saunders-jared-final/Boost-Brigade/8_Results/analysis/REPORT.md

# Results synthesis — presentation test cases, hardware, Simulink, QSPICE and analytical model

Generated by `8_Results/analysis/report.py` on 2026-10-22 21:53 AEST from `out/tables/*.csv`; every number
below comes from those tables (`make all` rebuilds them). Figures are vector PDFs with a PNG twin under `out/figures/`.

## 0 · Scope, data rules and metric definitions

**Test cases.** The 21 windows of `config.TEST_CASES` are the raw-data slides of
`0_Documentation/n11034459_CapstoneDelivery_V2.pdf` (Grafana panel time ranges, local AEST) plus the one open-loop
duty-step run (B01s) and the kscale 0.6–0.8 solar slots that are not on a slide. Each was re-exported from the pod's
InfluxDB with every firmware state (`8_Results/TestCases/`).

**RUN rows only.** Only `RUN_OL` / `RUN_CL` frames are analysed. Outside closed-loop RUN the firmware repeats the
last values of `rv`, `beta`, `stress`, `IM1r`, `IM2r` and sends the pre-bias duty, and Grafana draws one series per
state across the other states; those are the "stale values" of the screenshots. Rules applied: frames whose ten control
fields repeat the previous frame are dropped (none found); the leading / trailing frames of a run in which VM2 or VM3
has left the run's median by more than 2 V (e-load or PSU being switched off before the FAULT, still tagged RUN) are
dropped (`collapse_dropped` in T1); the firmware's `IM1r` / `IM2r` are recomputed from `ILA`, `ILB`, the duties and the
e-load current by the same KCL the firmware uses (`6_RTOS/ctrl_core/shuffler_recon.c`), which also gives absolute
module currents: I1 = I_str + d_A1 I_LA1 − d_B1 I_LB1, I3 = I_str − (i_sh2 − d_A2 I_LA2 + d_B2 I_LB2), I2 = I3 + IM2r.

**VM1.** The firmware's VM1 is the e-load voltage pushed by the Pi at 2 Hz minus VM2 + VM3; where the telemetry VM1
disagrees with the 5 Hz e-load by more than 2 V (the 200 kHz open-loop runs) it is replaced by V_eload − VM2 − VM3.
v_d2 = VM2 − VM3 is therefore the primary hardware voltage signal; v_d1 carries the 2 Hz / 5 Hz caveat.

**Sampling.** Telemetry frames arrive at 44 Hz (median; 11–44 Hz over the cases,
the 200 kHz closed-loop bench runs at 11–14 Hz). Closed-loop time constants are 1–10 ms, so **hardware rise, peak and
settling times of the loop itself are upper bounds of one telemetry sample** and are printed as "≤ 23 ms". What the
hardware does resolve: steady-state error, sample-to-sample noise, the shape and size of disturbance responses that take
seconds (PSU / load steps, shade), the open-loop duty-step amplitudes, and energy. The simulations (100 µs grid, 50 µs
for the MIL model) carry the full metric set.

**Step metrics** (`stepmetrics.step_metrics`, one definition for every phase): initial / final level = medians of the
pre-event window and of the last 20 % of the post window; |Δ|; rise time 10–90 % (interpolated); peak value and peak time
(always reported, `has_overshoot` only when the peak stands above the final value by more than max(2 %, 3 × noise));
overshoot and initial undershoot in % of Δ; settling time = last excursion outside a 2 % / 5 % band (never narrower than
3 × the pre-event noise) and outside an absolute band (±0.1 V for v_d, ±0.2 A for i_c); steady-state error against the
reference; IAE = ∫|y − y_final| dt; first- or second-order fit (τ, ζ, ω_n with 1-σ CI). Noise = MAD of the pre-event
window. A step with fewer than two samples across its 10–90 % rise is "unresolved" and its times are bounds.

**Noise / ripple.** Per settled segment: mean, std, robust peak-to-peak (0.5–99.5 %), RMS of the detrended signal and the
dominant frequency of its Welch spectrum. On hardware these are sample-to-sample noise of sensing-filtered signals at
45 Hz, **not** the switching ripple; the switching ripple comes from the analytical law Δi_c = V̄ / (2 f_sw (L+M)) and the
QSPICE device model (T6).

**Energy** (1 s means of the cleaned RUN frame; e-load power at 5 Hz): E_load = Σ P_eload dt; E_modules = Σ Σ_k VM_k I_k dt;
E_shuffled = Σ Σ_j |i_sh,j| V̄_j/2 dt (power processed through the shufflers); **E_returned = Σ (I_str − max(min_k I_k, 0)) V_str dt**
= energy the load received above what a plain series string limited to its weakest module would deliver at the same string
voltage (the differential-power-processing benefit, never above E_load); efficiency = E_load / E_modules.

## 1 · Test-case inventory (T1)

| case | slide | setup | f_sw [kHz] | loop | kscale (telemetry) | window (local) | RUN segs | RUN [s] | frames | rate [Hz] | frozen dropped | VM1 source | events in window | note |
|---|---|---|---|---|---|---|---|---|---|---|---|---|---|---|
| B01 | 48 | BENCH | 200 | OL | - | 14:32:00-14:44:56 | 2 | 706.5 | 29592 | 39.8 | 0 | e-load V - VM2 - VM3 (telemetry VM1 invalid) | fault x1, load_step x9 | duties 0.5; e-load CV set-point steps 125 <-> 60 V; VM1 from the e-load |
| B01s |  | BENCH | 200 | OL | - | 15:09:00-15:16:00 | 1 | 412.1 | 17112 | 39.8 | 0 | e-load V - VM2 - VM3 (telemetry VM1 invalid) | duty_step x4, fault x1, load_step x4 | not on a slide: the only open-loop duty steps (15:11:42 S2 +0.02/leg, 15:13:00 S1 & S2 -0.01/leg, 15:15:15 S1 +0.02/leg); ends in FAULT |
| B02 | 42 | BENCH | 200 | CL | 0.1 | 15:31:34-15:34:25 | 2 | 160.6 | 1867 | 11.3 | 0 | telemetry (e-load V via Pi, 2 Hz) | close x2 | before the ADC fix; PSU unstable |
| B03 | 43 | BENCH | 200 | CL | 0.3 | 16:02:05-16:04:33 | 1 | 143.1 | 2107 | 14.1 | 0 | telemetry (e-load V via Pi, 2 Hz) | close x1, load_step x2 | slide says kscale 20 %, telemetry says 0.3 with pset 0 (boot default after the re-flash for the ADC phase-B fix; no SET/APPLY sent) |
| B04 | 44 | BENCH | 200 | CL | 0.3/0.4 | 16:07:00-16:07:49 | 2 | 47.1 | 701 | 14.1 | 0 | telemetry (e-load V via Pi, 2 Hz) | close x1, fault x1, kscale_apply x1 | kscale 0.4 applied at 16:07:50 -> OC fault within 1 s |
| B05 | 49 | BENCH | 300 | OL | - | 16:31:36-16:37:04 | 2 | 303.8 | 11633 | 36.4 | 0 | telemetry (e-load V via Pi, 2 Hz) |  |  |
| B06 | 45 | BENCH | 300 | CL | 0.3 | 17:17:00-17:25:49 | 2 | 511.5 | 23223 | 44.1 | 0 | telemetry (e-load V via Pi, 2 Hz) | close x2, fault x1, load_step x7 | PSU / e-load set-point steps 17:22:30-17:25:30 while closed |
| B07 | 46 | BENCH | 300 | CL | 0.3/0.4/0.5/0.6 | 17:34:08-17:41:47 | 7 | 294.6 | 13384 | 44.1 | 0 | telemetry (e-load V via Pi, 2 Hz) | close x4, fault x2, kscale_apply x15, load_step x2 |  |
| B08 | 50 | BENCH | 400 | OL | - | 18:02:03-18:04:38 | 2 | 151.7 | 6890 | 44.1 | 0 | telemetry (e-load V via Pi, 2 Hz) | fault x1, kscale_apply x1, load_step x1 | PSU change at 18:03:40 |
| B09 | 47 | BENCH | 400 | CL | 0.3 | 18:05:11-18:13:40 | 4 | 391.8 | 17769 | 43.9 | 0 | telemetry (e-load V via Pi, 2 Hz) | close x4, fault x1, kscale_apply x2, load_step x2 |  |
| S01 | 24 | PV80 | 200 | OL | - | 15:04:35-15:07:47 | 1 | 187.0 | 8489 | 44.4 | 0 | telemetry (e-load V via Pi, 2 Hz) | irradiance_down x1, mismatch_off x1 | peak sun |
| S02 | 25 | PV80 | 200 | CL | 0.1 | 15:08:40-15:12:44 | 1 | 236.8 | 10748 | 44.2 | 0 | telemetry (e-load V via Pi, 2 Hz) | close x1, irradiance_down x1, irradiance_up x1, mismatch_off x2, mismatch_on x2 | peak sun; shade event about 15:09:20-15:10:40 |
| S03 | 26 | PV80 | 200 | OL | - | 15:48:22-15:51:20 | 1 | 174.3 | 7906 | 44.4 | 0 | telemetry (e-load V via Pi, 2 Hz) | mismatch_off x2, mismatch_on x1 | minimal sun |
| S04 | 27 | PV80 | 200 | CL | 0.1 | 15:52:03-15:56:31 | 1 | 265.1 | 12028 | 44.2 | 0 | telemetry (e-load V via Pi, 2 Hz) | close x1 | minimal sun |
| S05 | 37 | PV80 | 200 | CL | 0.2 | 15:56:51-16:00:47 | 1 | 229.1 | 10402 | 44.2 | 0 | telemetry (e-load V via Pi, 2 Hz) | close x1, kscale_apply x1, mismatch_on x1 | minimal sun |
| S06 | 38 | PV80 | 200 | CL | 0.3 | 16:01:07-16:04:19 | 1 | 188.6 | 8559 | 44.2 | 0 | telemetry (e-load V via Pi, 2 Hz) | close x1 | minimal sun |
| S07 | 39 | PV80 | 200 | CL | 0.4 | 16:05:30-16:08:17 | 1 | 155.7 | 7071 | 44.2 | 0 | telemetry (e-load V via Pi, 2 Hz) | close x1 | minimal sun |
| S08 | 40 | PV80 | 200 | CL | 0.5 | 16:09:42-16:12:16 | 1 | 150.3 | 6829 | 44.2 | 0 | telemetry (e-load V via Pi, 2 Hz) | close x1, kscale_apply x1, mismatch_on x1 | minimal sun |
| S09 |  | PV80 | 200 | CL | 0.6 | 16:13:15-16:18:00 | 1 | 278.3 | 12633 | 44.2 | 0 | telemetry (e-load V via Pi, 2 Hz) | close x1, kscale_apply x2 | not on a slide (closed_loop_timeslots.pdf) |
| S10 |  | PV80 | 200 | CL | 0.7 | 16:19:05-16:22:12 | 1 | 178.4 | 8101 | 44.2 | 0 | telemetry (e-load V via Pi, 2 Hz) | close x1, kscale_apply x2 | not on a slide (closed_loop_timeslots.pdf) |
| S11 |  | PV80 | 200 | CL | 0.8 | 16:23:05-16:24:45 | 1 | 90.5 | 4111 | 44.2 | 0 | telemetry (e-load V via Pi, 2 Hz) | close x1 | not on a slide (closed_loop_timeslots.pdf) |

`out/tables/T1_inventory.csv`; one overview figure per case in `out/figures/hardware/` (section 8).

## 2 · Hardware steady state and noise (T2)

Settled statistics per RUN segment longer than 5 s (first 2 s and last 1 s skipped). Closed loop: the references are v_d = 0 V and i_c = 0 A.

### 2.1 Closed loop

| case | f_sw [kHz] | k | s | Hz | v_d1 mean [V] | std | v_d2 mean [V] | std | v_d2 pk-pk | f_dom [Hz] | i_c1 mean [A] | std | i_c2 mean [A] | std | i_sh1 [A] | i_sh2 [A] | P [W] |
|---|---|---|---|---|---|---|---|---|---|---|---|---|---|---|---|---|---|
| B02 | 200 | 0.1 | 153 | 11.3 | 0 | 0.0708 | 0.00464 | 0.04 | 0.21 | 2.68 | 0.0221 | 1.49 | -0.0231 | 1.36 | 0.347 | -0.101 | 44.5 |
| B03 | 200 | 0.3 | 140 | 14.1 | -0.000864 | 0.0824 | 0.00651 | 0.0736 | 0.36 | 1.43 | 0.00871 | 0.647 | 0.0502 | 0.4 | 0.0893 | -0.0502 | 40.6 |
| B04 | 200 | 0.3 | 44.1 | 14.1 | -0.00201 | 0.0775 | 0.0104 | 0.0784 | 0.388 | 2.45 | -0.0327 | 0.634 | 0.0659 | 0.408 | 0.186 | 0.0426 | 40.6 |
| B06 | 300 | 0.3 | 357 | 44.1 | 0 | 0.0156 | 0.000522 | 0.0158 | 0.08 | 4.61 | -0.00406 | 0.0576 | 0 | 0.0546 | 0.306 | -0.26 | 35.6 |
| B06 | 300 | 0.3 | 148 | 44.1 | 0 | 0.0159 | 0.00061 | 0.0158 | 0.08 | 4.61 | -0.00327 | 0.057 | 0 | 0.0536 | 0.703 | -0.486 | 61.7 |
| B07 | 300 | 0.3 | 90.8 | 44.1 | -0.000633 | 0.00949 | 0 | 0.0127 | 0.06 | 4.57 | -0.00259 | 0.0569 | -0.000853 | 0.0534 | 0.247 | -0.178 | 44.7 |
| B07 | 300 | 0.4 | 132 | 44.1 | 0.00136 | 0.0281 | -0.00207 | 0.0686 | 0.27 | 0.474 | -0.00362 | 0.0592 | -0.000568 | 0.054 | 0.413 | -0.478 | 61 |
| B07 | 300 | 0.4 | 18 | 44.1 | -0.00103 | 0.0231 | -0.00231 | 0.0437 | 0.189 | 6.56 | -0.00119 | 0.0626 | 0.0013 | 0.0548 | 0.272 | -0.124 | 45.8 |
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
| S01 | 200 | 184 | 44.4 | -0.251 | 0.1 | -0.319 | 0.108 | -0.749 | 0.964 | 0.221 | -2.2 | -0.884 | 67.7 |
| S03 | 200 | 171 | 44.4 | -0.0422 | 0.162 | -0.0738 | 0.112 | 0.0768 | 1 | 0.238 | -0.382 | -0.0751 | 9.45 |

Closed-loop steady state vs gain scale: v_d2 error and noise, i_c2 noise

*Closed-loop steady state vs gain scale: v_d2 error and noise, i_c2 noise* — [PDF](out/figures/compare/hw_steady_state_vs_kscale.pdf) ([png](out/figures/compare/hw_steady_state_vs_kscale.png))

## 3 · Hardware events (T3)

### 3.1 Loop closures (IDLE → SOFTSTART → RUN_CL)

The 150 ms soft-start ramp (not RUN) removes the idle mismatch; the loop starts from the residual in the first RUN_CL frame. `idle_level` = v_d2 in IDLE before the ramp, `y0` = first controlled sample, `settle abs` = time until |v_d2| stays inside ±0.1 V.

| cid | time | f_sw | k | idle level [V] | y0 [V] | final [V] | ss err [V] | noise [V] | settle ±0.1 V [s] | rise | settle 2 % | n |
|---|---|---|---|---|---|---|---|---|---|---|---|---|
| B02 | 15:31:37 | 200 | 0.1 | -4.97 | -0.01 | 0 | 0 | 0.0297 | 0 | - | 0 ms | 0 |
| B02 | 15:34:19 | 200 | 0.1 | -4.95 | 0.06 | 0 | 0 | 0.0148 | 0 | - | 0 ms | 0 |
| B03 | 16:02:08 | 200 | 0.3 | -4.95 | -0.09 | 0.015 | 0.015 | 0.0445 | 1.9 | <= 71 ms | <= 1897 ms | 27 |
| B04 | 16:07:03 | 200 | 0.3 | -4.95 | -0.07 | 0.03 | 0.03 | 0.0445 | 1.48 | - | 1.29e+03 ms | 19 |
| B06 | 17:17:01 | 300 | 0.3 | -4.98 | -0.21 | 0 | 0 | 0 | 0 | <= 23 ms | <= 2996 ms | 136 |
| B06 | 17:23:14 | 300 | 0.3 | -4.98 | -0.13 | 0 | 0 | 0.0148 | 0 | <= 23 ms | <= 88 ms | 3 |
| B07 | 17:40:07 | 300 | 0.3 | -4.95 | -0.2 | 0 | 0 | 0.0148 | 0 | <= 23 ms | <= 23 ms | 0 |
| B07 | 17:39:20 | 300 | 0.4 | -4.94 | -0.19 | -0.01 | -0.01 | 0.0593 | 0 | <= 23 ms | <= 23 ms | 0 |
| B07 | 17:37:20 | 300 | 0.5 | -4.96 | -0.19 | 0.01 | 0.01 | 0.0741 | 2.69 | <= 23 ms | <= 23 ms | 0 |
| B07 | 17:38:34 | 300 | 0.6 | -4.96 | -0.2 | 0.035 | 0.035 | 0.0371 | 2.51 | <= 23 ms | <= 2223 ms | 101 |
| B09 | 18:05:20 | 400 | 0.3 | -4.96 | -0.46 | 0 | 0 | 0.0148 | 0 | <= 23 ms | <= 23 ms | 0 |
| B09 | 18:07:37 | 400 | 0.3 | -4.97 | -0.8 | 0 | 0 | 0.0148 | 0 | <= 23 ms | <= 65 ms | 3 |
| B09 | 18:08:24 | 400 | 0.3 | -4.96 | -0.17 | 0.01 | 0.01 | 0.0148 | 0 | <= 23 ms | <= 43 ms | 2 |
| B09 | 18:12:32 | 400 | 0.3 | -4.96 | -0.8 | -0.01 | -0.01 | 0.0148 | 0.176 | <= 23 ms | <= 264 ms | 12 |
| S02 | 15:08:45 | 200 | 0.1 | 0 | -0.17 | 0 | 0 | 0.0148 | 0 | <= 43 ms | <= 43 ms | 2 |
| S04 | 15:52:05 | 200 | 0.1 | -0.03 | 0.13 | 0 | 0 | 0.119 | 3 | <= 23 ms | <= 23 ms | 0 |
| S05 | 15:56:54 | 200 | 0.2 | -0.01 | -0.26 | -0.03 | -0.03 | 0.119 | 2.99 | <= 37 ms | <= 23 ms | 0 |
| S06 | 16:01:08 | 200 | 0.3 | -0.02 | -0.17 | -0.015 | -0.015 | 0.0371 | 2.91 | <= 23 ms | <= 2906 ms | 132 |
| S07 | 16:05:37 | 200 | 0.4 | -0.03 | -0.03 | -0.03 | -0.03 | 0.0519 | 2.91 | - | 2e+03 ms | 92 |
| S08 | 16:09:44 | 200 | 0.5 | -0.03 | -0.13 | 0.01 | 0.01 | 0.0593 | 2.66 | <= 23 ms | <= 2665 ms | 121 |
| S09 | 16:13:19 | 200 | 0.6 | -0.03 | -0.15 | -0.01 | -0.01 | 0.089 | 2.86 | <= 23 ms | <= 23 ms | 0 |
| S10 | 16:19:11 | 200 | 0.7 | -0.03 | 0.07 | -0.015 | -0.015 | 0.104 | 2.77 | - | 0 ms | 0 |
| S11 | 16:23:11 | 200 | 0.8 | -0.06 | 0 | -0.01 | -0.01 | 0.0519 | 2.8 | - | 2.8e+03 ms | 128 |

- 23 closures: residual at RUN_CL entry 0.00–0.80 V (idle mismatch 4.9 V on the bench), final |error| ≤ 0.035 V; the residual is inside ±0.1 V after 1.5 s (median) — 10 of 23 within the first sample.

### 3.2 Open-loop duty steps (B01s, 16 Oct 15:09–15:16, 200 kHz)

Prediction of the averaged model at this operating point (23.3 V per channel): Δv_d,j = −V̄_j Δu_c,j = −46.6 V × Δu_c.

| time | command | signal | before | after | Δ measured | Δ predicted | rise | settle 2 % | noise |
|---|---|---|---|---|---|---|---|---|---|
| 15:11:42 | C,DUTYS,0.5,0.5,0.51,0.51 | id1 | 0.68 | 0.628 | -0.0525 | - | - | 0 ms | 1.55 |
| 15:11:42 | C,DUTYS,0.5,0.5,0.51,0.51 | id2 | -1.47 | -2.81 | -1.34 | - | <= 47 ms | <= 50 ms | 1.19 |
| 15:11:42 | C,DUTYS,0.5,0.5,0.51,0.51 | vd1 | 0.0335 | 0.00391 | -0.0296 | 0 | - | 0 ms | 0.0459 |
| 15:11:42 | C,DUTYS,0.5,0.5,0.51,0.51 | vd2 | 0.82 | -1.05 | -1.87 | -1.86 | <= 25 ms | <= 3155 ms | 0.0297 |
| 15:13:00 | C,DUTYS,0.49,0.49,0.50,0.50 | id1 | 0.814 | 0.585 | -0.229 | - | - | 0 ms | 1.16 |
| 15:13:00 | C,DUTYS,0.49,0.49,0.50,0.50 | id2 | -2.78 | -2.06 | 0.72 | - | <= 25 ms | <= 25 ms | 1.1 |
| 15:13:00 | C,DUTYS,0.49,0.49,0.50,0.50 | vd1 | 0.0337 | 0.944 | 0.91 | 0.932 | <= 38 ms | <= 67 ms | 0.044 |
| 15:13:00 | C,DUTYS,0.49,0.49,0.50,0.50 | vd2 | -1.06 | -0.12 | 0.94 | 0.932 | <= 37 ms | <= 5875 ms | 0.0148 |
| 15:13:54 | C,DUTYS,0.49,0.49,0.50,0.50 | id1 | 0.611 | 0.36 | -0.251 | - | - | 0 ms | 1.38 |
| 15:13:54 | C,DUTYS,0.49,0.49,0.50,0.50 | id2 | -1.76 | -2.55 | -0.79 | - | <= 25 ms | <= 25 ms | 0.959 |
| 15:13:54 | C,DUTYS,0.49,0.49,0.50,0.50 | vd1 | 0.973 | 0.954 | -0.0196 | 0.932 | - | 3.41e+03 ms | 0.0294 |
| 15:13:54 | C,DUTYS,0.49,0.49,0.50,0.50 | vd2 | -0.13 | -0.12 | 0.01 | 0.932 | - | 0 ms | 0.0148 |
| 15:15:15 | C,DUTYS,0.51,0.51,0.50,0.50 | id1 | 0.742 | 1.3 | 0.562 | - | <= 25 ms | <= 25 ms | 1.44 |
| 15:15:15 | C,DUTYS,0.51,0.51,0.50,0.50 | id2 | -2.07 | -1.91 | 0.161 | - | - | 0 ms | 1.19 |
| 15:15:15 | C,DUTYS,0.51,0.51,0.50,0.50 | vd1 | 0.973 | -0.887 | -1.86 | -1.86 | <= 25 ms | <= 1731 ms | 0.0434 |
| 15:15:15 | C,DUTYS,0.51,0.51,0.50,0.50 | vd2 | -0.13 | -0.13 | 0 | 0 | - | 0 ms | 0.0297 |

- The measured Δv_d of the 6 non-zero voltage steps agree with −V̄·Δu_c within 0.952 V (102.1 % worst case); the rise is inside one telemetry sample, the slow tail afterwards is the PSU channels re-settling.

### 3.3 Load / PSU steps while running (bench)

Detected level shifts of the string current / power (e-load) with the loop's response; v_d must stay at 0 V, i_sh takes the new share.

| cid | time | state | k | ΔI_str [A] | ΔP [W] | Δi_sh1 [A] | Δi_sh2 [A] | v_d1 peak dev [V] | v_d2 peak dev [V] | v_d2 recovery [s] |
|---|---|---|---|---|---|---|---|---|---|---|
| B01 | 14:33:15 | RUN_OL | 0.3 | -0.000704 | -0.0503 | -0.426 | 0.103 | -0.139 | 0.07 | 0 |
| B01 | 14:36:18 | RUN_OL | 0.3 | 0 | 0.006 | 0.134 | -0.115 | -0.111 | 0.06 | 0 |
| B01 | 14:40:14 | RUN_OL | 0.3 | 0 | -0.00116 | -0.208 | -0.248 | -0.13 | 0.08 | 0 |
| B01 | 14:42:28 | RUN_OL | 0.3 | 0 | 0.0136 | 0.171 | -0.048 | -0.24 | -0.33 | 3.35 |
| B01 | 14:44:16 | RUN_OL | 0.3 | 0.000684 | 0.0478 | 0.428 | -0.296 | -0.121 | 0.065 | 0 |
| B01 | 14:44:25 | RUN_OL | 0.3 | 0 | 0.00129 | -0.18 | 0.0775 | -0.121 | 0.07 | 0 |
| B01 | 14:44:36 | RUN_OL | 0.3 | -0.97 | -67.9 | -1.43 | 1.23 | -5.97 | 0.15 | 5.02 |
| B01s | 15:14:45 | RUN_OL | 0.3 | -0.00107 | -0.0755 | -0.223 | 0.062 | -0.129 | 0.07 | 0 |
| B03 | 16:02:50 | RUN_CL | 0.3 | -0.00141 | -0.0989 | 0.248 | -0.065 | 0.15 | -0.23 | 9.7 |
| B03 | 16:03:18 | RUN_CL | 0.3 | -0.005 | -0.349 | 0.112 | 0.162 | -0.15 | -0.16 | 0 |
| B06 | 17:22:52 | RUN_CL | 0.3 | 0.2 | 14 | -0.372 | -0.767 | -0.03 | -0.04 | 0 |
| B06 | 17:23:24 | RUN_CL | 0.3 | 0.199 | 14 | 0.797 | 0.391 | -0.05 | 0.04 | 0 |
| B06 | 17:23:35 | RUN_CL | 0.3 | 0.0672 | 4.7 | -0.139 | 0.131 | -0.03 | -0.03 | 0 |
| B06 | 17:23:58 | RUN_CL | 0.3 | -0.268 | -18.7 | 0.529 | 1.06 | 0.04 | 0.03 | 0 |
| B06 | 17:24:16 | RUN_CL | 0.3 | 0.267 | 18.7 | -0.525 | -1.01 | 0.03 | -0.03 | 0 |
| B06 | 17:25:09 | RUN_CL | 0.3 | -0.167 | -11.7 | 0.309 | -0.313 | -0.04 | 0.03 | 0 |
| B06 | 17:25:32 | RUN_CL | 0.3 | 0.0195 | 1.36 | 0.016 | 0.01 | -0.04 | -0.03 | 0 |
| B07 | 17:34:13 | RUN_CL | 0.4 | 0.171 | 12 | 0.48 | 0.182 | 0.06 | -0.1 | 0 |
| B07 | 17:35:25 | RUN_CL | 0.4 | -0.158 | -11 | -0.514 | -0.251 | 0.06 | 0.14 | 4.83 |
| B08 | 18:03:42 | RUN_OL | 0.3 | -0.0931 | -6.52 | 0.176 | 0.322 | 0.14 | 1.35 | 9.97 |
| B09 | 18:08:42 | RUN_CL | 0.3 | 0.272 | 19.1 | 0.598 | 0.297 | 0.04 | 0.04 | 0 |

### 3.4 Shade / irradiance events (carpark PV, closed loop)

In closed loop the module voltages stay equal, so a shade shows in the module currents: detector on |i_sh1| + |i_sh2| (6 s change) and on the string power (4 s change).

| cid | time | event | k | ΔP [W] | ΔI_str [A] | Δi_sh1 [A] | Δi_sh2 [A] | ΔI_M1 [A] | ΔI_M3 [A] | v_d2 peak dev [V] | i_sh1 rise |
|---|---|---|---|---|---|---|---|---|---|---|---|
| S01 | 15:07:31 | mismatch_off | 0.2 | -35 | -0.573 | 1.02 | 0.422 | -0.526 | -0.772 | 0.145 | <= 149 ms |
| S01 | 15:07:32 | irradiance_down | 0.2 | -32.8 | -0.538 | 0.933 | 0.391 | - | - | 0.13 | <= 84 ms |
| S02 | 15:09:24 | irradiance_up | 0.1 | 56 | 0.919 | -1.49 | -0.87 | - | - | 0.06 | 2.25e+03 ms |
| S02 | 15:09:24 | mismatch_on | 0.1 | 56 | 0.919 | -1.49 | -0.87 | -0.626 | 1.35 | 0.06 | 2.25e+03 ms |
| S02 | 15:10:29 | irradiance_down | 0.1 | -32.9 | -0.54 | 0.881 | 0.497 | - | - | -0.05 | <= 190 ms |
| S02 | 15:10:31 | mismatch_off | 0.1 | -28.5 | -0.468 | 0.823 | 0.438 | 0.585 | -0.727 | 0.05 | <= 23 ms |
| S02 | 15:10:40 | mismatch_on | 0.1 | -12.1 | -0.199 | 0.555 | -1.02 | 0.594 | -0.315 | 0.05 | <= 23 ms |
| S02 | 15:10:48 | mismatch_off | 0.1 | -24.2 | -0.397 | 0.723 | 0.419 | 0.622 | -0.592 | 0.05 | <= 23 ms |
| S03 | 15:48:53 | mismatch_on | 0.2 | 0.621 | 0.0102 | -1.11 | -0.607 | -0.553 | 0.302 | -0.26 | - |
| S03 | 15:48:59 | mismatch_off | 0.2 | 0.547 | 0.00897 | -1.18 | 0.631 | -0.588 | -0.316 | -0.26 | - |
| S03 | 15:49:18 | mismatch_off | 0.2 | 0.361 | 0.00593 | -1.27 | 0.619 | -0.633 | -0.307 | 0.24 | - |
| S05 | 15:58:21 | mismatch_on | 0.2 | -0.718 | -0.0118 | -1.29 | 0.707 | -0.651 | -0.355 | -0.245 | - |
| S08 | 16:10:42 | mismatch_on | 0.5 | 0.575 | 0.00944 | -1.26 | -0.637 | -0.622 | 0.319 | 0.22 | - |

Zoom figures of every event: `out/figures/events/<case>_e<n>_<kind>.pdf` (listed in section 8).

## 4 · Energy (T7)

### 4.1 Solar test cases (20 Oct 2026), whole window

| cid | loop | k | s | P_load [W] | P_modules [W] | eff | P_shuffled [W] | P_returned [W] | max [W] | E_load [Wh] | E_shuffled [Wh] | E_returned [Wh] | I_M1 [A] | I_M2 [A] | I_M3 [A] | I_str [A] |
|---|---|---|---|---|---|---|---|---|---|---|---|---|---|---|---|---|
| S01 | OL | - | 188 | 67.3 | 67.7 | 0.993 | 62.3 | 65.9 | 96.1 | 3.51 | 3.26 | 3.44 | 0.005 | 1.76 | 1.54 | 1.1 |
| S02 | CL | 0.1 | 238 | 45.1 | 45.5 | 0.992 | 42.3 | 43.9 | 98.9 | 2.98 | 2.79 | 2.9 | -0.00401 | 1.21 | 1.03 | 0.74 |
| S03 | OL | - | 175 | 9.43 | 9.44 | 0.999 | 9.33 | 9.29 | 11.1 | 0.459 | 0.453 | 0.451 | -0.0371 | 0.309 | 0.192 | 0.155 |
| S04 | CL | 0.1 | 266 | 8.16 | 8.17 | 0.999 | 8.19 | 7.95 | 9 | 0.603 | 0.605 | 0.588 | -0.0384 | 0.278 | 0.162 | 0.134 |
| S05 | CL | 0.2 | 230 | 10.9 | 10.9 | 0.999 | 10.6 | 10.7 | 12.4 | 0.694 | 0.675 | 0.685 | -0.0394 | 0.354 | 0.22 | 0.178 |
| S06 | CL | 0.3 | 189 | 13.4 | 13.4 | 0.999 | 12.5 | 13.1 | 14.2 | 0.701 | 0.656 | 0.688 | -0.0337 | 0.418 | 0.273 | 0.219 |
| S07 | CL | 0.4 | 156 | 13.5 | 13.5 | 0.999 | 13 | 13.3 | 14.2 | 0.586 | 0.565 | 0.577 | -0.0359 | 0.417 | 0.285 | 0.222 |
| S08 | CL | 0.5 | 151 | 10.6 | 10.6 | 0.999 | 10.6 | 10.4 | 11.8 | 0.445 | 0.445 | 0.436 | -0.0385 | 0.338 | 0.222 | 0.174 |
| S09 | CL | 0.6 | 279 | 7.33 | 7.33 | 1 | 7.29 | 7.16 | 8.52 | 0.568 | 0.565 | 0.555 | -0.0404 | 0.269 | 0.131 | 0.12 |
| S10 | CL | 0.7 | 179 | 5.14 | 5.13 | 1 | 5.8 | 4.95 | 6.09 | 0.255 | 0.288 | 0.246 | -0.0439 | 0.21 | 0.0865 | 0.0842 |
| S11 | CL | 0.8 | 91 | 2.32 | 2.31 | 1 | 4.44 | 2.29 | 3.18 | 0.0586 | 0.112 | 0.0579 | -0.0555 | 0.139 | 0.0298 | 0.038 |

- In every 20 Oct window the KCL reconstruction (and the firmware's own IM1r) puts module 1 at -0.06…+0.00 A while modules 2 and 3 carry 1.76 / 1.54 A at most: the top module produced nothing that afternoon (slightly negative = the dark module forward-biased by the others). With a weakest-module-limited series string the load would therefore have received ≈ 0, so E_returned ≈ E_load: 10.62 Wh returned over 36 min of RUN time, 99 W at the peak of S02.
- Shuffler throughput: 4.4–62.3 W mean (≈ the whole load power, because one module is dead); string efficiency P_load / Σ V_k I_k = 0.992–1.003 (the reconstruction shares the e-load's current, so this is the winding-path loss only).

### 4.2 Bench (16 Oct), for reference

| cid | loop | k | s | P_load [W] | P_shuffled [W] | P_returned [W] | I_M1 [A] | I_M2 [A] | I_M3 [A] | I_str [A] |
|---|---|---|---|---|---|---|---|---|---|---|
| B01 | OL | - | 707 | 67.2 | 79 | 67.2 | 1.18 | -0.718 | 2.42 | 0.96 |
| B01s | OL | - | 413 | 65.5 | 65.4 | 65.5 | 1.32 | -0.467 | 1.95 | 0.936 |
| B02 | CL | 0.1 | 162 | 44.5 | 16.5 | 19.4 | 0.807 | 0.408 | 0.69 | 0.635 |
| B03 | CL | 0.3 | 144 | 40.6 | 4.95 | 6.29 | 0.626 | 0.51 | 0.604 | 0.58 |
| B04 | CL | 0.3 | 48 | 40.6 | 6.63 | 7.25 | 0.673 | 0.508 | 0.557 | 0.579 |
| B05 | OL | - | 306 | 68.9 | 26.1 | 39.2 | 1.26 | 0.425 | 1.27 | 0.985 |
| B06 | CL | 0.3 | 513 | 43.3 | 18.5 | 26 | 0.829 | 0.245 | 0.786 | 0.618 |
| B07 | CL | 0.5 | 298 | 52 | 15.4 | 22.1 | 0.913 | 0.429 | 0.892 | 0.743 |
| B08 | OL | - | 153 | 62.7 | 11.9 | 17.8 | 1.05 | 0.641 | 0.99 | 0.895 |
| B09 | CL | 0.3 | 397 | 59.6 | 12.7 | 18.7 | 1.01 | 0.583 | 0.969 | 0.851 |

The 16 Oct NGE103 current limits were not logged; the reconstructed channel currents (e.g. B01, 200 kHz before the ADC fix) are not consistent with current-limited channels, so the bench module currents are indicative only.

Solar: delivered, shuffled and returned power / energy per case

*Solar: delivered, shuffled and returned power / energy per case* — [PDF](out/figures/energy/solar_energy.pdf) ([png](out/figures/energy/solar_energy.png))
S02 (peak sun, kscale 0.1): module currents by KCL and the powers through the shade event

*S02 (peak sun, kscale 0.1): module currents by KCL and the powers through the shade event* — [PDF](out/figures/energy/S02_shade_power.pdf) ([png](out/figures/energy/S02_shade_power.png))

## 5 · Simulations and analytical model

### 5.1 Analytical N = 3 model (nstring) with the deployed gain sets

Plant resistance R = 0.29 / 0.80 / 1.70 Ω and the gain set the firmware ran at 200 / 300 / 400 kHz. S1 = loop close on a 0.5 V residual, S3 = module 3 loses 1/3 of its current, S4 = +1 V reference step, S5 = open-loop duty steps as sent on the bench.

**S1 loop_close**

| setup | f_sw | k | signal | Δ | ss err | rise 10-90 | t peak | overshoot % | settle 2 % | settle abs [s] | τ [s] | ζ | r² |
|---|---|---|---|---|---|---|---|---|---|---|---|---|---|
| BENCH | 200 | 0.1 | vd2 | -0.5 | 0 | 23.2 ms | none (monotonic) | 0.00161 | 41.4 ms | 0.0171 | 0.0106 | - | 1 |
| BENCH | 200 | 0.3 | vd2 | -0.5 | 0 | 7.59 ms | none (monotonic) | 0 | 13.6 ms | 0.0057 | 0.00345 | - | 1 |
| BENCH | 200 | 1 | vd2 | -0.5 | 0 | 2.08 ms | none (monotonic) | 0 | 3.9 ms | 0.0016 | 0.000929 | - | 1 |
| BENCH | 300 | 0.1 | vd2 | -0.5 | 0 | 22.3 ms | none (monotonic) | 0.00108 | 39.9 ms | 0.0166 | 0.0102 | - | 1 |
| BENCH | 300 | 0.3 | vd2 | -0.5 | 0 | 7.11 ms | none (monotonic) | 0 | 12.9 ms | 0.0054 | 0.00324 | - | 1 |
| BENCH | 300 | 1 | vd2 | -0.5 | 0 | 1.77 ms | none (monotonic) | 0 | 3.3 ms | 0.0015 | 0.00082 | - | 1 |
| BENCH | 400 | 0.1 | vd2 | -0.5 | 0 | 20.2 ms | none (monotonic) | 0 | 36.4 ms | 0.0152 | 0.00926 | - | 1 |
| BENCH | 400 | 0.3 | vd2 | -0.5 | 0 | 6.12 ms | none (monotonic) | 0 | 11.2 ms | 0.0049 | 0.00288 | - | 1 |
| BENCH | 400 | 1 | vd2 | -0.5 | 0 | 1.39 ms | 3 ms | 2.32 | 3.4 ms | 0.0015 | - | 0.779 | 1 |
| PV80 | 200 | 0.1 | vd2 | -0.5 | 0 | 28.9 ms | none (monotonic) | 0.0119 | 51.5 ms | 0.0213 | 0.0132 | - | 1 |
| PV80 | 200 | 0.3 | vd2 | -0.5 | 0 | 9.51 ms | none (monotonic) | 0 | 17 ms | 0.0071 | 0.00432 | - | 1 |
| PV80 | 200 | 1 | vd2 | -0.5 | 0 | 2.67 ms | none (monotonic) | 0 | 4.9 ms | 0.0021 | 0.0012 | - | 1 |
| PV80 | 300 | 0.1 | vd2 | -0.5 | 0 | 32.1 ms | none (monotonic) | 0.0284 | 57.3 ms | 0.0236 | 0.0146 | - | 1 |
| PV80 | 300 | 0.3 | vd2 | -0.5 | 0 | 10.5 ms | none (monotonic) | 0.00151 | 18.9 ms | 0.0078 | 0.00475 | - | 1 |
| PV80 | 300 | 1 | vd2 | -0.5 | 0 | 2.84 ms | none (monotonic) | 0 | 5.3 ms | 0.0023 | 0.00129 | - | 1 |
| PV80 | 400 | 0.1 | vd2 | -0.499 | 0.000691 | 36.1 ms | none (monotonic) | 0.07 | 64.7 ms | 0.0265 | 0.0164 | - | 1 |
| PV80 | 400 | 0.3 | vd2 | -0.5 | 0 | 11.7 ms | none (monotonic) | 0.00564 | 21.4 ms | 0.0088 | 0.0053 | - | 1 |
| PV80 | 400 | 1 | vd2 | -0.5 | 0 | 3.08 ms | none (monotonic) | 0 | 5.8 ms | 0.0025 | 0.00141 | - | 1 |

**S3 shade_m3**

_no rows_

**S4 vref2_step**

| setup | f_sw | k | signal | Δ | ss err | rise 10-90 | t peak | overshoot % | settle 2 % | settle abs [s] | τ [s] | ζ | r² |
|---|---|---|---|---|---|---|---|---|---|---|---|---|---|
| BENCH | 200 | 0.1 | vd2 | 1 | 0 | 23.2 ms | none (monotonic) | 0.00161 | 41.3 ms | 0.0244 | 0.0105 | - | 1 |
| BENCH | 200 | 0.3 | vd2 | 1 | 0 | 7.61 ms | none (monotonic) | 0 | 13.6 ms | 0.008 | 0.00342 | - | 1 |
| BENCH | 200 | 1 | vd2 | 1 | 0 | 2.04 ms | none (monotonic) | 0 | 3.8 ms | 0.0022 | 0.000909 | - | 0.997 |
| BENCH | 300 | 0.1 | vd2 | 1 | 0 | 22.4 ms | none (monotonic) | 0.0011 | 39.9 ms | 0.0235 | 0.0102 | - | 1 |
| BENCH | 300 | 0.3 | vd2 | 1 | 0 | 7.16 ms | none (monotonic) | 0 | 12.9 ms | 0.0076 | 0.00325 | - | 1 |
| BENCH | 300 | 1 | vd2 | 1 | 0 | 1.79 ms | none (monotonic) | 0 | 3.3 ms | 0.002 | 0.000809 | - | 1 |
| BENCH | 400 | 0.1 | vd2 | 1 | 0 | 20.5 ms | none (monotonic) | 0 | 36.8 ms | 0.0218 | 0.00935 | - | 1 |
| BENCH | 400 | 0.3 | vd2 | 1 | 0 | 6.29 ms | none (monotonic) | 0 | 11.4 ms | 0.0069 | 0.00288 | - | 1 |
| BENCH | 400 | 1 | vd2 | 1 | 0 | 1.41 ms | none (monotonic) | 1.15 | 2.2 ms | 0.0017 | - | 0.898 | 0.999 |
| PV80 | 200 | 0.1 | vd2 | 1 | 0 | 28.4 ms | none (monotonic) | 0.0105 | 50.6 ms | 0.0298 | 0.0129 | - | 1 |
| PV80 | 200 | 0.3 | vd2 | 1 | 0 | 9.35 ms | none (monotonic) | 0 | 16.7 ms | 0.0098 | 0.00421 | - | 1 |
| PV80 | 200 | 1 | vd2 | 1 | 0 | 2.59 ms | none (monotonic) | 0 | 4.8 ms | 0.0028 | 0.00116 | - | 0.998 |
| PV80 | 300 | 0.1 | vd2 | 1 | 0 | 30.9 ms | none (monotonic) | 0.0227 | 55.3 ms | 0.0325 | 0.014 | - | 1 |
| PV80 | 300 | 0.3 | vd2 | 1 | 0 | 10.1 ms | none (monotonic) | 0.00114 | 18.1 ms | 0.0106 | 0.00457 | - | 1 |
| PV80 | 300 | 1 | vd2 | 1 | 0 | 2.73 ms | none (monotonic) | 0 | 5 ms | 0.003 | 0.00122 | - | 1 |
| PV80 | 400 | 0.1 | vd2 | 0.999 | -0.00109 | 34.3 ms | none (monotonic) | 0.0555 | 61.9 ms | 0.0361 | 0.0155 | - | 1 |
| PV80 | 400 | 0.3 | vd2 | 1 | 0 | 11.1 ms | none (monotonic) | 0.00431 | 20.3 ms | 0.0118 | 0.00501 | - | 1 |
| PV80 | 400 | 1 | vd2 | 1 | 0 | 2.9 ms | none (monotonic) | 0 | 5.4 ms | 0.0032 | 0.00132 | - | 1 |

**S5 open-loop duty steps**

| setup | f_sw | k | signal | Δ | ss err | rise 10-90 | t peak | overshoot % | settle 2 % | settle abs [s] | τ [s] | ζ | r² |
|---|---|---|---|---|---|---|---|---|---|---|---|---|---|
| BENCH | 200 | 0 | vd1 | 0.935 | - | <= 0.17 ms | none (monotonic) | 0 | <= 0.3 ms | 0 | 0 | - | 1 |
| BENCH | 200 | 0 | vd1 | -1.87 | - | <= 0.14 ms | none (monotonic) | 0 | <= 0.3 ms | 0 | 0 | - | 1 |
| BENCH | 200 | 0 | vd2 | -1.87 | - | <= 0.14 ms | none (monotonic) | 0 | <= 0.3 ms | 0 | 0 | - | 1 |
| BENCH | 200 | 0 | vd2 | 0.935 | - | <= 0.17 ms | none (monotonic) | 0 | <= 0.3 ms | 0 | 0 | - | 1 |

Per-run figures: `out/figures/analytical/`.

### 5.2 QSPICE switching plant with the firmware control DLL (200 kHz)

Runs of `2_Qspice/Claude's outputs/run_scenarios.py` (100 µs tick means): loop close at 3 ms, +1 V reference step, module-3 shade (PV80).

**S1 loop_close**

| setup | f_sw | k | signal | Δ | ss err | rise 10-90 | t peak | overshoot % | settle 2 % | settle abs [s] | τ [s] | ζ | r² |
|---|---|---|---|---|---|---|---|---|---|---|---|---|---|
| BENCH | 200 | 0.1 | id2 | 0.305 | - | <= 0.1 ms | none (monotonic) | 10.5 | <= 0.1 ms | - | 0 | - | 0.00142 |
| BENCH | 200 | 0.1 | vd1 | 0.208 | -0.0019 | <= 8.3 ms | none (monotonic) | 3.4 | <= 0.1 ms | 0 | 0.000612 | - | 0.465 |
| BENCH | 200 | 0.1 | vd2 | 0.235 | -0.00264 | <= 10 ms | none (monotonic) | 4.02 | <= 0.1 ms | 0 | 0.000941 | - | 0.445 |
| BENCH | 200 | 0.2 | vd1 | 0.133 | 0 | 9.28 ms | 34.9 ms | 5.42 | 39.3 ms | 0.00145 | 0.00449 | - | 0.993 |
| BENCH | 200 | 0.2 | vd2 | 0.156 | 0 | 9.44 ms | 25.2 ms | 5.21 | 39 ms | 0.00245 | 0.00459 | - | 0.992 |
| BENCH | 200 | 0.3 | id2 | 0.307 | - | <= 0.1 ms | none (monotonic) | 11.2 | <= 0.1 ms | - | 0 | - | 0.103 |
| BENCH | 200 | 0.3 | vd1 | 0.209 | 0 | <= 0.24 ms | none (monotonic) | 60.3 | <= 0.1 ms | 0.00155 | 0 | - | 0.139 |
| BENCH | 200 | 0.3 | vd2 | 0.237 | -0.000592 | <= 0.27 ms | none (monotonic) | 44.8 | <= 0.1 ms | 0.00075 | 0 | - | 0.223 |
| BENCH | 200 | 0.5 | vd1 | 0.133 | 0 | 3.71 ms | 9.15 ms | 4.68 | 16.4 ms | 0.00065 | 0.00147 | - | 0.99 |
| BENCH | 200 | 0.5 | vd2 | 0.158 | 0.00189 | 3.48 ms | 8.45 ms | 3.16 | 16.9 ms | 0.00085 | 0.00152 | - | 0.99 |
| BENCH | 200 | 1 | vd1 | 0.131 | -0.00174 | 0.782 ms | 4.05 ms | 9.84 | 8.45 ms | 0 | - | 0.805 | 0.979 |
| BENCH | 200 | 1 | vd2 | 0.158 | 0.00223 | 0.758 ms | 1.15 ms | 7.79 | 8.45 ms | 0 | - | 0.737 | 0.947 |
| PV80 | 200 | 0.1 | ic2 | 0.0436 | 0.0492 | - | - | - | 0 ms | 0 | - | - | - |
| PV80 | 200 | 0.2 | ic2 | 0.0518 | 0.0516 | - | - | - | 0 ms | 0 | - | - | - |
| PV80 | 200 | 0.3 | ic2 | 0.0468 | 0.0524 | - | - | - | 0 ms | 0 | - | - | - |
| PV80 | 200 | 0.5 | ic2 | 0.0445 | 0.0444 | - | - | - | 0 ms | 0 | - | - | - |
| PV80 | 200 | 1 | ic2 | 0.05 | 0.0498 | - | - | - | 0 ms | 0 | - | - | - |

**S3 shade_m3**

| setup | f_sw | k | signal | Δ | ss err | rise 10-90 | t peak | overshoot % | settle 2 % | settle abs [s] | τ [s] | ζ | r² |
|---|---|---|---|---|---|---|---|---|---|---|---|---|---|
| PV80 | 200 | 0.1 | Pstr | -27.1 | - | <= 0.1 ms | <= 0.1 ms | 6.24 | <= 6.3 ms | - | 0 | - | 0 |
| PV80 | 200 | 0.1 | id2 | 1.77 | - | 0.137 ms | none (monotonic) | 0.541 | 15.6 ms | - | 0 | - | 0.648 |
| PV80 | 200 | 0.1 | vd2 | 0.0766 | - | <= 0.1 ms | <= 0.55 ms | 420 | <= 40 ms | 0.016 | 0 | - | 0 |
| PV80 | 200 | 0.2 | Pstr | -27.7 | - | <= 0.1 ms | <= 0.1 ms | 3.87 | <= 0.15 ms | - | 0 | - | 0 |
| PV80 | 200 | 0.2 | id2 | 1.7 | - | <= 0.1 ms | none (monotonic) | 0.0821 | <= 0.35 ms | - | 0 | - | 0.996 |
| PV80 | 200 | 0.2 | vd2 | 0.315 | - | <= 0.1 ms | <= 0.35 ms | 20.5 | <= 2 ms | 0 | 0 | - | 0.5 |
| PV80 | 200 | 0.3 | Pstr | -27 | - | <= 0.1 ms | <= 0.1 ms | 7.43 | <= 3.3 ms | - | 0 | - | 0 |
| PV80 | 200 | 0.3 | id2 | 1.8 | - | 0.14 ms | none (monotonic) | 0.474 | 7.46 ms | - | 0 | - | 0.626 |
| PV80 | 200 | 0.5 | Pstr | -27 | - | <= 0.1 ms | <= 0.1 ms | 4.13 | <= 1.6 ms | - | 0 | - | 0 |
| PV80 | 200 | 0.5 | id2 | 1.8 | - | <= 0.1 ms | none (monotonic) | 0.513 | <= 3 ms | - | 0 | - | 0.614 |
| PV80 | 200 | 1 | Pstr | -26.9 | - | <= 0.1 ms | <= 0.1 ms | 6.09 | <= 0.67 ms | - | 0 | - | 0 |
| PV80 | 200 | 1 | id2 | 1.8 | - | <= 0.1 ms | none (monotonic) | 1.18 | <= 0.87 ms | - | 0 | - | 0.935 |

**S4 vref2_step**

| setup | f_sw | k | signal | Δ | ss err | rise 10-90 | t peak | overshoot % | settle 2 % | settle abs [s] | τ [s] | ζ | r² |
|---|---|---|---|---|---|---|---|---|---|---|---|---|---|
| BENCH | 200 | 0.1 | vd2 | 0.975 | -0.0274 | 19.8 ms | none (monotonic) | 1.22 | 30.7 ms | 0.0205 | 0.00972 | - | 1 |
| BENCH | 200 | 0.2 | vd2 | 1 | 0 | 10.4 ms | none (monotonic) | 0.316 | 18.3 ms | 0.0109 | 0.00462 | - | 1 |
| BENCH | 200 | 0.3 | vd2 | 1 | 0 | 6.55 ms | none (monotonic) | 0.282 | 11.9 ms | 0.00676 | 0.00284 | - | 0.999 |
| BENCH | 200 | 0.5 | ic2 | 0.0134 | 0.00682 | - | - | - | 0 ms | 0 | - | - | - |
| BENCH | 200 | 0.5 | vd2 | 0.999 | 0.000676 | 3.46 ms | none (monotonic) | 0.261 | 6.17 ms | 0.00367 | 0.00147 | - | 0.999 |
| BENCH | 200 | 1 | vd2 | 0.996 | -0.00274 | 1.27 ms | none (monotonic) | 0.677 | 2.16 ms | 0.00136 | 0.000549 | - | 0.995 |
| PV80 | 200 | 0.1 | ic2 | 0.0255 | 0.064 | - | - | - | 0 ms | 0 | - | - | - |
| PV80 | 200 | 0.1 | id2 | -0.305 | - | 21.9 ms | 39.5 ms | 2.46 | 39.6 ms | - | 0.0108 | - | 0.993 |
| PV80 | 200 | 0.1 | vd2 | 0.95 | -0.0514 | 22.5 ms | none (monotonic) | 1.2 | 32.1 ms | 0.0234 | 0.0124 | - | 1 |
| PV80 | 200 | 0.2 | id2 | -0.322 | - | 11.8 ms | none (monotonic) | 3 | 17.4 ms | - | 0.00496 | - | 0.981 |
| PV80 | 200 | 0.2 | vd2 | 0.991 | -0.00758 | 12.6 ms | none (monotonic) | 0.982 | 21.8 ms | 0.0131 | 0.00587 | - | 1 |
| PV80 | 200 | 0.3 | id2 | -0.322 | - | 7.67 ms | none (monotonic) | 2.91 | 21.3 ms | - | 0.00283 | - | 0.947 |
| PV80 | 200 | 0.3 | vd2 | 0.998 | -0.00197 | 8.7 ms | none (monotonic) | 1.71 | 15.2 ms | 0.00906 | 0.00371 | - | 0.999 |
| PV80 | 200 | 0.5 | ic2 | 0.0436 | 0.0752 | - | - | - | 6.97 ms | 0 | - | - | - |
| PV80 | 200 | 0.5 | id2 | -0.322 | - | 2.99 ms | none (monotonic) | 4.43 | 17 ms | - | 0.00113 | - | 0.647 |
| PV80 | 200 | 0.5 | vd2 | 1.01 | -0.000824 | 4.61 ms | 17 ms | 7.49 | 17 ms | 0.00477 | 0.00194 | - | 0.997 |
| PV80 | 200 | 1 | ic2 | -0.0217 | 0.0268 | - | - | - | 0.862 ms | 0 | - | - | - |
| PV80 | 200 | 1 | id2 | -0.324 | - | <= 0.1 ms | <= 0.1 ms | 16.9 | <= 8.5 ms | - | 0 | - | 0 |
| PV80 | 200 | 1 | vd2 | 0.995 | 0.000899 | 1.91 ms | 8.46 ms | 4.18 | 8.46 ms | 0.00196 | 0.00077 | - | 0.99 |

Per-run figures: `out/figures/qspice/`.

### 5.3 Simulink carpark twin (3 modules, averaged switches, 61 mΩ)

`4_Simulink/3_Carpark_3mod/run_scenarios.m` scenario runs (S1, S3, S4) and the validate suite's cold-start tests (V2 decoupling, V4 shade-refs).

**S1 loop_close**

_no rows_

**S3 shade_m3**

| setup | f_sw | k | signal | Δ | ss err | rise 10-90 | t peak | overshoot % | settle 2 % | settle abs [s] | τ [s] | ζ | r² |
|---|---|---|---|---|---|---|---|---|---|---|---|---|---|
| PV80 | 200 | 0.1 | Pstr | -29.8 | - | <= 0.1 ms | none (monotonic) | 1.66 | <= 0.1 ms | - | 0 | - | -154 |
| PV80 | 200 | 0.1 | id2 | 1.92 | - | <= 0.1 ms | <= 0.1 ms | 11.3 | <= 0.2 ms | - | 0 | - | 0.985 |
| PV80 | 200 | 0.2 | Pstr | -29.8 | - | <= 0.1 ms | none (monotonic) | 1.66 | <= 0.1 ms | - | 0 | - | -166 |
| PV80 | 200 | 0.2 | id2 | 1.92 | - | <= 0.1 ms | <= 0.1 ms | 11.3 | <= 0.2 ms | - | 0 | - | 0.986 |
| PV80 | 200 | 0.3 | Pstr | -29.8 | - | <= 0.1 ms | none (monotonic) | 1.66 | <= 0.1 ms | - | 0 | - | -169 |
| PV80 | 200 | 0.3 | id2 | 1.92 | - | <= 0.1 ms | <= 0.1 ms | 11.3 | <= 0.2 ms | - | 0 | - | 0.986 |
| PV80 | 200 | 0.5 | Pstr | -29.8 | - | <= 0.1 ms | none (monotonic) | 1.66 | <= 0.1 ms | - | 0 | - | -172 |
| PV80 | 200 | 0.5 | id2 | 1.92 | - | <= 0.1 ms | <= 0.1 ms | 11.3 | <= 0.2 ms | - | 0 | - | 0.986 |
| PV80 | 200 | 1 | Pstr | -29.8 | - | <= 0.1 ms | none (monotonic) | 1.66 | <= 0.1 ms | - | 0 | - | -174 |
| PV80 | 200 | 1 | id2 | 1.92 | - | <= 0.1 ms | <= 0.1 ms | 11.2 | <= 0.2 ms | - | 0 | - | 0.986 |

**S4 vref2_step**

| setup | f_sw | k | signal | Δ | ss err | rise 10-90 | t peak | overshoot % | settle 2 % | settle abs [s] | τ [s] | ζ | r² |
|---|---|---|---|---|---|---|---|---|---|---|---|---|---|
| BENCH | 200 | 0.1 | vd2 | 1 | 0.00137 | 22.9 ms | none (monotonic) | 0.0172 | 41.4 ms | 0.0239 | 0.0101 | - | 1 |
| BENCH | 200 | 0.2 | vd2 | 1 | 0.00138 | 11 ms | none (monotonic) | 0.0357 | 19.8 ms | 0.0114 | 0.00477 | - | 0.999 |
| BENCH | 200 | 0.3 | vd2 | 1 | 0.00102 | 6.89 ms | none (monotonic) | 0.0558 | 12.4 ms | 0.0071 | 0.00297 | - | 0.998 |
| BENCH | 200 | 0.5 | vd2 | 1 | 0.00121 | 3.7 ms | none (monotonic) | 0.0822 | 6.8 ms | 0.0038 | 0.00151 | - | 0.996 |
| BENCH | 200 | 1 | ic2 | 0.0125 | 0.0156 | - | - | - | 0 ms | 0 | - | - | - |
| BENCH | 200 | 1 | vd2 | 0.998 | 0 | 0.759 ms | 1 ms | 8.79 | 2.7 ms | 0.0008 | 0 | - | 0.961 |
| PV80 | 200 | 0.1 | ic2 | -0.0117 | -0.00976 | - | - | - | 0 ms | 0 | - | - | - |
| PV80 | 200 | 0.1 | vd2 | 0.999 | -0.00109 | 26 ms | none (monotonic) | 0.00309 | 45.5 ms | 0.0271 | 0.0116 | - | 1 |
| PV80 | 200 | 0.2 | ic2 | -0.0135 | -0.0097 | - | - | - | 0 ms | 0 | - | - | - |
| PV80 | 200 | 0.2 | vd2 | 0.999 | 0 | 12.5 ms | none (monotonic) | 0.00437 | 22.4 ms | 0.013 | 0.00551 | - | 0.999 |
| PV80 | 200 | 0.3 | ic2 | -0.0154 | -0.00967 | - | - | - | 0 ms | 0 | - | - | - |
| PV80 | 200 | 0.3 | vd2 | 1 | 0 | 8.06 ms | none (monotonic) | 0.00481 | 14.2 ms | 0.0084 | 0.00347 | - | 0.999 |
| PV80 | 200 | 0.5 | ic2 | -0.0116 | -0.00685 | - | - | - | 0 ms | 0 | - | - | - |
| PV80 | 200 | 0.5 | vd2 | 1 | 0 | 4.47 ms | none (monotonic) | 0.0109 | 8 ms | 0.0046 | 0.00183 | - | 0.996 |
| PV80 | 200 | 1 | vd2 | 1 | 0.000508 | 0.894 ms | none (monotonic) | 0.156 | 3 ms | 0.001 | 0.000562 | - | 0.984 |

**V2 validate: decoupling (cold start)**

| setup | f_sw | k | signal | Δ | ss err | rise 10-90 | t peak | overshoot % | settle 2 % | settle abs [s] | τ [s] | ζ | r² |
|---|---|---|---|---|---|---|---|---|---|---|---|---|---|
| BENCH | 200 | 1 | vd2 | 2 | -0.00241 | 0.765 ms | 1 ms | 6.42 | 2.7 ms | 0.0023 | 0 | - | 0.97 |

**V4 validate: shade-refs (cold start)**

| setup | f_sw | k | signal | Δ | ss err | rise 10-90 | t peak | overshoot % | settle 2 % | settle abs [s] | τ [s] | ζ | r² |
|---|---|---|---|---|---|---|---|---|---|---|---|---|---|
| BENCH | 200 | 1 | vd1 | 2 | 0 | 0.735 ms | 1 ms | 9.18 | 2.7 ms | 0.0023 | 0 | - | 0.966 |
| BENCH | 200 | 1 | vd2 | -2 | -0.000578 | 0.787 ms | 1 ms | 6.4 | 2.7 ms | 0.0022 | 0 | - | 0.964 |

Per-run figures: `out/figures/carpark (scenarios), carpark_validate/`.

### 5.4 Simulink MIL (4 modules, 3 shufflers, 50 µs tick, kscale 1)

Validate suite cold-start tests (`4_Simulink/1_MIL_Model_In_The_Loop/shuffler_string_validate.m`): references and irradiance constant from t = 0, capacitors at 0 V.

**V2 validate: decoupling (cold start)**

| setup | f_sw | k | signal | Δ | ss err | rise 10-90 | t peak | overshoot % | settle 2 % | settle abs [s] | τ [s] | ζ | r² |
|---|---|---|---|---|---|---|---|---|---|---|---|---|---|
| MIL4 | 200 | 1 | vd2 | 2 | 0 | <= 0.05 ms | none (monotonic) | 0.384 | <= 4.2 ms | 0.0032 | 0.000965 | - | 0.833 |

**V4 validate: shade-refs (cold start)**

| setup | f_sw | k | signal | Δ | ss err | rise 10-90 | t peak | overshoot % | settle 2 % | settle abs [s] | τ [s] | ζ | r² |
|---|---|---|---|---|---|---|---|---|---|---|---|---|---|
| MIL4 | 200 | 1 | vd2 | 2 | 0 | <= 0.05 ms | <= 0.05 ms | 39.9 | <= 3.9 ms | 0.0029 | 0.000726 | - | 0.568 |
| MIL4 | 200 | 1 | vd3 | -2 | 0 | 2.13 ms | none (monotonic) | 0.575 | 4.05 ms | 0.00305 | 0.000847 | - | 0.924 |

Per-run figures: `out/figures/mil_validate/`.

### 5.5 Switching ripple (T6)

| f_sw [kHz] | source | i_c pk-pk [A] | per-leg pk-pk [A] | i_sh pk-pk [A] | Vbar [V] |
|---|---|---|---|---|---|
| 200 | QSPICE S10i (ud sweep, du = 0) | 8.39 | 4.25 | 0.19 | 46.5 |
| 200 | analytical Vbar/(2 f (L+M)), Vbar 46.6 V | 8.47 | 4.24 | 0 | 46.6 |
| 200 | hardware telemetry noise (44 Hz samples, 17 segments) | 1.43 | - | 1.12 | 40.7 |
| 300 | QSPICE S10i3.qraw raw, run 1 (du = 0), 2.5 ms | 5.58 | 2.85 | 0.201 | 46.4 |
| 300 | analytical Vbar/(2 f (L+M)), Vbar 46.6 V | 5.65 | 2.82 | 0 | 46.6 |
| 300 | hardware telemetry noise (44 Hz samples, 6 segments) | 0.275 | - | 0.878 | 46.7 |
| 400 | QSPICE S10i (ud sweep, du = 0) | 4.09 | 2.18 | 0.389 | 46 |
| 400 | QSPICE S10i4.qraw raw, run 1 (du = 0), 2.5 ms | 4.13 | 2.19 | 0.406 | 46 |
| 400 | analytical Vbar/(2 f (L+M)), Vbar 46.6 V | 4.24 | 2.12 | 0 | 46.6 |
| 400 | hardware telemetry noise (44 Hz samples, 5 segments) | 0.445 | - | 0.455 | 46.7 |

Winding-current ripple vs switching frequency: analytical law, QSPICE, and the telemetry noise for contrast

*Winding-current ripple vs switching frequency: analytical law, QSPICE, and the telemetry noise for contrast* — [PDF](out/figures/compare/ripple_vs_fsw.pdf) ([png](out/figures/compare/ripple_vs_fsw.png))

## 6 · Cross-phase comparison (T5)

Matched (scenario, setup, kscale, signal) keys, 200 kHz gain set. Each simulation cell = fitted τ / rise 10–90 % / 2 % settling in ms, overshoot %. The hardware cell = measured Δ, steady-state error, noise, rise bound, time into the ±abs band, over the n matching events.

| scenario | setup | kscale | signal | Analytical N=3 tau / rise / settle2 [ms], os % | Simulink carpark twin tau / rise / settle2 [ms], os % | Simulink MIL tau / rise / settle2 [ms], os % | QSPICE switching + firmware DLL tau / rise / settle2 [ms], os % | hardware: delta, ss err, noise, rise, settle abs [s] (n cases) |
|---|---|---|---|---|---|---|---|---|
| S1 | BENCH | 0.1 | vd2 | 10.6 / 23.2 / 41.4, 0 | - | - | 0.941 / 10.2 / -, 0 | -0.025, 0, 0.022, -, 0 (2: B02 B02) |
| S1 | BENCH | 0.2 | vd2 | 5.23 / 11.5 / 20.6, 0 | - | - | 4.59 / 9.44 / 39, 5.2 | - |
| S1 | BENCH | 0.3 | vd2 | 3.45 / 7.59 / 13.6, 0 | - | - | 0.137 / 0.272 / -, 0 | 0.331, 0.005, 0.02, <= 23 ms, 0.4 (9: B03 B04 B06 B06 B07 B09 B09 B09 B09) |
| S1 | BENCH | 0.4 | vd2 | 2.55 / 5.63 / 10.1, 0 | - | - | - | 0.18, -0.01, 0.059, <= 23 ms, 0 (1: B07) |
| S1 | BENCH | 0.5 | vd2 | 2.02 / 4.45 / 8.1, 0 | - | - | 1.52 / 3.48 / 16.9, 3.2 | 0.2, 0.01, 0.074, <= 23 ms, 2.7 (1: B07) |
| S1 | BENCH | 0.6 | vd2 | - | - | - | - | 0.235, 0.035, 0.037, <= 23 ms, 2.5 (1: B07) |
| S1 | BENCH | 1.0 | vd2 | 0.929 / 2.08 / 3.9, 0 | - | - | - / 0.758 / 8.45, 7.8 | - |
| S1 | PV80 | 0.1 | vd2 | 13.2 / 28.9 / 51.5, 0 | - | - | - | 0.02, 0, 0.067, <= 23 ms, 1.5 (2: S02 S04) |
| S1 | PV80 | 0.2 | vd2 | 6.53 / 14.4 / 25.6, 0 | - | - | - | 0.23, -0.03, 0.12, <= 37 ms, 3 (1: S05) |
| S1 | PV80 | 0.3 | vd2 | 4.32 / 9.51 / 17, 0 | - | - | - | 0.155, -0.015, 0.037, <= 23 ms, 2.9 (1: S06) |
| S1 | PV80 | 0.4 | vd2 | 3.21 / 7.07 / 12.7, 0 | - | - | - | 0, -0.03, 0.052, -, 2.9 (1: S07) |
| S1 | PV80 | 0.5 | vd2 | 2.54 / 5.61 / 10.1, 0 | - | - | - | 0.14, 0.01, 0.059, <= 23 ms, 2.7 (1: S08) |
| S1 | PV80 | 0.6 | vd2 | - | - | - | - | 0.14, -0.01, 0.089, <= 23 ms, 2.9 (1: S09) |
| S1 | PV80 | 0.7 | vd2 | - | - | - | - | -0.085, -0.015, 0.1, -, 2.8 (1: S10) |
| S1 | PV80 | 0.8 | vd2 | - | - | - | - | -0.01, -0.01, 0.052, -, 2.8 (1: S11) |
| S1 | PV80 | 1.0 | vd2 | 1.2 / 2.67 / 4.9, 0 | - | - | - | - |
| S3 | PV80 | 0.1 | id2 | 0.0781 / 0.235 / 18.9, 0 | 0.00111 / 0.0719 / 0.2, 11 | - | 0.0659 / 0.137 / 15.6, 0 | -0.326, -, 0.25, -, - (2: S02 S02) |
| S3 | PV80 | 0.2 | id2 | 0.0779 / 0.231 / 9.3, 0 | 0.00111 / 0.0719 / 0.2, 11 | - | 0.0525 / 0.0917 / 0.35, 0 | 0.0195, -, 0.24, -, - (2: S03 S05) |
| S3 | PV80 | 0.3 | id2 | 0.0786 / 0.228 / 6.1, 0 | 0.00111 / 0.0719 / 0.2, 11 | - | 0.0663 / 0.14 / 7.46, 0 | - |
| S3 | PV80 | 0.4 | id2 | 0.0789 / 0.225 / 4.5, 0 | - | - | - | - |
| S3 | PV80 | 0.5 | id2 | 0.079 / 0.222 / 3.6, 0 | 0.00111 / 0.0719 / 0.2, 11 | - | 0.064 / 0.085 / 3, 0 | 0.009, -, 0.26, -, - (1: S08) |
| S3 | PV80 | 1.0 | id2 | 0.0786 / 0.213 / 1.6, 0 | 0.00112 / 0.0719 / 0.2, 11 | - | 0.0639 / 0.0896 / 0.873, 0 | - |
| S3 | PV80 | 0.1 | vd2 | - | - | - | - | 0, 0, 0.019, -, 0 (2: S02 S02) |
| S3 | PV80 | 0.2 | vd2 | - | - | - | 0.00579 / 0.0332 / 2.05, 20 | -0.0025, -0.005, 0.059, -, 19 (2: S03 S05) |
| S3 | PV80 | 0.5 | vd2 | - | - | - | - | -0.02, -0.01, 0.059, -, 19 (1: S08) |
| S4 | BENCH | 0.1 | vd2 | 10.5 / 23.2 / 41.3, 0 | 10.1 / 22.9 / 41.4, 0 | - | 9.72 / 19.8 / 30.7, 0 | - |
| S4 | BENCH | 0.2 | vd2 | 5.2 / 11.5 / 20.5, 0 | 4.77 / 11 / 19.8, 0 | - | 4.62 / 10.4 / 18.4, 0 | - |
| S4 | BENCH | 0.3 | vd2 | 3.42 / 7.61 / 13.6, 0 | 2.97 / 6.89 / 12.4, 0 | - | 2.84 / 6.55 / 11.9, 0 | - |
| S4 | BENCH | 0.4 | vd2 | 2.53 / 5.64 / 10.1, 0 | - | - | - | - |
| S4 | BENCH | 0.5 | vd2 | 1.99 / 4.46 / 8, 0 | 1.51 / 3.7 / 6.8, 0 | - | 1.47 / 3.46 / 6.17, 0 | - |
| S4 | BENCH | 1.0 | vd2 | 0.909 / 2.04 / 3.8, 0 | 0.404 / 0.759 / 2.7, 8.8 | - | 0.549 / 1.27 / 2.16, 0 | - |
| S4 | PV80 | 0.1 | vd2 | 12.9 / 28.4 / 50.6, 0 | 11.6 / 26 / 45.5, 0 | - | 12.4 / 22.5 / 32.1, 0 | - |
| S4 | PV80 | 0.2 | vd2 | 6.38 / 14.1 / 25.1, 0 | 5.51 / 12.5 / 22.4, 0 | - | 5.87 / 12.6 / 21.8, 0 | - |
| S4 | PV80 | 0.3 | vd2 | 4.21 / 9.35 / 16.7, 0 | 3.47 / 8.06 / 14.2, 0 | - | 3.71 / 8.7 / 15.2, 0 | - |
| S4 | PV80 | 0.4 | vd2 | 3.12 / 6.96 / 12.4, 0 | - | - | - | - |
| S4 | PV80 | 0.5 | vd2 | 2.47 / 5.52 / 9.9, 0 | 1.83 / 4.47 / 8, 0 | - | 1.94 / 4.61 / 17, 7.5 | - |
| S4 | PV80 | 1.0 | vd2 | 1.16 / 2.59 / 4.8, 0 | 0.562 / 0.894 / 3, 0 | - | 0.77 / 1.91 / 8.46, 4.2 | - |
| S5 | BENCH | 0.0 | vd1 | 0.0553 / 0.136 / 0.3, 0 | - | - | - | - |
| S5 | BENCH | 0.0 | vd2 | 0.0675 / 0.166 / 0.3, 0 | - | - | - | - |
| V2 | BENCH | 1.0 | vd2 | - | 0.412 / 0.765 / 2.7, 6.4 | - | - | - |
| V2 | MIL4 | 1.0 | vd2 | - | - | 0.965 / 0.0398 / 4.2, 0 | - | - |
| V4 | BENCH | 1.0 | vd1 | - | 0.373 / 0.735 / 2.7, 9.2 | - | - | - |
| V4 | BENCH | 1.0 | vd2 | - | 0.432 / 0.787 / 2.7, 6.4 | - | - | - |
| V4 | MIL4 | 1.0 | vd2 | - | - | 0.726 / 0.0286 / 3.9, 40 | - | - |
| V4 | MIL4 | 1.0 | vd3 | - | - | 0.847 / 2.13 / 4.05, 0 | - | - |

Rows with no step in any phase (i_c references at 0) are left out; the full table is `out/tables/T5_cross_phase.csv`.

**τ of the +1 V reference step relative to the first-order design 1/(k·2π·150):**

- kscale 0.1 (design τ = 10.61 ms): τ / design = analytical PV80 1.22×, analytical BENCH 0.99×, simulink PV80 1.10×, simulink BENCH 0.96×, qspice PV80 1.17×, qspice BENCH 0.92×.
- kscale 0.2 (design τ = 5.31 ms): τ / design = analytical PV80 1.20×, analytical BENCH 0.98×, simulink PV80 1.04×, simulink BENCH 0.90×, qspice PV80 1.11×, qspice BENCH 0.87×.
- kscale 0.3 (design τ = 3.54 ms): τ / design = analytical PV80 1.19×, analytical BENCH 0.97×, simulink PV80 0.98×, simulink BENCH 0.84×, qspice PV80 1.05×, qspice BENCH 0.80×.
- kscale 0.4 (design τ = 2.65 ms): τ / design = analytical PV80 1.18×, analytical BENCH 0.95×.
- kscale 0.5 (design τ = 2.12 ms): τ / design = analytical PV80 1.16×, analytical BENCH 0.94×, simulink PV80 0.86×, simulink BENCH 0.71×, qspice PV80 0.92×, qspice BENCH 0.69×.
- kscale 1 (design τ = 1.06 ms): τ / design = analytical PV80 1.09×, analytical BENCH 0.86×, simulink PV80 0.53×, simulink BENCH 0.38×, qspice PV80 0.73×, qspice BENCH 0.52×.

Closed-loop step metrics of v_d2 vs gain scale, all phases, with the hardware sampling bound

*Closed-loop step metrics of v_d2 vs gain scale, all phases, with the hardware sampling bound* — [PDF](out/figures/compare/metrics_vs_kscale.pdf) ([png](out/figures/compare/metrics_vs_kscale.png))
Open-loop duty steps: analytical prediction against the 16 Oct bench

*Open-loop duty steps: analytical prediction against the 16 Oct bench* — [PDF](out/figures/compare/S5_duty_steps_hw_vs_analytical.pdf) ([png](out/figures/compare/S5_duty_steps_hw_vs_analytical.png))

Step overlays per (scenario, setup, kscale, signal), simulations on a ms axis with the matching hardware events underneath:

- [step_S1_BENCH_k0.1_ic2](out/figures/compare/step_S1_BENCH_k0.1_ic2.pdf)
- [step_S1_BENCH_k0.1_id2](out/figures/compare/step_S1_BENCH_k0.1_id2.pdf)
- [step_S1_BENCH_k0.1_vd2](out/figures/compare/step_S1_BENCH_k0.1_vd2.pdf)
- [step_S1_BENCH_k0.2_ic2](out/figures/compare/step_S1_BENCH_k0.2_ic2.pdf)
- [step_S1_BENCH_k0.2_id2](out/figures/compare/step_S1_BENCH_k0.2_id2.pdf)
- [step_S1_BENCH_k0.2_vd2](out/figures/compare/step_S1_BENCH_k0.2_vd2.pdf)
- [step_S1_BENCH_k0.3_ic2](out/figures/compare/step_S1_BENCH_k0.3_ic2.pdf)
- [step_S1_BENCH_k0.3_id2](out/figures/compare/step_S1_BENCH_k0.3_id2.pdf)
- [step_S1_BENCH_k0.3_vd2](out/figures/compare/step_S1_BENCH_k0.3_vd2.pdf)
- [step_S1_BENCH_k0.4_ic2](out/figures/compare/step_S1_BENCH_k0.4_ic2.pdf)
- [step_S1_BENCH_k0.4_id2](out/figures/compare/step_S1_BENCH_k0.4_id2.pdf)
- [step_S1_BENCH_k0.4_vd2](out/figures/compare/step_S1_BENCH_k0.4_vd2.pdf)
- [step_S1_BENCH_k0.5_ic2](out/figures/compare/step_S1_BENCH_k0.5_ic2.pdf)
- [step_S1_BENCH_k0.5_id2](out/figures/compare/step_S1_BENCH_k0.5_id2.pdf)
- [step_S1_BENCH_k0.5_vd2](out/figures/compare/step_S1_BENCH_k0.5_vd2.pdf)
- [step_S1_BENCH_k1_ic2](out/figures/compare/step_S1_BENCH_k1_ic2.pdf)
- [step_S1_BENCH_k1_id2](out/figures/compare/step_S1_BENCH_k1_id2.pdf)
- [step_S1_BENCH_k1_vd2](out/figures/compare/step_S1_BENCH_k1_vd2.pdf)
- [step_S1_PV80_k0.1_ic2](out/figures/compare/step_S1_PV80_k0.1_ic2.pdf)
- [step_S1_PV80_k0.1_id2](out/figures/compare/step_S1_PV80_k0.1_id2.pdf)
- [step_S1_PV80_k0.1_vd2](out/figures/compare/step_S1_PV80_k0.1_vd2.pdf)
- [step_S1_PV80_k0.2_ic2](out/figures/compare/step_S1_PV80_k0.2_ic2.pdf)
- [step_S1_PV80_k0.2_id2](out/figures/compare/step_S1_PV80_k0.2_id2.pdf)
- [step_S1_PV80_k0.2_vd2](out/figures/compare/step_S1_PV80_k0.2_vd2.pdf)
- [step_S1_PV80_k0.3_ic2](out/figures/compare/step_S1_PV80_k0.3_ic2.pdf)
- [step_S1_PV80_k0.3_id2](out/figures/compare/step_S1_PV80_k0.3_id2.pdf)
- [step_S1_PV80_k0.3_vd2](out/figures/compare/step_S1_PV80_k0.3_vd2.pdf)
- [step_S1_PV80_k0.4_ic2](out/figures/compare/step_S1_PV80_k0.4_ic2.pdf)
- [step_S1_PV80_k0.4_id2](out/figures/compare/step_S1_PV80_k0.4_id2.pdf)
- [step_S1_PV80_k0.4_vd2](out/figures/compare/step_S1_PV80_k0.4_vd2.pdf)
- [step_S1_PV80_k0.5_ic2](out/figures/compare/step_S1_PV80_k0.5_ic2.pdf)
- [step_S1_PV80_k0.5_id2](out/figures/compare/step_S1_PV80_k0.5_id2.pdf)
- [step_S1_PV80_k0.5_vd2](out/figures/compare/step_S1_PV80_k0.5_vd2.pdf)
- [step_S1_PV80_k1_ic2](out/figures/compare/step_S1_PV80_k1_ic2.pdf)
- [step_S1_PV80_k1_id2](out/figures/compare/step_S1_PV80_k1_id2.pdf)
- [step_S1_PV80_k1_vd2](out/figures/compare/step_S1_PV80_k1_vd2.pdf)
- [step_S3_PV80_k0.1_Pstr](out/figures/compare/step_S3_PV80_k0.1_Pstr.pdf)
- [step_S3_PV80_k0.1_id2](out/figures/compare/step_S3_PV80_k0.1_id2.pdf)
- [step_S3_PV80_k0.1_vd2](out/figures/compare/step_S3_PV80_k0.1_vd2.pdf)
- [step_S3_PV80_k0.2_Pstr](out/figures/compare/step_S3_PV80_k0.2_Pstr.pdf)
- [step_S3_PV80_k0.2_id2](out/figures/compare/step_S3_PV80_k0.2_id2.pdf)
- [step_S3_PV80_k0.2_vd2](out/figures/compare/step_S3_PV80_k0.2_vd2.pdf)
- [step_S3_PV80_k0.3_Pstr](out/figures/compare/step_S3_PV80_k0.3_Pstr.pdf)
- [step_S3_PV80_k0.3_id2](out/figures/compare/step_S3_PV80_k0.3_id2.pdf)
- [step_S3_PV80_k0.3_vd2](out/figures/compare/step_S3_PV80_k0.3_vd2.pdf)
- [step_S3_PV80_k0.4_id2](out/figures/compare/step_S3_PV80_k0.4_id2.pdf)
- [step_S3_PV80_k0.4_vd2](out/figures/compare/step_S3_PV80_k0.4_vd2.pdf)
- [step_S3_PV80_k0.5_Pstr](out/figures/compare/step_S3_PV80_k0.5_Pstr.pdf)
- [step_S3_PV80_k0.5_id2](out/figures/compare/step_S3_PV80_k0.5_id2.pdf)
- [step_S3_PV80_k0.5_vd2](out/figures/compare/step_S3_PV80_k0.5_vd2.pdf)
- [step_S3_PV80_k1_Pstr](out/figures/compare/step_S3_PV80_k1_Pstr.pdf)
- [step_S3_PV80_k1_id2](out/figures/compare/step_S3_PV80_k1_id2.pdf)
- [step_S3_PV80_k1_vd2](out/figures/compare/step_S3_PV80_k1_vd2.pdf)
- [step_S4_BENCH_k0.1_ic2](out/figures/compare/step_S4_BENCH_k0.1_ic2.pdf)
- [step_S4_BENCH_k0.1_vd2](out/figures/compare/step_S4_BENCH_k0.1_vd2.pdf)
- [step_S4_BENCH_k0.2_ic2](out/figures/compare/step_S4_BENCH_k0.2_ic2.pdf)
- [step_S4_BENCH_k0.2_vd2](out/figures/compare/step_S4_BENCH_k0.2_vd2.pdf)
- [step_S4_BENCH_k0.3_ic2](out/figures/compare/step_S4_BENCH_k0.3_ic2.pdf)
- [step_S4_BENCH_k0.3_vd2](out/figures/compare/step_S4_BENCH_k0.3_vd2.pdf)
- [step_S4_BENCH_k0.4_ic2](out/figures/compare/step_S4_BENCH_k0.4_ic2.pdf)
- [step_S4_BENCH_k0.4_vd2](out/figures/compare/step_S4_BENCH_k0.4_vd2.pdf)
- [step_S4_BENCH_k0.5_ic2](out/figures/compare/step_S4_BENCH_k0.5_ic2.pdf)
- [step_S4_BENCH_k0.5_vd2](out/figures/compare/step_S4_BENCH_k0.5_vd2.pdf)
- [step_S4_BENCH_k1_ic2](out/figures/compare/step_S4_BENCH_k1_ic2.pdf)
- [step_S4_BENCH_k1_vd2](out/figures/compare/step_S4_BENCH_k1_vd2.pdf)
- [step_S4_PV80_k0.1_ic2](out/figures/compare/step_S4_PV80_k0.1_ic2.pdf)
- [step_S4_PV80_k0.1_vd2](out/figures/compare/step_S4_PV80_k0.1_vd2.pdf)
- [step_S4_PV80_k0.2_ic2](out/figures/compare/step_S4_PV80_k0.2_ic2.pdf)
- [step_S4_PV80_k0.2_vd2](out/figures/compare/step_S4_PV80_k0.2_vd2.pdf)
- [step_S4_PV80_k0.3_ic2](out/figures/compare/step_S4_PV80_k0.3_ic2.pdf)
- [step_S4_PV80_k0.3_vd2](out/figures/compare/step_S4_PV80_k0.3_vd2.pdf)
- [step_S4_PV80_k0.4_ic2](out/figures/compare/step_S4_PV80_k0.4_ic2.pdf)
- [step_S4_PV80_k0.4_vd2](out/figures/compare/step_S4_PV80_k0.4_vd2.pdf)
- [step_S4_PV80_k0.5_ic2](out/figures/compare/step_S4_PV80_k0.5_ic2.pdf)
- [step_S4_PV80_k0.5_vd2](out/figures/compare/step_S4_PV80_k0.5_vd2.pdf)
- [step_S4_PV80_k1_ic2](out/figures/compare/step_S4_PV80_k1_ic2.pdf)
- [step_S4_PV80_k1_vd2](out/figures/compare/step_S4_PV80_k1_vd2.pdf)

## 6b · DC gain matrices (analytical vs identified gain sets)

| source | vd1/uc1 | vd2/uc2 | ic1/ud1 | ic2/ud2 | vd1/ud1 (cross) | cond(G) | note |
|---|---|---|---|---|---|---|---|
| analytical PV80, averaged R 61 mOhm (Simulink) | -40.4 | -40.4 | 672.1 | 672.1 | 0.0 | 16.8 | modes [('6973 Hz', 'z 0.36'), ('9296 Hz', 'z 0.27')] |
| analytical PV80, switching R 0.29 ohm (200 kHz) | -38.2 | -38.2 | 141.4 | 141.4 | 0.0 | 3.8 | modes [] |
| analytical PV80, switching R 1.72 ohm (400 kHz) | -29.2 | -29.2 | 23.8 | 23.8 | 0.0 | 1.4 | modes [] |
| analytical BENCH QSPICE point (all CC), R 0.29 ohm | -46.6 | -46.7 | 160.7 | 160.7 | 0.0 | 3.5 | modes [] |
| analytical BENCH ch1 CC / ch2,3 CV, R 0.29 ohm | -15.2 | -7.2 | 155.2 | 172.4 | 0.0 | 26.3 | modes [('20889 Hz', 'z 0.93')] |
| identified sps-params-2.20261015-1950-3mod-qspice200-bench | -46.3 | -46.9 | 142.5 | 139.0 | -24.7 | 3.2 | diag(kI) M^-1 of the gain set |
| identified sps-params-2.20261011-1634-3mod-qspice | -37.4 | -37.7 | 256.0 | 215.8 | 7.3 | 7.4 | diag(kI) M^-1 of the gain set |
| identified sps-params-2.20261015-1754-3mod-simulink-bench | -46.0 | -47.4 | 741.5 | 742.5 | -0.6 | 16.1 | diag(kI) M^-1 of the gain set |
| identified sps-params-2.20261016-1628-3mod-qspice300-bench | -45.3 | -45.7 | 58.8 | 56.8 | -17.0 | 1.6 | diag(kI) M^-1 of the gain set |
| identified sps-params-2.20261016-1751-3mod-qspice400-bench | -41.6 | -42.9 | 23.5 | 23.0 | -14.4 | 2.3 | diag(kI) M^-1 of the gain set |
| identified sps-params-2.20261016-1804-3mod-qspice400d1-bench | -42.7 | -43.8 | 26.2 | 26.0 | -10.3 | 1.9 | diag(kI) M^-1 of the gain set |

Rows [vd1 vd2 ic1 ic2], columns [uc1 uc2 ud1 ud2]; V per unit modal duty, A per unit modal duty.

## 7 · Findings (computed)

1. Open-loop duty steps on the bench: Δv_d = -1.87, +0.91, +0.94, -1.86 V measured for Δu_c = ±0.04 / −0.02 against −V̄·Δu_c = ∓1.86 / +0.93 V predicted by the averaged model with V̄ = 46.6 V — the DC gain −V̄ of the voltage block of G(N) is confirmed on hardware to 1.2 %.
2. Closed-loop steady state on hardware: |v_d2 error| ≤ 0.010 V and |i_c2| ≤ 0.066 A over 22 settled segments (kscale 0.1–0.8, 200–400 kHz, bench and PV): the integral decoupling controller holds its references with no measurable offset; the residual is sensing noise (v_d2 std 0.013–0.172 V).
3. Instability: B07 at 300 kHz with kscale 0.6 (17:38:34, 6 s) oscillated — v_d2 std 1.41 V, pk-pk 11.8 V, dominant 3.2 Hz in the 44 Hz telemetry (aliased) — before it was stopped; the 300 kHz gain set was identified at 200 kHz-plant resistance 0.8 Ω and loses margin at higher gain (DESIGN_LOG 6.8).
4. Gain changes applied while the loop was running tripped the firmware within 2 s in 3 cases: B04 16:07:50 (kscale 0.4 → fault 16 (module UV)); B07 17:37:56 (kscale 0.6 → fault 8192 (main loop stall)); B07 17:39:41 (kscale 0.3 → fault 8192 (main loop stall)) — `C,APPLY` during RUN_CL stalls the control loop (fault 0x2000) or over-currents it; gains should be set before the loop is closed.
5. Loop closures: the soft-start ramp leaves a residual of 0.00–0.80 V on v_d2 which the loop removes within one telemetry sample in 10 of 23 cases (the rest within 3 s, noise-limited); rise, peak and settling times of the loop itself are below the 23 ms sample and are reported as bounds.
6. Simulated +1 V reference step, τ relative to the first-order design 1/(k·2π·150): analytical 0.86–1.22×; QSPICE 0.52–1.17×; Simulink twin 0.38–1.10×; overshoot appears only at kscale ≥ 0.5 (8.8 % max, qspice, simulink).
7. Solar energy: module 1 carried -0.03 A on average in all 11 windows (dead or shaded all afternoon, by the firmware's own reconstruction and by KCL), so the shufflers delivered the other two modules' power to a 61 V CV load that a plain series string could not have supplied at all: E_returned = 10.62 Wh ≈ E_load over 36 min of RUN time; at the S02 irradiance peak the returned power reached 99 W.
8. Switching ripple: the QSPICE device model reproduces Δi_c = V̄/(2 f_sw (L+M)) at 200 / 300 / 400 kHz to 3.0 % (8.39 A at 200 kHz, 5.58 A at 300 kHz, 4.11 A at 400 kHz); the telemetry's current noise (sensing-filtered, 45 Hz) is 1.4 A pk-pk at most and is not the ripple.
9. Telemetry rate: B02, B03, B04 ran at 11–14 Hz instead of ~44 Hz (16 Oct 200 kHz closed-loop runs); every hardware time metric there is a ≥ 70 ms bound.

## 8 · Figure index

### 8.1 Presentation slides → regenerated figures

| slide | case | overview (RUN rows only) | event zooms |
|---|---|---|---|
| p48 | B01 bench_200k_OL | [B01_bench_200k_OL_overview](out/figures/hardware/B01_bench_200k_OL_overview.pdf) ([png](out/figures/hardware/B01_bench_200k_OL_overview.png)) | [e10_load_step](out/figures/events/B01_e10_load_step.pdf), [e11_load_step](out/figures/events/B01_e11_load_step.pdf), [e1_load_step](out/figures/events/B01_e1_load_step.pdf), [e2_load_step](out/figures/events/B01_e2_load_step.pdf), [e5_load_step](out/figures/events/B01_e5_load_step.pdf), [e6_load_step](out/figures/events/B01_e6_load_step.pdf), [e7_load_step](out/figures/events/B01_e7_load_step.pdf), [e8_load_step](out/figures/events/B01_e8_load_step.pdf), [e9_load_step](out/figures/events/B01_e9_load_step.pdf) |
| - | B01s bench_200k_OL_dutysteps | [B01s_bench_200k_OL_dutysteps_overview](out/figures/hardware/B01s_bench_200k_OL_dutysteps_overview.pdf) ([png](out/figures/hardware/B01s_bench_200k_OL_dutysteps_overview.png)) | [e3_duty_step](out/figures/events/B01s_e3_duty_step.pdf), [e5_duty_step](out/figures/events/B01s_e5_duty_step.pdf), [e6_duty_step](out/figures/events/B01s_e6_duty_step.pdf), [e7_load_step](out/figures/events/B01s_e7_load_step.pdf), [e9_duty_step](out/figures/events/B01s_e9_duty_step.pdf) |
| p42 | B02 bench_200k_CL_k0.1 | [B02_bench_200k_CL_k0.1_overview](out/figures/hardware/B02_bench_200k_CL_k0.1_overview.pdf) ([png](out/figures/hardware/B02_bench_200k_CL_k0.1_overview.png)) | [e1_close](out/figures/events/B02_e1_close.pdf), [e2_close](out/figures/events/B02_e2_close.pdf) |
| p43 | B03 bench_200k_CL_k0.3b | [B03_bench_200k_CL_k0.3b_overview](out/figures/hardware/B03_bench_200k_CL_k0.3b_overview.pdf) ([png](out/figures/hardware/B03_bench_200k_CL_k0.3b_overview.png)) | [e1_close](out/figures/events/B03_e1_close.pdf), [e2_load_step](out/figures/events/B03_e2_load_step.pdf), [e3_load_step](out/figures/events/B03_e3_load_step.pdf) |
| p44 | B04 bench_200k_CL_k0.3 | [B04_bench_200k_CL_k0.3_overview](out/figures/hardware/B04_bench_200k_CL_k0.3_overview.pdf) ([png](out/figures/hardware/B04_bench_200k_CL_k0.3_overview.png)) | [e1_close](out/figures/events/B04_e1_close.pdf), [e2_kscale_apply](out/figures/events/B04_e2_kscale_apply.pdf) |
| p49 | B05 bench_300k_OL | [B05_bench_300k_OL_overview](out/figures/hardware/B05_bench_300k_OL_overview.pdf) ([png](out/figures/hardware/B05_bench_300k_OL_overview.png)) | - |
| p45 | B06 bench_300k_CL_k0.3 | [B06_bench_300k_CL_k0.3_overview](out/figures/hardware/B06_bench_300k_CL_k0.3_overview.pdf) ([png](out/figures/hardware/B06_bench_300k_CL_k0.3_overview.png)) | [e1_close](out/figures/events/B06_e1_close.pdf), [e2_load_step](out/figures/events/B06_e2_load_step.pdf), [e3_close](out/figures/events/B06_e3_close.pdf), [e4_load_step](out/figures/events/B06_e4_load_step.pdf), [e5_load_step](out/figures/events/B06_e5_load_step.pdf), [e6_load_step](out/figures/events/B06_e6_load_step.pdf), [e7_load_step](out/figures/events/B06_e7_load_step.pdf), [e8_load_step](out/figures/events/B06_e8_load_step.pdf), [e9_load_step](out/figures/events/B06_e9_load_step.pdf) |
| p46 | B07 bench_300k_CL_k0.5 | [B07_bench_300k_CL_k0.5_overview](out/figures/hardware/B07_bench_300k_CL_k0.5_overview.pdf) ([png](out/figures/hardware/B07_bench_300k_CL_k0.5_overview.png)) | [e15_close](out/figures/events/B07_e15_close.pdf), [e1_load_step](out/figures/events/B07_e1_load_step.pdf), [e20_close](out/figures/events/B07_e20_close.pdf), [e21_kscale_apply](out/figures/events/B07_e21_kscale_apply.pdf), [e23_close](out/figures/events/B07_e23_close.pdf), [e2_load_step](out/figures/events/B07_e2_load_step.pdf), [e8_close](out/figures/events/B07_e8_close.pdf), [e9_kscale_apply](out/figures/events/B07_e9_kscale_apply.pdf) |
| p50 | B08 bench_400k_OL | [B08_bench_400k_OL_overview](out/figures/hardware/B08_bench_400k_OL_overview.pdf) ([png](out/figures/hardware/B08_bench_400k_OL_overview.png)) | [e2_load_step](out/figures/events/B08_e2_load_step.pdf), [e3_kscale_apply](out/figures/events/B08_e3_kscale_apply.pdf) |
| p47 | B09 bench_400k_CL_k0.3 | [B09_bench_400k_CL_k0.3_overview](out/figures/hardware/B09_bench_400k_CL_k0.3_overview.pdf) ([png](out/figures/hardware/B09_bench_400k_CL_k0.3_overview.png)) | [e1_close](out/figures/events/B09_e1_close.pdf), [e2_close](out/figures/events/B09_e2_close.pdf), [e3_close](out/figures/events/B09_e3_close.pdf), [e4_load_step](out/figures/events/B09_e4_load_step.pdf), [e7_close](out/figures/events/B09_e7_close.pdf) |
| p24 | S01 solar_200k_OL_peak | [S01_solar_200k_OL_peak_overview](out/figures/hardware/S01_solar_200k_OL_peak_overview.pdf) ([png](out/figures/hardware/S01_solar_200k_OL_peak_overview.png)) | [e2_mismatch_off](out/figures/events/S01_e2_mismatch_off.pdf), [e3_irradiance_down](out/figures/events/S01_e3_irradiance_down.pdf) |
| p25 | S02 solar_200k_CL_k0.1_peak | [S02_solar_200k_CL_k0.1_peak_overview](out/figures/hardware/S02_solar_200k_CL_k0.1_peak_overview.pdf) ([png](out/figures/hardware/S02_solar_200k_CL_k0.1_peak_overview.png)) | [e1_close](out/figures/events/S02_e1_close.pdf), [e2_mismatch_on](out/figures/events/S02_e2_mismatch_on.pdf), [e3_irradiance_up](out/figures/events/S02_e3_irradiance_up.pdf), [e4_irradiance_down](out/figures/events/S02_e4_irradiance_down.pdf), [e5_mismatch_off](out/figures/events/S02_e5_mismatch_off.pdf), [e6_mismatch_on](out/figures/events/S02_e6_mismatch_on.pdf), [e7_mismatch_off](out/figures/events/S02_e7_mismatch_off.pdf) |
| p26 | S03 solar_200k_OL_min | [S03_solar_200k_OL_min_overview](out/figures/hardware/S03_solar_200k_OL_min_overview.pdf) ([png](out/figures/hardware/S03_solar_200k_OL_min_overview.png)) | [e2_mismatch_on](out/figures/events/S03_e2_mismatch_on.pdf), [e3_mismatch_off](out/figures/events/S03_e3_mismatch_off.pdf), [e4_mismatch_off](out/figures/events/S03_e4_mismatch_off.pdf) |
| p27 | S04 solar_200k_CL_k0.1_min | [S04_solar_200k_CL_k0.1_min_overview](out/figures/hardware/S04_solar_200k_CL_k0.1_min_overview.pdf) ([png](out/figures/hardware/S04_solar_200k_CL_k0.1_min_overview.png)) | [e1_close](out/figures/events/S04_e1_close.pdf) |
| p37 | S05 solar_200k_CL_k0.2_min | [S05_solar_200k_CL_k0.2_min_overview](out/figures/hardware/S05_solar_200k_CL_k0.2_min_overview.pdf) ([png](out/figures/hardware/S05_solar_200k_CL_k0.2_min_overview.png)) | [e1_close](out/figures/events/S05_e1_close.pdf), [e2_mismatch_on](out/figures/events/S05_e2_mismatch_on.pdf) |
| p38 | S06 solar_200k_CL_k0.3_min | [S06_solar_200k_CL_k0.3_min_overview](out/figures/hardware/S06_solar_200k_CL_k0.3_min_overview.pdf) ([png](out/figures/hardware/S06_solar_200k_CL_k0.3_min_overview.png)) | [e1_close](out/figures/events/S06_e1_close.pdf) |
| p39 | S07 solar_200k_CL_k0.4_min | [S07_solar_200k_CL_k0.4_min_overview](out/figures/hardware/S07_solar_200k_CL_k0.4_min_overview.pdf) ([png](out/figures/hardware/S07_solar_200k_CL_k0.4_min_overview.png)) | [e1_close](out/figures/events/S07_e1_close.pdf) |
| p40 | S08 solar_200k_CL_k0.5_min | [S08_solar_200k_CL_k0.5_min_overview](out/figures/hardware/S08_solar_200k_CL_k0.5_min_overview.pdf) ([png](out/figures/hardware/S08_solar_200k_CL_k0.5_min_overview.png)) | [e1_close](out/figures/events/S08_e1_close.pdf), [e2_mismatch_on](out/figures/events/S08_e2_mismatch_on.pdf) |
| - | S09 solar_200k_CL_k0.6_min | [S09_solar_200k_CL_k0.6_min_overview](out/figures/hardware/S09_solar_200k_CL_k0.6_min_overview.pdf) ([png](out/figures/hardware/S09_solar_200k_CL_k0.6_min_overview.png)) | [e1_close](out/figures/events/S09_e1_close.pdf) |
| - | S10 solar_200k_CL_k0.7_min | [S10_solar_200k_CL_k0.7_min_overview](out/figures/hardware/S10_solar_200k_CL_k0.7_min_overview.pdf) ([png](out/figures/hardware/S10_solar_200k_CL_k0.7_min_overview.png)) | [e1_close](out/figures/events/S10_e1_close.pdf) |
| - | S11 solar_200k_CL_k0.8_min | [S11_solar_200k_CL_k0.8_min_overview](out/figures/hardware/S11_solar_200k_CL_k0.8_min_overview.pdf) ([png](out/figures/hardware/S11_solar_200k_CL_k0.8_min_overview.png)) | [e1_close](out/figures/events/S11_e1_close.pdf) |

### 8.2 Simulation figures

- **Analytical model** (28): [S1_BENCH_f200k_k0.1](out/figures/analytical/S1_BENCH_f200k_k0.1.pdf), [S1_BENCH_f200k_k0.3](out/figures/analytical/S1_BENCH_f200k_k0.3.pdf), [S1_BENCH_f200k_k1](out/figures/analytical/S1_BENCH_f200k_k1.pdf), [S1_BENCH_f300k_k0.3](out/figures/analytical/S1_BENCH_f300k_k0.3.pdf), [S1_BENCH_f400k_k0.3](out/figures/analytical/S1_BENCH_f400k_k0.3.pdf), [S1_PV80_f200k_k0.1](out/figures/analytical/S1_PV80_f200k_k0.1.pdf), [S1_PV80_f200k_k0.3](out/figures/analytical/S1_PV80_f200k_k0.3.pdf), [S1_PV80_f200k_k1](out/figures/analytical/S1_PV80_f200k_k1.pdf), [S1_PV80_f300k_k0.3](out/figures/analytical/S1_PV80_f300k_k0.3.pdf), [S1_PV80_f400k_k0.3](out/figures/analytical/S1_PV80_f400k_k0.3.pdf), [S3_PV80_f200k_k0.1](out/figures/analytical/S3_PV80_f200k_k0.1.pdf), [S3_PV80_f200k_k0.3](out/figures/analytical/S3_PV80_f200k_k0.3.pdf), [S3_PV80_f200k_k1](out/figures/analytical/S3_PV80_f200k_k1.pdf), [S3_PV80_f300k_k0.3](out/figures/analytical/S3_PV80_f300k_k0.3.pdf), [S3_PV80_f400k_k0.3](out/figures/analytical/S3_PV80_f400k_k0.3.pdf), [S4_BENCH_f200k_k0.1](out/figures/analytical/S4_BENCH_f200k_k0.1.pdf), [S4_BENCH_f200k_k0.3](out/figures/analytical/S4_BENCH_f200k_k0.3.pdf), [S4_BENCH_f200k_k1](out/figures/analytical/S4_BENCH_f200k_k1.pdf), [S4_BENCH_f300k_k0.3](out/figures/analytical/S4_BENCH_f300k_k0.3.pdf), [S4_BENCH_f400k_k0.3](out/figures/analytical/S4_BENCH_f400k_k0.3.pdf), [S4_PV80_f200k_k0.1](out/figures/analytical/S4_PV80_f200k_k0.1.pdf), [S4_PV80_f200k_k0.3](out/figures/analytical/S4_PV80_f200k_k0.3.pdf), [S4_PV80_f200k_k1](out/figures/analytical/S4_PV80_f200k_k1.pdf), [S4_PV80_f300k_k0.3](out/figures/analytical/S4_PV80_f300k_k0.3.pdf), [S4_PV80_f400k_k0.3](out/figures/analytical/S4_PV80_f400k_k0.3.pdf), [S5_BENCH_f200k_k0_uc1+0.04](out/figures/analytical/S5_BENCH_f200k_k0_uc1+0.04.pdf), [S5_BENCH_f200k_k0_uc1uc2-0.02](out/figures/analytical/S5_BENCH_f200k_k0_uc1uc2-0.02.pdf), [S5_BENCH_f200k_k0_uc2+0.04](out/figures/analytical/S5_BENCH_f200k_k0_uc2+0.04.pdf)
- **QSPICE** (25): [S1_BENCH_k0.1](out/figures/qspice/S1_BENCH_k0.1.pdf), [S1_BENCH_k0.2](out/figures/qspice/S1_BENCH_k0.2.pdf), [S1_BENCH_k0.3](out/figures/qspice/S1_BENCH_k0.3.pdf), [S1_BENCH_k0.5](out/figures/qspice/S1_BENCH_k0.5.pdf), [S1_BENCH_k1](out/figures/qspice/S1_BENCH_k1.pdf), [S1_PV80_k0.1](out/figures/qspice/S1_PV80_k0.1.pdf), [S1_PV80_k0.2](out/figures/qspice/S1_PV80_k0.2.pdf), [S1_PV80_k0.3](out/figures/qspice/S1_PV80_k0.3.pdf), [S1_PV80_k0.5](out/figures/qspice/S1_PV80_k0.5.pdf), [S1_PV80_k1](out/figures/qspice/S1_PV80_k1.pdf), [S3_PV80_k0.1](out/figures/qspice/S3_PV80_k0.1.pdf), [S3_PV80_k0.2](out/figures/qspice/S3_PV80_k0.2.pdf), [S3_PV80_k0.3](out/figures/qspice/S3_PV80_k0.3.pdf), [S3_PV80_k0.5](out/figures/qspice/S3_PV80_k0.5.pdf), [S3_PV80_k1](out/figures/qspice/S3_PV80_k1.pdf), [S4_BENCH_k0.1](out/figures/qspice/S4_BENCH_k0.1.pdf), [S4_BENCH_k0.2](out/figures/qspice/S4_BENCH_k0.2.pdf), [S4_BENCH_k0.3](out/figures/qspice/S4_BENCH_k0.3.pdf), [S4_BENCH_k0.5](out/figures/qspice/S4_BENCH_k0.5.pdf), [S4_BENCH_k1](out/figures/qspice/S4_BENCH_k1.pdf), [S4_PV80_k0.1](out/figures/qspice/S4_PV80_k0.1.pdf), [S4_PV80_k0.2](out/figures/qspice/S4_PV80_k0.2.pdf), [S4_PV80_k0.3](out/figures/qspice/S4_PV80_k0.3.pdf), [S4_PV80_k0.5](out/figures/qspice/S4_PV80_k0.5.pdf), [S4_PV80_k1](out/figures/qspice/S4_PV80_k1.pdf)
- **Simulink carpark twin, scenarios** (25): [S1_BENCH_k0.1](out/figures/carpark/S1_BENCH_k0.1.pdf), [S1_BENCH_k0.2](out/figures/carpark/S1_BENCH_k0.2.pdf), [S1_BENCH_k0.3](out/figures/carpark/S1_BENCH_k0.3.pdf), [S1_BENCH_k0.5](out/figures/carpark/S1_BENCH_k0.5.pdf), [S1_BENCH_k1](out/figures/carpark/S1_BENCH_k1.pdf), [S1_PV80_k0.1](out/figures/carpark/S1_PV80_k0.1.pdf), [S1_PV80_k0.2](out/figures/carpark/S1_PV80_k0.2.pdf), [S1_PV80_k0.3](out/figures/carpark/S1_PV80_k0.3.pdf), [S1_PV80_k0.5](out/figures/carpark/S1_PV80_k0.5.pdf), [S1_PV80_k1](out/figures/carpark/S1_PV80_k1.pdf), [S3_PV80_k0.1](out/figures/carpark/S3_PV80_k0.1.pdf), [S3_PV80_k0.2](out/figures/carpark/S3_PV80_k0.2.pdf), [S3_PV80_k0.3](out/figures/carpark/S3_PV80_k0.3.pdf), [S3_PV80_k0.5](out/figures/carpark/S3_PV80_k0.5.pdf), [S3_PV80_k1](out/figures/carpark/S3_PV80_k1.pdf), [S4_BENCH_k0.1](out/figures/carpark/S4_BENCH_k0.1.pdf), [S4_BENCH_k0.2](out/figures/carpark/S4_BENCH_k0.2.pdf), [S4_BENCH_k0.3](out/figures/carpark/S4_BENCH_k0.3.pdf), [S4_BENCH_k0.5](out/figures/carpark/S4_BENCH_k0.5.pdf), [S4_BENCH_k1](out/figures/carpark/S4_BENCH_k1.pdf), [S4_PV80_k0.1](out/figures/carpark/S4_PV80_k0.1.pdf), [S4_PV80_k0.2](out/figures/carpark/S4_PV80_k0.2.pdf), [S4_PV80_k0.3](out/figures/carpark/S4_PV80_k0.3.pdf), [S4_PV80_k0.5](out/figures/carpark/S4_PV80_k0.5.pdf), [S4_PV80_k1](out/figures/carpark/S4_PV80_k1.pdf)
- **Simulink carpark validate suite** (5): [01_uniform-zero](out/figures/carpark_validate/01_uniform-zero.pdf), [02_decoupling](out/figures/carpark_validate/02_decoupling.pdf), [03_shade-balanced](out/figures/carpark_validate/03_shade-balanced.pdf), [04_shade-refs](out/figures/carpark_validate/04_shade-refs.pdf), [05_shade-deep](out/figures/carpark_validate/05_shade-deep.pdf)
- **Simulink MIL validate suite** (7): [01_uniform-zero](out/figures/mil_validate/01_uniform-zero.pdf), [02_decoupling](out/figures/mil_validate/02_decoupling.pdf), [03_shade-balanced](out/figures/mil_validate/03_shade-balanced.pdf), [04_shade-refs](out/figures/mil_validate/04_shade-refs.pdf), [05_shade-deep](out/figures/mil_validate/05_shade-deep.pdf), [06_mppt-uniform](out/figures/mil_validate/06_mppt-uniform.pdf), [07_mppt-shade](out/figures/mil_validate/07_mppt-shade.pdf)

The MATLAB validate suites also write their own PDF figures (10 pt, light theme, zoom tiles) next to the old SVGs: `4_Simulink/3_Carpark_3mod/figs/*.pdf`, `4_Simulink/1_MIL_Model_In_The_Loop/figs/*.pdf`.

### 8.3 Comparison and energy

- [S5_duty_steps_hw_vs_analytical](out/figures/compare/S5_duty_steps_hw_vs_analytical.pdf)
- [hw_steady_state_vs_kscale](out/figures/compare/hw_steady_state_vs_kscale.pdf)
- [metrics_vs_kscale](out/figures/compare/metrics_vs_kscale.pdf)
- [ripple_vs_fsw](out/figures/compare/ripple_vs_fsw.pdf)
- [S02_shade_power](out/figures/energy/S02_shade_power.pdf)
- [solar_energy](out/figures/energy/solar_energy.pdf)

## 9 · Caveats

- Hardware times shorter than one telemetry frame (23 ms at 44 Hz, 70–90 ms on the 11–14 Hz runs) are bounds, not measurements; the Pi stamps frames on receipt (jitter up to ~60 ms) and the firmware's millisecond counter is not stored.
- The 45 Hz current samples are point samples of a sensing-filtered signal; the "ripple" they show is noise and is labelled so. True switching ripple is only available from QSPICE and the analytical law.
- VM1 (and so v_d1, V_string) on hardware comes from the e-load through the Pi at 2–5 Hz; v_d2 is the trustworthy controlled voltage.
- Module currents on hardware are reconstructed by KCL from the winding currents, duties and the e-load current (identical to the firmware's IM1r / IM2r); on the 16 Oct 200 kHz runs before the ADC fix the winding-current telemetry gives channel currents inconsistent with current-limited PSUs, so bench module currents are indicative. The 16 Oct NGE103 limits per channel were not logged.
- Slide 43 ("kscale 20 %") ran at kscale 0.3 (telemetry kscale 0.3, pset 0 = boot default after the re-flash); it is reported as 0.3.
- The 20 Oct shade candidates are detector output (current-mismatch and string-power level shifts); irradiance was not logged, so open-loop and closed-loop windows are compared only as adjacent windows.
- The analytical bench plant is the operating point seen in the telemetry (three channels at 23.3 V, all in current limit); in IDLE the channels sit at 25 / 20 / 25 V, which is the −5 V idle mismatch of the closures.
- MIL (4 modules) exists only at kscale 1 with its own 540 W modules; its cold-start validate tests are not the same experiment as the settled reference steps of the other phases.
- QSPICE and Simulink scenario runs exist at kscale 0.1 / 0.3 / 1 (plus 0.2 / 0.5 where `make qspice-extra` / `make simulink-extra` have run); the hardware ran 0.1–0.8.
