saunders-jared-final/Boost-Brigade/0_Documentation/jared-assessment/CapstoneDelivery_latex/appendices/J_solar_raw.tex

\section{Solar Test Records (20 Oct 2026)}
\label{app:solar}
Carpark string of three KAUSSP80 modules into the DL3021 at 61\,V CV, 200\,kHz. Peak sun 15:04--15:13 (S01 open loop, S02 closed loop $k=0.1$), minimal sun from 15:48 (S03 open loop, S04--S11 closed loop, $k = 0.1$ to 0.8). Module currents are reconstructed by KCL from the winding currents, duties and the e-load current.

\input{tables/T7_energy_solar}
\input{tables/T3_shade}
