saunders-jared-final/Boost-Brigade/0_Documentation/jared-assessment/CapstoneDelivery_latex/tables/G_compare.tex

% generated by tools/make_tables.py -- do not edit by hand
\begin{table}[htbp]\centering
\footnotesize
\caption[{DC gain matrix $G(N)$ read as ``what 1\,\% of duty does''}]{DC gain matrix $G(N)$ read as ``what 1\,\% of duty does'': the voltage block (common-mode duty $u_c$ to the voltage difference $v_d$) and the current block (differential-mode duty $u_d$ to the circulating current $i_c$), shuffler 1 / shuffler 2 where they differ. The last column is the dead-time cross-coupling that only the switching model shows. The gain sets store $M = G^{-1}\mathrm{diag}(k_I)$, so $G = \mathrm{diag}(k_I)\,M^{-1}$.}\label{tab:G}
\begin{tabular}{l l r r r}
\toprule
Obtained from & Plant & \makecell[r]{$\Delta v_d$ [V] per\\1\,\% of $u_c$} & \makecell[r]{$\Delta i_c$ [A] per\\1\,\% of $u_d$} & \makecell[r]{cross: $\Delta v_{d1}$ [V]\\per 1\,\% of $u_{d1}$} \\
\midrule
Analytical & Solar string, averaged switches ($R = 61$\,m$\Omega$) & -0.40 & 6.72 & 0.00 \\
Analytical & Solar string, 200\,kHz ($R_{sw} = 0.29\,\Omega$) & -0.38 & 1.41 & 0.00 \\
Analytical & Solar string, 400\,kHz ($R_{sw} = 1.72\,\Omega$) & -0.29 & 0.24 & 0.00 \\
Analytical & Bench supplies in current limit, 200\,kHz & -0.47 & 1.61 & 0.00 \\
Simulink step tests & Bench, averaged switches (rejected) & -0.46 / -0.47 & 7.42 / 7.42 & -0.01 \\
QSPICE step tests & Bench, 200\,kHz (deployed) & -0.46 / -0.47 & 1.43 / 1.39 & -0.25 \\
QSPICE step tests & Bench, 300\,kHz (deployed) & -0.45 & 0.59 / 0.57 & -0.17 \\
QSPICE step tests & Bench, 400\,kHz (deployed) & -0.42 / -0.43 & 0.23 & -0.14 \\
\bottomrule
\end{tabular}
\end{table}
