saunders-jared-final/Boost-Brigade/0_Documentation/jared-assessment/CapstoneDelivery_latex/tables/T3_kscale.tex

% generated by tools/make_tables.py -- do not edit by hand
\begin{table}[htbp]\centering
\scriptsize
\caption{Gain changes applied while the loop was running (\texttt{C,APPLY} during RUN\_CL) and the 300 kHz stability limit (from T1/T3 and the pod command log).}\label{tab:T3kscale}
\begin{tabular}{l l p{5.5cm} p{6cm}}
\toprule
Case & Time & Action & Outcome \\
\midrule
B04 & 16:07:50 & kscale 0.3 $\rightarrow$ 0.4 applied in RUN\_CL & fault 0x10 (module UV) within 1 s \\
B07 & 17:37:56 & kscale 0.5 $\rightarrow$ 0.6 applied in RUN\_CL & fault 0x2000 (main-loop stall) within 2 s \\
B07 & 17:38:34 & kscale 0.6 run (6 s) & oscillation: $\sigma(v_{d2})$ 1.41 V, pk-pk 11.8 V, 3.2 Hz aliased \\
B07 & 17:39:41 & kscale 0.6 $\rightarrow$ 0.3 applied in RUN\_CL & fault 0x2000 (main-loop stall) within 2 s \\
B08 & 18:03:40 & PSU change + gain set 400 kHz & OC fault 0x01, restarted \\
\bottomrule
\end{tabular}
\end{table}
