saunders-jared-final/Boost-Brigade/0_Documentation/jared-assessment/CapstoneDelivery_latex/tables/T6_ripple.tex

% generated by tools/make_tables.py -- do not edit by hand
\begin{table}[htbp]\centering
\small
\caption[{Peak-to-peak switching ripple: analytical against QSPICE}]{Peak-to-peak switching ripple in A. The circulating mode sees $L+M$, so the analytical law is $\Delta i_c = \bar V/(2 f_{sw}(L+M))$ with $L+M = 13.75\,\mu$H and $\bar V = 46.6$\,V. Each winding carries half of it ($\Delta i_A$); in the shuffled current the two interleaved windings cancel ($\Delta i_m$). The 44\,Hz telemetry cannot see the ripple: its $\sigma(i_c)$ is sensing noise.}\label{tab:T6}
\begin{tabular}{r r r r r r r}
\toprule
$f_{sw}$ [kHz] & \makecell[r]{$\Delta i_c$\\analytical} & \makecell[r]{$\Delta i_c$\\QSPICE} & \makecell[r]{$\Delta i_A$ per\\winding} & \makecell[r]{$\Delta i_m$\\QSPICE} & \makecell[r]{QSPICE vs\\analytical} & \makecell[r]{telemetry\\$\sigma(i_c)$} \\
\midrule
200 & 8.47 & 8.39 & 4.25 & 0.19 & -1\,\% & 0.30 \\
300 & 5.65 & 5.58 & 2.85 & 0.20 & -1\,\% & 0.05 \\
400 & 4.24 & 4.09 & 2.18 & 0.39 & -3\,\% & 0.08 \\
\bottomrule
\end{tabular}
\end{table}
