saunders-jared-final/Boost-Brigade/0_Documentation/jared-assessment/CapstoneDelivery_latex/tables/T7_energy_bench.tex

% generated by tools/make_tables.py -- do not edit by hand
\begin{table}[htbp]\centering
\scriptsize
\caption[{Power and energy in the bench test windows (16 Oct 2026)}]{Bench (16 Oct 2026, NGE103 three-channel PSU into a 70\,V CV load): power processed through the shufflers and reconstructed channel currents (indicative before the ADC fix).}\label{tab:T7bench}
\begin{tabular}{l l r r r r r r r r r r}
\toprule
Case & Loop & $f_{sw}$ & $T$ [s] & $\bar P_{load}$ [W] & $\bar P_{shuf}$ [W] & $I_{M1}$ & $I_{M2}$ & $I_{M3}$ & $E_{load}$ [Wh] & $E_{shuf}$ [Wh] & $\eta$ [\%] \\
\midrule
B01 & OL & 200 & 707 & 67.2 & 79.0 & 1.18 & -0.72 & 2.42 & 13.20 & 15.52 & 99.6 \\
B01s & OL & 200 & 413 & 65.5 & 65.4 & 1.32 & -0.47 & 1.95 & 7.52 & 7.50 & 99.8 \\
B02 & CL & 200 & 162 & 44.5 & 16.5 & 0.81 & 0.41 & 0.69 & 2.00 & 0.74 & 100.0 \\
B03 & CL & 200 & 144 & 40.6 & 5.0 & 0.63 & 0.51 & 0.60 & 1.62 & 0.20 & 100.0 \\
B04 & CL & 200 & 48 & 40.6 & 6.6 & 0.67 & 0.51 & 0.56 & 0.54 & 0.09 & 100.0 \\
B05 & OL & 300 & 306 & 68.9 & 26.1 & 1.26 & 0.42 & 1.27 & 5.86 & 2.22 & 99.7 \\
B06 & CL & 300 & 513 & 43.3 & 18.5 & 0.83 & 0.24 & 0.79 & 6.17 & 2.64 & 99.7 \\
B07 & CL & 300 & 298 & 52.0 & 15.4 & 0.91 & 0.43 & 0.89 & 4.31 & 1.27 & 99.8 \\
B08 & OL & 400 & 153 & 62.7 & 11.9 & 1.05 & 0.64 & 0.99 & 2.66 & 0.50 & 99.8 \\
B09 & CL & 400 & 397 & 59.6 & 12.7 & 1.01 & 0.58 & 0.97 & 6.57 & 1.40 & 99.7 \\
\bottomrule
\end{tabular}
\end{table}
