saunders-jared-final/Boost-Brigade/Documentation/annotated-n11034459_Progress_Report_EGH490_1_V2.pdf

Adaptive Control of Solar Power Shufflers Progress Report | Jared Saunders · n11034459

QUEENSLAND UNIVERSITY OF TECHNOLOGY EGH490-2 · Research Project 2 Progress Report

PROGRESS REPORT

# Adaptive Control of Solar Power Shufflers for

## Maximum Power Point Tracking Under Partial Shading

APPLICATION OF MODERN STATE-SPACE METHODS TO SERIAL PARTIAL POWER CONVERTERS

STUDENT ENGINEER | SUPERVISOR
Jared Saunders | Assoc Prof Geoff Walker
n11034459 | School of Electrical Engineering & Robotics
Version | Date | Author | Changes / Comments
1.0 | 17/04/26 | Jared Saunders | Initial Proposal
2.0 | 29/05/26 | Jared Saunders | Semester 1 Progress Report

## 1. Executive Summary

This report documents the progress achieved during the first semester of the EGH490 capstone project Adaptive Control of Solar Power Shufflers for Maximum Power Point Tracking Under Partial Shading. The project investigates the application of modern state-space control methods to the serial partial power converter (S-PPC) topology, a class of differential power processing converter that mitigates the energy losses associated with partial shading of photovoltaic (PV) strings.

The project objective is to design a universal control system for an S-PPC string operating under partial shading. The intended end-application is a residential-scale PV-battery system; the controller must track the true global maximum power point of a shaded array while delivering stable power to a battery load. Expected outcomes by project completion are a validated mathematical model, a discretised cascaded controller implemented in firmware, a hardware prototype, and an experimental evaluation under representative partial shading scenarios.

Semester 1 has established the analytical foundation and an initial Simulink implementation. The averaged state-space model of the interleaved half-bridge shuffler has been derived from first principles, linearised about the equilibrium operating point, and analysed for stability, controllability and observability. The plant has been discretised at the target switching frequency and an analytical cascaded PI controller has been designed using classical frequency-domain methods. The PV string and shuffler topology have been implemented in MATLAB / Simulink and validated against analytical maximumpower-point predictions across three partial shading scenarios. Closure of the inner phase current loop has been attempted with a fixed current reference; this work has surfaced an instability under mismatched irradiance that is presently the dominant technical blocker (2.10.5).

Significant implementation work remains. The two outer loops (PV-voltage regulation and phase-current balance) are not yet closed in simulation, the QSPICE behavioural-source implementation of the PI controller is not yet operational, and the model does not yet include the MPPT outer loop or the battery load that defines the target end-use. The most significant project change is the deferral of the first PCB iteration from Semester 1 into early Semester 2, captured in Appendix A. The Semester 2 priority is to maintain momentum on these items so the buffer absorbed by the deferral is not extended further.

## 2. Interim Deliverables and Technical Progress

### 2.1 Checklist of Work Completed

The control systems work followed the modern state-space design process. Table 1 summarises the activities executed this semester and their current status. The presentation in 2.2 onwards walks through each item, beginning with the converter topology and ending with the inner-loop closure in Simulink and the present technical blocker.

Activity | Status
State-space modelling derivation, equilibrium, linearisation | Complete
Stability, controllability, observability analysis | Complete
Discretisation (ZOH) and analytical cascaded PI design | Complete
PV module characterisation (suitable representation) | Complete

Activity | Status
Simulink PV string model and partial-shading validation | Complete
Inner phase current loop (Loop 1) | In progress
Voltage loop (Loop 2) and phase-balance loop (Loop 3) | Not started
QSPICE PI controller implementation | Not yet working
MPPT integration and battery load model | Deferred to Sem 2
Compare Avg SS Model to Simulink Switching Model to QSPICE Model | Deferred to Sem 2

Table 1. Status of Semester 1 technical activities.

### 2.2 Power Shuffler Topology

The selected S-PPC topology is the interleaved half-bridge buck-boost converter with coupled inductors, shown in Figure 1. The converter sits between two PV substrings within a series-stacked string, sharing a common midpoint node V_mid. Each half-bridge leg comprises a high-side switch and a low-side switch in series, with each switch-node driving one winding of the coupled inductor. The two inductor windings share the common midpoint, providing the differential power path between the two PV substrings.

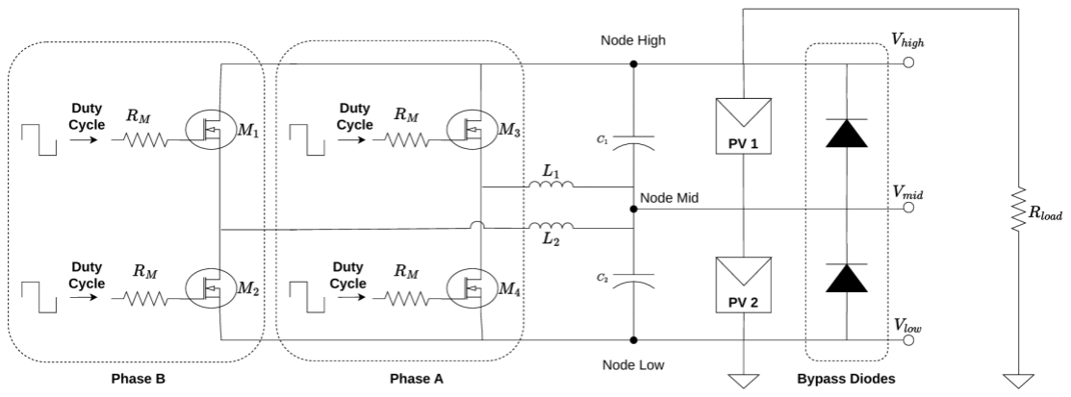
[picture p107: figure]

Figure 1. Interleaved half-bridge shuffler topology. Two PV substrings PV1 and PV2 stacked in series across the string output (V_high to V_low). Phase A (M3, M4) and Phase B (M1, M2) each drive one winding of the coupled inductor through their respective switch nodes; C1 and C2 are the substring decoupling capacitors. Bypass diodes are shown for completeness.

Figure 1 fixes the sign and node conventions used throughout the report and in Appendix B: V_C1 is the voltage across the top substring (V_high − V_mid), V_C2 is the voltage across the bottom substring (V_mid − V_low), and the phase currents I_L1 and I_L2 are positive in the direction V_mid → switch node. The load is taken across the full string (V_high to V_low) and represents the downstream battery / MPPTfront-end in the target application.

### 2.3 Switching State Identification

The interleaved half-bridge has four independently controlled switches, giving 2⁴ = 16 raw switch combinations. Seven of these are forbidden (any combination that simultaneously closes both switches in a single leg shorts that leg through the capacitor). The remaining nine valid states fall into three groups, summarised in Table 2. Only the four dual-switch states are control-relevant the four single-switch states and the all-off state are transient dead-time configurations dynamically equivalent to one of the dual-switch states depending on inductor-current polarity.

Group | Count | Role
Dual-switch (one switch closed per leg) | 4 | Control-relevant basis of the averaged model
Single-switch (only one switch closed) | 4 | Dead-time transient, body-diode dependent
All-off | 1 | Dead-time transient at PWM boundaries

Table 2. Grouping of the 9 valid topological states. The 4 dual-switch states form the averaged model basis (see Appendix B B.3 for the per-state derivations).

### 2.4 Averaged State-Space Model

The state vector adopted for the analysis is x = [I_L1, I_L2, V_C1, V_C2]ᵀ, with the duty cycles of the two phases d_A and d_B as control inputs and the PV substring currents I_pv1, I_pv2 together with the load current I_load as exogenous inputs. An individual state-space representation was derived for each of the four dual-switch states by direct application of Kirchhoff's current and voltage laws. Time-averaging weighted by the dwell fraction of each state d_A·d_B, d_A(1−d_B), (1−d_A)d_B, and (1−d_A)(1−d_B) respectively and assuming continuous conduction mode yields the averaged nonlinear model:

L₁ dI_L1/dt = −d_A V_C1 + (1 − d_A) V_C2

L₂ dI_L2/dt = −d_B V_C1 + (1 − d_B) V_C2

C₁ dV_C1/dt = d_A I_L1 + d_B I_L2 + Iₚᵥ₁ − I_load

C₂ dV_C2/dt = −(1 − d_A) I_L1 − (1 − d_B) I_L2 + Iₚᵥ₂

The structural pattern across the four states reduces to a simple rule: capacitor C1 receives current from each phase whose high-side switch is conducting, and C2 supplies current to each phase whose low-side switch is conducting. The input matrix is identical across all four states because the exogenous PV and load currents enter the capacitor nodes independently of switching state. The full per-state derivation, including the assembled bilinear A and B matrices, is in Appendix B B.3–B.4.

### 2.5 Equilibrium Operating Point

Setting all time derivatives to zero, the volt-second balance on the two inductors yields a structural constraint that the two duty cycles must be equal at steady state:

D_A = D_B ≡ D and V̄_C2/V̄_C1 = D/1 − D

This is a significant structural result, derived in Appendix B (B.6)–(B.7): the duty cycle sets the voltage ratio between the two PV substrings, which is the degree of freedom that the shuffler exploits to rebalance mismatched modules. The differential duty (d_A − d_B) is a transient control input only and cannot persist at steady state. Solving the capacitor charge-balance equations with the load current included gives the steady-state duty and average inductor current:

D = I_load − Iₚᵥ₁/I_load − Iₚᵥ₁ + Iₚᵥ₂, Ī = Iₚᵥ₂/2(1 − D)

The no-load case exposes a degenerate equilibrium in which all PV currents fall to zero, confirming that a finite load is required for a non-trivial steady state. This is the analytical justification for the load model carried through Appendix B B.5.

### 2.6 Linearisation About the Operating Point

Small-signal perturbation analysis was performed by substituting x = X̄+ x̃, d = D + d̃, u_pv = Ū_pv + ũ_pv into the averaged equations and retaining first-order terms. The resulting continuous-time linearised model takes the form ẋ̃= Ã·x̃+ B̃_d·d̃+ B̃_e·ũ_pv. The three matrices are shown in Figure 2.

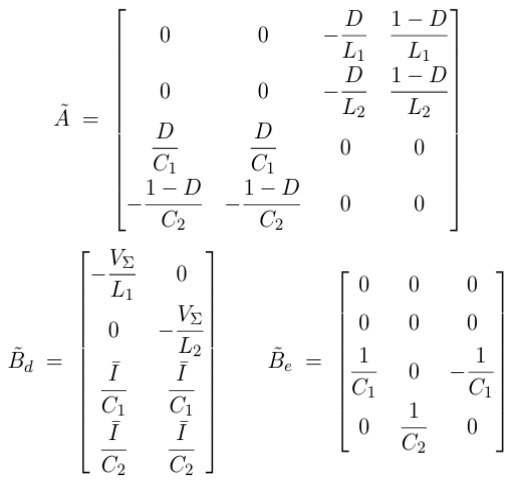
[picture p108: figure]

Figure 2. Linearised state-space matrices. Ã (top) carries operating-point dependence on D, L₁,₂ and C₁,₂. B̃_d (bottom-left) carries the duty-perturbation gains and depends on V_Σ = V̄_C1 + V̄_C2 and the steady-state per-phase current Ī. B̃_e (bottom-right) is duty-independent.

Figure 2 reveals that the duty perturbations decompose naturally into common-mode and differential-mode components. The common-mode duty ũ_c = (d̃_A + d̃_B)/2 drives the three-dimensional common-mode subsystem comprising I_Σ = I_L1 + I_L2, V_C1, and V_C2 this is where bus voltage regulation and ultimately MPPT live. The differential-mode duty ũ_δ = d̃_A − d̃_B drives the one-dimensional differential current I_Δ = I_L1 − I_L2 through a pure integrator, decoupled from the common-mode dynamics. This decomposition is the analytical basis for the cascaded control architecture in 2.9.

### 2.7 Stability, Controllability and Observability

### 2.7.1 Stability

The eigenvalues of Ã were derived analytically by exploiting its rank-deficient structure (rows 1 and 2 are identical when L₁ = L₂, as are columns 1 and 2). After modal reduction:

σ(Ã) ∈ { 0, 0, +jω₀, −jω₀ }, ω₀ = √(2D²/LC₁ + 2(1 − D)²/LC₂)

Substituting the design values L = 8.2 µH, C₁ = C₂ = 100 µF, D = 0.5 gives ω₀ ≈ 35 krad/s, corresponding to a natural resonance of approximately 5.5 kHz. The two zero eigenvalues correspond to integrator-like behaviour in the differential current mode and a conserved combination of the common-mode states; the imaginary pair represents an undamped LC oscillation. The open-loop system is therefore marginally stable. This is the expected result for a lossless converter model the controller must provide all damping.

### 2.7.2 Controllability

The modal decomposition makes the controllability conclusion straightforward: the one-dimensional differential mode is trivially controllable by the differential duty so long as V_Σ ≠ 0, and the three-dimensional common-mode subsystem is generically controllable by the common-mode duty so long as Ī ≠ 0. The plant is therefore fully controllable at any meaningful operating point. Loss of controllability occurs only at three boundary conditions: average inductor current Ī → 0 (the converter enters discontinuous conduction mode); duty cycle saturated to D = 0 or D = 1 (linearisation breaks down handled in implementation by anti-windup); and bus voltage V_Σ → 0 (physically unreachable).

### 2.7.3 Observability

Observability depends entirely on the chosen sensor set. The observability matrix was constructed for three candidate configurations (Table 3). The critical finding is that capacitor voltage measurements alone yield rank-3 observability the differential current mode is hidden, because the two capacitor voltages depend only on the sum I_L1 + I_L2 through the linearised dynamics. Per-phase current sensing is therefore a non-negotiable requirement for any interleaved implementation. Both phase currents will be measured directly in the hardware design, which removes the need for a state observer in the present project.

Sensor set | Rank of O | Observable?
V_C1, V_C2 only | 3 of 4 | No differential current is hidden
V_C1, V_C2, I_L1 | 4 of 4 | Yes (minimum viable set)
V_C1, V_C2, I_L1, I_L2 | 4 of 4 | Yes (full state directly measured)

Table 3. Observability of candidate sensor sets. The voltage-only case is rank-deficient (see Appendix B B.9).

### 2.8 Discretisation

The plant is intended to operate at a switching frequency of 200 kHz, giving T_sw = 5 µs. The control loop is sampled synchronously with the switching frequency to avoid beat artefacts. Discretisation of the plant uses the zero-order hold (ZOH) transformation, which is exact for piecewise-constant duty:

A_d = exp(Ã · Tₛ), B_d = [object Object]^Tₛ exp(Ã · τ) dτ · B̃

Because Ã is singular (two zero eigenvalues), the integral form is required and was evaluated via the augmented-matrix exponential. The discrete eigenvalues map to the unit circle: the two zero continuous eigenvalues become unity in discrete time, and the imaginary pair maps to cos(ω₀ T_s) ± j sin(ω₀ T_s) ≈ 0.985 ± j 0.174. The discrete plant inherits the continuous plant's marginal stability, as expected. Controller discretisation will use the Tustin (bilinear) transform when the analogue PI prototypes are converted to digital form.

### 2.9 Cascaded PI Controller Design

The modal decomposition in 2.6 motivates the three-loop cascaded architecture in Figure 3. The bandwidth allocation follows the standard cascaded-design rule of approximately 10× separation between adjacent loops so each outer loop sees its inner loop as a near-instantaneous tracker.

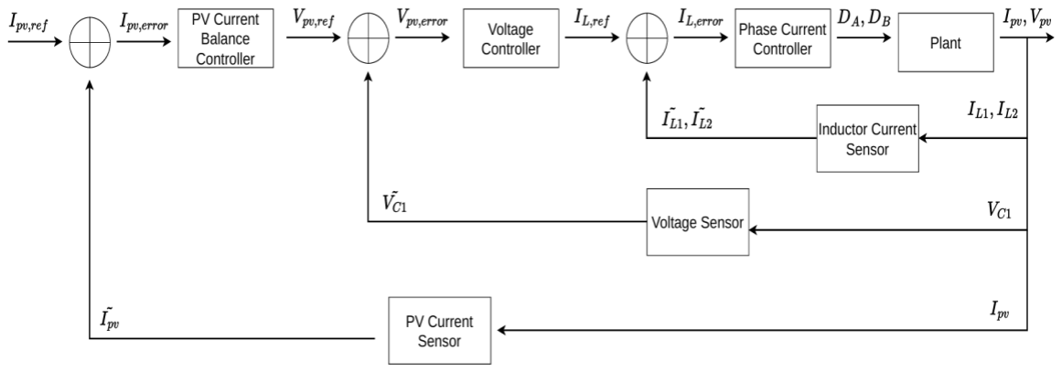
[picture p109: figure]

Figure 3. Cascaded three-loop PI architecture. Inner loop (phase current): tracks I_L1 and I_L2 to their references. Middle loop (PV voltage): regulates V_C1 by commanding the inner current reference. Outer loop (PV-current balance): aligns the phase currents on the PV side. An MPPT outer-outer loop will set the V_C1 reference in Semester 2.

Loop | Quantity controlled | Target bandwidth
Inner (per phase) | I_L1, I_L2 (phase currents) | 10 kHz
Middle | V_C1 (PV substring voltage) | 1 kHz
Outer (balance) | I_pv1 − I_pv2 (PV current differential) | ≈ 5 kHz
MPPT (Sem 2) | V_C1 reference setpoint | ≈ 10 Hz

Table 4. Cascaded control loop hierarchy with target crossover frequencies.

PI gains for each loop were derived analytically (Appendix B B.11). For the inner current loop the plant is a pure integrator with gain V_Σ / L, giving:

K_p,i = ω_ci · L/V_Σ, τᵢ = 10/ω_ci

The same procedure applied to the voltage loop, treating the closed inner loop as ideal, gives K_p,v = ω_cv · C₁ / (2D). All three loops achieve a designed phase margin of approximately 84° from the placement of the PI zero one decade below crossover.

### 2.10 Simulink Implementation and Validation

### 2.10.1 PV module representation

Before any string-level work could begin, a suitable representation of an individual PV module was required. The single-diode equivalent model was implemented in Simulink with parameters drawn from the AIKO Neostar 3P60 (P/N: AIKO-A555-MCE60Mw) datasheet, providing a representative module without committing the analytical work to a specific manufacturer. The model was sanity-checked against the MATLAB Solar Cell Power Curve reference example. Figure 4 shows the irradiance-dependent I-V and P-V curves at 25 °C; the open-circuit voltage, short-circuit current, and maximum power point reproduce the datasheet values to within the precision needed for control-design purposes.

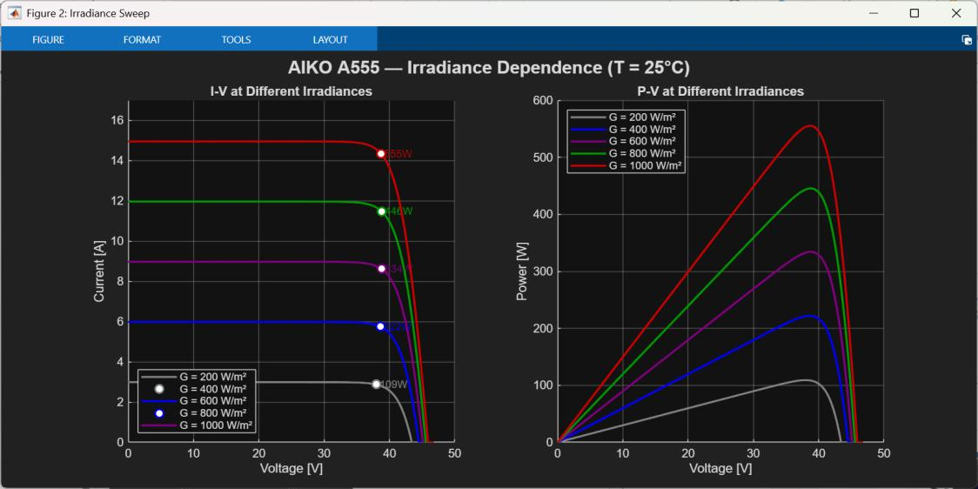
[picture p110: figure]

Figure 4. AIKO Neostar 3P60 PV module I-V and P-V curves at five irradiance levels (T = 25 °C). The marker on each I-V curve denotes the maximum power point at that irradiance. This is the per-module representation used for all subsequent string-level work.

The module representation is sufficient for the control-design objective of this semester. The representation does not capture every second-order effect of a real module (notably the temperature dependence of the diode saturation current and the series-resistance variation with irradiance), but the deviations are small relative to the modelling abstractions already accepted in the averaged shuffler model. A more rigorous characterisation against measured cells would be appropriate before the hardware prototype campaign in Semester 2.

### 2.10.2 PV string model

The PV string was built up incrementally, beginning with a two-module string driven by a ramped controlled-voltage source for I-V curve sweeping. The model was then extended to the full four-module string used for partial shading validation. Figure 5 shows the assembled Simulink model: the four-module string (left), the per-module solar-cell subsystem (centre), and the I-V sweep load used to trace the steady-state P-V curve (right).

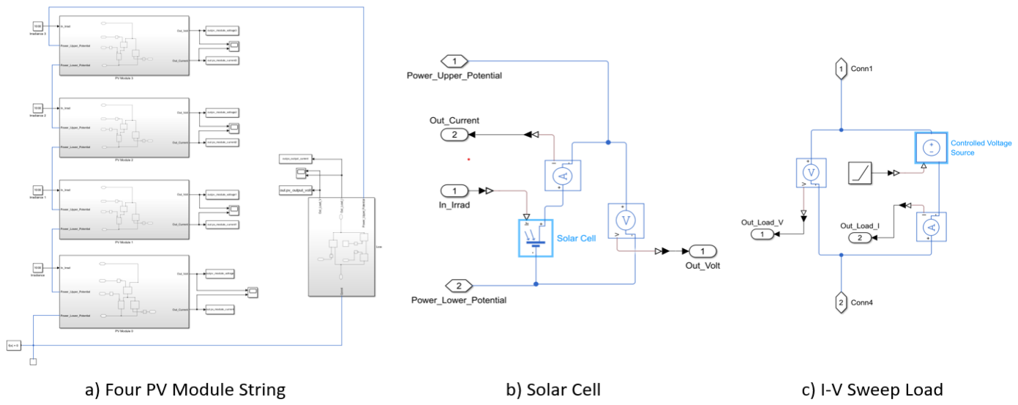
[picture p111: figure]

Figure 5. Simulink PV string model. (a) Four-module series-stacked PV string with per-module irradiance and temperature inputs. (b) Internal structure of the per-module solar-cell subsystem (single-diode equivalent). (c) Controlled-voltage-source load used to perform the I-V sweeps that produce the P-V curves in Figure 6.

### 2.10.3 Partial shading validation

Three partial shading scenarios were used to validate the assembled string model against analytical predictions of the global maximum power point. The irradiance distributions cover the canonical test cases of uniform mismatch, graduated shading, and asymmetric single-module shading. Figure 6 shows the resulting P-V curves; the maximum power point identified by the Simulink sweep agrees with the analytical P_MPP value in all three scenarios (Table 5). Multiple local maxima are visible in the graduated and single-shaded cases this is the local-maximum trapping problem that will motivate the global MPPT design in Semester 2.

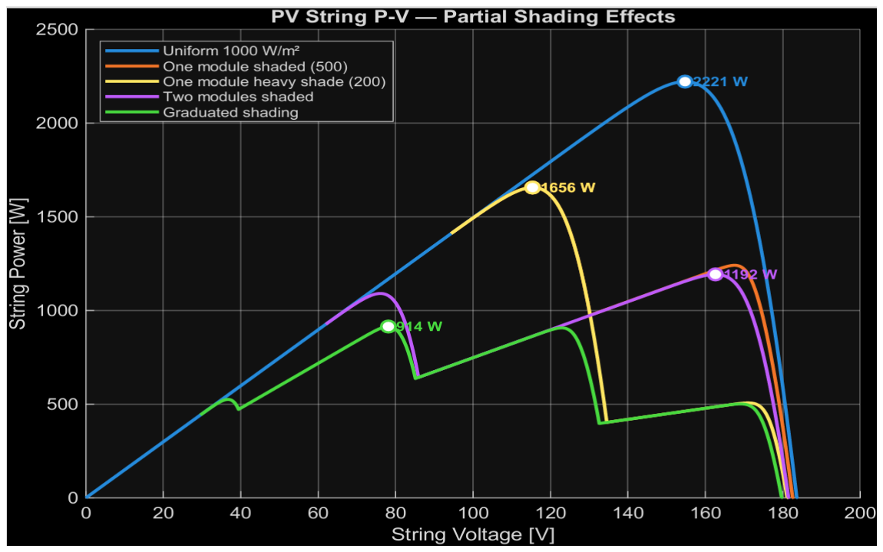
[picture p112: figure]

Figure 6. Simulink-swept P-V curves for the partial-shading validation scenarios. Markers indicate the global maximum power point identified for each scenario; for the graduated and single-shaded cases (yellow and green) local maxima are clearly visible at lower string voltages.

Scenario | Irradiance distribution (W/m²) | Analytical P_MPP
Two modules shaded | 1000, 1000, 500, 500 | 1192.5 W
Graduated shading | 1000, 800, 500, 200 | 914.3 W
Single module shaded | 1000, 1000, 1000, 500 | 1655.9 W

Table 5. Partial shading validation scenarios and analytical P_MPP predictions.

### 2.10.4 Shuffler integration and inner-loop attempt

The interleaved half-bridge shuffler was integrated into the four-module PV string and operated at a fixed 50% duty to verify switching behaviour and the topological assumptions underpinning the averaged model. Three implementation issues required attention: the gating logic for complementary high-side / low-side operation with dead time, the PV module bypass diodes (which interact with the shuffler current path during heavy shading), and the coupled-inductor model (initially approximated by two independent inductors). Figure 7 shows the resulting Simulink shuffler model with the inner phase-current PI loops in place; each phase has its own current sensor, a fixed 3 A reference (the static test value), a PI controller (PID block), and a gate-driver subsystem.

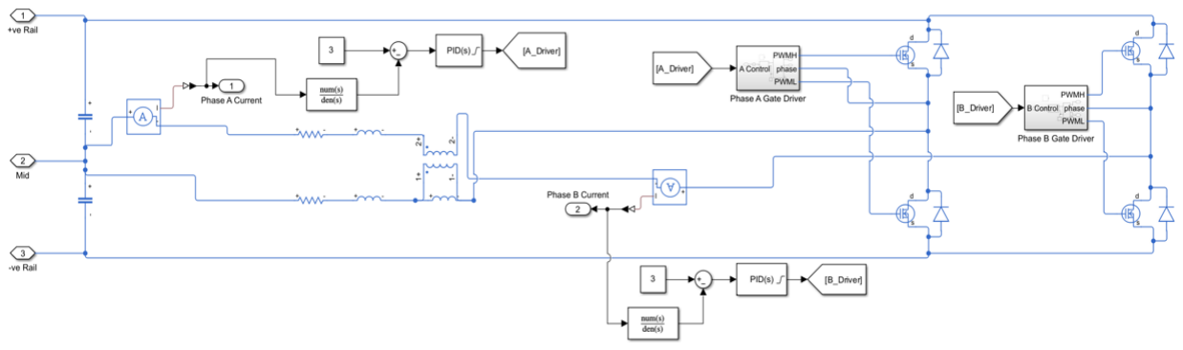
[picture p113: figure]

Figure 7. Simulink shuffler model with the inner phase-current PI loops in place. Each phase A and B has an independent PI controller driven by a fixed 3 A reference. The PWM signals are produced by per-phase gate-driver subsystems ("Phase A Gate Driver", "Phase B Gate Driver"). The coupled inductor is shown in the centre with the two phase-current sensors on its winding terminals.

### 2.10.5 Present Challenges and Future Work

The semester closes with one major technical blocker and two related items of unfinished design work. All three are concentrated in the three-loop cascaded architecture of 2.9: the inner loop is the active blocker, and the middle and outer loops have not yet been attempted in simulation.

Present challenge inner phase current loop. Closure of the inner phase current loop with a fixed reference, although qualitatively functional under uniform irradiance, becomes unstable under realistic partial shading. Figure 8 shows the symptom: a two-module test (500 W/m² on the top PV, 1000 W/m² on the bottom) with a fixed 3 A current reference. The bottom (illuminated) module settles cleanly to a steady V_pv ≈ 12 V and I_pv ≈ 2 A. The top (shaded) module, however, is driven by the controller to the open-circuit region its voltage saturates at approximately V_oc ≈ 42 V while its current collapses. Once the top module reaches open circuit it can no longer supply the 3 A demanded by the inner loop, and the controller cannot recover without an outer loop providing an operating-point-aware reference. The root cause is structural rather than tuning: a static current reference is not a meaningful target under mismatched irradiance because the controllable operating range of one module is a strong function of the other module's irradiance. The fix is the outer voltage loop, but the failure mode itself needs to be characterised and bounded before that work proceeds.

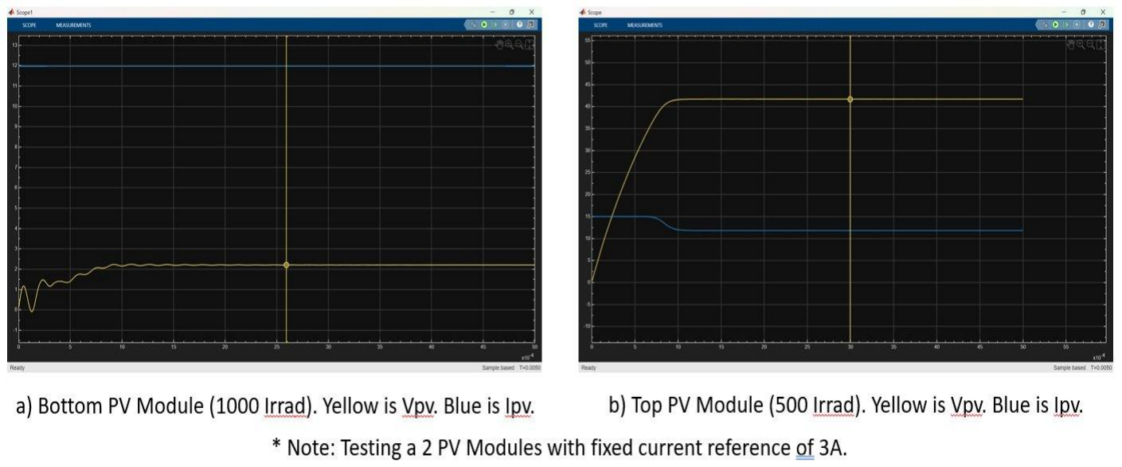
[picture p114: figure]

Figure 8. Inner phase current loop with fixed 3 A reference, two-module test, irradiances 1000 W/m² (bottom) and 500 W/m² (top). (a) Bottom module: V_pv (yellow) settles to ≈ 12 V, I_pv (blue) to ≈ 2 A stable. (b) Top module: V_pv (yellow) climbs into open-circuit saturation at ≈ 42 V while I_pv (blue) drops, demonstrating that a fixed current reference is not a valid operating target under partial shading.

Future work Loop 2 (voltage). The voltage loop has not yet been implemented. Its role is to command the inner-loop current reference dynamically so the per-module operating point tracks a desired V_C1 setpoint regardless of irradiance. With the voltage loop closed, the static-reference failure mode of Figure 8 should disappear by construction. The analytical gain prescription K_p,v = ω_cv · C₁ / (2D) from 2.9 provides the seed values; tuning against the Simulink switching model is expected to refine them by typically 30–50%.

Future work Loop 3 (balance) and the missing application context. The balance loop has likewise not been implemented; it operates on the differential phase current and is structurally the simplest of the three. More important than either loop in isolation, the present model does not yet include the two elements that define the target use case: the MPPT outer loop (which sets V_C1 dynamically based on the partial-shading P-V landscape) and the battery load (which gives the string a well-defined I-V relationship rather than a stiff voltage-source approximation). Until these are added, the closed-loop behaviour observed in simulation is informative about the converter dynamics but is not yet reflective of the intended application. Both items are scheduled in the revised Semester 2 plan (Appendix A).

## 3. Risk Management

Risks have been actively monitored throughout the semester. The risk register is now dominated by a single high-impact item the project timeline with two related technical risks (electrical hazard, control– hardware integration) at lower current exposure. The proposal-era risk register remains the baseline; the discussion below identifies what has materialised, what has been mitigated, and what is now most likely to bite.

### 3.1 Critical Risk Project Timeline and PCB Order Delays

The most significant project change this semester is the postponement of the first PCB iteration (Shuffler V1 hardware) from Semester 1 into early Semester 2. The deferral consumed approximately three weeks of the one-month contingency buffer built into the original Gantt schedule. The remaining buffer is approximately one week small. Any further delay to the PCB order, component lead time, or first-fit on the hardware would exhaust the buffer and start displacing the late-semester milestones (M7 onwards), which were originally protected by the buffer. This is now the critical project risk and is being managed by tight weekly milestone review with the supervisor.

The decision to defer was made transparently and was the right call against the alternative committing to a hardware iteration with an incomplete control model would either have produced a non-functional first prototype or required a full redesign once the control work converged. But the cost of being right is that the schedule is no longer protected by buffer in the way it was at the start of the semester, and there is no second deferral available. Maintaining momentum on the Semester 2 deliverables (loops 2 and 3, QSPICE PI, MPPT integration, battery-load model) is now the dominant scheduling pressure.

### 3.2 Application-Realism Risk Model does not yet match target use case

The present Simulink model represents the shuffler operating into a controlled voltage / current-sweep load. The target end-use is a residential PV-battery system, in which the load is the battery's I-V characteristic (or, more precisely, the input of a battery-side DC-DC converter) and the operating point is set by an MPPT outer loop. Neither the battery load nor the MPPT loop is yet in the model. The closed-loop behaviour observed in 2.10 is therefore informative about the converter dynamics but is not yet reflective of the intended application. This is a meaningful risk to flag now: control design choices that look correct against a stiff-source load may behave differently against a battery, and an MPPT outer loop introduces its own slow dynamics that can interact with the voltage loop. Adding both is on the Semester 2 critical path.

### 3.3 Other Risks

Electrical hazard (Risk #8, Critical)
All Semester 1 work has been performed in simulation. The QUT HSE workspace induction will be completed and PPE confirmed before the first hardware bench test. The PCB deferral has the side effect of giving additional time to prepare a formal hardware risk assessment before any live test.

Firmware failure (Risk #4, High)
Implementing the controller first in Simulink (where the plant model is fully observable and tunable) has surfaced several issues that would have been far harder to diagnose on hardware: dead-time interaction with body diodes, coupled-inductor model fidelity, and the inner-loop instability identified in 2.10.5. The simulation-first approach is working as designed and has been retained for Semester 2.

Control–hardware integration (Risk #13, High)
The QSPICE implementation of the PI controller has been started but is not yet operational. The current failure mode is a singular-matrix error during DC operating-point convergence. Resolving this before hardware deployment is the correct order of operations and is on the revised Semester 2 schedule.

Coupled inductor modelling fidelity
The current analysis treats the two inductors as independent (L₁ and L₂ separate). This is a defensible simplification for steady-state and average-current behaviour but understates the leakage-versusmagnetising-inductance dynamics of the real coupled inductor. The mitigation is to revisit the coupled-inductor model in MATLAB before the controller is transferred to QSPICE.

MPPT global tracking (Risk #14)
The partial-shading validation has confirmed the multiple-local-maxima problem visible in Figure 6: a naïve perturb-and-observe MPPT will trap at a local maximum under graduated shading. The MPPT design will need either a global search component or a topological argument that exploits the shuffler-equalised state. Carried forward into Semester 2.

## 4. Ethics

The project has been conducted in accordance with the Engineers Australia Code of Ethics and Guidelines on Professional Conduct. Four sections of the Code have been directly relevant to decision-making this semester. A fifth consideration the use of AI assistance in the analytical work is addressed in 4.5.

### 4.1 Demonstrate integrity Act on the basis of a well-informed conscience

The decision to postpone the PCB V1 order was taken under this principle. Producing hardware on the originally scheduled date with an incomplete control model would have created a high probability of producing a non-functional or unsafe prototype. The decision to defer was made transparently with the supervisor and the hardware teammate and prioritises engineering integrity over schedule adherence.
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
