saunders-jared-final/Boost-Brigade/Documentation/CapstoneProjectProposal.pdf

### QUEENSLAND UNIVERSITY OF TECHNOLOGY

EGH490‐1 ∙ Research Project 1

### PROJECT PROPOSAL

# Adaptive Control of Solar Power Shufflers for Maximum Power Point Tracking Under Partial Shading

## APPLICATION OF MODERN STATE‐SPACE METHODS TO SERIAL PARTIAL POWER CONVERTERS

STUDENT ENGINEER

### Jared Saunders

n11034459

SUPERVISOR

### Assoc Prof Geoff Walker

School of Electrical Engineering & Robotics

Version | Date | Author | Changes / Comments
1.0 | 17/04/26 | Jared Saunders | Initial Proposal

April 17, 2026

Adaptive Control of Solar Power Shufflers for Maximum Power Point Tracking
Under Partial Shading | Project Proposal
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
