saunders-jared-final/Boost-Brigade/0_Documentation/jared-assessment/CapstoneDelivery_latex/figures/slides/img-005-008.png

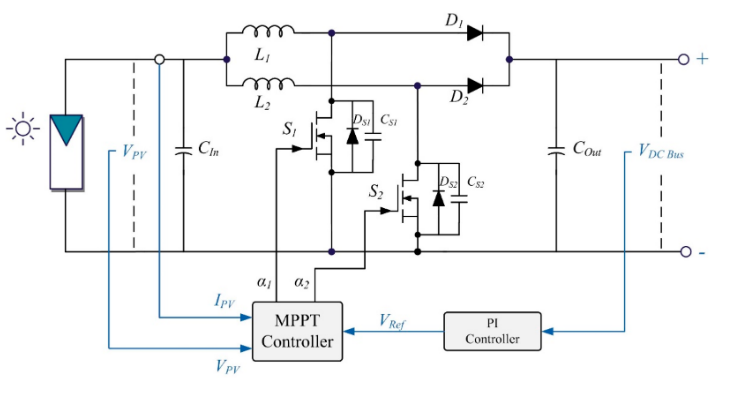
0_Documentation/jared-assessment/CapstoneDelivery_latex/figures/slides/img-005-008.png
