saunders-jared-final/Boost-Brigade/0_Documentation/jared-assessment/CapstoneDelivery_latex/figures/slides/img-016-023.png

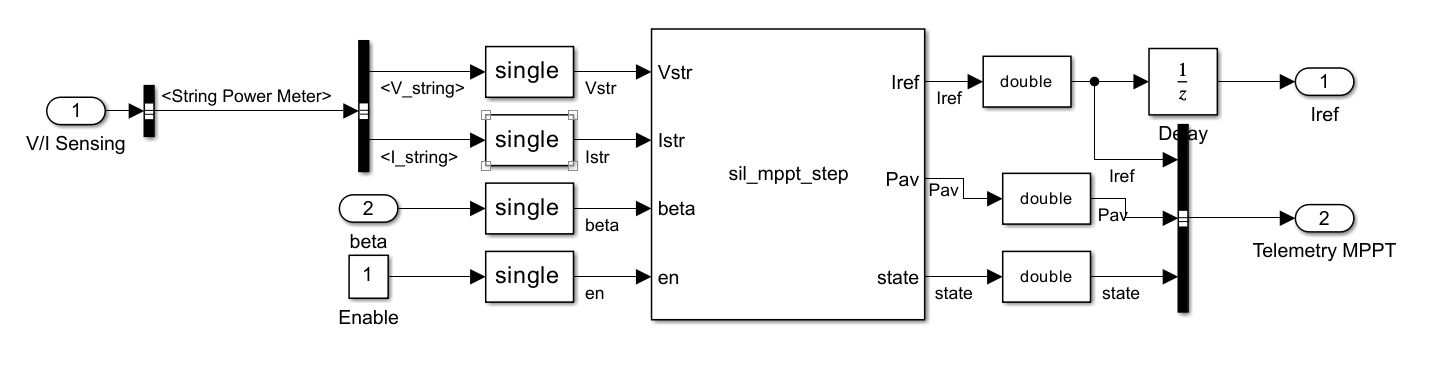
0_Documentation/jared-assessment/CapstoneDelivery_latex/figures/slides/img-016-023.png
