saunders-jared-final/Boost-Brigade/0_Documentation/jared-assessment/CapstoneDelivery_latex/figures/slides/img-020-037.png

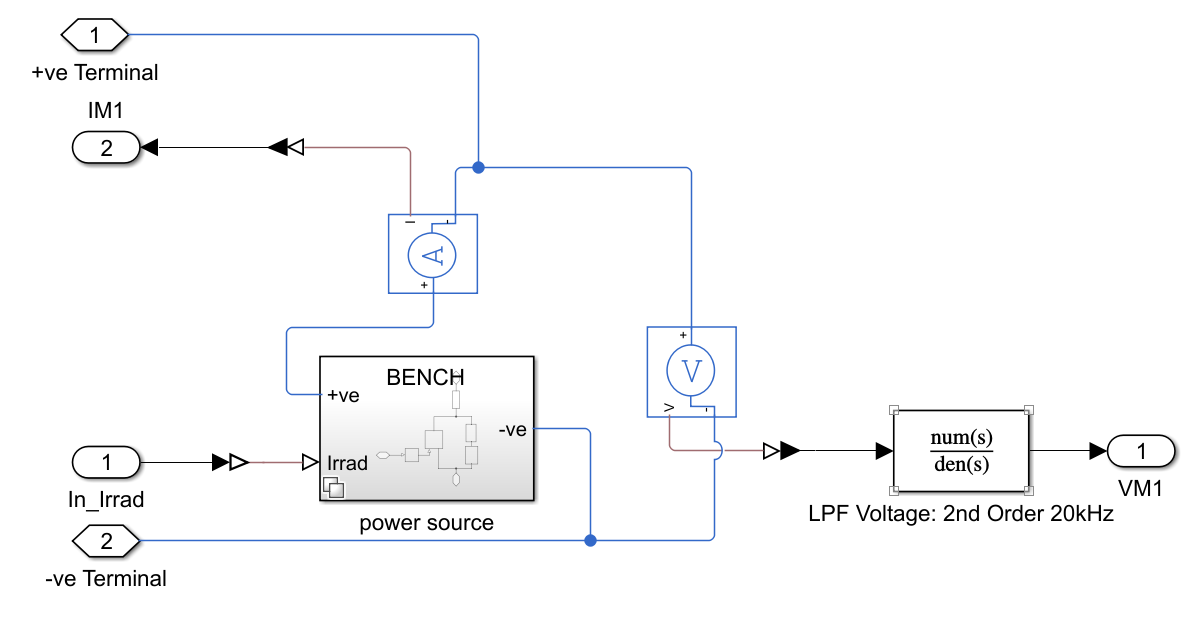
0_Documentation/jared-assessment/CapstoneDelivery_latex/figures/slides/img-020-037.png
