saunders-jared-final/Boost-Brigade/0_Documentation/Photos/20261014_103908.jpg

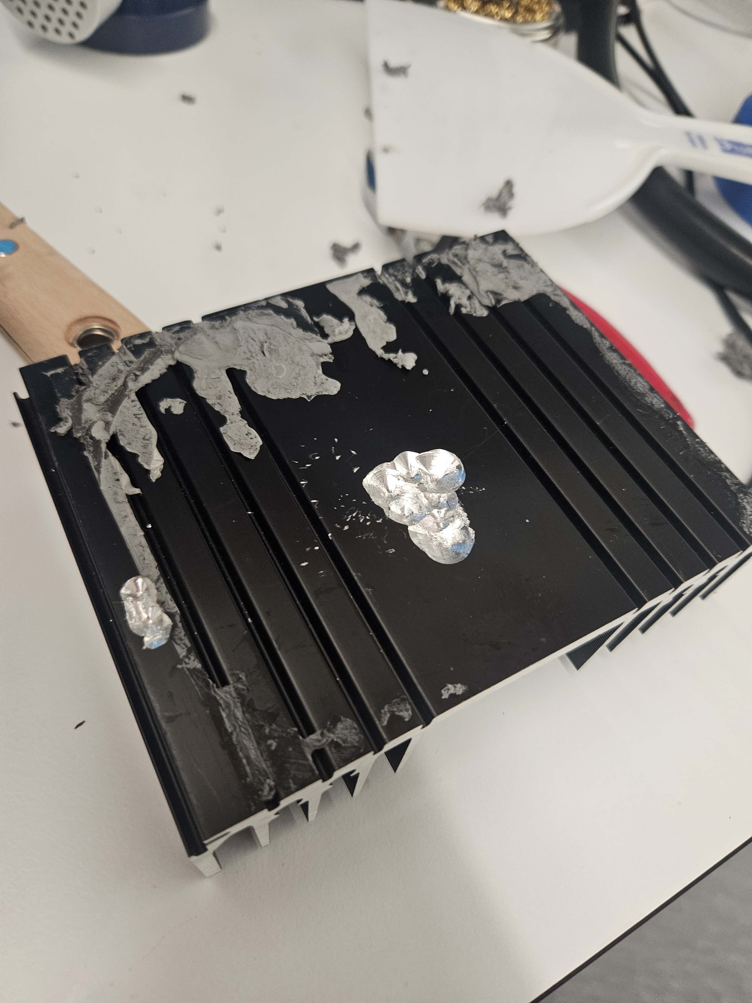
0_Documentation/Photos/20261014_103908.jpg
