saunders-jared-final/Boost-Brigade/0_Documentation/Photos/Messenger_creation_43CAB76C-569E-4C1A-B37C-5A0AD2B8B5C9.jpeg

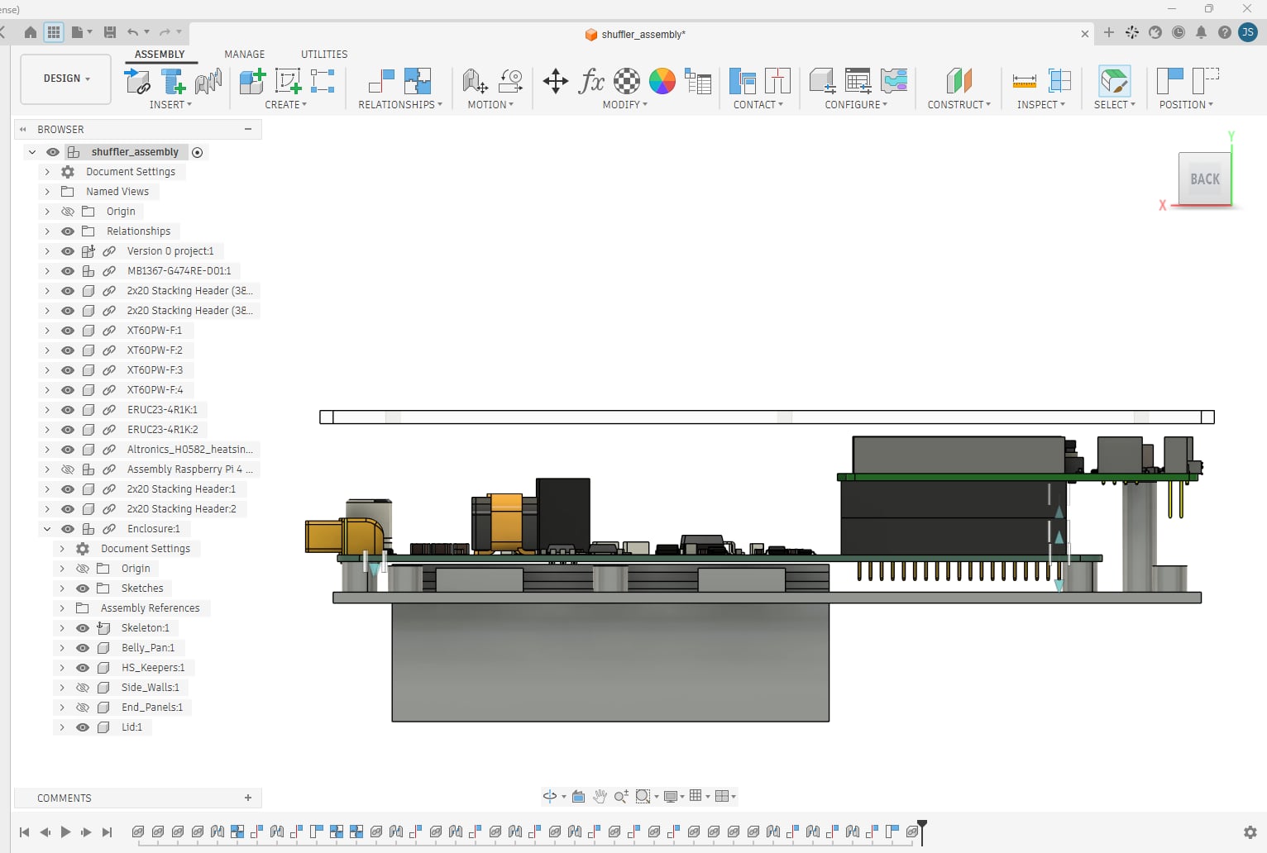
0_Documentation/Photos/Messenger_creation_43CAB76C-569E-4C1A-B37C-5A0AD2B8B5C9.jpeg
