saunders-jared-final/Boost-Brigade/0_Documentation/Photos/Messenger_creation_C4BE689F-46EE-448E-8FE8-E073A25E4E76.jpeg

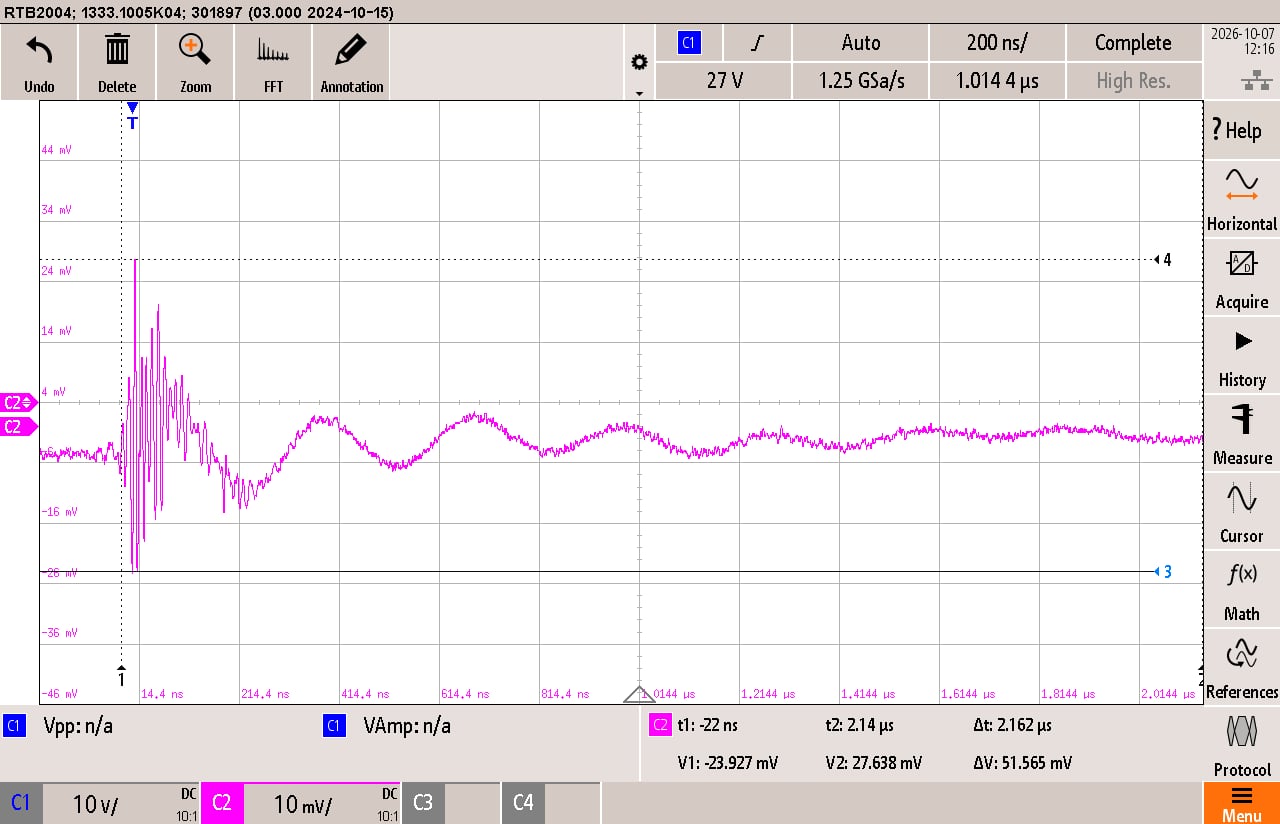
0_Documentation/Photos/Messenger_creation_C4BE689F-46EE-448E-8FE8-E073A25E4E76.jpeg
