saunders-jared-final/Boost-Brigade/0_Documentation/Photos/Screenshot_20261019_002247_Instagram.jpg

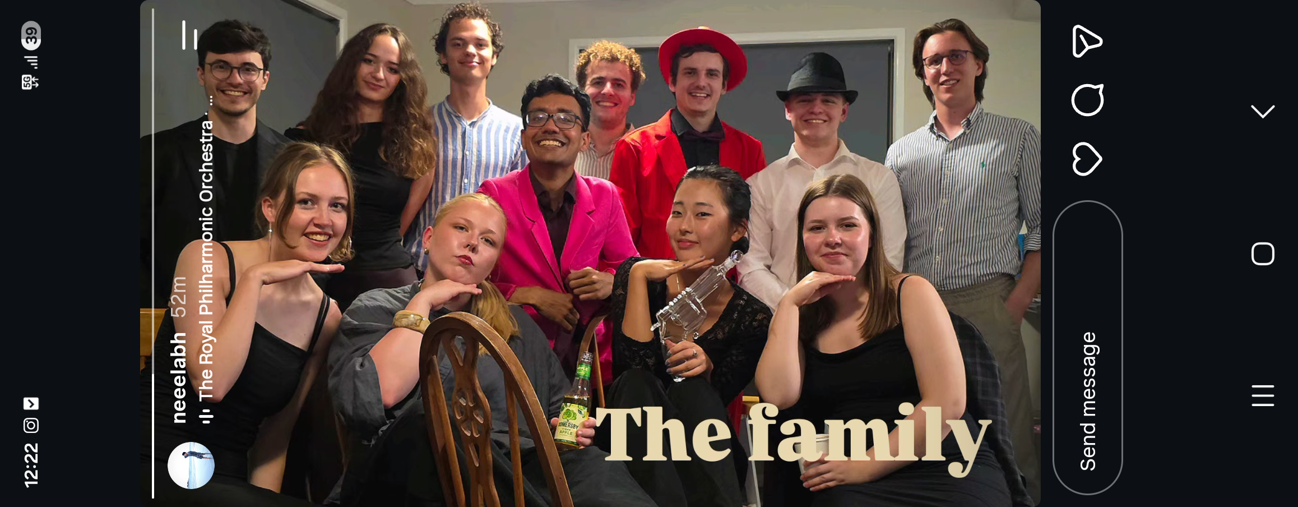
0_Documentation/Photos/Screenshot_20261019_002247_Instagram.jpg
