saunders-jared-final/Boost-Brigade/2_Qspice/Claude's outputs/figures/Shuffler_1.png

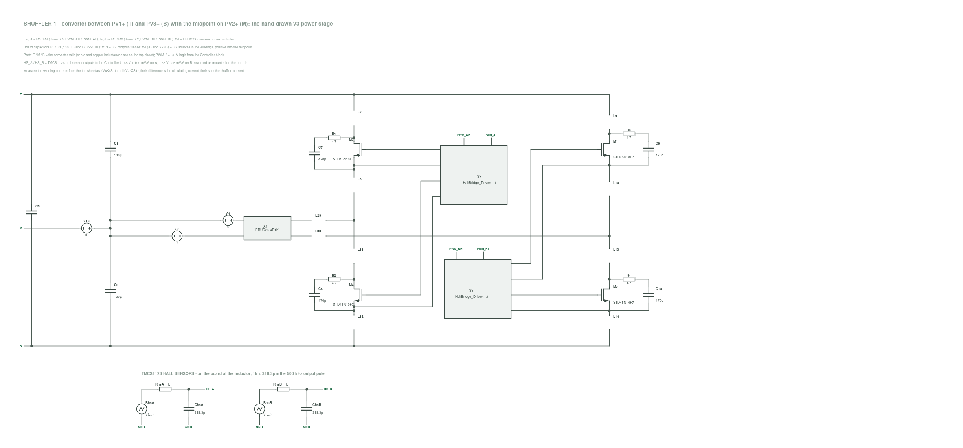
2_Qspice/Claude's outputs/figures/Shuffler_1.png
