saunders-jared-final/Boost-Brigade/site/src/assets/datasheets/ina239-q1.webp

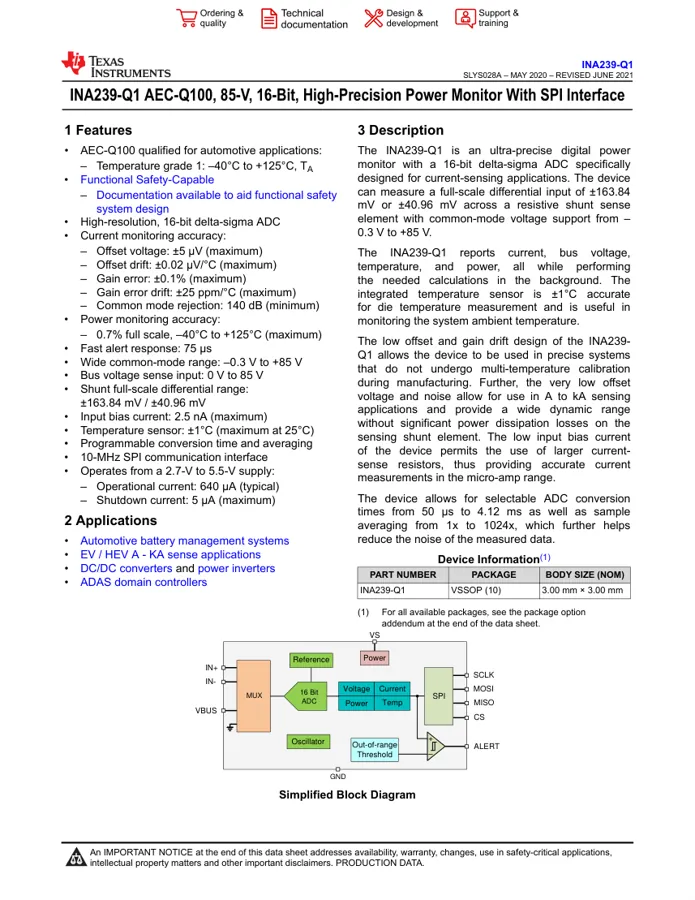
site/src/assets/datasheets/ina239-q1.webp
