saunders-jared-final/Boost-Brigade/site/src/assets/datasheets/mb1367-g474re-d01-schematic.webp

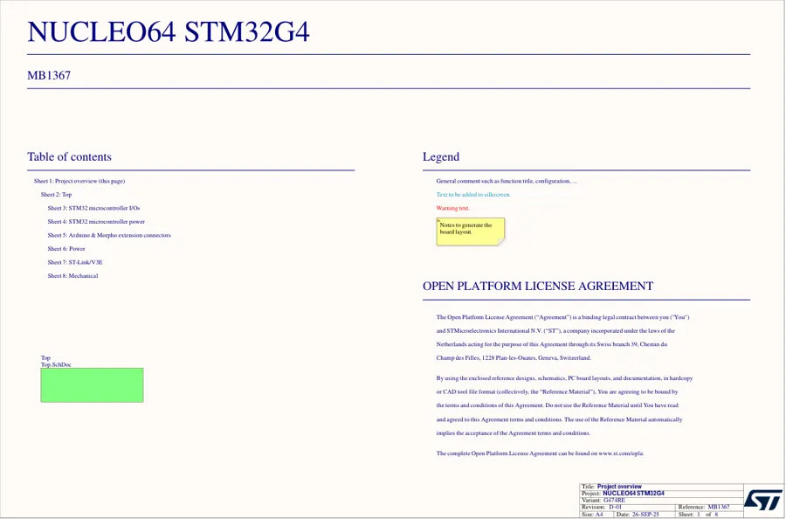
site/src/assets/datasheets/mb1367-g474re-d01-schematic.webp
