saunders-jared-final/Boost-Brigade/site/src/assets/datasheets/solar_panel_80.webp

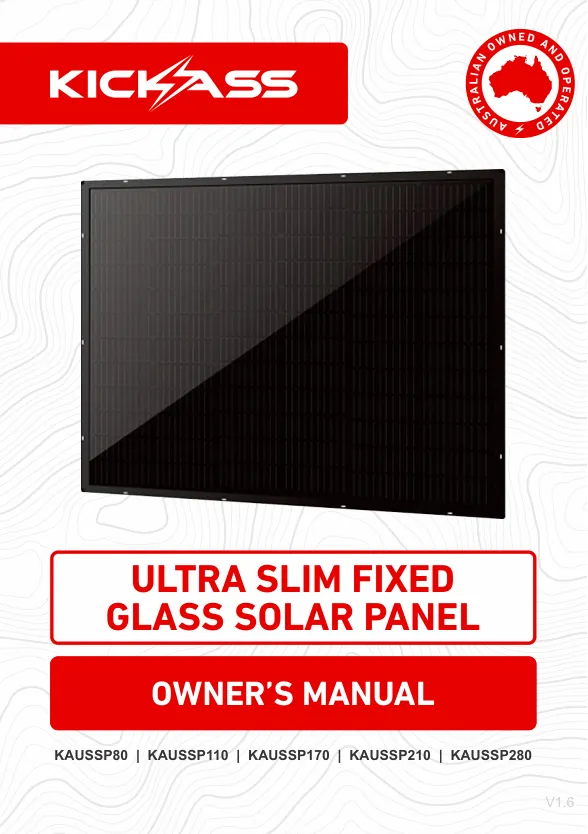
site/src/assets/datasheets/solar_panel_80.webp
