saunders-jared-final/Boost-Brigade/site/src/assets/figures/analysis/B01_bench_200k_OL_overview.webp

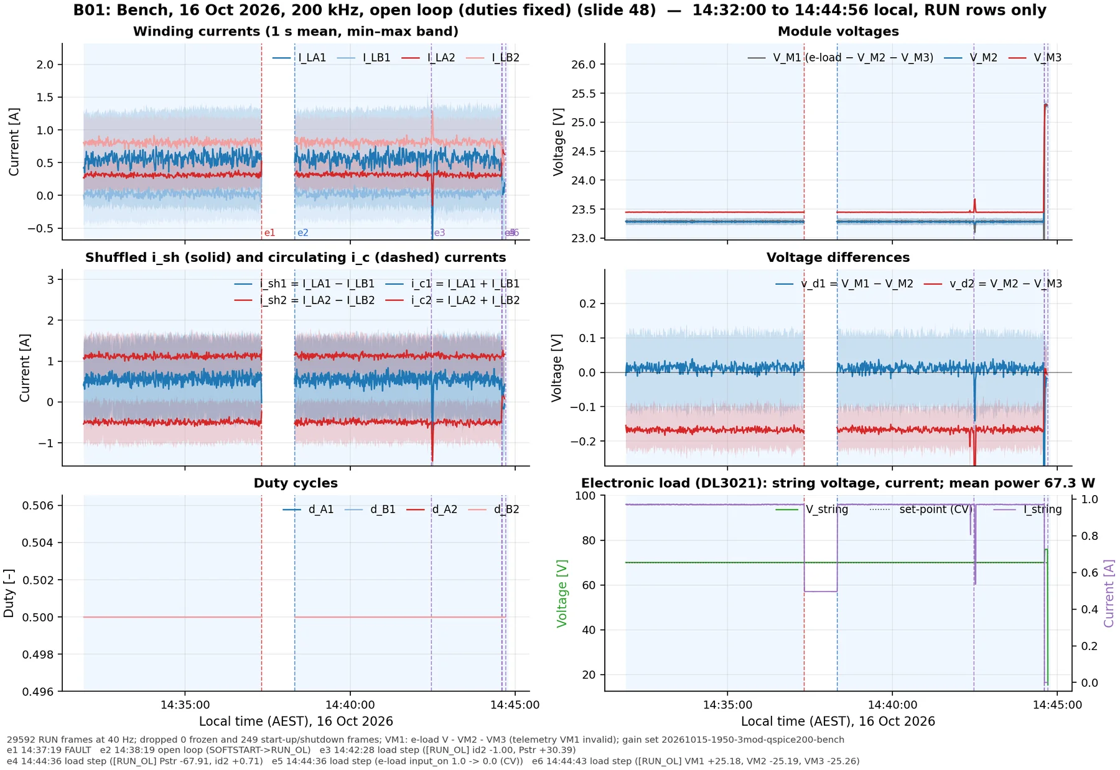
site/src/assets/figures/analysis/B01_bench_200k_OL_overview.webp
