saunders-jared-final/Boost-Brigade/site/src/assets/figures/analysis/B01s_bench_200k_OL_dutysteps_overview.webp

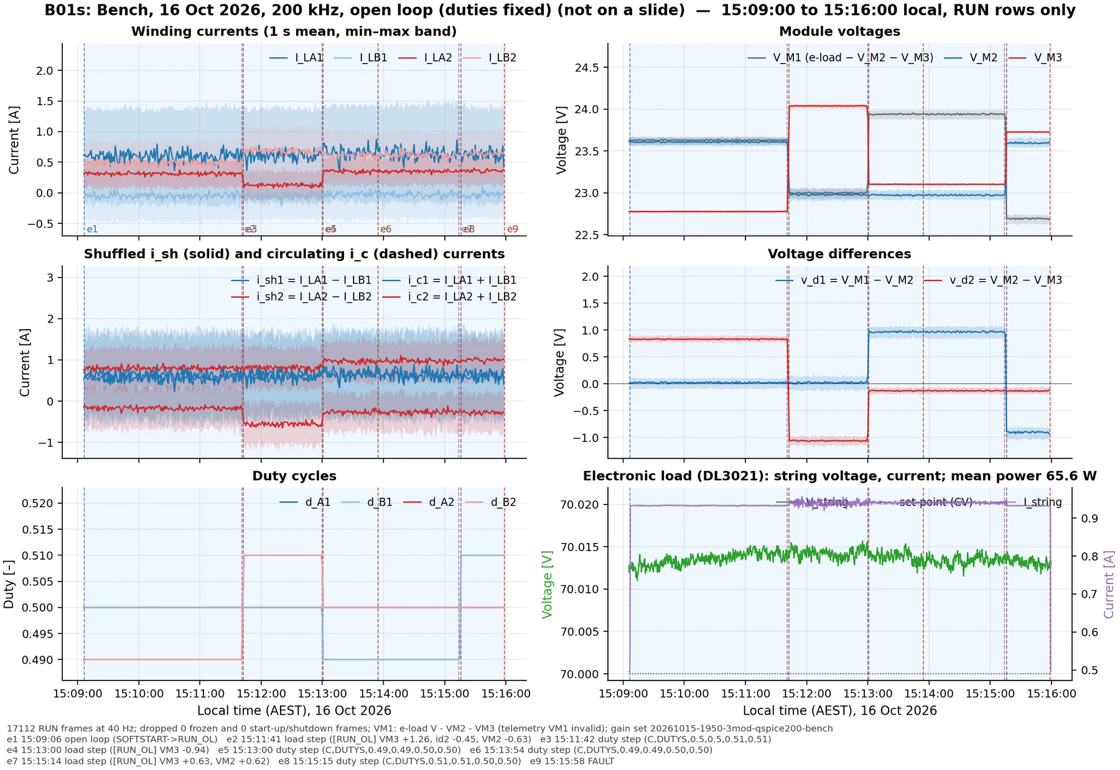
site/src/assets/figures/analysis/B01s_bench_200k_OL_dutysteps_overview.webp
