saunders-jared-final/Boost-Brigade/site/src/assets/figures/analysis/B02_bench_200k_CL_k0.1_overview.webp

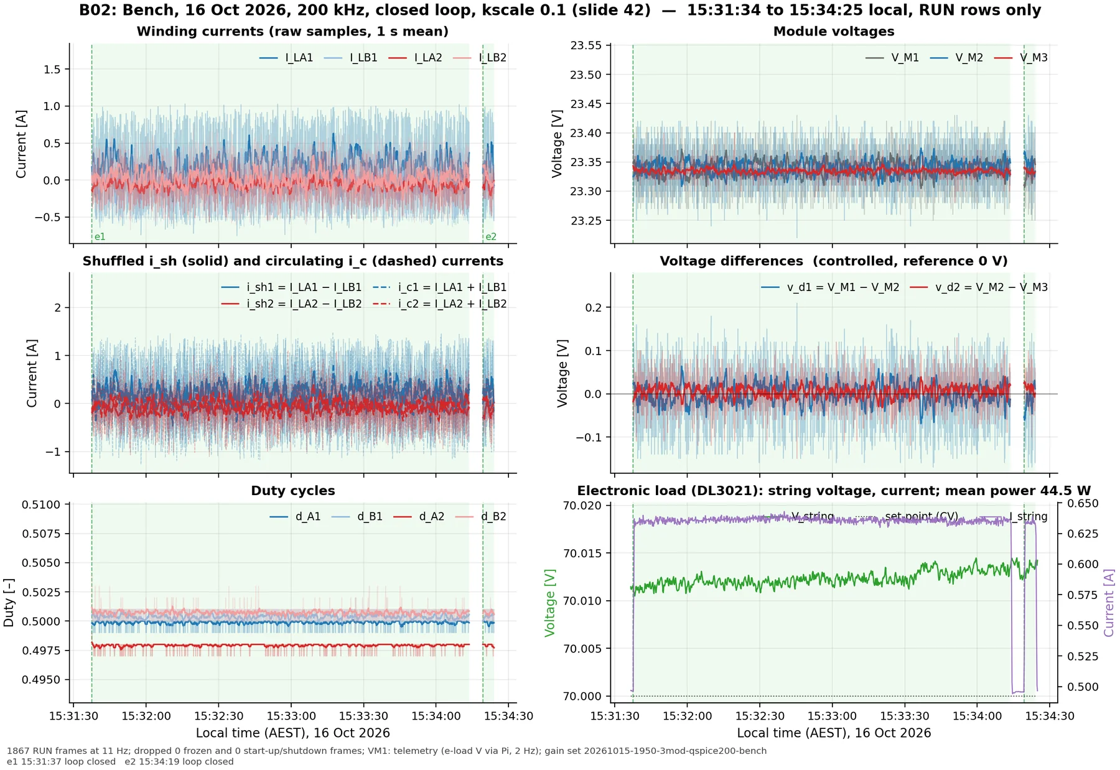
site/src/assets/figures/analysis/B02_bench_200k_CL_k0.1_overview.webp
