saunders-jared-final/Boost-Brigade/site/src/assets/figures/analysis/B03_bench_200k_CL_k0.3b_overview.webp

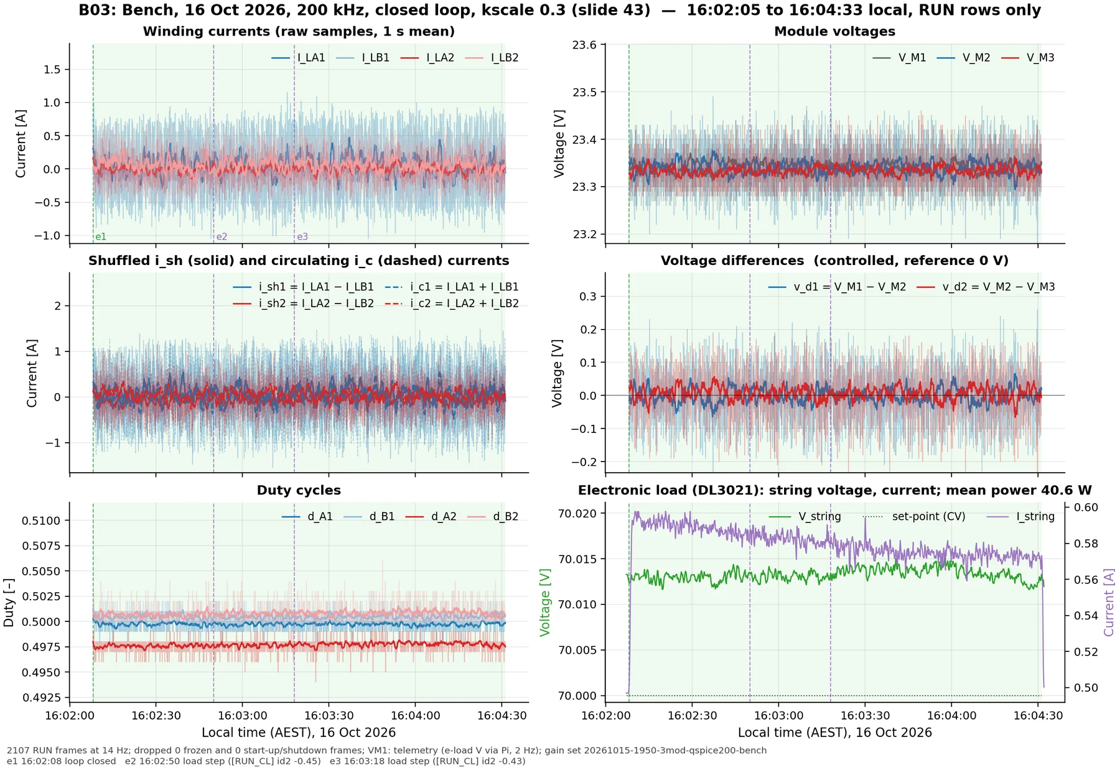
site/src/assets/figures/analysis/B03_bench_200k_CL_k0.3b_overview.webp
