saunders-jared-final/Boost-Brigade/site/src/assets/figures/analysis/B04_bench_200k_CL_k0.3_overview.webp

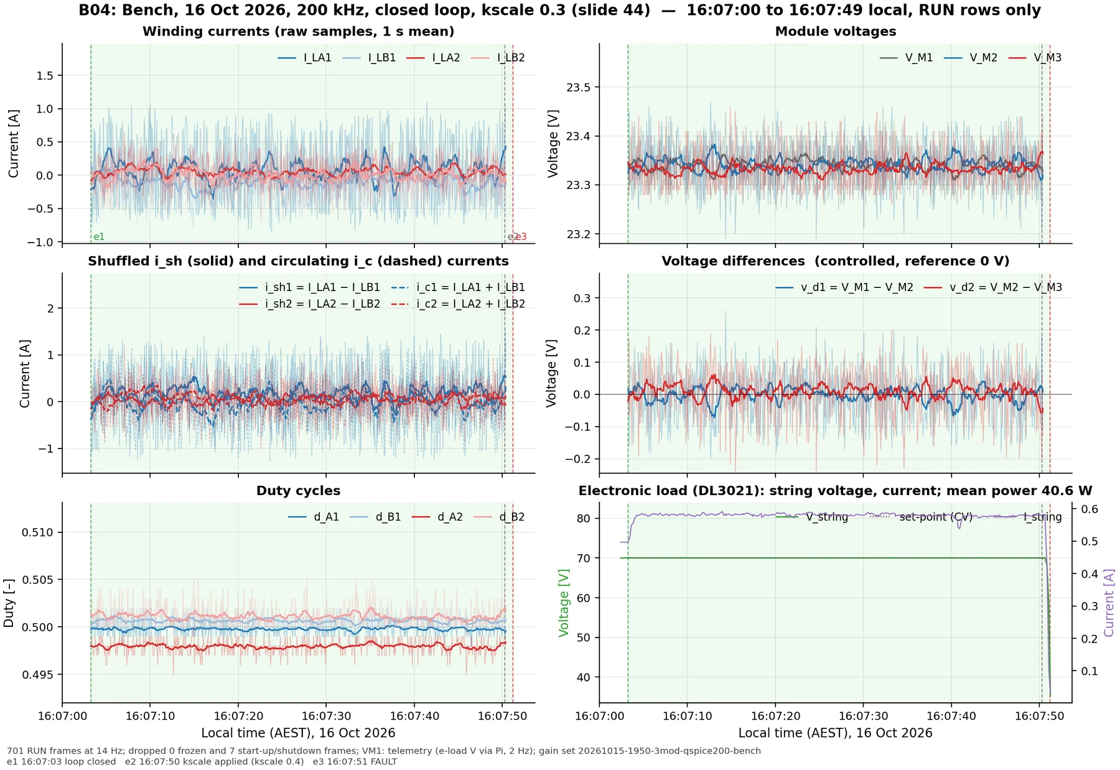
site/src/assets/figures/analysis/B04_bench_200k_CL_k0.3_overview.webp
