saunders-jared-final/Boost-Brigade/site/src/assets/figures/analysis/B05_bench_300k_OL_overview.webp

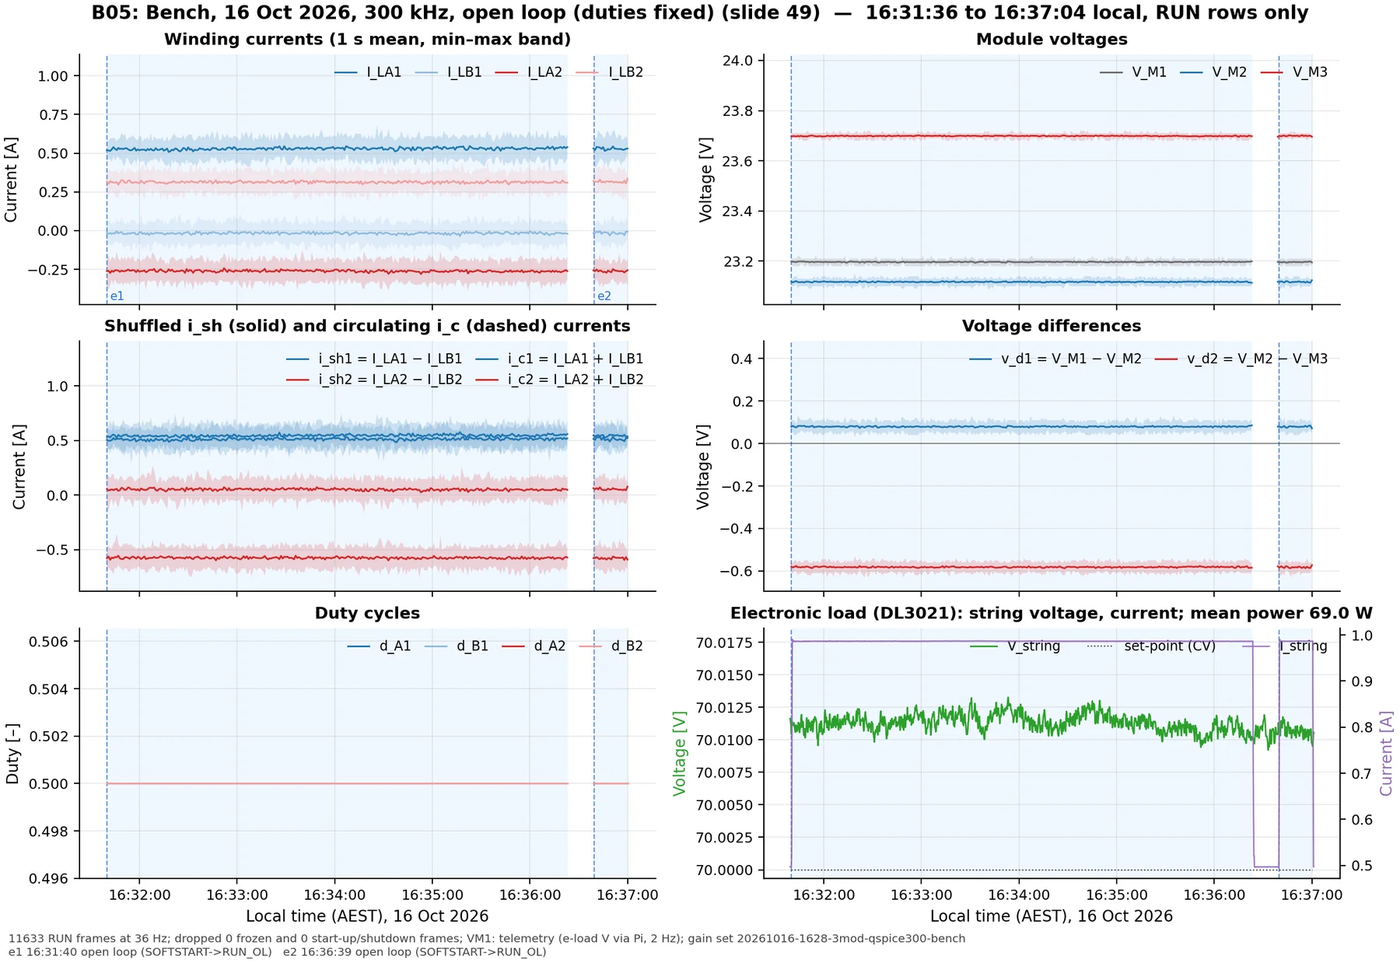
site/src/assets/figures/analysis/B05_bench_300k_OL_overview.webp
