saunders-jared-final/Boost-Brigade/site/src/assets/figures/analysis/B06_bench_300k_CL_k0.3_overview.webp

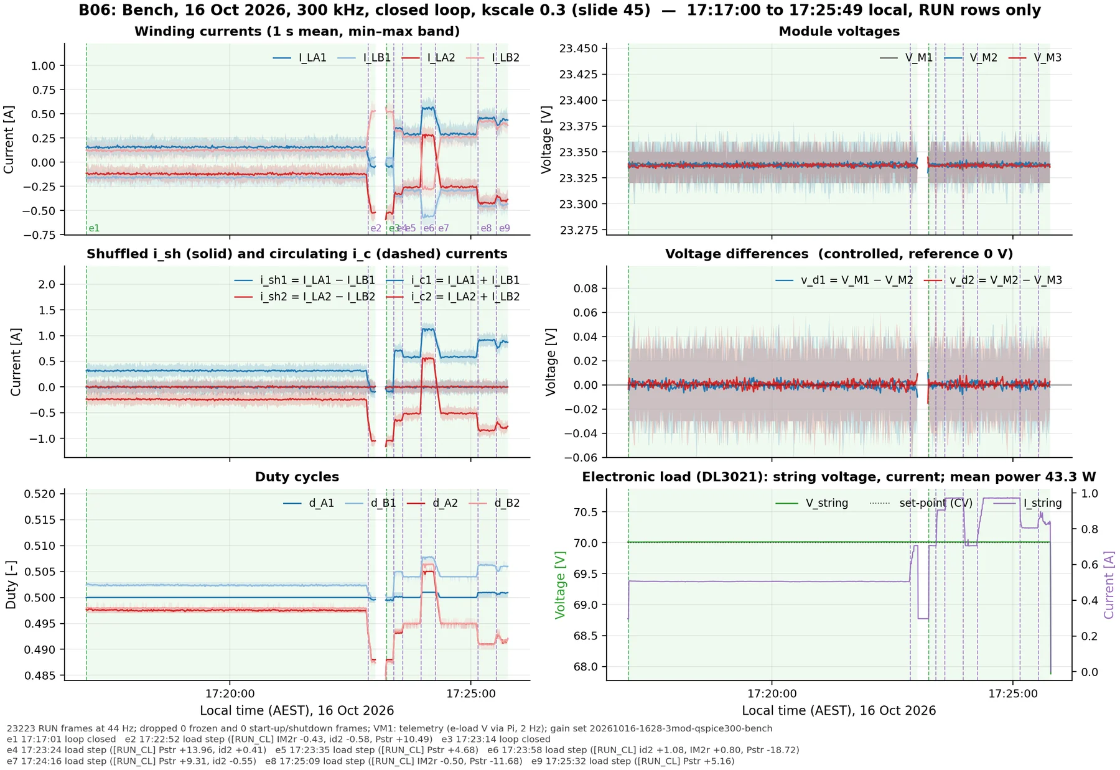
site/src/assets/figures/analysis/B06_bench_300k_CL_k0.3_overview.webp
