saunders-jared-final/Boost-Brigade/site/src/assets/figures/analysis/B06_e1_close.webp

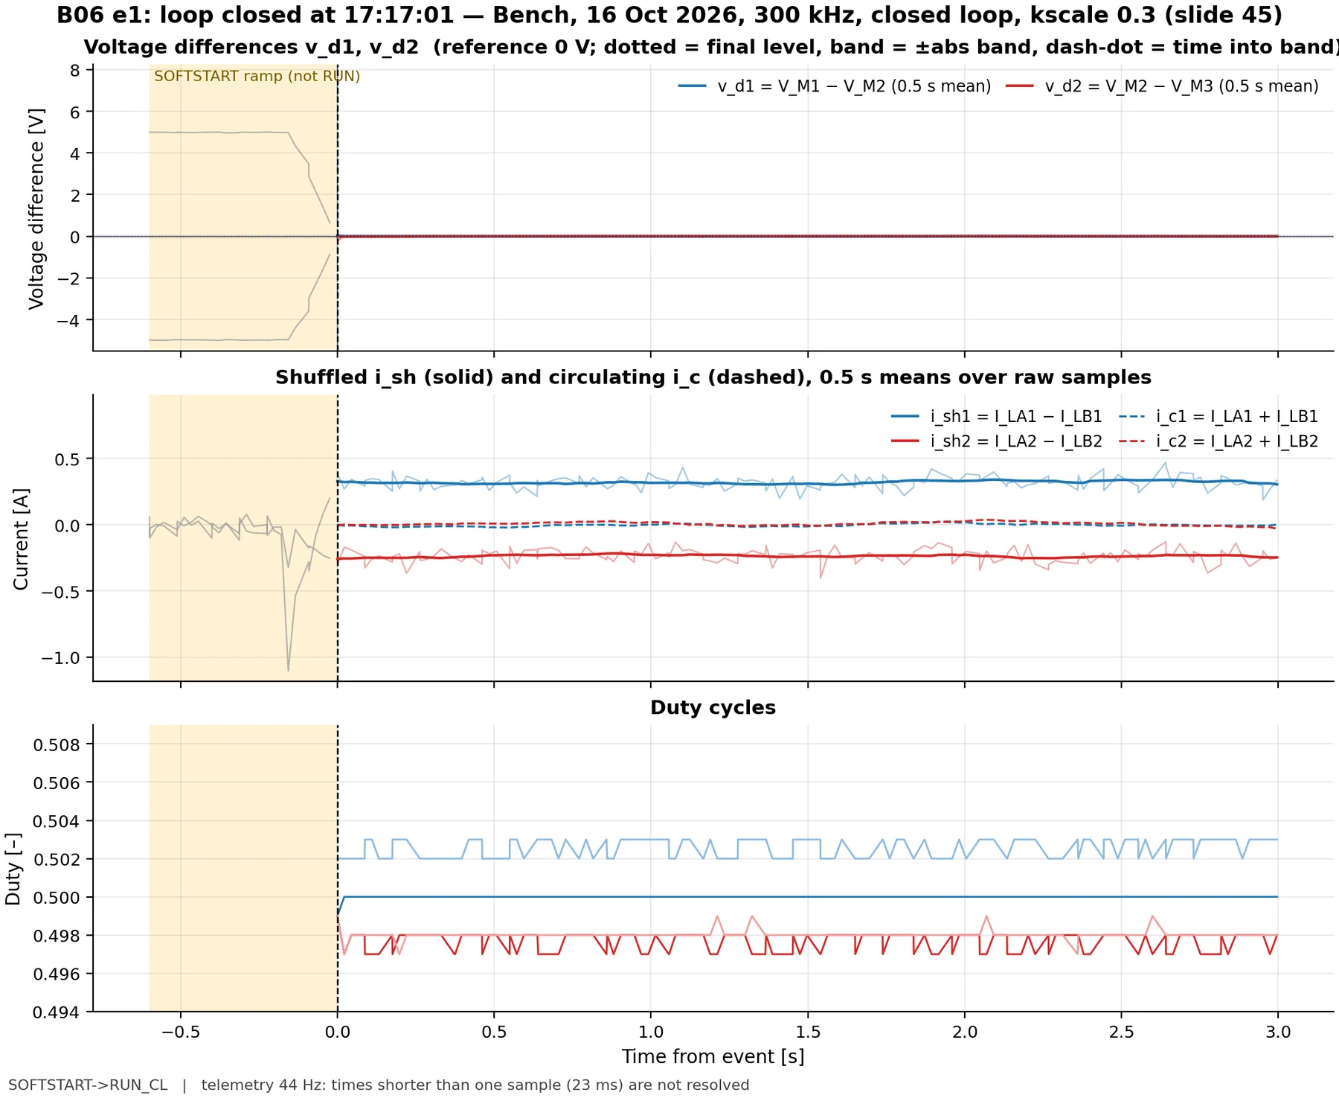
site/src/assets/figures/analysis/B06_e1_close.webp
