saunders-jared-final/Boost-Brigade/site/src/assets/figures/analysis/B06_e3_close.webp

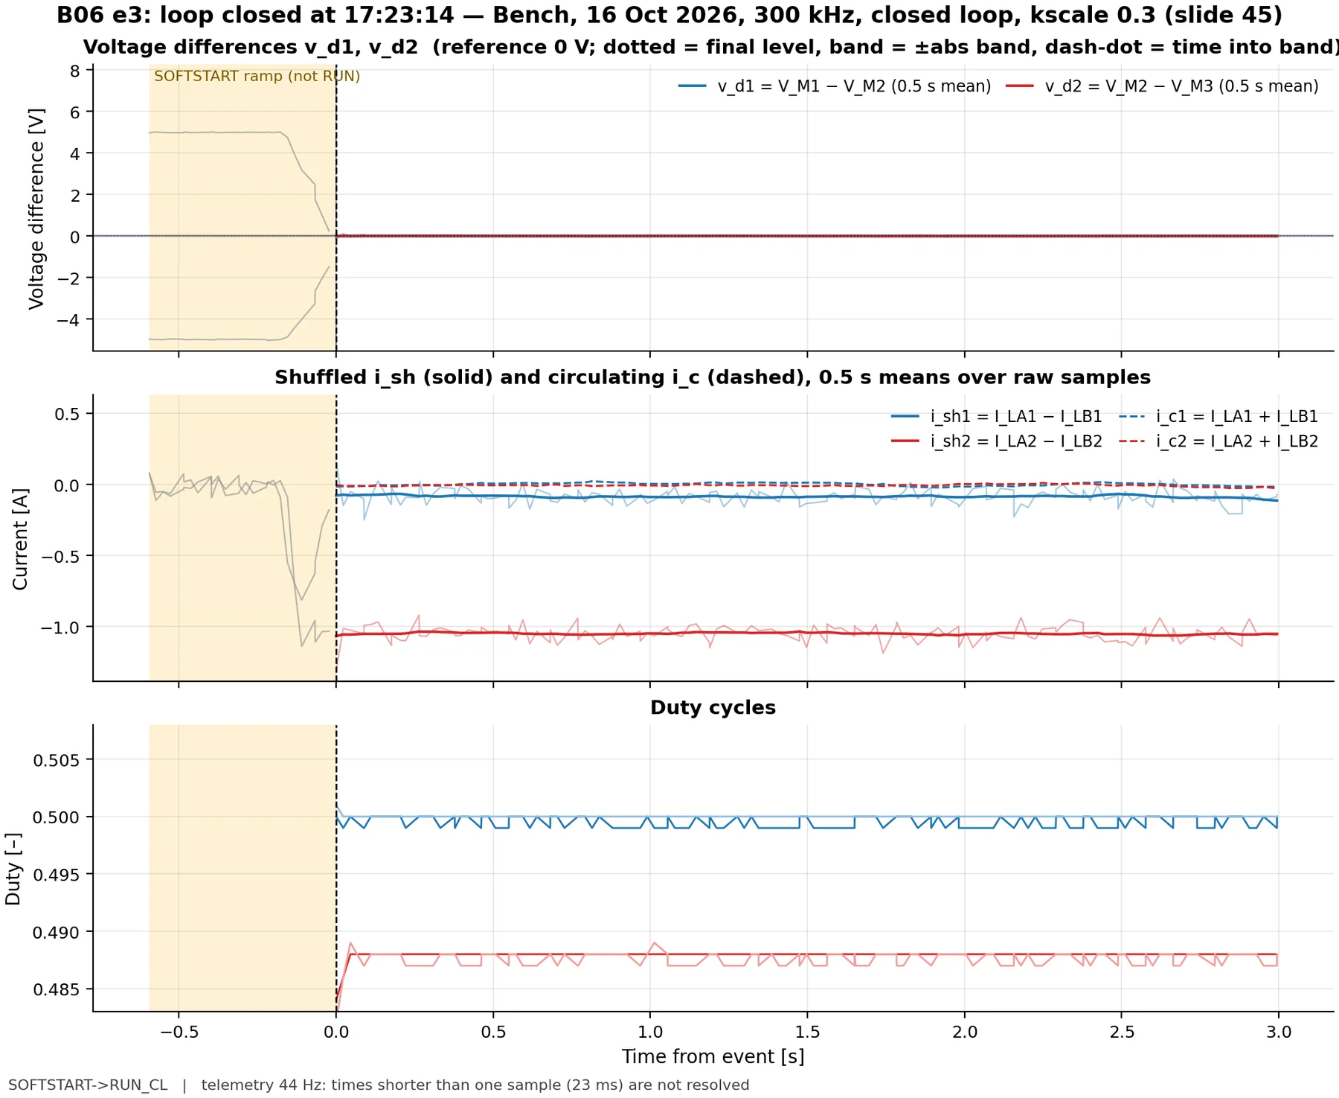
site/src/assets/figures/analysis/B06_e3_close.webp
