saunders-jared-final/Boost-Brigade/site/src/assets/figures/analysis/B07_bench_300k_CL_k0.5_overview.webp

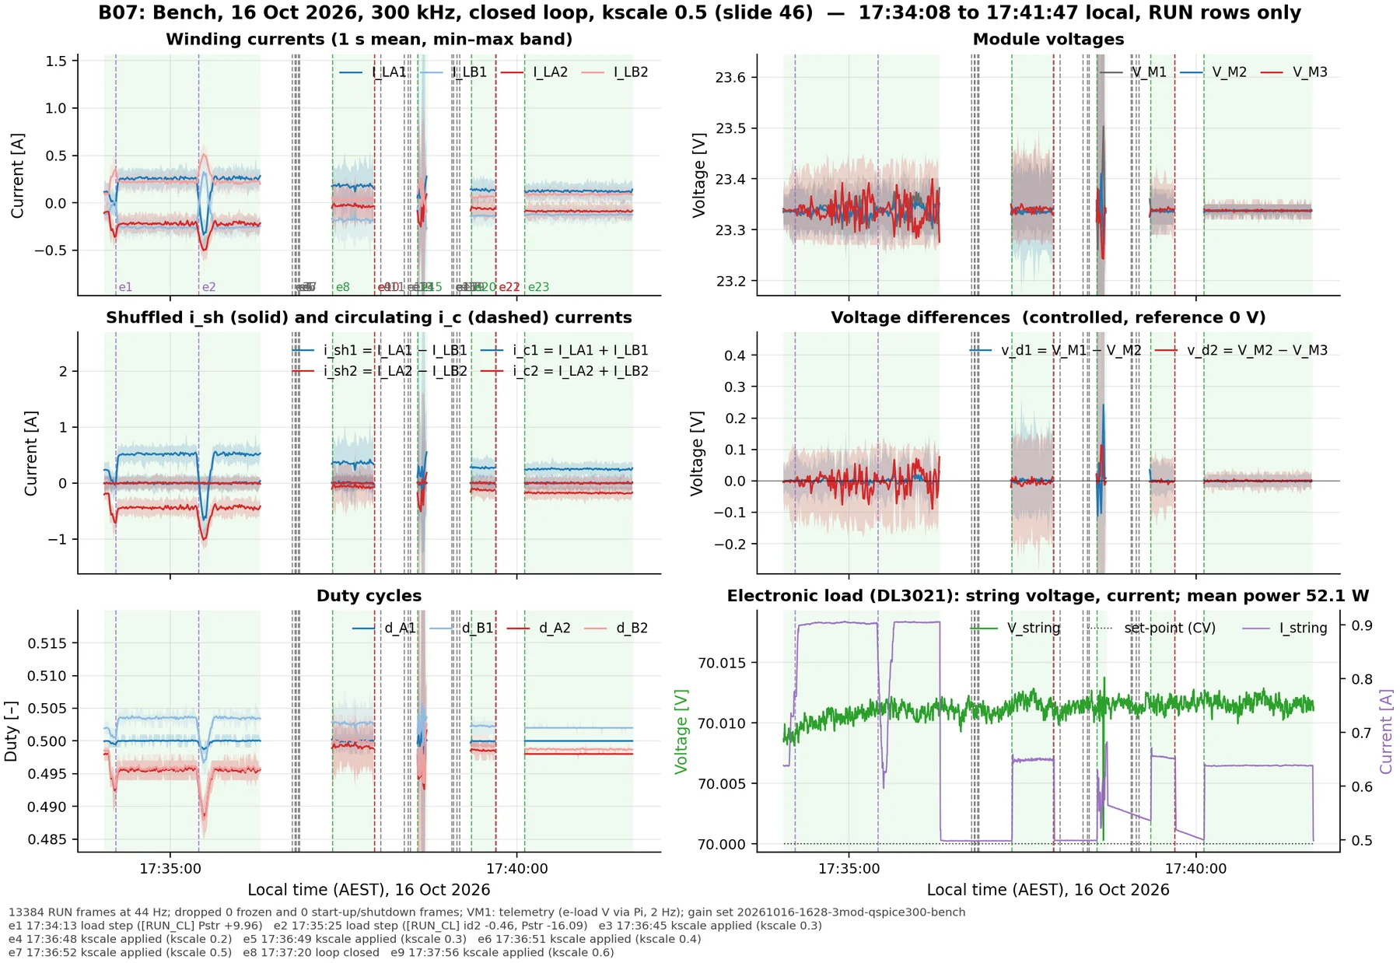
site/src/assets/figures/analysis/B07_bench_300k_CL_k0.5_overview.webp
