saunders-jared-final/Boost-Brigade/site/src/assets/figures/analysis/B08_bench_400k_OL_overview.webp

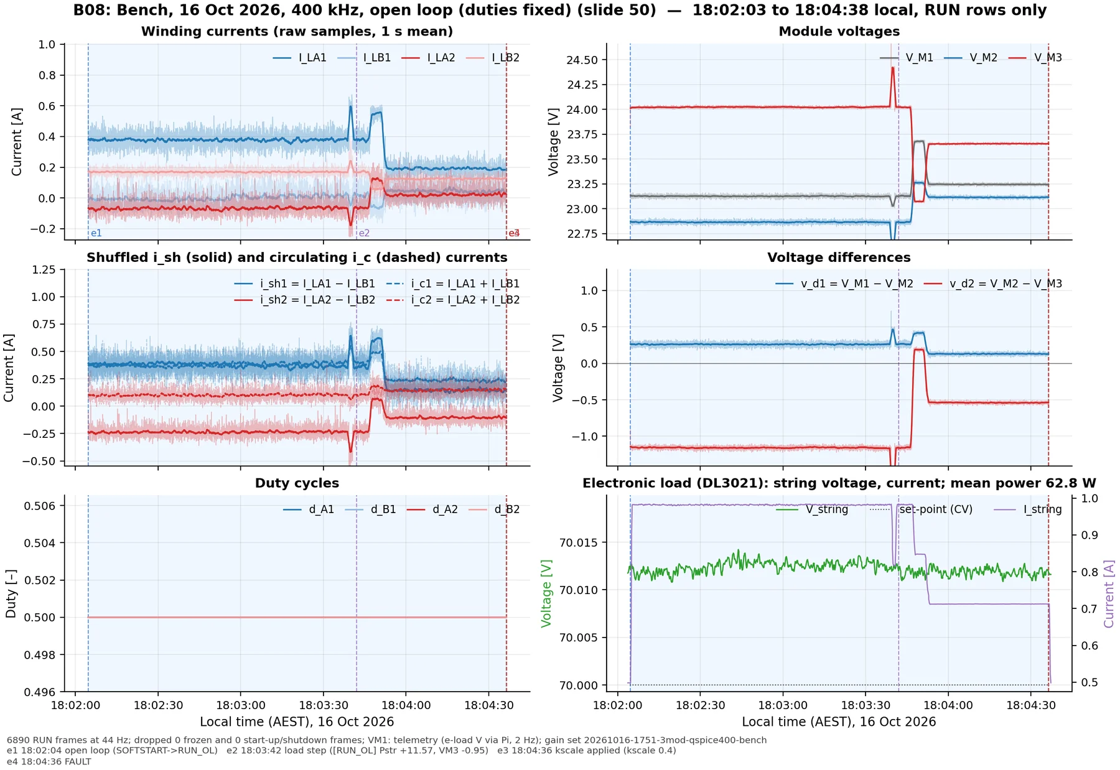
site/src/assets/figures/analysis/B08_bench_400k_OL_overview.webp
