saunders-jared-final/Boost-Brigade/site/src/assets/figures/analysis/B09_bench_400k_CL_k0.3_overview.webp

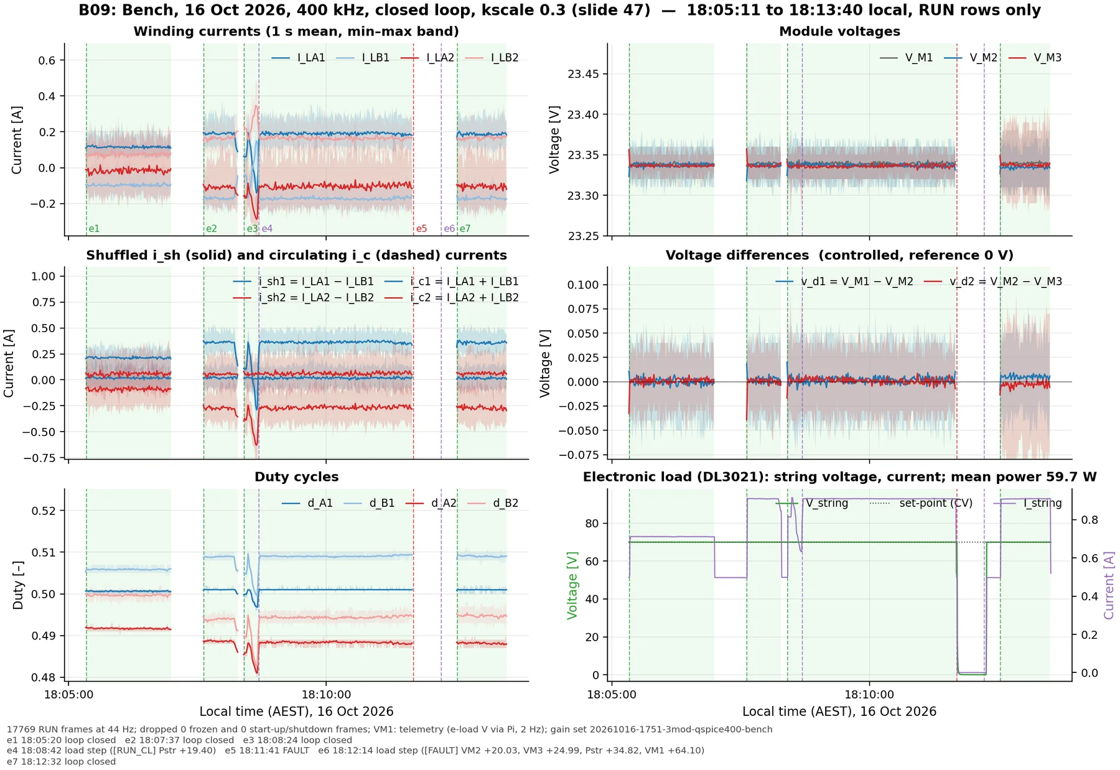
site/src/assets/figures/analysis/B09_bench_400k_CL_k0.3_overview.webp
