saunders-jared-final/Boost-Brigade/site/src/assets/figures/analysis/mil_01_uniform-zero.webp

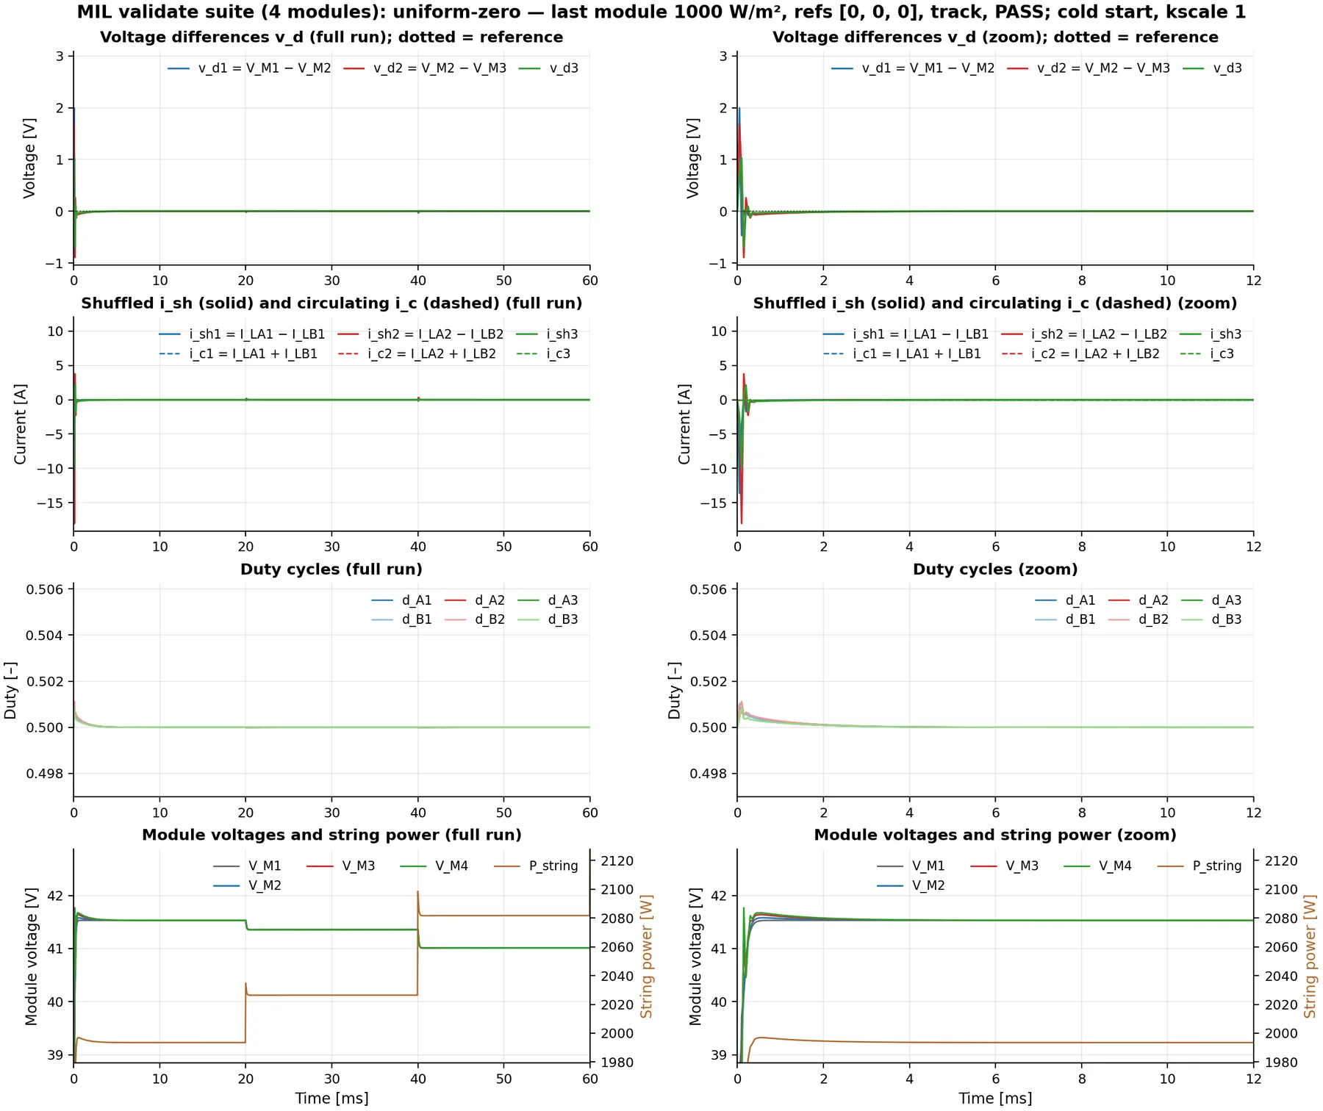
site/src/assets/figures/analysis/mil_01_uniform-zero.webp
