saunders-jared-final/Boost-Brigade/site/src/assets/figures/analysis/S01_solar_200k_OL_peak_overview.webp

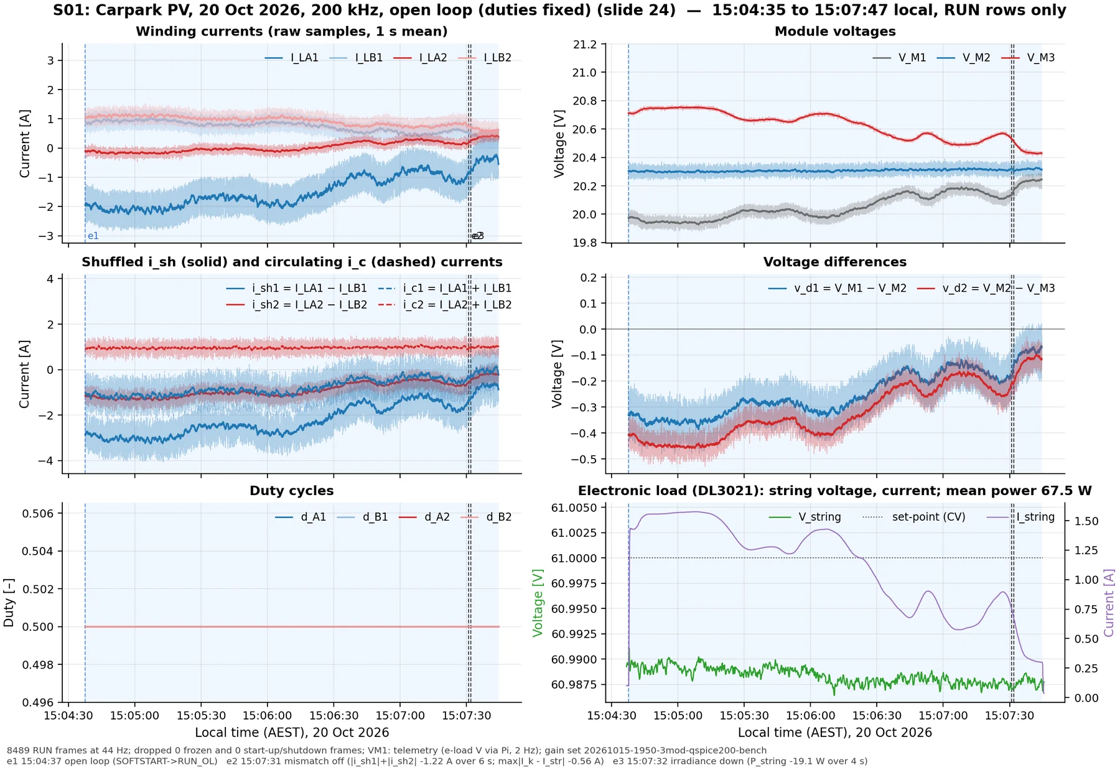
site/src/assets/figures/analysis/S01_solar_200k_OL_peak_overview.webp
