saunders-jared-final/Boost-Brigade/site/src/assets/figures/analysis/S02_e1_close.webp

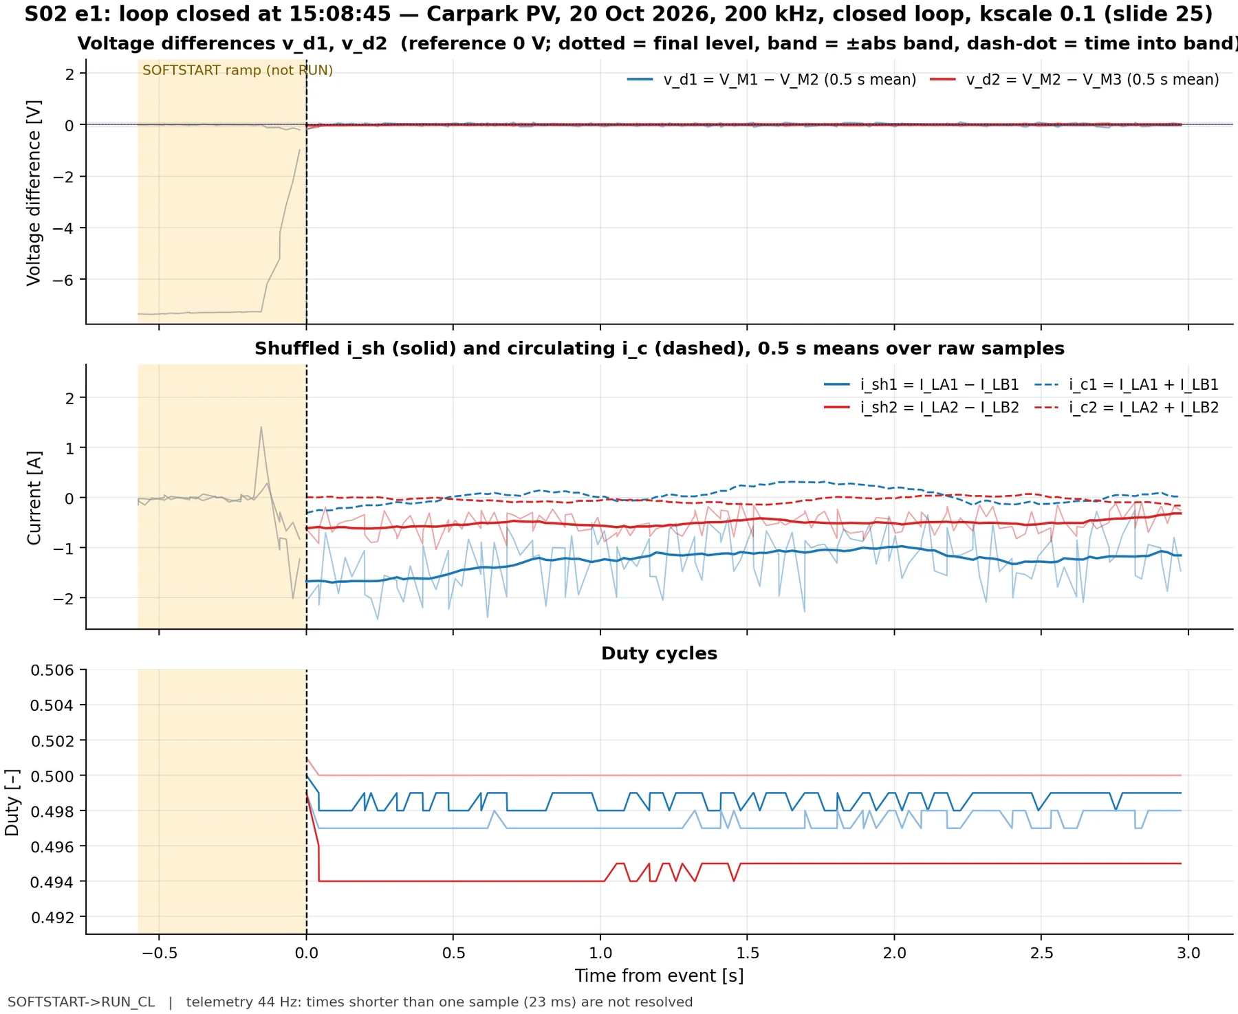
site/src/assets/figures/analysis/S02_e1_close.webp
