saunders-jared-final/Boost-Brigade/site/src/assets/figures/analysis/S02_solar_200k_CL_k0.1_peak_overview.webp

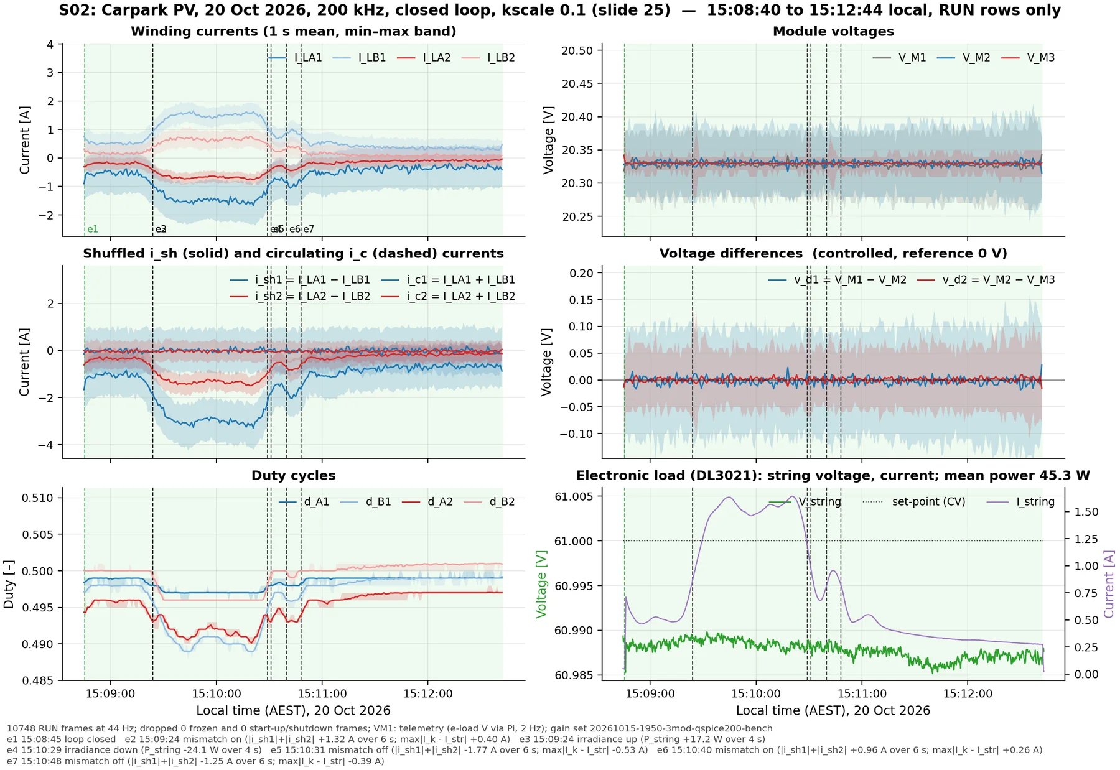
site/src/assets/figures/analysis/S02_solar_200k_CL_k0.1_peak_overview.webp
