saunders-jared-final/Boost-Brigade/site/src/assets/figures/analysis/S03_solar_200k_OL_min_overview.webp

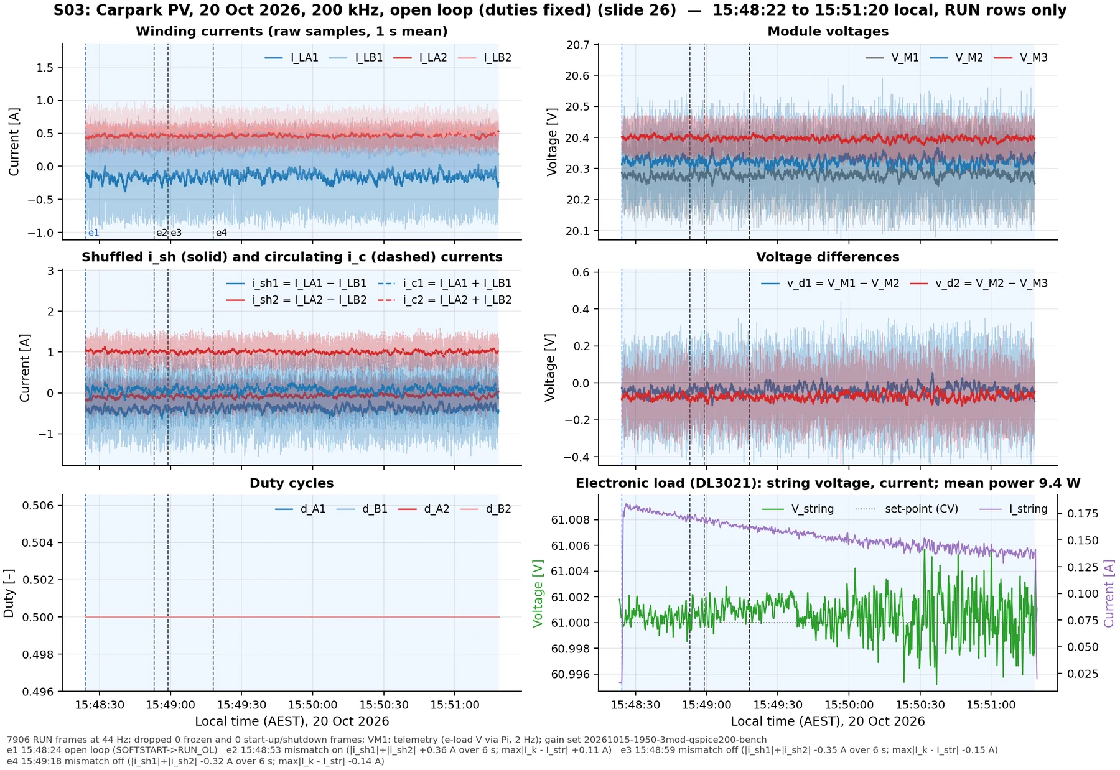
site/src/assets/figures/analysis/S03_solar_200k_OL_min_overview.webp
