saunders-jared-final/Boost-Brigade/site/src/assets/figures/analysis/S04_solar_200k_CL_k0.1_min_overview.webp

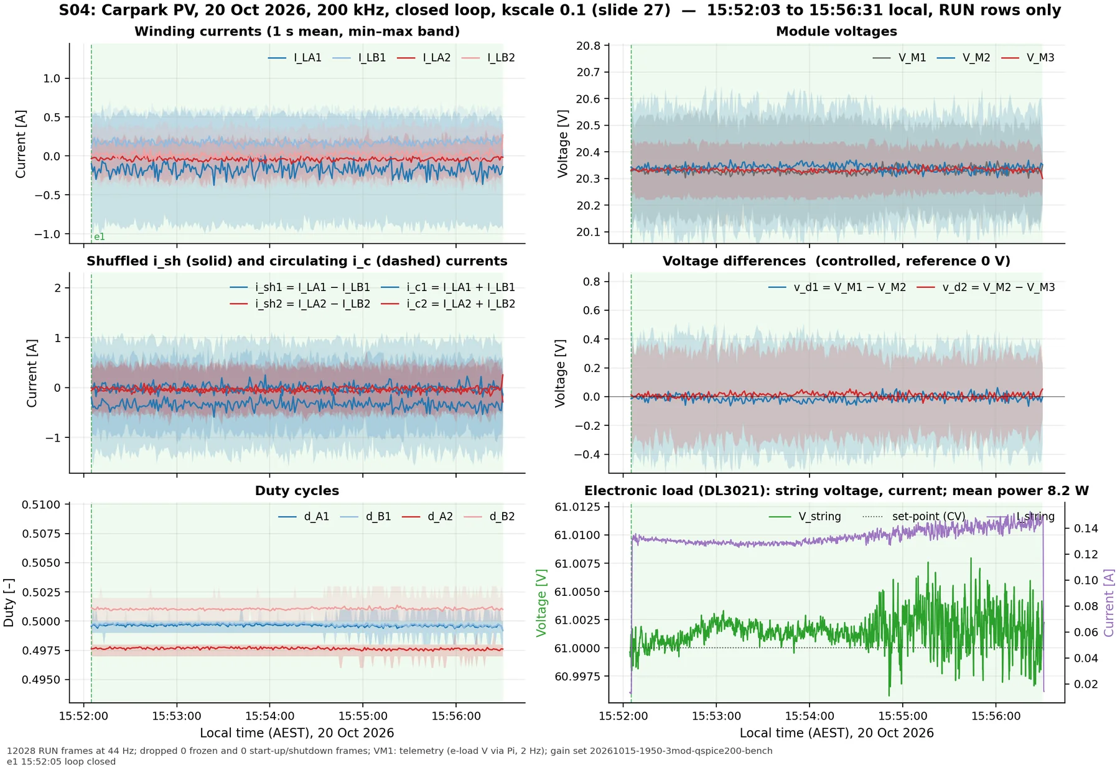
site/src/assets/figures/analysis/S04_solar_200k_CL_k0.1_min_overview.webp
