saunders-jared-final/Boost-Brigade/site/src/assets/figures/analysis/S05_solar_200k_CL_k0.2_min_overview.webp

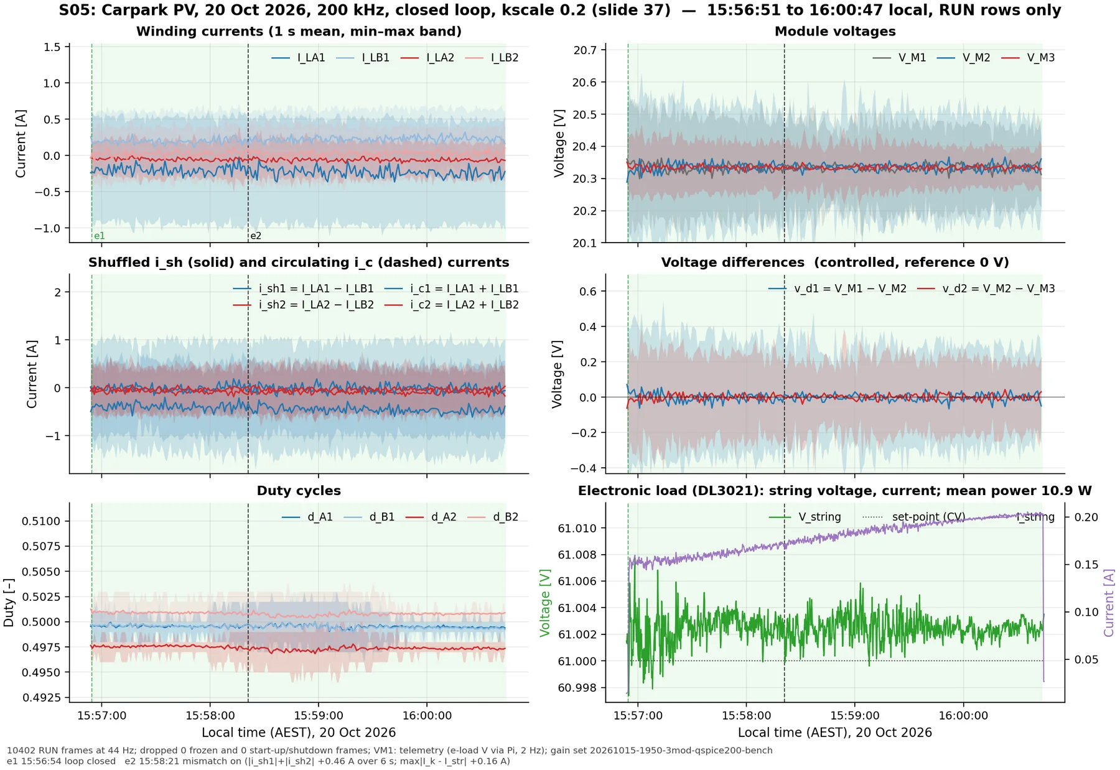
site/src/assets/figures/analysis/S05_solar_200k_CL_k0.2_min_overview.webp
