saunders-jared-final/Boost-Brigade/site/src/assets/figures/analysis/S06_solar_200k_CL_k0.3_min_overview.webp

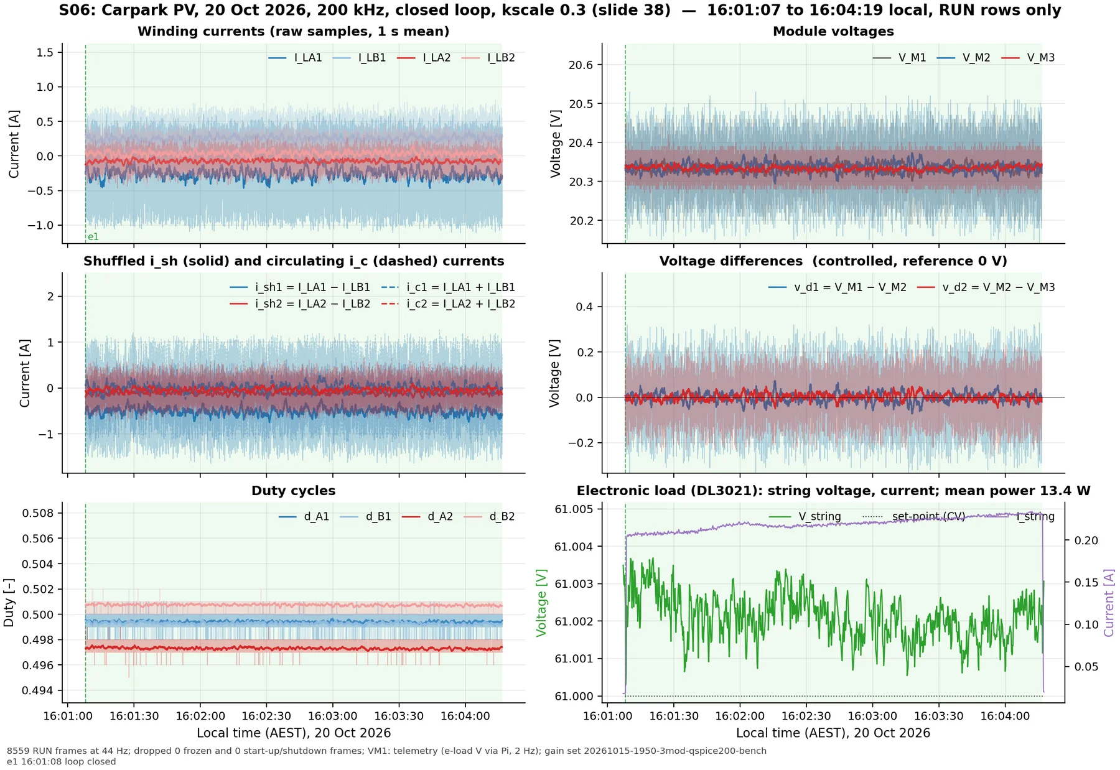
site/src/assets/figures/analysis/S06_solar_200k_CL_k0.3_min_overview.webp
