saunders-jared-final/Boost-Brigade/site/src/assets/figures/analysis/S07_solar_200k_CL_k0.4_min_overview.webp

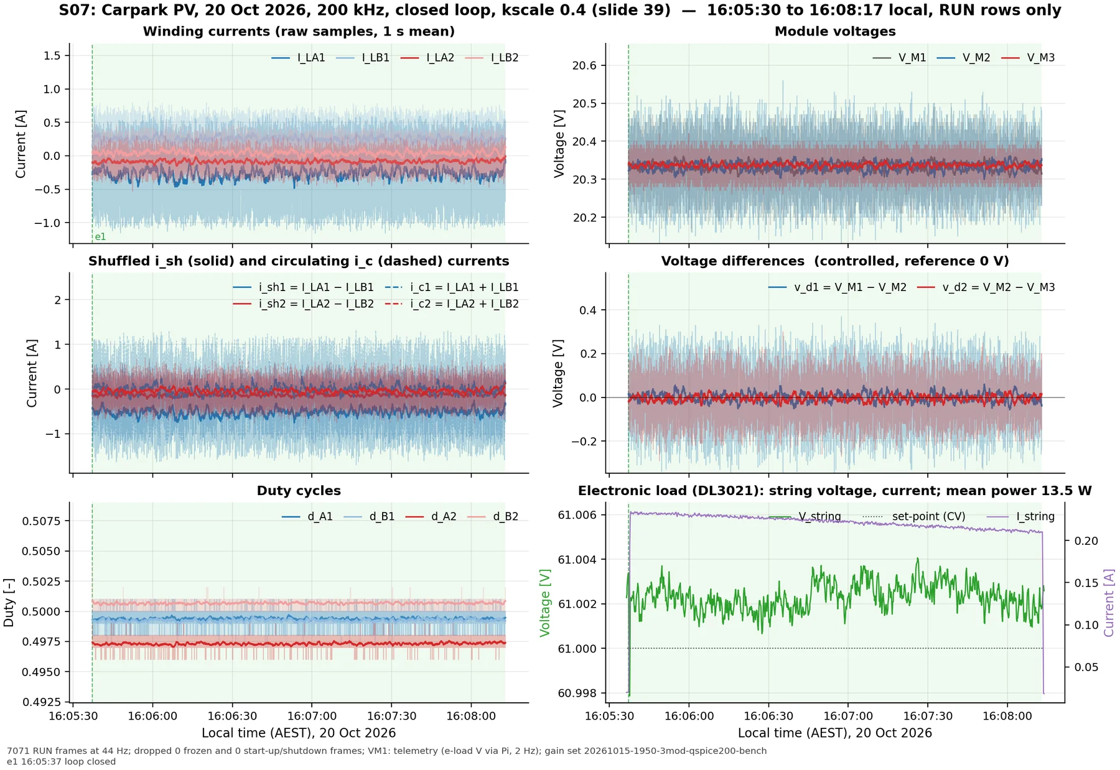
site/src/assets/figures/analysis/S07_solar_200k_CL_k0.4_min_overview.webp
