saunders-jared-final/Boost-Brigade/site/src/assets/figures/analysis/S08_solar_200k_CL_k0.5_min_overview.webp

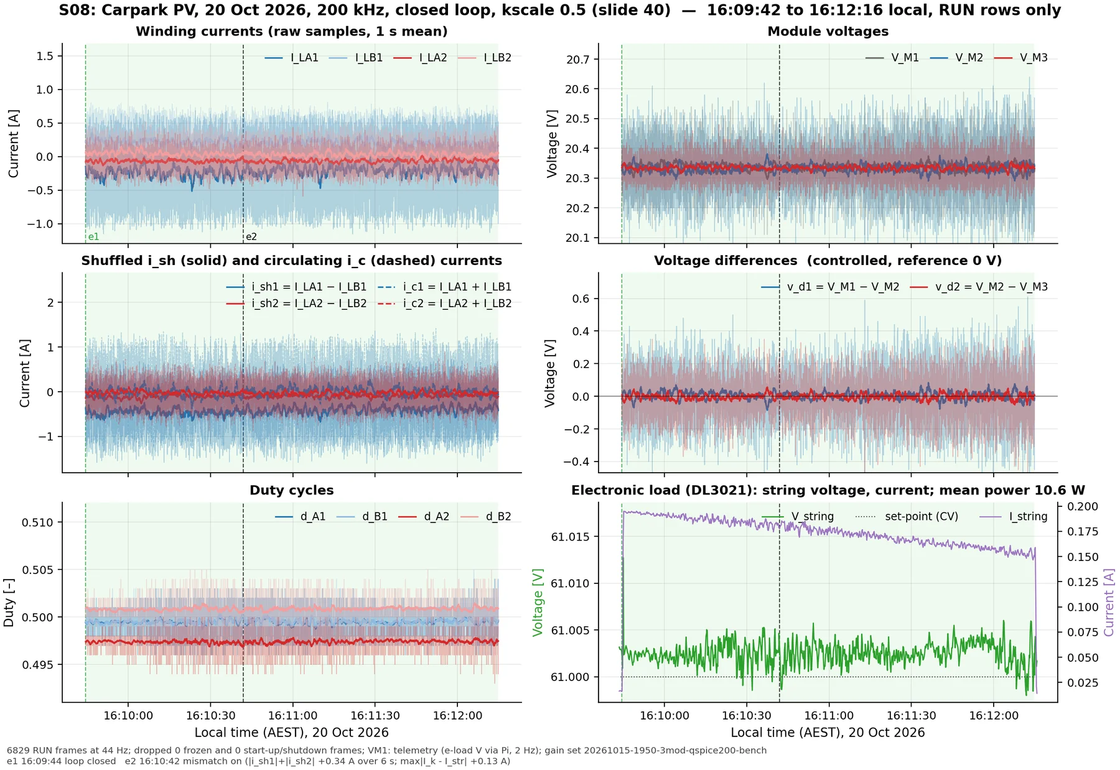
site/src/assets/figures/analysis/S08_solar_200k_CL_k0.5_min_overview.webp
