saunders-jared-final/Boost-Brigade/site/src/assets/figures/analysis/S09_solar_200k_CL_k0.6_min_overview.webp

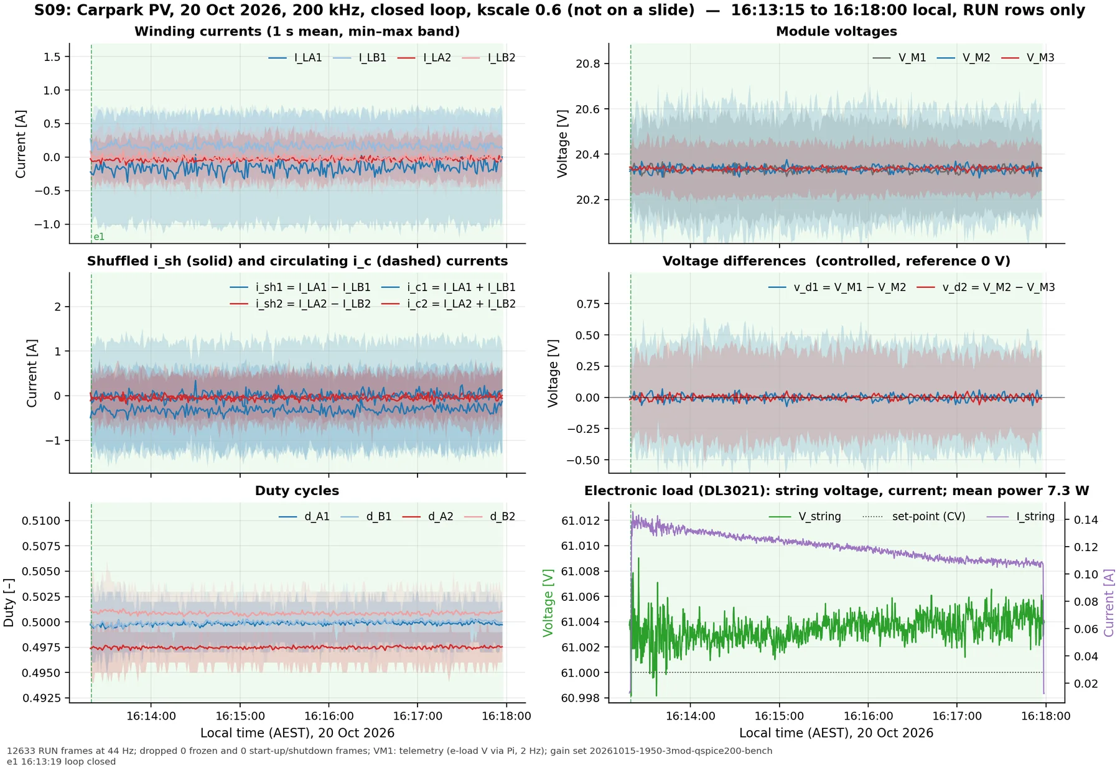
site/src/assets/figures/analysis/S09_solar_200k_CL_k0.6_min_overview.webp
