saunders-jared-final/Boost-Brigade/site/src/assets/figures/analysis/S10_solar_200k_CL_k0.7_min_overview.webp

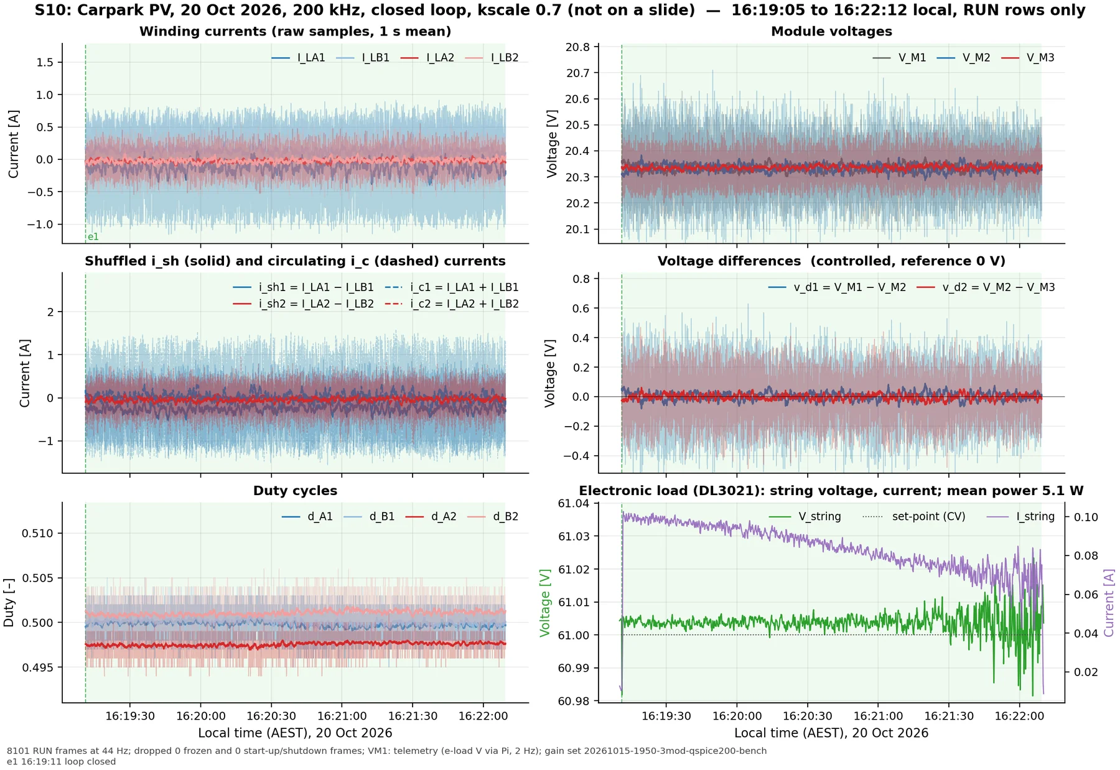
site/src/assets/figures/analysis/S10_solar_200k_CL_k0.7_min_overview.webp
