saunders-jared-final/Boost-Brigade/site/src/assets/figures/analysis/S11_solar_200k_CL_k0.8_min_overview.webp

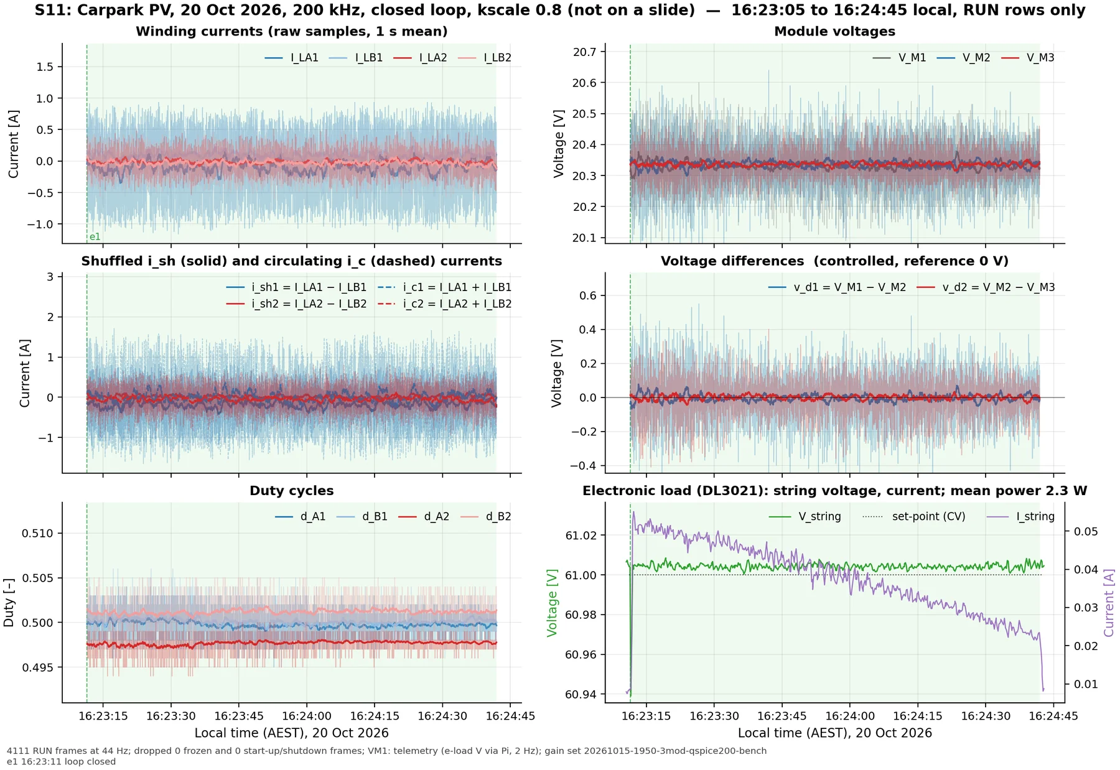
site/src/assets/figures/analysis/S11_solar_200k_CL_k0.8_min_overview.webp
