saunders-jared-final/Boost-Brigade/site/src/assets/figures/ctrl/derivation_n3.webp

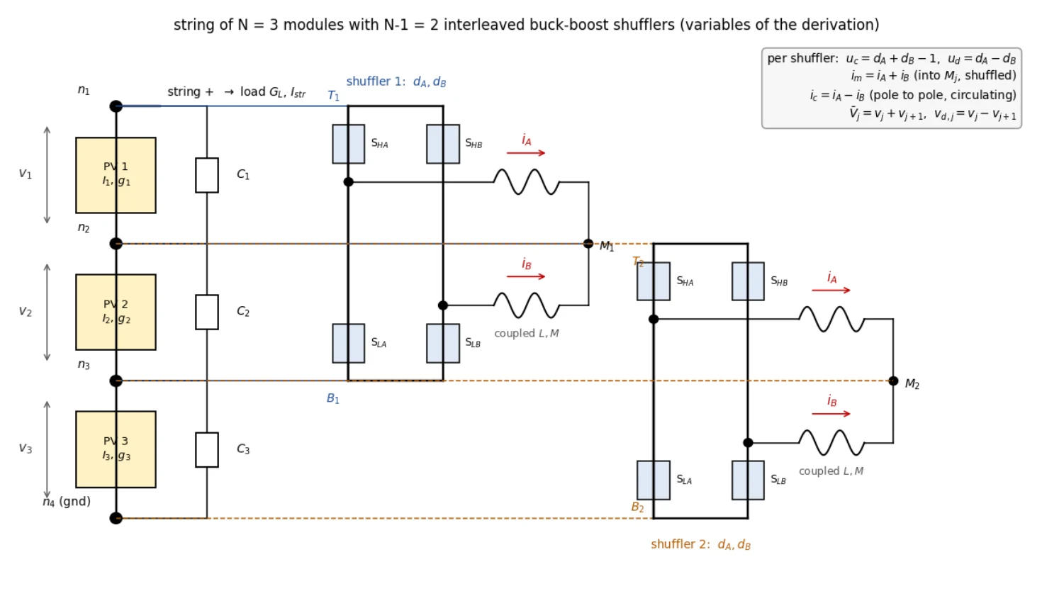
site/src/assets/figures/ctrl/derivation_n3.webp
