saunders-jared-final/Boost-Brigade/site/src/assets/figures/ctrl/gain_pipeline.webp

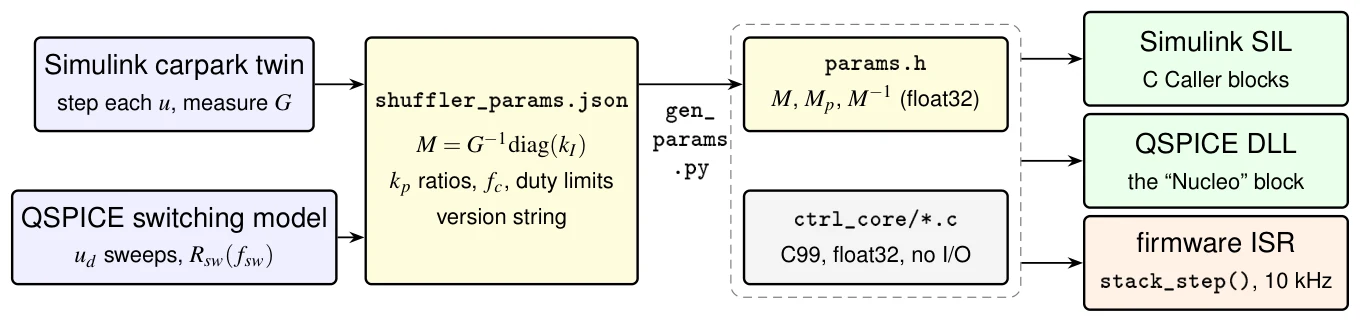
site/src/assets/figures/ctrl/gain_pipeline.webp
