saunders-jared-final/Boost-Brigade/site/src/assets/figures/ctrl/mil_blocks.webp

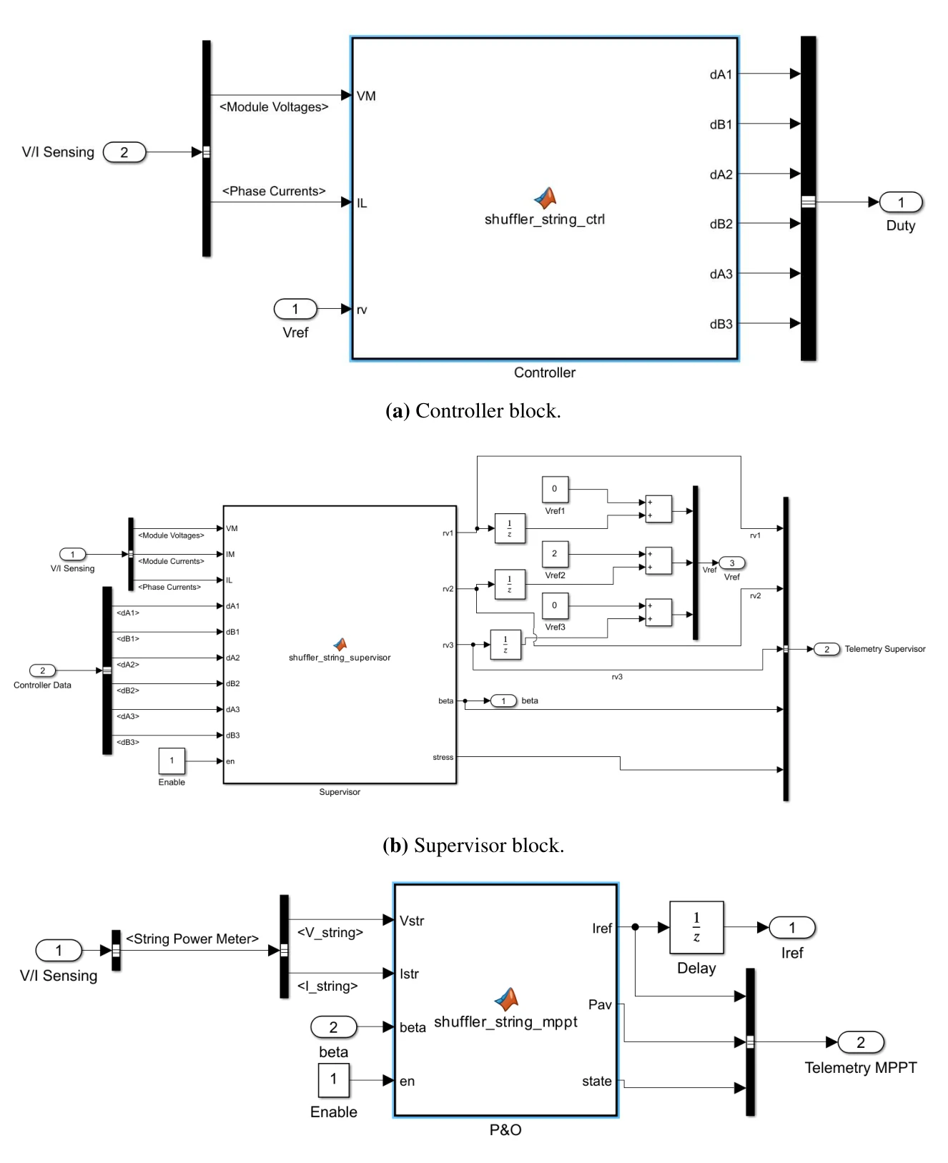
site/src/assets/figures/ctrl/mil_blocks.webp
