saunders-jared-final/Boost-Brigade/site/src/assets/figures/ctrl/pv_curves.webp

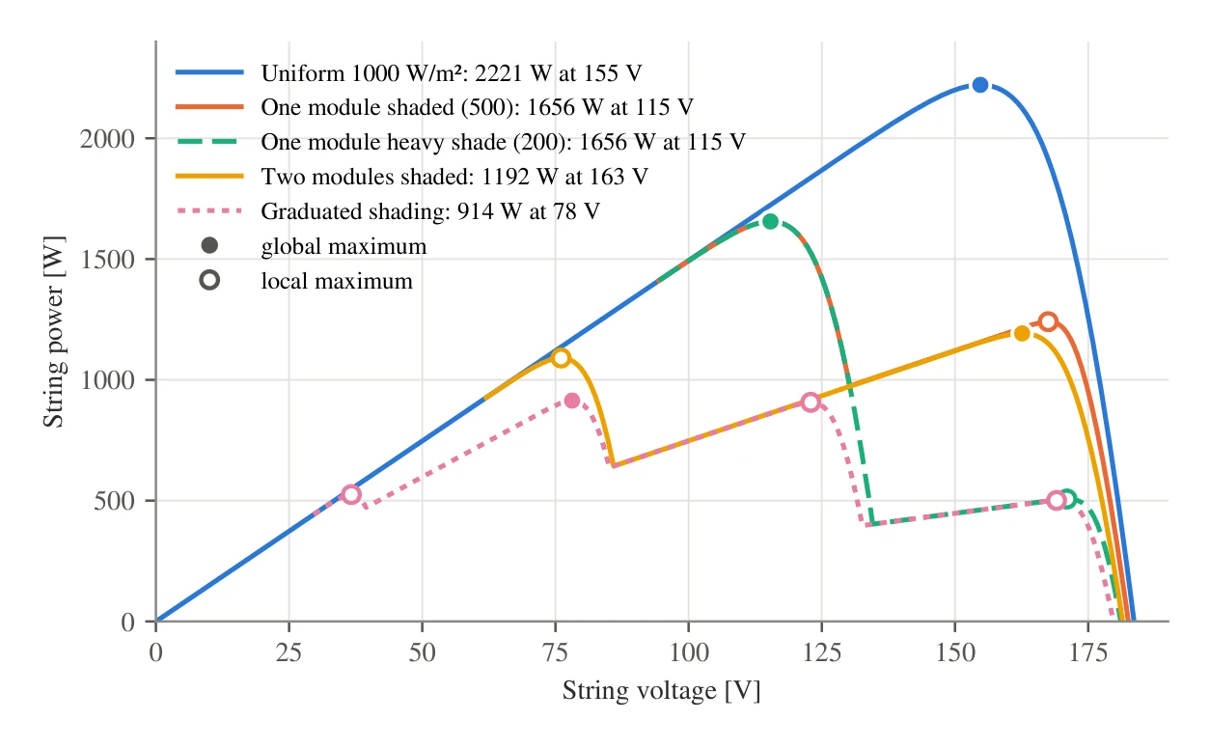
site/src/assets/figures/ctrl/pv_curves.webp
