saunders-jared-final/Boost-Brigade/site/src/assets/figures/ctrl/scope_captures.webp

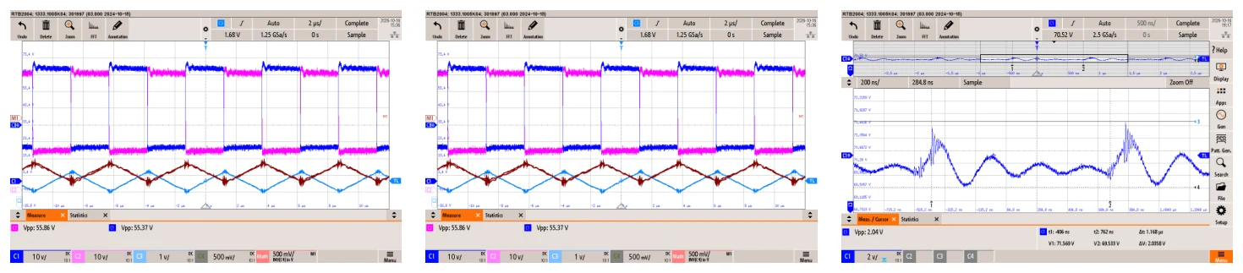
site/src/assets/figures/ctrl/scope_captures.webp
