saunders-jared-final/Boost-Brigade/site/src/assets/figures/ctrl/solar_S02.webp

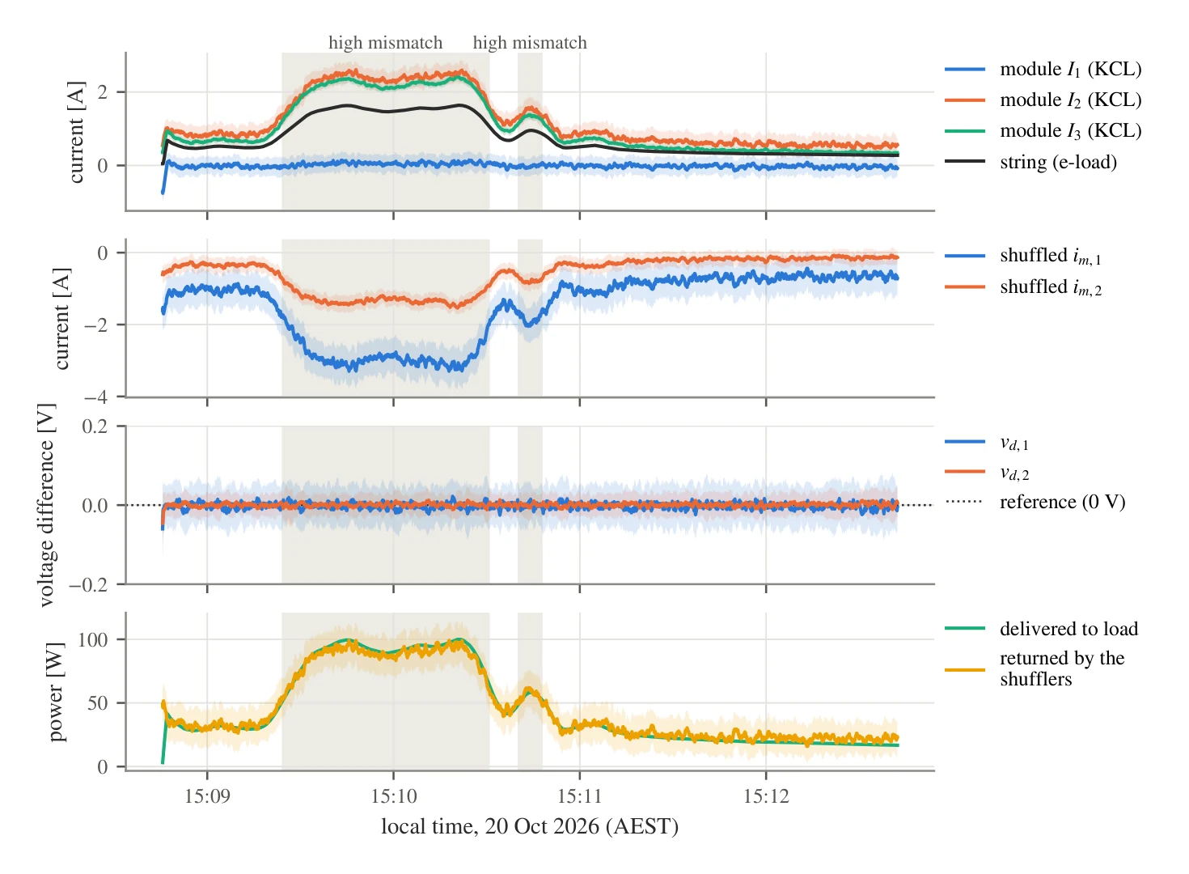
site/src/assets/figures/ctrl/solar_S02.webp
