saunders-jared-final/Boost-Brigade/site/src/assets/figures/hw/arch_initial.webp

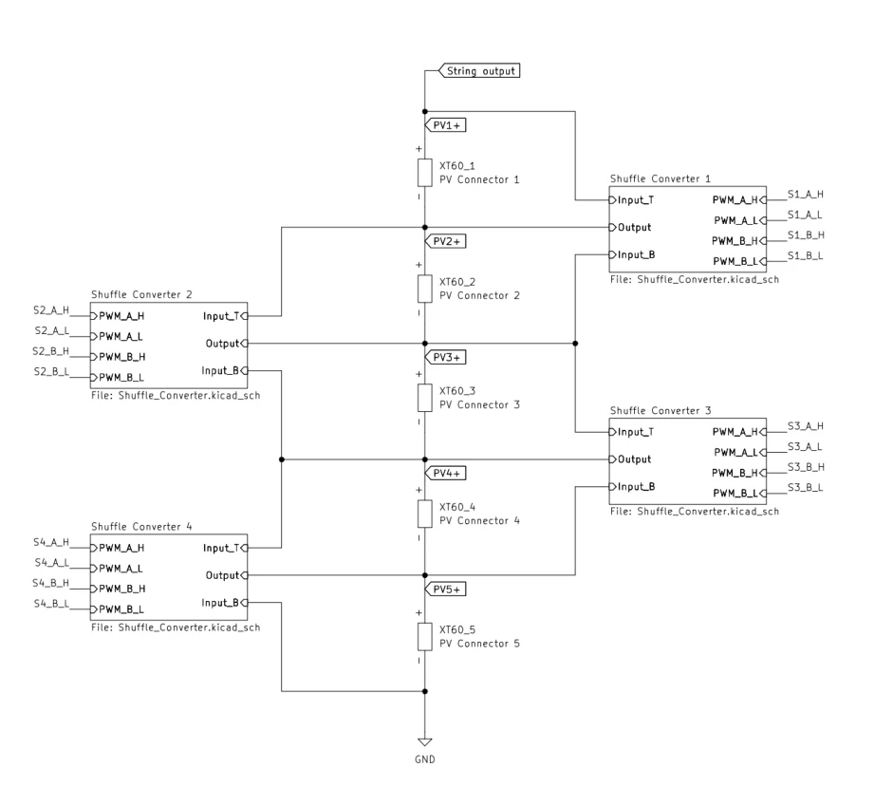
site/src/assets/figures/hw/arch_initial.webp
