saunders-jared-final/Boost-Brigade/site/src/assets/figures/hw/bench_leg_currents.webp

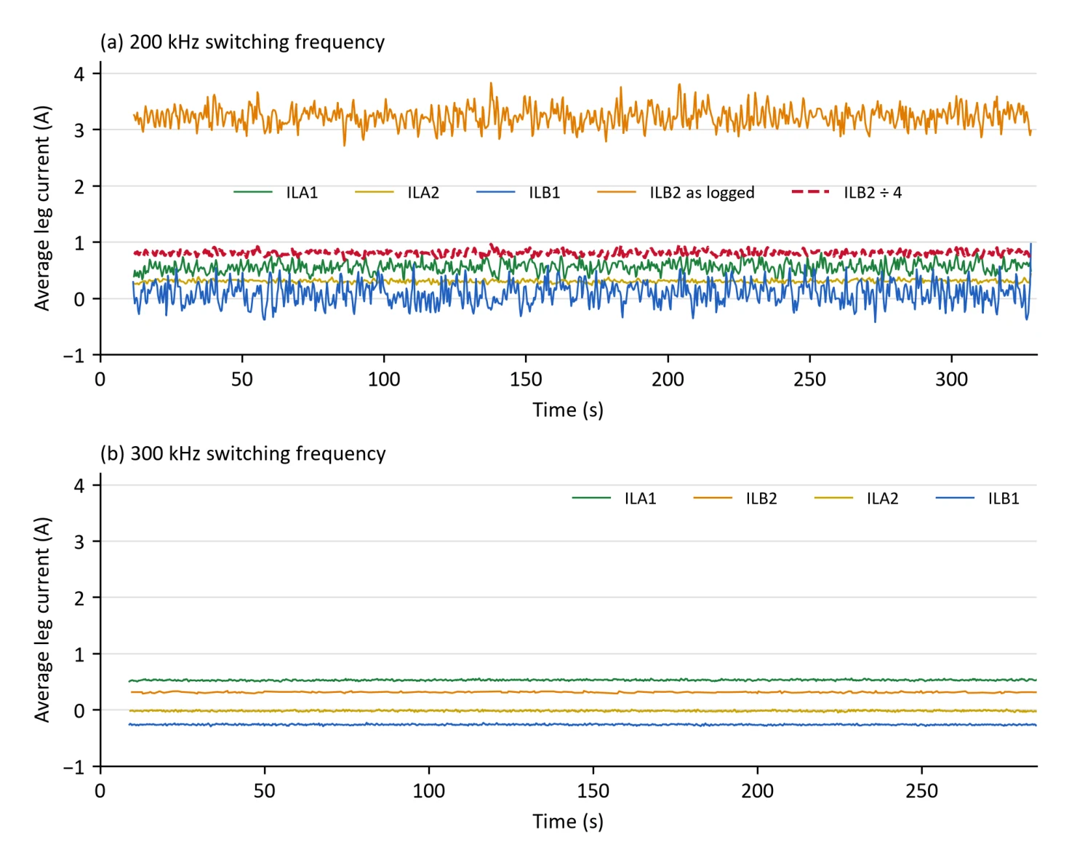
site/src/assets/figures/hw/bench_leg_currents.webp
