saunders-jared-final/Boost-Brigade/site/src/assets/figures/hw/bench_power.webp

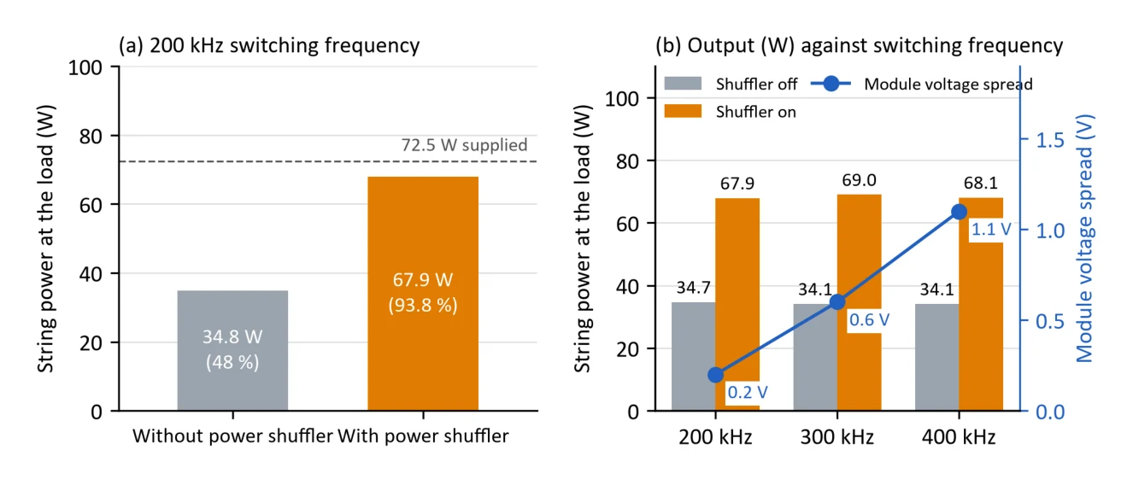
site/src/assets/figures/hw/bench_power.webp
