saunders-jared-final/Boost-Brigade/site/src/assets/figures/hw/pv_run3.webp

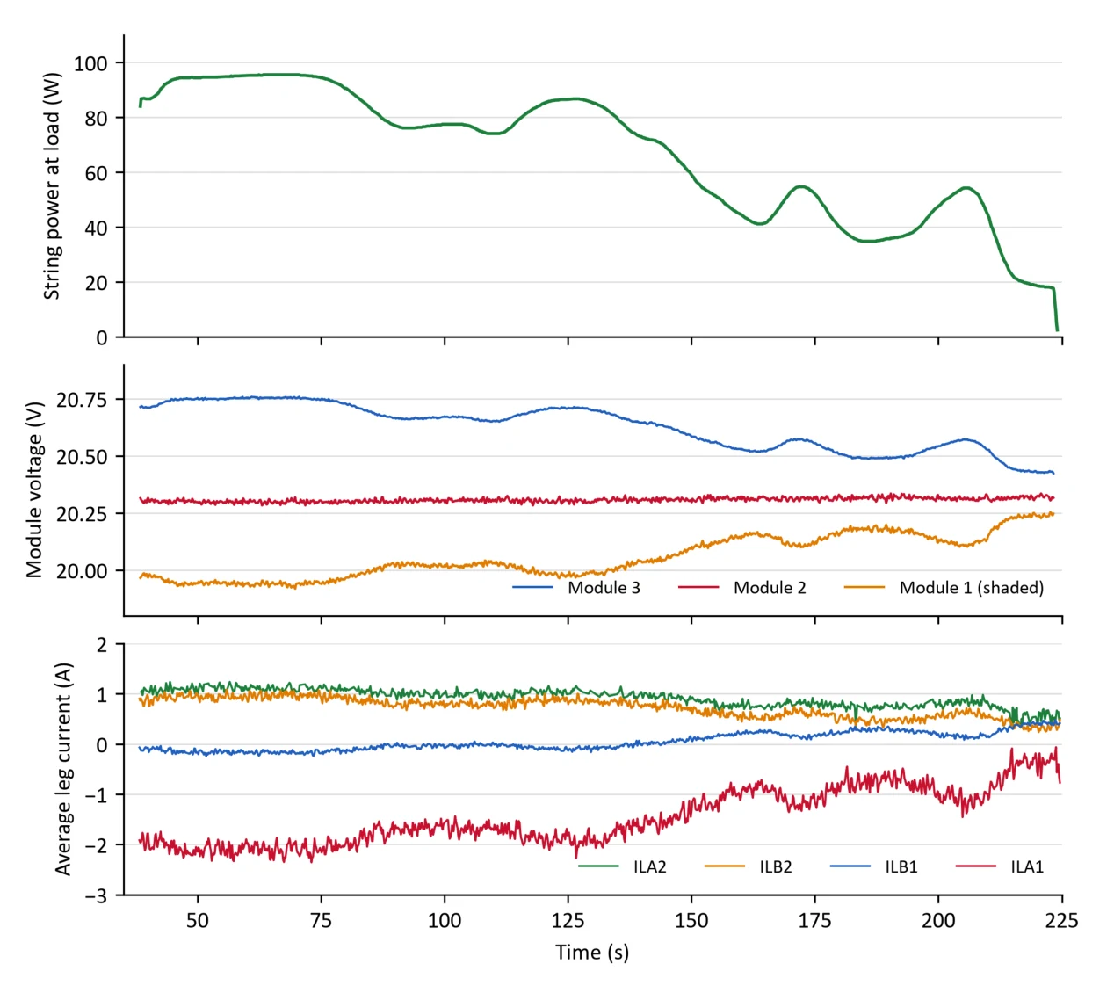
site/src/assets/figures/hw/pv_run3.webp
