saunders-jared-final/Boost-Brigade/site/src/assets/figures/hw/qspice_parasitic.webp

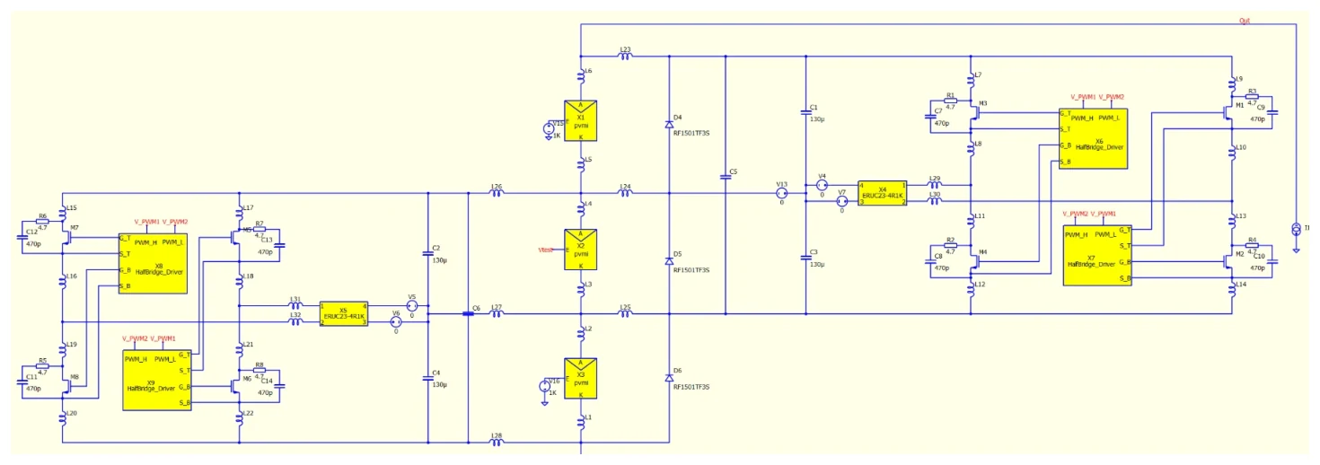
site/src/assets/figures/hw/qspice_parasitic.webp
