saunders-jared-final/Boost-Brigade/site/src/assets/figures/misc/fusion_side2.webp

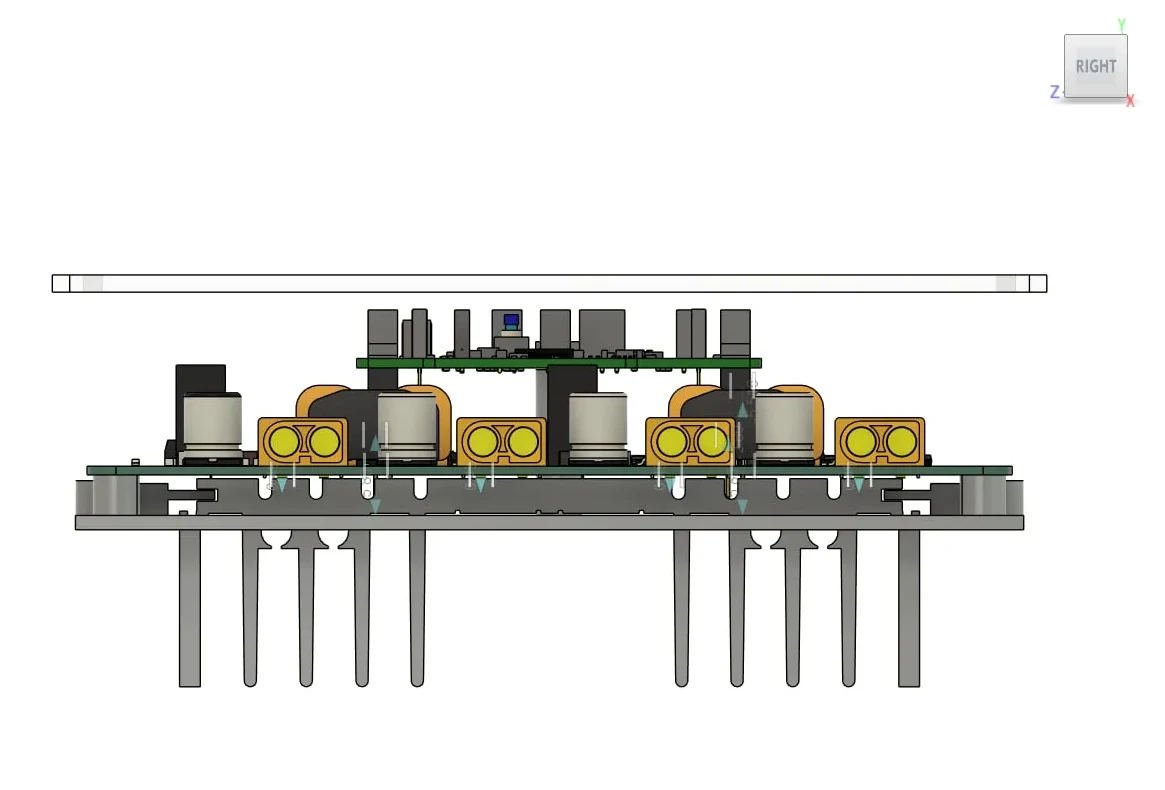
site/src/assets/figures/misc/fusion_side2.webp
