saunders-jared-final/Boost-Brigade/site/src/assets/figures/misc/scr02.webp

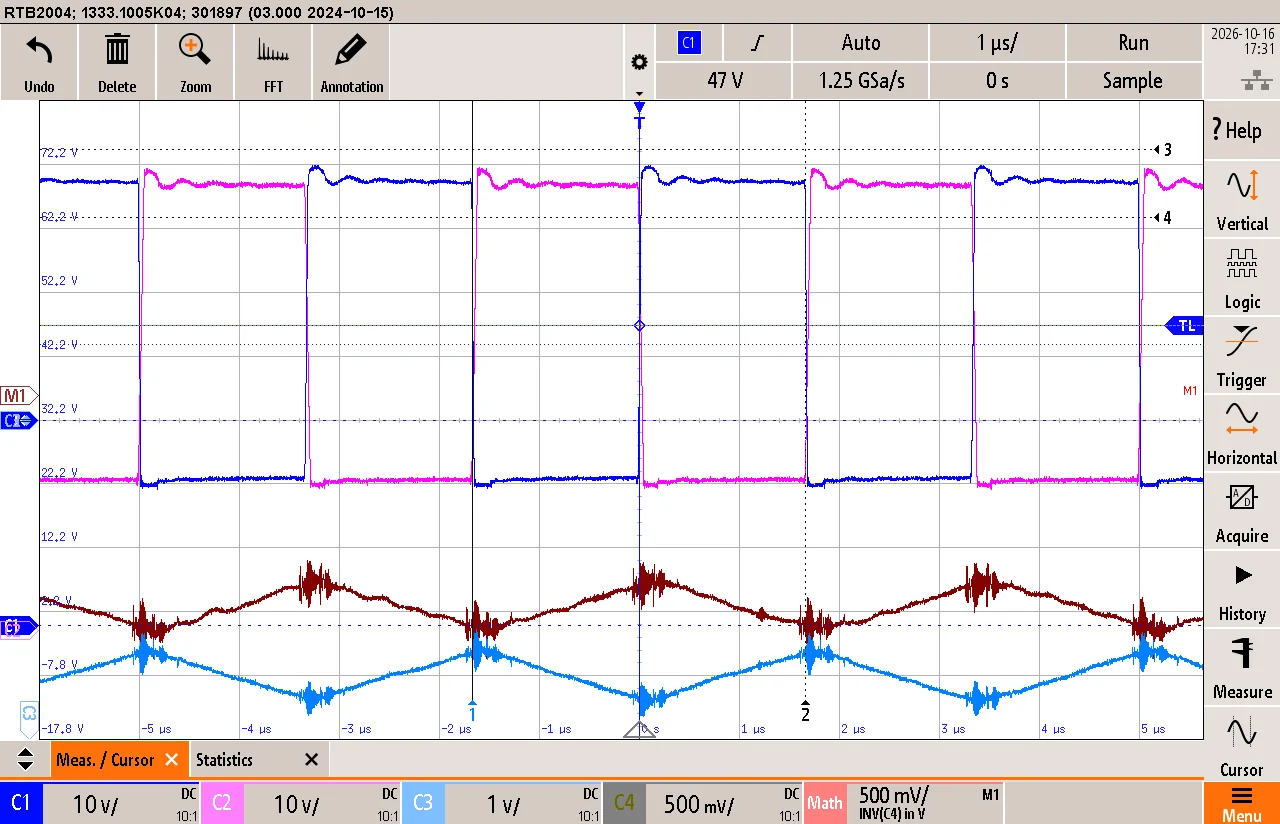
site/src/assets/figures/misc/scr02.webp
