saunders-jared-final/Boost-Brigade/site/src/assets/figures/misc/thermal_solar_20oct.webp

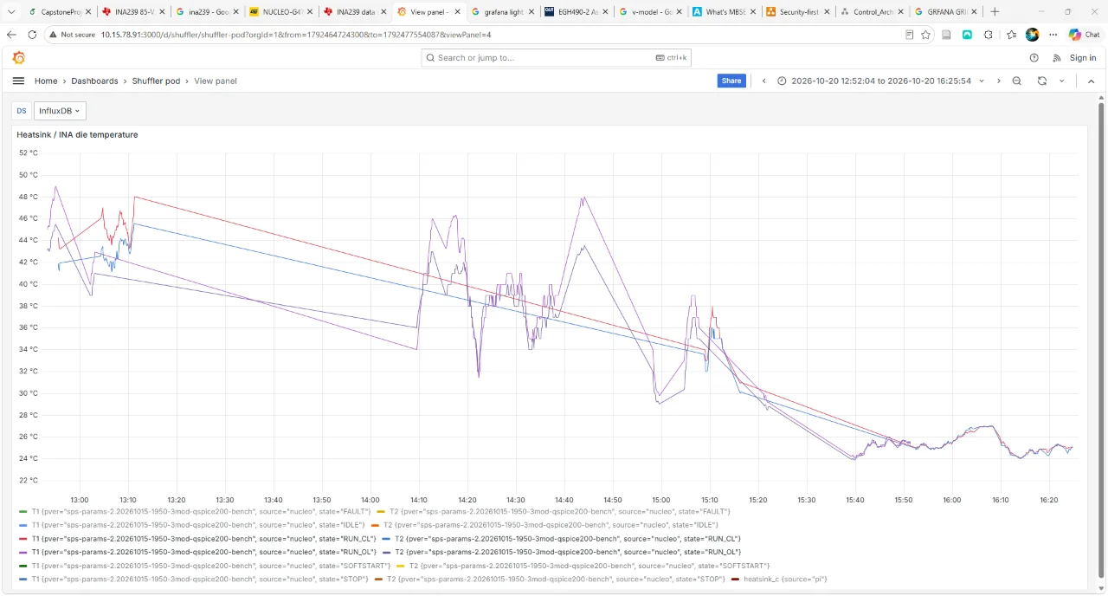
site/src/assets/figures/misc/thermal_solar_20oct.webp
