saunders-jared-final/Boost-Brigade/site/src/assets/figures/simulink/04_shade-refs_string.webp

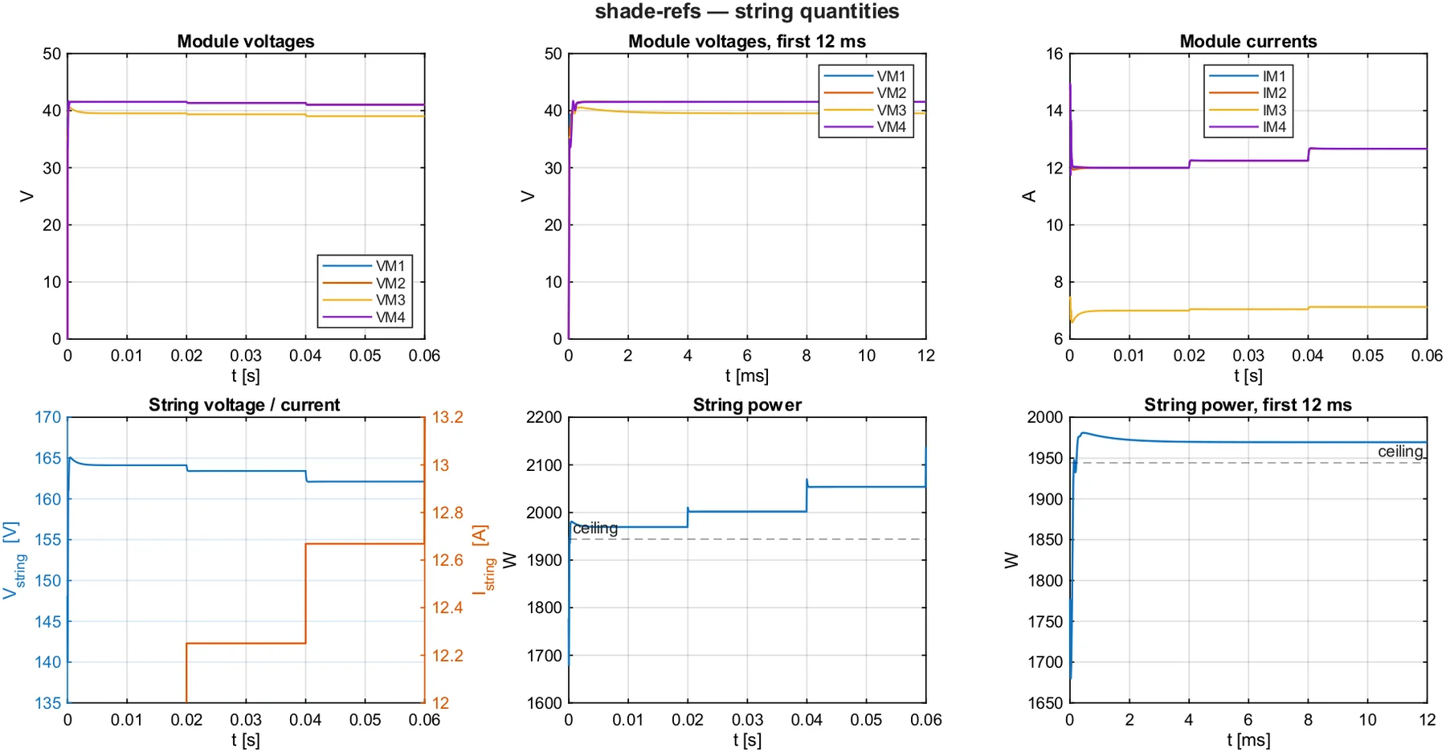
site/src/assets/figures/simulink/04_shade-refs_string.webp
