saunders-jared-final/Boost-Brigade/site/src/assets/figures/slides/img-005-004.webp

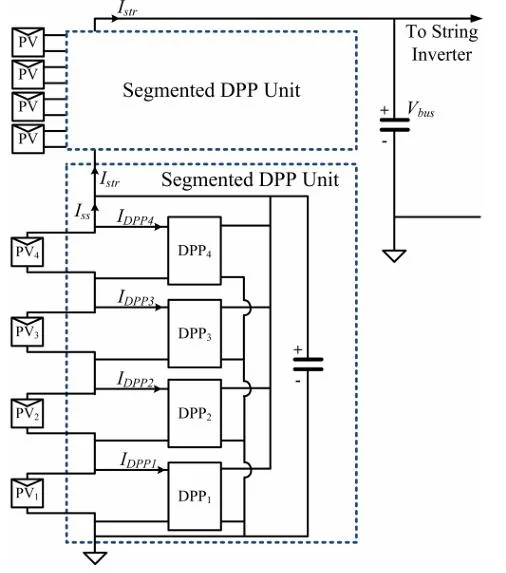
site/src/assets/figures/slides/img-005-004.webp
