saunders-jared-final/Boost-Brigade/site/src/assets/figures/slides/img-005-005.webp

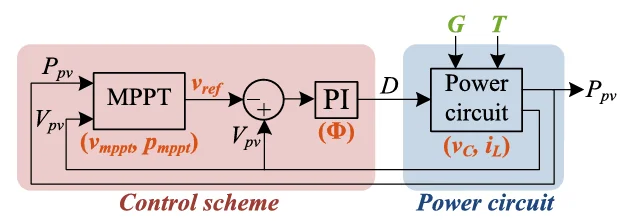
site/src/assets/figures/slides/img-005-005.webp
