saunders-jared-final/Boost-Brigade/site/src/assets/figures/slides/img-006-010.webp

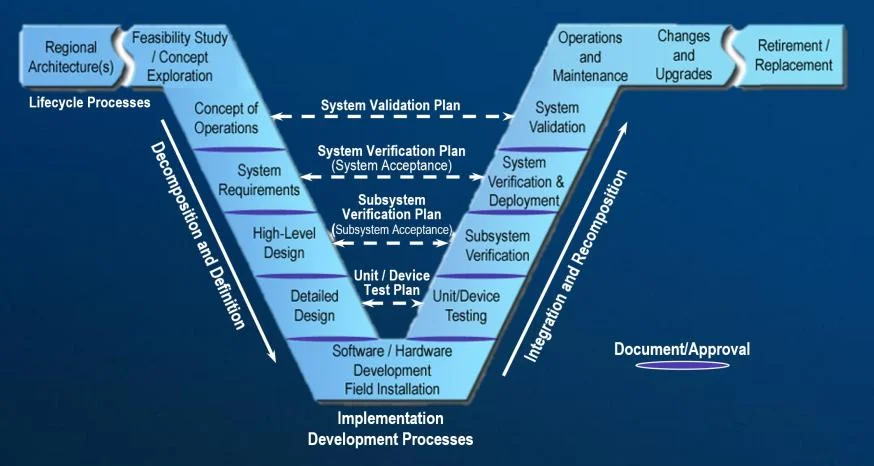
site/src/assets/figures/slides/img-006-010.webp
