saunders-jared-final/Boost-Brigade/site/src/assets/figures/slides/img-012-013.webp

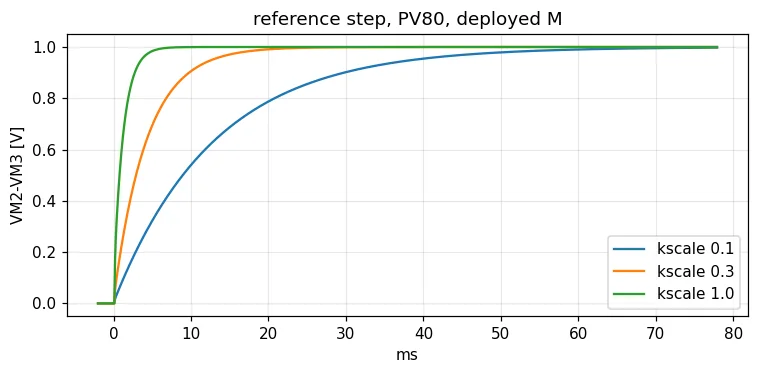
site/src/assets/figures/slides/img-012-013.webp
