saunders-jared-final/Boost-Brigade/site/src/assets/figures/slides/img-016-021.webp

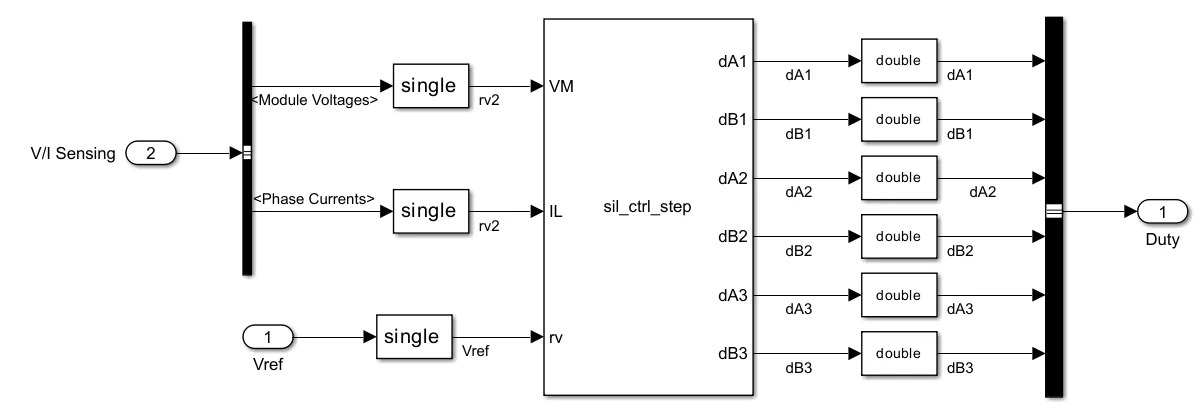
site/src/assets/figures/slides/img-016-021.webp
