saunders-jared-final/Boost-Brigade/site/src/assets/figures/slides/img-018-034.webp

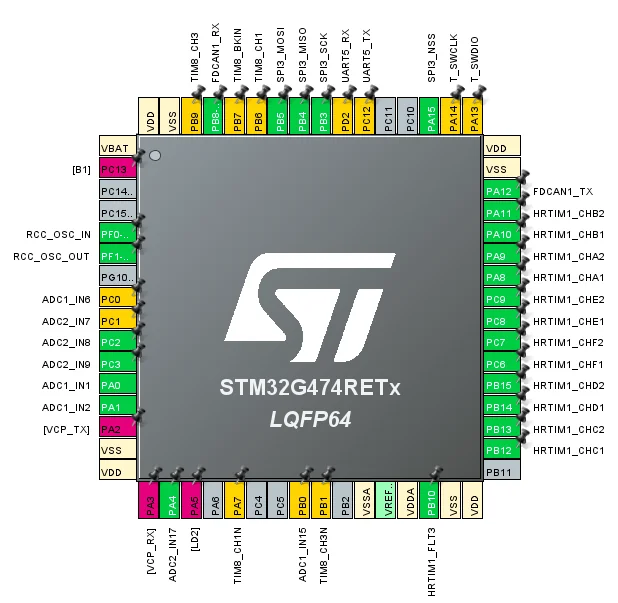
site/src/assets/figures/slides/img-018-034.webp
