saunders-jared-final/Boost-Brigade/site/src/assets/figures/slides/page-01.webp

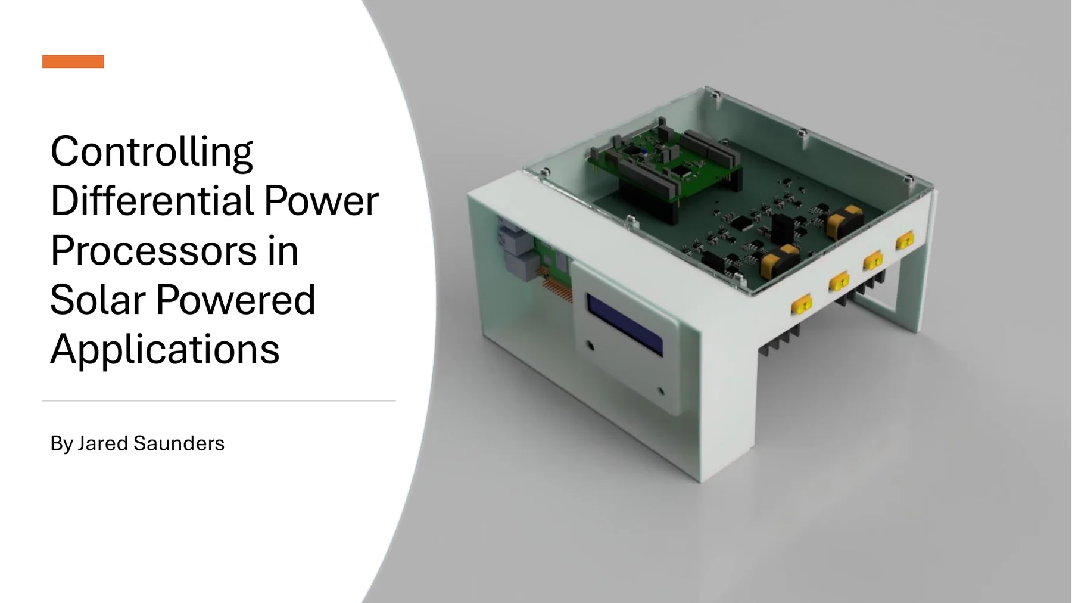
site/src/assets/figures/slides/page-01.webp
