saunders-jared-final/Boost-Brigade/site/src/assets/notebooks/shuffler_integrated/02.webp

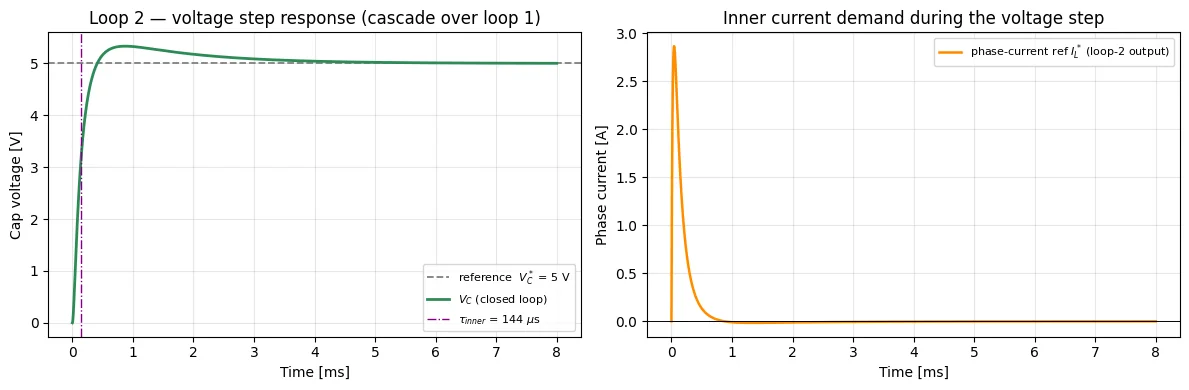
site/src/assets/notebooks/shuffler_integrated/02.webp
