saunders-jared-final/Boost-Brigade/site/src/assets/notebooks/shuffler_sim/01.webp

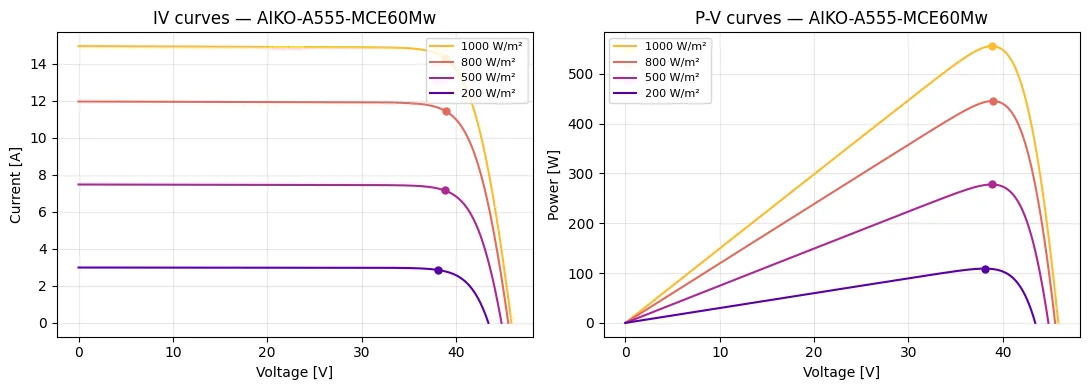
site/src/assets/notebooks/shuffler_sim/01.webp
