saunders-jared-final/Boost-Brigade/site/src/assets/notebooks/shuffler_statespace/03.webp

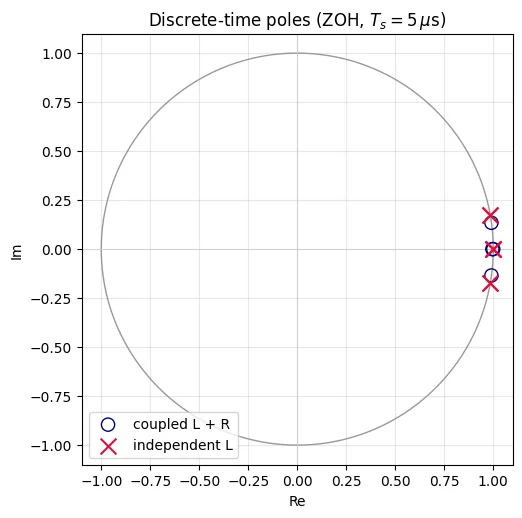
site/src/assets/notebooks/shuffler_statespace/03.webp
