saunders-jared-final/Boost-Brigade/site/src/assets/photos/20261011_101101.webp

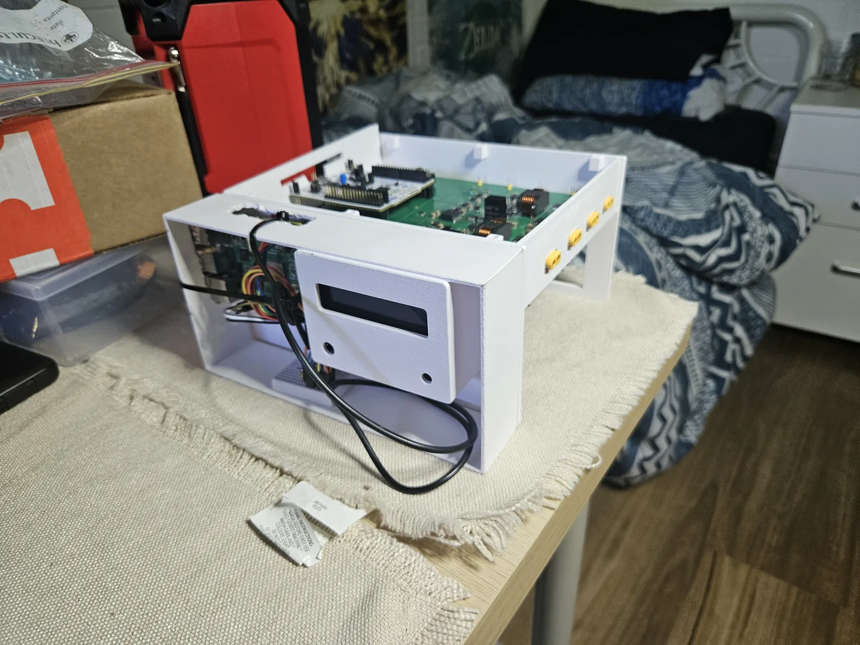
site/src/assets/photos/20261011_101101.webp
