saunders-jared-final/Boost-Brigade/site/src/assets/photos/20261014_103904.webp

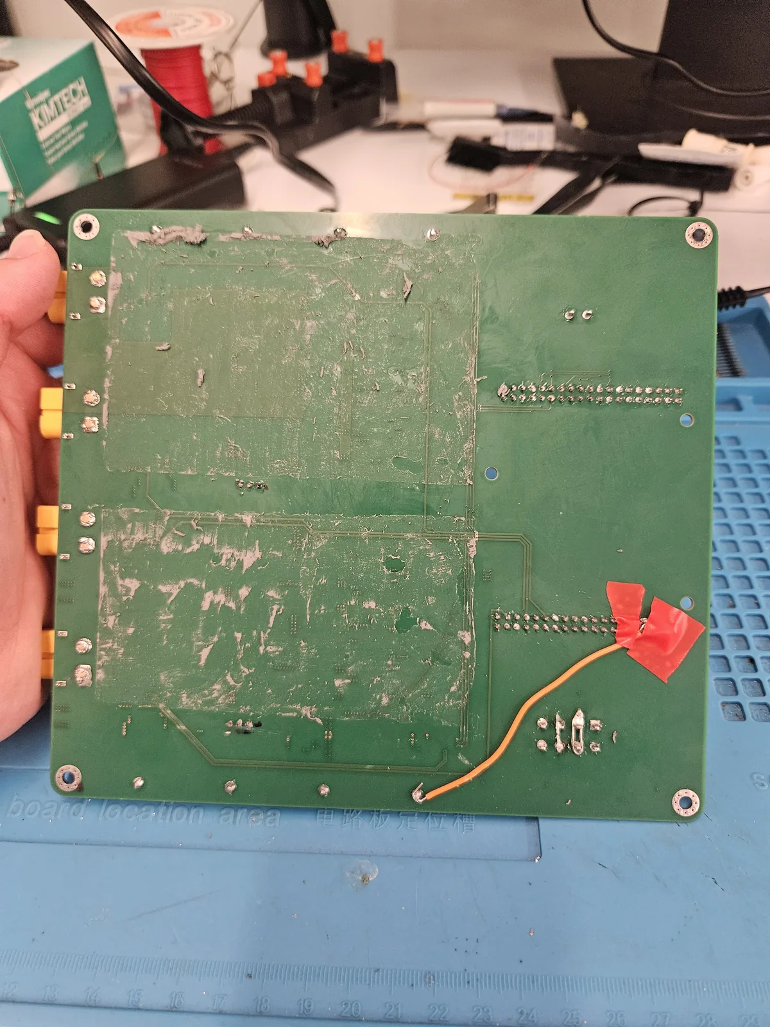
site/src/assets/photos/20261014_103904.webp
