saunders-jared-final/Boost-Brigade/site/src/assets/photos/20261016_125222.webp

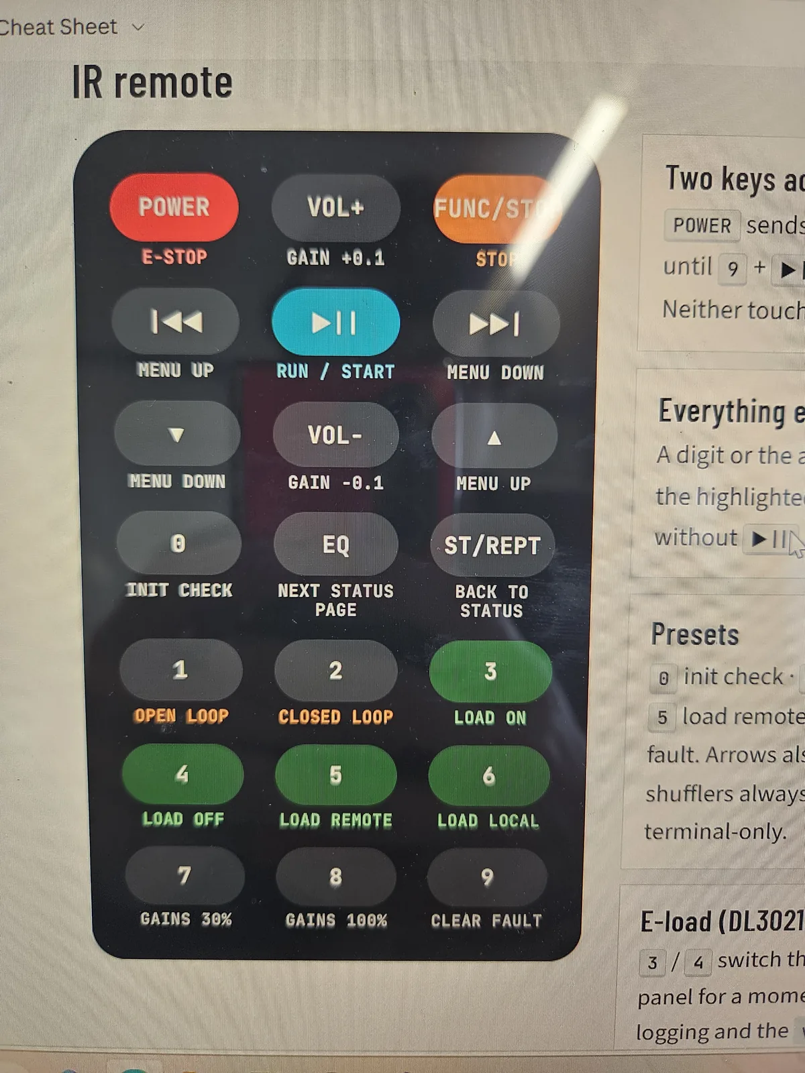
site/src/assets/photos/20261016_125222.webp
