saunders-jared-final/Boost-Brigade/site/src/assets/photos/20261020_112310.thumb.webp

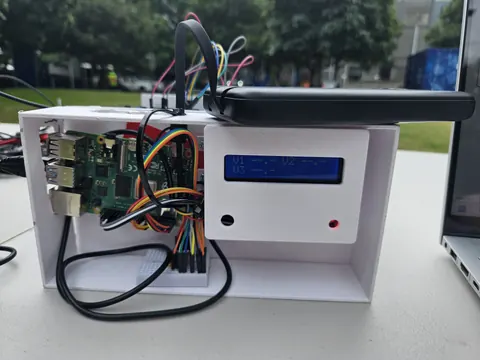
site/src/assets/photos/20261020_112310.thumb.webp
