saunders-jared-final/Boost-Brigade/site/src/assets/photos/20261020_112740.thumb.webp

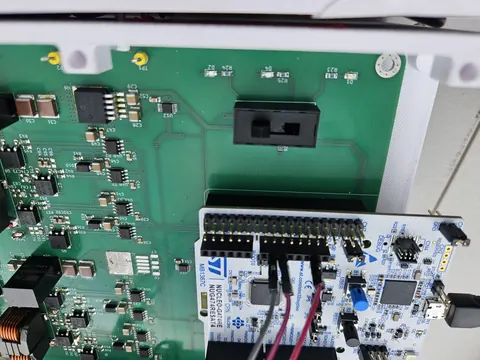
site/src/assets/photos/20261020_112740.thumb.webp
