saunders-jared-final/Boost-Brigade/site/src/assets/photos/Messenger_creation_4AD0D691-2915-4927-BB30-509DAD62F0C9.webp

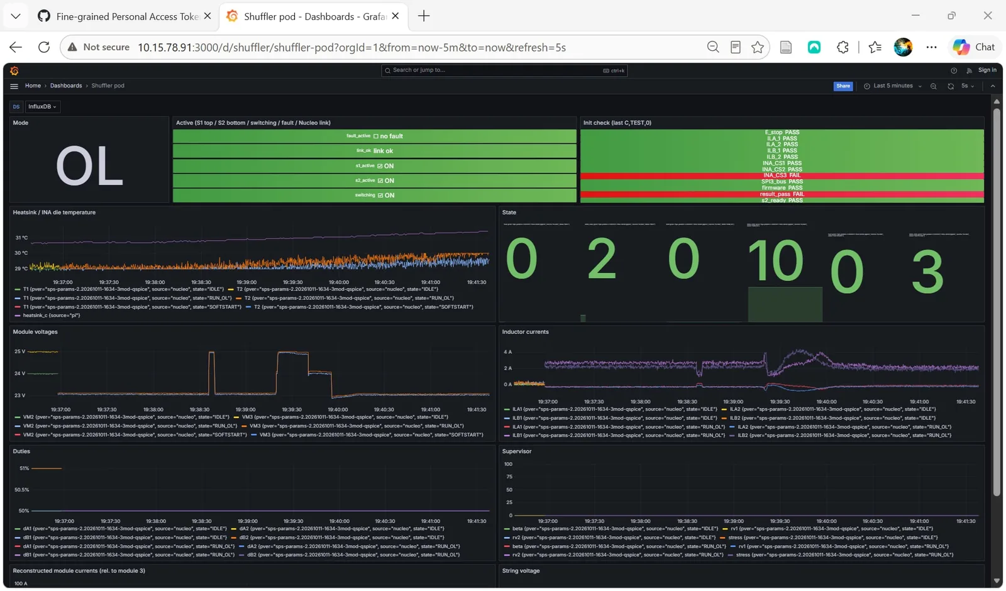
site/src/assets/photos/Messenger_creation_4AD0D691-2915-4927-BB30-509DAD62F0C9.webp
