saunders-jared-final/Boost-Brigade/site/src/assets/photos/Messenger_creation_AABF73CC-091C-4A54-AA4E-0A7EC8B049C2.thumb.webp

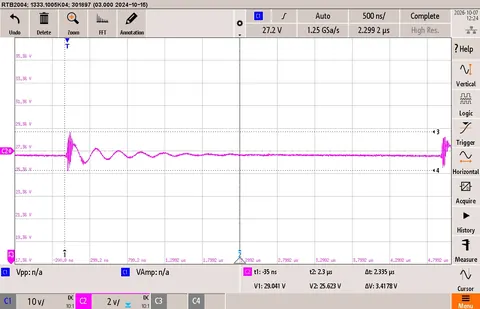
site/src/assets/photos/Messenger_creation_AABF73CC-091C-4A54-AA4E-0A7EC8B049C2.thumb.webp
