saunders-jared-final/Boost-Brigade/site/src/assets/photos/Messenger_creation_D0BE7909-4AAF-4066-ABF2-7FD998D3F3A4.webp

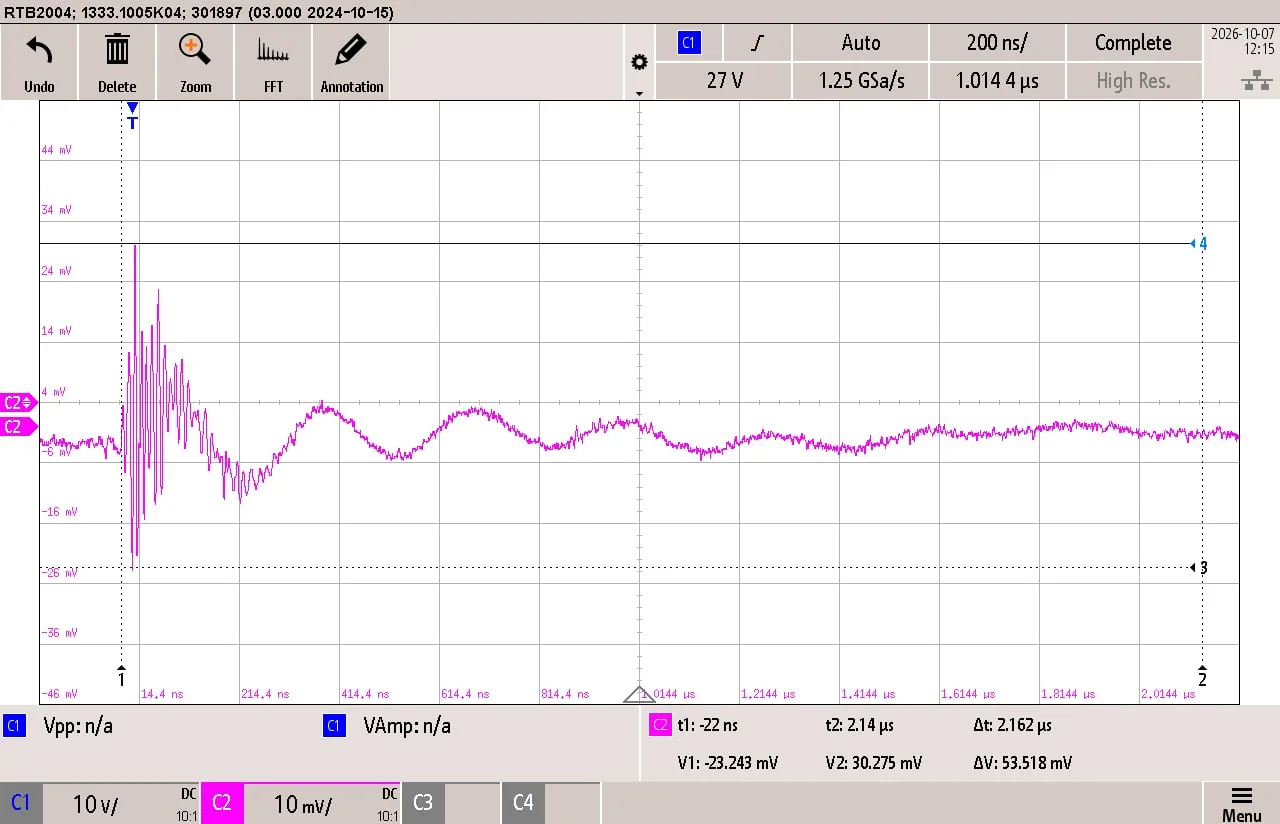
site/src/assets/photos/Messenger_creation_D0BE7909-4AAF-4066-ABF2-7FD998D3F3A4.webp
