saunders-jared-final/Boost-Brigade/site/src/assets/photos/Messenger_creation_D0470A96-9EC2-40B9-8C70-AC41F32E46B5.thumb.webp

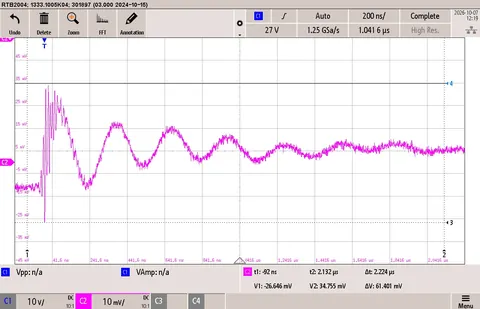
site/src/assets/photos/Messenger_creation_D0470A96-9EC2-40B9-8C70-AC41F32E46B5.thumb.webp
