saunders-jared-final/Boost-Brigade/site/src/assets/photos/Messenger_creation_E57D8A44-8ED7-41D2-9FEA-5F6A45D5EF64.webp

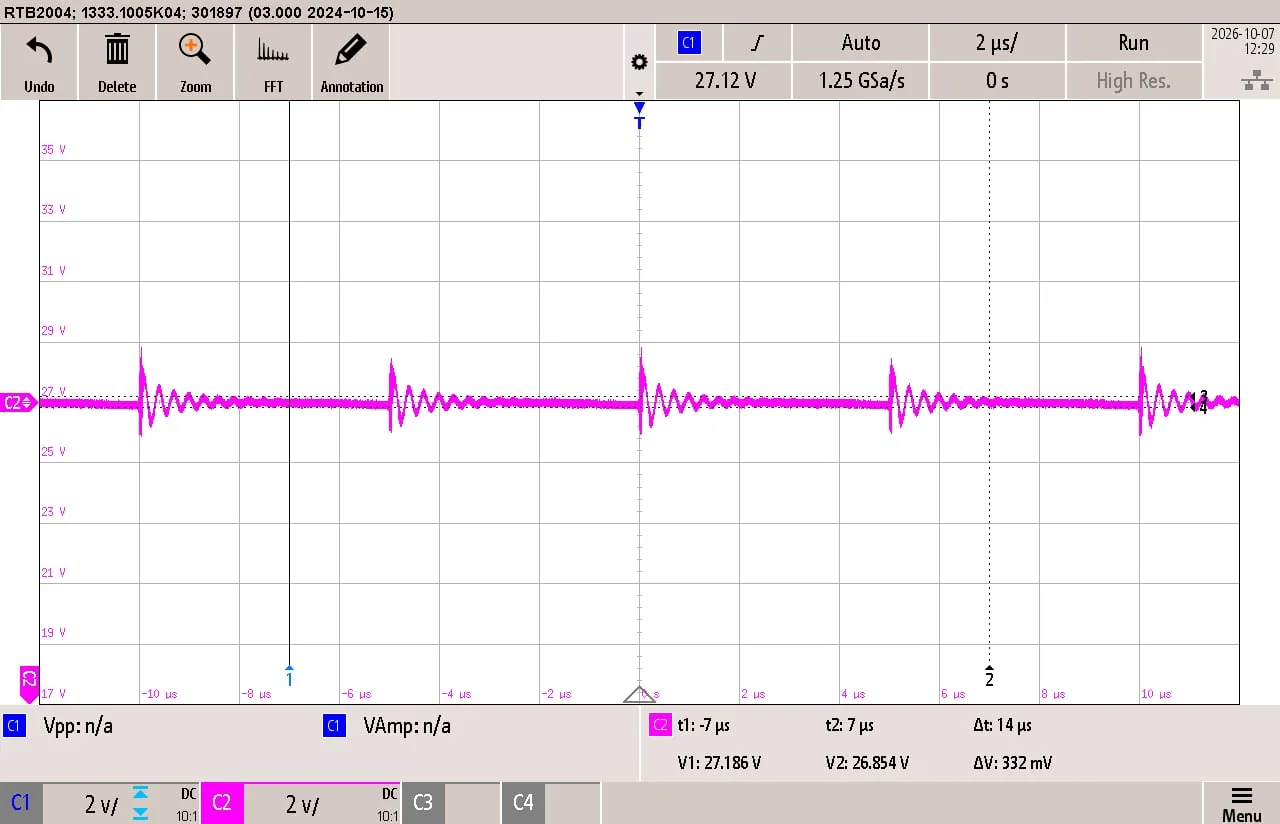
site/src/assets/photos/Messenger_creation_E57D8A44-8ED7-41D2-9FEA-5F6A45D5EF64.webp
