saunders-jared-final/Boost-Brigade/site/src/assets/photos/Messenger_creation_F1DB8183-4B71-4DFC-B329-E3414997BF35.thumb.webp

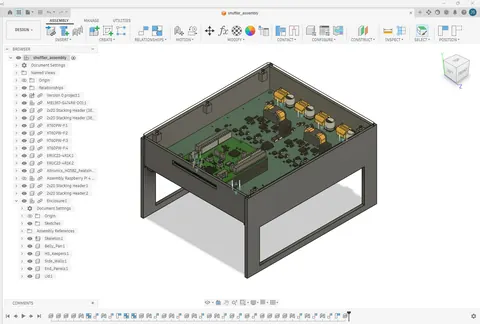
site/src/assets/photos/Messenger_creation_F1DB8183-4B71-4DFC-B329-E3414997BF35.thumb.webp
