saunders-jared-final/Boost-Brigade/5_Kicad/BOM.xlsx

PCB Component Reference Labels | Part Number | Description | Quantity | Unit Cost (AUD) | Gross Cost (AUD) | Shopping Cart | URLs
U14,U15 | 173951275 | For optimal performance the module is recommended for use with an external input capacitor and output capacitor, reducing design effort and complexity to a minimum. | 3 | 7.5 | 22.5 | 1 | 173951275 Würth Elektronik | DC DC Converters | DigiKey (https://www.digikey.com.au/en/products/detail/w%C3%BCrth-elektronik/173951275/21719396)
R24 | 100R | 100R Resistor | 1 | 0.15 | 0.15 | 1 | RK73H2ATTD1000F KOA Speer Electronics, Inc. | Chip Resistor - Surface Mount | DigiKey (https://www.digikey.com.au/en/products/detail/koa-speer-electronics-inc/RK73H2ATTD1000F/10234036)
C6,C7,C9,C10,C12,C13,C27,C28,C29,C32,C33,C35,C36,C57,C58,C59, C19,C20,C25,C26,C42,C43,C48,C49 | 12105C106KAT2A | 10uF Unpolarized capacitor, small symbol | 25 | 1.042 | 26.05 | 1 | 12105C106KAT2A KYOCERA AVX | Ceramic Capacitors | DigiKey (https://www.digikey.com.au/en/products/detail/kyocera-avx/12105C106KAT2A/6006191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)
U4A_B1,U4A_B2,U4A_T1,U4A_T2,U4B_B1,U4B_B2,U4B_T1,U4B_T2 | 1ED3140MU12F | Single Channel Isolated Gate Driver IC with Separate Output | 8 | 2.43 | 19.44 | 1 | 1ED3140MU12FXUMA1 Infineon Technologies | Isolators - Gate Drivers | DigiKey (https://www.digikey.com.au/en/products/detail/infineon-technologies/1ED3140MU12FXUMA1/17399462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)
R23,R25 | 680R | 680R Resistor | 4 |  | 0 | 1 | RK73H2ATTD6800F KOA Speer Electronics, Inc. | Chip Resistor - Surface Mount | DigiKey (https://www.digikey.com.au/en/products/detail/koa-speer-electronics-inc/RK73H2ATTD6800F/10234059)
C1,C2,C3, C4 | B40910A0137M000 | 130u Unpolarized capacitor | 4 | 5.07 | 20.28 | 0 | B40910A0137M000 TDK | Aluminum - Polymer Capacitors | DigiKey (https://www.digikey.com.au/en/products/detail/tdk/B40910A0137M000/26860650)
C30,C31,C55,C56 | C5750X7S2A106K230KB | Larger 10uF cap for Isolated Supply IC | 6 | 3.47 | 20.82 | 1 | C5750X7S2A106K230KB TDK | Ceramic Capacitors | DigiKey (https://www.digikey.com.au/en/products/detail/tdk/C5750X7S2A106K230KB/3950644)
R8,R10,R26,R31,R33 | ERA-6AEB102V | 1k Resistor | 8 | 0.15 | 1.2 | 1 | ERA-6AEB102V Panasonic Industry | Chip Resistor - Surface Mount | DigiKey (https://www.digikey.com.au/en/products/detail/panasonic-industry/ERA-6AEB102V/1465748)
R9,R11,R32,R34 | ERA-6AEB152V | 1.5k Resistor | 6 | 0.15 | 0.9 | 1 | ERA-6AEB152V Panasonic Industry | Chip Resistor - Surface Mount | DigiKey (https://www.digikey.com.au/en/products/detail/panasonic-industry/ERA-6AEB152V/1465753)
L1,L2 | ERUC23-4R1K | Coupled inductor | 2 | 14.73 | 29.46 | 0 | ERUC23-4R1K TDK | Arrays, Signal Transformers | DigiKey (https://www.digikey.com.au/en/products/detail/tdk/ERUC23-4R1K/21183308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)
U10,U11,U12 | INA239 | IC PWR MONITOR 10VSSOP | 5 | 7.32 | 36.6 | 1 | INA239AQDGSRQ1 Texas Instruments | Power Supply Controllers, Monitors | DigiKey (https://www.digikey.com.au/en/products/detail/texas-instruments/INA239AQDGSRQ1/14641456)
U13 | ISO7762QDBQRQ1 | Default high, High-speed, robust EMC, reinforced, six-channel, digital, isolator, SSOP-16 | 2 | 5.81 | 11.62 | 1 | ISO7762QDBQRQ1 Texas Instruments | Digital Isolators | DigiKey (https://www.digikey.com.au/en/products/detail/texas-instruments/ISO7762QDBQRQ1/10434813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)
C11,C14,C34,C37,C61,C62,C63,C64,C65,C66,C67,C68,C69,C70,C71,C72,C73,C74,C75,C76,C77,C78,C79,C80,C81,C82,C83,C84, C15,C16,C17,C18,C21,C22,C38,C39,C40,C41,C44,C45,C50,C51,C52,C53,C54, C23,C24,C46,C47 | KGM21NR71H104KM | 100nF capacitor | 50 | 0.387 | 19.35 | 1 | https://www.digikey.com.au/en/products/detail/kyocera-avx/kgm21nr71h104km/6816312
SW1 | L101011MS02Q |  | 2 | 6.13 | 12.26 | 0 | L101011MS02Q C&K | Slide Switches | DigiKey (https://www.digikey.com.au/en/products/detail/c-k/L101011MS02Q/484142?s=N4IgTCBcDaIDIEYAMyEILIGUlgIogF0BfIA)
S2 | L203011MS02Q | Slide Switch DP3T Through Hole, Voltage Rating - DC 28 V, 4A, -30C ~ 65C | 2 | 11.07 | 22.14 | 1 | L203011MS02Q C&K | Slide Switches | DigiKey Marketplace (https://www.digikey.com.au/en/products/detail/c-k/L203011MS02Q/308392)
D1 | LSM0805412V | Red Light emitting diode | 2 | 0.54 | 1.08 | 1 | LSM0805412V Visual Communications Company - VCC | LED Indication - Discrete | DigiKey (https://www.digikey.com.au/en/products/detail/visual-communications-company-vcc/LSM0805412V/10229616)
D4 | LSM0805452V | Green Light emitting diode | 2 | 0.41 | 0.82 | 1 | LSM0805452V Visual Communications Company - VCC | LED Indication - Discrete | DigiKey (https://www.digikey.com.au/en/products/detail/visual-communications-company-vcc/LSM0805452V/10229612)
D2 | LSM0805463V | Blue Light emitting diode | 2 | 0.66 | 1.32 | 1 | LSM0805463V Visual Communications Company - VCC | LED Indication - Discrete | DigiKey (https://www.digikey.com.au/en/products/detail/visual-communications-company-vcc/LSM0805463V/10229614)
U1 | NUCLEO-G474RE | STM32G474 Nucleo-64 STM32G4 ARMÂ® CortexÂ®-M4 MCU 32-Bit Embedded Evaluation Board | 1 | 29.31 | 29.31 | 0 | NUCLEO-G474RE STMicroelectronics | Embedded MCU, DSP Evaluation Boards | DigiKey (https://www.digikey.com.au/en/products/detail/stmicroelectronics/NUCLEO-G474RE/10231585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)
XT60_1, XT60_2, XT60_3, XT60_4 | PV Connector 1 - 4 | Generic connector, single row, 01x02, script generated (kicad-library-utils/schlib/autogen/connector/) | 4 |  | 27.65 | 1 | 5 Pairs Amass XT60 XT60PW Male Female Plug Connector Adapter for RC Battery : Amazon.com.au: Toys & Games (https://www.amazon.com.au/XT60PW-Female-Connector-Adapter-Battery/dp/B07VRLQ2C5)
R15,R16,R21,R22,R38,R39,R40,R44,R45,R46,R47,R48,R49,R50,R51,R52 | SG73P2ATTD4R70F | 4R7 Resistor | 18 | 0.25 | 4.5 | 1 | SG73P2ATTD4R70F KOA Speer Electronics, Inc. | Chip Resistor - Surface Mount | DigiKey (https://www.digikey.com.au/en/products/detail/koa-speer-electronics-inc/SG73P2ATTD4R70F/10188402)
R12,R13,R14,R18,R19,R20,R35,R36,R37,R41,R42,R43 | SG73S2ATTD10R0F | 10R Resistor | 14 | 0.25 | 3.5 | 1 | SG73S2ATTD10R0F KOA Speer Electronics, Inc. | Chip Resistor - Surface Mount | DigiKey (https://www.digikey.com.au/en/products/detail/koa-speer-electronics-inc/SG73S2ATTD10R0F/10279880)
Q1,Q2,Q3,Q4,Q5,Q6,Q7,Q8 | STD45N10F7 | N-MOSFET transistor, gate/drain/source | 12 | 3.12 | 37.44 | 1 | STD45N10F7 STMicroelectronics | Single FETs, MOSFETs | DigiKey (https://www.digikey.com.au/en/products/detail/stmicroelectronics/STD45N10F7/4756121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)
TP1,TP2,TP3,TP4,TP11,TP12,TP13,TP14 | TestPoint | test point tht | 16 |  | 0 | 1 | 5014 Keystone Electronics | Test Points | DigiKey (https://www.digikey.com/en/products/detail/keystone-electronics/5014/255336)
TP5,TP6,TP7,TP8,TP9,TP10 | TestPoint | test point smd | 10 |  | 0 | 1 | 5019 Keystone Electronics | Test Points | DigiKey (https://www.digikey.com.au/en/products/detail/keystone-electronics/5019/3907343)
U4, U5, U8, U9 | TMCS1126B4AQDVGRQ1 | CURRENT SEN HALL EFFECT 10-SOIC | 6 | 7.35 | 44.1 | 1 | TMCS1126B4AQDVGRQ1 Texas Instruments | Current Sensors | DigiKey (https://www.digikey.com.au/en/products/detail/texas-instruments/TMCS1126B4AQDVGRQ1/23331407)
U2,U6, U5,U9 | TPS7A4533KTTR | Low-Noise Fast-Transient-Response 1.5A LDO Regulator, Fixed Output, Vin = 20V max, eN = 35 Î¼Vrms, TO-263-5 (D2PAK) | 4 | 3.76 | 15.04 | 1 | TPS7A4533KTTR Texas Instruments | Voltage Regulators - Linear, Low Drop Out (LDO) Regulators | DigiKey (https://www.digikey.com.au/en/products/detail/texas-instruments/TPS7A4533KTTR/1951115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)
D3,D5,D8,D10 | VSSA210-E3/61T | 100V, Schottky Bootstrapping diode (SMA) | 6 | 0.95 | 5.7 | 1 | VSSA210-E3/61T Vishay General Semiconductor - Diodes Division | Single Diodes | DigiKey (https://www.digikey.com.au/en/products/detail/vishay-general-semiconductor-diodes-division/VSSA210-E3-61T/4806674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)
 | 28 |  |  |  |  | 1
 |  | Total | 225 |  | 413.23 | 321.92
 |  |  |  |  |  | 91.31
