saunders-jared-final/Boost-Brigade/1_Datasheets/LM5180 TI Calculator.xlsx

Sheet: LM(2)518x PSR flyback converter
LM5180/1 and LM25180/3/4 PSR Flyback Design Tool
About | xx (http://www.ti.com/widevin) |  |  | = Input Box |  |  |  |  |  | Terms Of Use
Step 1: Operating Specifications |  |  |  |  |  | Step 2: Flyback Transformer
 |  | Input Voltage – Min, VIN(min) | 4.5 | V |  |  | Minimum Magnetizing Inductance | 15.5 | µH
 |  | Input Voltage – Nom, VIN(nom) | 30 | V |  |  | Magnetizing Inductance, LMAG | 30 | µH
 |  | Input Voltage – Max, VIN(max) | 45 | V |  |  | Primary Winding DCR | 168 | mΩ
 |  | Single Output or Dual Outputs |  |  |  |  | Secondary Winding DCR | 168 | mΩ
 |  | Output Voltage, VOUT | 10 | V |  |  |  | 50
 |  | Rated Output Current, IOUT | 0.5 | A |  |  | Pri-Sec Leakage Inductance | 290 | nH
 |  |  | 3 |  |  |  | Transformer Turns Ratio, Pri : Sec
 |  |  | 1 |  |  |  | SW Voltage at VIN(max) - Spike Not Included | 55 | V
 |  |  |  |  |  |  | Max Output Current at VIN(min) | 0.21 | A
Step 3: Input & Output Capacitors |  |  |  |  |  |  | Duty Cycle at VIN(min) | 69.8 | %
 |  | Minimum Input Capacitance | 2.2 | µF |  |  | Primary Winding DCR Loss at Vin(nom) | 36.481901 | mW
 |  | Input Capacitance, CIN | 10 | µF |  |  |  | 22.37904887 | mW
 |  | Input Capacitor ESR | 2 | mΩ |  |  | Peak Primary Current at Vin(nom) | 1.45 | A
 |  | Resulting Input Voltage Ripple | 78.26811067 | mVpk-pk |  |  | Peak Secondary Current at Vin(nom) | 1.45 | A
 |  | Minimum Output Capacitance | 24.27995767 | µF |  |  |  | 49.1 | µF
 |  | Output Capacitance, COUT | 100 | µF |  |  | Output Capacitance, COUT2 | 22 | µF
 |  | Output Capacitor ESR | 3 | mΩ |  |  | Output Capacitor ESR | 2 | mΩ
 |  | Resulting Output Voltage Ripple | 12.18504 | mVpk-pk |  |  |  | 69.0207033 | mVpk-pk
Step 4: Feedback, Soft-start, TC, UVLO
 |  | Recommended Feedback Resistor | 103.2 | kΩ
 |  | Selected Feedback Resistor, RFB | 196 | kΩ
 |  | Soft-Start Configuration
 |  | *Leave SS Pin Open or Supply by Ext. Bias | 9 | ms
 |  | Soft-Start Capacitance, CSS | 47 | nF
 |  | VOUT Thermal Compensation
 |  | Diode Voltage Drop Thermal Coefficient | -1.5 | mV/°C
 |  | Thermal Compensation Resistor, RTC | 392 | kΩ
 |  | Input UVLO Configuration
 |  | *Connect EN pin to VIN or Logic HIGH | 4.5 | V
 |  |  | 3.5 | V
 |  | Upper UVLO Resistor, RUV1 | 169 | kΩ
 |  | Lower UVLO Resistor, RUV2 | 84.5 | kΩ
Step 5: Power Losses & Thermals
 |  | Flyback Diode Voltage Drop, VD(no-load) | 0.32 | V
 |  | Flyback Diode Voltage Drop, VD(full-load) | 0.4 | V
 |  | Estimated IC Thermal Impedance, JJA | 41 | °C/W
 |  | Ambient Temperature, TA | 55 | °C
 |  | Power Dissipation at Full Load, PD | 149.5925191 | mW
 |  | Junction Temperature at Full Load, TJ | 61.13329328 | °C
Step 6: Optional RC Snubber across Rectifier Diode |  |  |  |  | (Always reserve the snubber positions on PCB, and validate by experiments.)
 |  | Recommended Csnb | 22 | pF
 |  | Snubber Capacitor Voltage Rating > | 82.5 | V
 |  | Recommended Rsnb | 100 | Ω
 |  | Snubber Resistor Power Dissipation Rating > | 0.210 | W
Step 7: Optional Output Zener Clamp or Dummy Load |  |  |  |  | (Always reserve the Zener clamp and dummy load position on PCB)
 |  | Min Load Current, IOUTmin | 0.005 | A |  |  |  | -0.005
 |  | Max Output Voltage Limit, VOUTmax | 12.00 | V |  |  |  | -17
 |  | Zener Clamp Dz or Dymmy Load Rdmy | None
 |  | Selection | None
 |  | Selected Device Min Power Rating> | N/A | W

Sheet: BOM & Schematic
SINGLE Output PSR Flyback Converter, VIN = 30 V, VOUT = 10 V, IOUT = 0.5 A
LM5180 High Efficiency PSR Flyback Converter BOM
Count | Ref Des | Value | Description | Size | Part Number | MFR | Footprint (mm) | Area (mm2)
1 | CIN | 10µF | Capacitor, Ceramic, 10µF, 100V, X7R, 10% |  | Std | Std | 3.2 x 2.5 | 8.0 |  |  |  | 5
1 | COUT | 100µF | Capacitor, Ceramic, 100µF, 16V, X7R, 10% |  | Std | Std | 3.2 x 2.5 | 8.0 |  |  |  | 5
- | COUT2 | - | - |  | - | - | - | - |  |  |  | 5
- | - | - | - | 0603 | - | - | - | - |  |  |  | 1
1 | DFLY | Diode | Rectifying Diode, Schottky | #NAME? | Std | Std | 5.0 x 3.3 | 16.5 |  |  |  | 5
- | DFLY2 | - | - | 0603 | - | - | - | - |  |  |  | 3
1 | DF | Diode | Clamp Circuit Diode, Fast Recovery |  | Std | Std | 5.0 x 2.5 | 12.5 |  |  |  | 4
1 | DCLAMP | 13V | Clamp Circuit Diode, Zener, 13V | 0603 | Std | Std | 5.0 x 2.5 | 12.5 |  |  |  | 4
1 | DOUT | 11V | Output Clamp Diode, Zener, 11.3V |  | Std | Std | 1.6 x 0.8 | 1.3 |  |  |  | 1
1 | RSET | 12.1k | Resistor, Chip,12.1kΩ, 1/16W, 1% | 0603 | Std | Std | 2.0 x 1.25 | 2.5 |  |  |  | 3
1 | RFB | 196k | Resistor, Chip,196kΩ, 1/16W, 1% | 0603 | Std | Std | 2.0 x 1.25 | 2.5 |  |  |  | 3
- | RUV1 | - | - | 0603 | - | - | - | - |  |  |  | 1
- | RUV2 | - | - | 0603 | - | - | - | - |  |  |  | 1
1 | RTC | 392k | Resistor, Chip, 392kΩ, 1/16W, 1% | 0603 | Std | Std | 2.0 x 1.25 | 2.5 |  |  |  | 3
1 | T1 | 30µH | Transformer, 30µH, 1 : 1, 168mΩ Pri DCR, 2A Isat | - | Various | Various | 10 x 10 | 100 |  |  |  | 5
1 | U1 | LM5180 | IC, LM5180, PSR Flyback Converter, 4.5V–65V Input | WSON-8 | LM5180NGUR | TI | 4.0 x 4.0 | 16.0
 |  |  |  |  | Total Solution Size (buffered by 25%) |  |  | 227.9 | mm2 = | 0.3532 | in2
NOTES:
1. Choose a transformer with saturation current rating higher than the max peak current limit setting (1.73A) for all operating temperatures
2. Appropriately derate the effective input and output capacitances for applied voltage and temperature, particularly with ceramics
3. Use a primary-side RC snubber from SW to VIN to dampen leakage inductance spike
4. Use a flyback diode RC snubber to dampen ringing if needed
5. Use an output zener to clamp the output at no load

Sheet: EVM Examples Layouts
LM5180/1 and LM25180/3/4 PSR Flyback Converter Design Tool
 | LM5180EVM-S05 PCB Design, 2" x 1.4" (50mm x 35mm) | LM5180EVM-DUAL PCB design, 2.1" x 1.5" (55mm x 38mm) | LM25184EVM-S12 PCB design, 2.2" x 1.4" (56mm x 36mm)
