saunders-jared-final/Boost-Brigade/0_Documentation/jared-assessment/CapstoneDelivery_latex/tables/T1_inventory.tex

% generated by tools/make_tables.py -- do not edit by hand
{\scriptsize
\begin{longtable}{l l l r l l l r r p{3.4cm}}
\caption[{Test-case inventory}]{Test-case inventory: the raw-data slide windows re-exported from the pod's InfluxDB (RUN\_OL / RUN\_CL rows only).}\label{tab:T1}\\
\toprule
Case & Slide & Setup & $f_{sw}$ [kHz] & Loop & $k$ & Window (AEST) & RUN [s] & Rate [Hz] & Note \\
\midrule\endfirsthead
\toprule
Case & Slide & Setup & $f_{sw}$ [kHz] & Loop & $k$ & Window (AEST) & RUN [s] & Rate [Hz] & Note \\
\midrule\endhead
\bottomrule\endfoot
B01 & p48 & BENCH & 200 & OL & -- & 14:32:00-14:44:56 & 706 & 40 & duties 0.5; e-load CV set-point steps 125 <$\rightarrow$ 60 V; VM1 from \\
B01s &  & BENCH & 200 & OL & -- & 15:09:00-15:16:00 & 412 & 40 & not on a slide: the only open-loop duty steps (15:11:42 S2 + \\
B02 & p42 & BENCH & 200 & CL & 0.1 & 15:31:34-15:34:25 & 161 & 11 & before the ADC fix; PSU unstable \\
B03 & p43 & BENCH & 200 & CL & 0.3 & 16:02:05-16:04:33 & 143 & 14 & slide says kscale 20 \%, telemetry says 0.3 with pset 0 (boot \\
B04 & p44 & BENCH & 200 & CL & 0.3/0.4 & 16:07:00-16:07:49 & 47 & 14 & kscale 0.4 applied at 16:07:50 $\rightarrow$ OC fault within 1 s \\
B05 & p49 & BENCH & 300 & OL & -- & 16:31:36-16:37:04 & 304 & 36 & nan \\
B06 & p45 & BENCH & 300 & CL & 0.3 & 17:17:00-17:25:49 & 512 & 44 & PSU / e-load set-point steps 17:22:30-17:25:30 while closed \\
B07 & p46 & BENCH & 300 & CL & 0.3/0.4/0.5/0.6 & 17:34:08-17:41:47 & 295 & 44 & nan \\
B08 & p50 & BENCH & 400 & OL & -- & 18:02:03-18:04:38 & 152 & 44 & PSU change at 18:03:40 \\
B09 & p47 & BENCH & 400 & CL & 0.3 & 18:05:11-18:13:40 & 392 & 44 & nan \\
S01 & p24 & PV80 & 200 & OL & -- & 15:04:35-15:07:47 & 187 & 44 & peak sun \\
S02 & p25 & PV80 & 200 & CL & 0.1 & 15:08:40-15:12:44 & 237 & 44 & peak sun; shade event about 15:09:20-15:10:40 \\
S03 & p26 & PV80 & 200 & OL & -- & 15:48:22-15:51:20 & 174 & 44 & minimal sun \\
S04 & p27 & PV80 & 200 & CL & 0.1 & 15:52:03-15:56:31 & 265 & 44 & minimal sun \\
S05 & p37 & PV80 & 200 & CL & 0.2 & 15:56:51-16:00:47 & 229 & 44 & minimal sun \\
S06 & p38 & PV80 & 200 & CL & 0.3 & 16:01:07-16:04:19 & 189 & 44 & minimal sun \\
S07 & p39 & PV80 & 200 & CL & 0.4 & 16:05:30-16:08:17 & 156 & 44 & minimal sun \\
S08 & p40 & PV80 & 200 & CL & 0.5 & 16:09:42-16:12:16 & 150 & 44 & minimal sun \\
S09 &  & PV80 & 200 & CL & 0.6 & 16:13:15-16:18:00 & 278 & 44 & not on a slide (closed\_loop\_timeslots.pdf) \\
S10 &  & PV80 & 200 & CL & 0.7 & 16:19:05-16:22:12 & 178 & 44 & not on a slide (closed\_loop\_timeslots.pdf) \\
S11 &  & PV80 & 200 & CL & 0.8 & 16:23:05-16:24:45 & 90 & 44 & not on a slide (closed\_loop\_timeslots.pdf) \\
\end{longtable}}
\noindent{\footnotesize B01s and S09--S11 are not on a slide. B03 ran at $k=0.3$ (telemetry), not the 20\,\% written on the slide.}
