saunders-jared-final/Boost-Brigade/Coupled Inductor/b82559sxm023_eruc23_14.0mm_max_public_tkd-pc.step

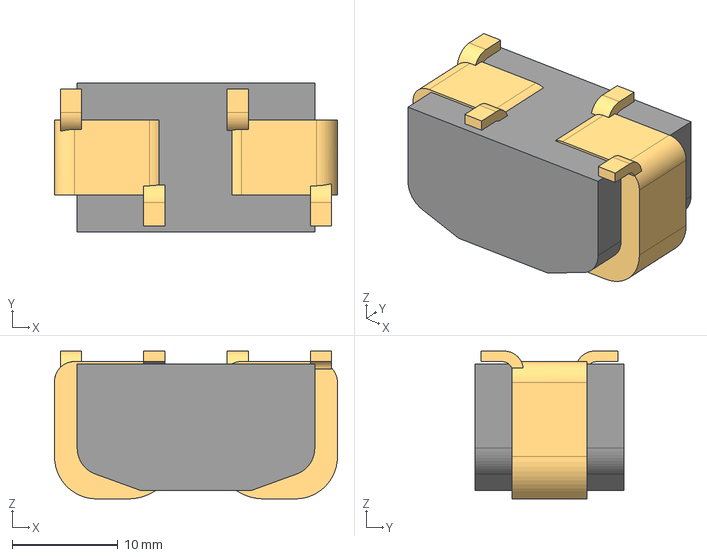
[picture p200: CAD file, 2026-10-11]
Coupled Inductor/b82559sxm023_eruc23_14.0mm_max_public_tkd-pc.step
26.8 x 14.1 x 14.0 mm
