saunders-jared-final/Boost-Brigade/(list of files, cad)

Other CAD files:
9_Mechanical_Enclosure_CAD/shuffler_assembly.step
9_Mechanical_Enclosure_CAD/shuffler_assembly.f3z
