saunders-jared-final/Boost-Brigade/0_Documentation/jared-assessment/CapstoneDelivery_latex/tables/T3_duty_steps.tex

% generated by tools/make_tables.py -- do not edit by hand
\begin{table}[htbp]\centering
\small
\caption[{Open-loop duty steps on the bench (B01s, 16 Oct, 200\,kHz)}]{Open-loop duty steps on the bench (B01s, 16 Oct, 200\,kHz): both legs of a shuffler were moved together, so $\Delta u_c = 2\Delta d$, and the averaged model predicts $\Delta v_d = -\bar V\Delta u_c$ with $\bar V = 46.6$\,V. Voltages in V.}\label{tab:T3duty}
\begin{tabular}{l l r r r r r r}
\toprule
Time & Leg duties changed & $\Delta u_{c1}$ & $\Delta u_{c2}$ & \makecell[r]{$\Delta v_{d1}$\\pred.} & \makecell[r]{$\Delta v_{d1}$\\meas.} & \makecell[r]{$\Delta v_{d2}$\\pred.} & \makecell[r]{$\Delta v_{d2}$\\meas.} \\
\midrule
15:11:42 & S2 0.49$\rightarrow$0.51 & 0.00 & +0.04 & 0.00 & -0.03 & -1.86 & -1.87 \\
15:13:00 & S1 0.50$\rightarrow$0.49, S2 0.51$\rightarrow$0.50 & -0.02 & -0.02 & +0.93 & +0.91 & +0.93 & +0.94 \\
15:15:15 & S1 0.49$\rightarrow$0.51 & +0.04 & 0.00 & -1.86 & -1.86 & 0.00 & 0.00 \\
\bottomrule
\end{tabular}
\end{table}
