saunders-jared-final/Boost-Brigade/8_Results/analysis/out/figures/compare/step_S1_BENCH_k0.4_id2.pdf

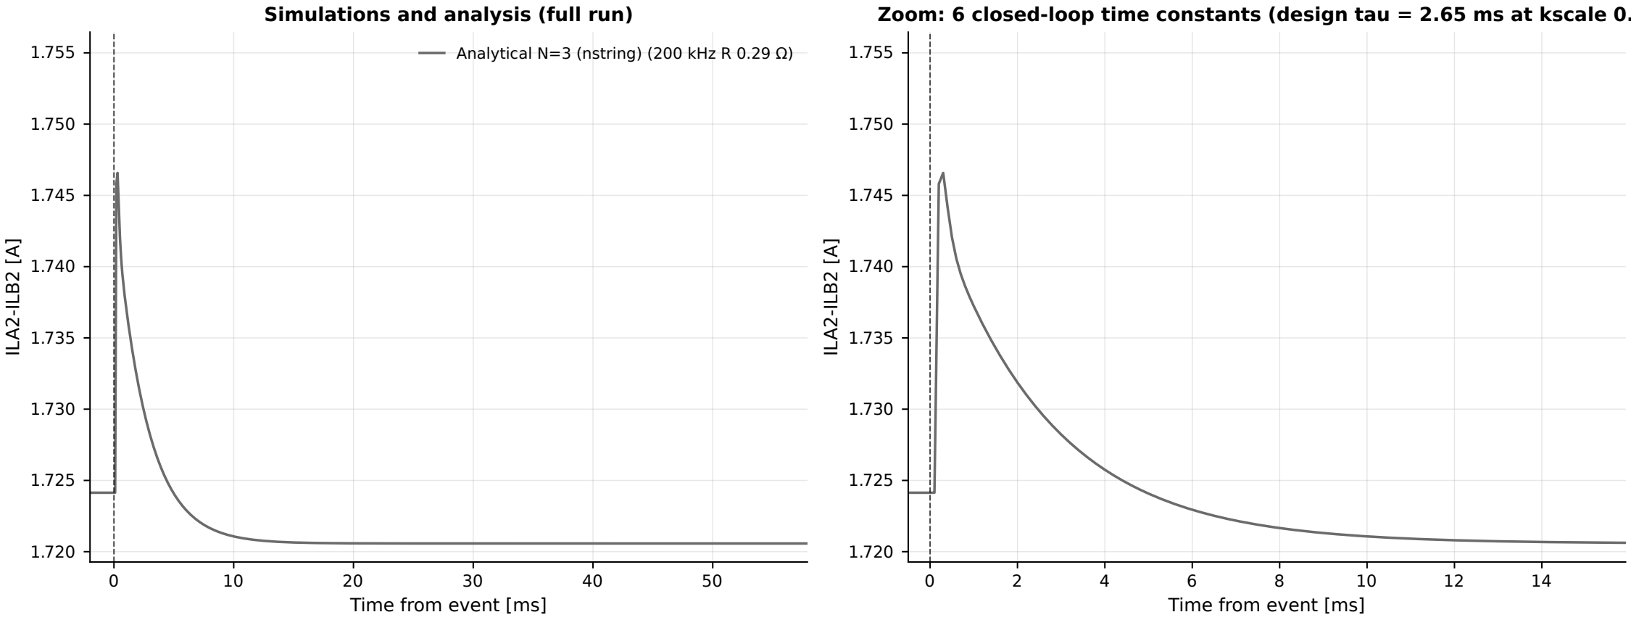
[picture p201: figure]
Time from event [ms]; ILA2-ILB2 [A]; Simulations and analysis (full run)

Analytical N=3 (nstring) (200 kHz R 0.29 Ω)

Zoom: 6 closed-loop time constants (design tau = 2.65 ms at kscale 0.4)

## S1 loop_close: ILA2-ILB2 [A] — BENCH, kscale 0.4
