saunders-jared-final/Boost-Brigade/site/src/assets/figures/analysis/B01s_e3_duty_step.webp

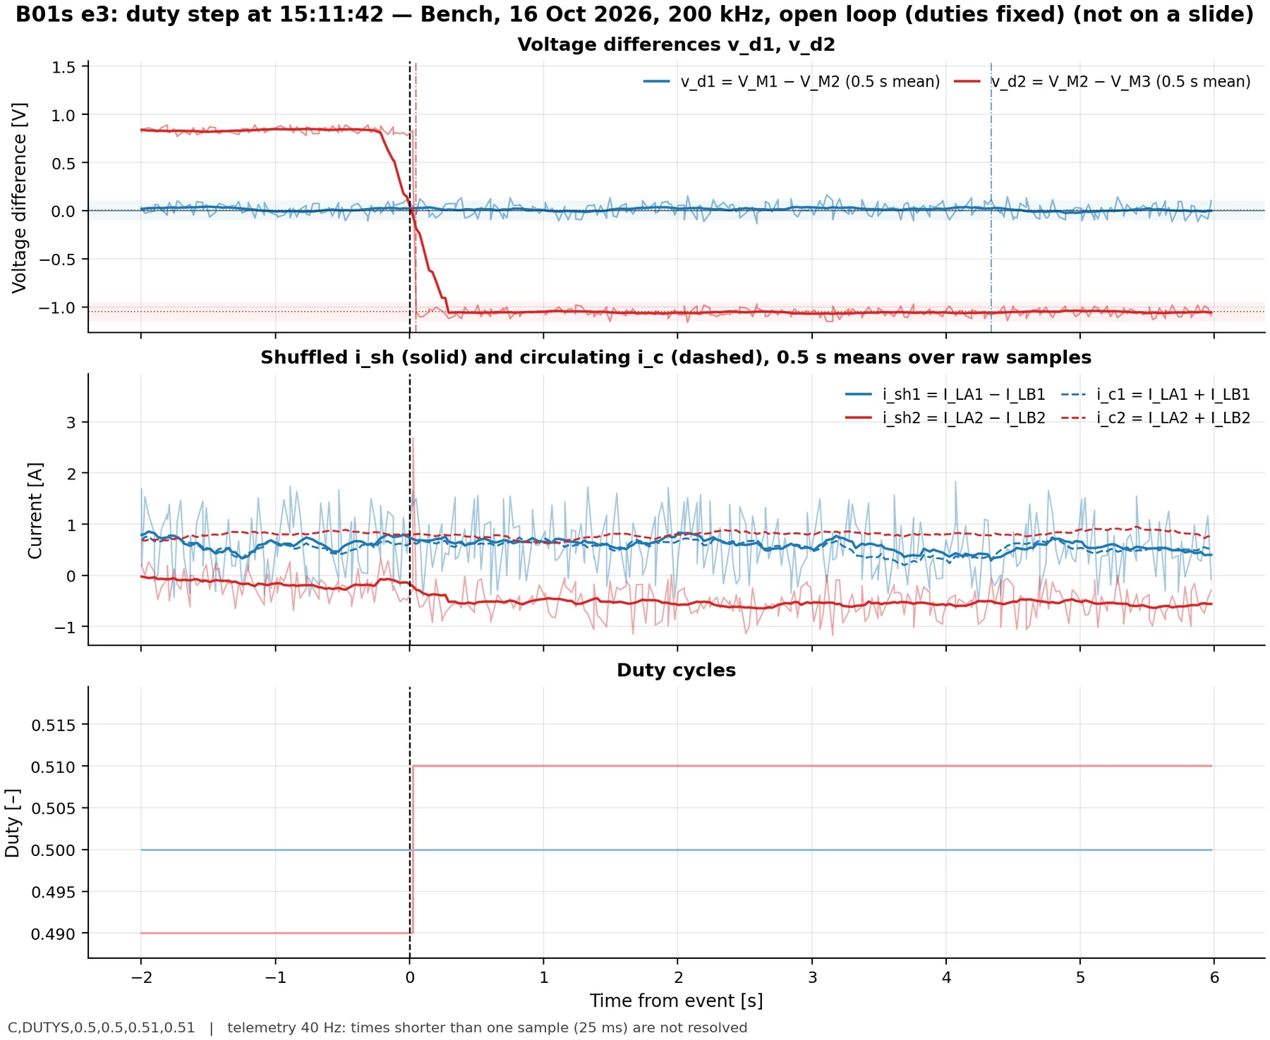
site/src/assets/figures/analysis/B01s_e3_duty_step.webp
