saunders-jared-final/Boost-Brigade/site/src/assets/figures/analysis/B01s_e5_duty_step.webp

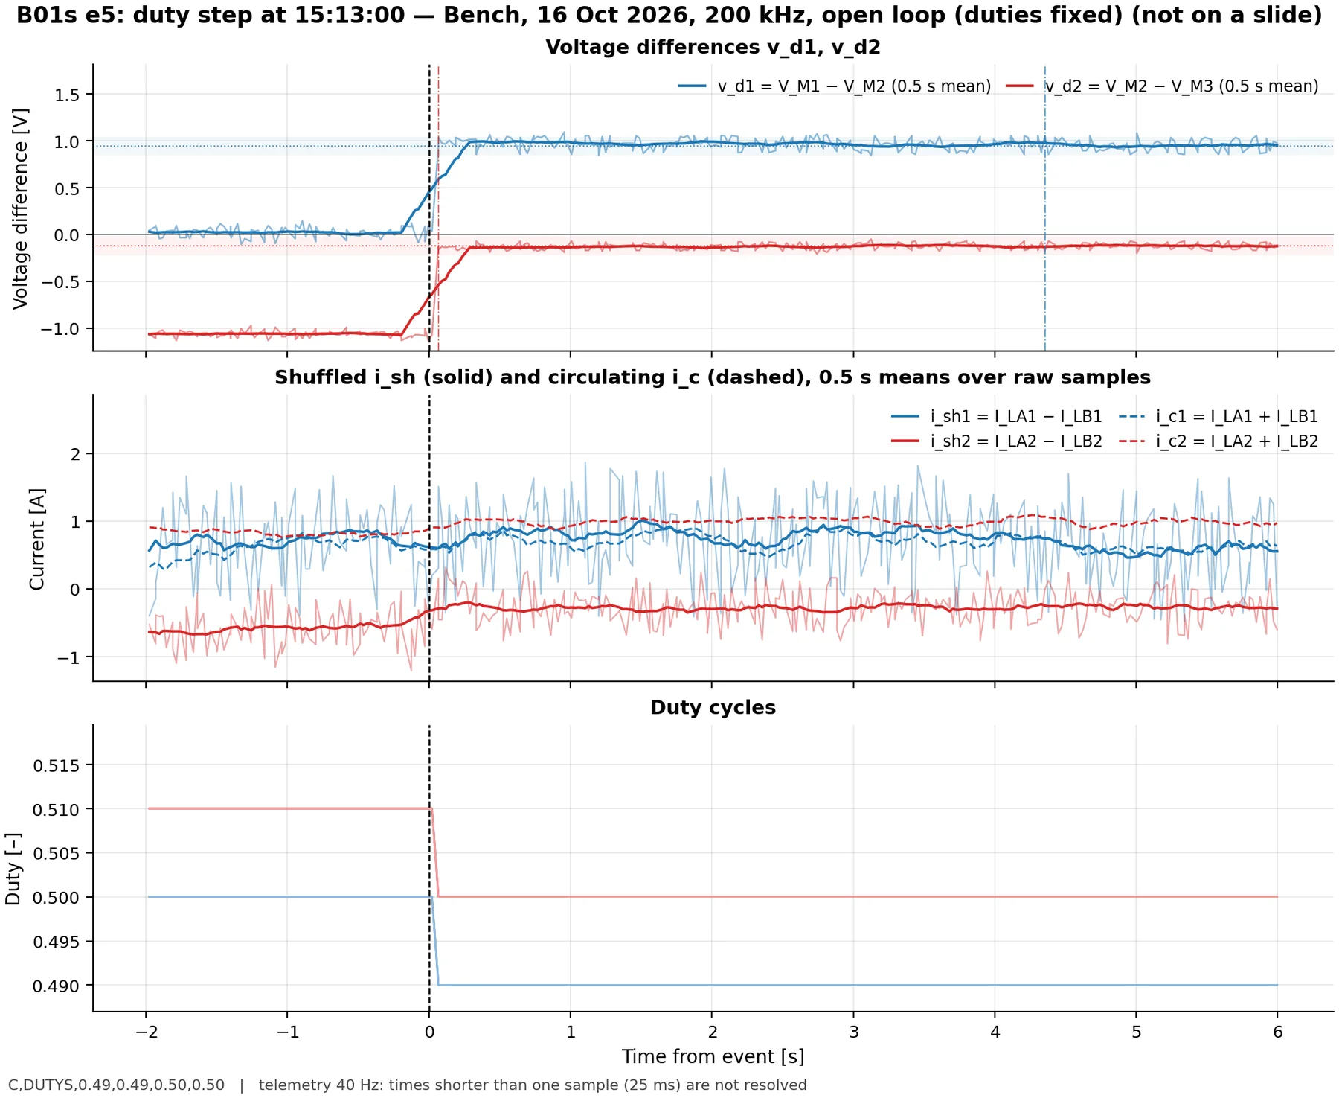
site/src/assets/figures/analysis/B01s_e5_duty_step.webp
