saunders-jared-final/Boost-Brigade/site/src/assets/figures/analysis/B01s_e7_load_step.webp

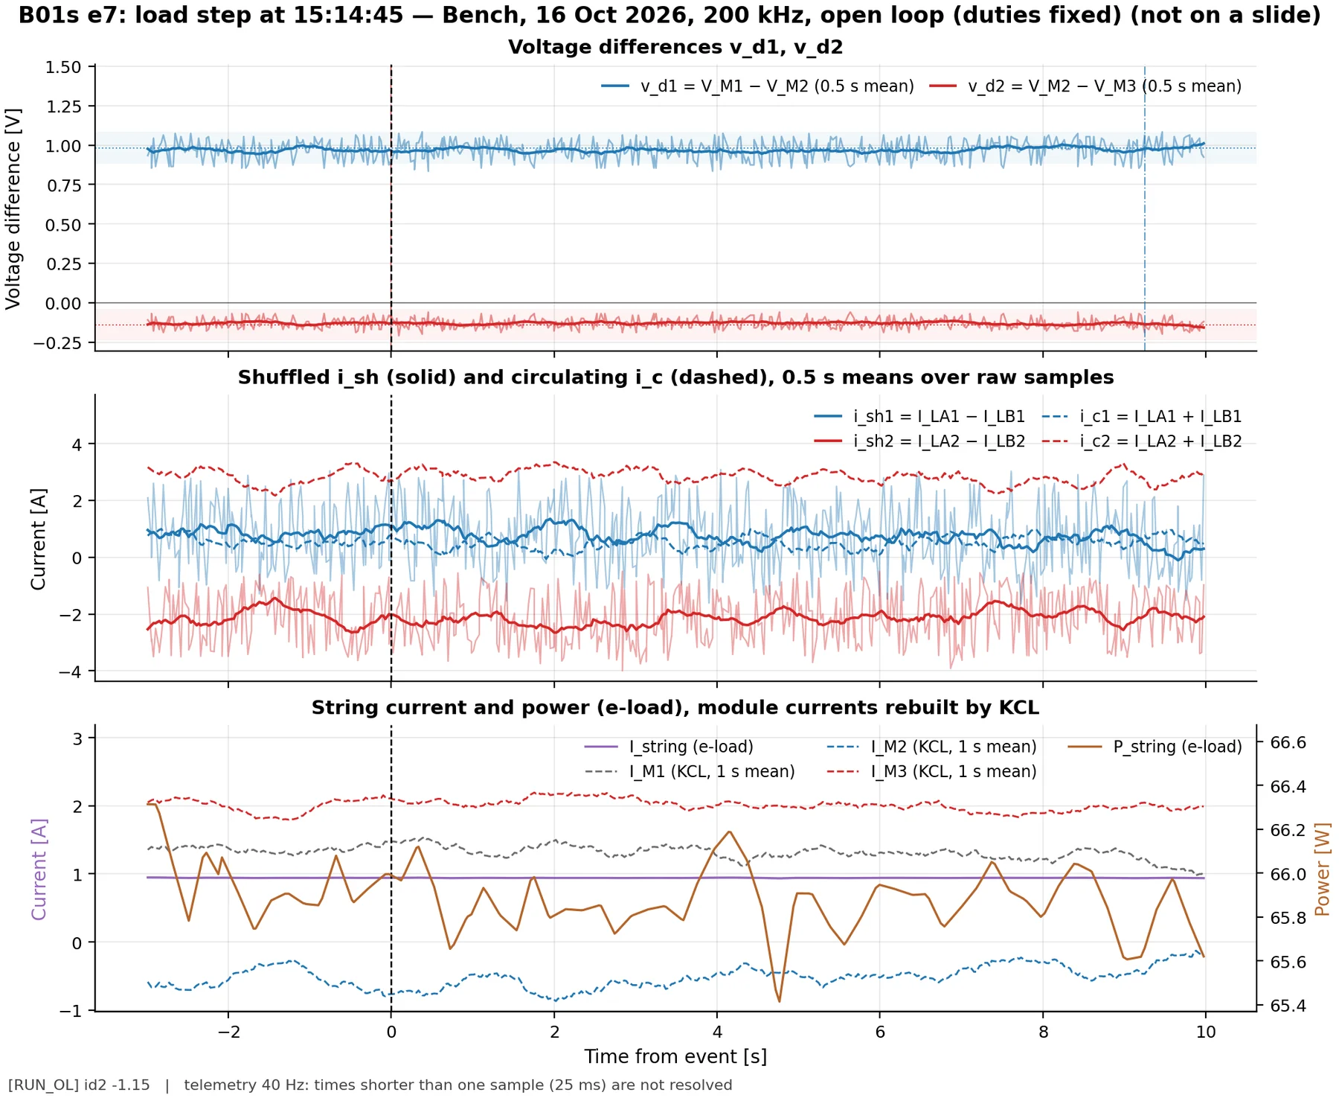
site/src/assets/figures/analysis/B01s_e7_load_step.webp
