saunders-jared-final/Boost-Brigade/site/src/assets/figures/analysis/B06_e2_load_step.webp

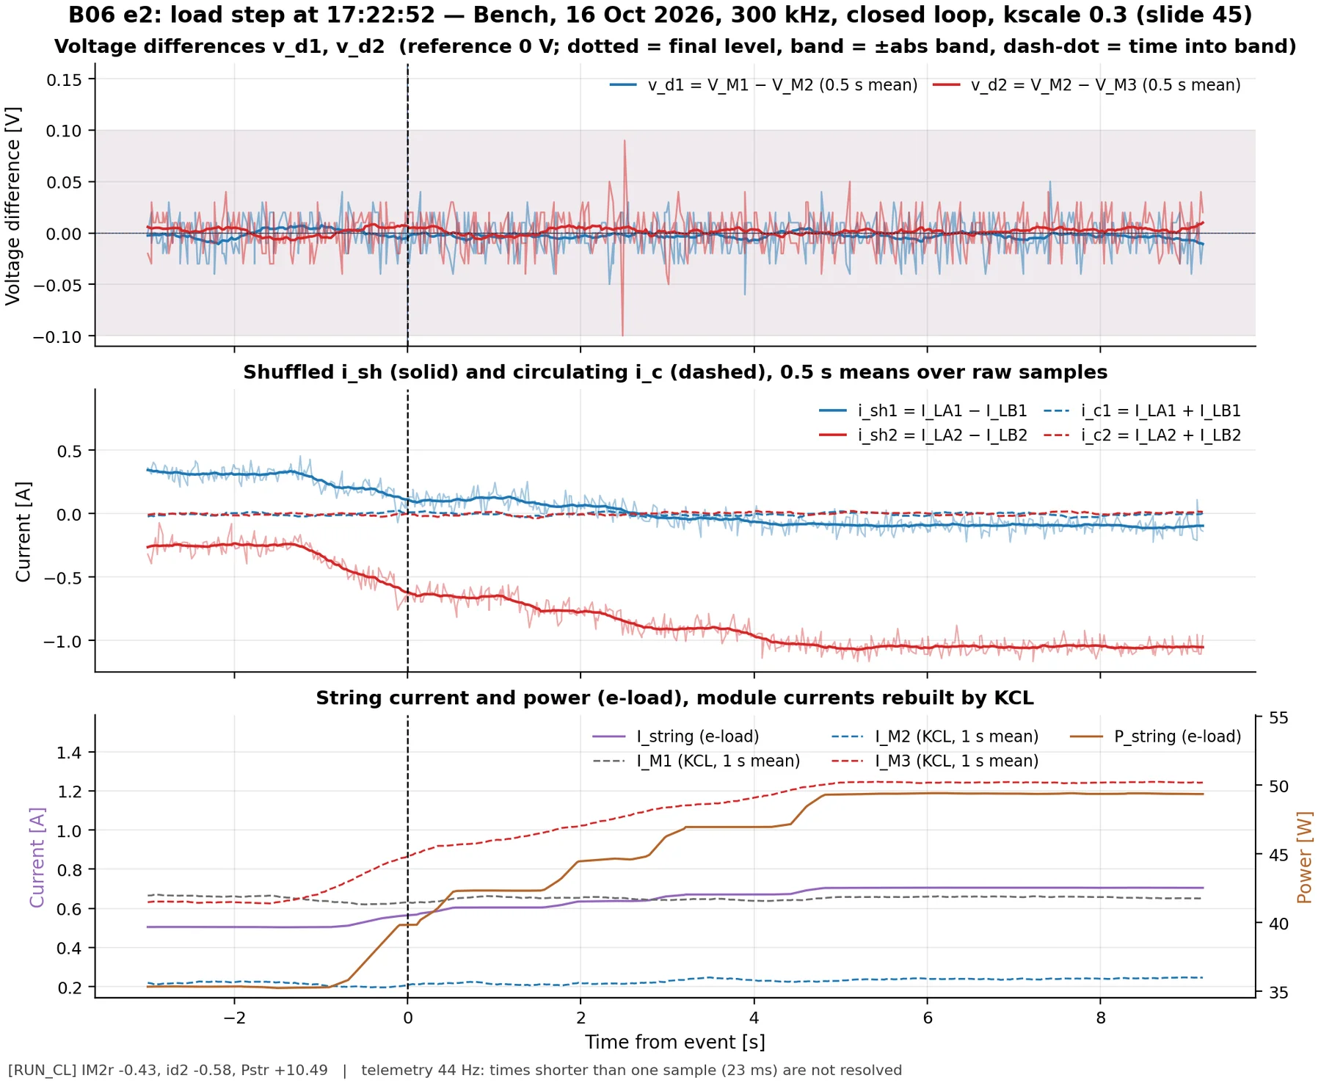
site/src/assets/figures/analysis/B06_e2_load_step.webp
