saunders-jared-final/Boost-Brigade/site/src/assets/figures/analysis/B06_e4_load_step.webp

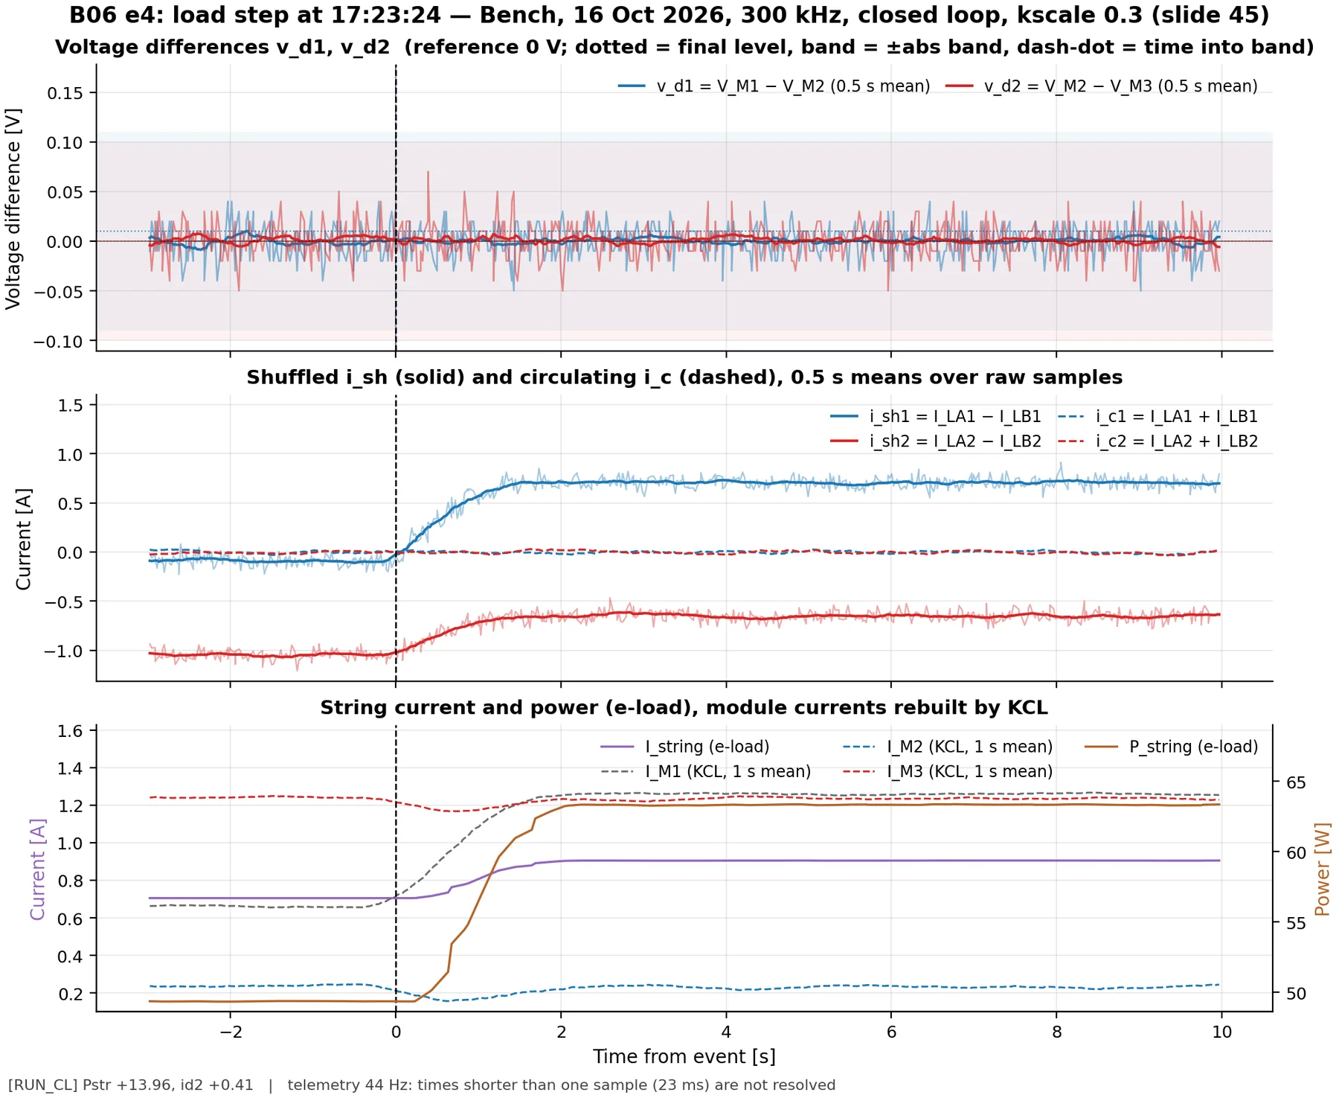
site/src/assets/figures/analysis/B06_e4_load_step.webp
