saunders-jared-final/Boost-Brigade/site/src/assets/figures/analysis/step_S1_BENCH_k0.1_id2.webp

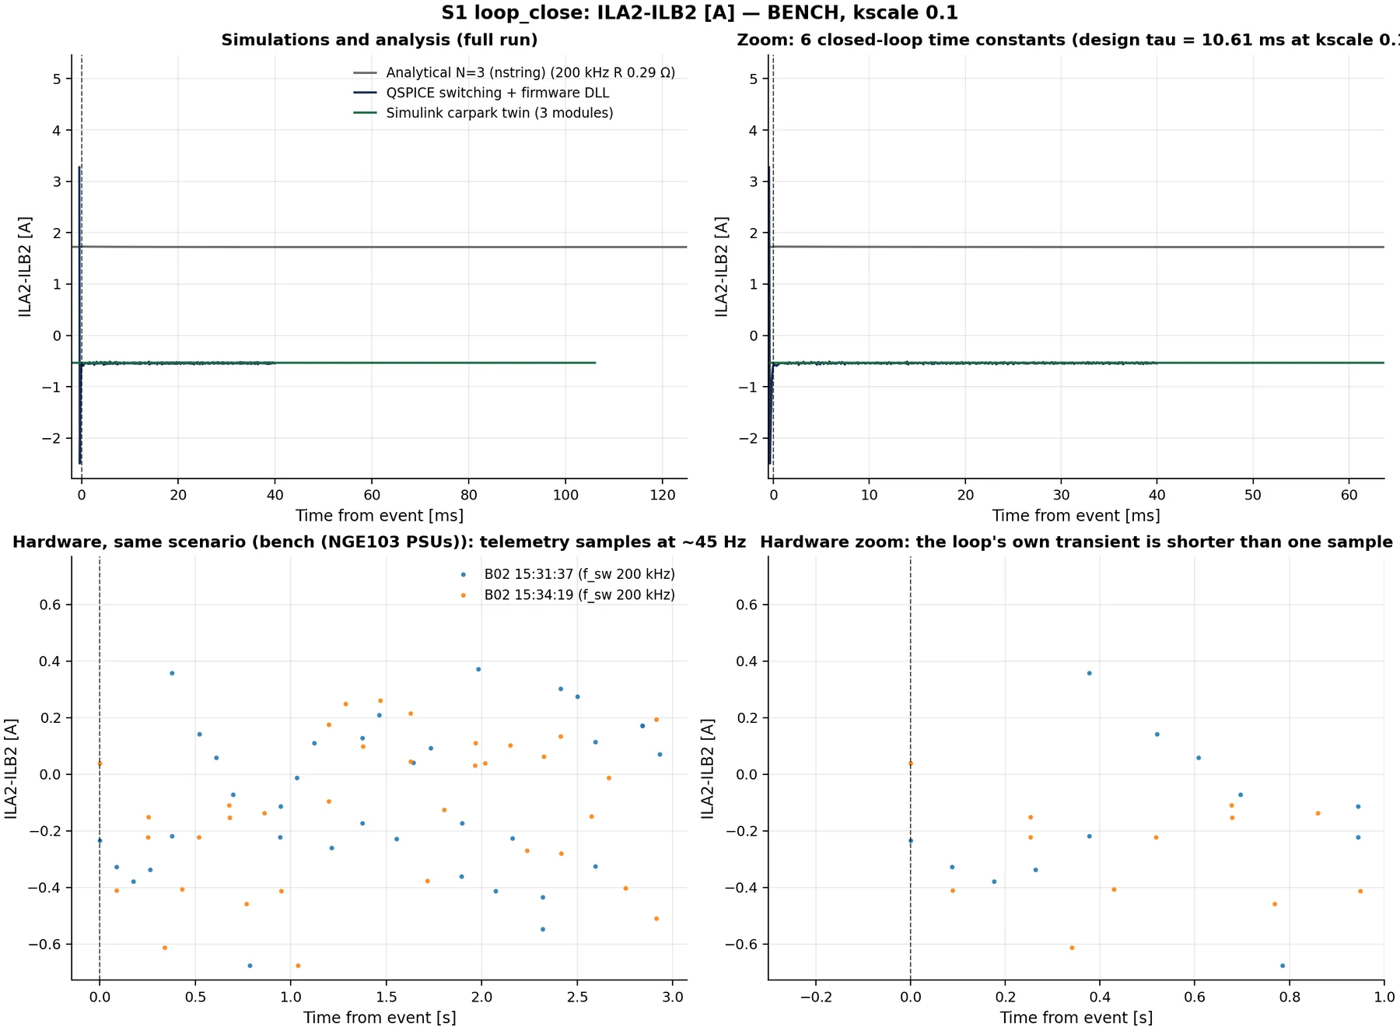
site/src/assets/figures/analysis/step_S1_BENCH_k0.1_id2.webp
