saunders-jared-final/Boost-Brigade/site/src/assets/figures/analysis/step_S1_BENCH_k0.2_vd2.webp

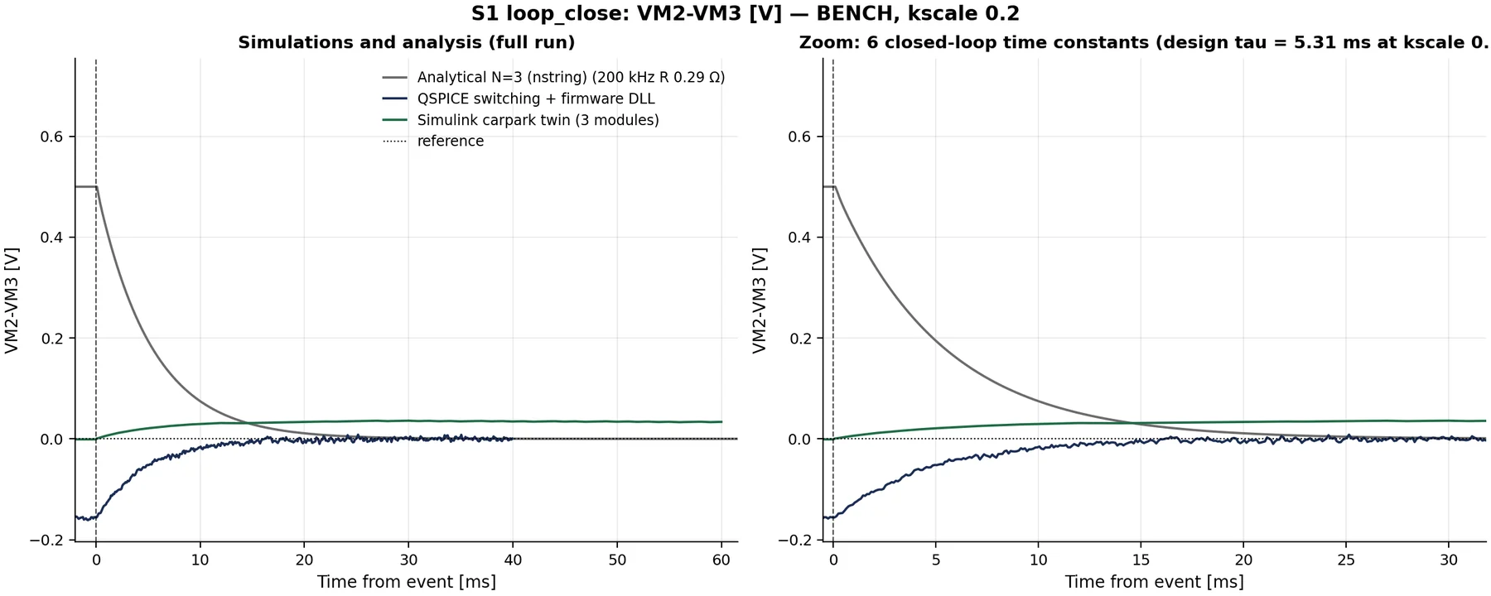
site/src/assets/figures/analysis/step_S1_BENCH_k0.2_vd2.webp
