saunders-jared-final/Boost-Brigade/site/src/assets/figures/analysis/step_S4_BENCH_k0.1_vd2.webp

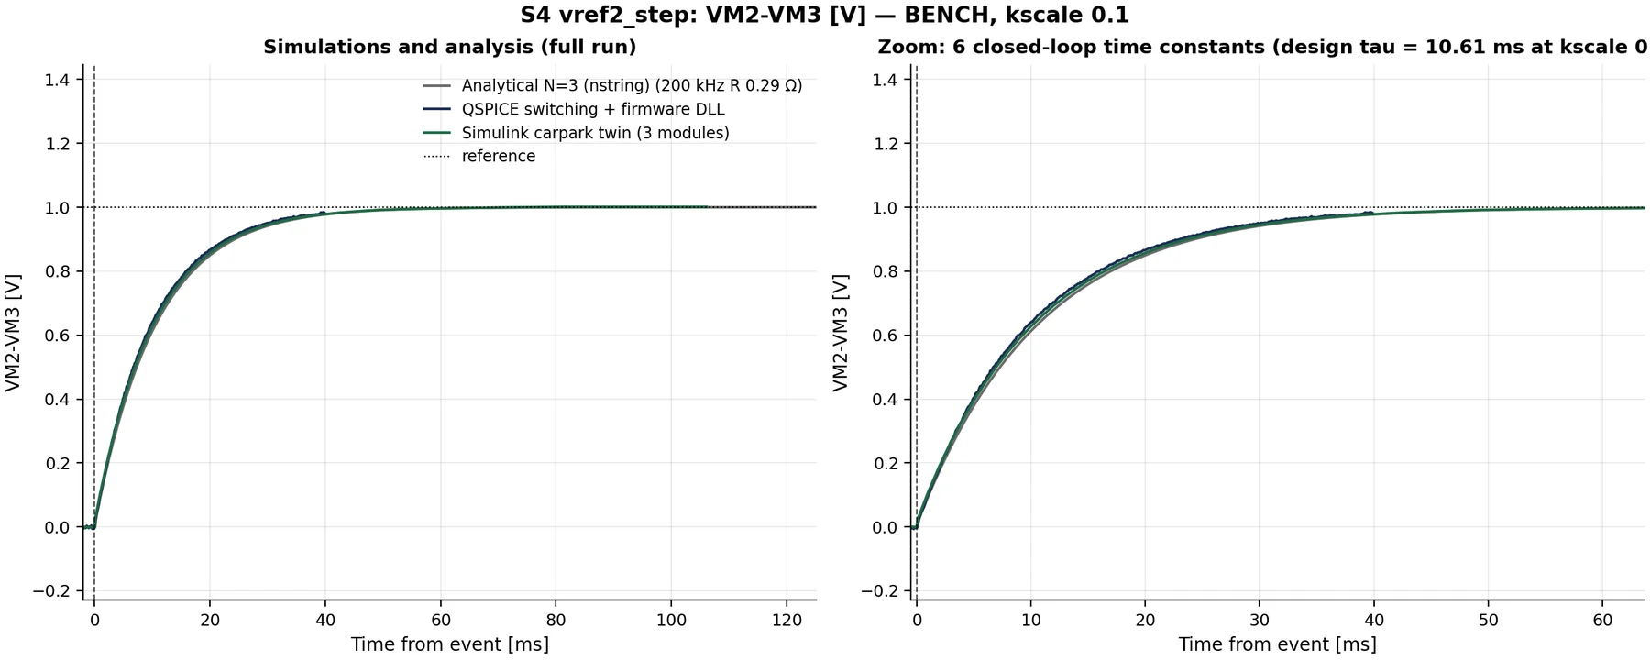
site/src/assets/figures/analysis/step_S4_BENCH_k0.1_vd2.webp
