saunders-jared-final/Boost-Brigade/site/src/assets/figures/ctrl/duty_steps.webp

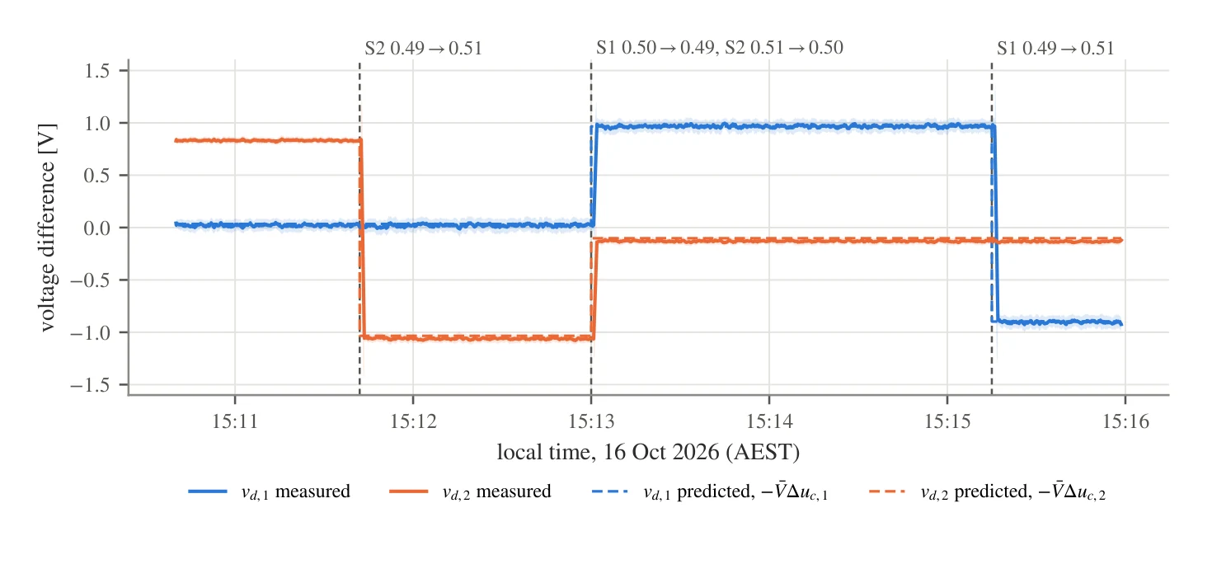
site/src/assets/figures/ctrl/duty_steps.webp
