saunders-jared-final/Boost-Brigade/site/src/assets/figures/ctrl/ref_step.webp

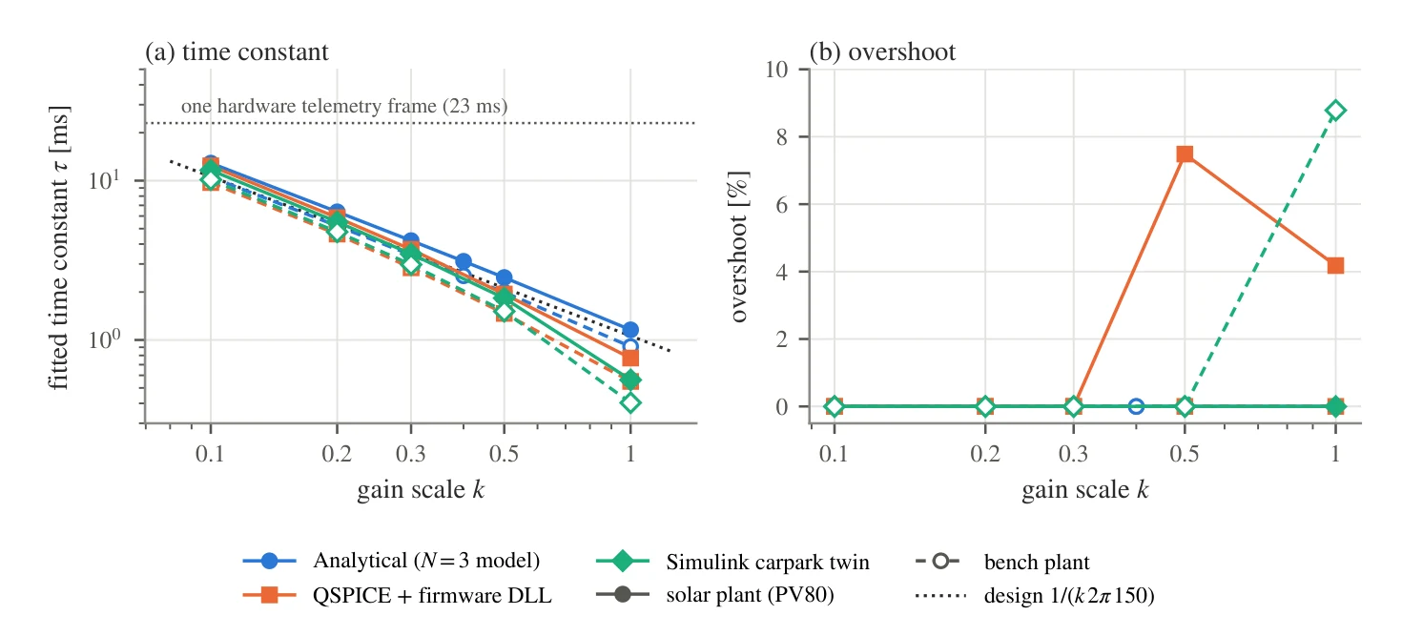
site/src/assets/figures/ctrl/ref_step.webp
