saunders-jared-final/Boost-Brigade/site/src/assets/figures/hw/outdoor_setup.webp

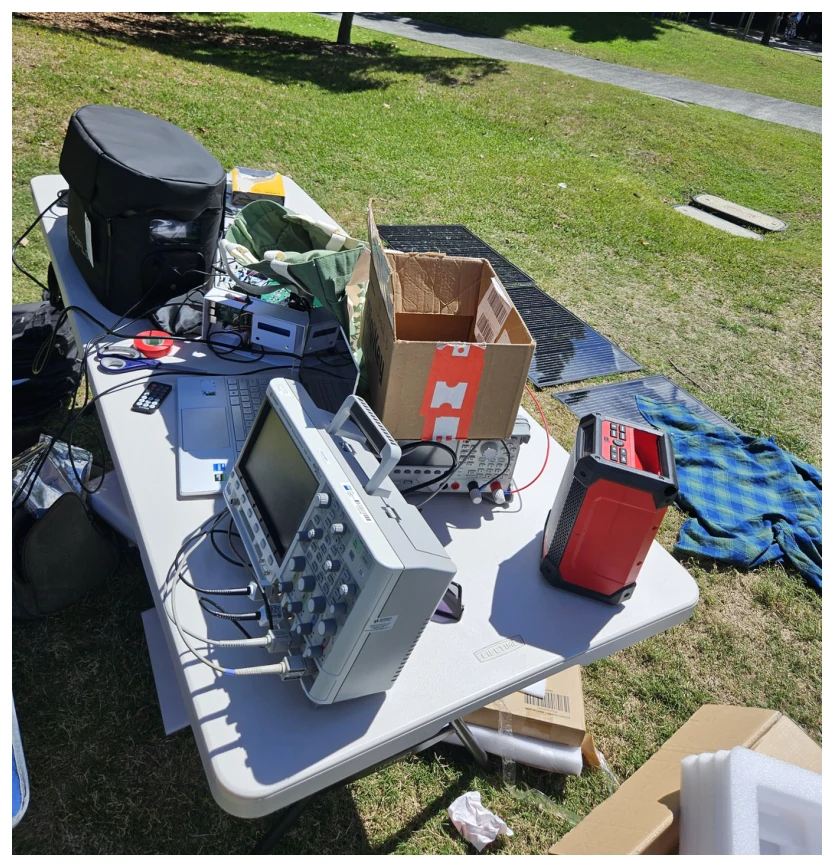
site/src/assets/figures/hw/outdoor_setup.webp
