saunders-jared-final/Boost-Brigade/site/src/assets/figures/results/duty_steps.webp

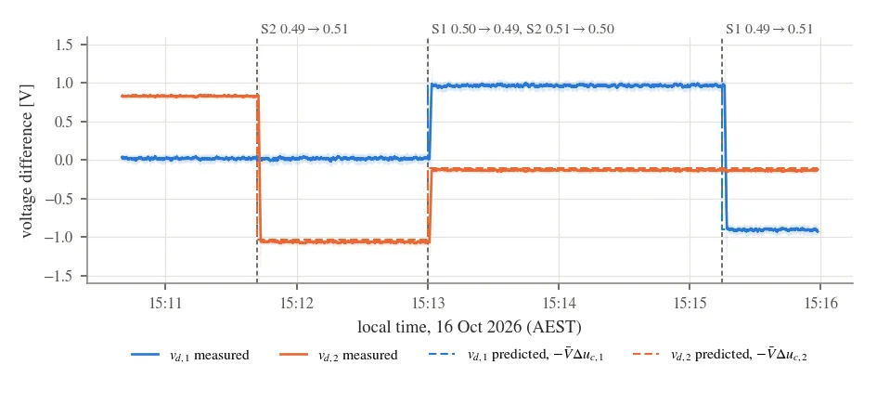
site/src/assets/figures/results/duty_steps.webp
