saunders-jared-final/Boost-Brigade/8_Results/analysis/out/tables/T7_energy.md

| case | loop | state | k | scope | start | s | P_load [W] | P_modules [W] | eff | P_shuffled [W] | P_returned [W] | P_returned max [W] | E_load [Wh] | E_shuffled [Wh] | E_returned [Wh] | returned / load | I_M1 [A] | I_M2 [A] | I_M3 [A] | I_str [A] |
|---|---|---|---|---|---|---|---|---|---|---|---|---|---|---|---|---|---|---|---|---|
| B01 | OL | RUN_OL | 0.3 | segment | 14:31:55 | 324 | 67.9 | 68.1 | 0.996 | 79 | 67.9 | 68 | 6.11 | 7.11 | 6.11 | 1 | 1.2 | -0.722 | 2.43 | 0.97 |
| B01 | OL | RUN_OL | 0.3 | segment | 14:38:19 | 383 | 66.7 | 66.9 | 0.996 | 79 | 66.7 | 68 | 7.1 | 8.41 | 7.1 | 1 | 1.16 | -0.714 | 2.41 | 0.953 |
| B01 | OL | RUN_OL | - | case | 14:32:00 | 707 | 67.2 | 67.5 | 0.996 | 79 | 67.2 | 68 | 13.2 | 15.5 | 13.2 | 1 | 1.18 | -0.718 | 2.42 | 0.96 |
| B01s | OL | RUN_OL | 0.3 | segment | 15:09:06 | 413 | 65.5 | 65.7 | 0.998 | 65.4 | 65.5 | 66.4 | 7.52 | 7.5 | 7.52 | 1 | 1.32 | -0.467 | 1.95 | 0.936 |
| B01s | OL | RUN_OL | - | case | 15:09:00 | 413 | 65.5 | 65.7 | 0.998 | 65.4 | 65.5 | 66.4 | 7.52 | 7.5 | 7.52 | 1 | 1.32 | -0.467 | 1.95 | 0.936 |
| B02 | CL | RUN_CL | 0.1 | segment | 15:31:37 | 157 | 44.5 | 44.5 | 1 | 16.4 | 19.3 | 44.6 | 1.94 | 0.716 | 0.84 | 0.433 | 0.805 | 0.412 | 0.688 | 0.635 |
| B02 | CL | RUN_CL | 0.1 | case | 15:31:34 | 162 | 44.5 | 44.4 | 1 | 16.5 | 19.4 | 44.6 | 2 | 0.741 | 0.872 | 0.436 | 0.807 | 0.408 | 0.69 | 0.635 |
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
| S11 | CL | RUN_CL | 0.8 | case | 16:23:05 | 91 | 2.32 | 2.31 | 1 | 4.44 | 2.29 | 3.18 | 0.0586 | 0.112 | 0.0579 | 0.988 | -0.0555 | 0.139 | 0.0298 | 0.038 |
