saunders-jared-final/Boost-Brigade/8_Results/Bench_Open_Loop_100kHz/ol100k_b_oppoints.pdf

### Steady operating points (2 segments ≥ 5 s, error bar = 1σ)

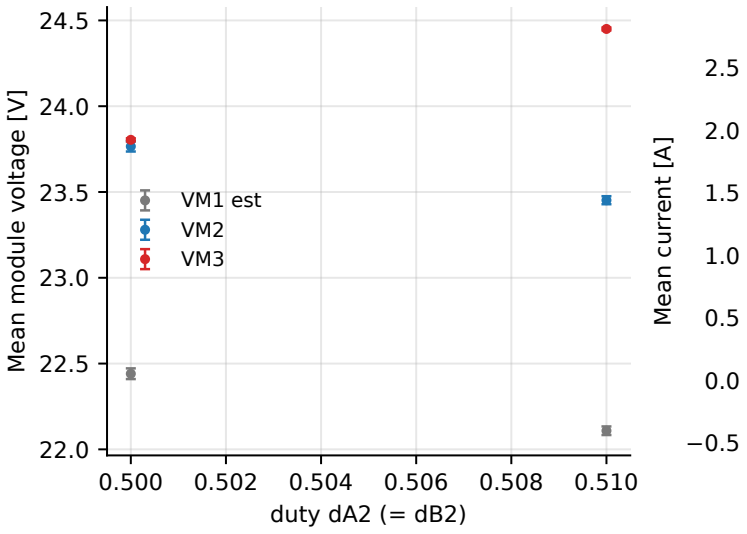
[picture p233: figure]
0.500 0.502 0.504 0.506 0.508 0.510 duty dA2 (= dB2); Mean module voltage [V]; VM1 est VM2 VM3; Mean current [A]
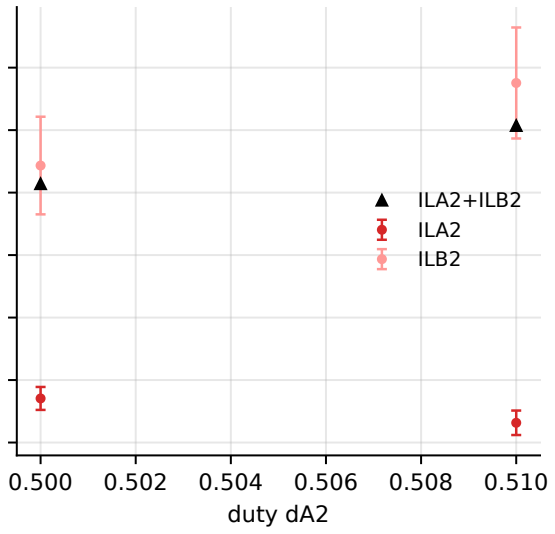
[picture p234: figure]
0.500 0.502 0.504 0.506 0.508 0.510 duty dA2; ILA2+ILB2 ILA2 ILB2
