saunders-jared-final/Boost-Brigade/8_Results/analysis/out/figures/analytical/S1_BENCH_f200k_k1.pdf

Voltage differences v_d (full run); dotted = reference

Voltage differences v_d (zoom); dotted = reference

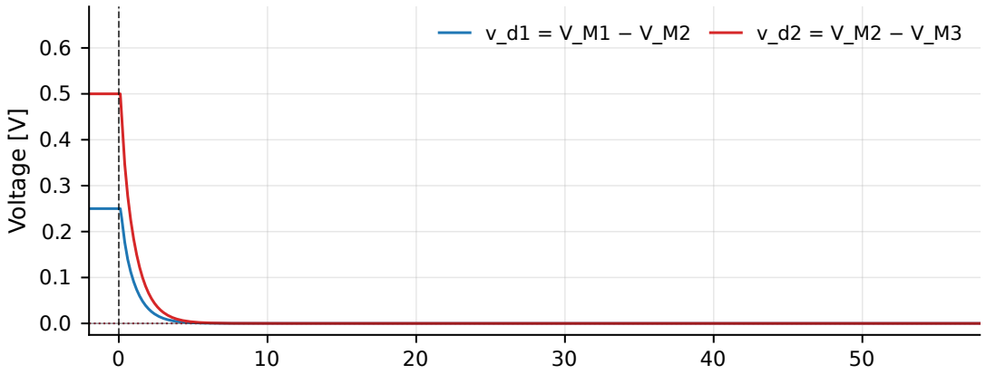
[picture p247: figure]
Voltage [V]

Shuffled i_sh (solid) and circulating i_c (dashed) (full run)

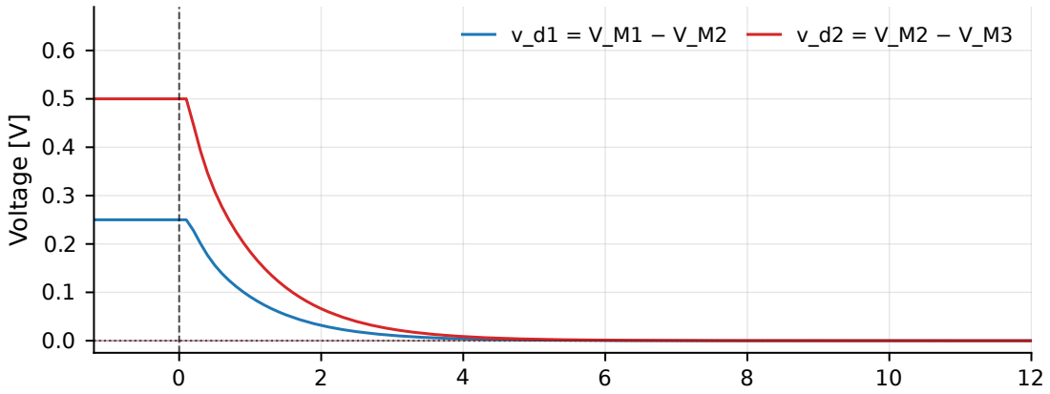
[picture p248: figure]
Voltage [V]
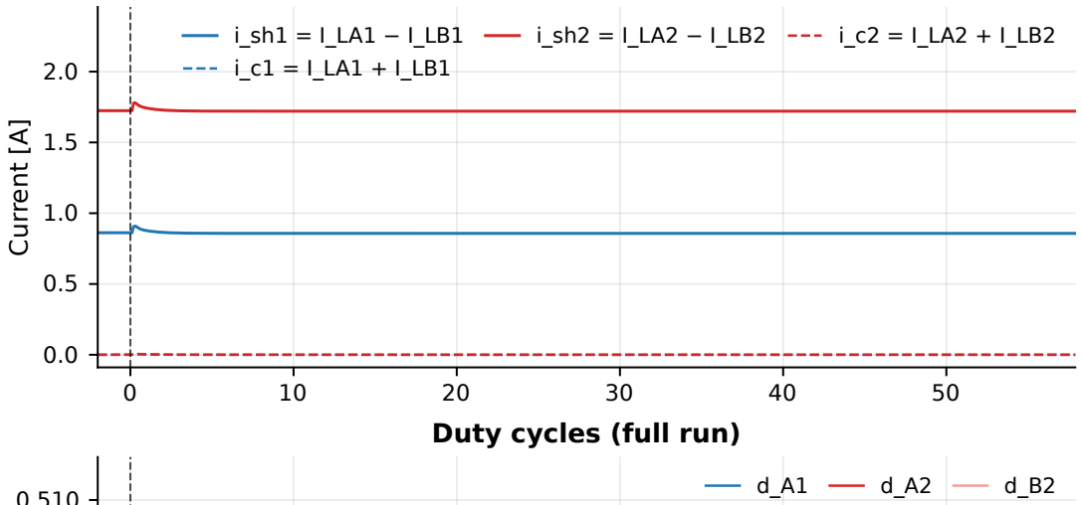
[picture p249: figure]
Current [A]; Duty cycles (full run)

0.5

1.0

1.5

2.0

Current [A]

Shuffled i_sh (solid) and circulating i_c (dashed) (zoom)

i_sh1 = I_LA1 − I_LB1
i_c1 = I_LA1 + I_LB1

i_sh2 = I_LA2 − I_LB2 i_c2 = I_LA2 + I_LB2

Analytical N=3 (200 kHz gain set, R = 0.29 Ω): loop_close — BENCH, kscale 1: OL -> CL on vd_OL = [0.25, 0.50] V (1.29 A deficit on module 3)

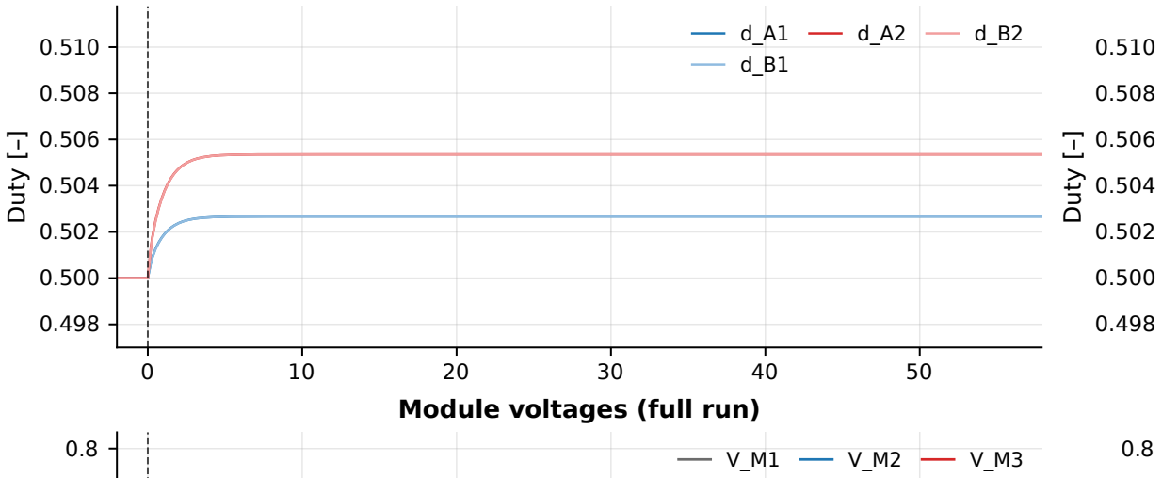
[picture p250: figure]
Duty [–]; Module voltages (full run)
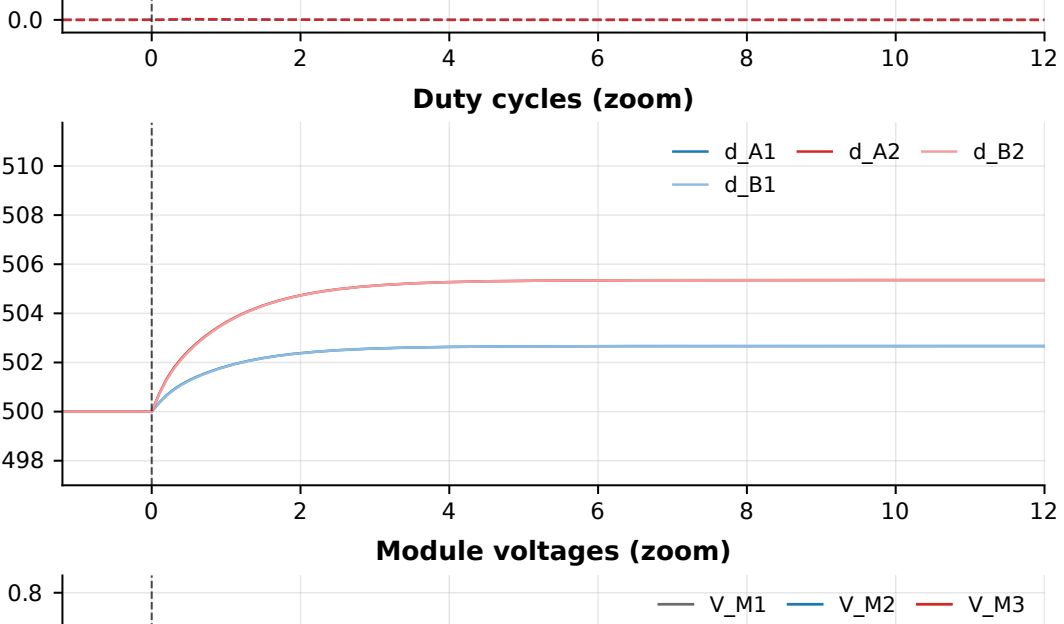
[picture p251: figure]
Duty cycles (zoom); Module voltages (zoom)
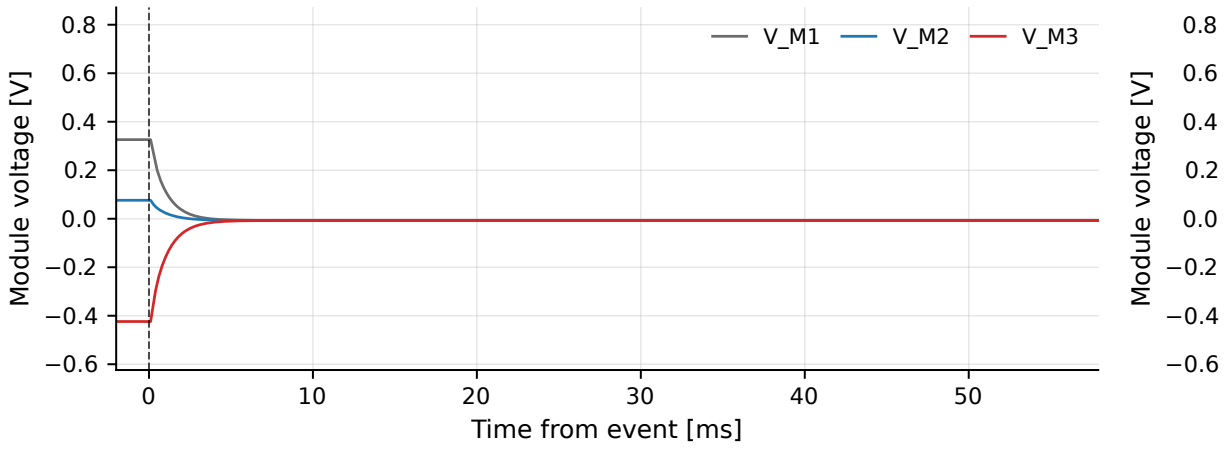
[picture p252: figure]
Time from event [ms]; Module voltage [V]
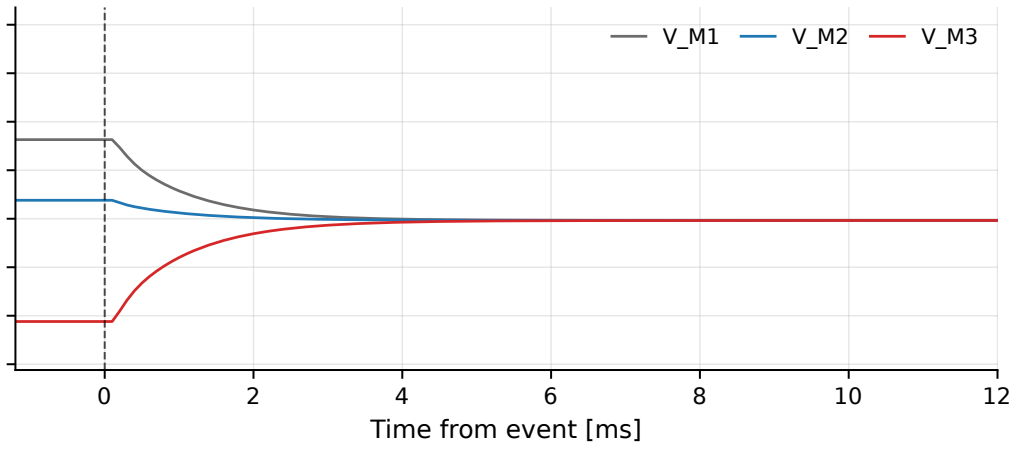
[picture p253: figure]
Time from event [ms]
