saunders-jared-final/Boost-Brigade/8_Results/analysis/out/figures/analytical/S1_BENCH_f300k_k0.3.pdf

Voltage differences v_d (full run); dotted = reference

Voltage differences v_d (zoom); dotted = reference

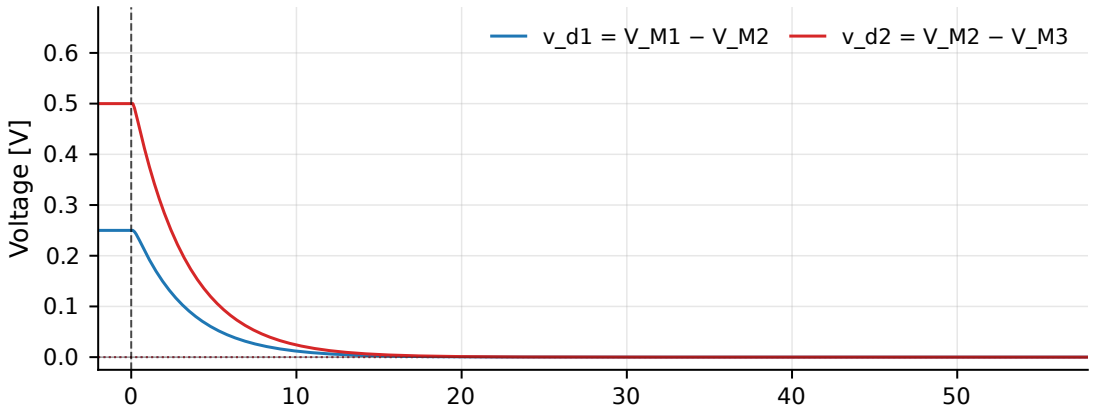
[picture p254: figure]
Voltage [V]

Shuffled i_sh (solid) and circulating i_c (dashed) (full run)

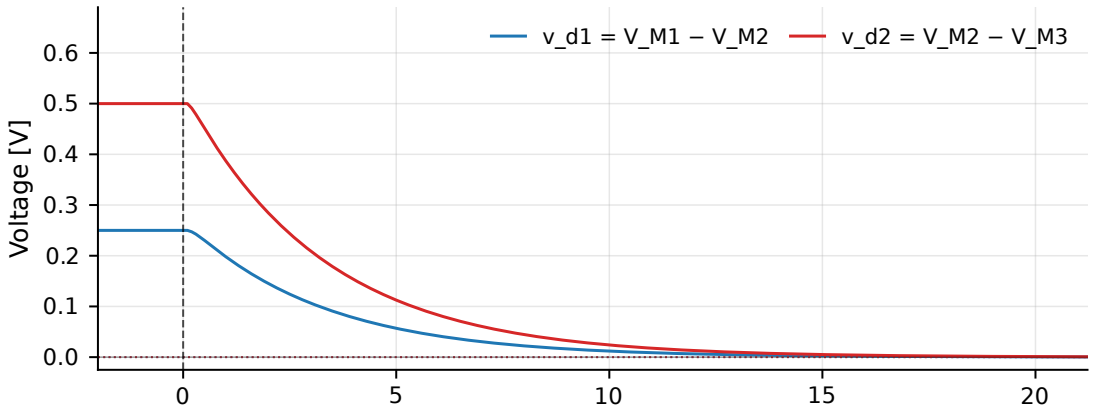
[picture p255: figure]
Voltage [V]
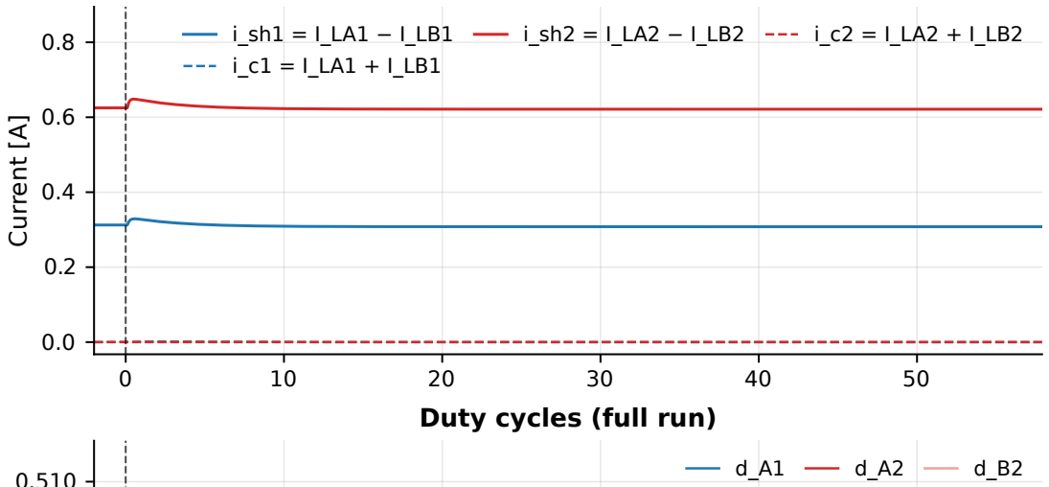
[picture p256: figure]
Current [A]; Duty cycles (full run)
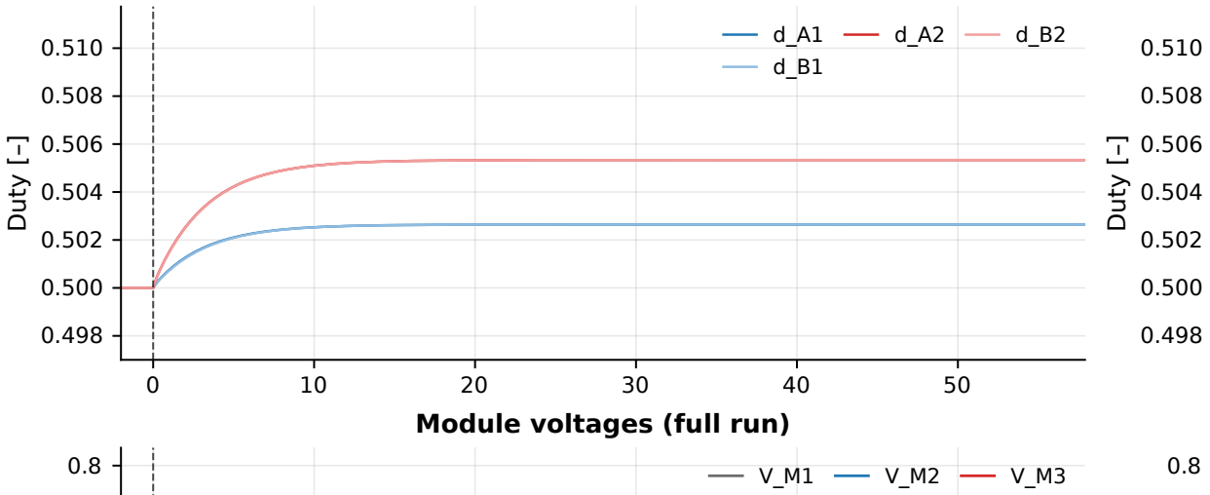
[picture p257: figure]
Duty [–]; Module voltages (full run)
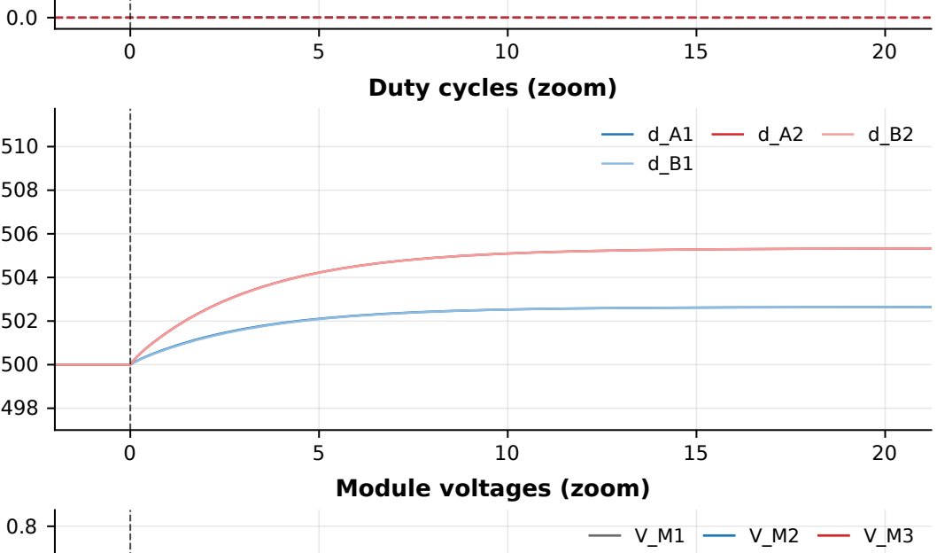
[picture p258: figure]
Duty cycles (zoom); Module voltages (zoom)

0.2

0.4

0.6

0.8

Current [A]

Shuffled i_sh (solid) and circulating i_c (dashed) (zoom)

i_sh1 = I_LA1 − I_LB1
i_c1 = I_LA1 + I_LB1

i_sh2 = I_LA2 − I_LB2 i_c2 = I_LA2 + I_LB2

Analytical N=3 (300 kHz gain set, R = 0.8 Ω): loop_close — BENCH, kscale 0.3: OL -> CL on vd_OL = [0.25, 0.50] V (0.47 A deficit on module 3)

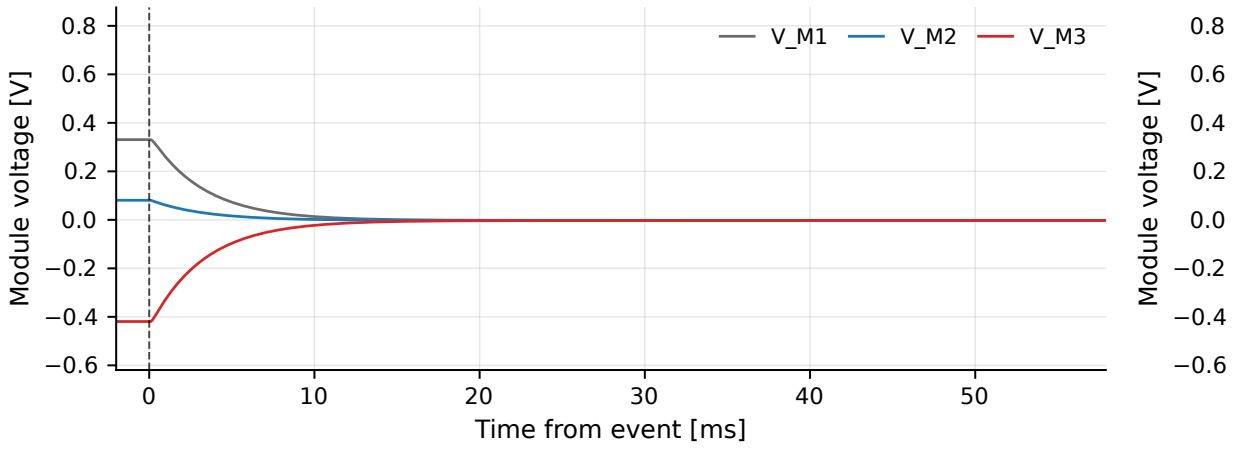
[picture p259: figure]
Time from event [ms]; Module voltage [V]
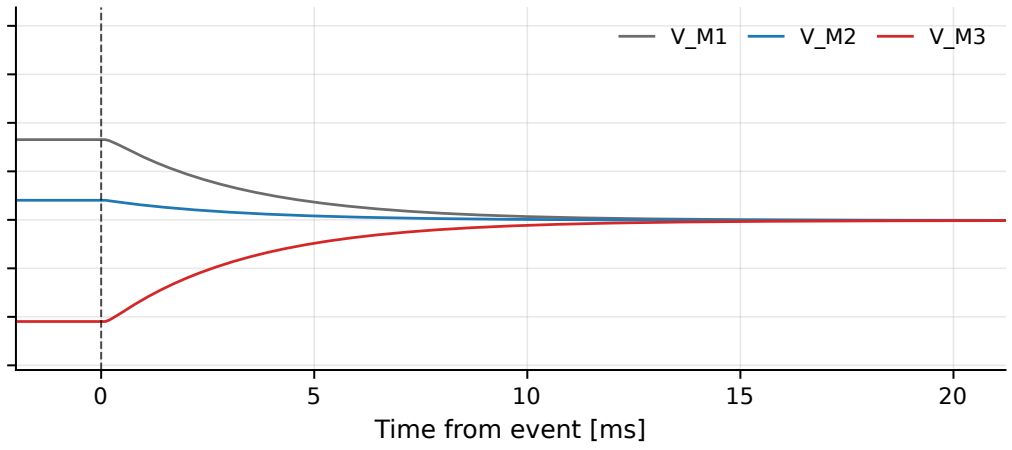
[picture p260: figure]
Time from event [ms]
