saunders-jared-final/Boost-Brigade/8_Results/analysis/out/figures/analytical/S1_PV80_f200k_k0.1.pdf

Voltage differences v_d (full run); dotted = reference

Voltage differences v_d (zoom); dotted = reference

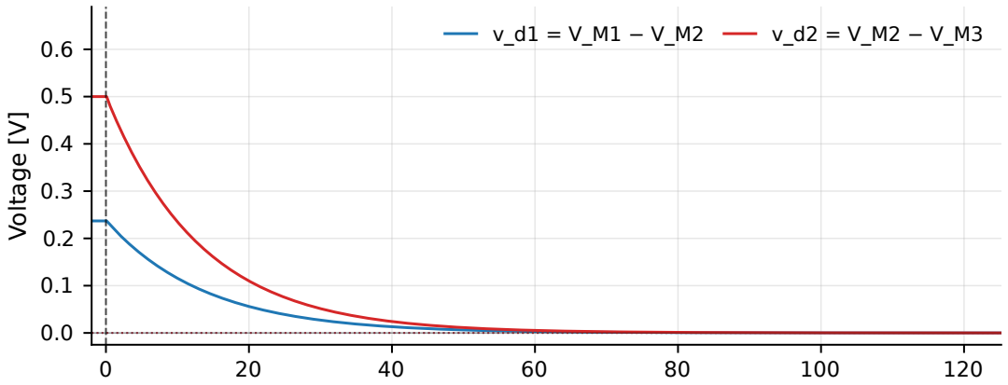
[picture p261: figure]
Voltage [V]
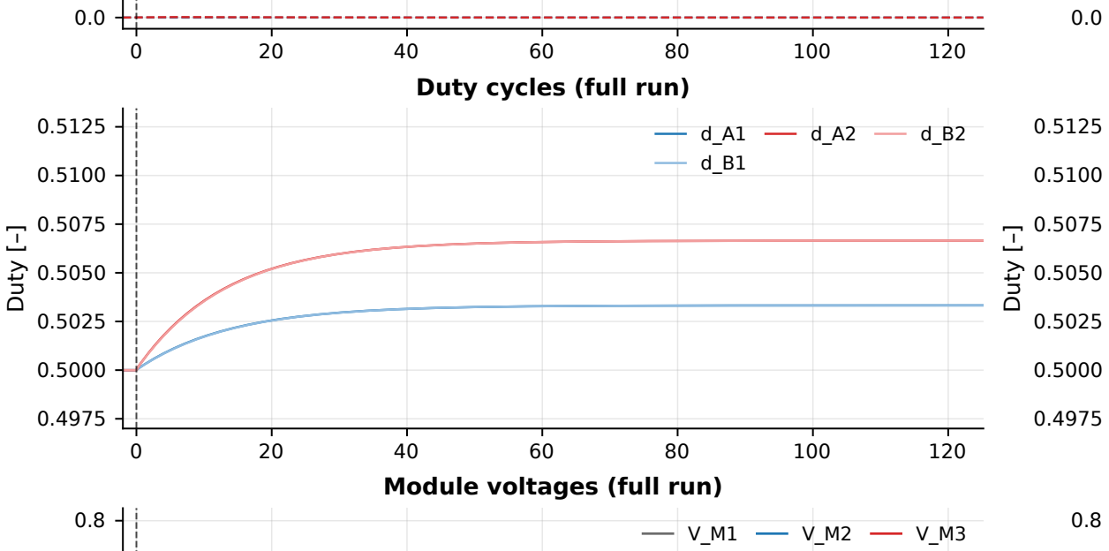
[picture p262: figure]
Duty [–]; Duty cycles (full run); Module voltages (full run)

0.5

1.0

1.5

2.0

2.5

Current [A]

Shuffled i_sh (solid) and circulating i_c (dashed) (full run)

i_sh1 = I_LA1 − I_LB1
i_c1 = I_LA1 + I_LB1

i_sh2 = I_LA2 − I_LB2 i_c2 = I_LA2 + I_LB2

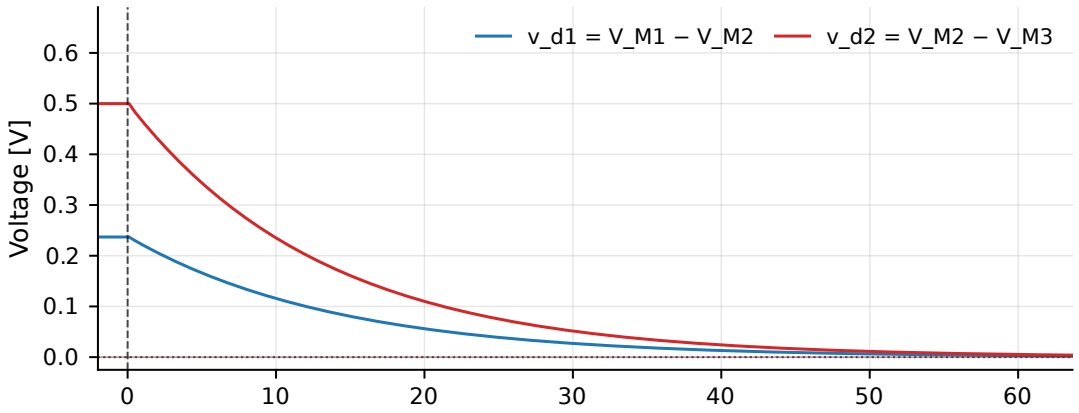
[picture p263: figure]
Voltage [V]
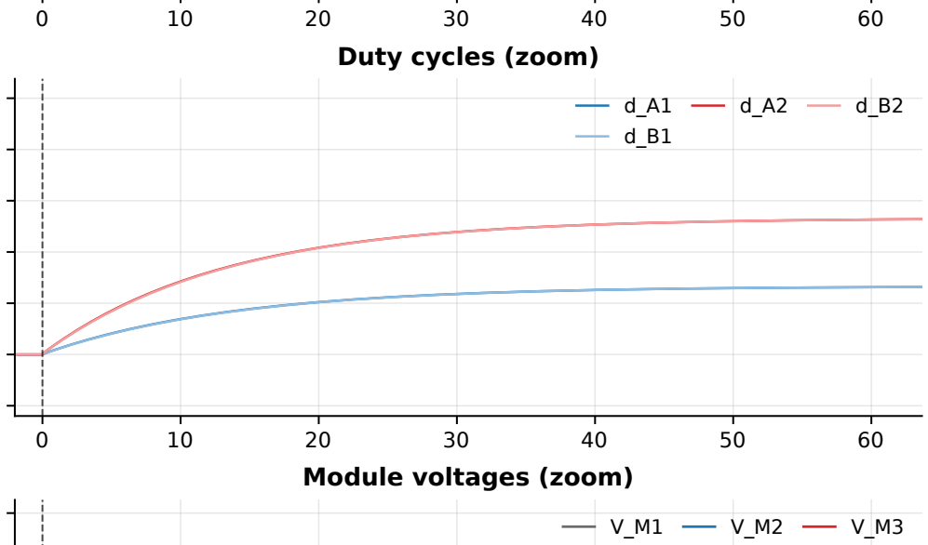
[picture p264: figure]
Duty cycles (zoom); Module voltages (zoom)

0.5

1.0

1.5

2.0

2.5

Current [A]

Shuffled i_sh (solid) and circulating i_c (dashed) (zoom)

i_sh1 = I_LA1 − I_LB1
i_c1 = I_LA1 + I_LB1

i_sh2 = I_LA2 − I_LB2 i_c2 = I_LA2 + I_LB2

Analytical N=3 (200 kHz gain set, R = 0.29 Ω): loop_close — PV80, kscale 0.1: OL -> CL on vd_OL = [0.24, 0.50] V (1.41 A deficit on module 3)

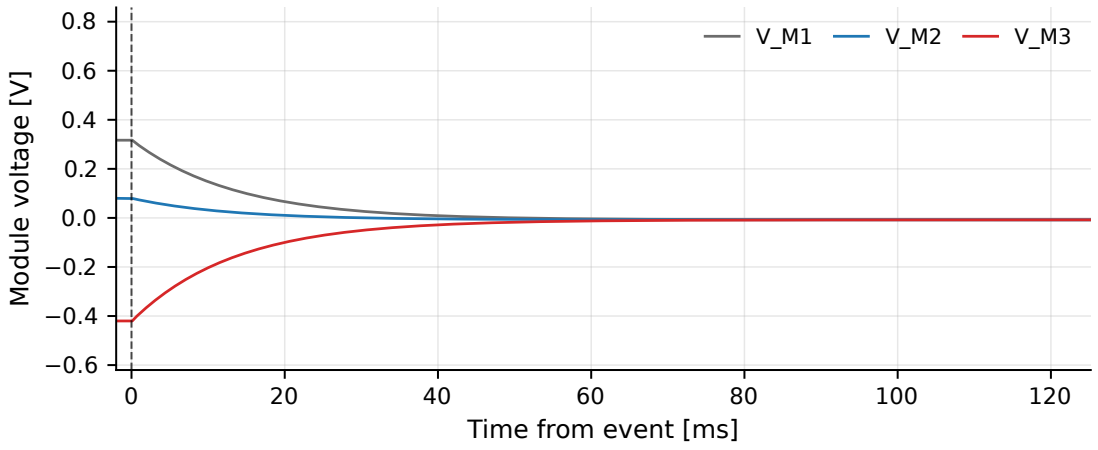
[picture p265: figure]
Time from event [ms]; Module voltage [V]
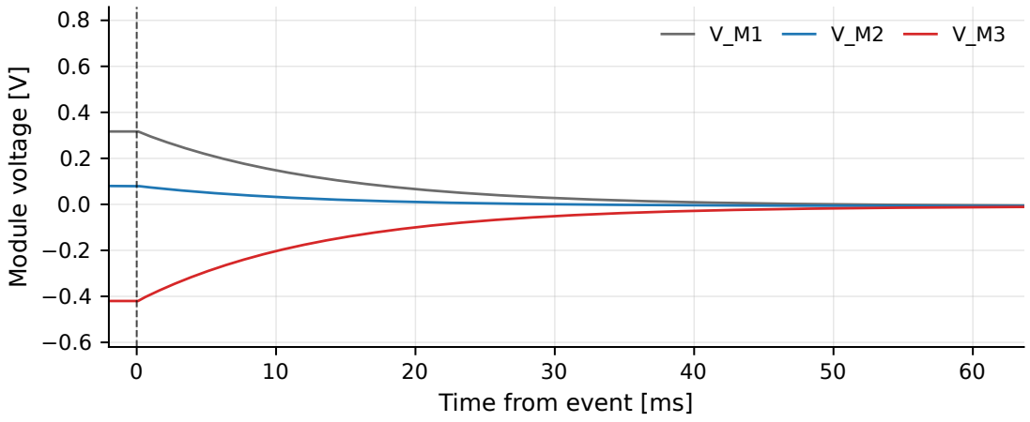
[picture p266: figure]
Time from event [ms]; Module voltage [V]
