saunders-jared-final/Boost-Brigade/8_Results/analysis/out/figures/analytical/S1_PV80_f300k_k0.3.pdf

Voltage differences v_d (full run); dotted = reference

Voltage differences v_d (zoom); dotted = reference

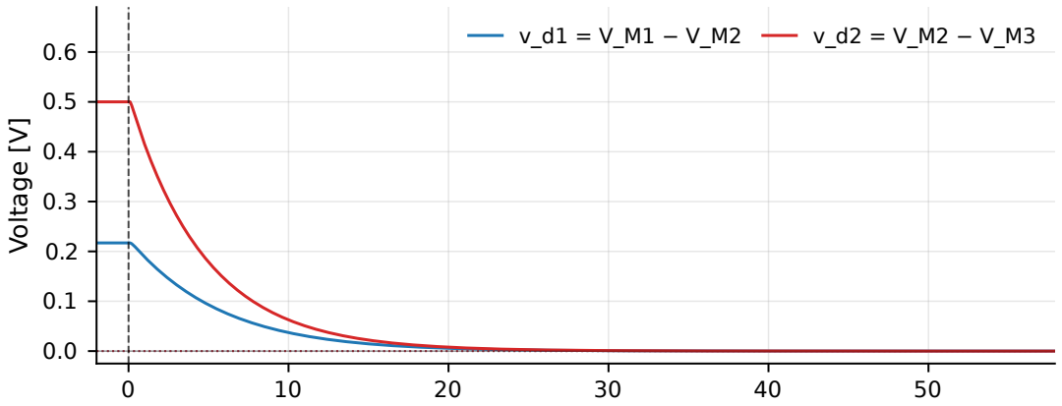
[picture p279: figure]
Voltage [V]

Shuffled i_sh (solid) and circulating i_c (dashed) (full run)

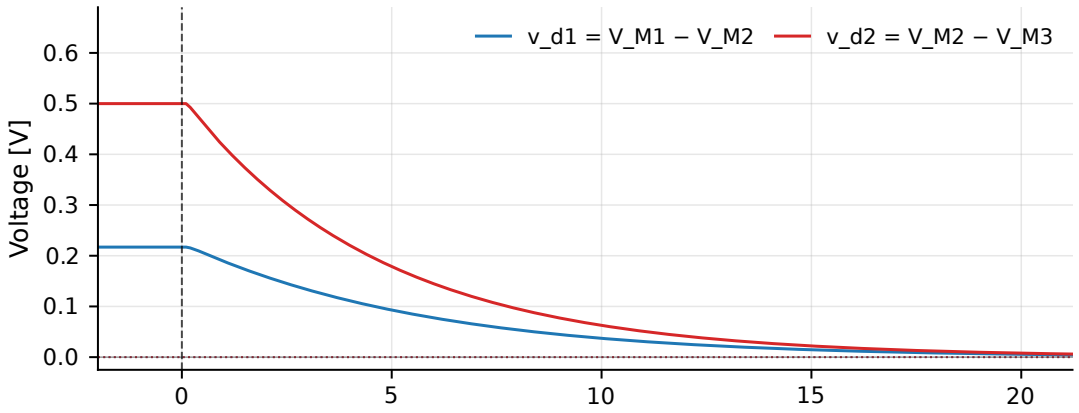
[picture p280: figure]
Voltage [V]

Shuffled i_sh (solid) and circulating i_c (dashed) (zoom)

Analytical N=3 (300 kHz gain set, R = 0.8 Ω): loop_close — PV80, kscale 0.3: OL -> CL on vd_OL = [0.22, 0.50] V (0.58 A deficit on module 3)

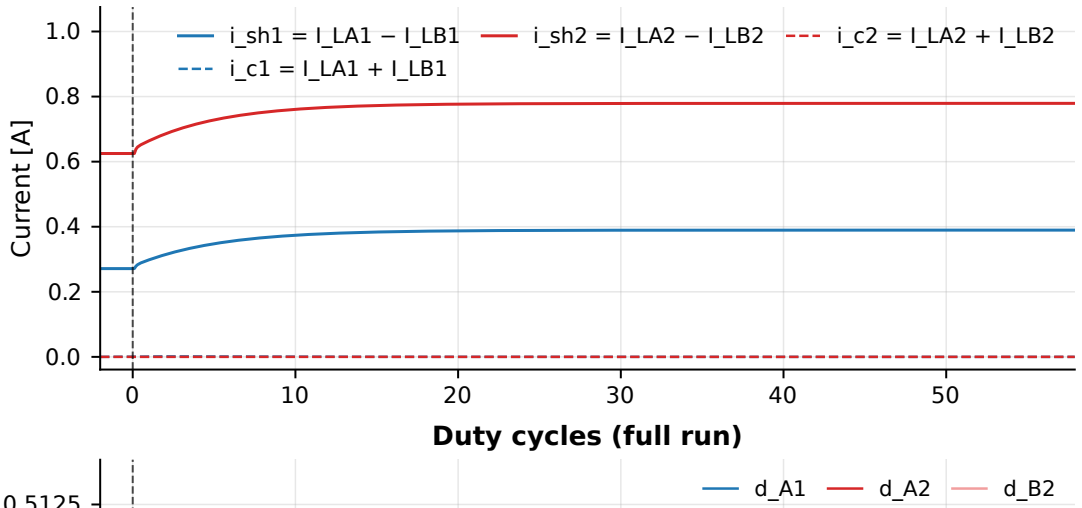
[picture p281: figure]
Current [A]; Duty cycles (full run)
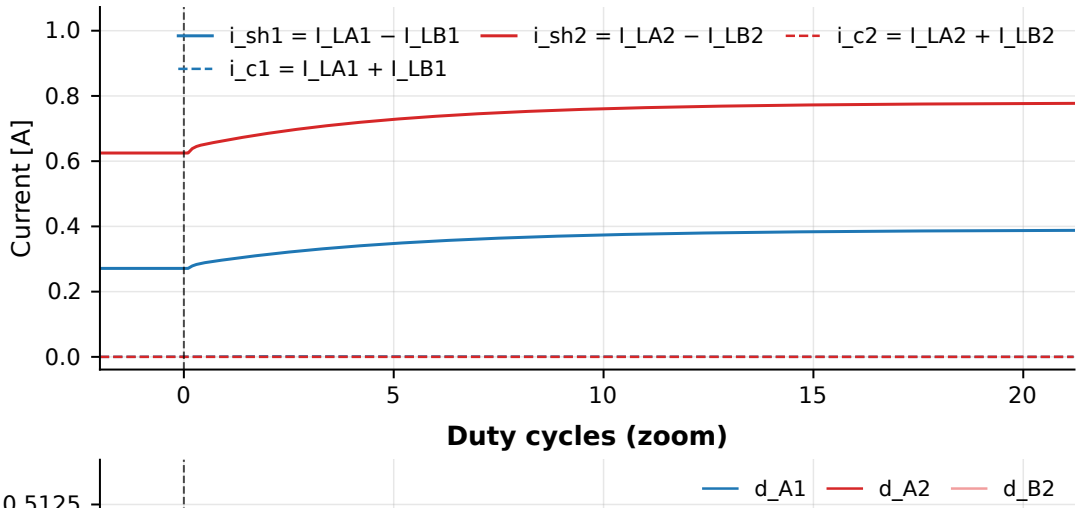
[picture p282: figure]
Current [A]; Duty cycles (zoom)
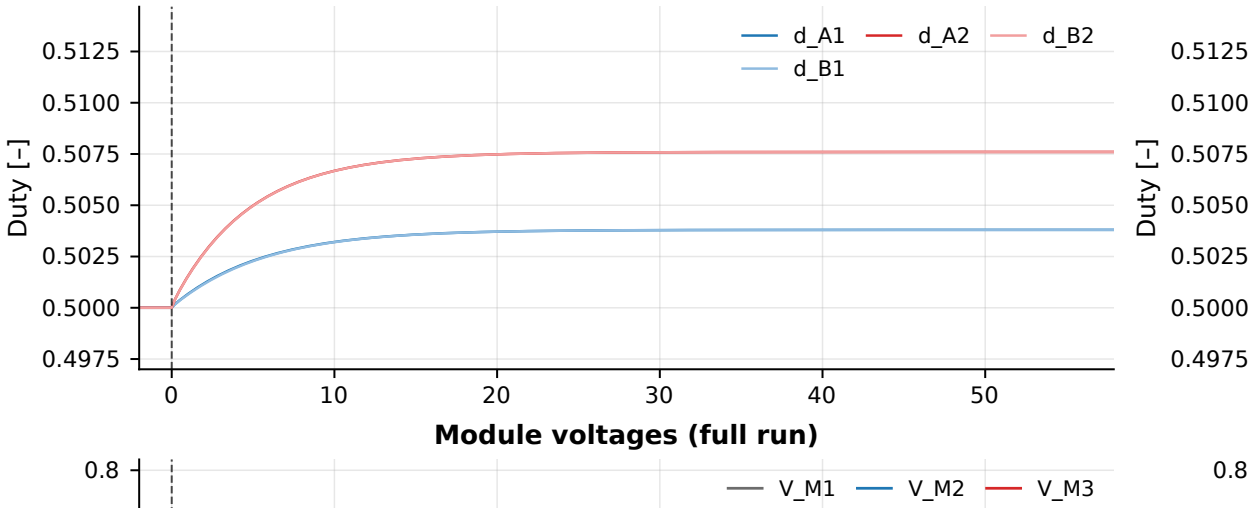
[picture p283: figure]
Duty [–]; Module voltages (full run)
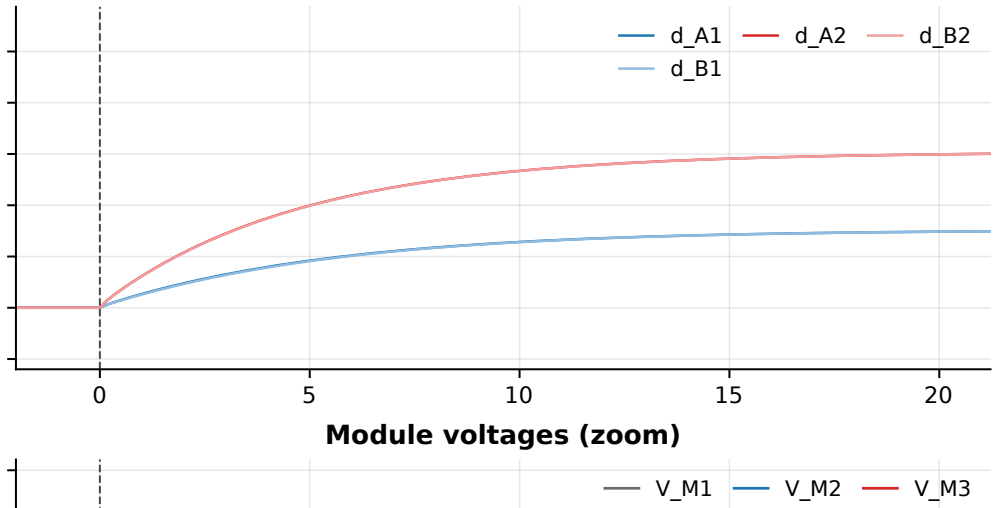
[picture p284: figure]
Module voltages (zoom)
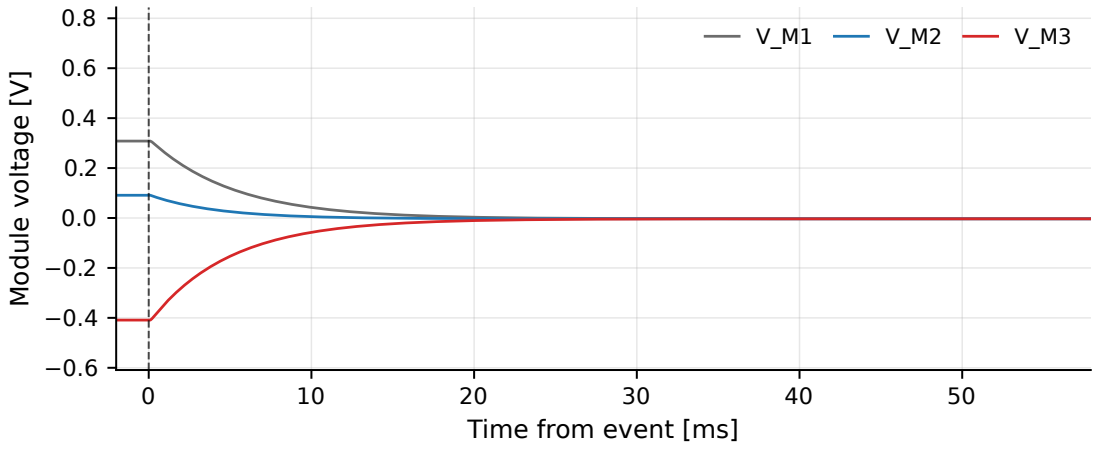
[picture p285: figure]
Time from event [ms]; Module voltage [V]
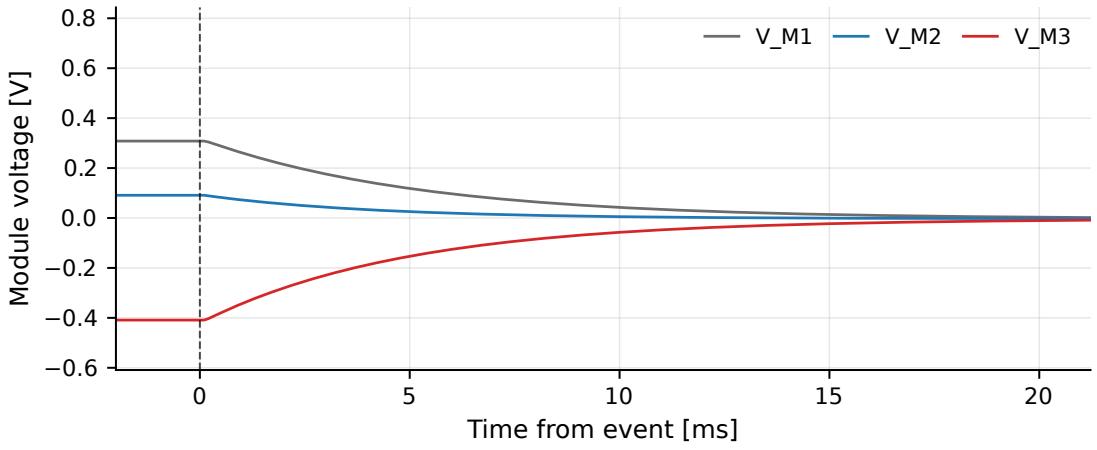
[picture p286: figure]
Time from event [ms]; Module voltage [V]
