saunders-jared-final/Boost-Brigade/8_Results/analysis/out/figures/analytical/S1_PV80_f400k_k0.3.pdf

Voltage differences v_d (full run); dotted = reference

Voltage differences v_d (zoom); dotted = reference

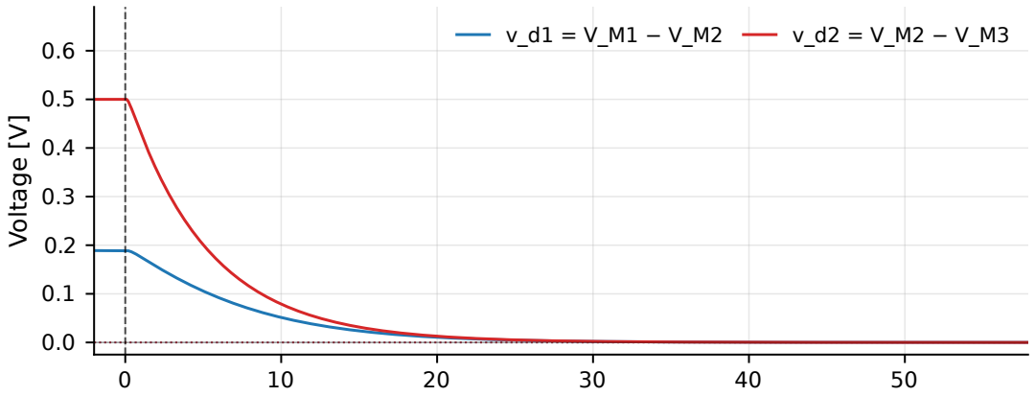
[picture p287: figure]
Voltage [V]
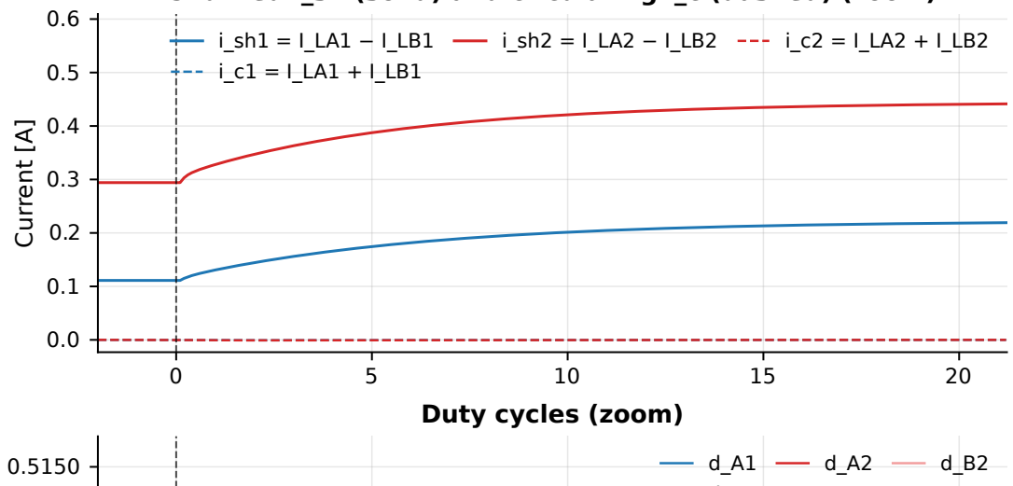
[picture p288: figure]
Current [A]; Duty cycles (zoom)

Shuffled i_sh (solid) and circulating i_c (dashed) (full run)

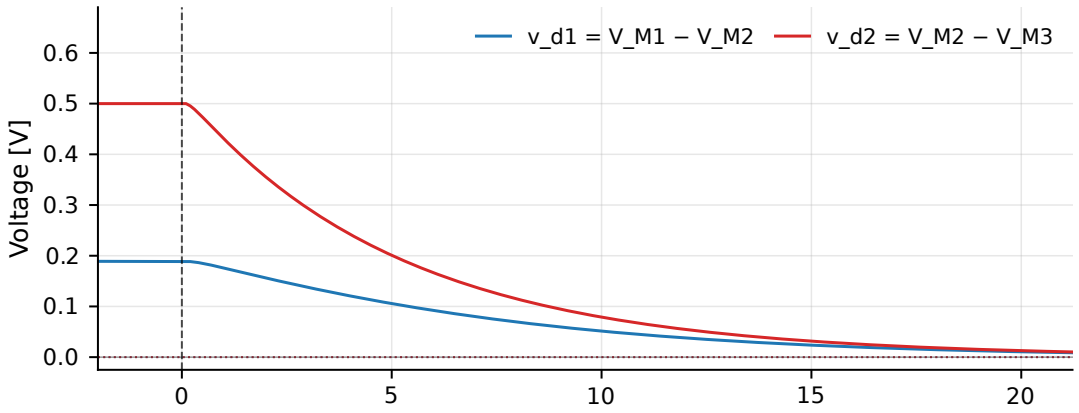
[picture p289: figure]
Voltage [V]

Shuffled i_sh (solid) and circulating i_c (dashed) (zoom)

Analytical N=3 (400 kHz gain set, R = 1.7 Ω): loop_close — PV80, kscale 0.3: OL -> CL on vd_OL = [0.19, 0.50] V (0.33 A deficit on module 3)

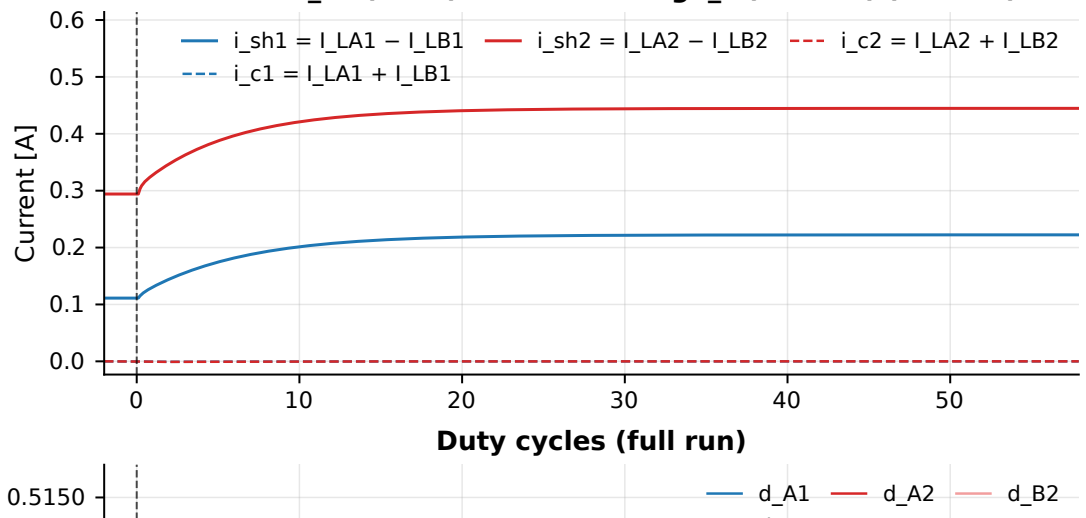
[picture p290: figure]
Current [A]; Duty cycles (full run)
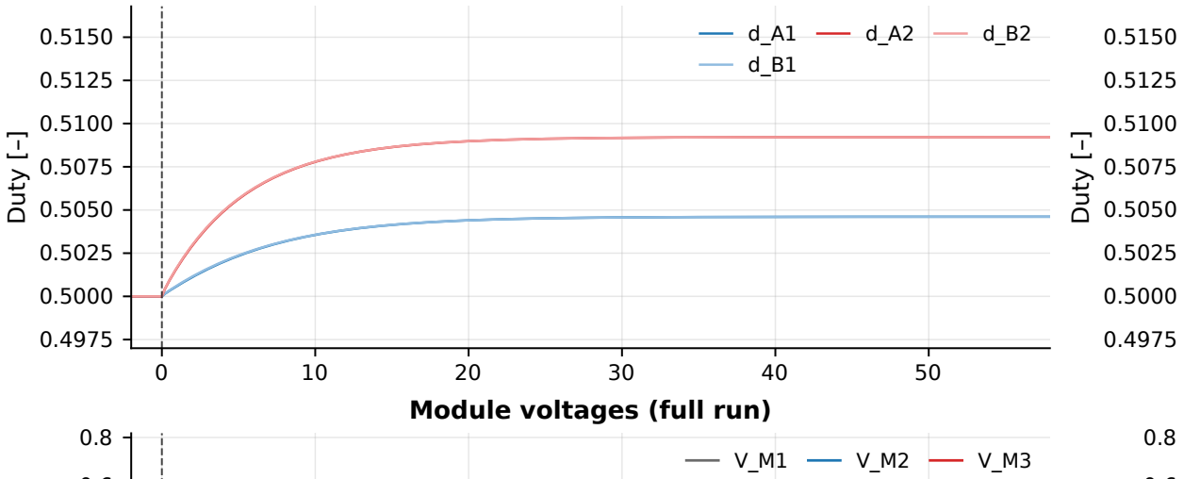
[picture p291: figure]
Duty [–]; Module voltages (full run)
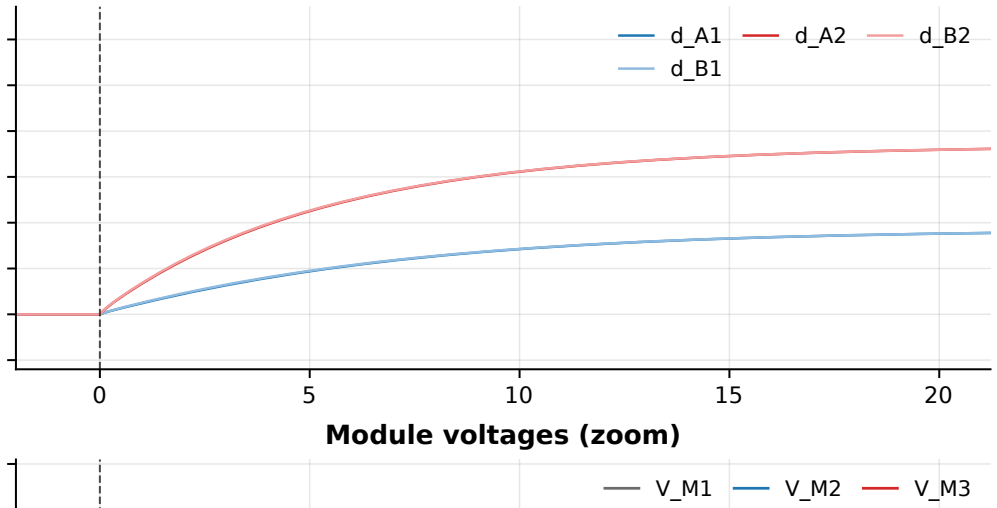
[picture p292: figure]
Module voltages (zoom)
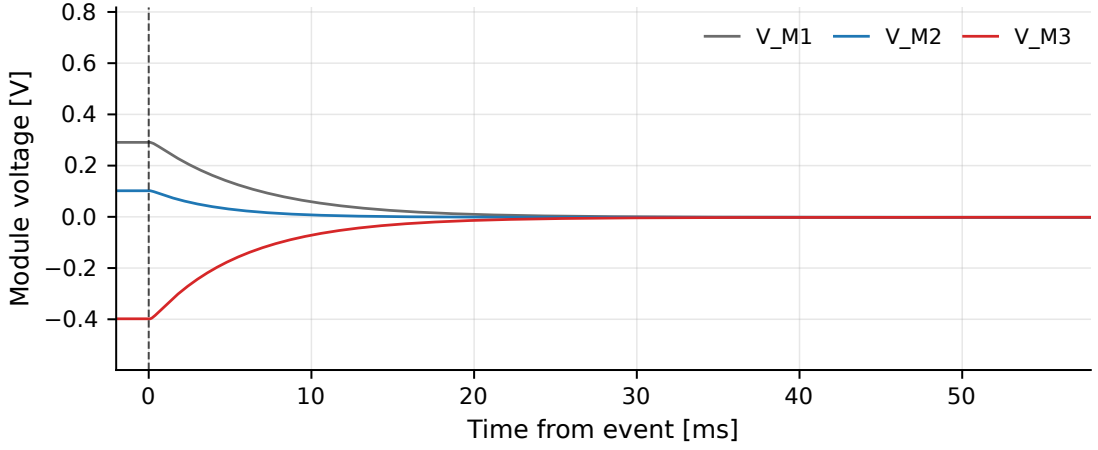
[picture p293: figure]
Time from event [ms]; Module voltage [V]
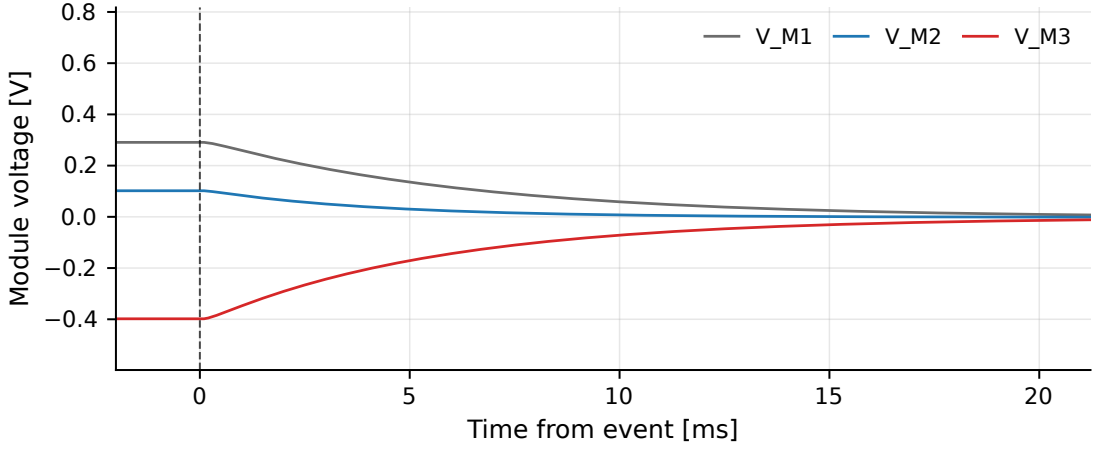
[picture p294: figure]
Time from event [ms]; Module voltage [V]
