saunders-jared-final/Boost-Brigade/8_Results/analysis/out/figures/analytical/S5_BENCH_f200k_k0_uc1+0.04.pdf

0 | 10 | 20 | 30 | 40 | 50

−1.5

−1.0

−0.5

0.0

0.5

Voltage [V]

Voltage differences v_d (full run)

v_d1 = V_M1 − V_M2 | v_d2 = V_M2 − V_M3
0 | 2 | 4 | 6 | 8 | 10 | 12

−1.5

−1.0

−0.5

0.0

0.5

Voltage [V]

Voltage differences v_d (zoom)

v_d1 = V_M1 − V_M2 | v_d2 = V_M2 − V_M3
0 | 10 | 20 | 30 | 40 | 50

0.00

0.25

0.50

0.75

1.00

1.25

1.50

Current [A]

Shuffled i_sh (solid) and circulating i_c (dashed) (full run)

i_sh1 = I_LA1 − I_LB1
i_c1 = I_LA1 + I_LB1
i_sh2 = I_LA2 − I_LB2 | i_c2 = I_LA2 + I_LB2
0 | 2 | 4 | 6 | 8 | 10 | 12

0.00

0.25

0.50

0.75

1.00

1.25

1.50

Current [A]

Shuffled i_sh (solid) and circulating i_c (dashed) (zoom)

i_sh1 = I_LA1 − I_LB1
i_c1 = I_LA1 + I_LB1
i_sh2 = I_LA2 − I_LB2 | i_c2 = I_LA2 + I_LB2
0 | 10 | 20 | 30 | 40 | 50

0.500

0.505

0.510

0.515

0.520

0.525

0.530

Duty [–]

Duty cycles (full run)

d_A1
d_B1
d_A2 | d_B2
0 | 2 | 4 | 6 | 8 | 10 | 12

0.500

0.505

0.510

0.515

0.520

0.525

0.530

Duty [–]

Duty cycles (zoom)

d_A1
d_B1
d_A2 | d_B2
0 | 10 | 20 | 30 | 40 | 50
Time from event [ms]

−1.0

−0.5

0.0

0.5

1.0

1.5

Module voltage [V]

Module voltages (full run)

V_M1 | V_M2 | V_M3
0 | 2 | 4 | 6 | 8 | 10 | 12
Time from event [ms]

−1.0

−0.5

0.0

0.5

1.0

1.5

Module voltage [V]

Module voltages (zoom)

V_M1 | V_M2 | V_M3

## Analytical N=3 (200 kHz gain set, R = 0.29 Ω): S5 — BENCH, kscale 0: open loop: uc1 +0.04
