saunders-jared-final/Boost-Brigade/8_Results/analysis/out/figures/carpark/S1_BENCH_k0.2.pdf

Voltage differences v_d (full run); dotted = reference

Voltage differences v_d (zoom); dotted = reference

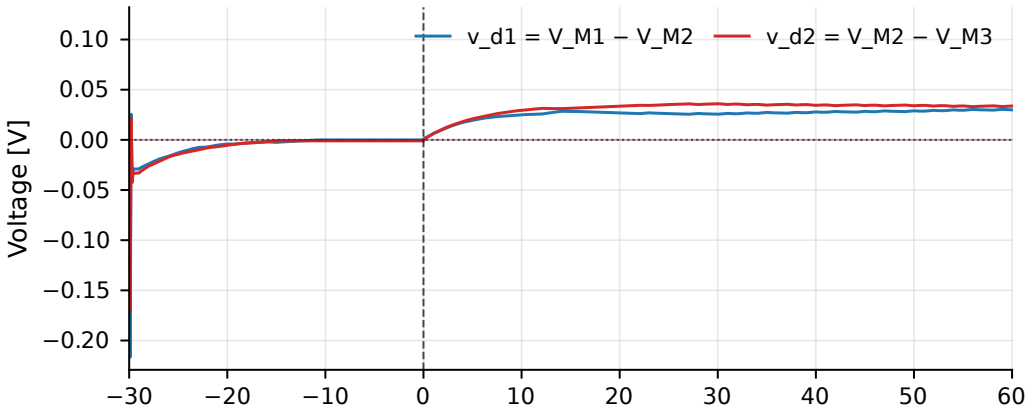
[picture p295: figure]
Voltage [V]

Shuffled i_sh (solid) and circulating i_c (dashed) (full run)

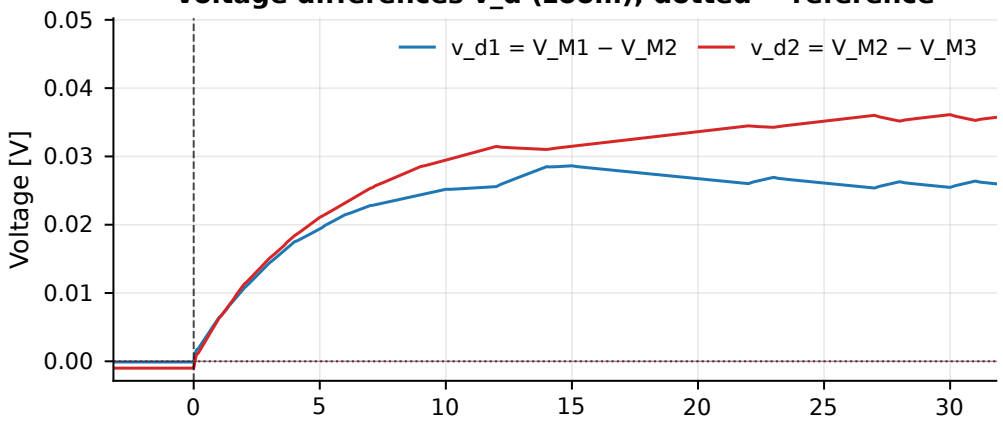
[picture p296: figure]
Voltage [V]

Shuffled i_sh (solid) and circulating i_c (dashed) (zoom)

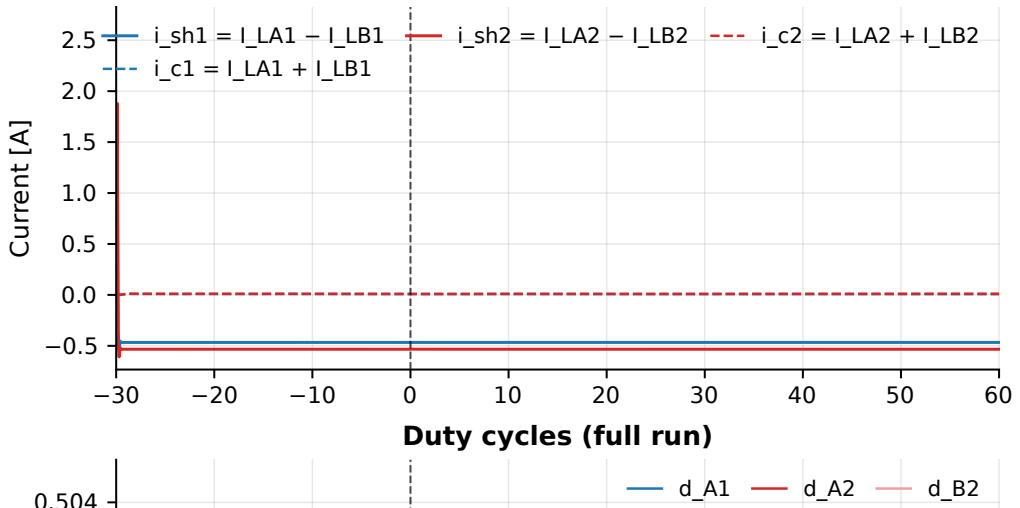
[picture p297: figure]
Current [A]; Duty cycles (full run)
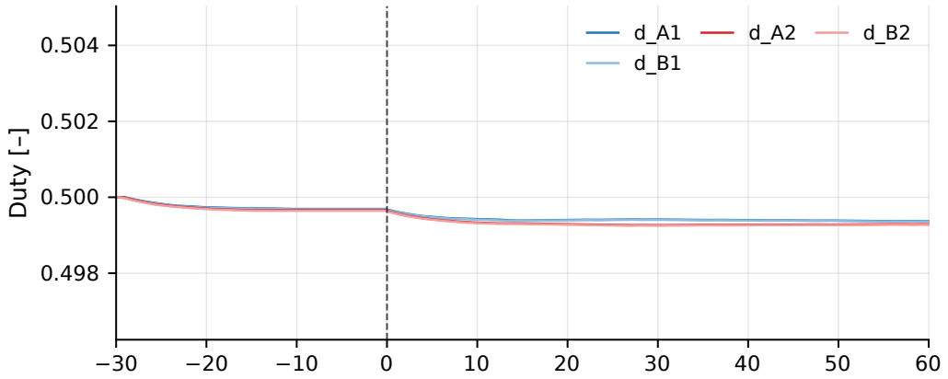
[picture p298: figure]
Duty [–]
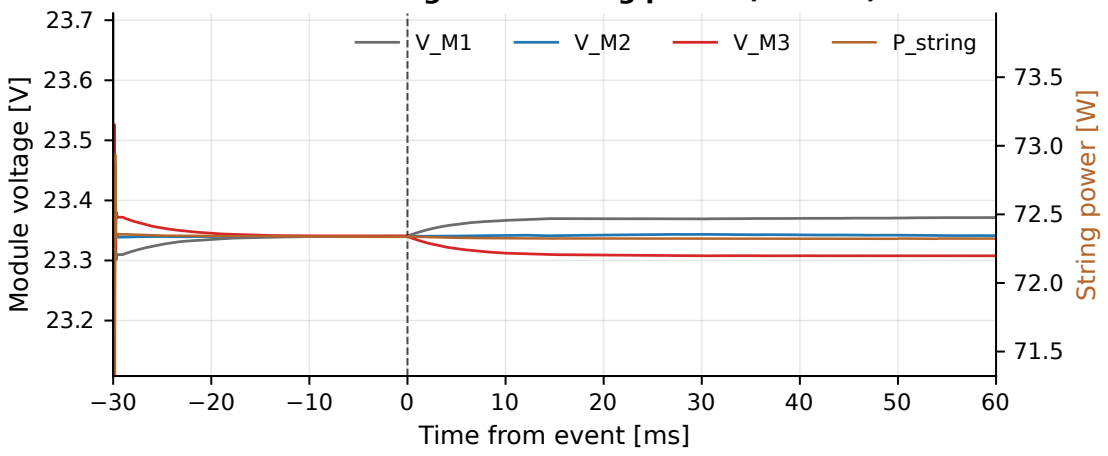
[picture p299: figure]
Time from event [ms]; Module voltage [V]; P_string; String power [W]

Module voltages and string power (full run)

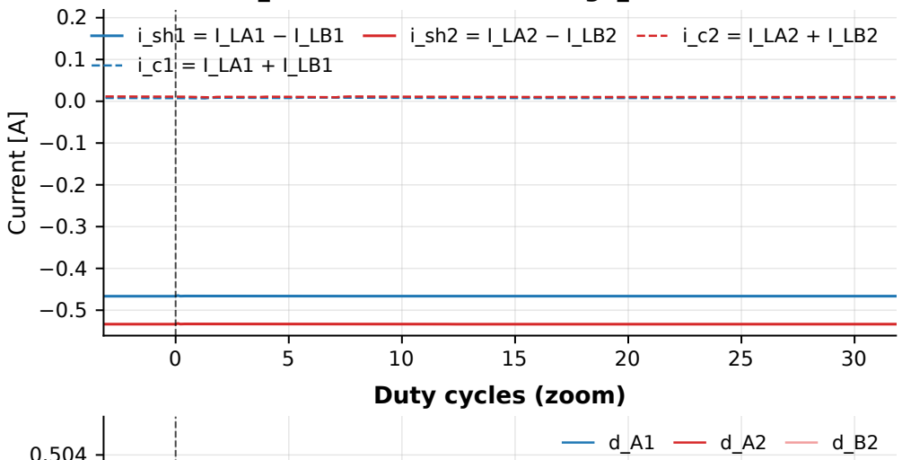
[picture p300: figure]
Current [A]; Duty cycles (zoom)
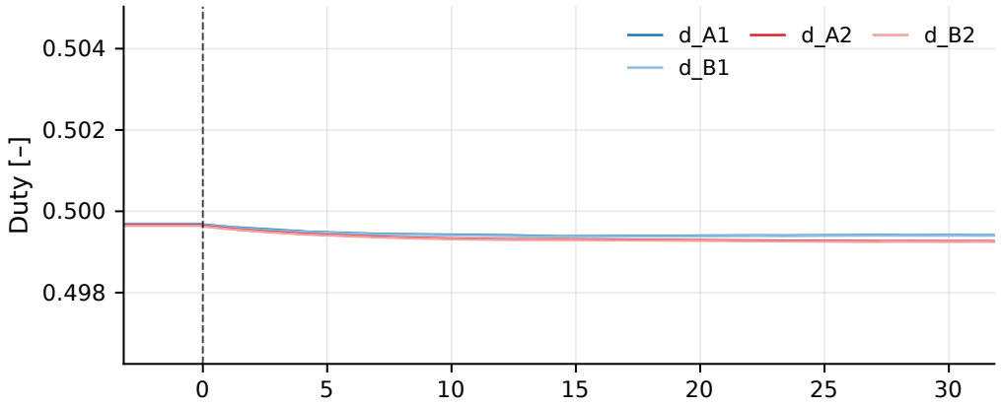
[picture p301: figure]
Duty [–]
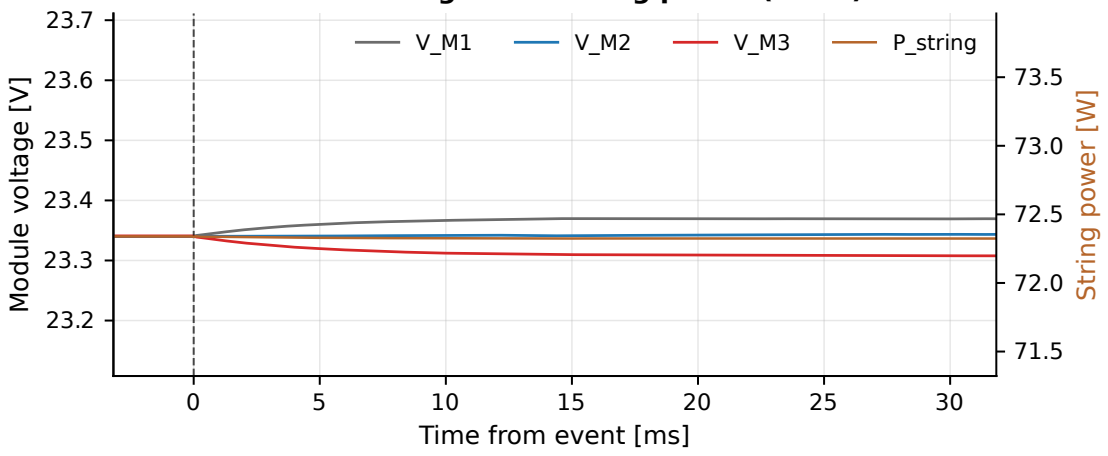
[picture p302: figure]
Time from event [ms]; Module voltage [V]; P_string; String power [W]

Module voltages and string power (zoom)

Simulink carpark twin (3 modules, averaged, 61 mΩ): loop_close — BENCH, kscale 0.2 (S1_close_BENCH_k0.2)
