saunders-jared-final/Boost-Brigade/8_Results/analysis/out/figures/carpark/S1_BENCH_k1.pdf

Voltage differences v_d (full run); dotted = reference

Voltage differences v_d (zoom); dotted = reference

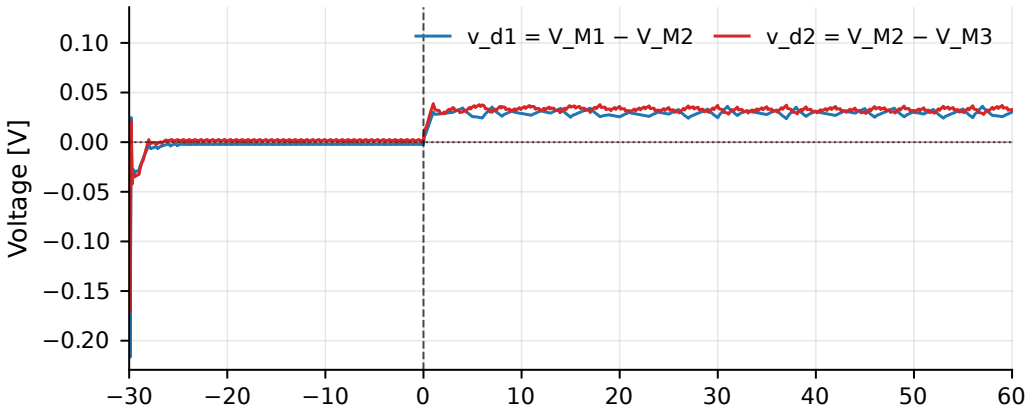
[picture p303: figure]
Voltage [V]

Shuffled i_sh (solid) and circulating i_c (dashed) (full run)

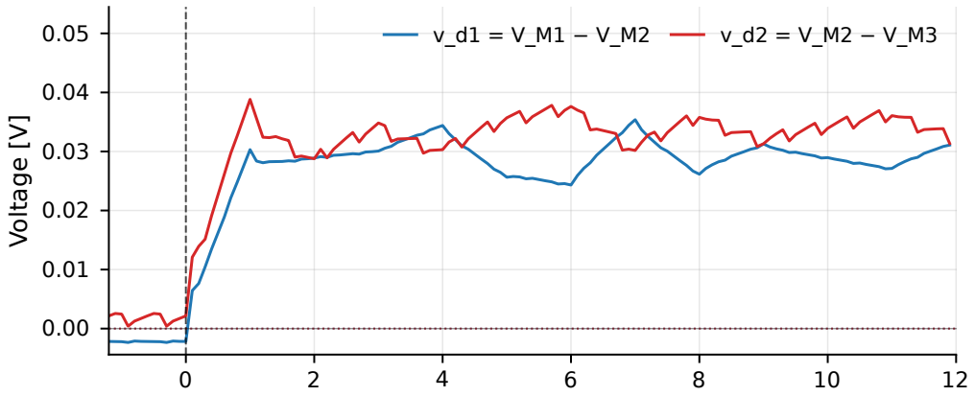
[picture p304: figure]
Voltage [V]

Shuffled i_sh (solid) and circulating i_c (dashed) (zoom)

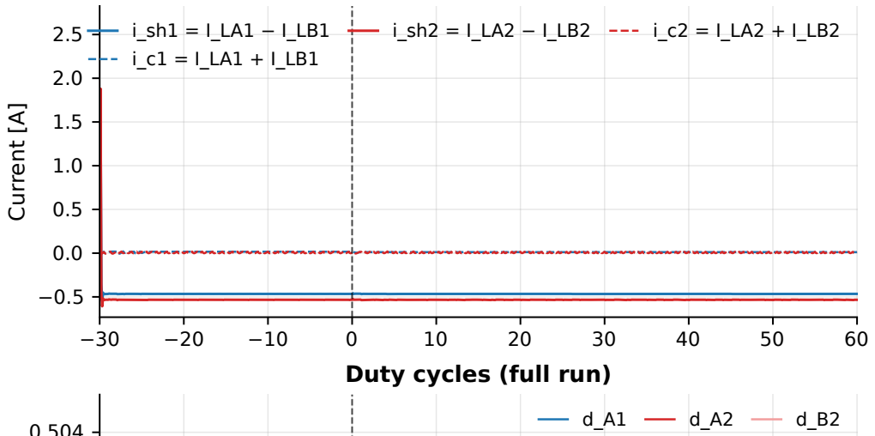
[picture p305: figure]
Current [A]; Duty cycles (full run)
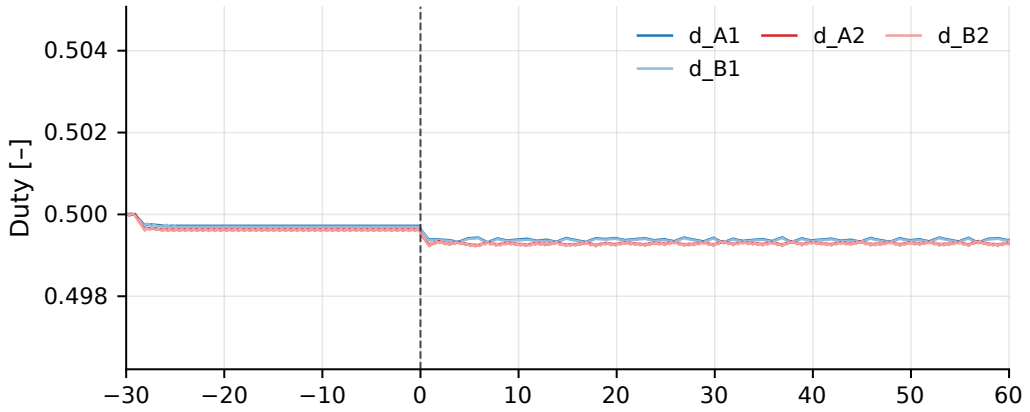
[picture p306: figure]
Duty [–]
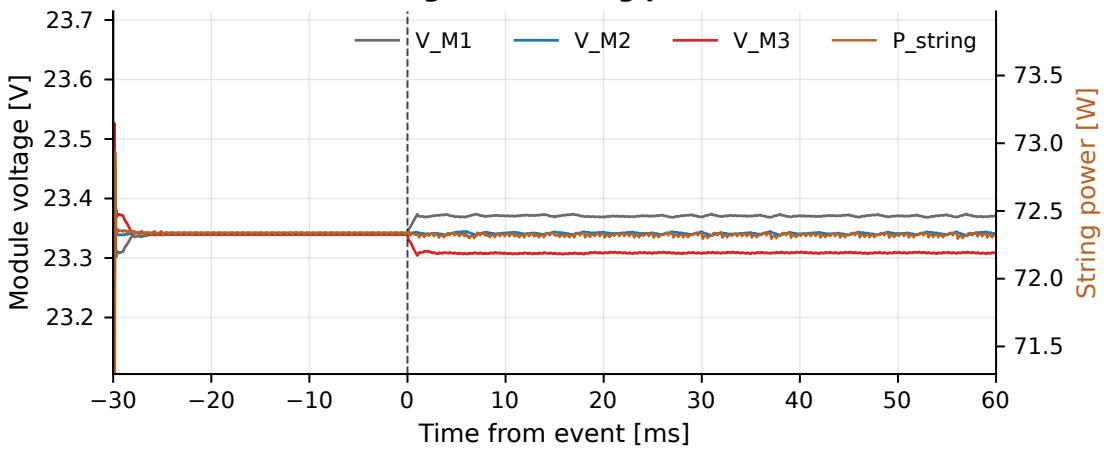
[picture p307: figure]
Time from event [ms]; Module voltage [V]; P_string; String power [W]

Module voltages and string power (full run)

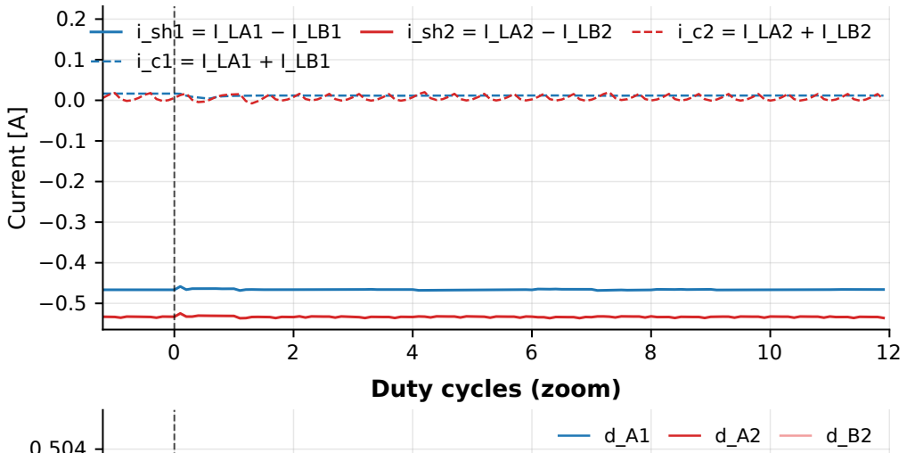
[picture p308: figure]
Current [A]; Duty cycles (zoom)
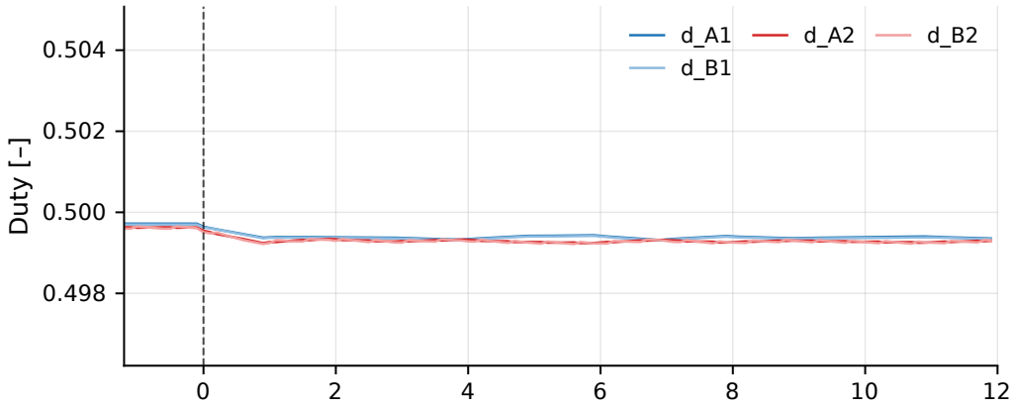
[picture p309: figure]
Duty [–]
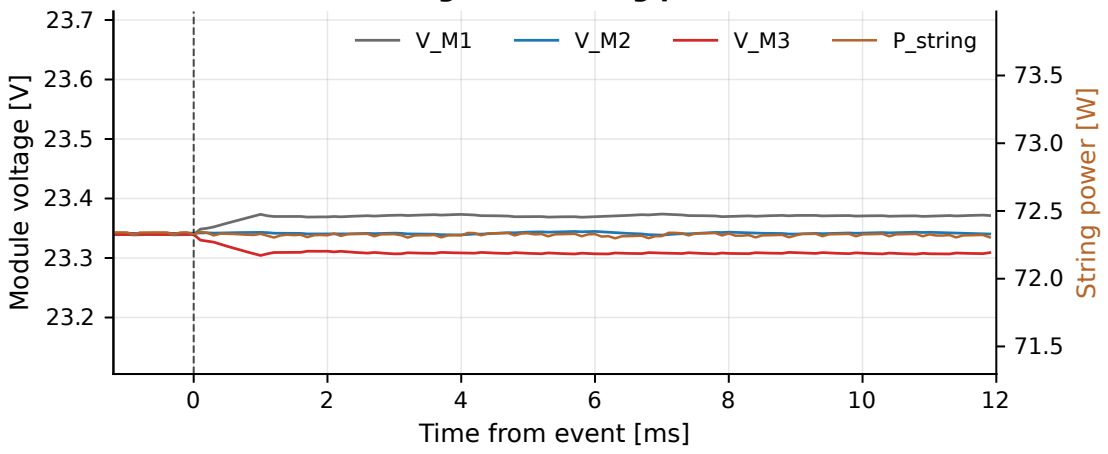
[picture p310: figure]
Time from event [ms]; Module voltage [V]; P_string; String power [W]

Module voltages and string power (zoom)

Simulink carpark twin (3 modules, averaged, 61 mΩ): loop_close — BENCH, kscale 1 (S1_close_BENCH_k1)
