saunders-jared-final/Boost-Brigade/8_Results/analysis/out/figures/carpark/S1_PV80_k0.2.pdf

−0.10

−0.05

0.00

0.05

0.10

Voltage [V]

Voltage differences v_d (full run); dotted = reference

v_d1 = V_M1 − V_M2 | v_d2 = V_M2 − V_M3
0 | 5 | 10 | 15 | 20 | 25 | 30

−0.00005

0.00000

0.00005

0.00010

0.00015

0.00020

Voltage [V]

Voltage differences v_d (zoom); dotted = reference

v_d1 = V_M1 − V_M2 v_d2 = V_M2 − V_M3

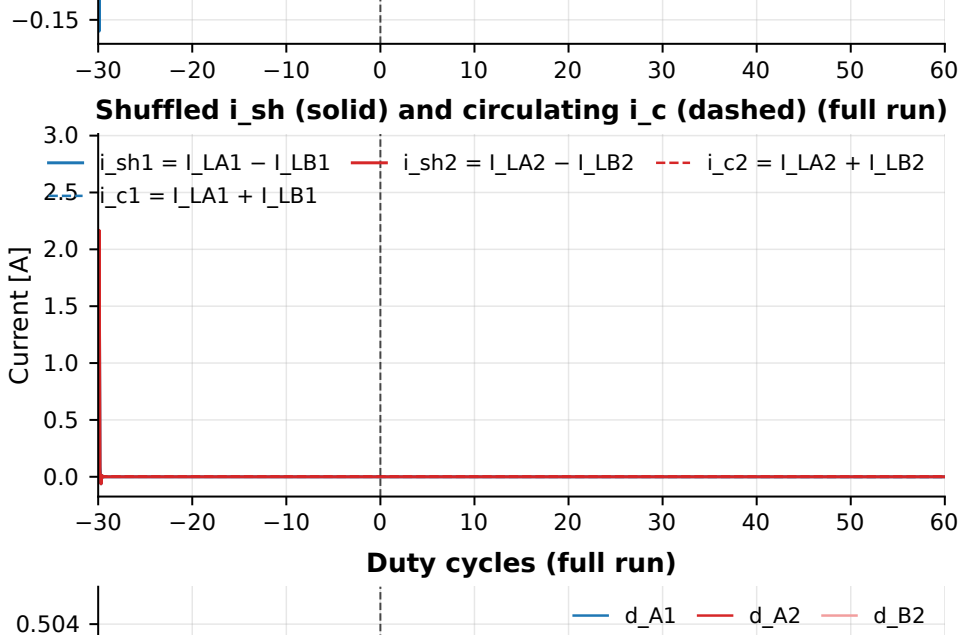
[picture p311: figure]
Current [A]; Duty cycles (full run)

Shuffled i_sh (solid) and circulating i_c (dashed) (full run)

0 | 5 | 10 | 15 | 20 | 25 | 30

−0.002

0.000

0.002

0.004
Current [A]

Shuffled i_sh (solid) and circulating i_c (dashed) (zoom)

i_sh1 = I_LA1 − I_LB1
i_c1 = I_LA1 + I_LB1
i_sh2 = I_LA2 − I_LB2 | i_c2 = I_LA2 + I_LB2
−30 | −20 | −10 | 0 | 10 | 20 | 30 | 40 | 50 | 60

0.497

0.498

0.499

0.500

0.501

0.502

0.503

0.504

Duty [–]

d_B1

0 | 5 | 10 | 15 | 20 | 25 | 30

0.497

0.498

0.499

0.500

0.501

0.502

0.503

0.504

Duty [–]

Duty cycles (zoom)

d_A1
d_B1
d_A2 | d_B2
−30 | −20 | −10 | 0 | 10 | 20 | 30 | 40 | 50 | 60
Time from event [ms]

20.4

20.5

20.6

20.7

20.8
Module voltage [V]

Module voltages and string power (full run)

V_M1 | V_M2 | V_M3 | P_string
0 | 5 | 10 | 15 | 20 | 25 | 30
Time from event [ms]

20.4

20.5

20.6

20.7

20.8
Module voltage [V]

Module voltages and string power (zoom)

V_M1 | V_M2 | V_M3 | P_string

264.0

264.5

265.0

265.5

266.0
String power [W]

264.0

264.5

265.0

265.5

266.0
String power [W]

Simulink carpark twin (3 modules, averaged, 61 mΩ): loop_close — PV80, kscale 0.2 (S1_close_PV80_k0.2)
