saunders-jared-final/Boost-Brigade/8_Results/analysis/out/figures/carpark/S3_PV80_k0.2.pdf

Voltage differences v_d (full run); dotted = reference

Voltage differences v_d (zoom); dotted = reference

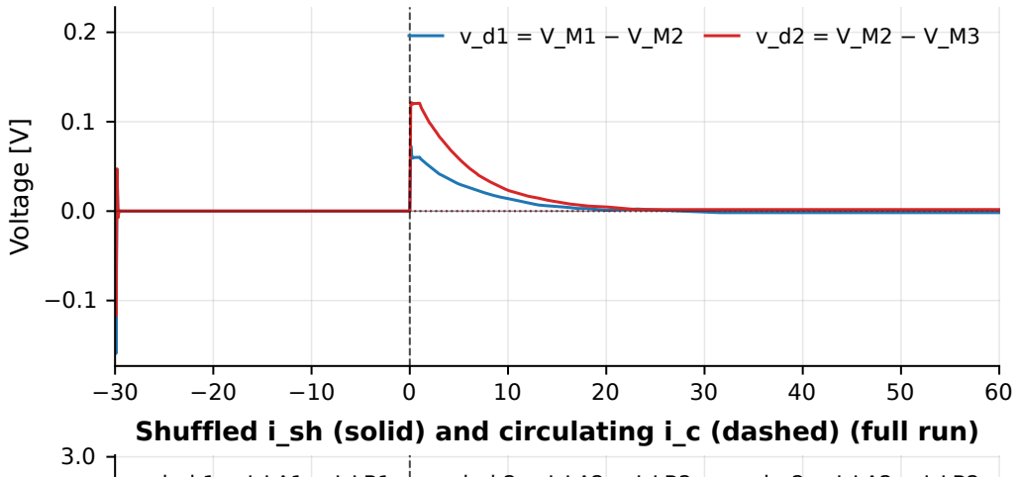
[picture p320: figure]
Voltage [V]

Shuffled i_sh (solid) and circulating i_c (dashed) (full run)

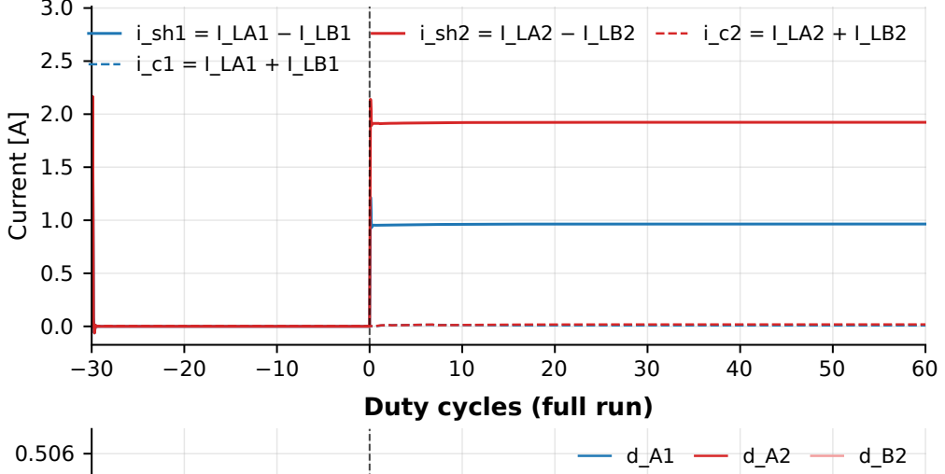
[picture p321: figure]
Current [A]; Duty cycles (full run)
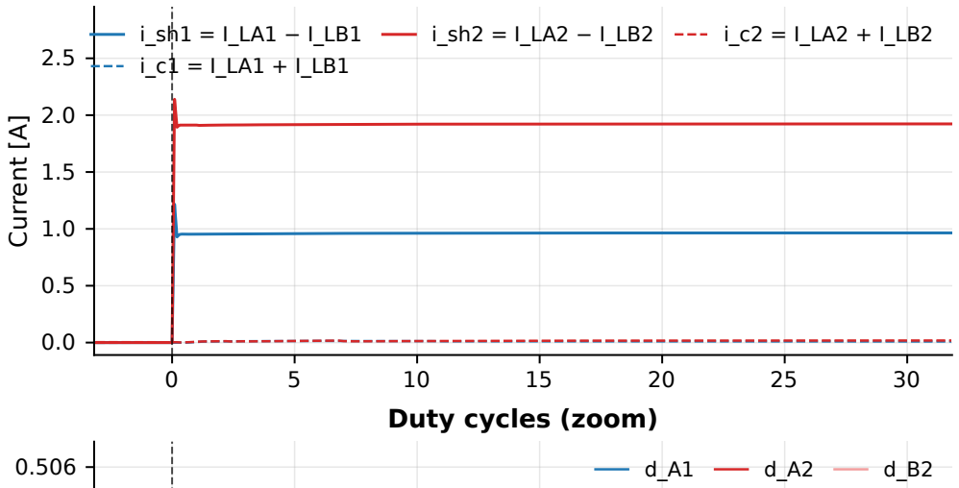
[picture p322: figure]
Current [A]; Duty cycles (zoom)

i_sh1 = I_LA1 − I_LB1 i_c1 = I_LA1 + I_LB1 | i_sh2 = I_LA2 − I_LB2 | i_c2 = I_LA2 + I_LB2

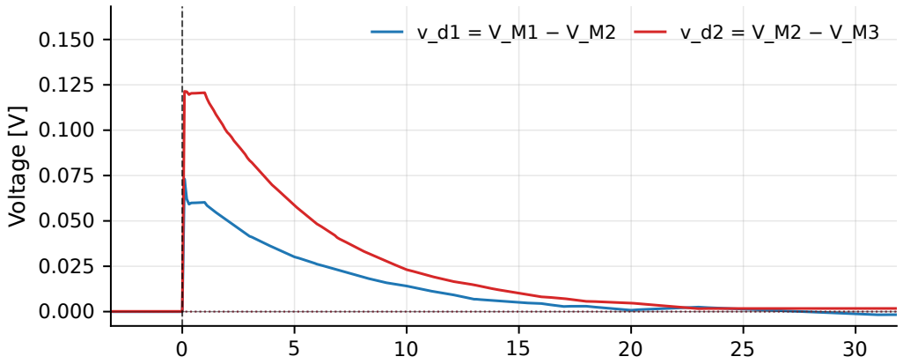
[picture p323: figure]
Voltage [V]

Shuffled i_sh (solid) and circulating i_c (dashed) (zoom)

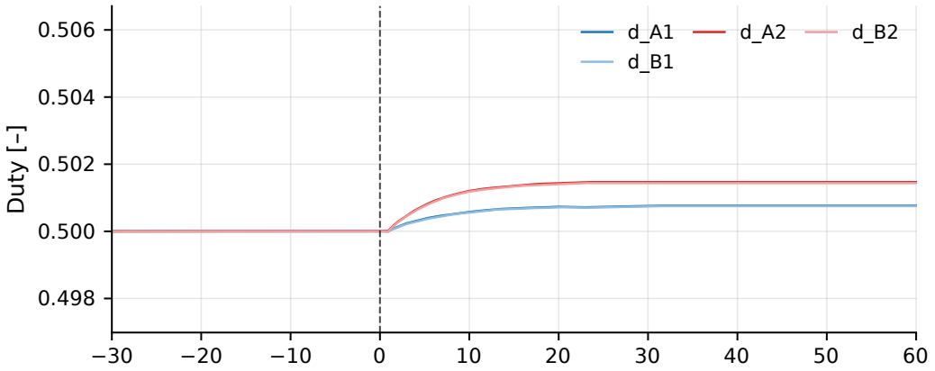
[picture p324: figure]
Duty [–]
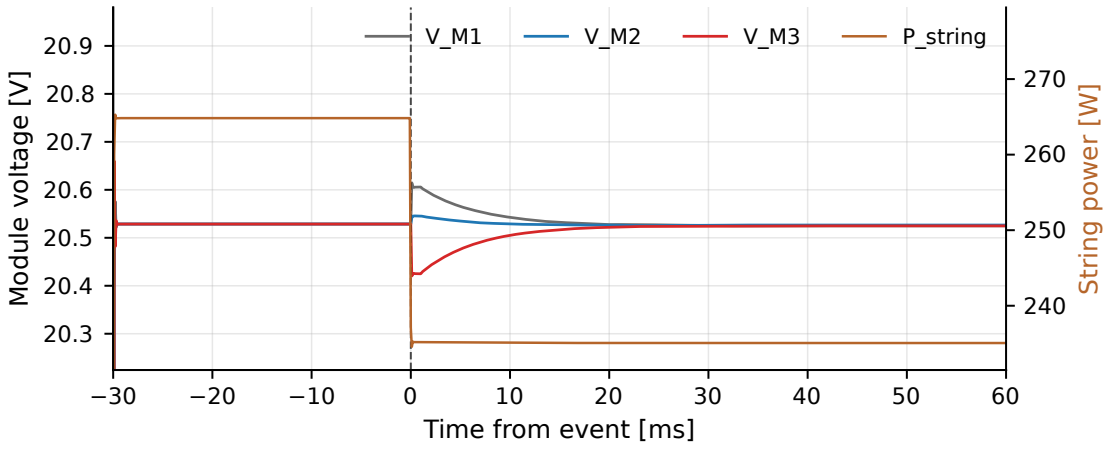
[picture p325: figure]
Time from event [ms]; Module voltage [V]; P_string; String power [W]

Module voltages and string power (full run)

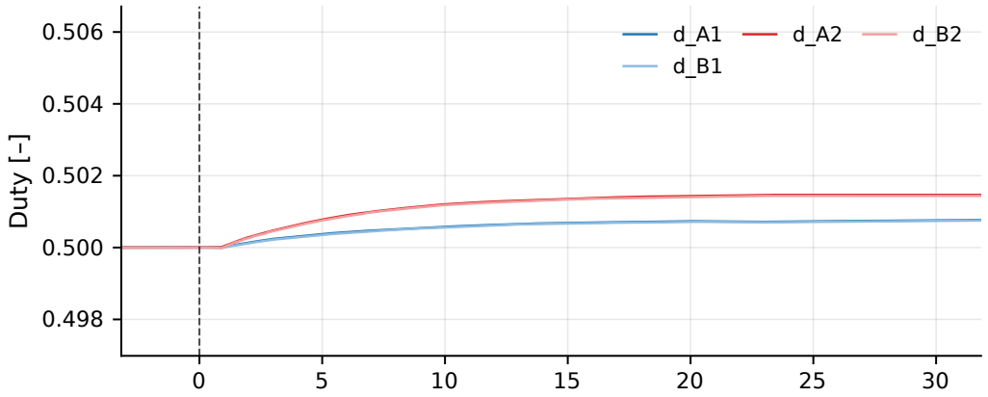
[picture p326: figure]
Duty [–]
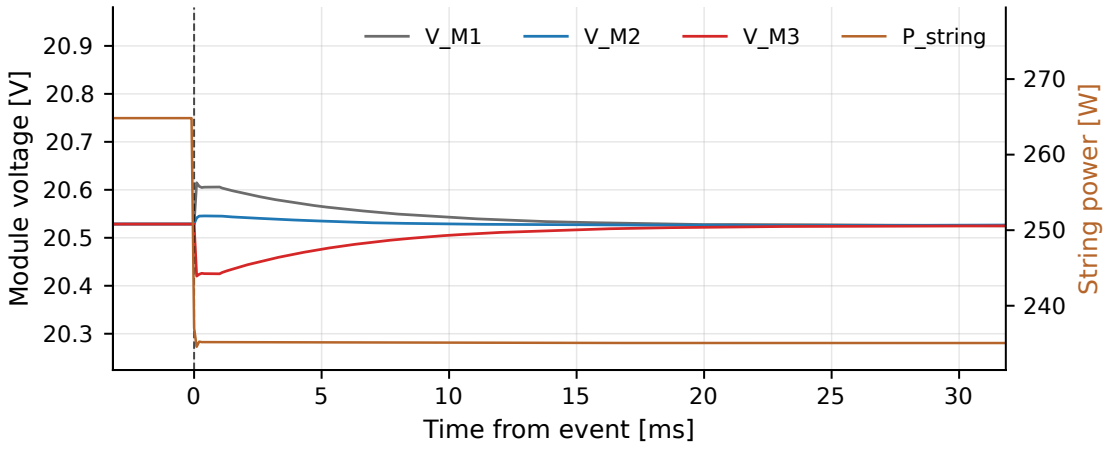
[picture p327: figure]
Time from event [ms]; Module voltage [V]; P_string; String power [W]

Module voltages and string power (zoom)

Simulink carpark twin (3 modules, averaged, 61 mΩ): shade_m3 — PV80, kscale 0.2 (S3_shade_PV80_k0.2)
