saunders-jared-final/Boost-Brigade/8_Results/analysis/out/figures/carpark/S4_BENCH_k0.2.pdf

Voltage differences v_d (full run); dotted = reference

Voltage differences v_d (zoom); dotted = reference

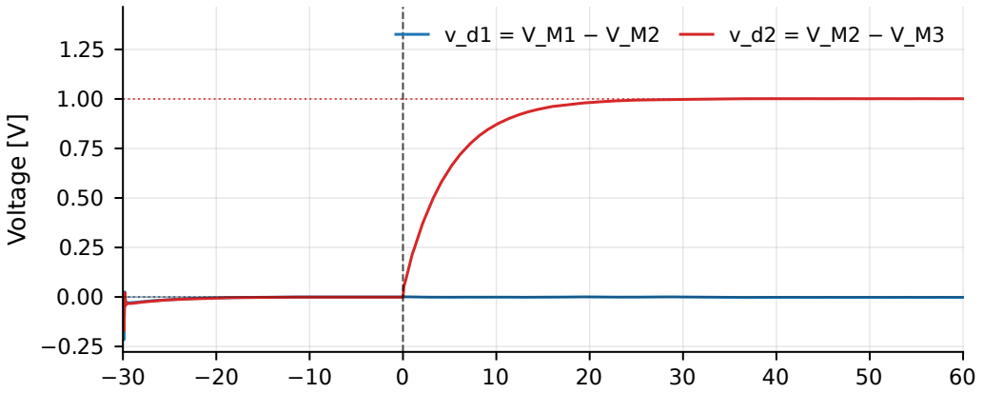
[picture p336: figure]
Voltage [V]

Shuffled i_sh (solid) and circulating i_c (dashed) (full run)

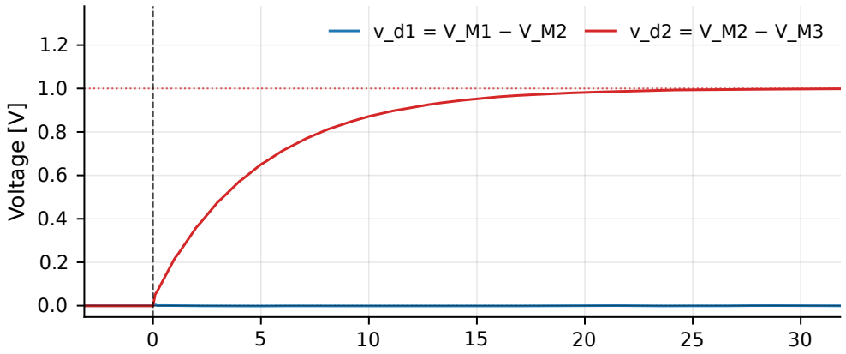
[picture p337: figure]
Voltage [V]

Shuffled i_sh (solid) and circulating i_c (dashed) (zoom)

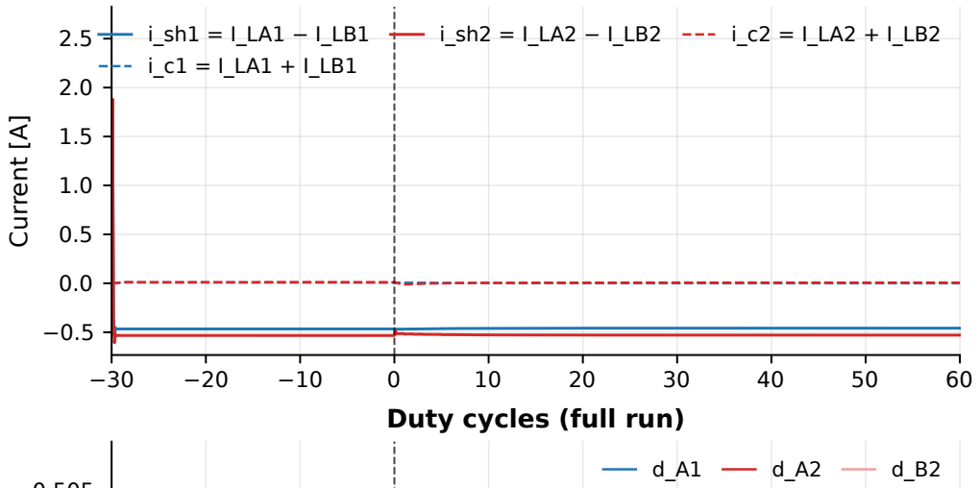
[picture p338: figure]
Current [A]; Duty cycles (full run)
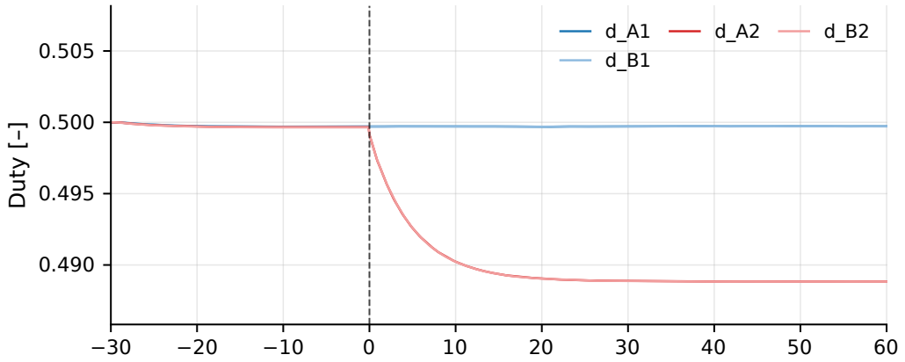
[picture p339: figure]
Duty [–]
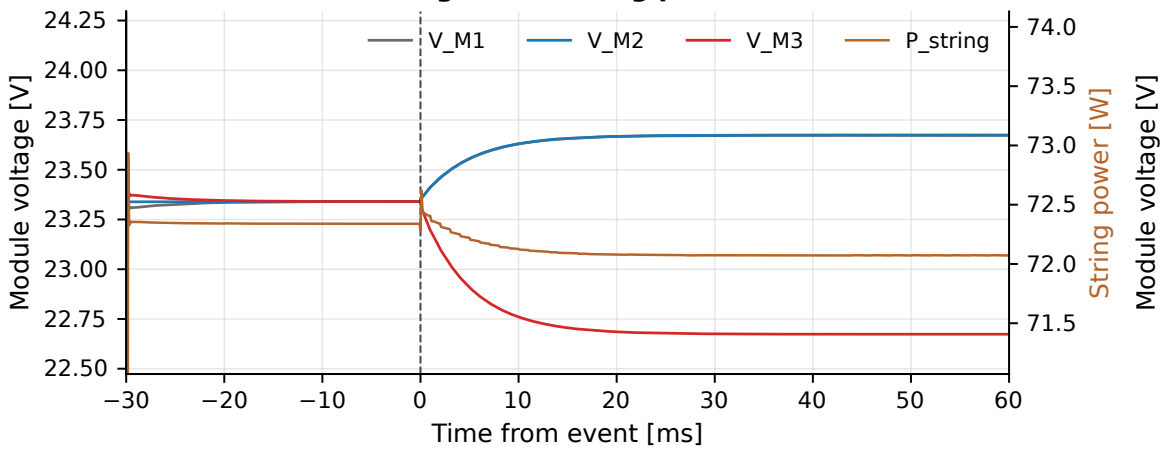
[picture p340: figure]
Time from event [ms]; Module voltage [V]; P_string; String power [W]

Module voltages and string power (full run)

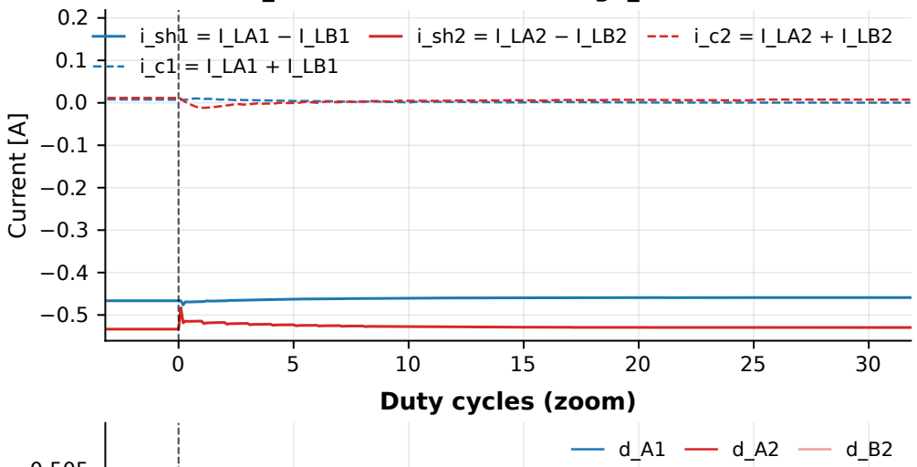
[picture p341: figure]
Current [A]; Duty cycles (zoom)
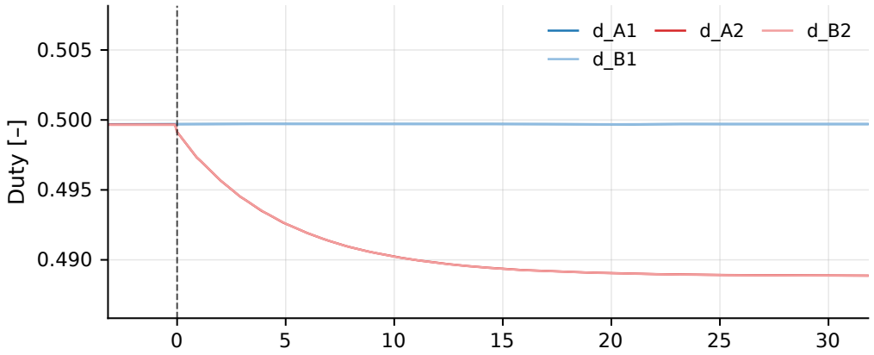
[picture p342: figure]
Duty [–]
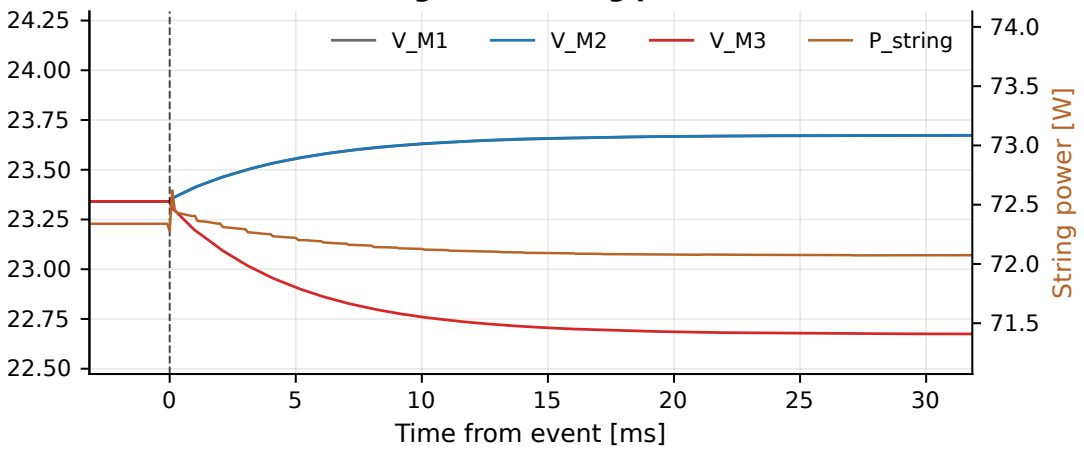
[picture p343: figure]
Time from event [ms]; P_string; String power [W]

Module voltages and string power (zoom)

Simulink carpark twin (3 modules, averaged, 61 mΩ): vref2_step — BENCH, kscale 0.2 (S4_vref_BENCH_k0.2)
