saunders-jared-final/Boost-Brigade/8_Results/analysis/out/figures/carpark/S4_PV80_k0.2.pdf

Voltage differences v_d (full run); dotted = reference

Voltage differences v_d (zoom); dotted = reference

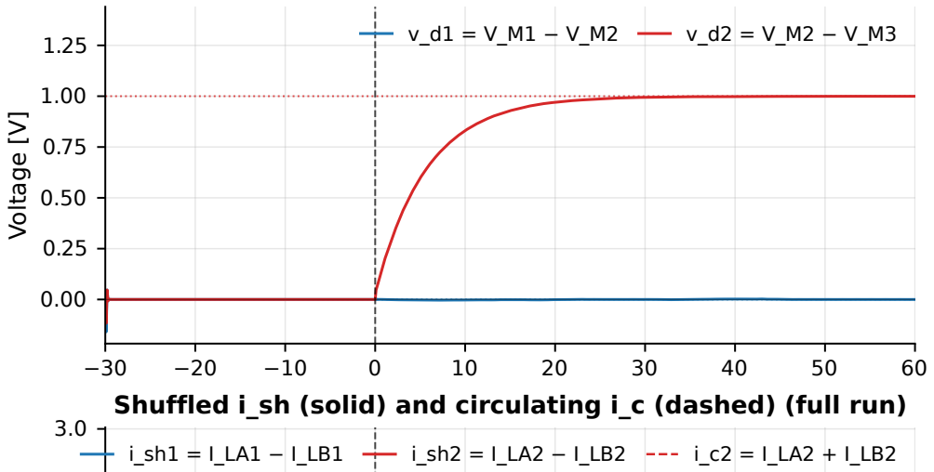
[picture p352: figure]
Voltage [V]

Shuffled i_sh (solid) and circulating i_c (dashed) (full run)

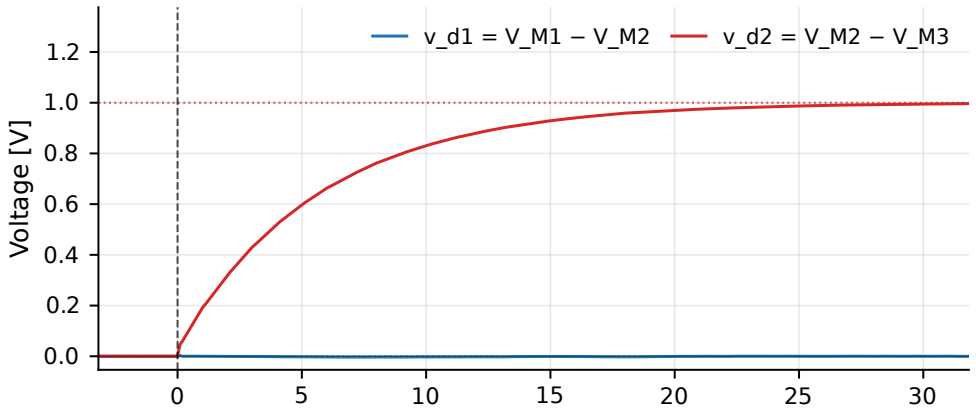
[picture p353: figure]
Voltage [V]

Shuffled i_sh (solid) and circulating i_c (dashed) (zoom)

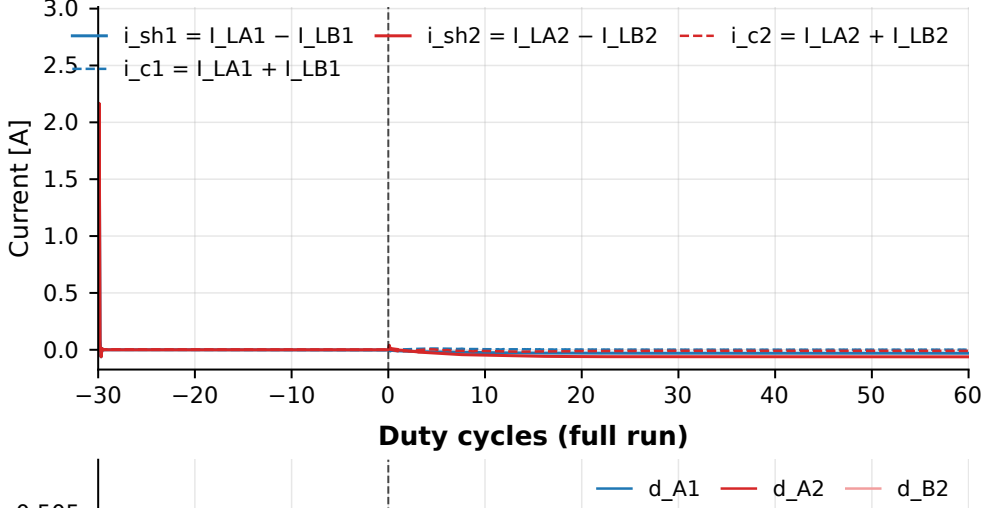
[picture p354: figure]
Current [A]; Duty cycles (full run)
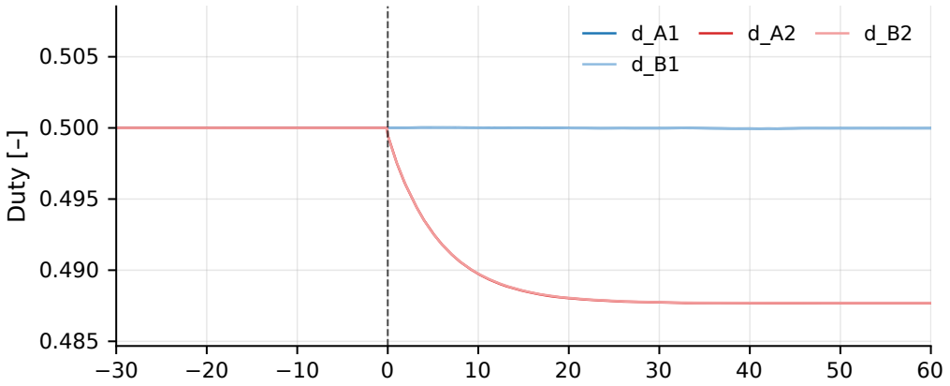
[picture p355: figure]
Duty [–]
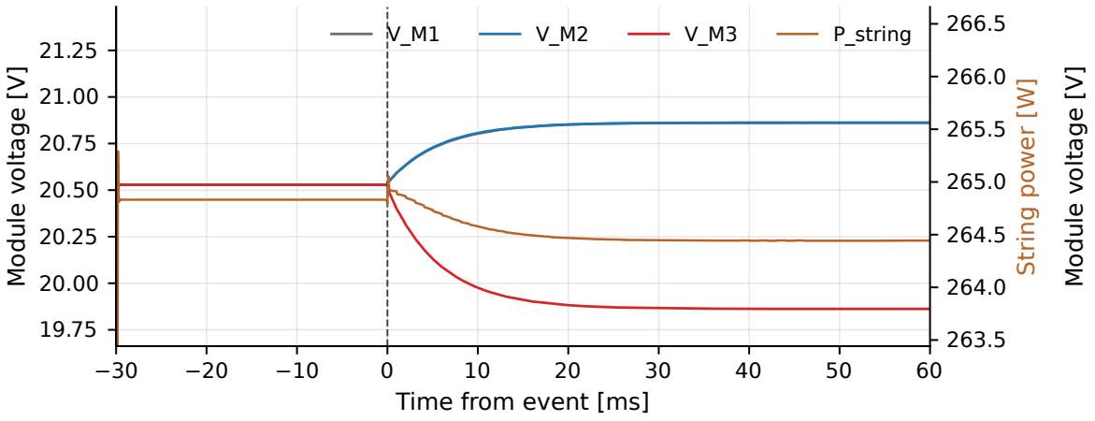
[picture p356: figure]
Time from event [ms]; Module voltage [V]; P_string; String power [W]

Module voltages and string power (full run)

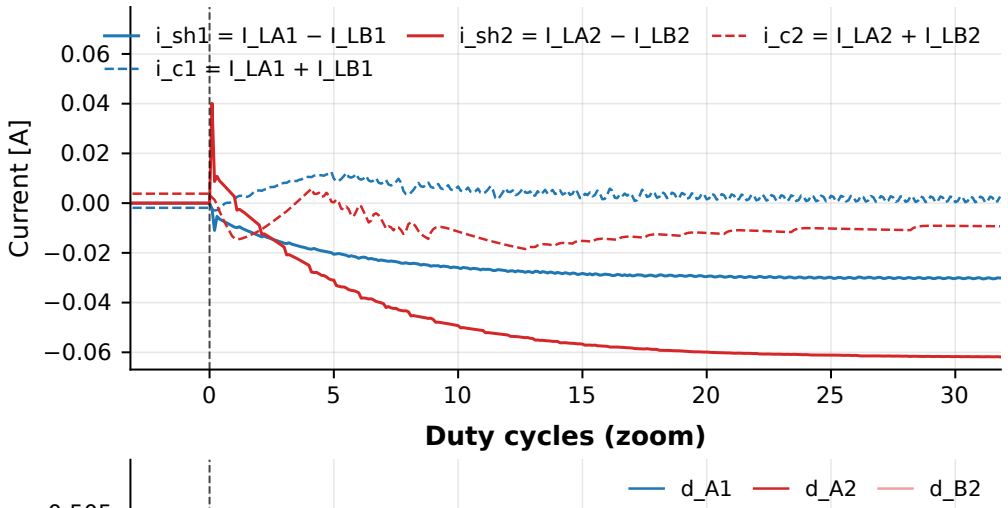
[picture p357: figure]
Current [A]; Duty cycles (zoom)
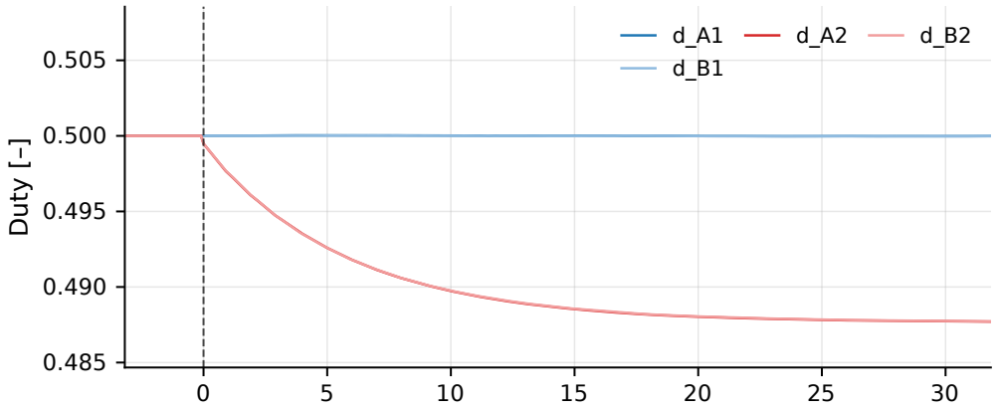
[picture p358: figure]
Duty [–]
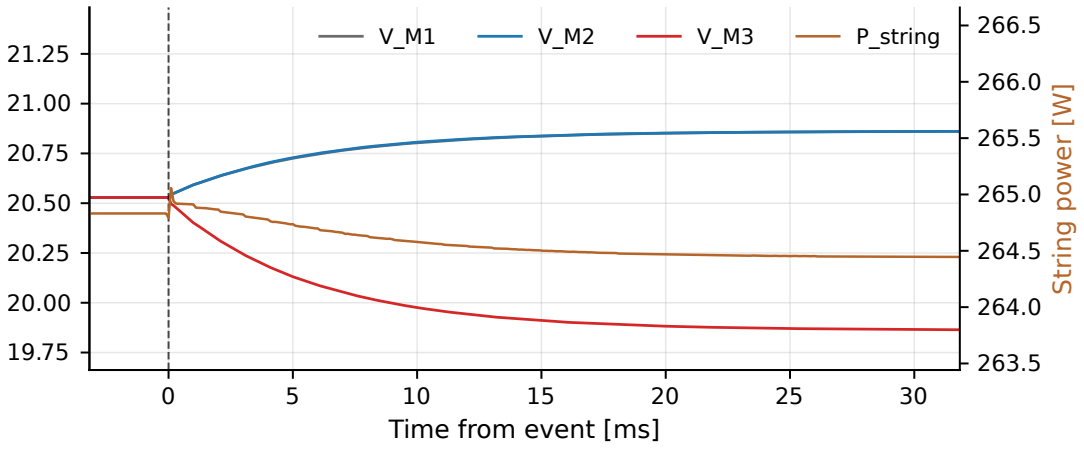
[picture p359: figure]
Time from event [ms]; P_string; String power [W]

Module voltages and string power (zoom)

Simulink carpark twin (3 modules, averaged, 61 mΩ): vref2_step — PV80, kscale 0.2 (S4_vref_PV80_k0.2)
