saunders-jared-final/Boost-Brigade/8_Results/analysis/out/figures/carpark_validate/02_decoupling.pdf

Voltage differences v_d (full run); dotted = reference

Voltage differences v_d (zoom); dotted = reference

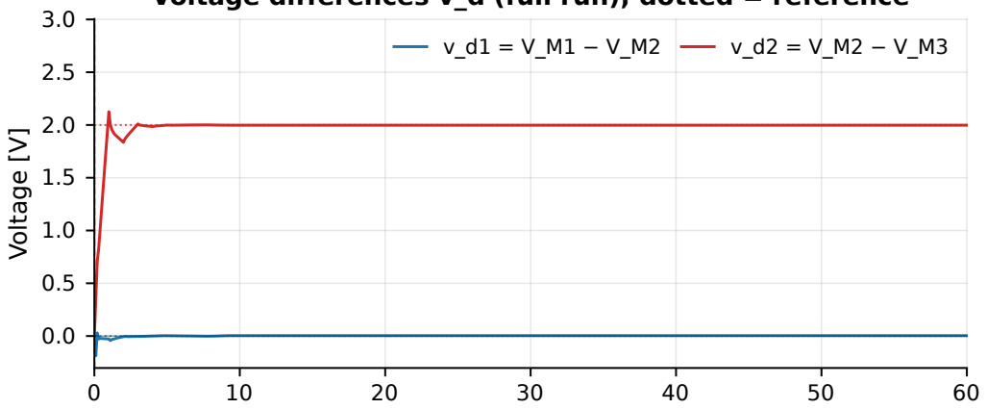
[picture p360: figure]
Voltage [V]

Shuffled i_sh (solid) and circulating i_c (dashed) (full run)

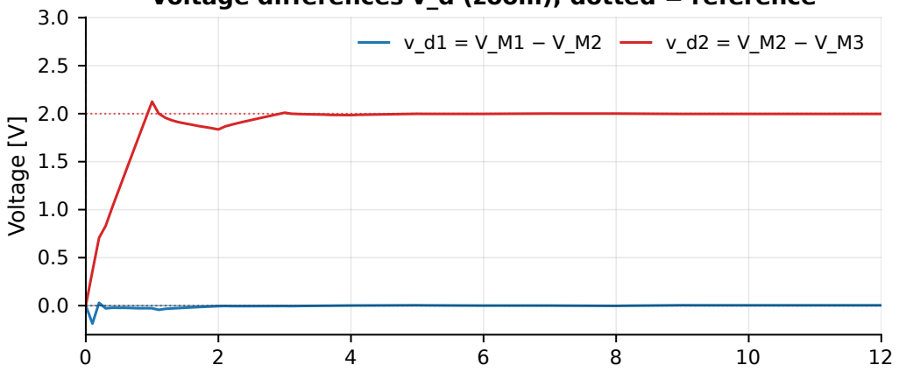
[picture p361: figure]
Voltage [V]

Shuffled i_sh (solid) and circulating i_c (dashed) (zoom)

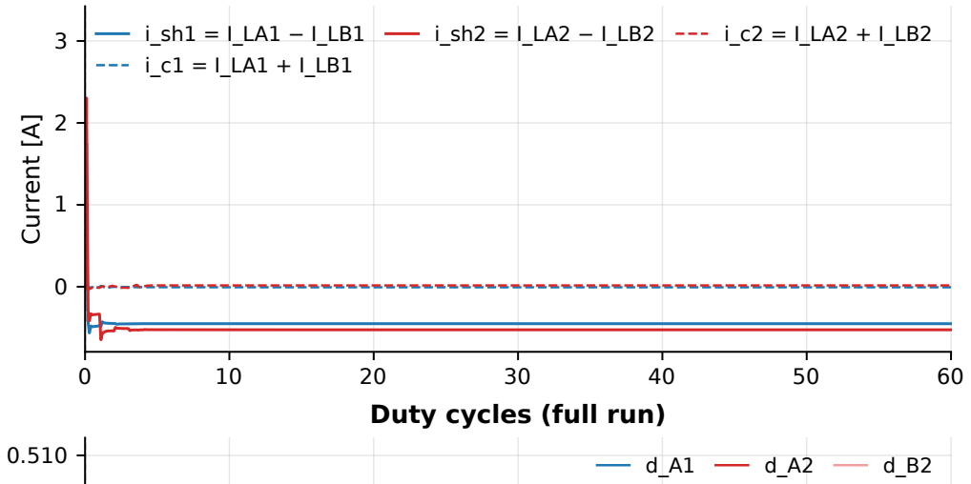
[picture p362: figure]
Current [A]; Duty cycles (full run)
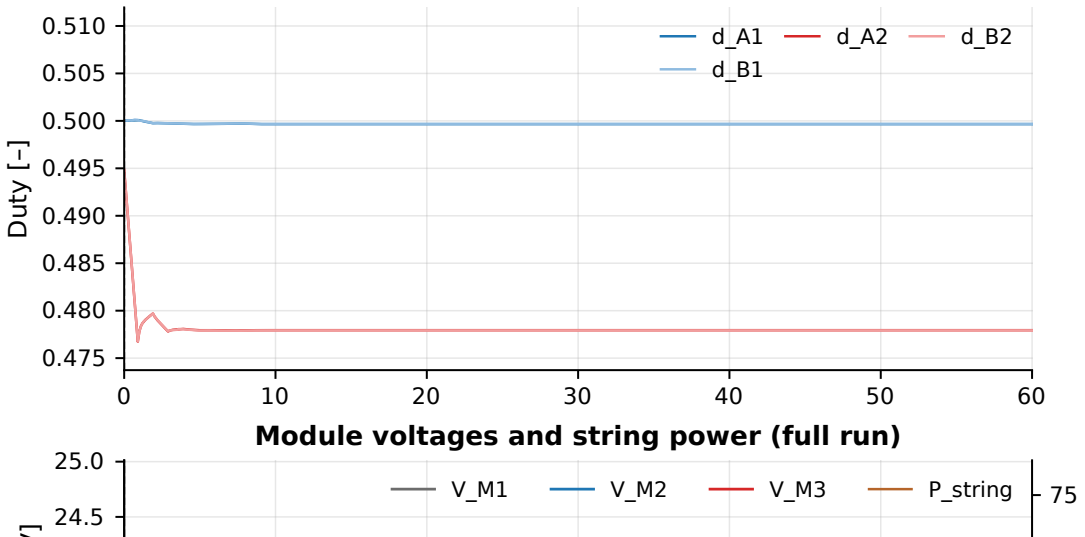
[picture p363: figure]
Duty [–]; P_string
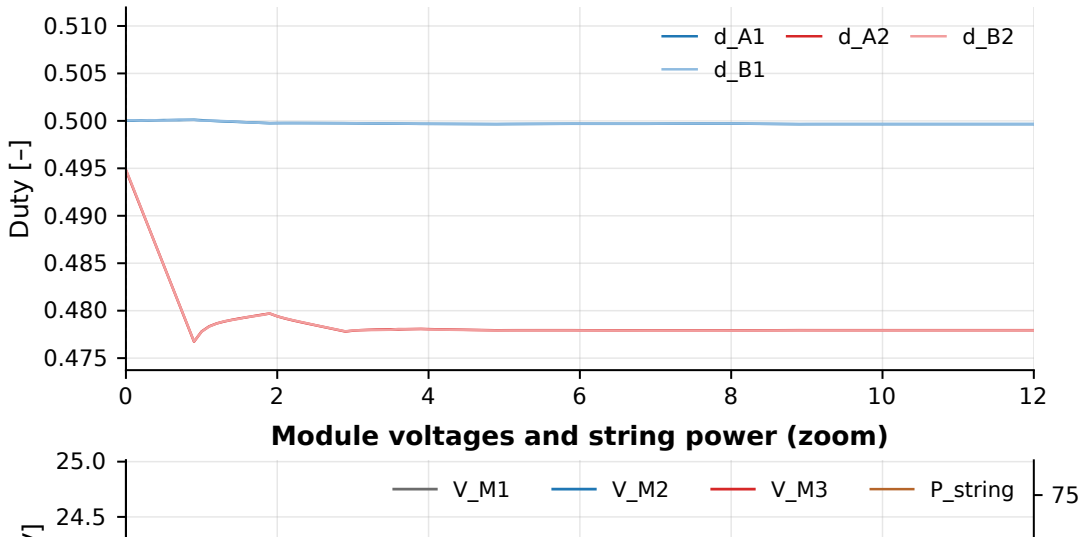
[picture p364: figure]
Duty [–]; Module voltages and string power (zoom); P_string

Module voltages and string power (full run)

Carpark validate suite (3 modules): decoupling — last module 1000 W/m², refs [0, 2], track, PASS; cold start, kscale 1

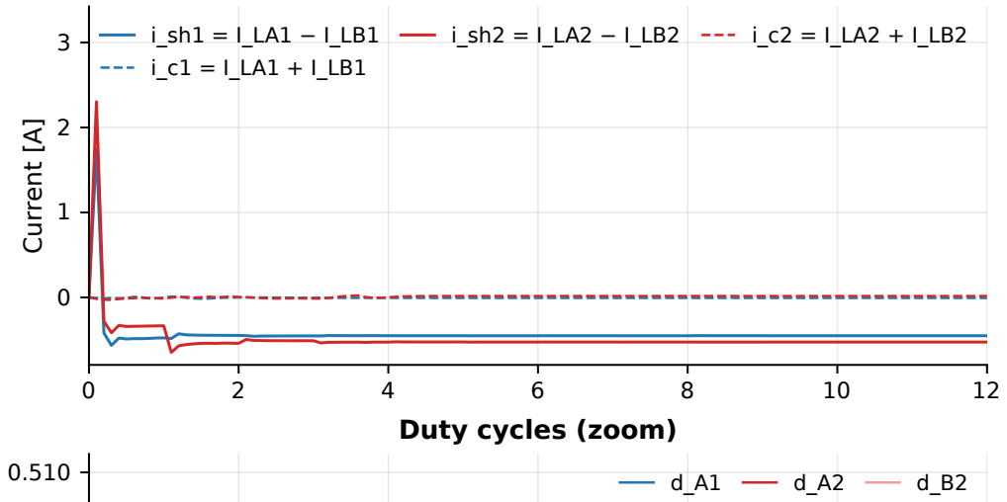
[picture p365: figure]
Current [A]; Duty cycles (zoom)
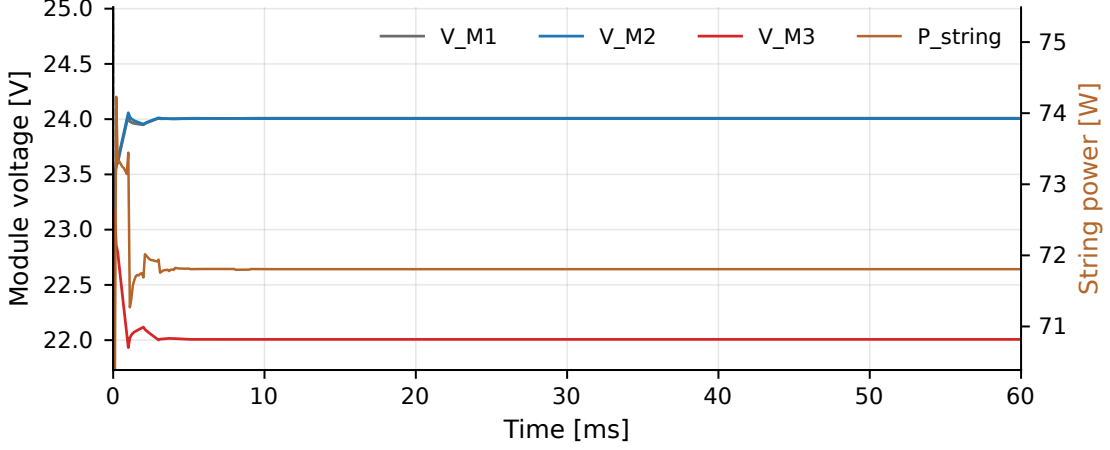
[picture p366: figure]
Time [ms]; Module voltage [V]; String power [W]
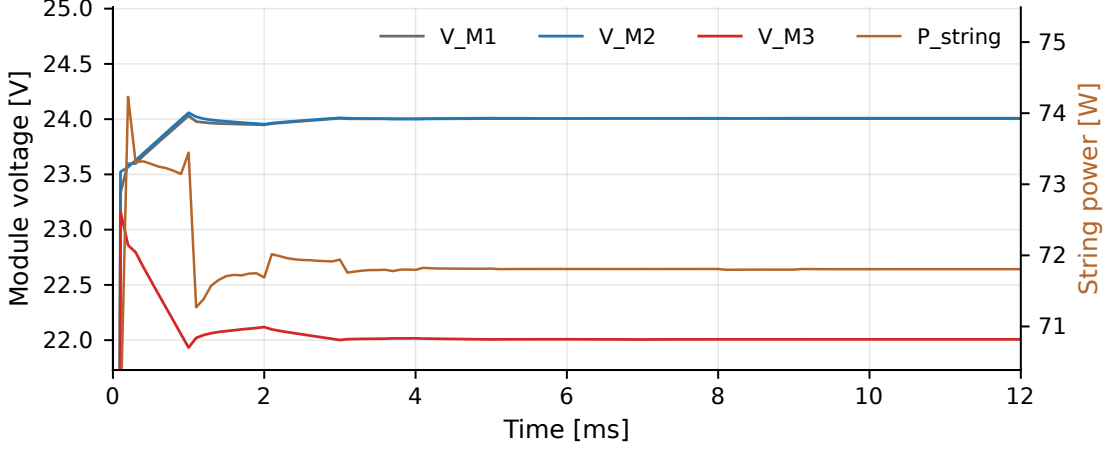
[picture p367: figure]
Time [ms]; Module voltage [V]; String power [W]
