saunders-jared-final/Boost-Brigade/8_Results/analysis/out/figures/compare/metrics_vs_kscale.pdf

### Fitted time constant τ of v_d2, +1 V reference step

### Rise time 10–90 % of v_d2, +1 V reference step

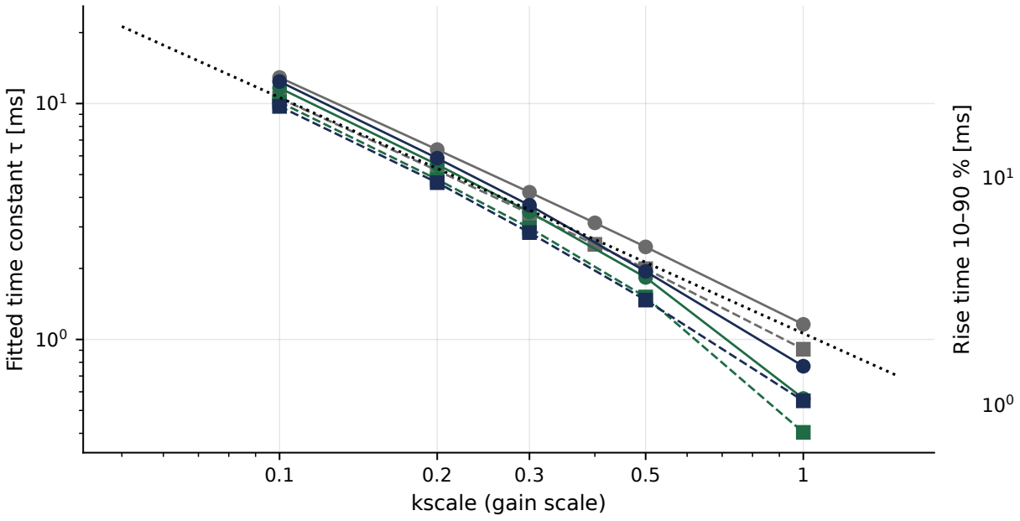
[picture p368: figure]
kscale (gain scale); Fitted time constant τ [ms]; Rise time 10–90 % [ms]

Settling time, 2 % band [ms]

### Settling time, 2 % band of v_d2, +1 V reference step

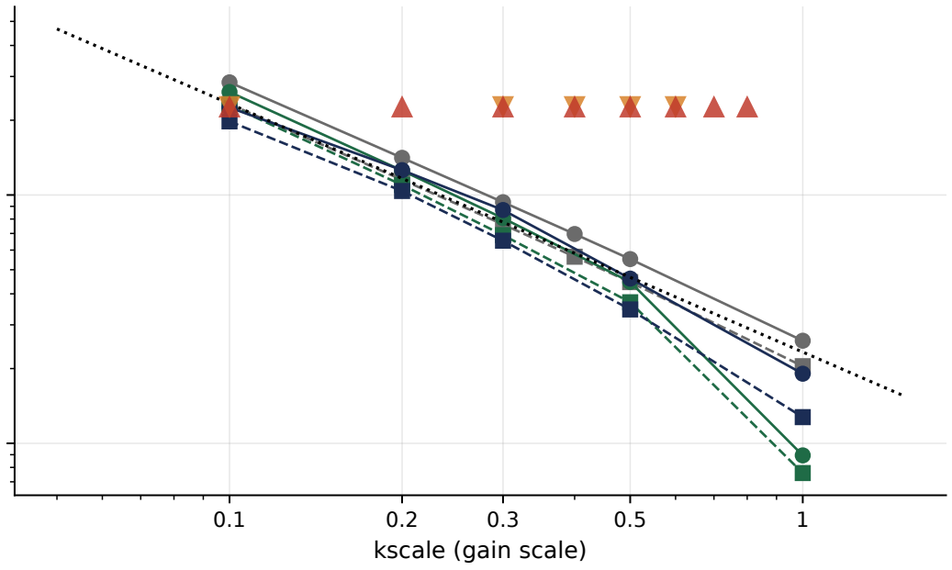
[picture p369: figure]
kscale (gain scale)

### Overshoot of v_d2, +1 V reference step

Closed-loop step metrics of v_d2 vs gain scale (200 kHz gain set); hardware cannot resolve the loop's own transient

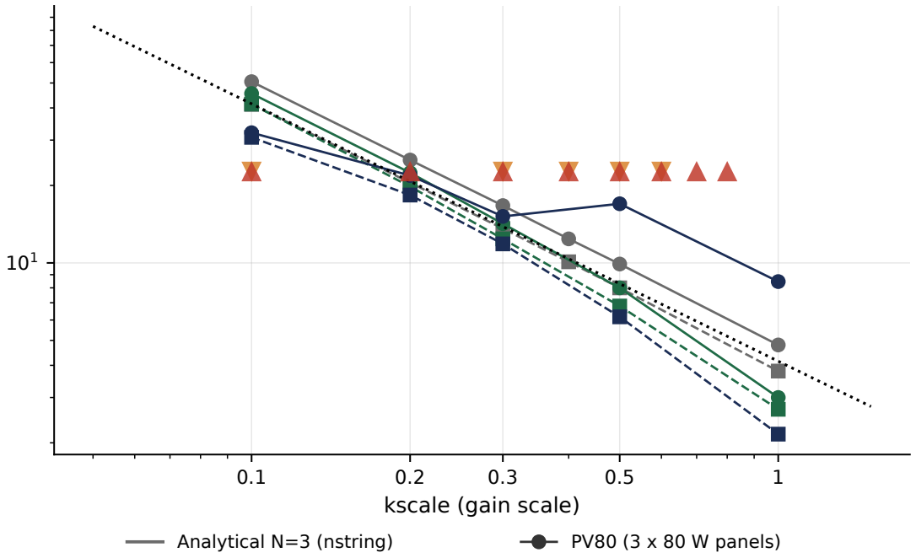
[picture p370: figure]
kscale (gain scale); Analytical N=3 (nstring); PV80 (3 x 80 W panels)

Simulink carpark twin (3 modules) QSPICE switching + firmware DLL

BENCH (3 PSU channels in current limit) design: first order, kI = 2π·150 rad/s

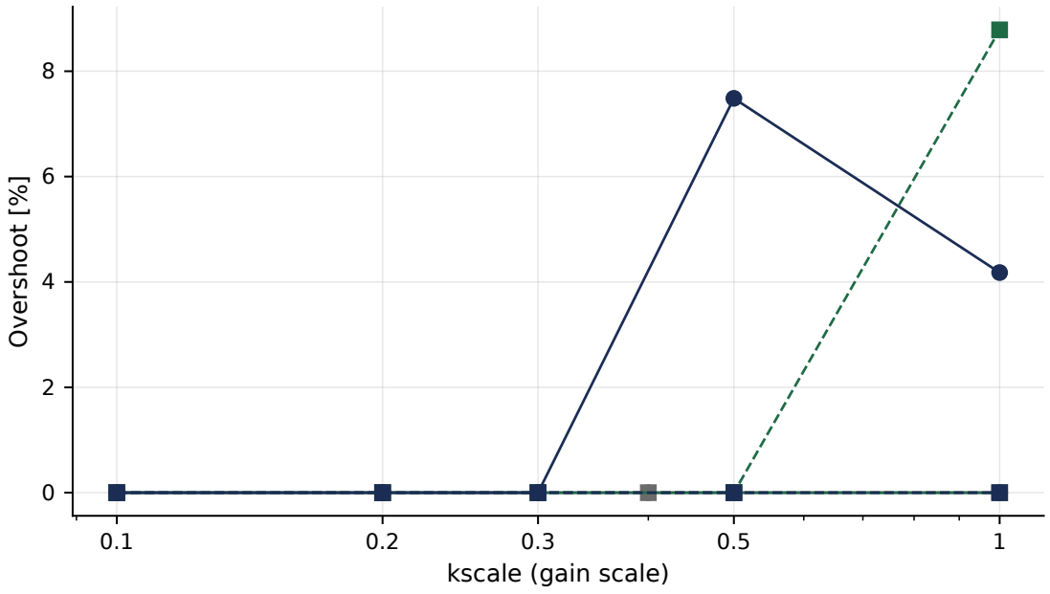
[picture p371: figure]
kscale (gain scale); Overshoot [%]

hardware bench, loop close: ≤ one telemetry sample (23 ms) — upper bound hardware carpark PV, loop close: ≤ one telemetry sample — upper bound
