saunders-jared-final/Boost-Brigade/0_Documentation/Bench Test Day.txt

Bench Test Day

VM1 / CS3 can not be used in the control system but can be used to observe. Noisy from no decoupling and is negative.

14:32:00 - Open Loop Test (50%)
15:08:00 - Open Loop - (S1, 0.5), (S2, 0.49)
15:11:00 - Open Loop - (S1, 0.5), (S2, 0.49)
15:13:00 - Open Loop - (S1, 0.49), (S2, 0.5)
15:14:00 - Open Loop - (S1, 0.51), (S2, 0.5)

15:28:00 - Closed Bench - Gain 10%
15:35:00 - Closed Bench - Gain 30%
15:44:00 - Closed Bench - Gain 20%

Gain 10% lasted the longest. Eventually psu freaks out.

15:50:00 - Closed Bench Gain 20% worked

16:02:00 - Closed Bench Gain 20% with ADC phase b reduction

16:07:00 - Closed Bench 30%

16:30:00 - Open Loop 300 kHz

17:17:00 - Closed Gain 30% 300 kHz

17:34:00 - Closed Gain 50% 300 kHz

18:00:00 - Closed Gain 30% 400 kHz
