saunders-jared-final/Boost-Brigade/2_Qspice/Claude's outputs/PCB_Baseline/results/baseline_table.md

# Baseline results (generated by run_baseline.py)

## S10i4d1

| measurement | step 1 | step 2 | step 3 | step 4 | step 5 |
|---|---|---|---|---|---|
| y1 | -0.694 | -1.548 | -0.7268 | -0.9001 | -0.711 |
| y2 | -0.7855 | -0.7844 | -1.662 | -0.7999 | -1.013 |
| y3 | 0.001493 | -0.0004217 | -0.0006179 | 0.5253 | 0.002015 |
| y4 | 0.00157 | -0.0012 | -0.0003019 | 0.005714 | 0.5213 |
| ish1 | -0.4688 | -0.4666 | -0.4737 | -0.4685 | -0.4691 |
| ish2 | -0.5326 | -0.5273 | -0.5343 | -0.5323 | -0.5324 |
| vm1 | 22.63 | 22.06 | 22.31 | 22.48 | 22.54 |
| i1 | 0.8 | 0.8 | 0.8 | 0.8 | 0.8 |
| vm2 | 23.32 | 23.61 | 23.04 | 23.38 | 23.25 |
| i2 | 1 | 1 | 1 | 1 | 1 |
| vm3 | 24.11 | 24.39 | 24.7 | 24.18 | 24.26 |
| i3 | 1.3 | 1.3 | 1.3 | 1.3 | 1.3 |
| vstr | 70.05 | 70.05 | 70.05 | 70.05 | 70.05 |
| istr | 1.036 | 1.039 | 1.04 | 1.036 | 1.036 |
| vsa2avg | -0.2655 | -0.2643 | -0.2673 | -0.2633 | -0.005561 |
| vsa2max | 0.8546 | 0.8828 | 0.9773 | 0.869 | 1.232 |
| vsa2min | -1.421 | -1.425 | -1.557 | -1.427 | -1.193 |
| vsa2rms | 0.68 | 0.6864 | 0.6947 | 0.6804 | 0.6343 |
| vsb2avg | -0.2671 | -0.2631 | -0.267 | -0.269 | -0.5268 |
| vsb2max | 0.8525 | 0.8715 | 0.9854 | 0.8661 | 0.5822 |
| vsb2min | -1.43 | -1.436 | -1.538 | -1.426 | -1.774 |
| vsb2rms | 0.6806 | 0.6859 | 0.6945 | 0.6837 | 0.8205 |
