saunders-jared-final/Boost-Brigade/MATLAB/1_Simulink_Experiment/figures/PV_Module_Summary.pdf

Model vs Datasheet — Percentage Error

-0.04%

0.03%

-0.30%

-0.03%

| 0.06%

-0.00%

| 0.58%

0.32%

Error [%]

-2 | -1.5 | -1 | -0.5 | 0 | 0.5 | 1 | 1.5 | 2

IscSTC

VocSTC

Pmpp
STC

Vmpp
STC

Impp
STC

PmppNOCT

VmppNOCT

ImppNOCT
