saunders-jared-final/Boost-Brigade/MATLAB/1_Simulink_Experiment/StringGains.xlsx

Run | Mode | dA | dB | Vdiff1 | Vdiff2 | Vdiff3 | Icomm1 | Icomm2 | Icomm3
0 | Baseline | 0.5 | 0.5 | 3.34 | 0 | 0 | 0 | 0 | 0
1 | Common | 0.52 | 0.52 | 0.59 | 1.59 | 0 | 0 | 0 | 0
2 | Common | 0.52 | 0.52 | 2.07 | -1.48 | 1.48 | 0 | 0 | 0
3 | Common | 0.52 | 0.52 | 2.07 | 0 | -1.48 | 0 | 0 | 0
4 | Differential | 0.52 | 0.48 | 84.38 | 0.7275 | 0 | -1600 | 0 | 0
5 | Differential | 0.52 | 0.48 | 1.4 | 0 | 0.7145 | 0 | -1600 | 0
6 | Differential | 0.52 | 0.48 | 2.1 | -0.72 | 0 | 0 | 0 | -1600
Run | Mode | dA | dB | Vdiff1 | Vdiff2 | Vdiff3 | Icomm1 | Icomm2 | Icomm3
0 | Baseline | 0.5 | 0.5 | 0 | 0 | 0 | 0 | 0 | 0
1 | Common | 0.52 | 0.52 | -2.83 | 0.06 | 0.2 | 0 | 0 | 0
2 | Common | 0.52 | 0.52 | 0.005 | -2.93 | 0.19 | 0 | 0 | 0
3 | Common | 0.52 | 0.01 | 0.005 | -2.85 | -1.48 | 0 | 0 | 0
4 | Differential | 0.52 | 0.48 | 1.55 | 0 | 1.46 | -51.67 | 0 | 0
5 | Differential | 0.52 | 0.48 | -1.4 | -1.37 | 0.16 | 0 | -48.65 | 0
6 | Differential | 0.52 | 0.48 | 0.01 | -1.46 | -1.3 | 0 | 0 | -49.46
Run | Mode | dA | dB | Vdiff1 | Vdiff2 | Vdiff3 | Idiff1 | Idiff2 | Idiff3
0 | Baseline | 0.5 | 0.5 | 0 | 0 | 0 | 0 | 0 | 0
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
