saunders-jared-final/Boost-Brigade/2_Qspice/Gate Driver/Claude output/check/view_testbench_whole.png

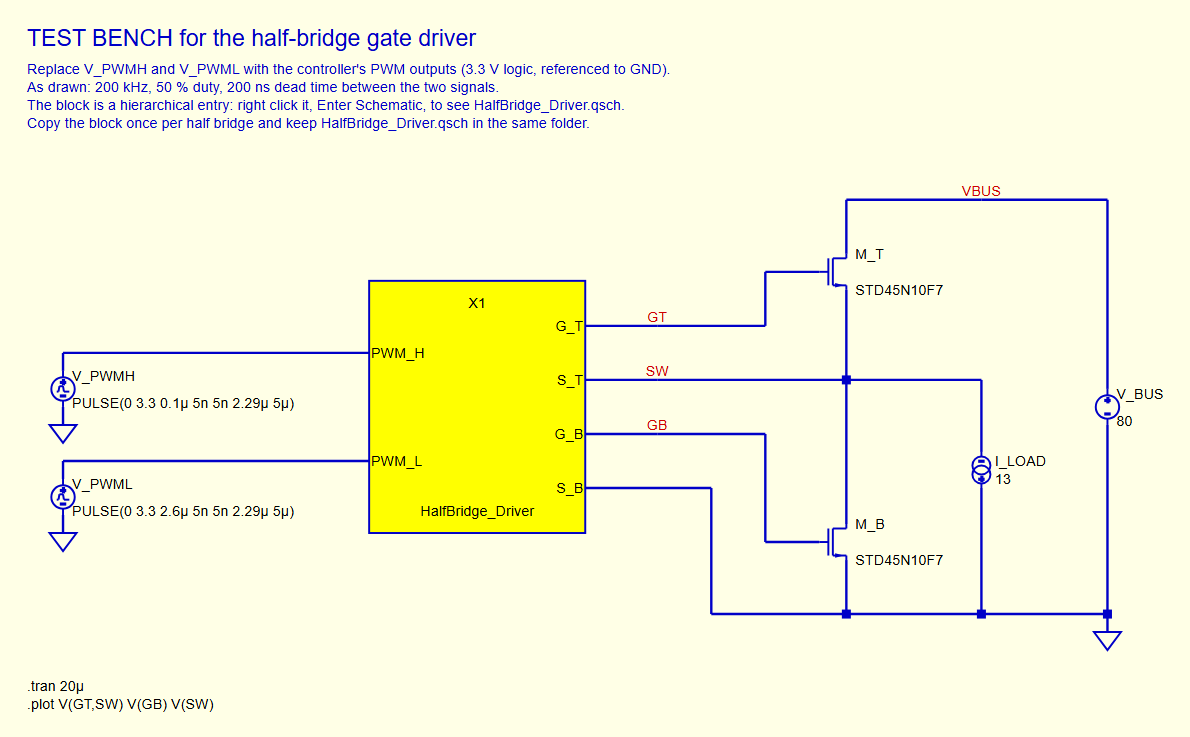
2_Qspice/Gate Driver/Claude output/check/view_testbench_whole.png
