saunders-jared-final/Boost-Brigade/8_Results/analysis/out/events/Bench CL 16Oct qspice200 1525-1609.png

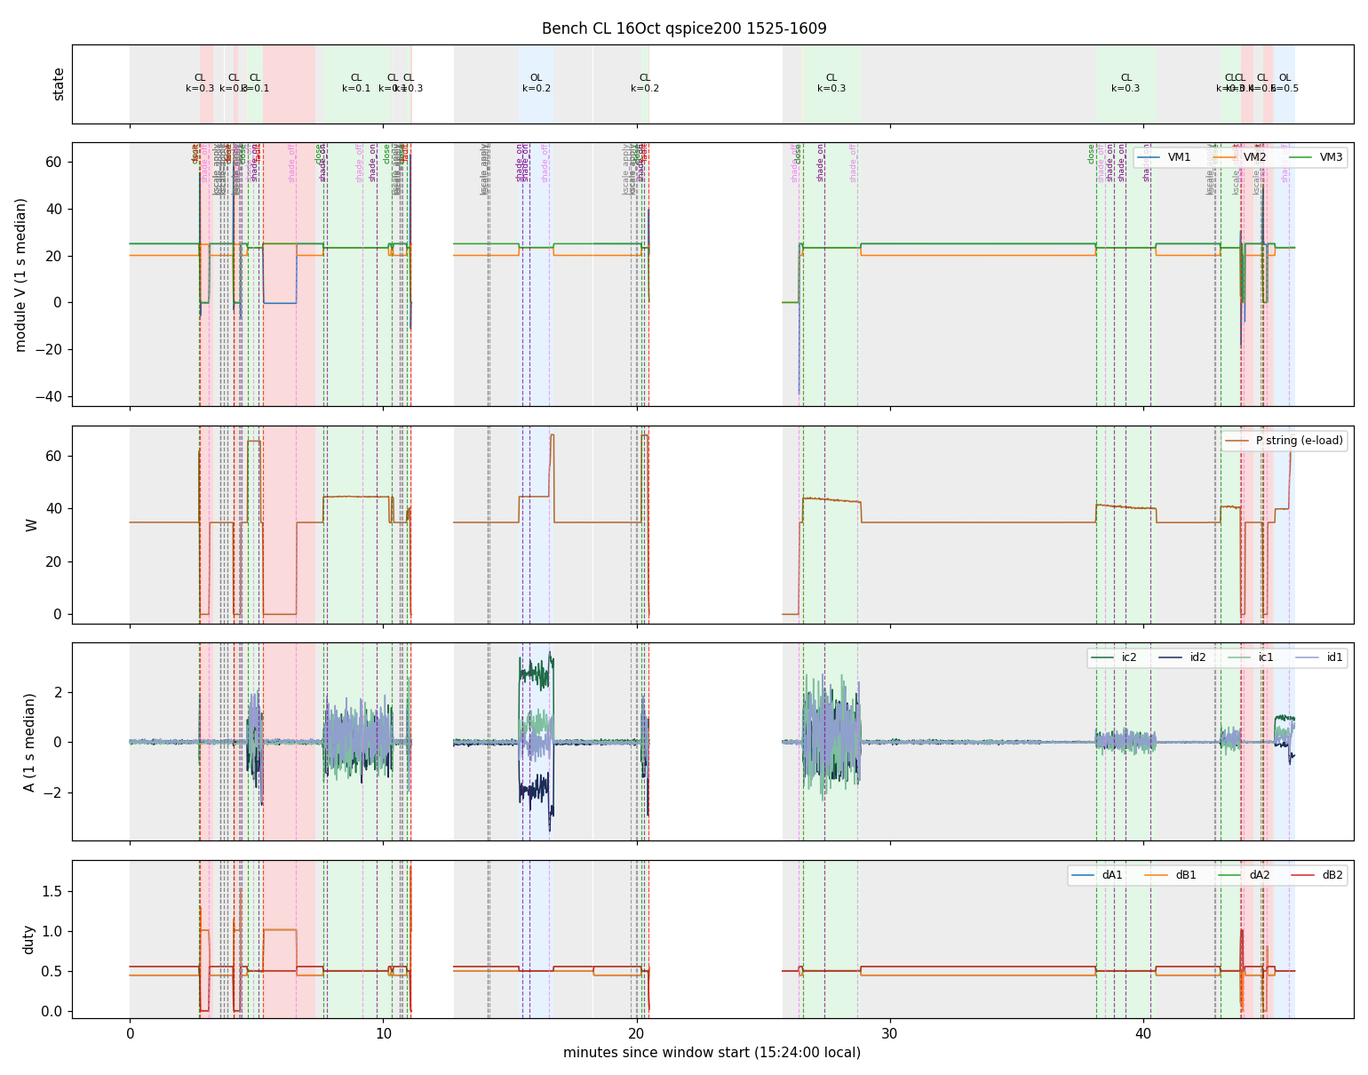
8_Results/analysis/out/events/Bench CL 16Oct qspice200 1525-1609.png
