saunders-jared-final/Boost-Brigade/8_Results/analysis/out/events/Bench CL 16Oct qspice300 1716-1742.png

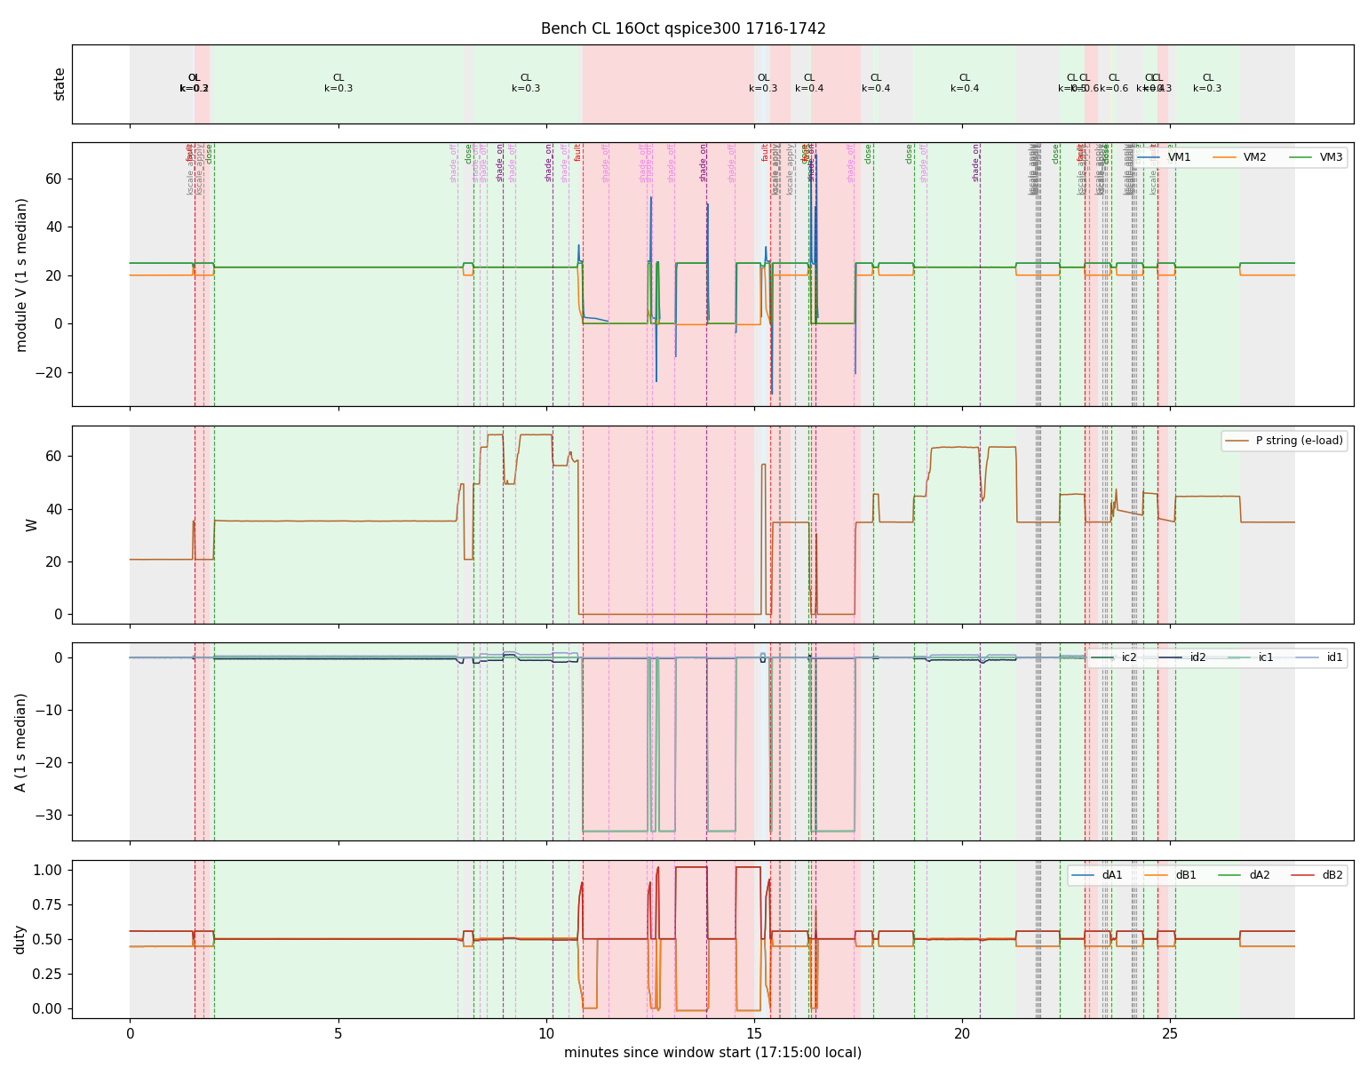
8_Results/analysis/out/events/Bench CL 16Oct qspice300 1716-1742.png
