saunders-jared-final/Boost-Brigade/8_Results/analysis/out/events/Bench CL 16Oct qspice400 1804-1819.png

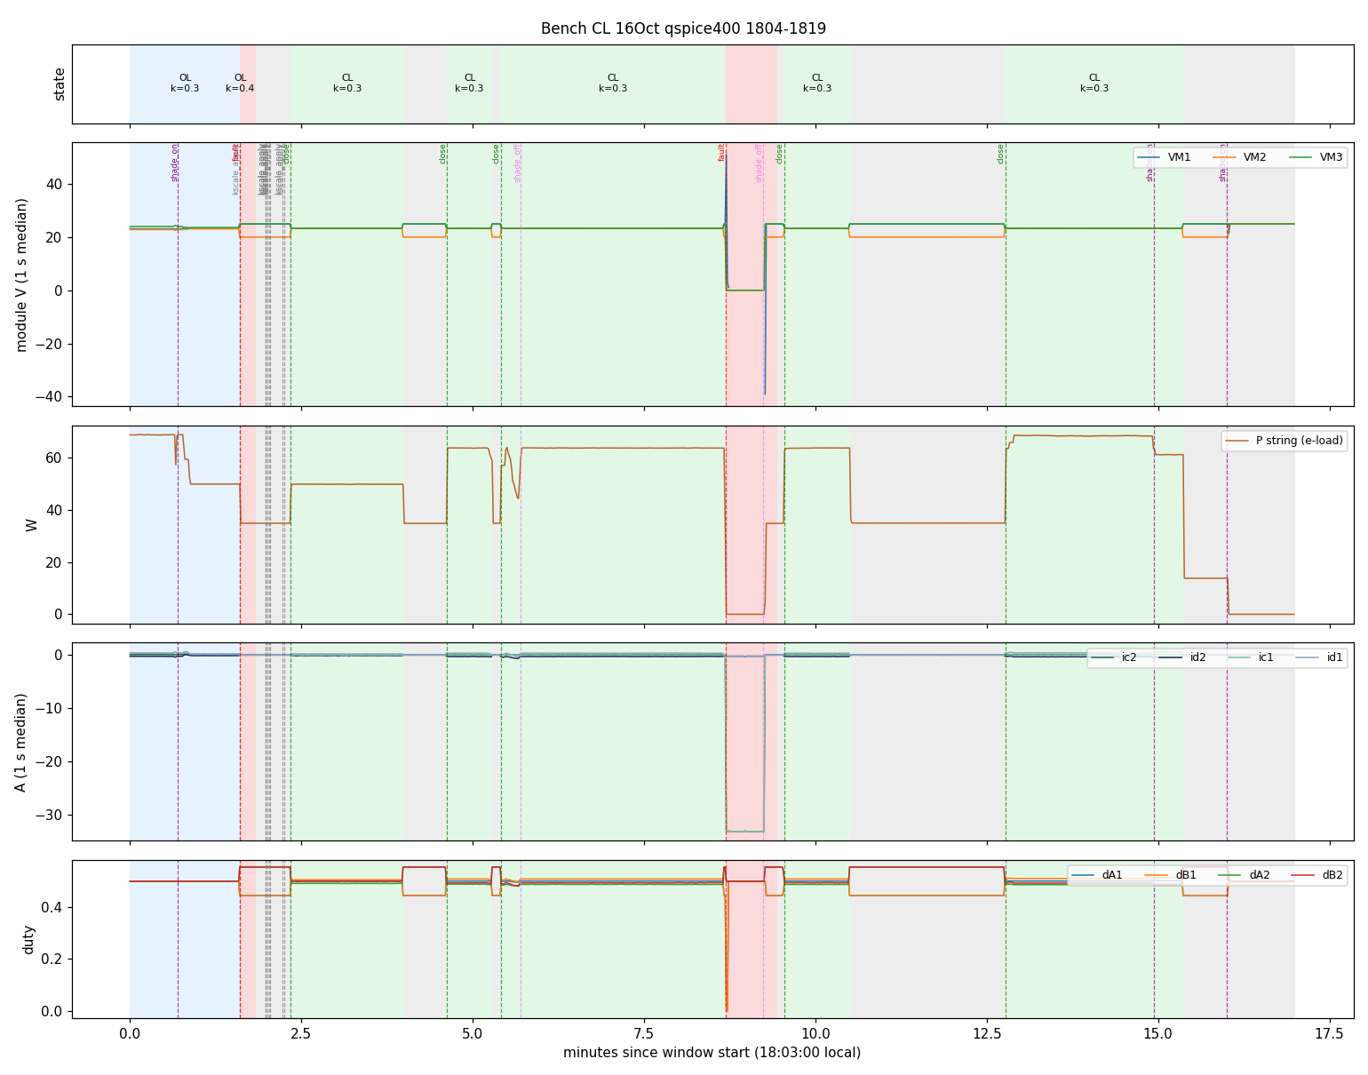
8_Results/analysis/out/events/Bench CL 16Oct qspice400 1804-1819.png
