saunders-jared-final/Boost-Brigade/8_Results/analysis/out/events/Bench CL 16Oct run 1602-1605.png

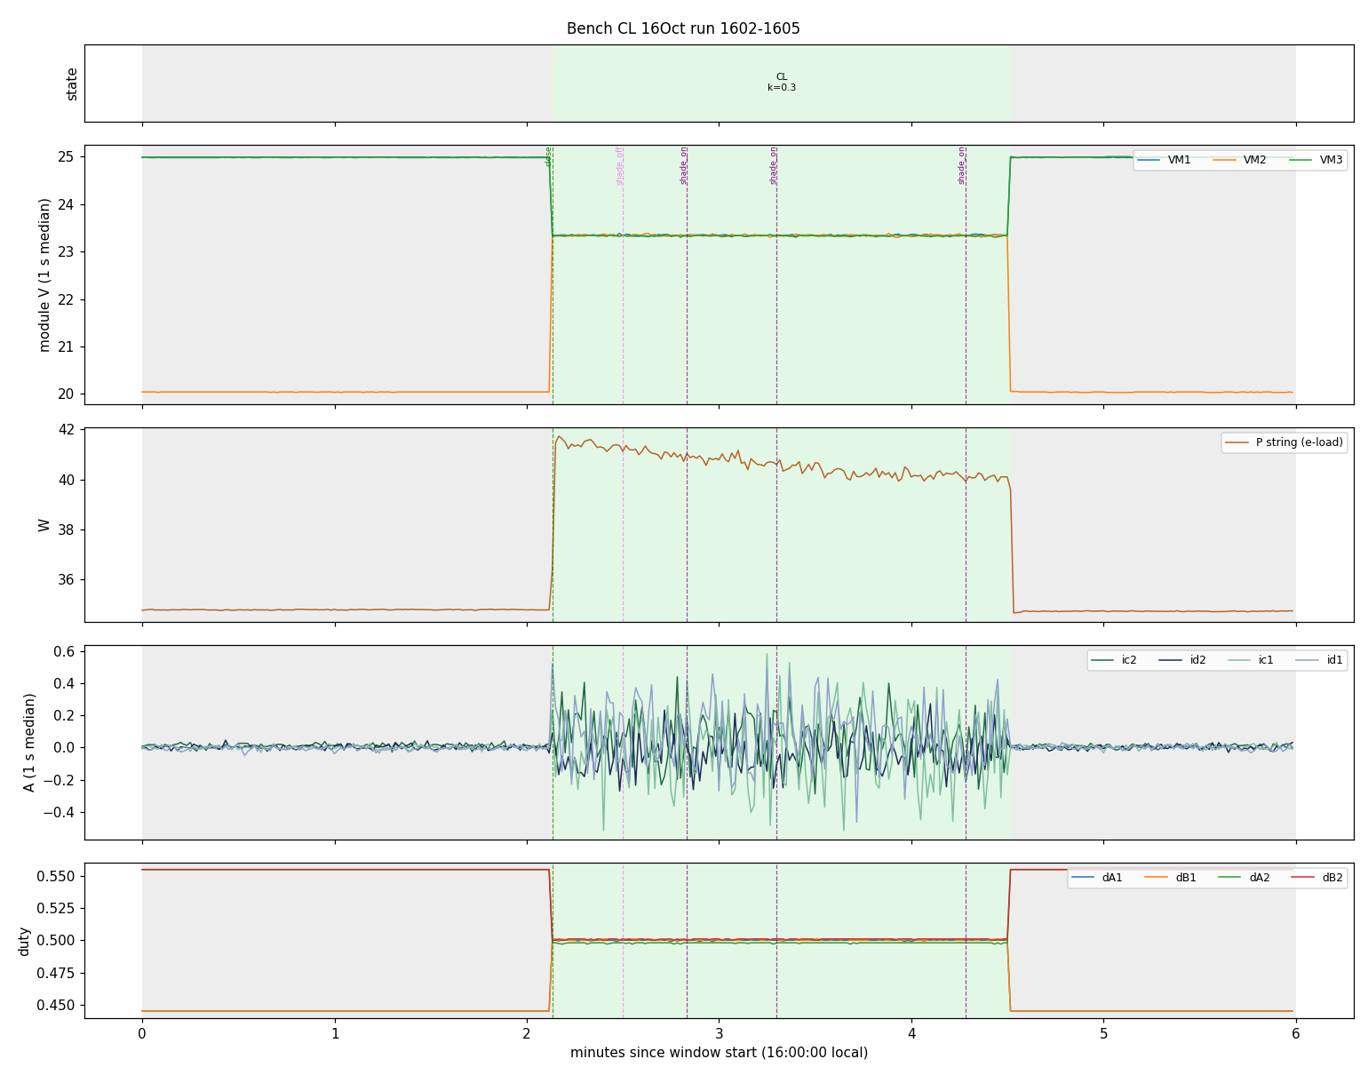
8_Results/analysis/out/events/Bench CL 16Oct run 1602-1605.png
