saunders-jared-final/Boost-Brigade/8_Results/analysis/out/events/Solar CL 20Oct 1508-1513.png

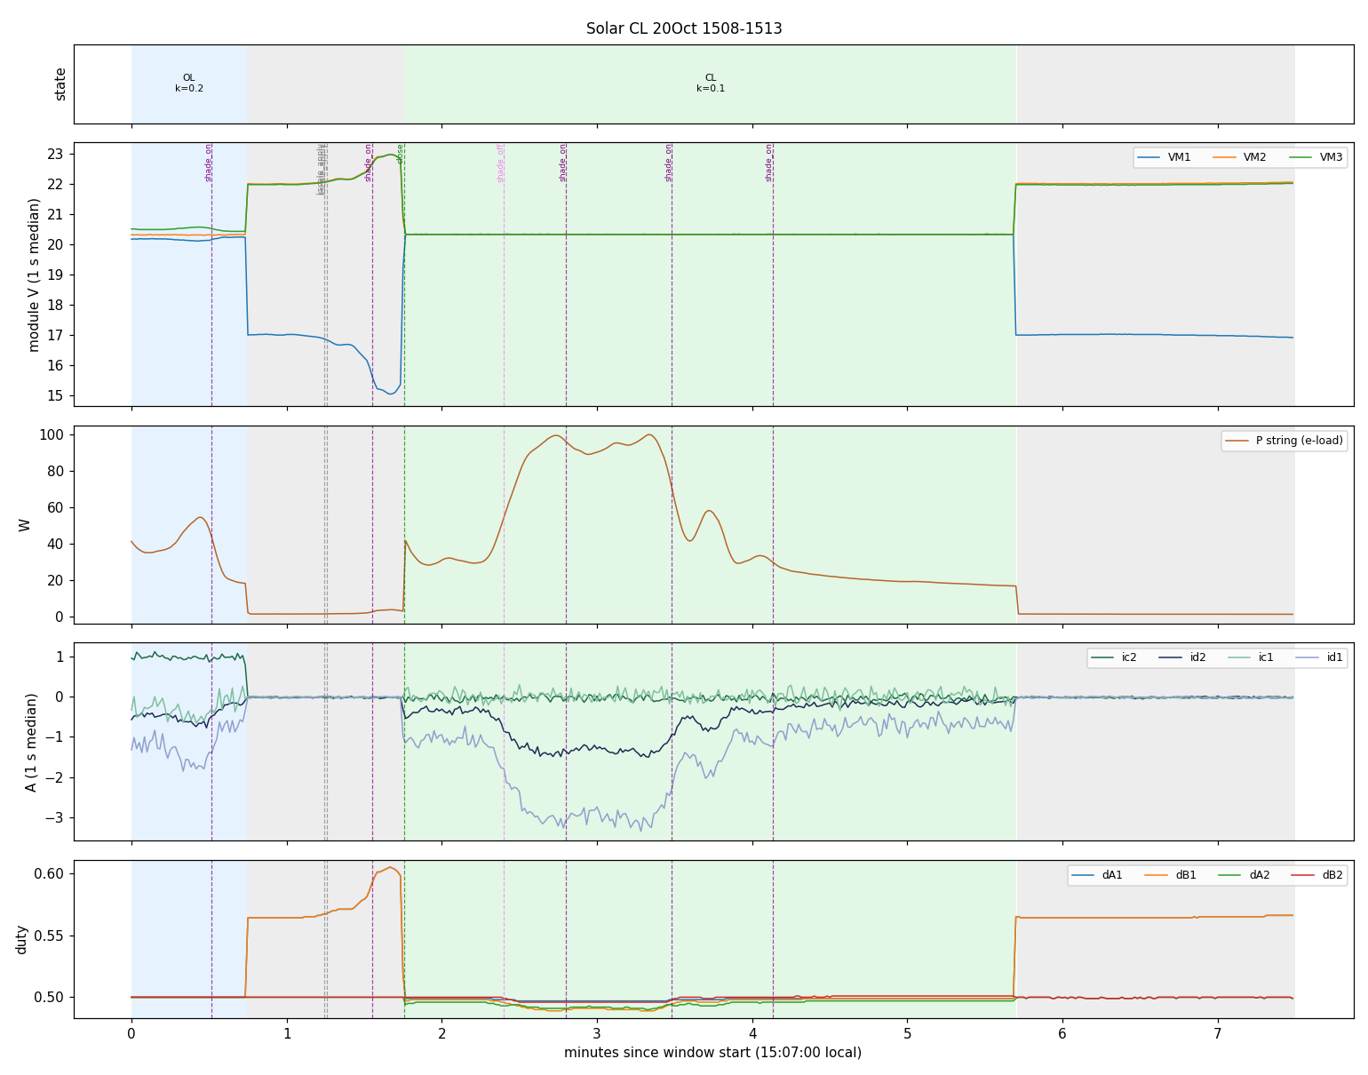
8_Results/analysis/out/events/Solar CL 20Oct 1508-1513.png
