saunders-jared-final/Boost-Brigade/8_Results/analysis/out/events/Solar CL 20Oct kscale sweep 1551-1626.png

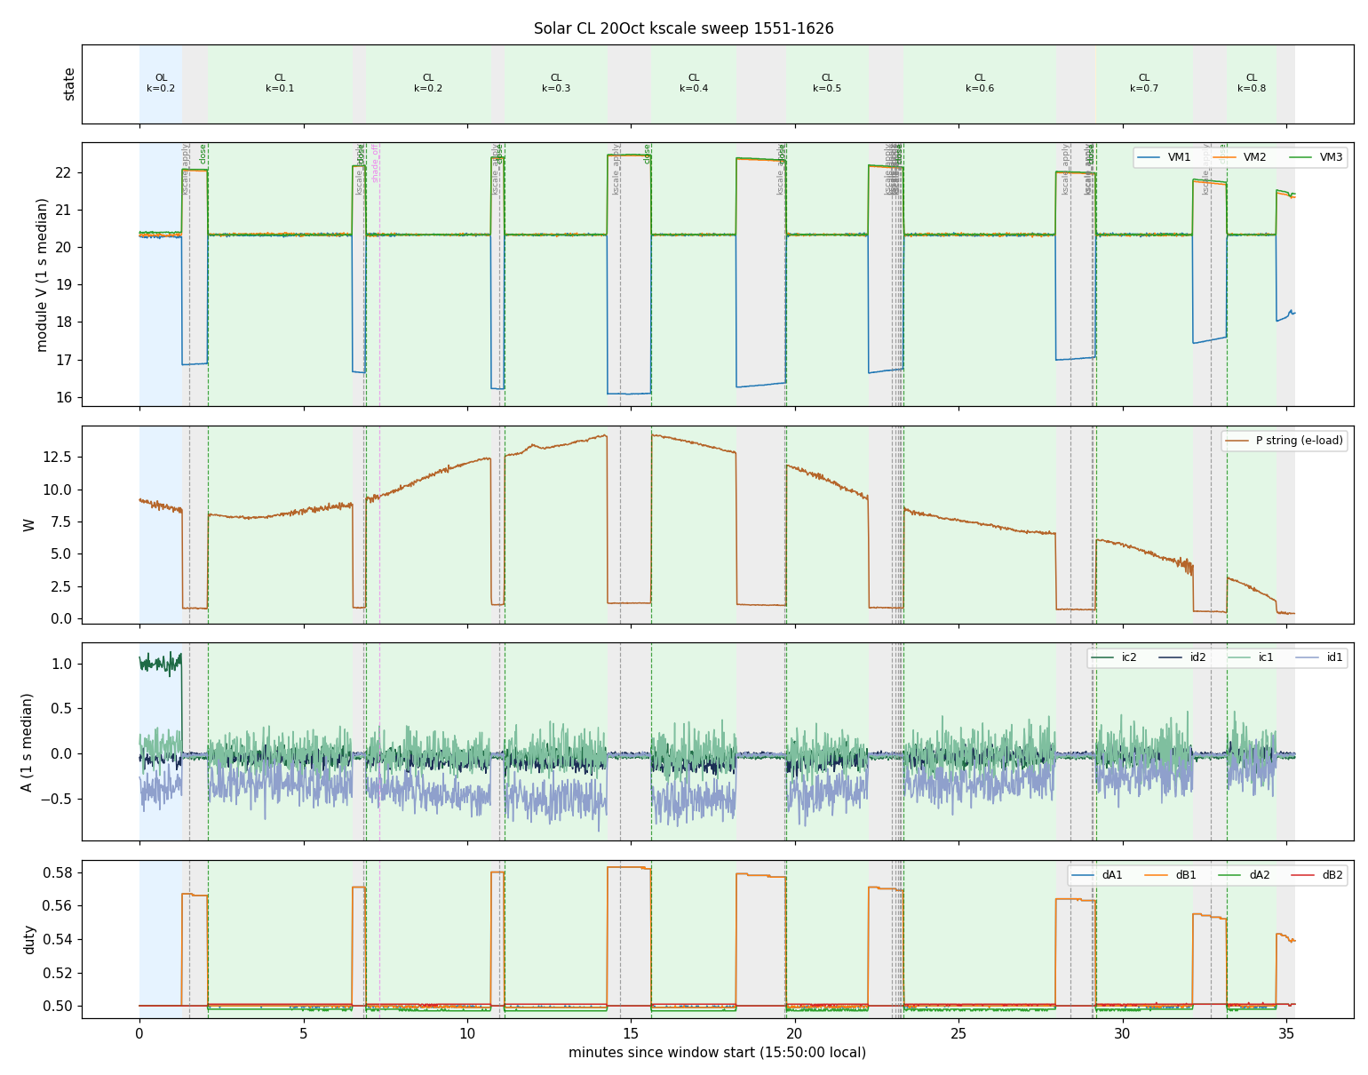
8_Results/analysis/out/events/Solar CL 20Oct kscale sweep 1551-1626.png
