saunders-jared-final/Boost-Brigade/8_Results/analysis/out/events/Solar OL+CL 20Oct 1252-1313.png

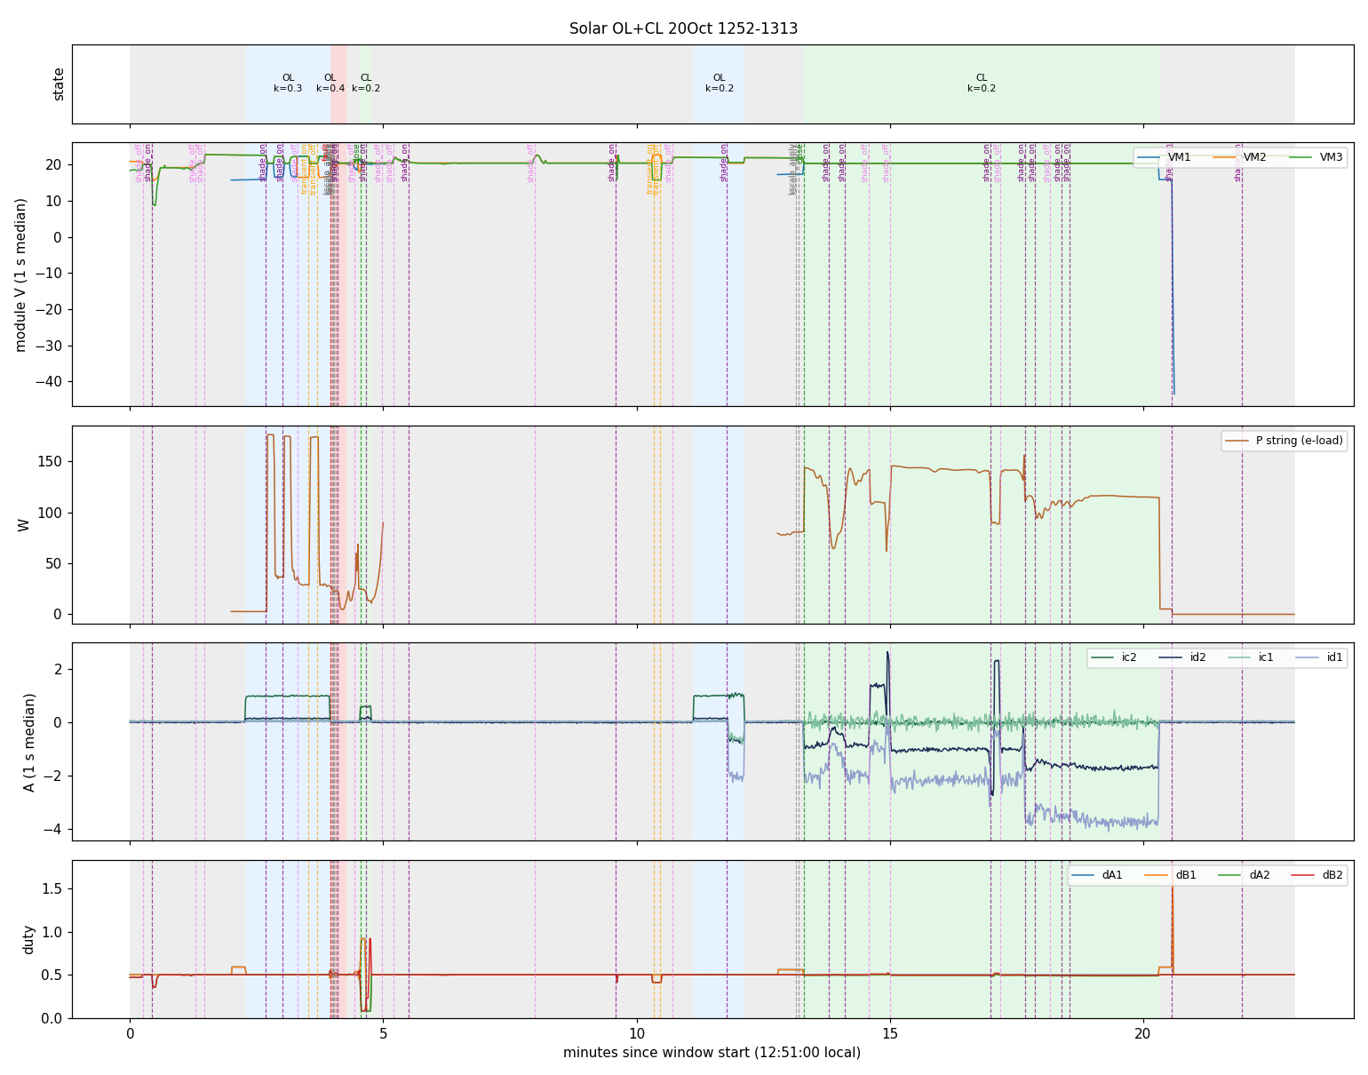
8_Results/analysis/out/events/Solar OL+CL 20Oct 1252-1313.png
