saunders-jared-final/Boost-Brigade/8_Results/analysis/out/figures/S1_k0.8_ic2_hw.png

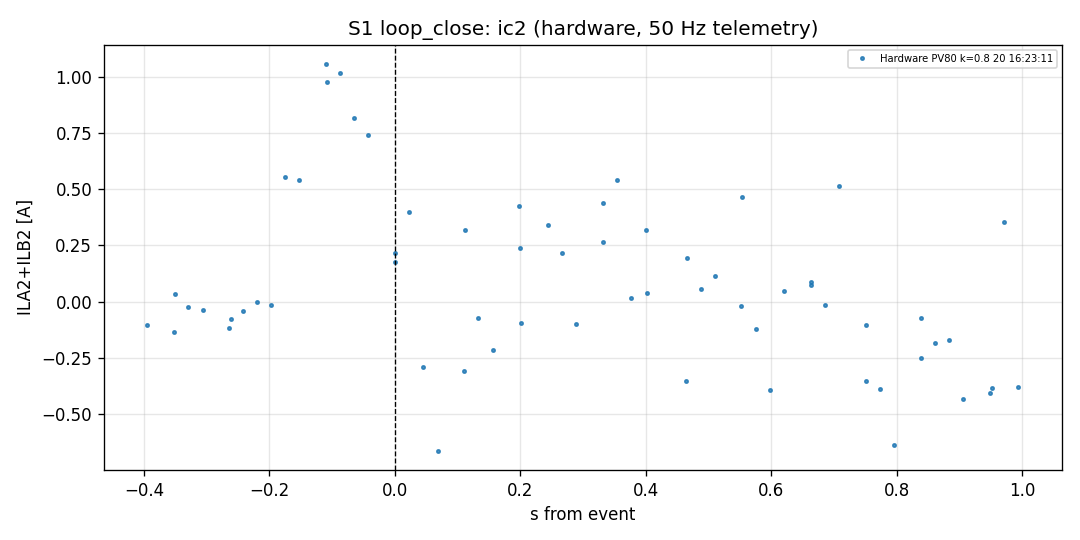
8_Results/analysis/out/figures/S1_k0.8_ic2_hw.png
