saunders-jared-final/Boost-Brigade/8_Results/analysis/out/figures/S1_k1_id2.png

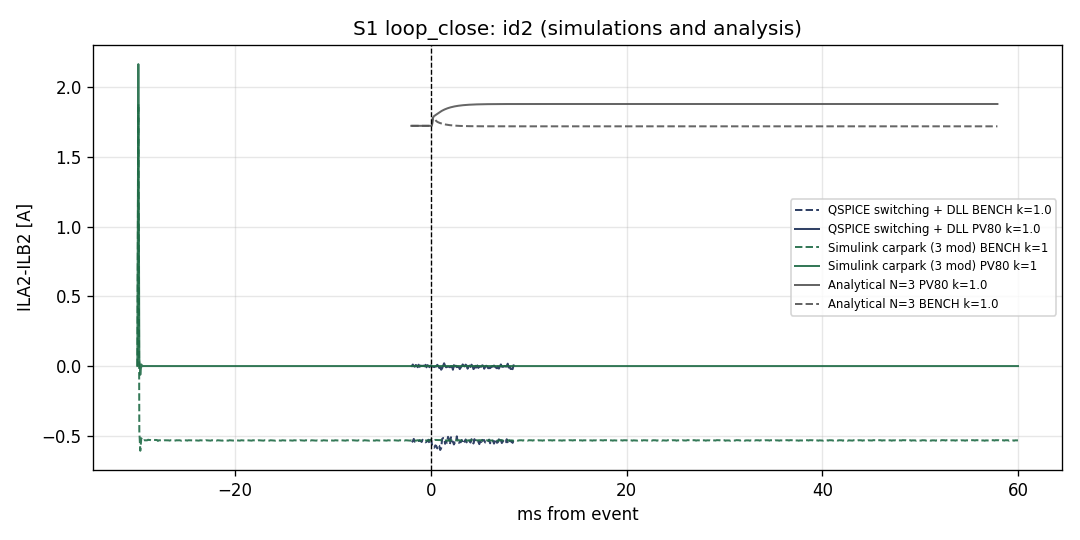
8_Results/analysis/out/figures/S1_k1_id2.png
