saunders-jared-final/Boost-Brigade/8_Results/analysis/out/figures/S3_k0.3_id2_hw.png

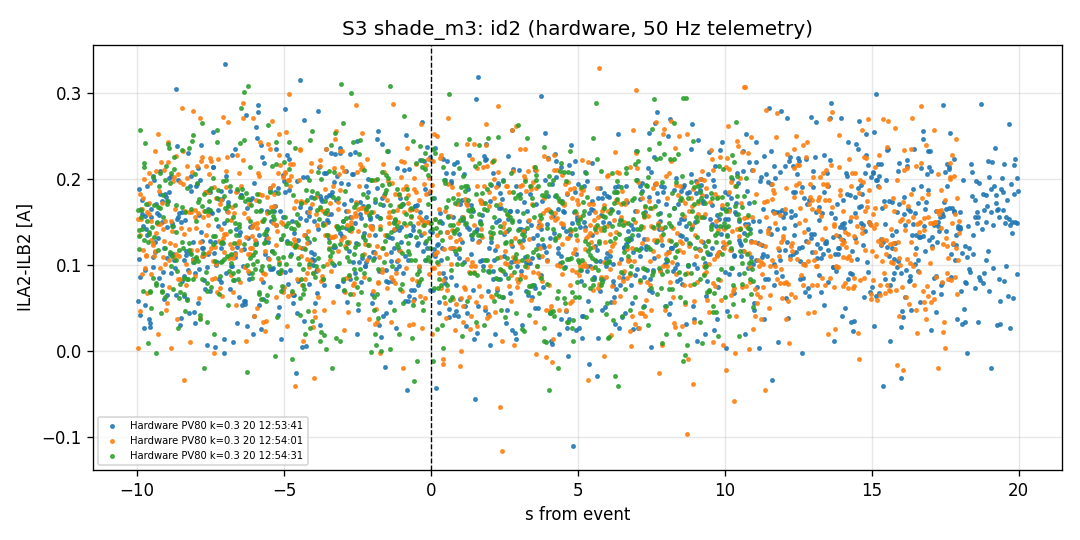
8_Results/analysis/out/figures/S3_k0.3_id2_hw.png
