saunders-jared-final/Boost-Brigade/8_Results/analysis/out/figures/S3_k1_vd2.png

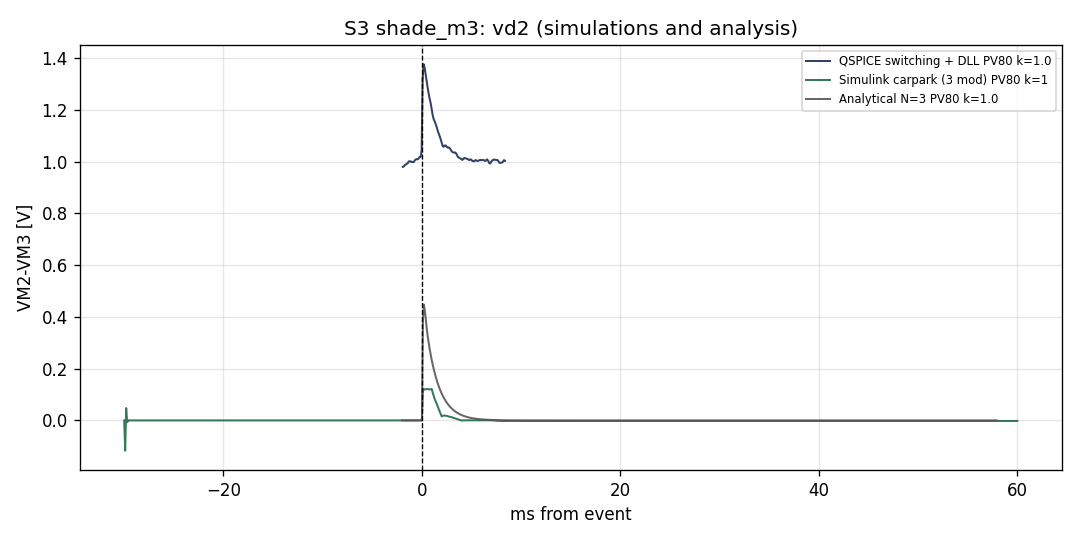
8_Results/analysis/out/figures/S3_k1_vd2.png
