saunders-jared-final/Boost-Brigade/8_Results/analysis/out/figures/S4_k0.3_vd2.png

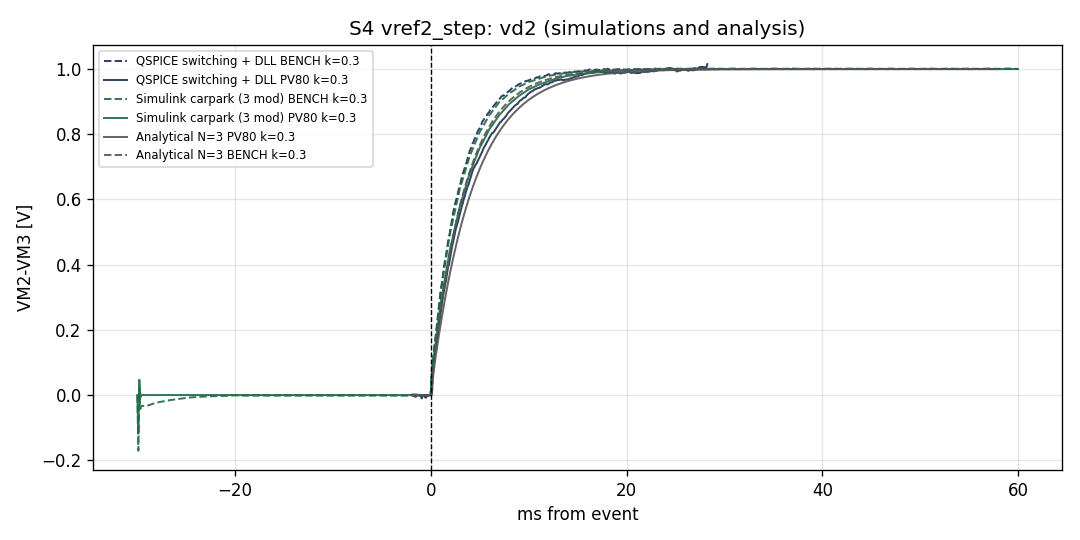
8_Results/analysis/out/figures/S4_k0.3_vd2.png
