saunders-jared-final/Boost-Brigade/8_Results/Bench_Open_Loop_100kHz/eload-13-10-26.png

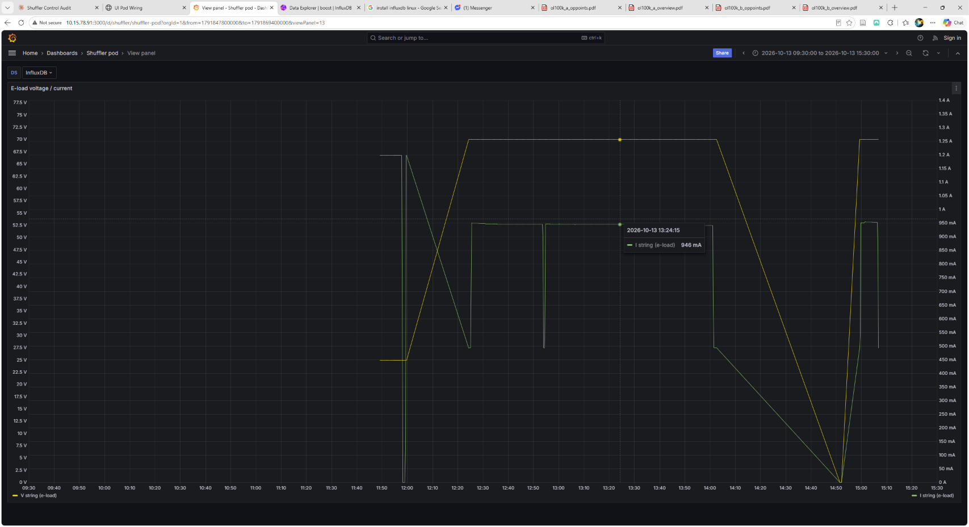
8_Results/Bench_Open_Loop_100kHz/eload-13-10-26.png
