saunders-jared-final/Boost-Brigade/8_Results/Bench_Open_Loop_100kHz/Extra noise images (Bottom shuffler output)/42af5be6-359f-4e80-a149-42353d4e1bf8.jpg

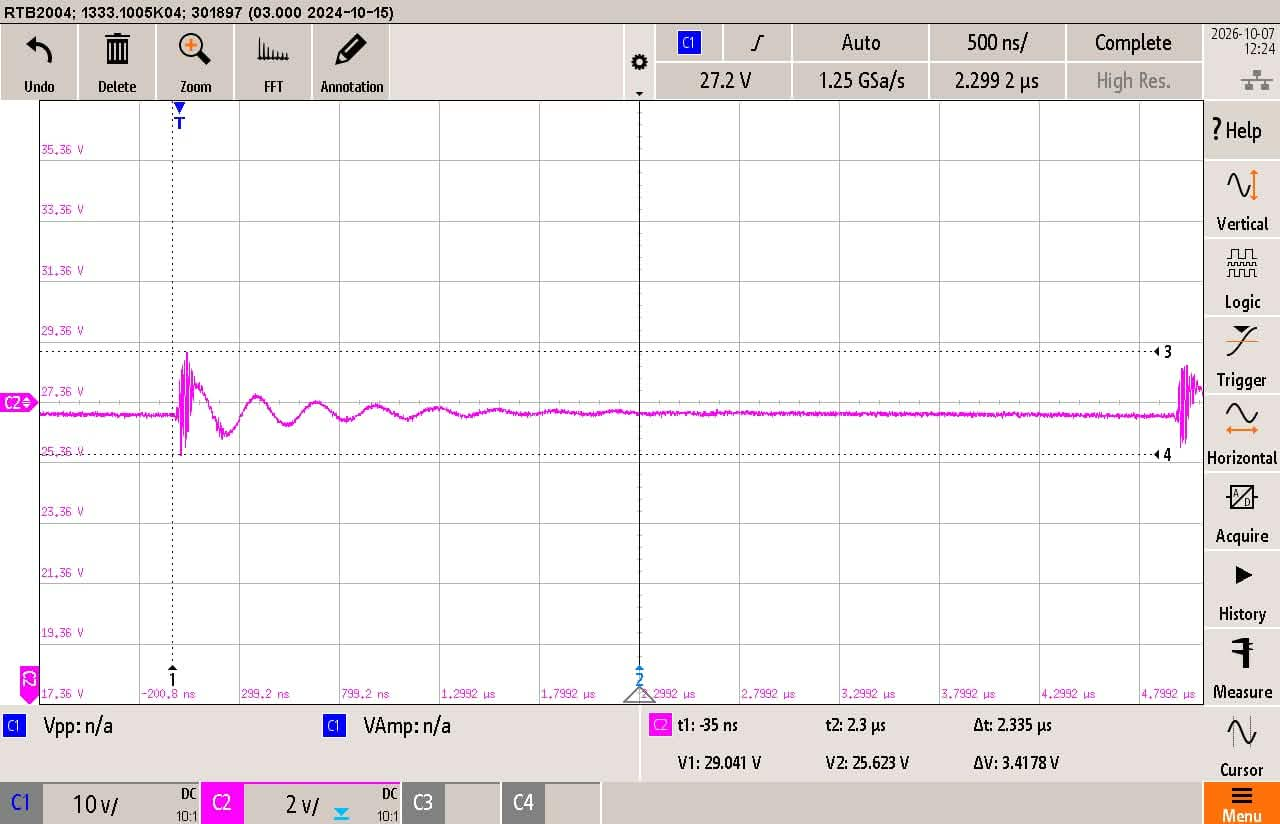
8_Results/Bench_Open_Loop_100kHz/Extra noise images (Bottom shuffler output)/42af5be6-359f-4e80-a149-42353d4e1bf8.jpg
