saunders-jared-final/Boost-Brigade/8_Results/Bench_Open_Loop_100kHz/Extra noise images (Bottom shuffler output)/646d16c0-382e-451d-996d-5d9439024ef5.jpg

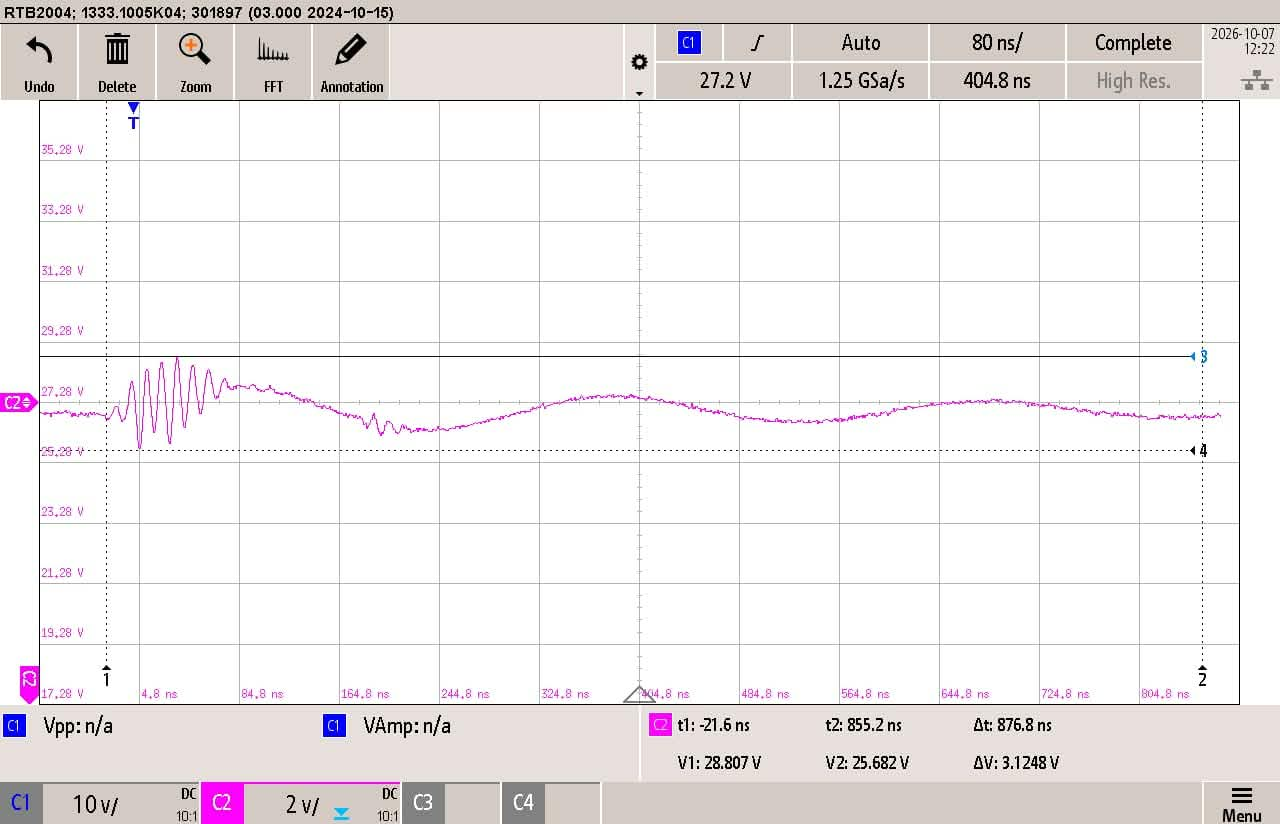
8_Results/Bench_Open_Loop_100kHz/Extra noise images (Bottom shuffler output)/646d16c0-382e-451d-996d-5d9439024ef5.jpg
