saunders-jared-final/Boost-Brigade/8_Results/Bench_Open_Loop_100kHz/Load_Voltage.PNG

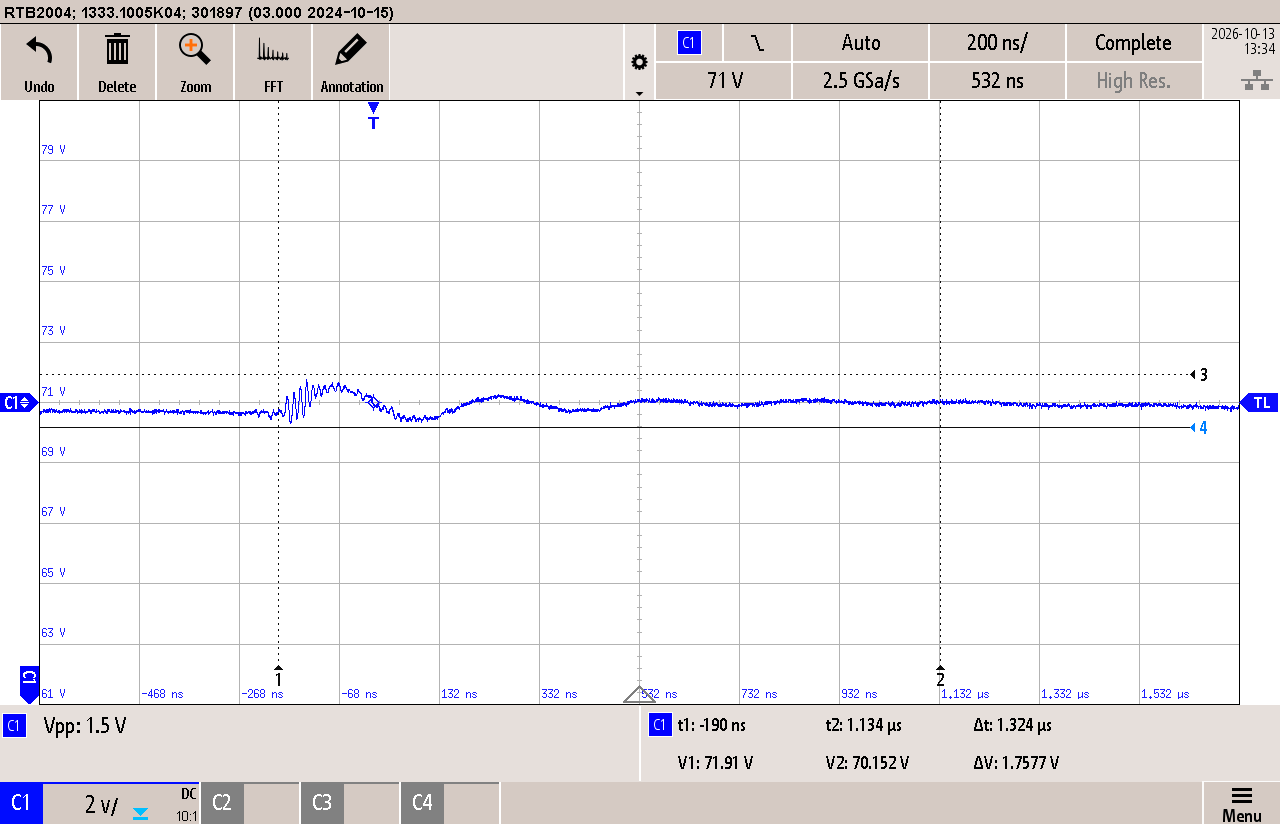
8_Results/Bench_Open_Loop_100kHz/Load_Voltage.PNG
