saunders-jared-final/Boost-Brigade/8_Results/Bench_Open_Loop_100kHz/ol100k_a_inductor_currents.png

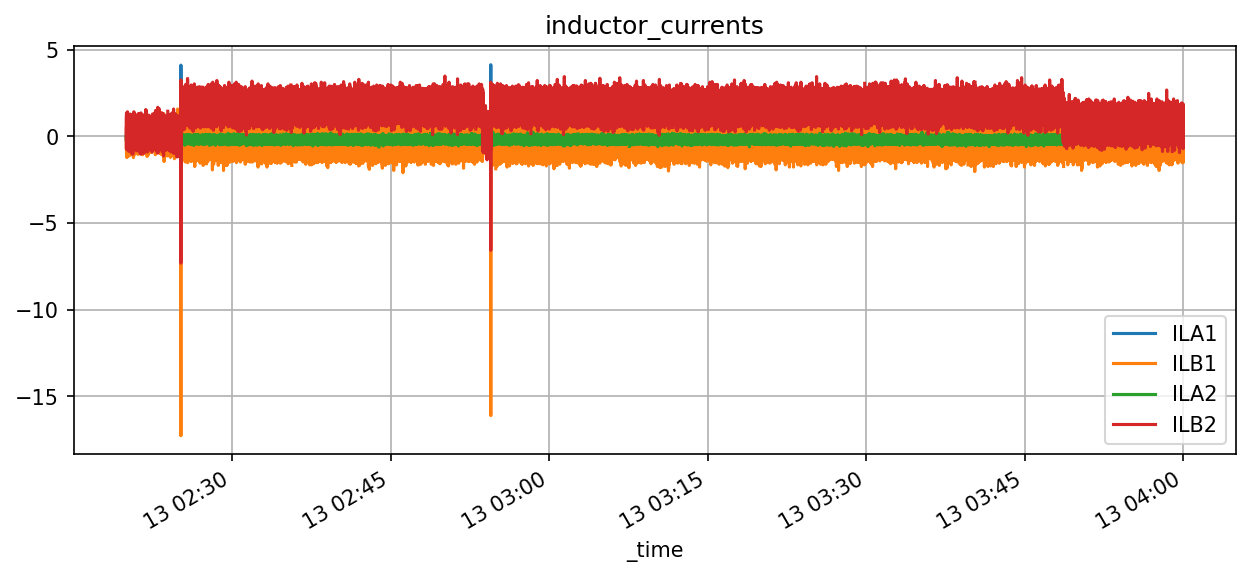
8_Results/Bench_Open_Loop_100kHz/ol100k_a_inductor_currents.png
