saunders-jared-final/Boost-Brigade/8_Results/Bench_Open_Loop_100kHz/Shuffler_2_Duty_50.PNG

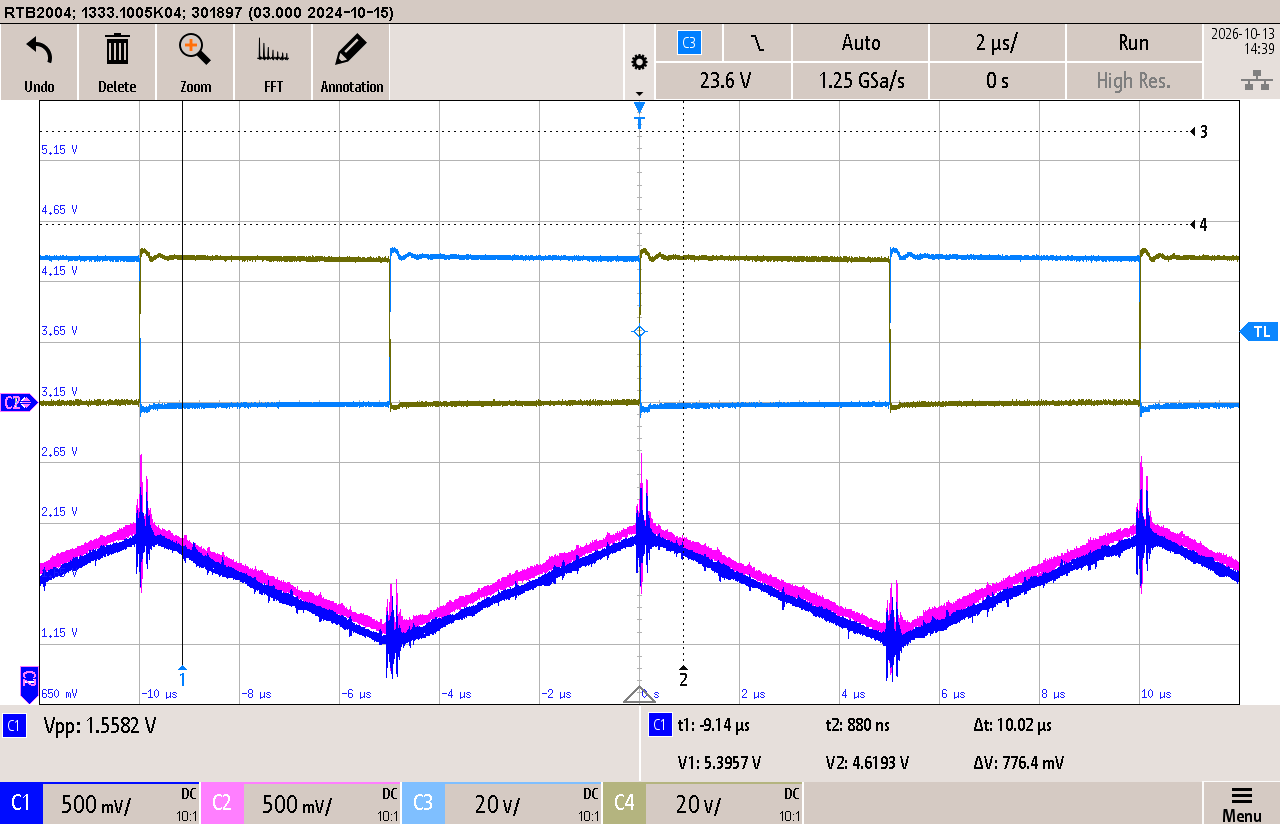
8_Results/Bench_Open_Loop_100kHz/Shuffler_2_Duty_50.PNG
