saunders-jared-final/Boost-Brigade/8_Results/Bench_Open_Loop_200kHz/Channel Voltages.png

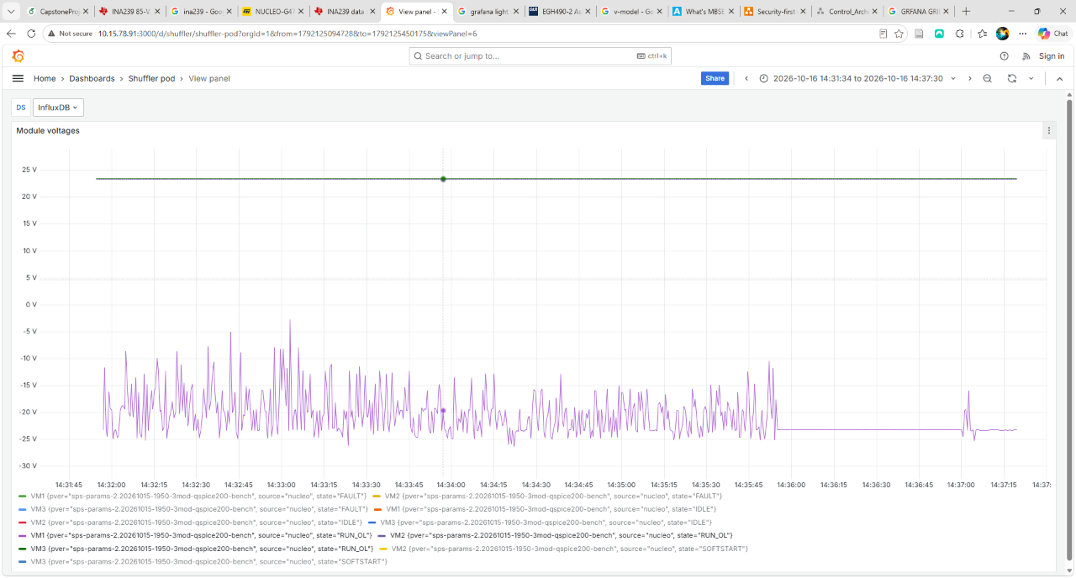
8_Results/Bench_Open_Loop_200kHz/Channel Voltages.png
