saunders-jared-final/Boost-Brigade/8_Results/Bench_Open_Loop_200kHz/Power 3407-6709.png

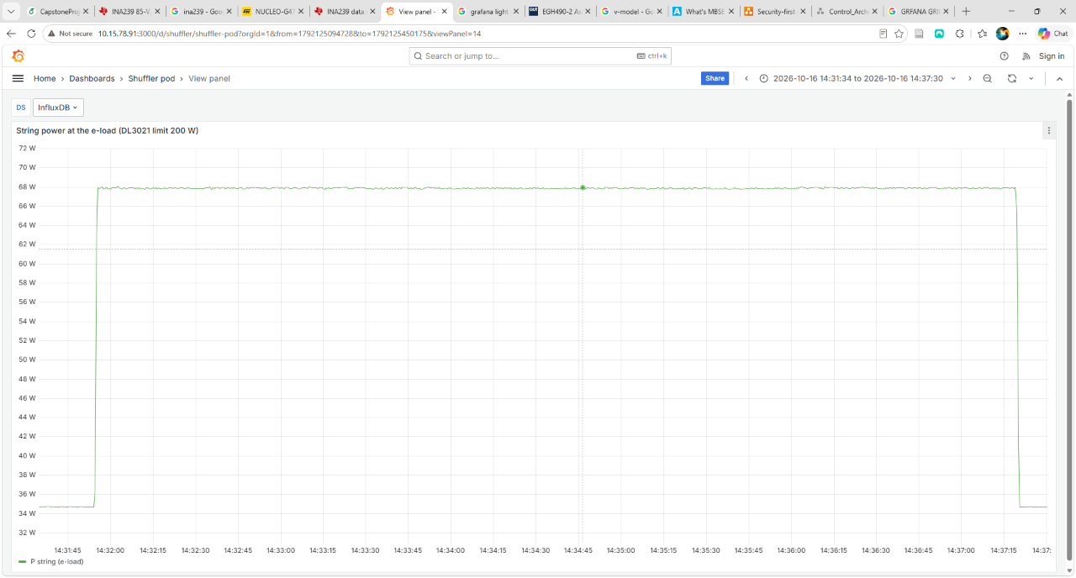
8_Results/Bench_Open_Loop_200kHz/Power 3407-6709.png
