saunders-jared-final/Boost-Brigade/8_Results/Bench_Open_Loop_300kHz/Power 3408-6901.png

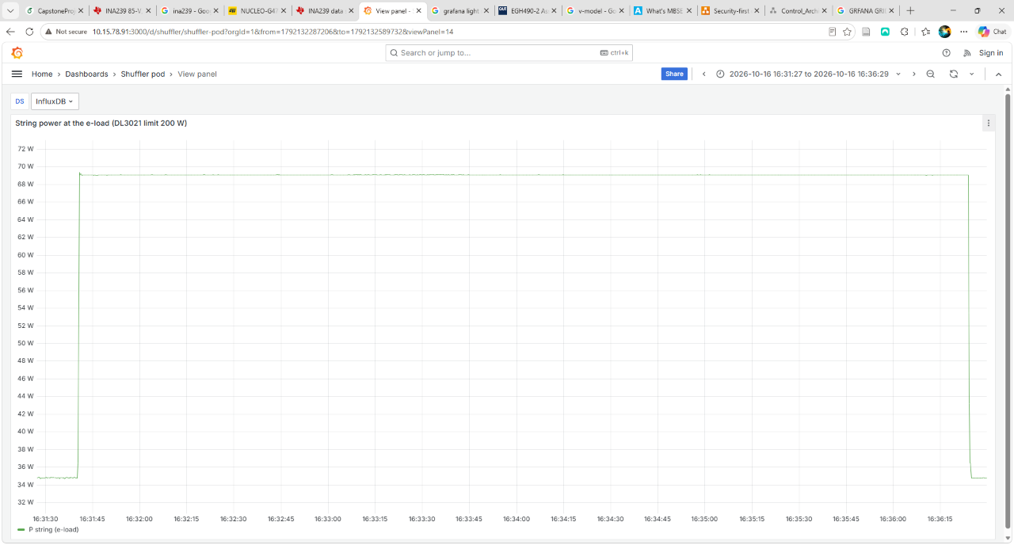
8_Results/Bench_Open_Loop_300kHz/Power 3408-6901.png
