saunders-jared-final/Boost-Brigade/8_Results/Bench_Open_Loop_400khz/Channel Voltages.png

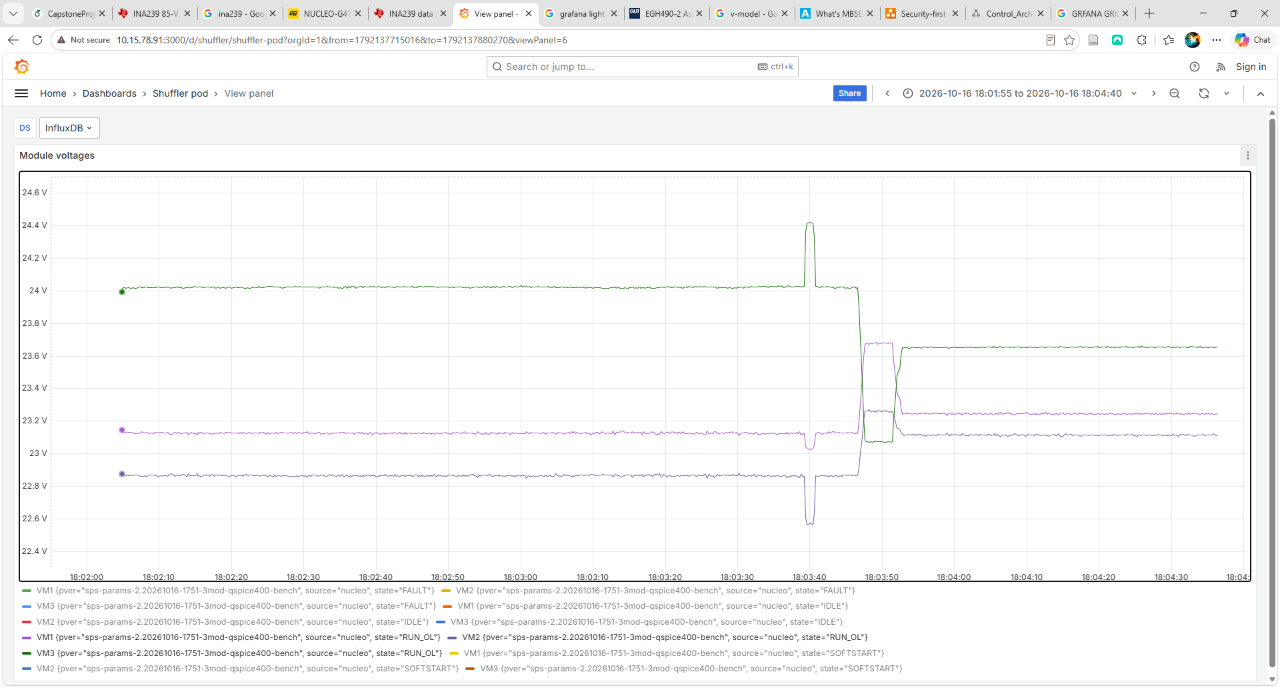
8_Results/Bench_Open_Loop_400khz/Channel Voltages.png
