saunders-jared-final/Boost-Brigade/8_Results/Bench_Open_Loop_400khz/Inductor Current.png

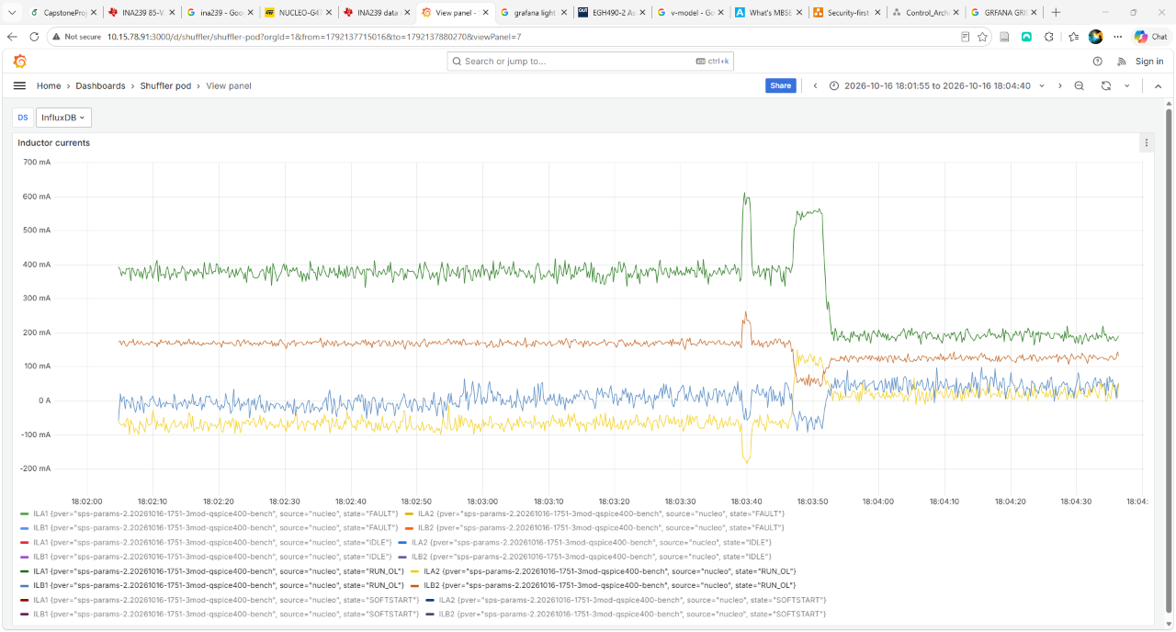
8_Results/Bench_Open_Loop_400khz/Inductor Current.png
