saunders-jared-final/Boost-Brigade/8_Results/Bench_Open_Loop_400khz/Power 3409-6808.png

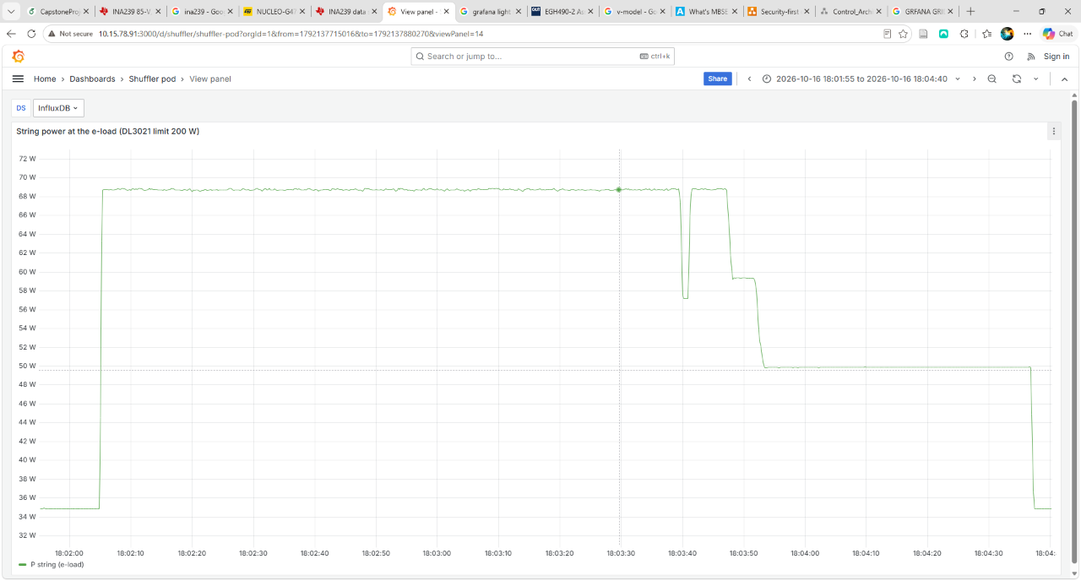
8_Results/Bench_Open_Loop_400khz/Power 3409-6808.png
