saunders-jared-final/Boost-Brigade/8_Results/LAB INA Temp.png

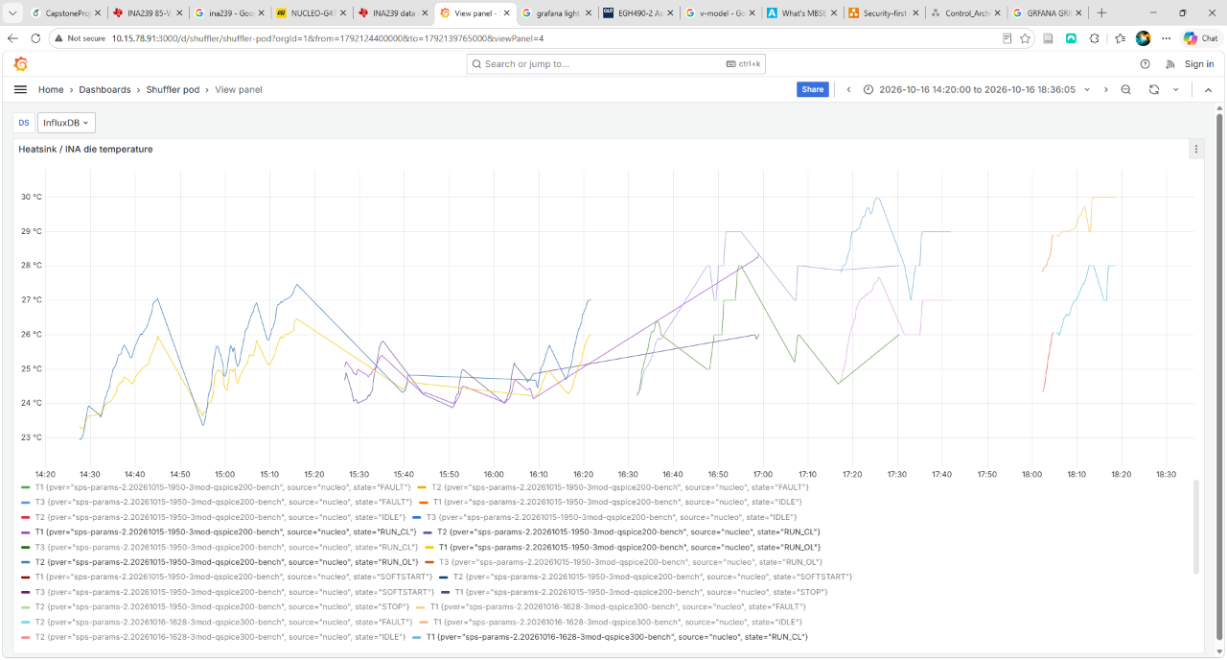
8_Results/LAB INA Temp.png
