saunders-jared-final/Boost-Brigade/8_Results/SCR03.PNG

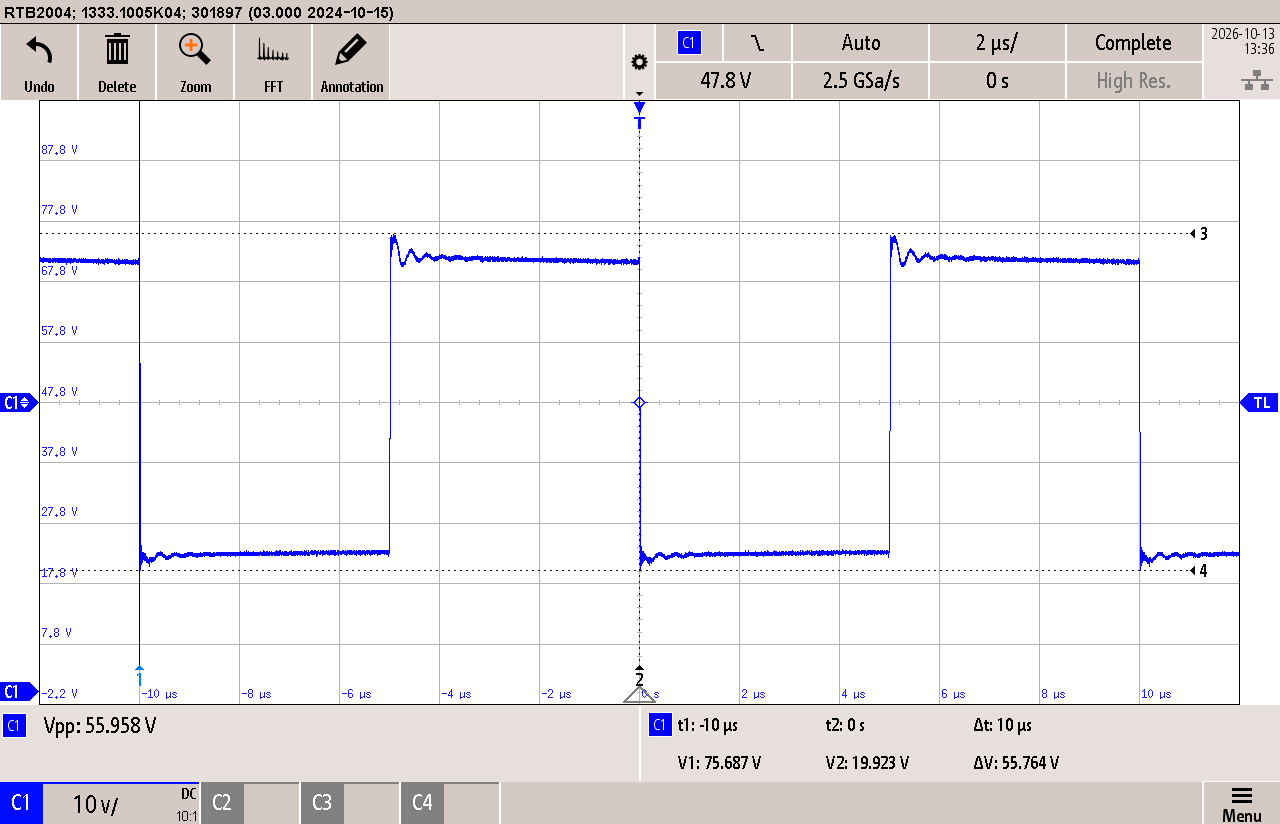
8_Results/SCR03.PNG
