saunders-jared-final/Boost-Brigade/8_Results/Shuffler_2_Duty_49.PNG

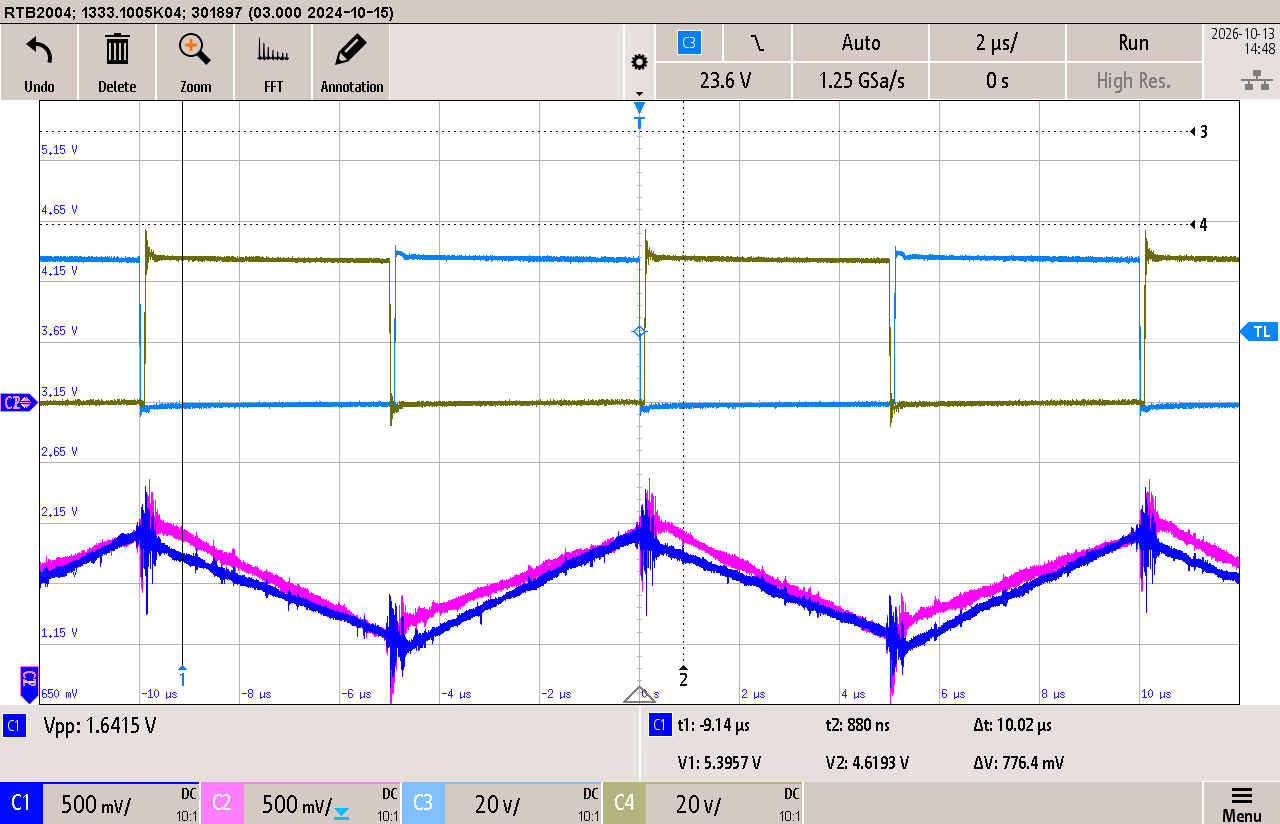
8_Results/Shuffler_2_Duty_49.PNG
