saunders-jared-final/Boost-Brigade/8_Results/Shuffler_2_Voltage.PNG

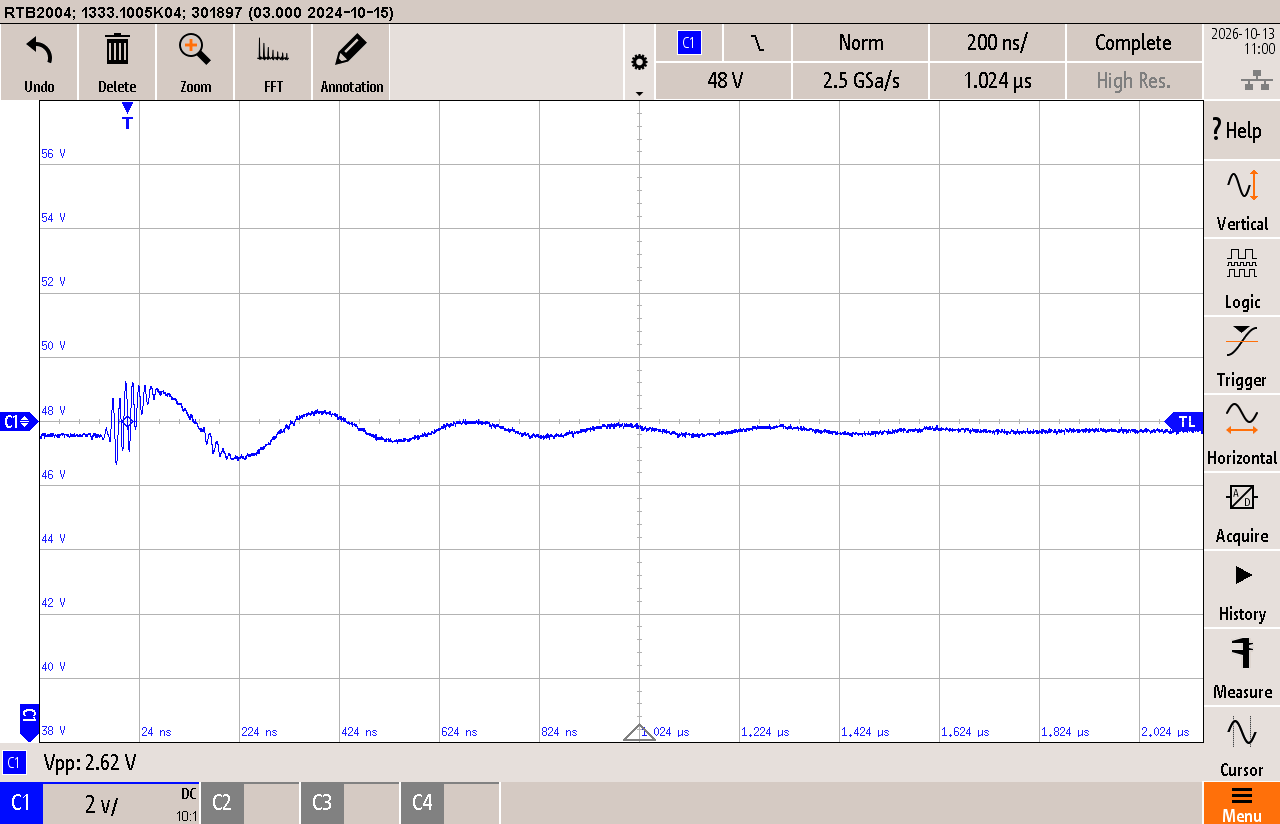
8_Results/Shuffler_2_Voltage.PNG
