saunders-jared-final/Boost-Brigade/8_Results/Solar_Open_Loop/Full sun #1 1301-1303 (no eload).png

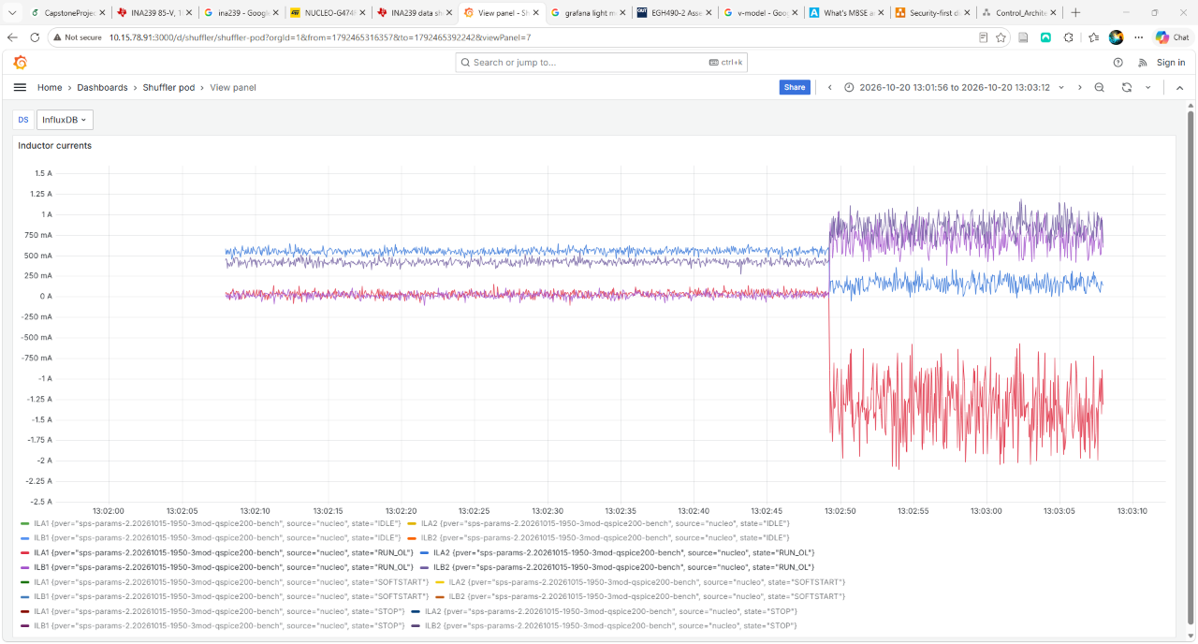
8_Results/Solar_Open_Loop/Full sun #1 1301-1303 (no eload).png
