saunders-jared-final/Boost-Brigade/8_Results/Solar_Open_Loop/Full sun #2 Power 1504-1507.png

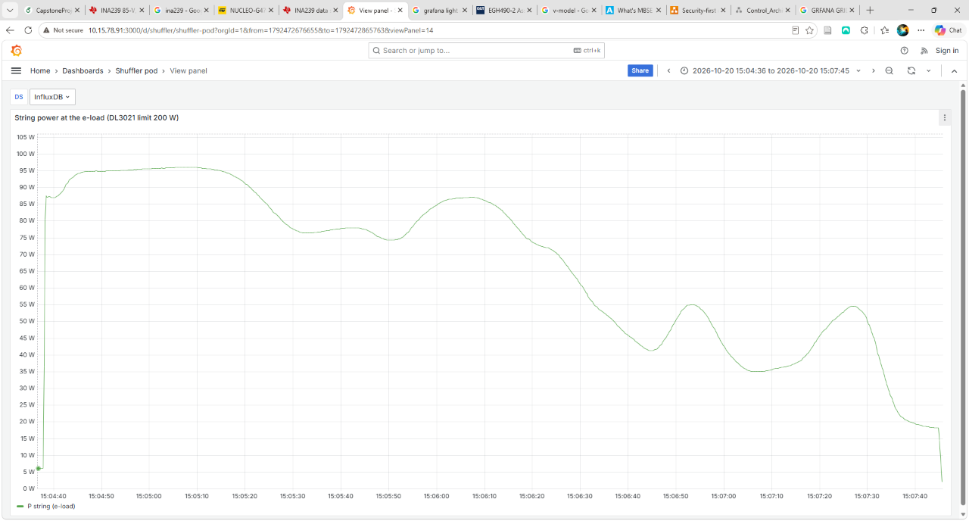
8_Results/Solar_Open_Loop/Full sun #2 Power 1504-1507.png
