saunders-jared-final/Boost-Brigade/8_Results/Solar_Open_Loop/Full sun max output 1253-1254 Voltage.png

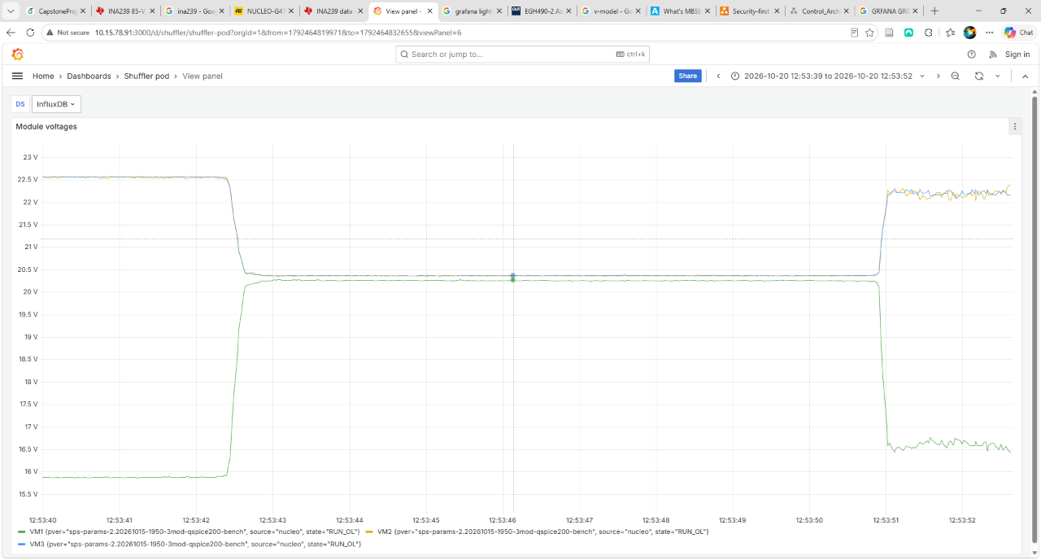
8_Results/Solar_Open_Loop/Full sun max output 1253-1254 Voltage.png
