saunders-jared-final/Boost-Brigade/8_Results/Solar_Open_Loop/Open Loop Data (Long Term Load).png

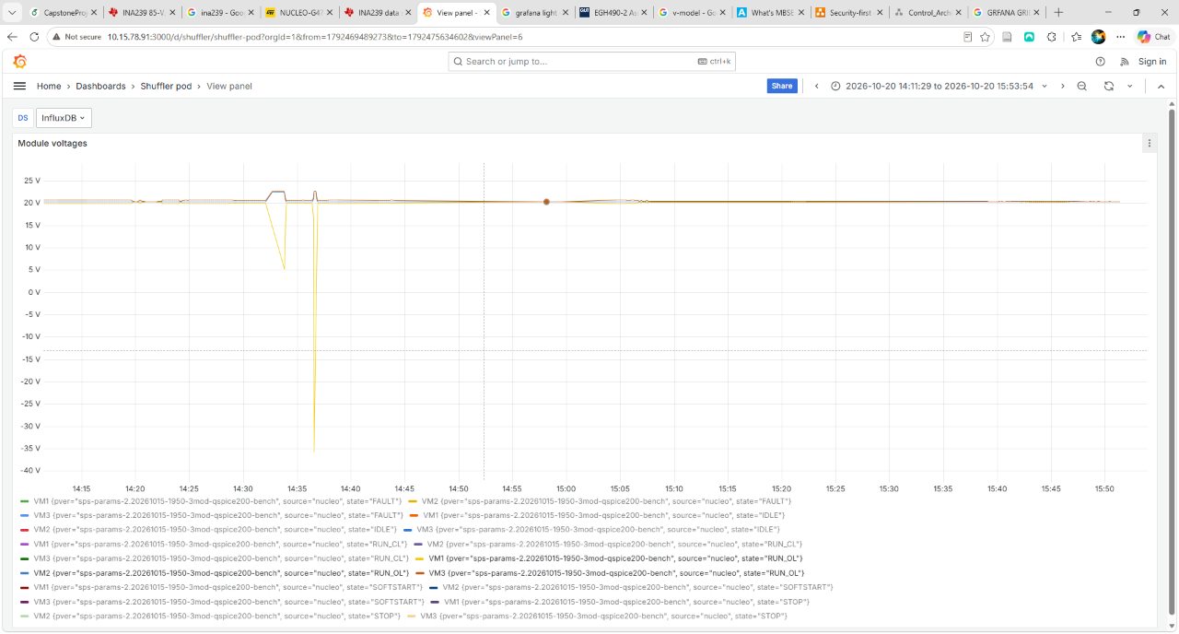
8_Results/Solar_Open_Loop/Open Loop Data (Long Term Load).png
