saunders-jared-final/Boost-Brigade/8_Results/Solar_Open_Loop/Open Loop Eload Current 1410.png

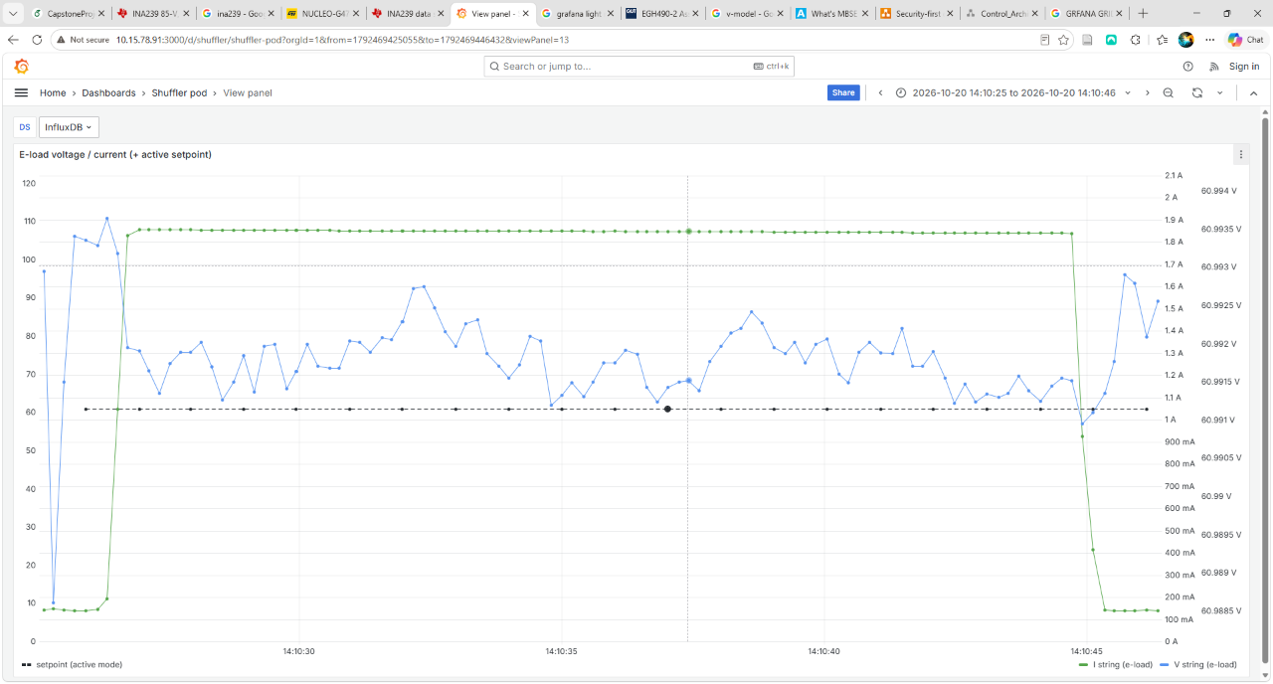
8_Results/Solar_Open_Loop/Open Loop Eload Current 1410.png
