saunders-jared-final/Boost-Brigade/8_Results/Solar_Open_Loop/Open Loop Module Voltage 1410.png

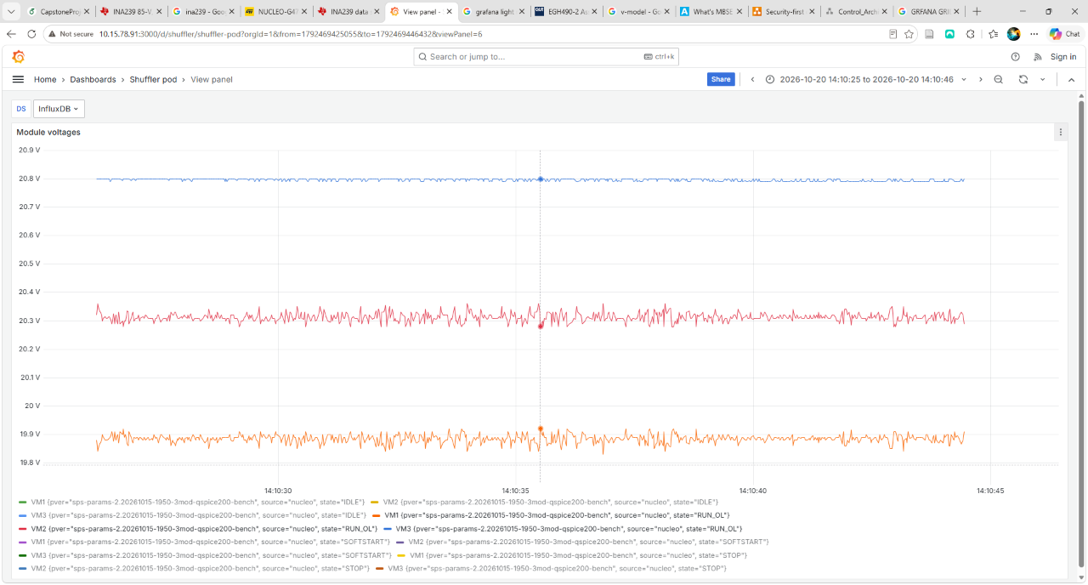
8_Results/Solar_Open_Loop/Open Loop Module Voltage 1410.png
