saunders-jared-final/Boost-Brigade/MATLAB/1_Simulink_Experiment/figures/Screenshot 2026-06-30 115021.png

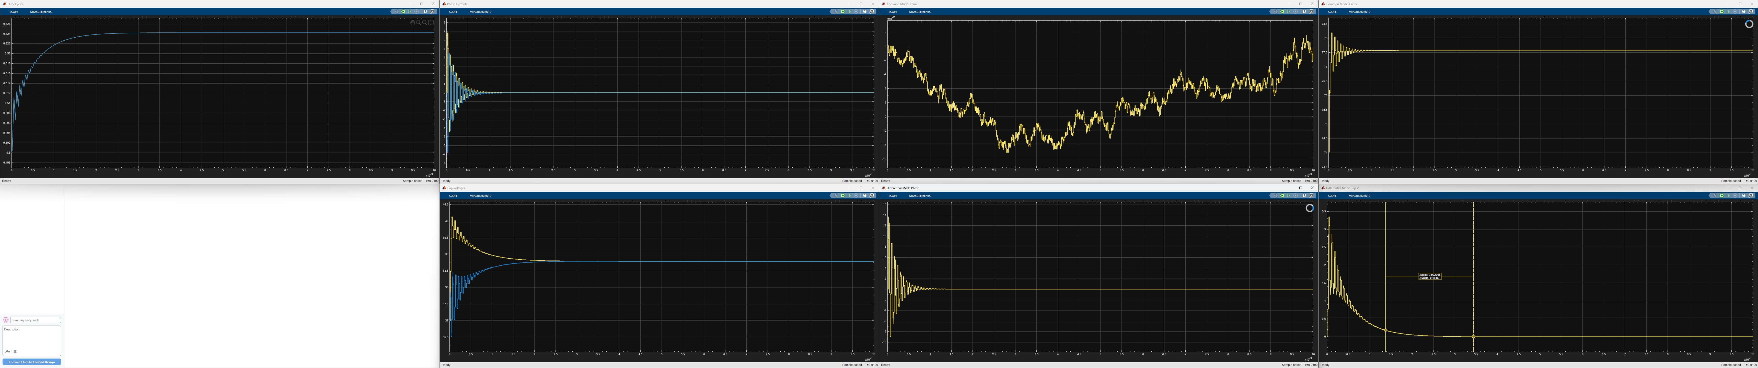
MATLAB/1_Simulink_Experiment/figures/Screenshot 2026-06-30 115021.png
