saunders-jared-final/Boost-Brigade/site/src/assets/figures/ctrl/mil_tests.webp

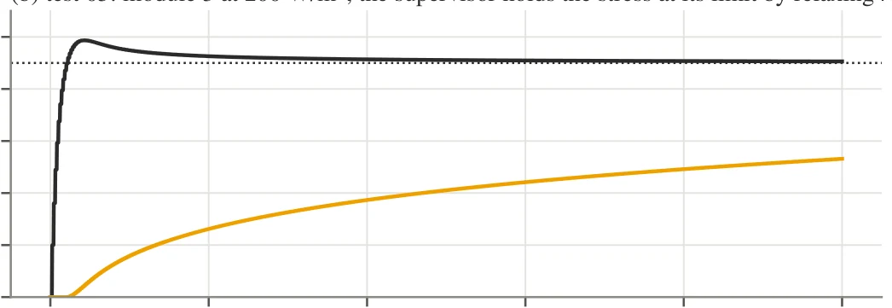
site/src/assets/figures/ctrl/mil_tests.webp
