saunders-jared-final/Boost-Brigade/site/src/assets/figures/results/mil_validate.webp

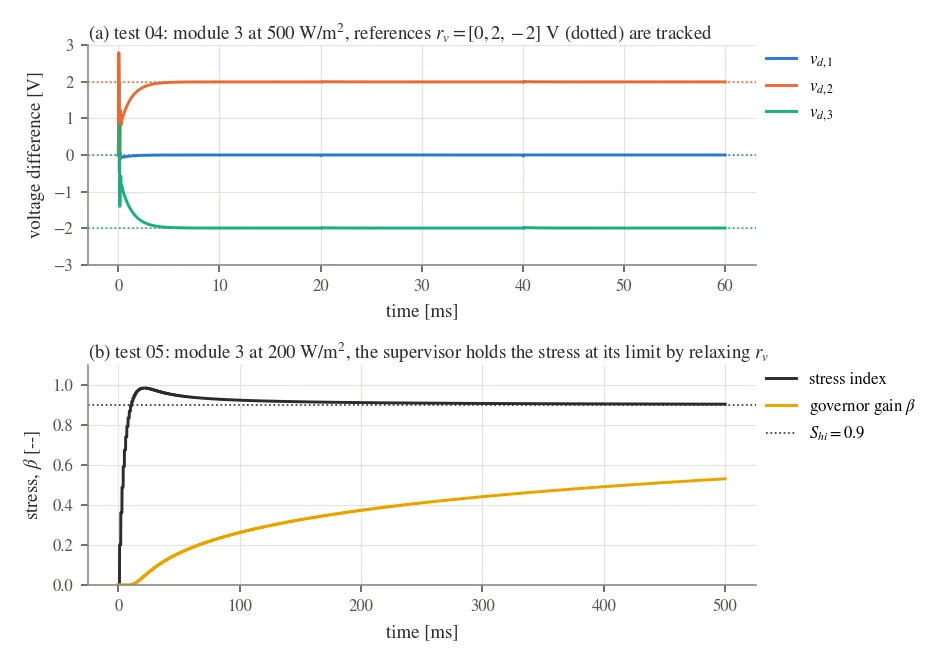
site/src/assets/figures/results/mil_validate.webp
