saunders-jared-final/Boost-Brigade/site/src/assets/figures/results/qspice_run.webp

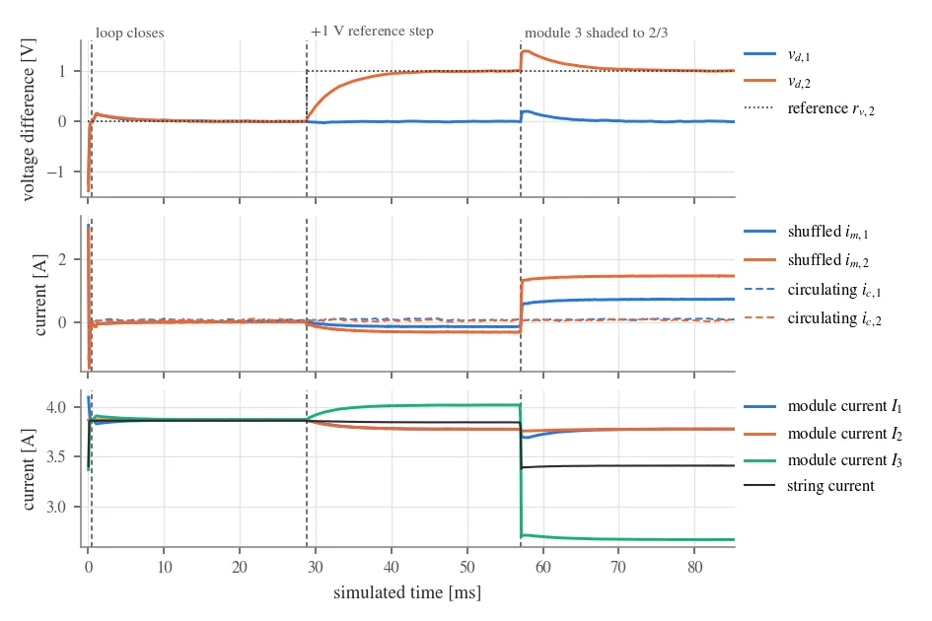
site/src/assets/figures/results/qspice_run.webp
