saunders-jared-final/Boost-Brigade/8_Results/Bench_Open_Loop_100kHz/ol100k_a_oppoints.pdf

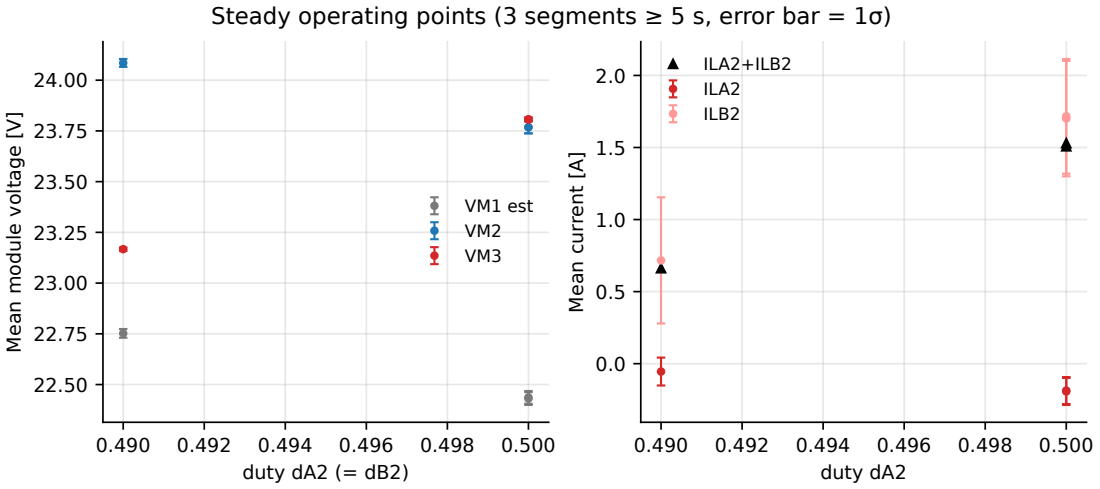
[picture p479: page 1]
0.490 0.492 0.494 0.496 0.498 0.500 duty dA2 (= dB2); VM1 est VM2 VM3; 0.490 0.492 0.494 0.496 0.498 0.500 duty dA2; Mean current [A]; ILA2+ILB2 ILA2 ILB2

Steady operating points (3 segments ≥ 5 s, error bar = 1σ)

Mean module voltage [V]
