saunders-jared-final/Boost-Brigade/8_Results/Bench_Open_Loop_100kHz/ol100k_a_overview.pdf

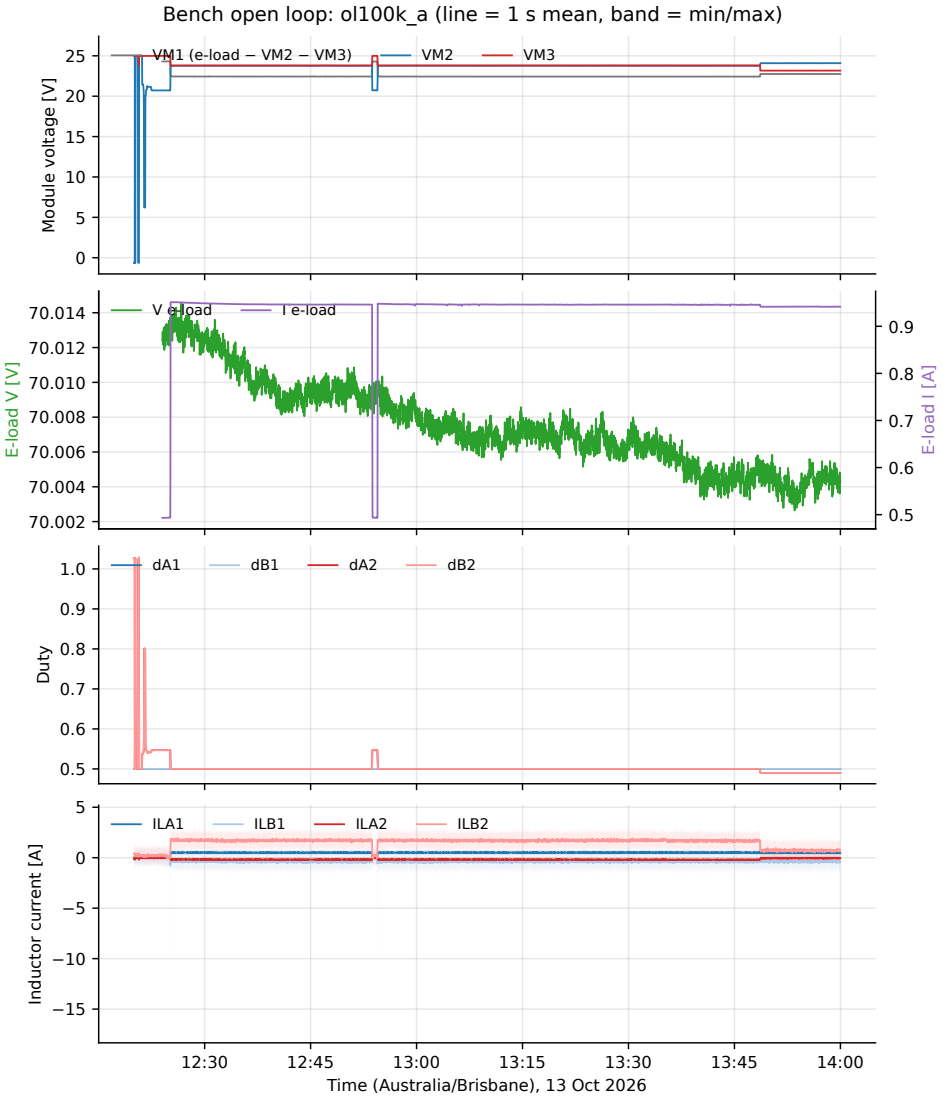
[picture p480: page 1]
Module voltage [V]; VM1 (e-load − VM2 − VM3); E-load V [V]; V e-load; I e-load; Duty; Inductor current [A]; ILA1; ILB1; ILA2; ILB2; E-load I [A]

Bench open loop: ol100k_a (line = 1 s mean, band = min/max)

Time (Australia/Brisbane), 13 Oct 2026
