saunders-jared-final/Boost-Brigade/MATLAB/1_Simulink_Experiment/figures/per_module_voltage_shading.pdf

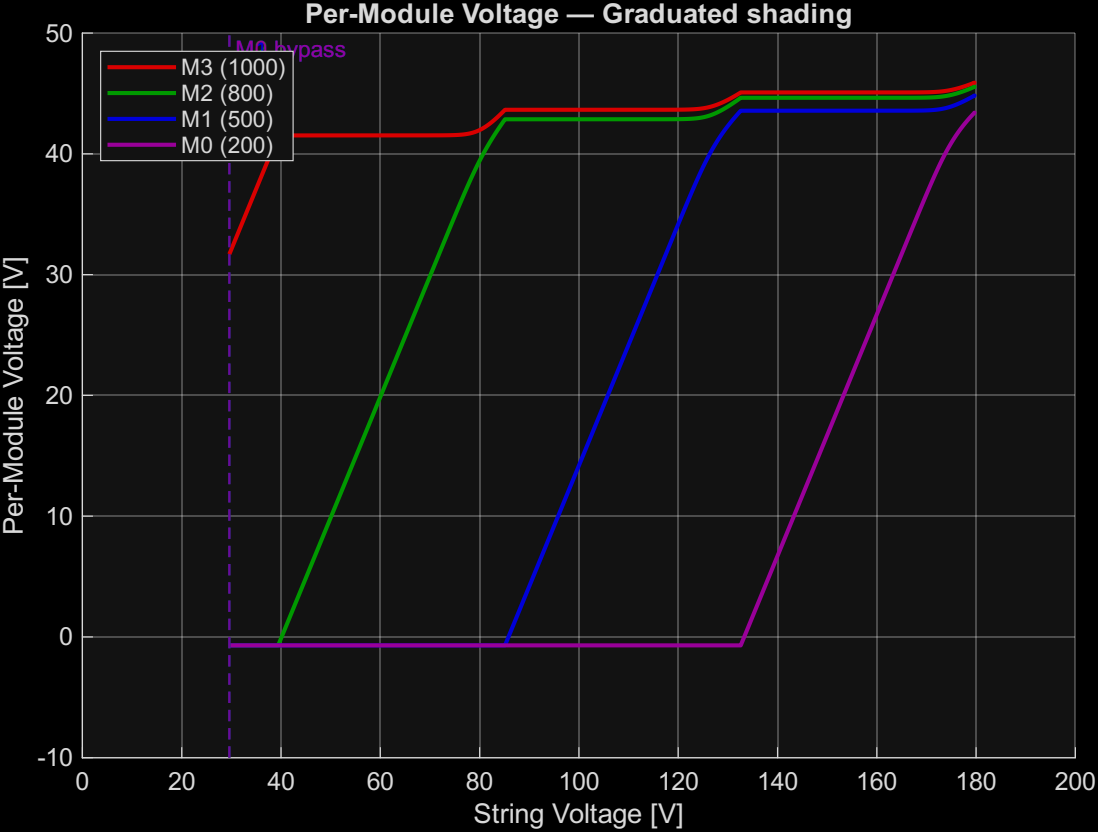
[picture p481: page 1]
String Voltage [V]; ule; Volta; Per-Module Voltage — Graduated shading; M210 bypass M3 (1000) M2 (800) M1 (500) M0 (200)
