saunders-jared-final/Boost-Brigade/MATLAB/1_Simulink_Experiment/figures/PV_Module_STC_VI_PV.pdf

### I-V Curve — STC Validation

### P-V Curve — STC Validation

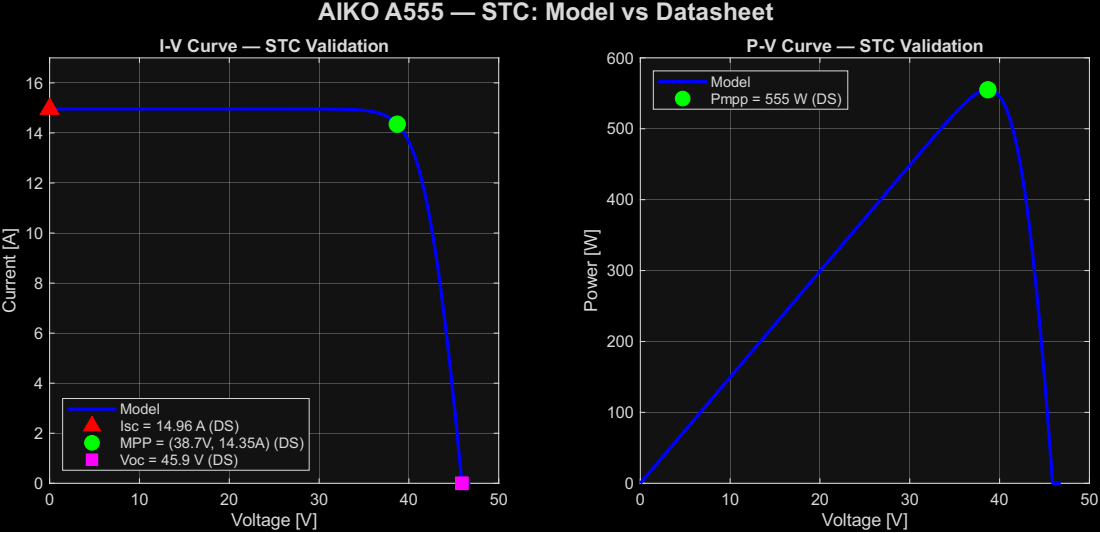
[picture p482: page 1]
Voltage [V]; urre; Model Pmpp = 555 W (DS)

AIKO A555 — STC: Model vs Datasheet

Model Isc = 14.96 A (DS)

MPP = (38.7V, 14.35A) (DS) Voc = 45.9 V (DS)
