saunders-jared-final/Boost-Brigade/MATLAB/1_Simulink_Experiment/figures/string_PV_shading.pdf

## PV String P-V — Partial Shading Effects

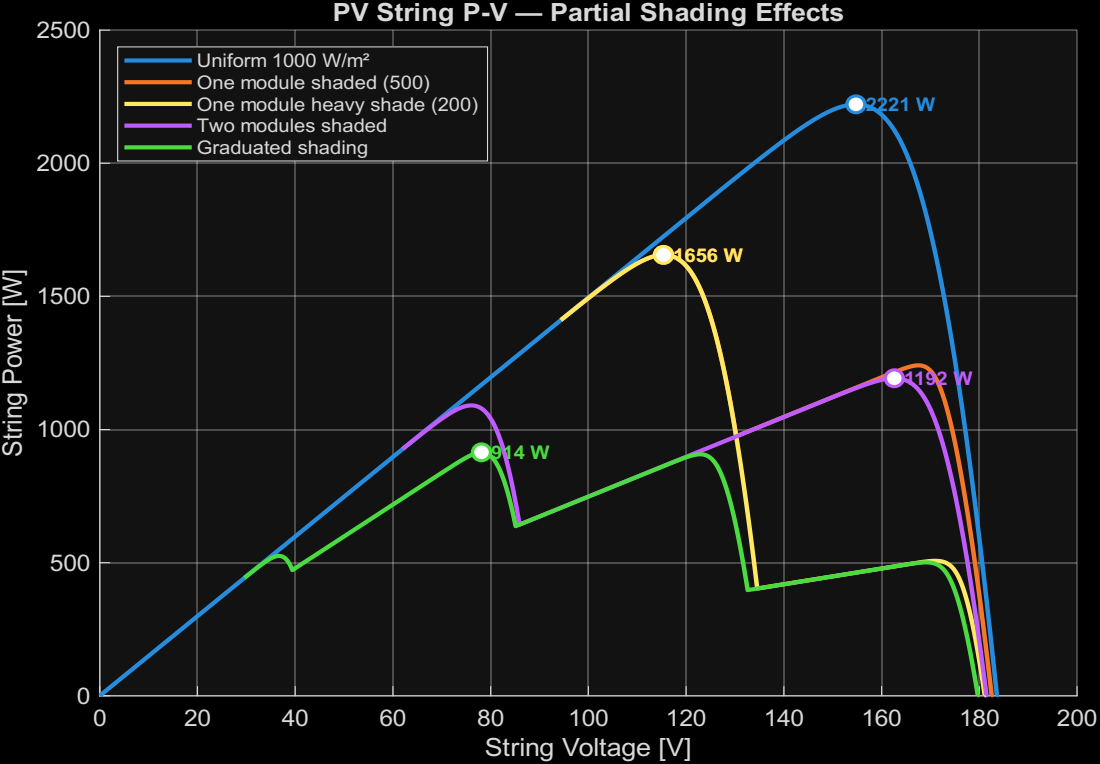
[picture p483: page 1]
String Voltage [V]; Strin

Uniform 1000 W/m² One module shaded (500) One module heavy shade (200) Two modules shaded Graduated shading | | | 2221 W
