saunders-jared-final/Boost-Brigade/MATLAB/1_Simulink_Experiment/figures/temperature_IV.pdf

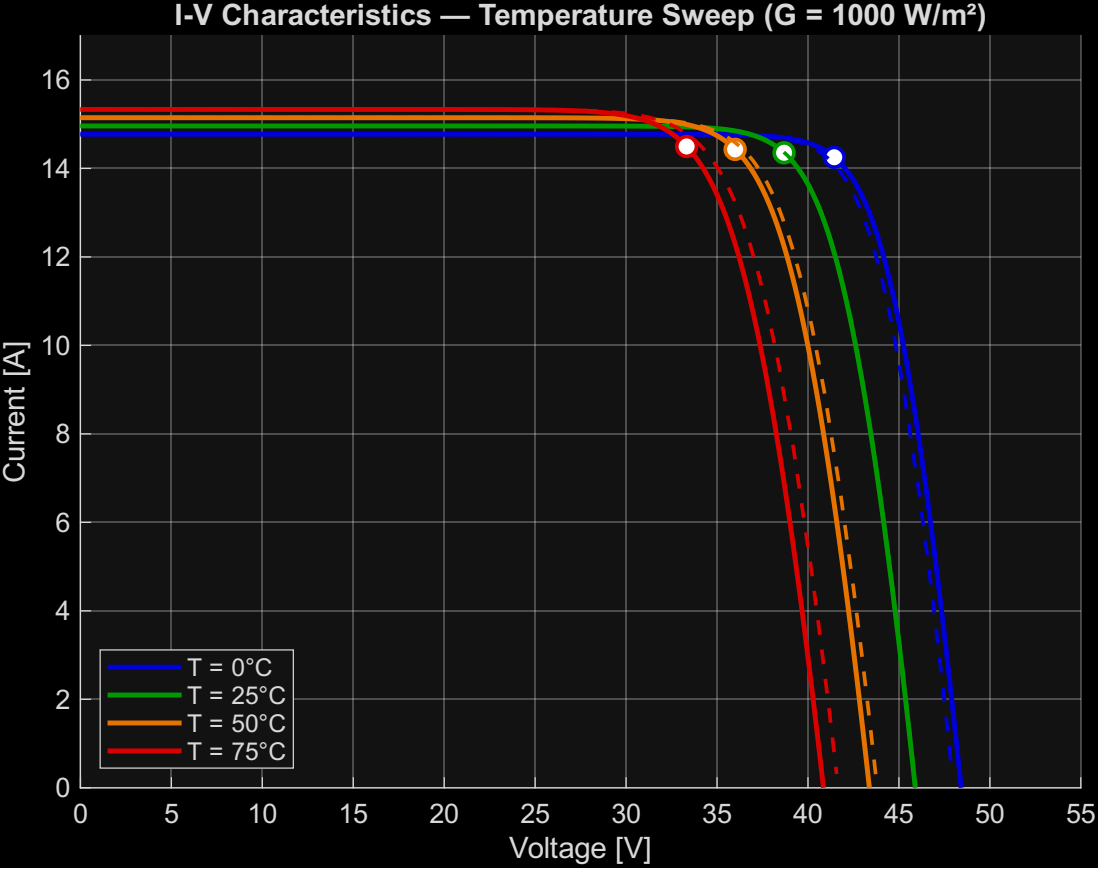
[picture p484: page 1]
Voltage [V]; urre

I-V Characteristics — Temperature Sweep (G = 1000 W/m²)
