saunders-jared-final/Boost-Brigade/0_Documentation/jared-assessment/CapstoneDelivery_latex/figures/results/bench_B06.pdf

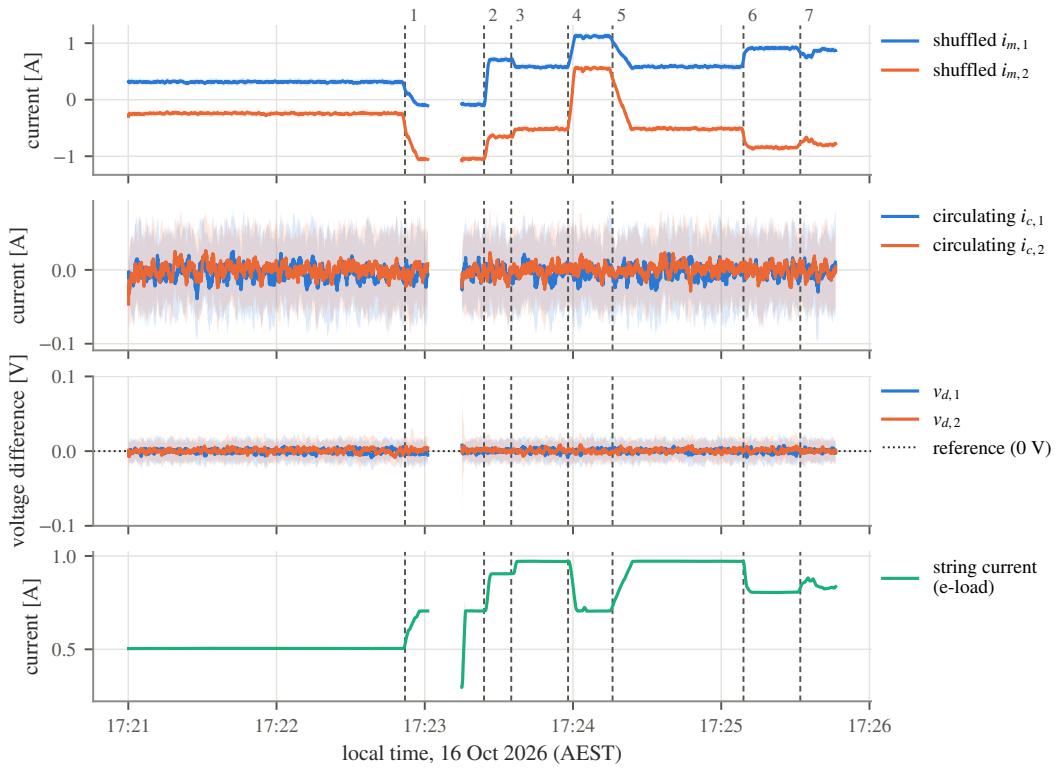
[picture p485: page 1]
current [A]; ffl; voltage difference [V]; 2 reference (0 V); string current (e-load)

local time, 16 Oct 2026 (AEST)
