saunders-jared-final/Boost-Brigade/0_Documentation/jared-assessment/CapstoneDelivery_latex/figures/results/duty_steps.pdf

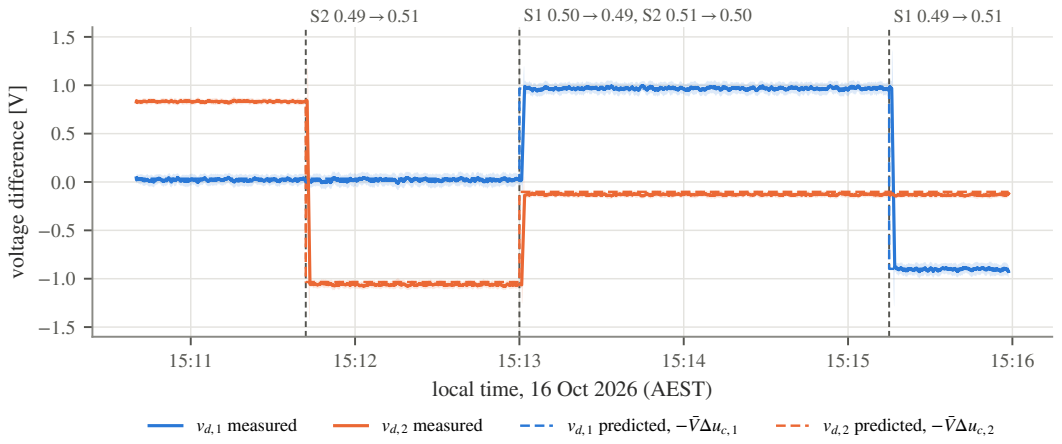
[picture p486: page 1]
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

local time, 16 Oct 2026 (AEST)
