saunders-jared-final/Boost-Brigade/0_Documentation/jared-assessment/CapstoneDelivery_latex/figures/results/metrics_k.pdf

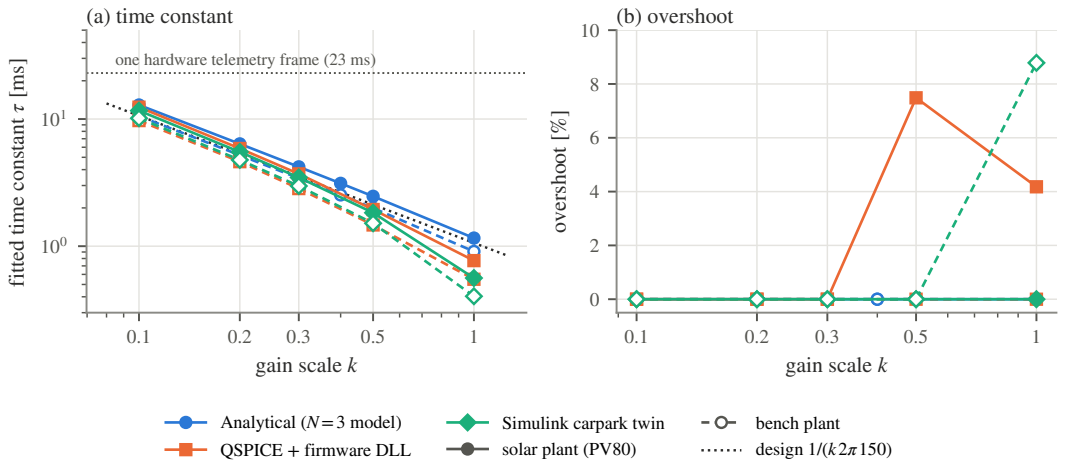
[picture p487: page 1]
gain scale k; overshoot [%]; (b) overshoot; bench plant design 1/(k2π150)

(a) time constant
one hardware telemetry frame (23 ms)

fitted time constant τ [ms]

Analytical (N=3 model)
QSPICE + firmware DLL

Simulink carpark twin
solar plant (PV80)
