saunders-jared-final/Boost-Brigade/0_Documentation/jared-assessment/CapstoneDelivery_latex/figures/results/mil_validate.pdf

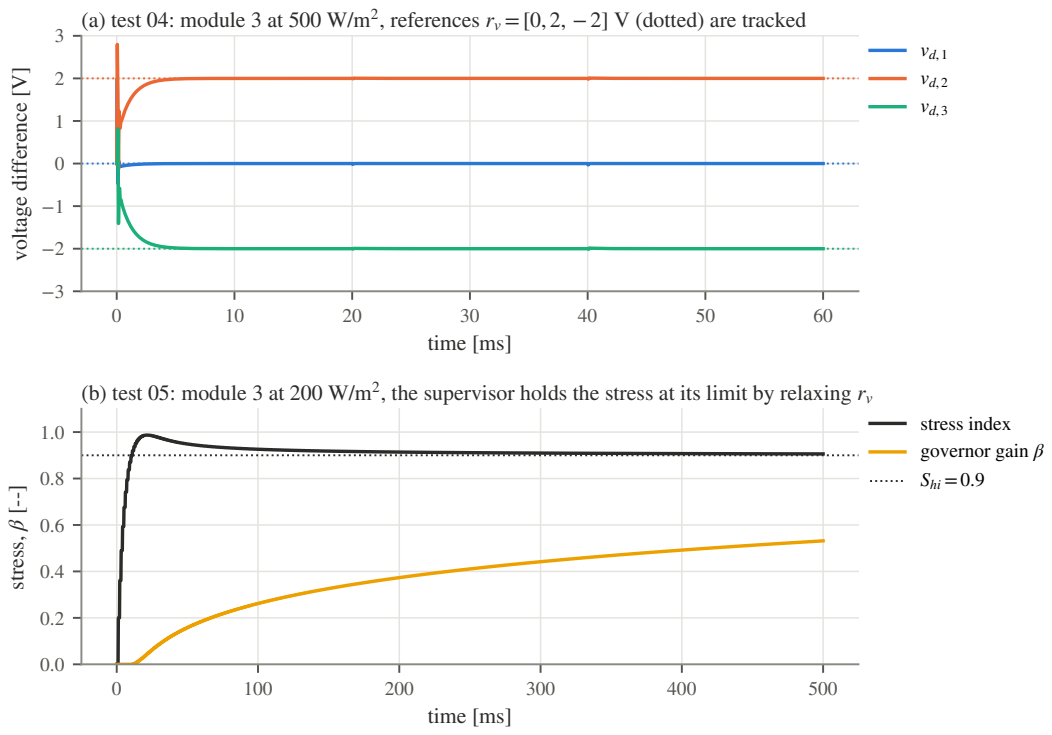
[picture p488: page 1]
voltage difference [V]; (a) test 04: module 3 at 500 W/m²; time [ms]; stress, β [--]; (b) test 05: module 3 at 200 W/m²; stress index governor gain β Shi =0.9

, references rv =[0, 2, −2] V (dotted) are tracked

time [ms]
, the supervisor holds the stress at its limit by relaxing rv
