saunders-jared-final/Boost-Brigade/0_Documentation/jared-assessment/CapstoneDelivery_latex/figures/results/qspice_run.pdf

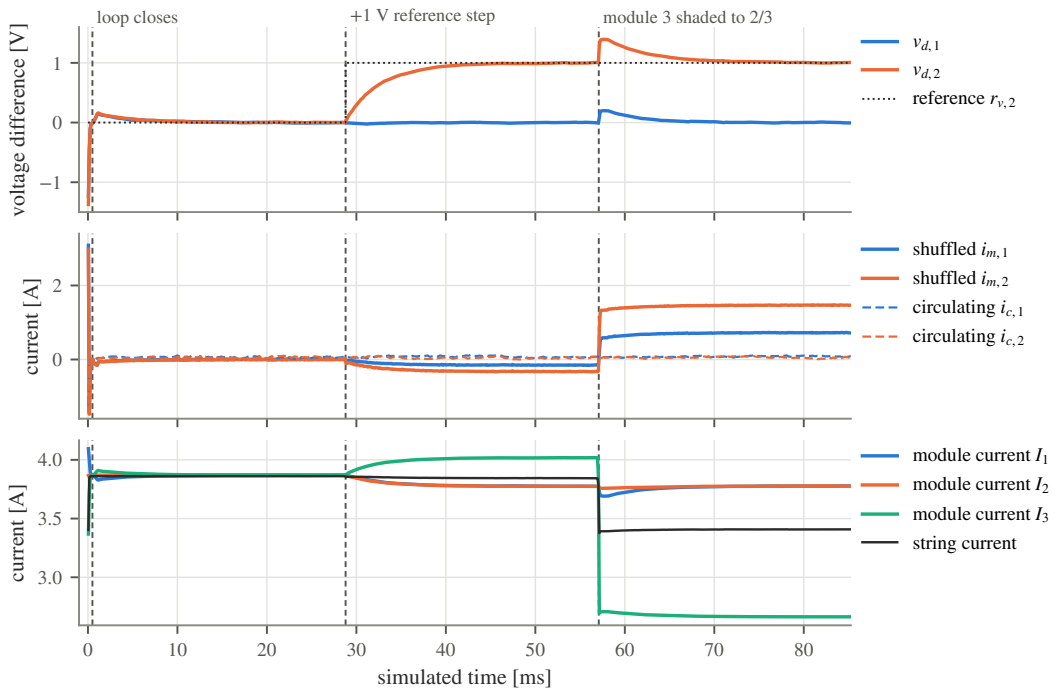
[picture p489: page 1]
voltage difference [V]; loop closes; module 3 shaded to 2/3; current [A]; ffl; string current

simulated time [ms]
