saunders-jared-final/Boost-Brigade/0_Documentation/jared-assessment/CapstoneDelivery_latex/figures/results/solar_S02.pdf

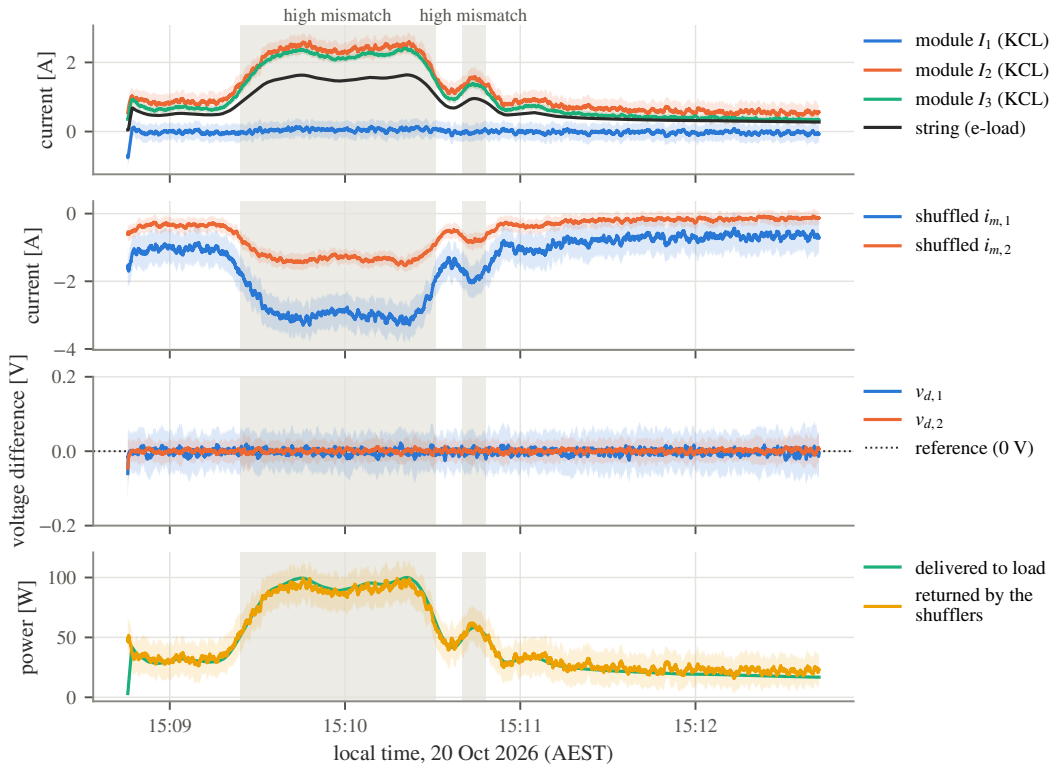
[picture p490: page 1]
current [A]; string (e-load); ffl; voltage difference [V]; 2 reference (0 V); power [W]

high mismatch

delivered to load
returned by the
shufflers

local time, 20 Oct 2026 (AEST)
