saunders-jared-final/Boost-Brigade/8_Results/analysis/out/figures/analytical/S3_PV80_f200k_k0.3.pdf

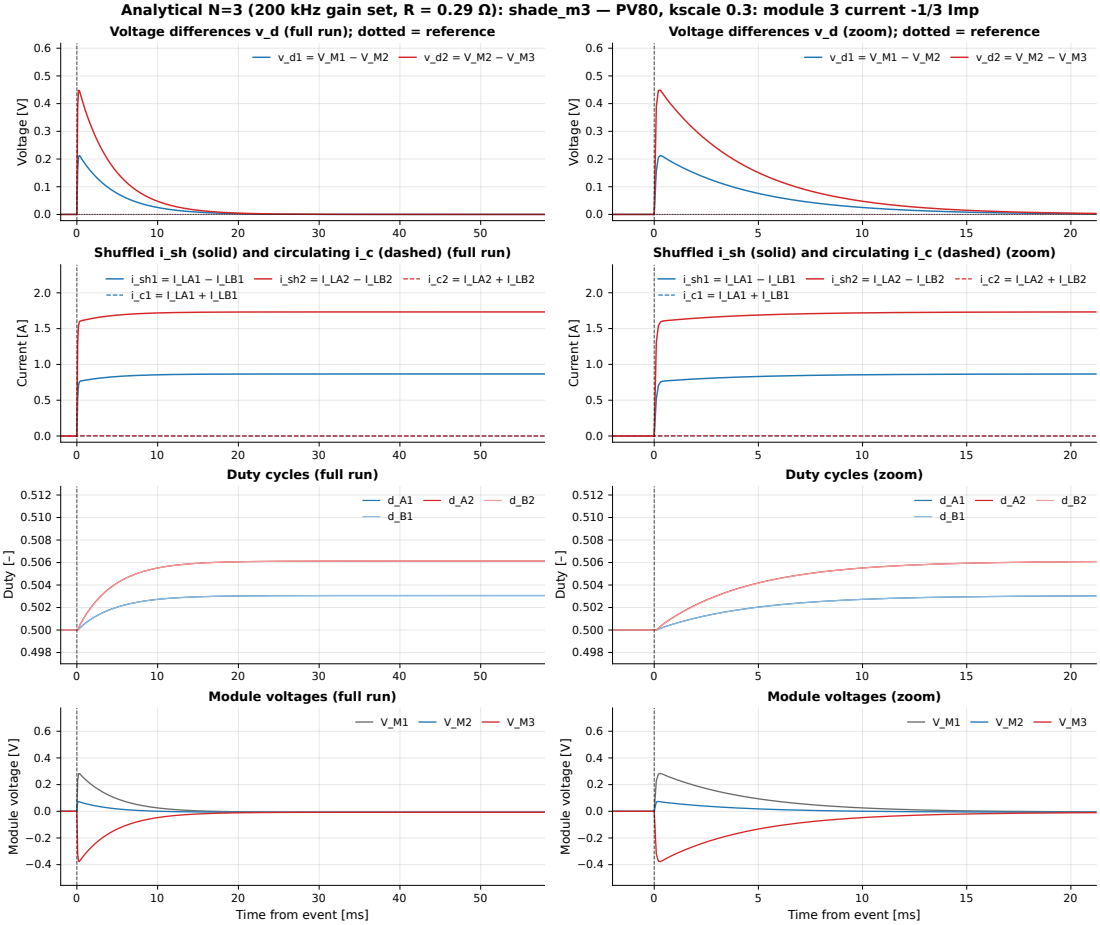
[picture p491: page 1]
Voltage [V]; Current [A]; Duty [–]; Module voltage [V]

Analytical N=3 (200 kHz gain set, R = 0.29 Ω): shade_m3 — PV80, kscale 0.3: module 3 current -1/3 Imp
Voltage differences v_d (full run); dotted = reference

Voltage differences v_d (zoom); dotted = reference

Shuffled i_sh (solid) and circulating i_c (dashed) (full run)

Shuffled i_sh (solid) and circulating i_c (dashed) (zoom)

Duty cycles (full run)

Duty cycles (zoom)

Module voltages (full run)

Module voltages (zoom)

Time from event [ms]
