saunders-jared-final/Boost-Brigade/8_Results/analysis/out/figures/analytical/S4_BENCH_f200k_k0.1.pdf

Analytical N=3 (200 kHz gain set, R = 0.29 Ω): vref2_step — BENCH, kscale 0.1: Vref2 0 -> +1 V

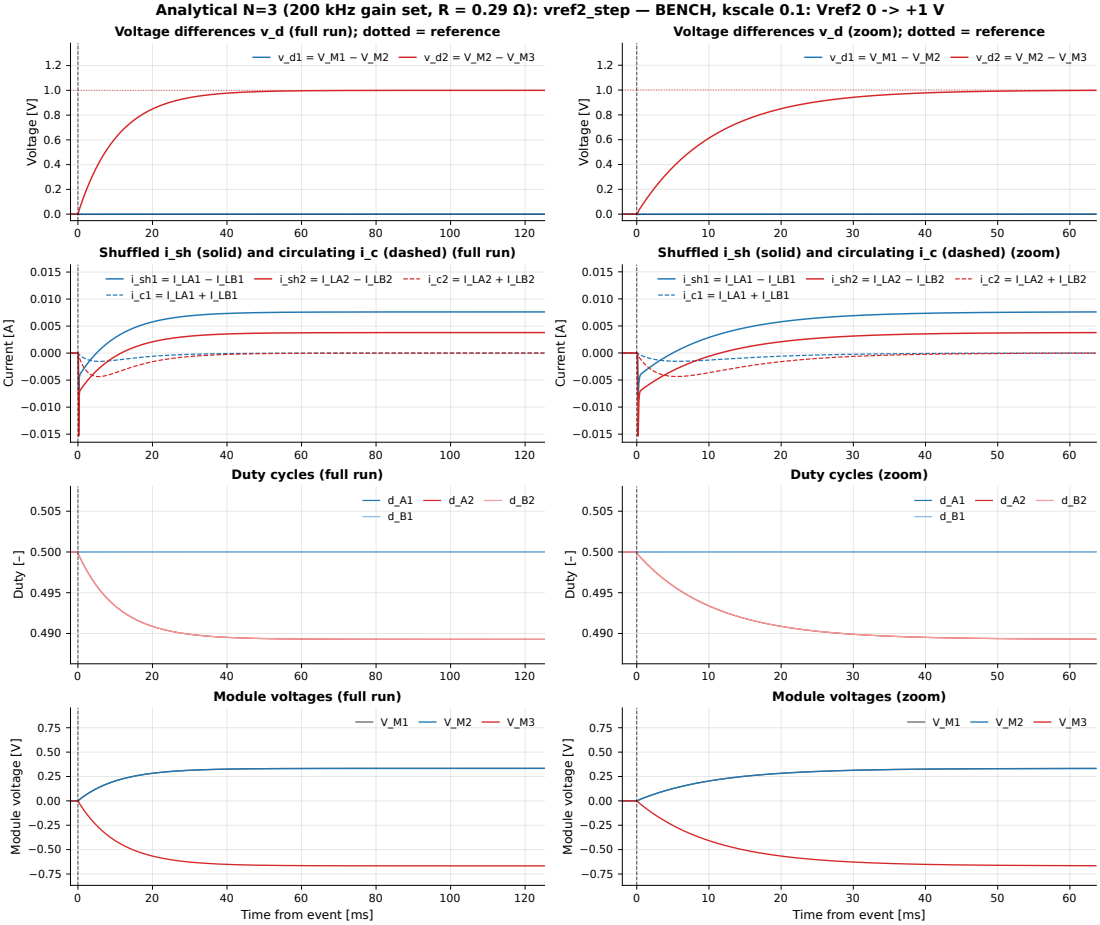
[picture p492: page 1]
Voltage [V]; Current [A]; Duty [–]; Module voltage [V]

Voltage differences v_d (full run); dotted = reference

Voltage differences v_d (zoom); dotted = reference

Shuffled i_sh (solid) and circulating i_c (dashed) (full run)

Shuffled i_sh (solid) and circulating i_c (dashed) (zoom)

Duty cycles (full run)

Duty cycles (zoom)

Module voltages (full run)

Module voltages (zoom)

Time from event [ms]
