saunders-jared-final/Boost-Brigade/8_Results/analysis/out/figures/compare/hw_steady_state_vs_kscale.pdf

### v_d2 steady-state mean ± std (reference 0 V)

### v_d2 sample-to-sample std (noise floor)

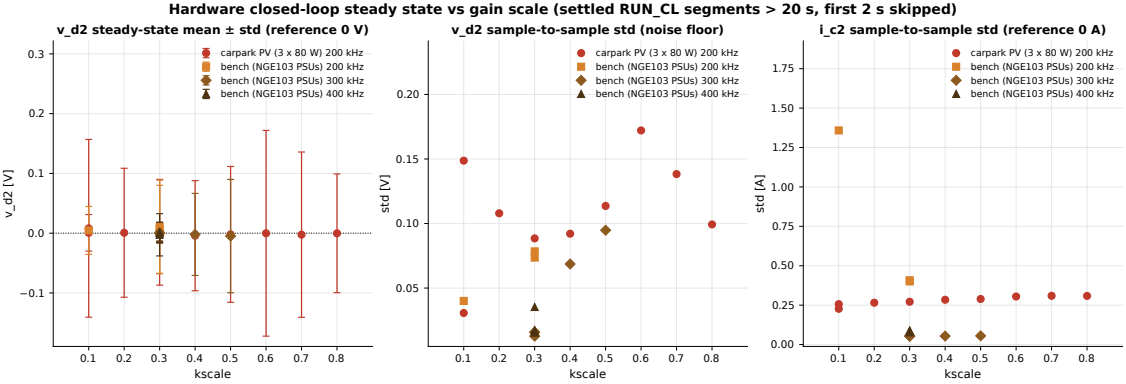
[picture p493: page 1]
kscale; std [V]; std [A]

Hardware closed-loop steady state vs gain scale (settled RUN_CL segments > 20 s, first 2 s skipped)

i_c2 sample-to-sample std (reference 0 A)

carpark PV (3 x 80 W) 200 kHz
bench (NGE103 PSUs) 200 kHz
bench (NGE103 PSUs) 300 kHz
bench (NGE103 PSUs) 400 kHz
