saunders-jared-final/Boost-Brigade/8_Results/analysis/out/figures/compare/S5_duty_steps_hw_vs_analytical.pdf

S5 open-loop common-duty steps: analytical prediction Δv_d = −V̄·u_c (top) against the 16 Oct bench (bottom)

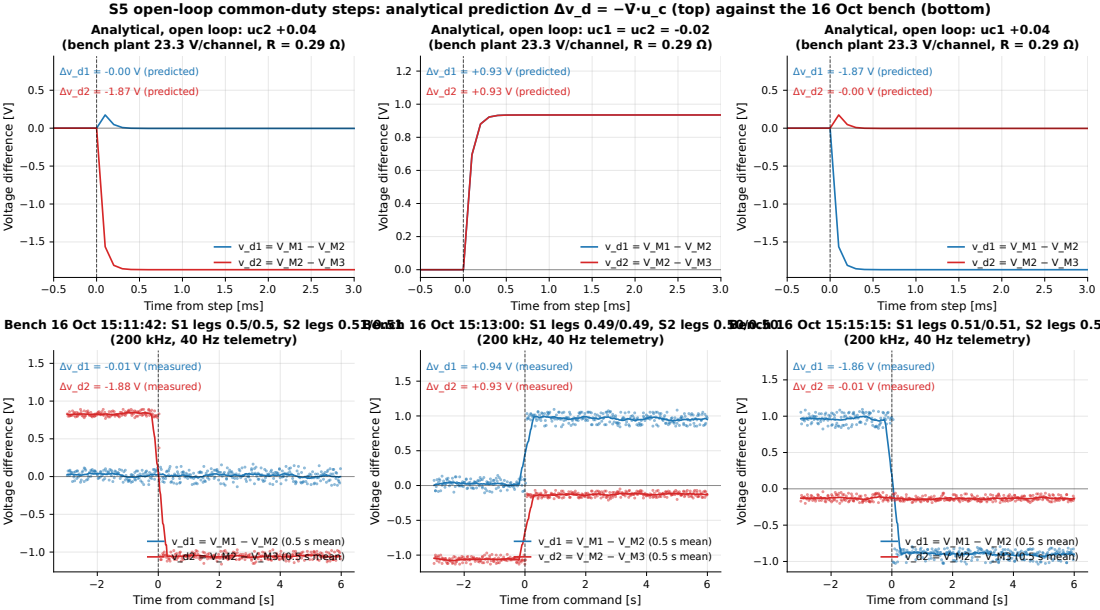
[picture p494: page 1]
Voltage difference [V]; Δv_d1 = -0.00 V (predicted); Δv_d2 = -1.87 V (predicted); Δv_d1 = +0.93 V (predicted); Δv_d2 = +0.93 V (predicted); Δv_d1 = -1.87 V (predicted); Δv_d2 = -0.00 V (predicted); Δv_d1 = -0.01 V (measured); Δv_d2 = -1.88 V (measured); Δv_d1 = +0.94 V (measured); Δv_d2 = +0.93 V (measured); Δv_d1 = -1.86 V (measured); Δv_d2 = -0.01 V (measured); v_d1 = V_M1 − V_M2 (0.5 s mean) v_d2 = V_M2 − V_M3 (0.5 s mean)

Analytical, open loop: uc2 +0.04
(bench plant 23.3 V/channel, R = 0.29 Ω)

Analytical, open loop: uc1 = uc2 = -0.02

Analytical, open loop: uc1 +0.04

Time from step [ms]

Bench 16 Oct 15:11:42: S1 legs 0.5/0.5, S2 legs 0.51/0.51

Bench 16 Oct 15:13:00: S1 legs 0.49/0.49, S2 legs 0.50/0.50

Bench 16 Oct 15:15:15: S1 legs 0.51/0.51, S2 legs 0.50/0.50

(200 kHz, 40 Hz telemetry)

v_d1 = V_M1 − V_M2 (0.5 s mean)
v_d2 = V_M2 − V_M3 (0.5 s mean)

v_d1 = V_M1 − V_M2 (0.5 s mean) v_d2 = V_M2 − V_M3 (0.5 s mean)

Time from command [s]
