saunders-jared-final/Boost-Brigade/8_Results/analysis/out/figures/compare/step_S1_BENCH_k0.5_ic2.pdf

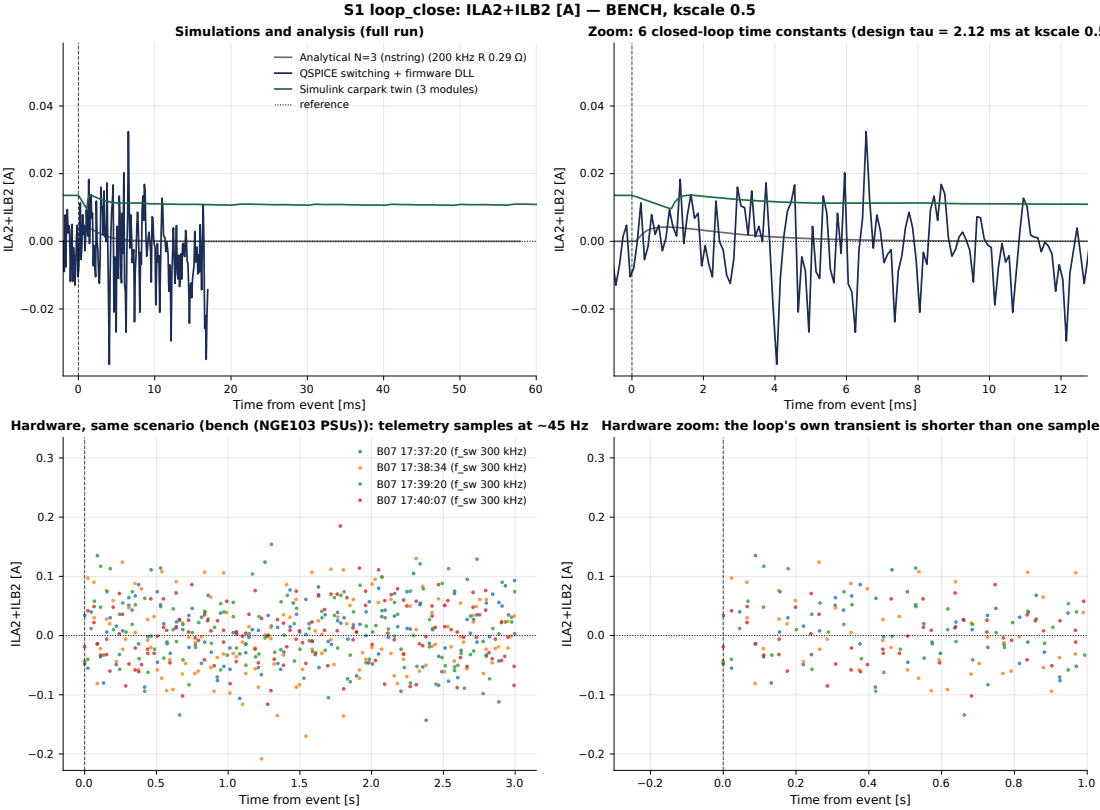
[picture p496: page 1]
ILA2+ILB2 [A]; B07 17:37:20 (f_sw 300 kHz) B07 17:38:34 (f_sw 300 kHz) B07 17:39:20 (f_sw 300 kHz) B07 17:40:07 (f_sw 300 kHz); S1 loop_close: ILA2+ILB2 [A] — BENCH, kscale 0.5

Simulations and analysis (full run)

Zoom: 6 closed-loop time constants (design tau = 2.12 ms at kscale 0.5)

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

Time from event [ms]

Hardware, same scenario (bench (NGE103 PSUs)): telemetry samples at ~45 Hz

Hardware zoom: the loop's own transient is shorter than one sample

Time from event [s]
