saunders-jared-final/Boost-Brigade/8_Results/analysis/out/figures/compare/step_S1_BENCH_k1_ic2.pdf

## S1 loop_close: ILA2+ILB2 [A] — BENCH, kscale 1

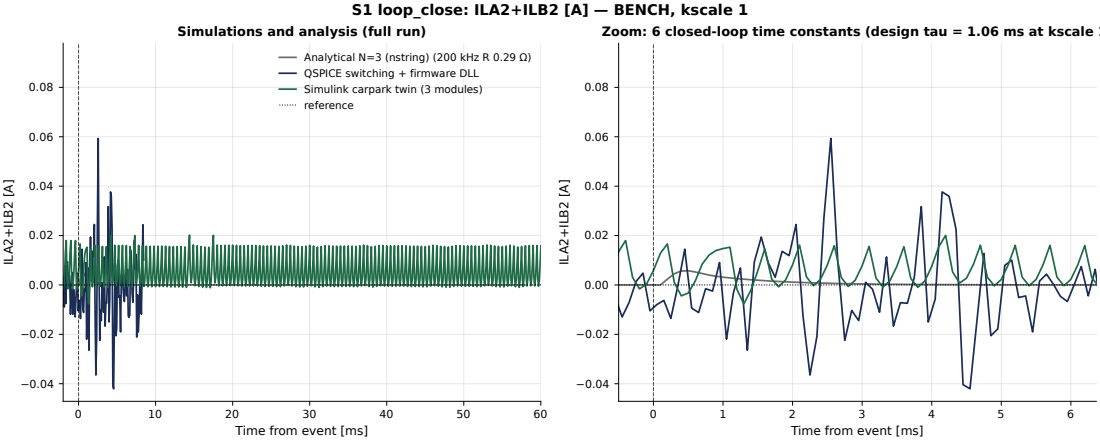
[picture p497: page 1]
ILA2+ILB2 [A]

Simulations and analysis (full run)

Zoom: 6 closed-loop time constants (design tau = 1.06 ms at kscale 1)

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

Time from event [ms]
