saunders-jared-final/Boost-Brigade/8_Results/analysis/out/figures/compare/step_S1_PV80_k0.1_id2.pdf

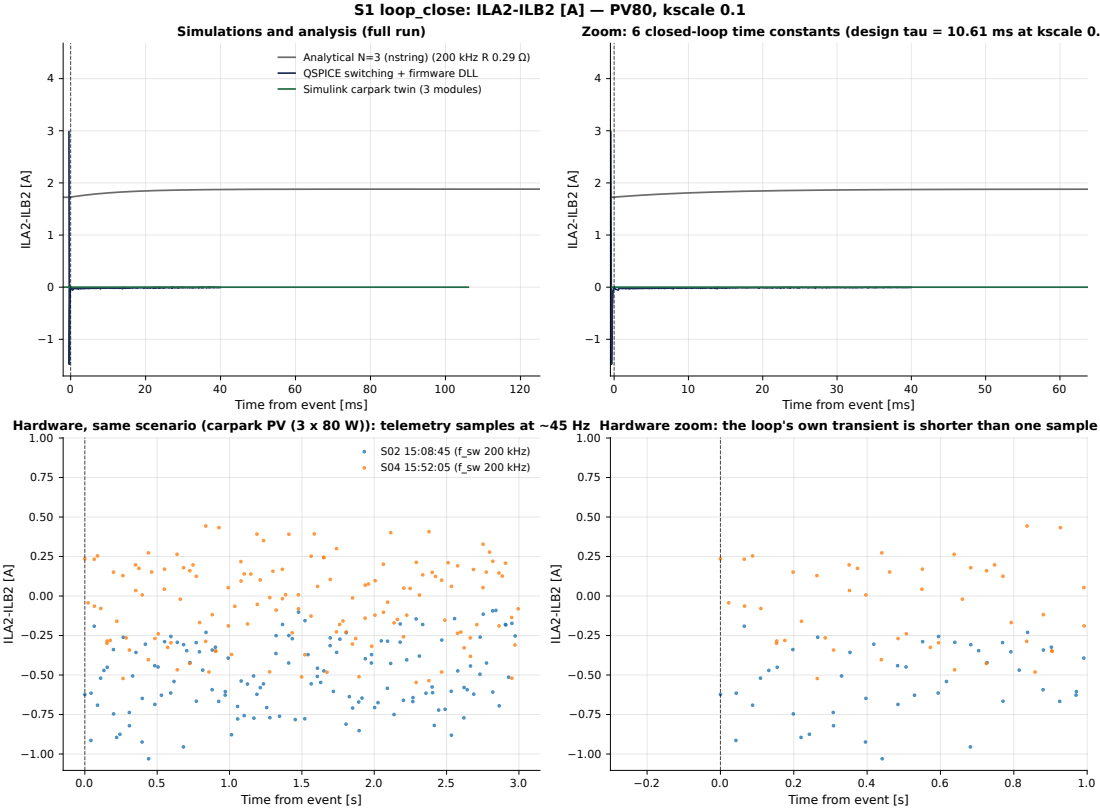
[picture p498: page 1]
ILA2-ILB2 [A]; S02 15:08:45 (f_sw 200 kHz) S04 15:52:05 (f_sw 200 kHz); S1 loop_close: ILA2-ILB2 [A] — PV80, kscale 0.1

Simulations and analysis (full run)

Zoom: 6 closed-loop time constants (design tau = 10.61 ms at kscale 0.1)

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

Time from event [ms]

Hardware, same scenario (carpark PV (3 x 80 W)): telemetry samples at ~45 Hz

Hardware zoom: the loop's own transient is shorter than one sample

Time from event [s]
