saunders-jared-final/Boost-Brigade/8_Results/analysis/out/figures/compare/step_S1_PV80_k0.2_vd2.pdf

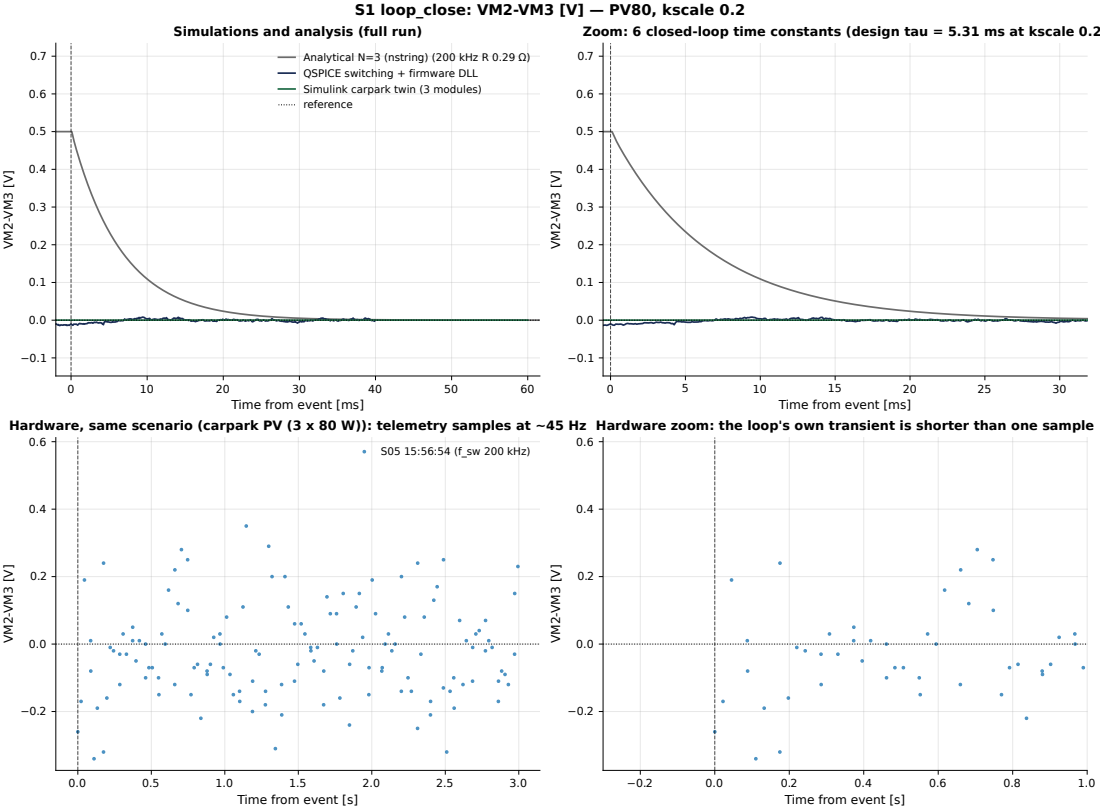
[picture p499: page 1]
S05 15:56:54 (f_sw 200 kHz); S1 loop_close: VM2-VM3 [V] — PV80, kscale 0.2

Simulations and analysis (full run)

Zoom: 6 closed-loop time constants (design tau = 5.31 ms at kscale 0.2)

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

Time from event [ms]

Hardware, same scenario (carpark PV (3 x 80 W)): telemetry samples at ~45 Hz

Hardware zoom: the loop's own transient is shorter than one sample

Time from event [s]
