saunders-jared-final/Boost-Brigade/8_Results/analysis/out/figures/compare/step_S1_PV80_k0.4_ic2.pdf

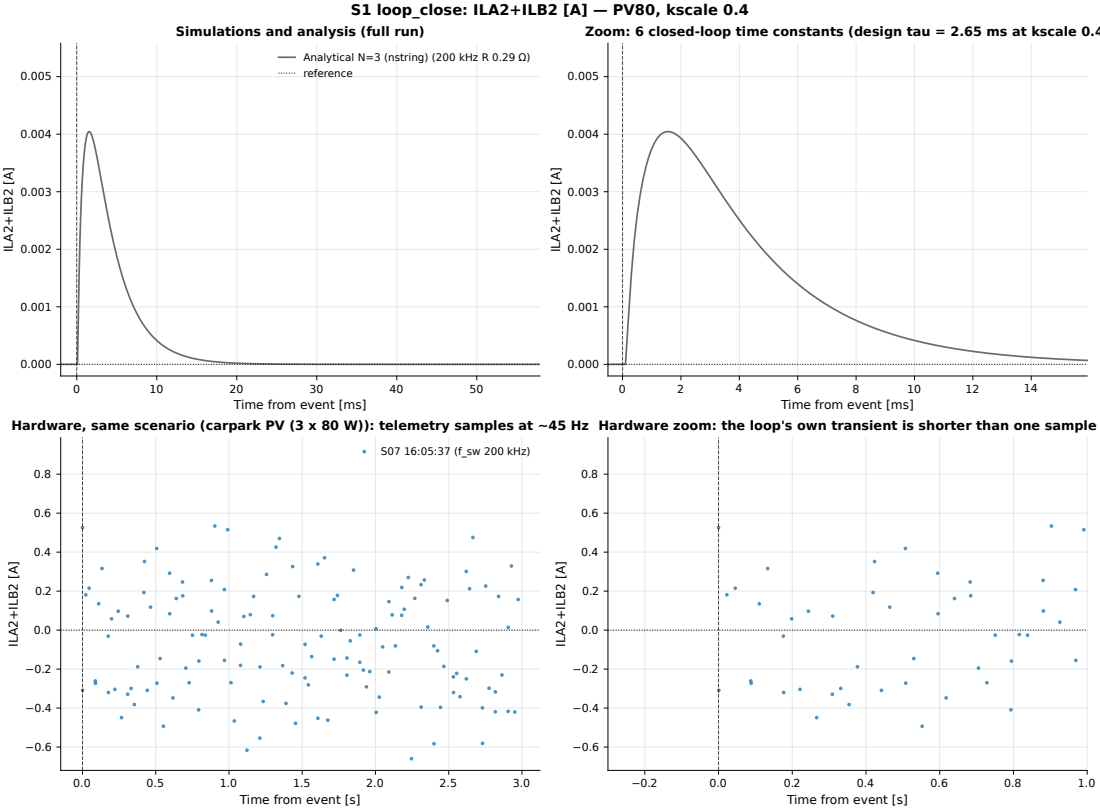
[picture p500: page 1]
ILA2+ILB2 [A]; S07 16:05:37 (f_sw 200 kHz); S1 loop_close: ILA2+ILB2 [A] — PV80, kscale 0.4

Simulations and analysis (full run)

Zoom: 6 closed-loop time constants (design tau = 2.65 ms at kscale 0.4)

Analytical N=3 (nstring) (200 kHz R 0.29 Ω)
reference

Time from event [ms]

Hardware, same scenario (carpark PV (3 x 80 W)): telemetry samples at ~45 Hz

Hardware zoom: the loop's own transient is shorter than one sample

Time from event [s]
