saunders-jared-final/Boost-Brigade/0_Documentation/schematic_ordered_vo.pdf

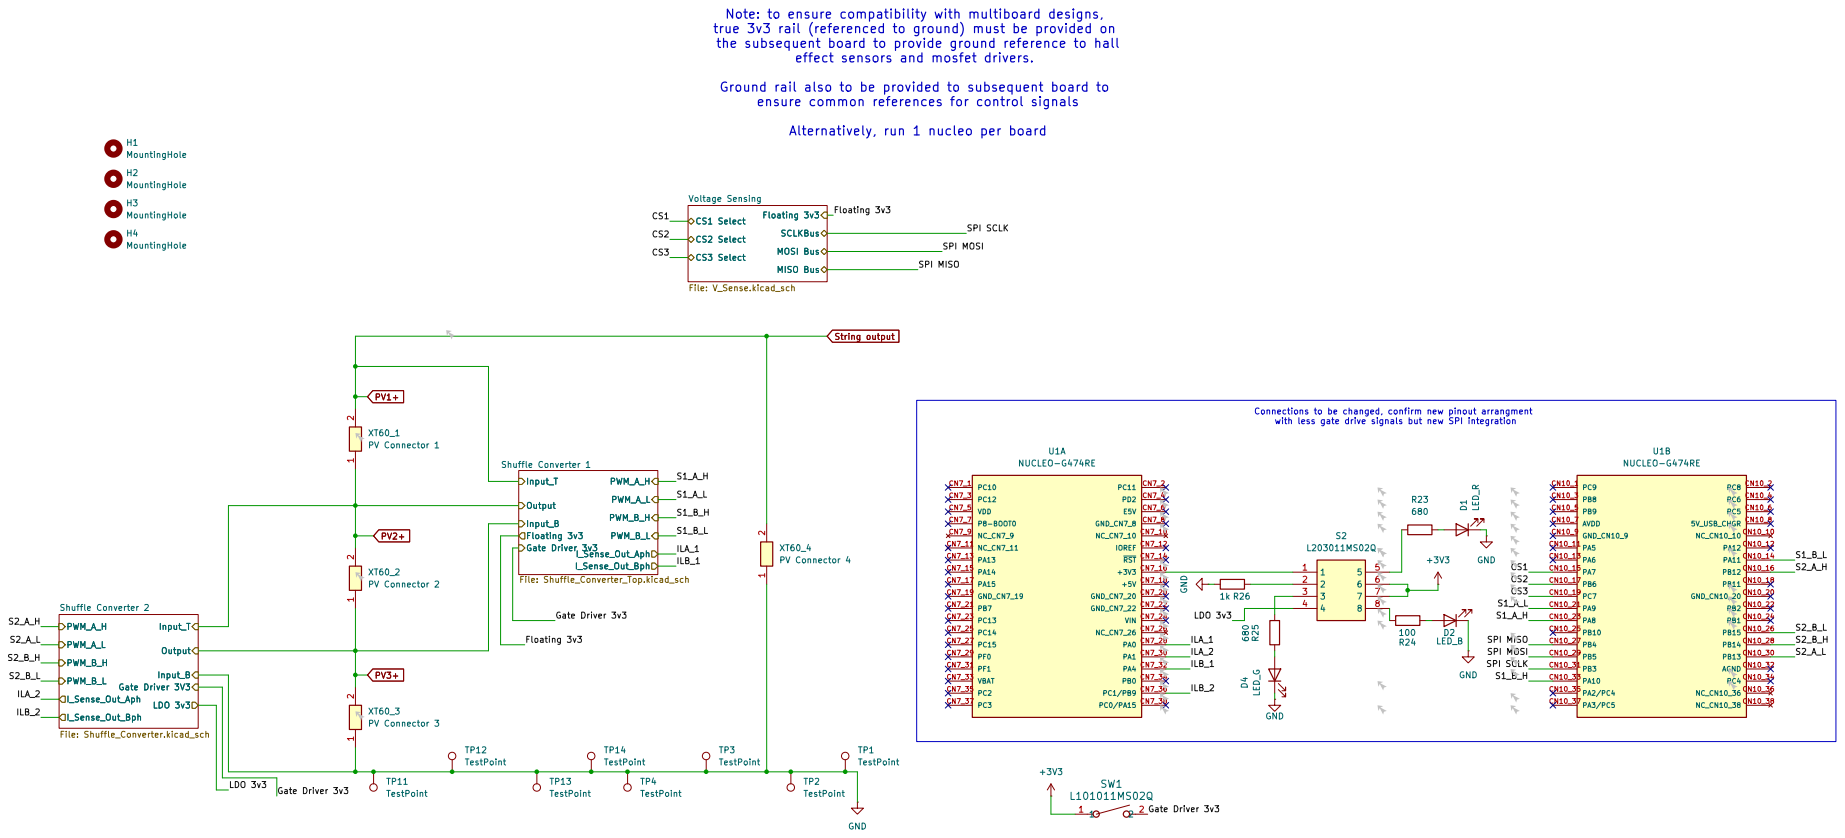
[picture p501: page 1]

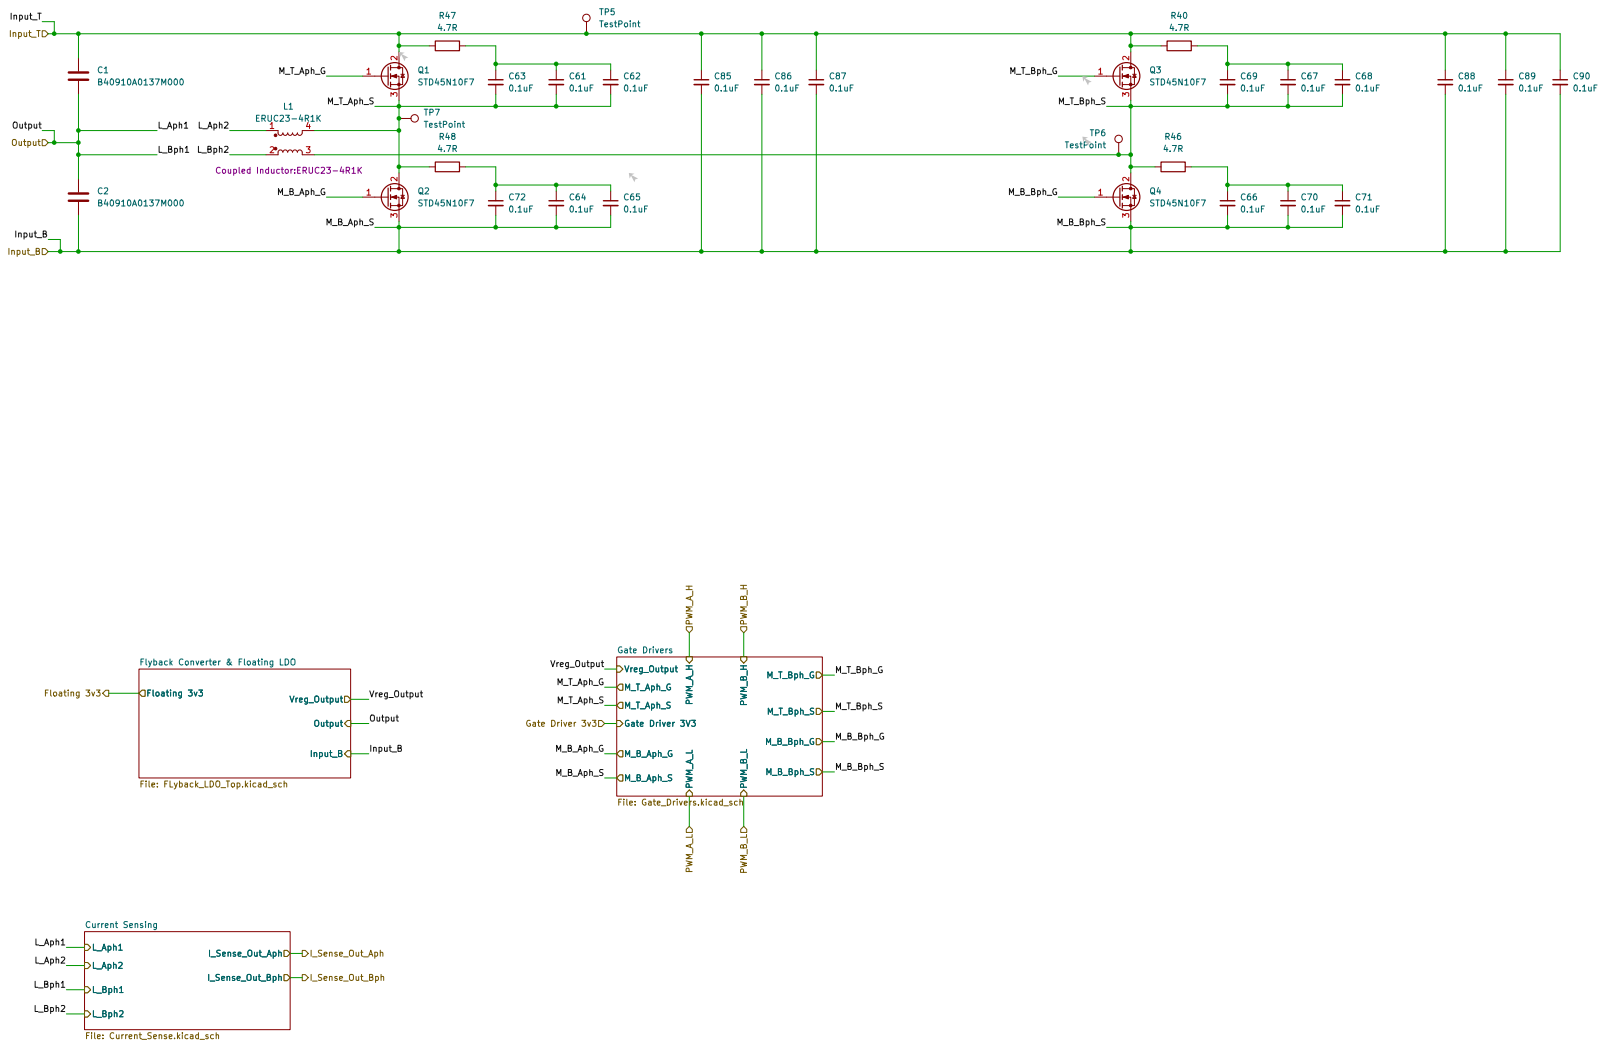
[picture p502: page 2]

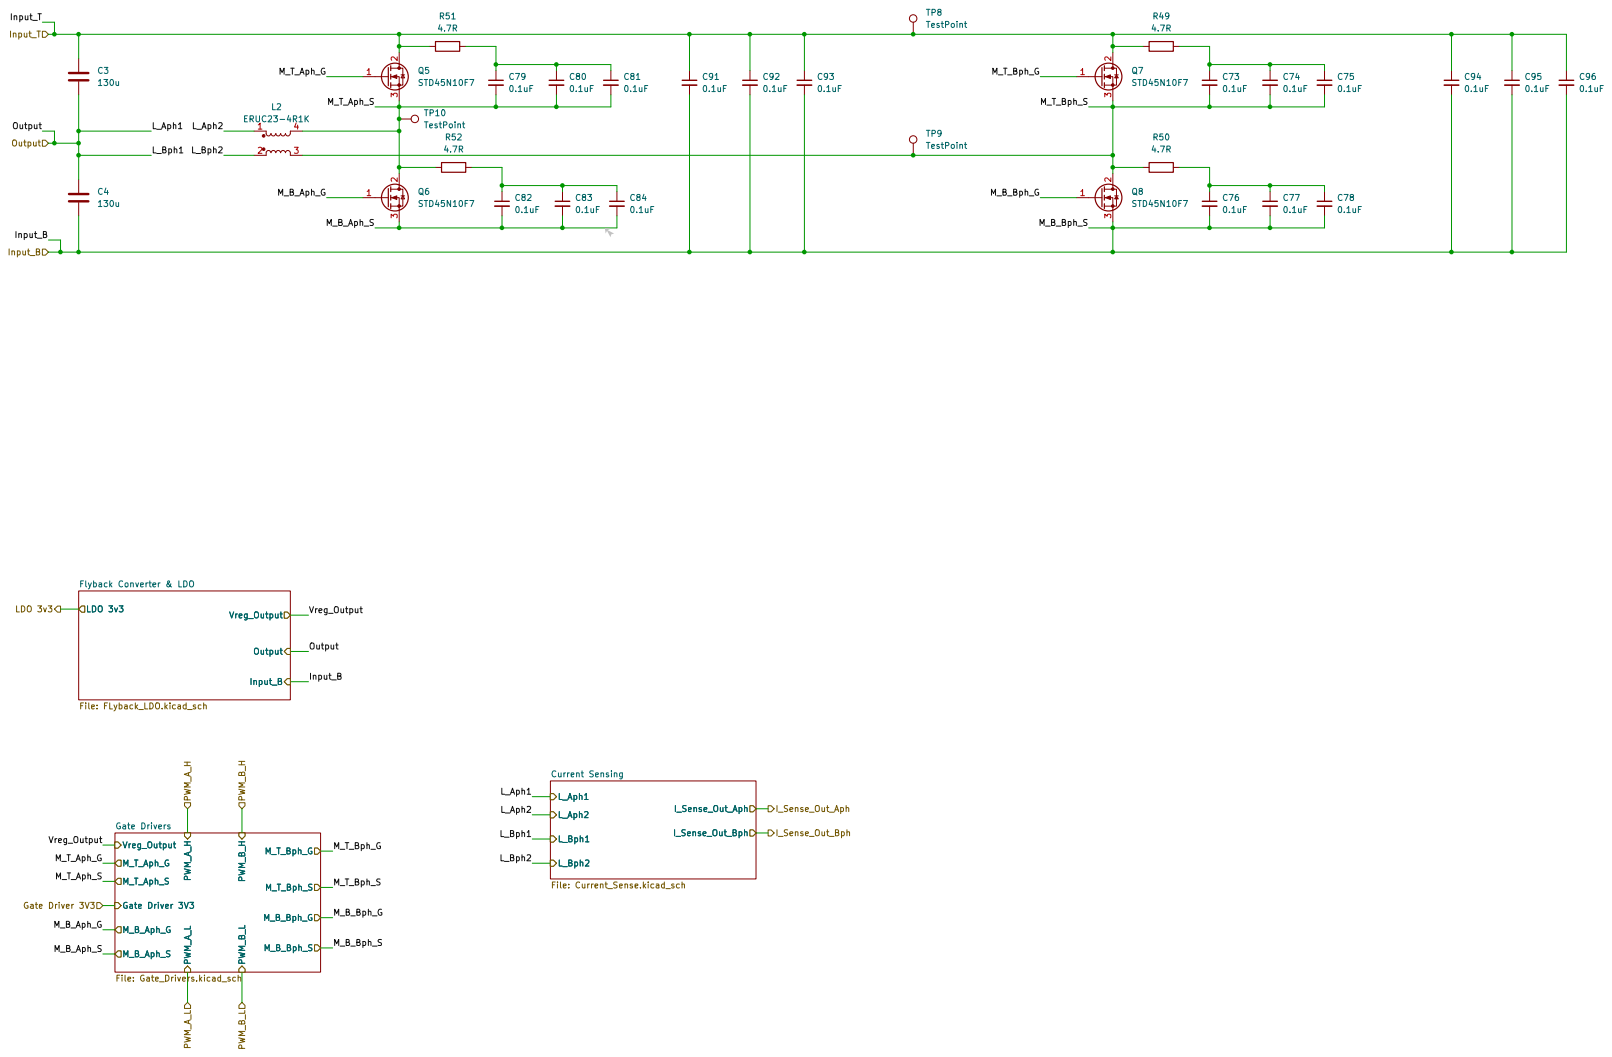
[picture p503: page 3]

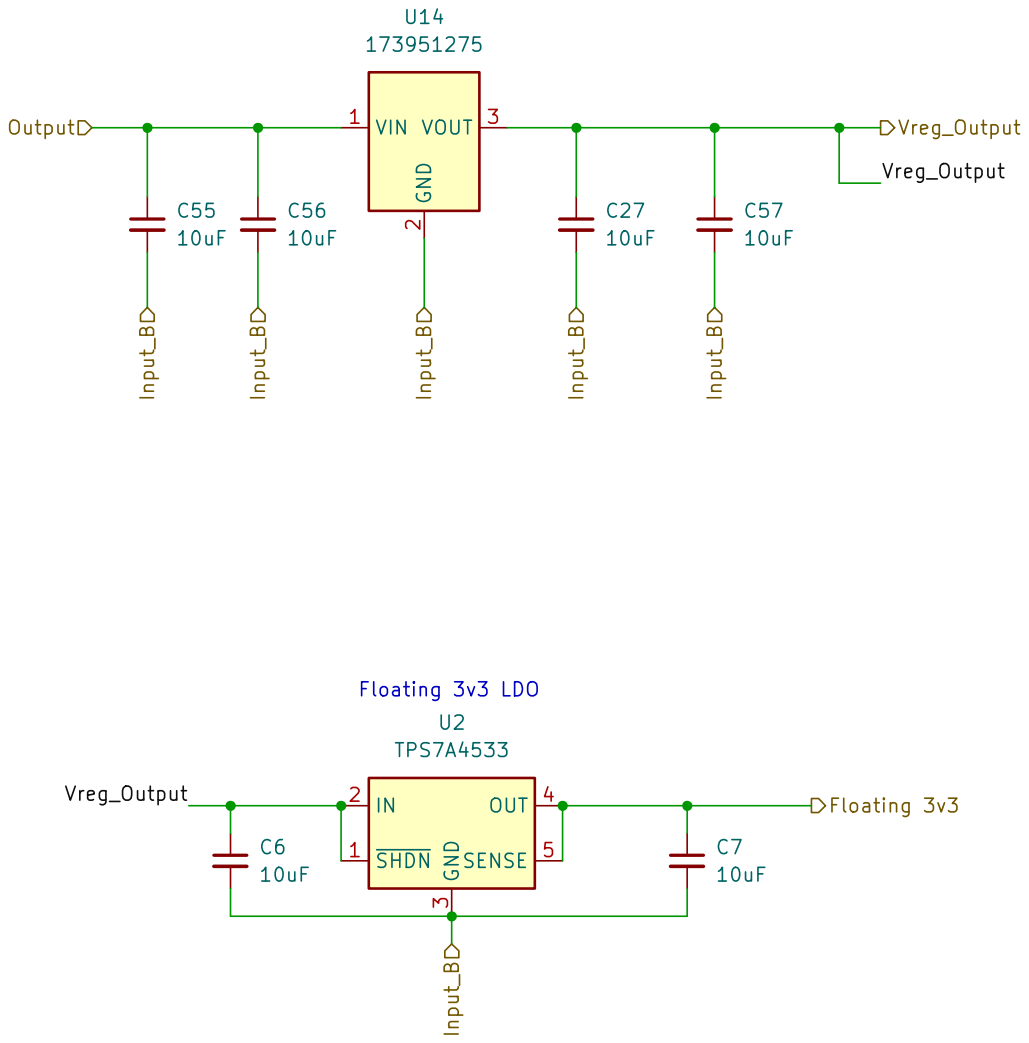
[picture p504: page 4]

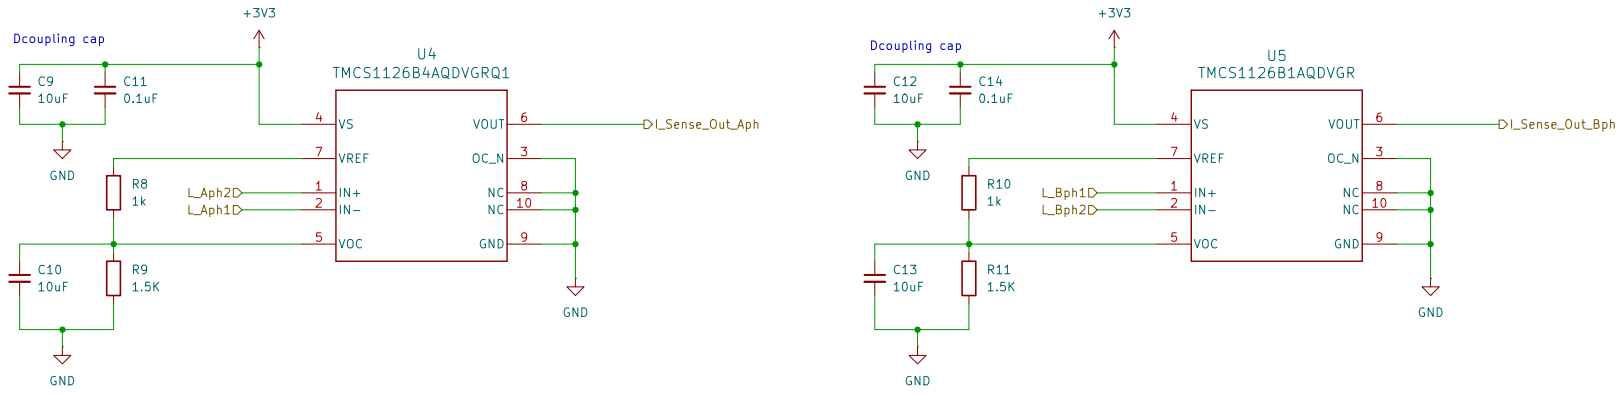
[picture p505: page 5]

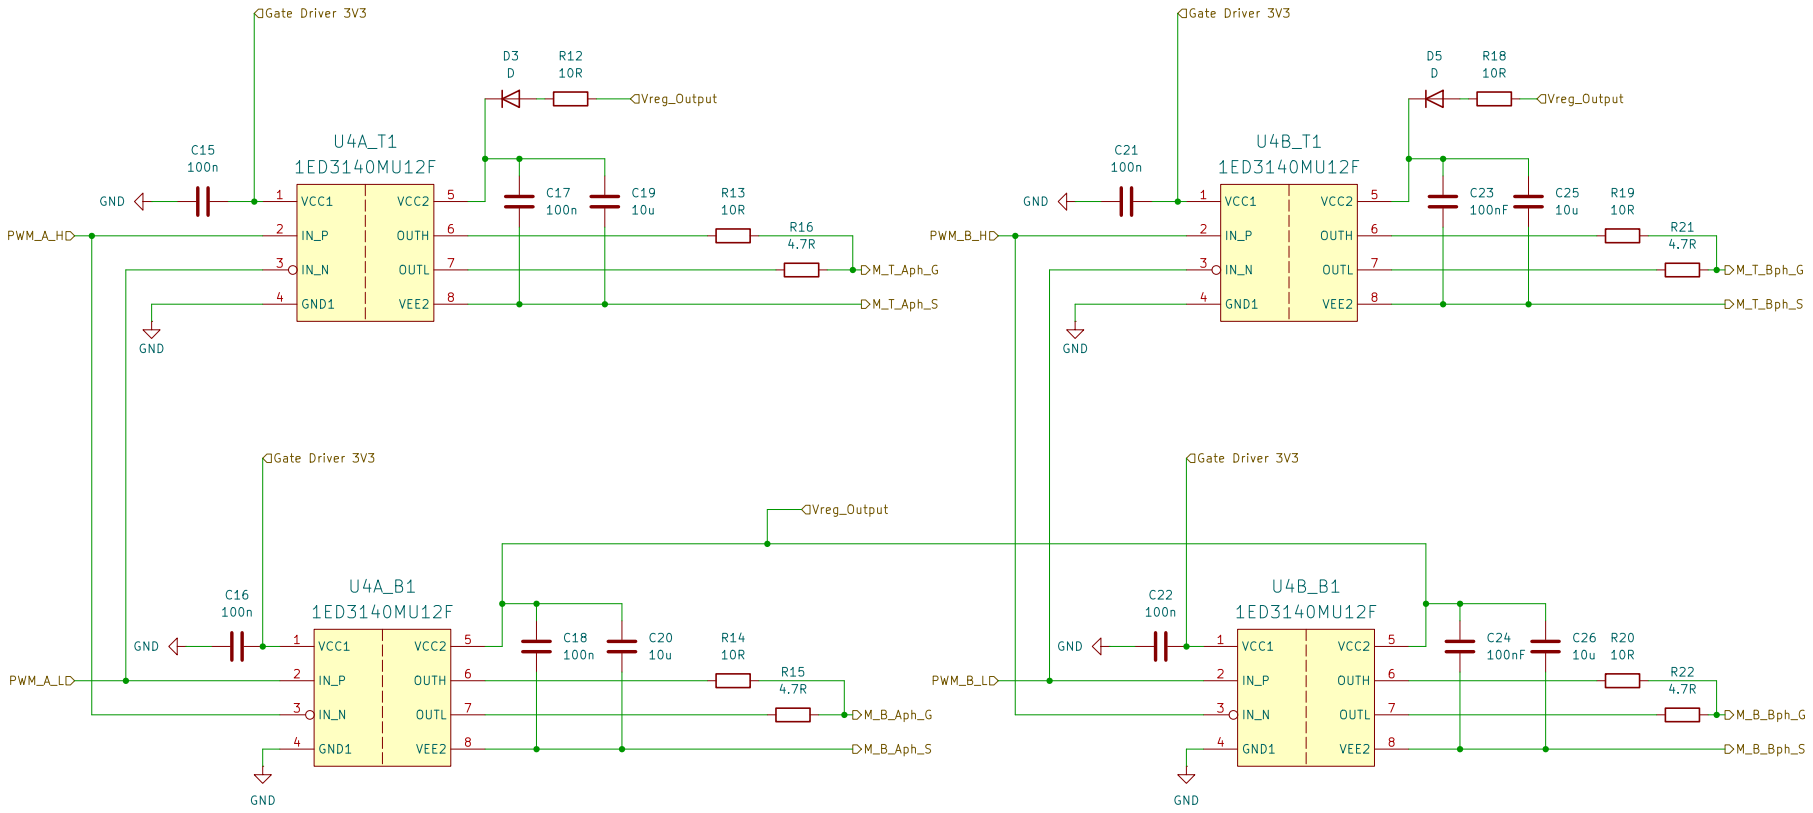
[picture p506: page 6]

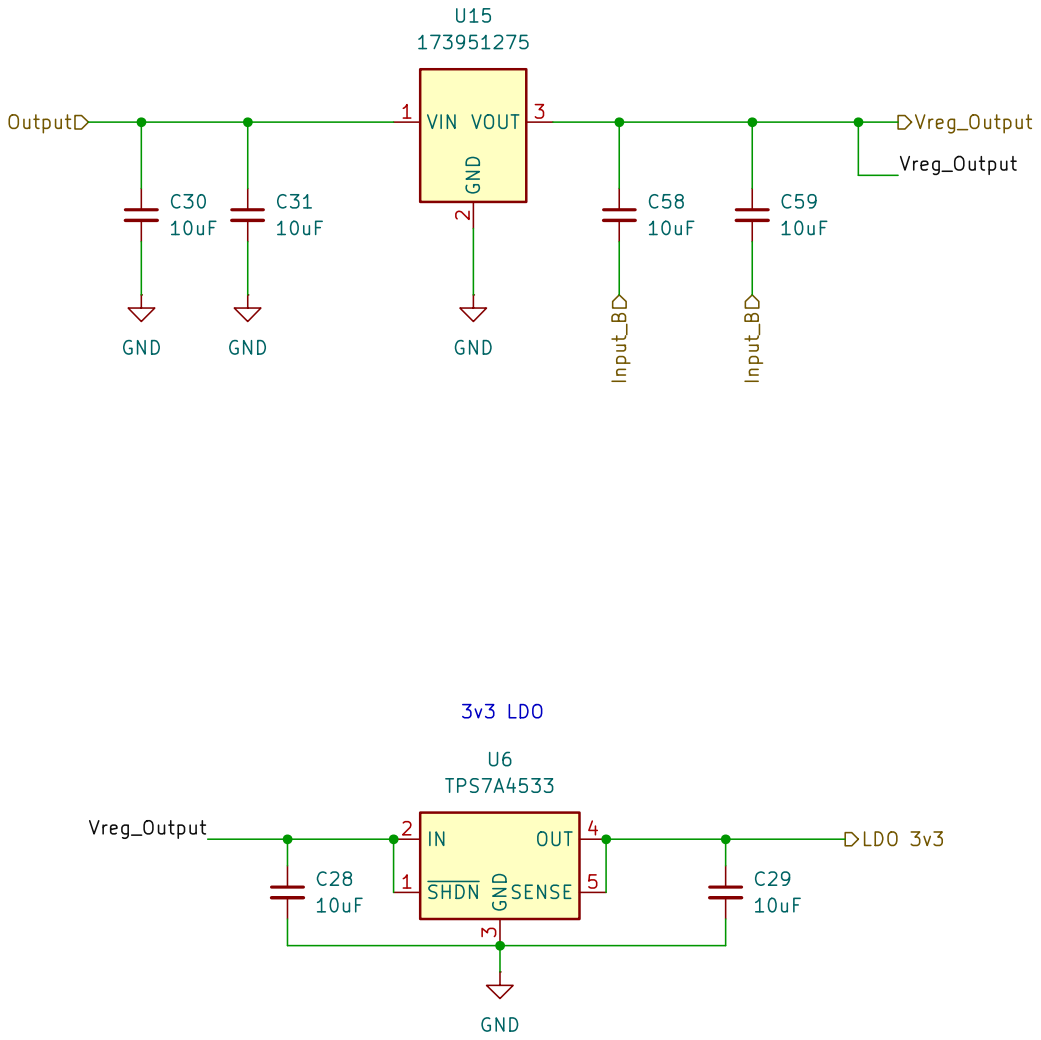
[picture p507: page 7]

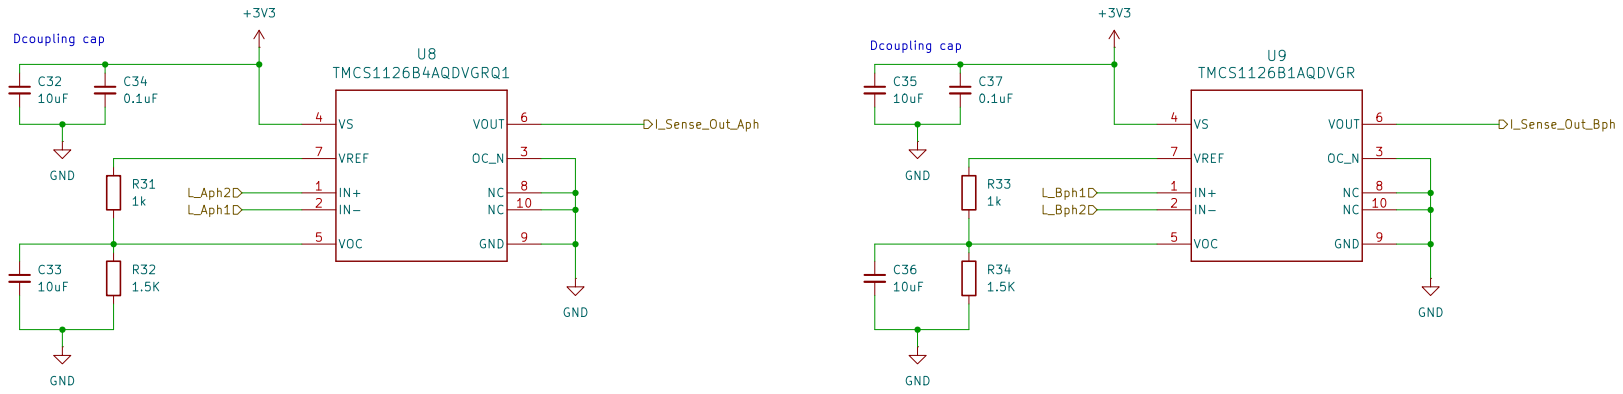
[picture p508: page 8]

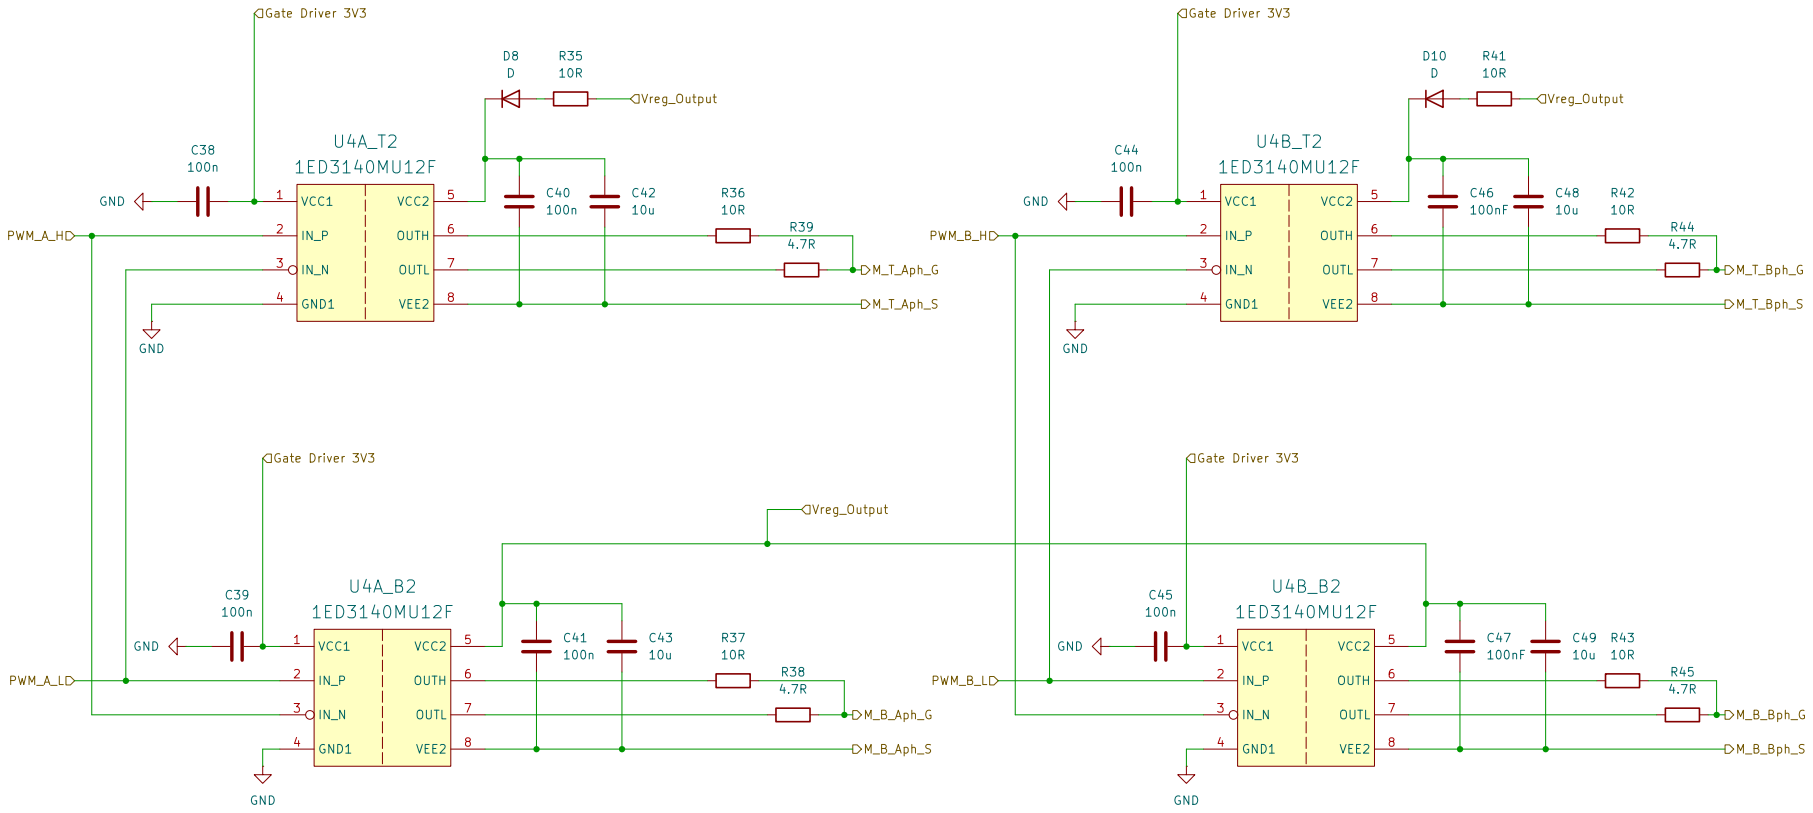
[picture p509: page 9]

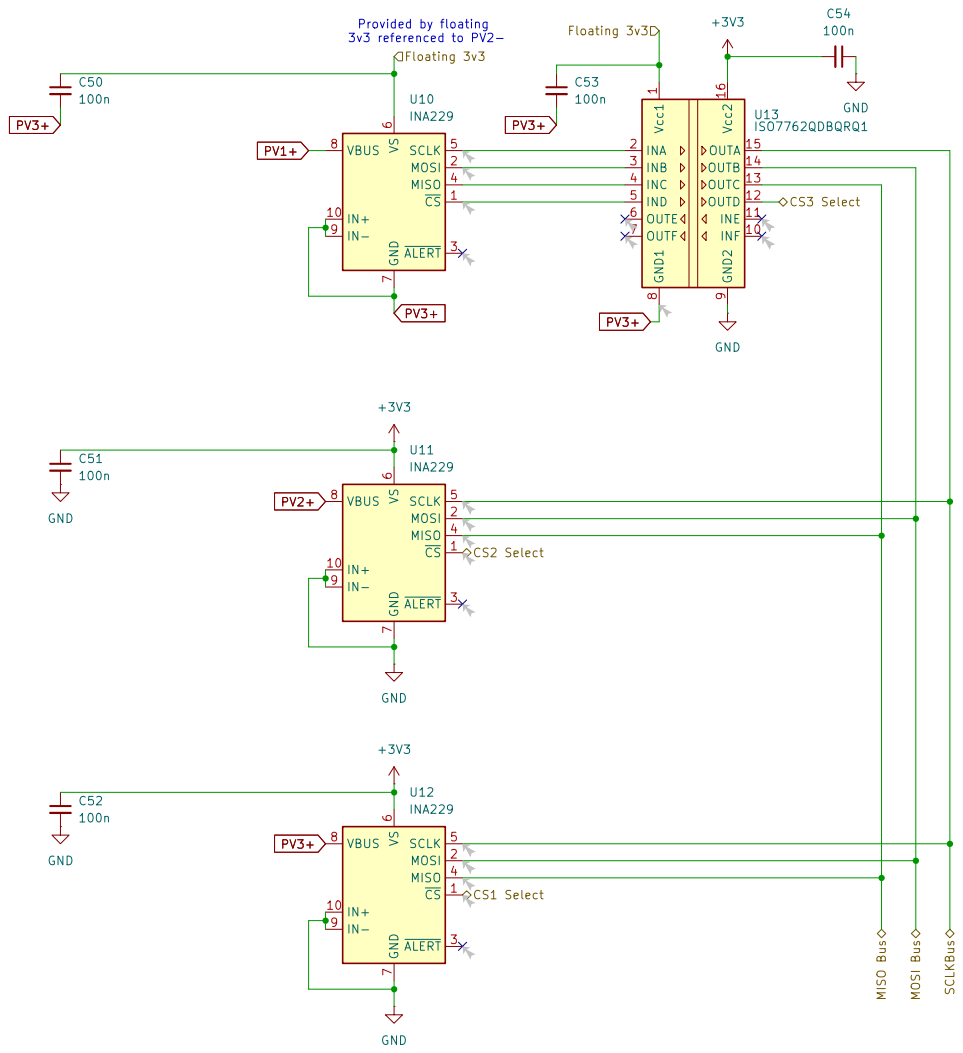
[picture p510: page 10]
