saunders-jared-final/Boost-Brigade/0_Documentation/jared-assessment/CapstoneDelivery_latex/figures/results/thermal.pdf

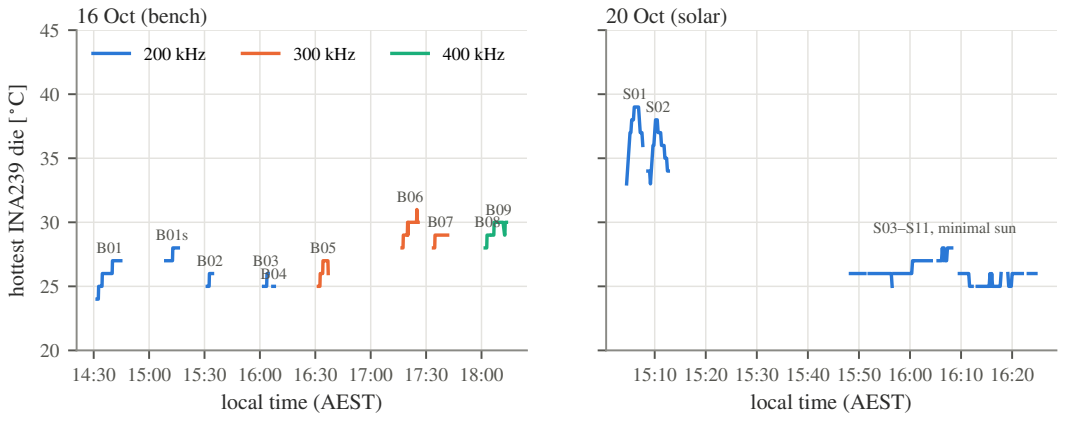
[picture p511: page 1]
hottest IN; A239 die [; 16 Oct (bench); 200 kHz; 300 kHz; 400 kHz; S03–S11, minimal sun; 20 Oct (solar)

local time (AEST)
