saunders-jared-final/Boost-Brigade/5_Kicad/Version 0 project/Version 0 project.kicad_pcb

## KiCad design 5_Kicad/Version 0 project/Version 0 project.kicad_pcb (2026-10-20)

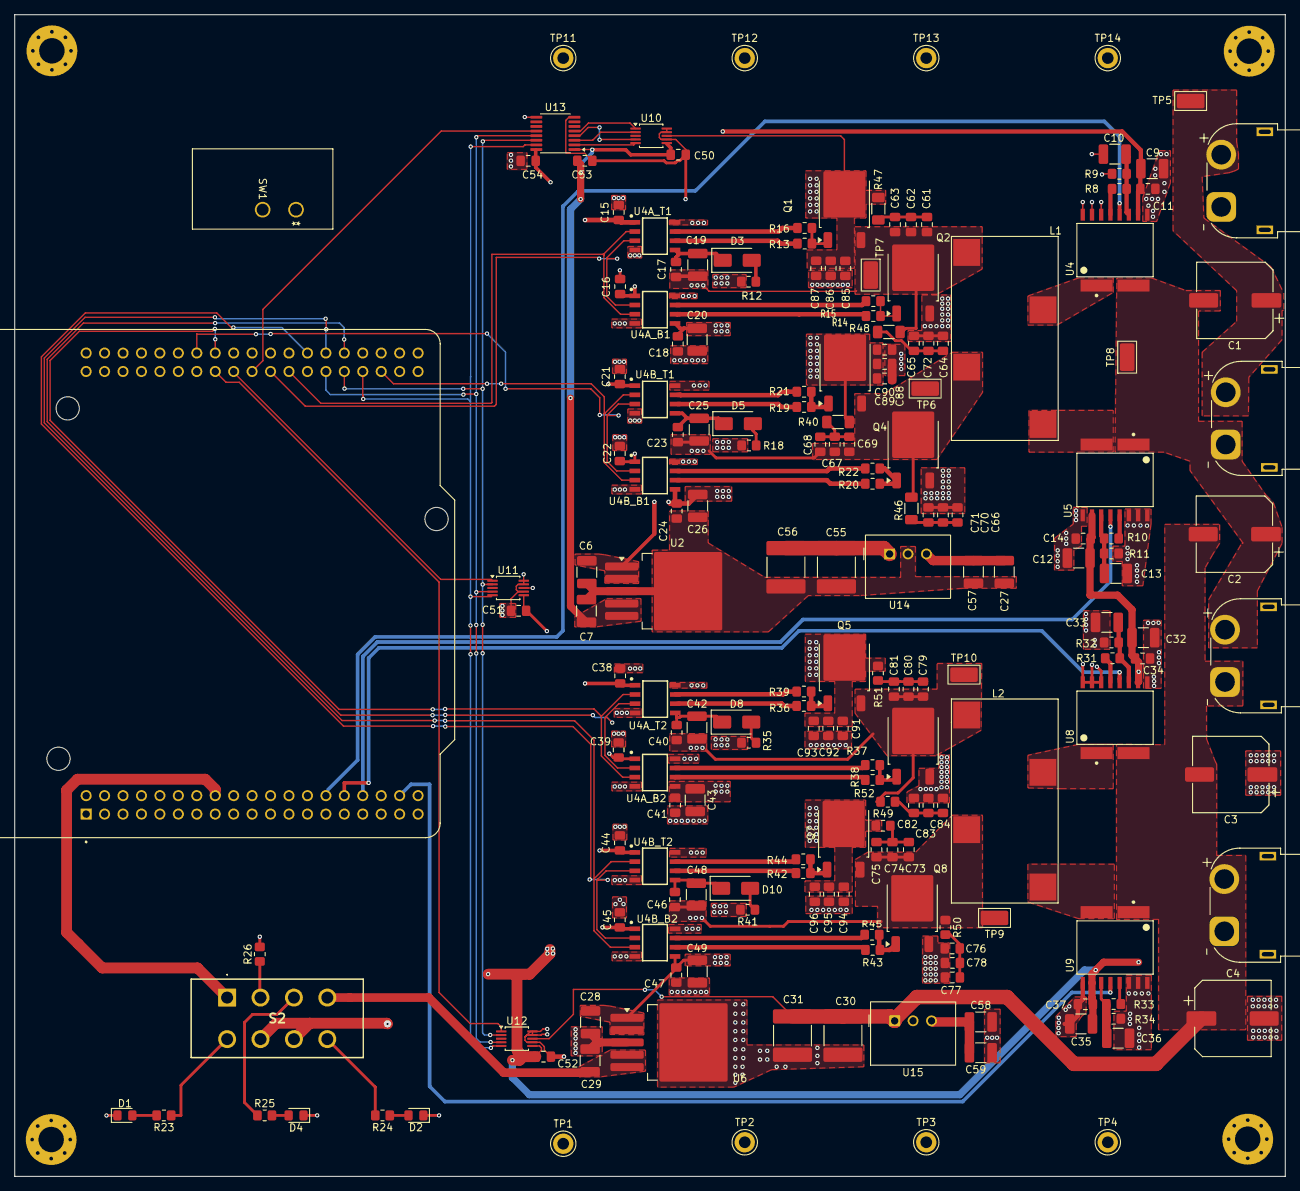
[picture p512: board Version 0 project.kicad_pcb from above]

Board: 6 copper layers, 175.0 x 160.0 mm, 195 parts (0 on the bottom side), 96 nets.

Parts:
C1, C2: B40910A0137M000; CP_Elec_10x16.5
C3, C4: 130u; CP_Elec_10x16.5
C6, C7, C9, C10, C12, C13, C27, C28, C29, C32, C33, C35, C36, C57, C58, C59: 10uF; C_1210_3225Metric_Pad1.33x2.70mm_HandSolder
C11, C14, C34, C37, C61, C62, C63, C64, C65, C66, C67, C68, C69, C70, C71, C72, C73, C74, C75, C76, C77, C78, C79, C80, C81, C82, C83, C84, C85, C86, C87, C88, C89, C90, C91, C92, C93, C94, C95, C96: 0.1uF; C_0805_2012Metric_Pad1.18x1.45mm_HandSolder
C15, C16, C17, C18, C21, C22, C38, C39, C40, C41, C44, C45, C50, C51, C52, C53, C54: 100n; C_0805_2012Metric_Pad1.18x1.45mm_HandSolder
C19, C20, C25, C26, C42, C43, C48, C49: 10u; C_1210_3225Metric_Pad1.33x2.70mm_HandSolder
C23, C24, C46, C47: 100nF; C_0805_2012Metric_Pad1.18x1.45mm_HandSolder
C30, C31, C55, C56: 10uF; C_2220_5750Metric_Pad1.97x5.40mm_HandSolder
D1: LED_R; LED_0805_2012Metric_Pad1.15x1.40mm_HandSolder
D2: LED_B; LED_0805_2012Metric_Pad1.15x1.40mm_HandSolder
D3, D5, D8, D10: D; D_SMA
D4: LED_G; LED_0805_2012Metric_Pad1.15x1.40mm_HandSolder
H1, H2, H3, H4: MountingHole; MountingHole_3.5mm_Pad_Via
L1, L2: ERUC23-4R1K
Q1, Q2, Q3, Q4, Q5, Q6, Q7, Q8: STD45N10F7; TO-252-3_TabPin2
R8, R10, R26, R31, R33: 1k; R_0805_2012Metric_Pad1.20x1.40mm_HandSolder
R9, R11, R32, R34: 1.5K; R_0805_2012Metric_Pad1.20x1.40mm_HandSolder
R12, R13, R14, R18, R19, R20, R35, R36, R37, R41, R42, R43: 10R; R_0805_2012Metric_Pad1.20x1.40mm_HandSolder
R15, R16, R21, R22, R38, R39, R44, R45, R49, R50, R51, R52: 4.7R; R_0805_2012Metric_Pad1.20x1.40mm_HandSolder
R23, R25: 680; R_0805_2012Metric_Pad1.20x1.40mm_HandSolder
R24: 100; R_0805_2012Metric_Pad1.20x1.40mm_HandSolder
R40, R46, R47, R48: 4.7R; R_1206_3216Metric_Pad1.30x1.75mm_HandSolder
S2: L203011MS02Q
SW1: L101011MS02Q; SW_1MS02Q_CNK
TP1, TP2, TP3, TP4, TP11, TP12, TP13, TP14: TestPoint; TestPoint_Keystone_5010-5014_Multipurpose
TP5, TP6, TP7, TP8, TP9, TP10: TestPoint; TestPoint_Keystone_5019_Miniature_Wide
U1: NUCLEO-G474RE; MODULE_NUCLEO-G474RE
U2, U6: TPS7A4533; TO-263-5_TabPin3
U4, U8: TMCS1126B4AQDVGRQ1; DVG0010A-MFG
U4A_B1, U4A_B2, U4A_T1, U4A_T2, U4B_B1, U4B_B2, U4B_T1, U4B_T2: 1ED3140MU12F; SOIC127P600X175-8N-22-V1
U5, U9: TMCS1126B1AQDVGR; DVG0010A-MFG
U10, U11, U12: INA229; TSSOP-10_3x3mm_P0.5mm
U13: ISO7762QDBQRQ1; SSOP-16_3.9x4.9mm_P0.635mm
U14, U15: 173951275; U_Wurth_WPME-FDSM_17395xx75
XT60_1: PV Connector 1; AMASS_XT60PW-F_1x02_P7.20mm_Horizontal
XT60_2: PV Connector 2; AMASS_XT60PW-F_1x02_P7.20mm_Horizontal
XT60_3: PV Connector 3; AMASS_XT60PW-F_1x02_P7.20mm_Horizontal
XT60_4: PV Connector 4; AMASS_XT60PW-F_1x02_P7.20mm_Horizontal

Connections:
+3V3: C9.1, C11.1, C12.1, C14.1, C32.1, C34.1, C35.1, C37.1, C51.1, C52.1, C54.2, S2.6, S2.7, SW1.1, U4.4 (VS), U5.4 (VS), U8.4 (VS), U9.4 (VS), U11.6 (VS), U12.6 (VS), U13.16 (Vcc2)
/CS1: U1.CN10_15 (PA7), U12.1 (~CS)
/CS2: U1.CN10_17 (PB6), U11.1 (~CS)
/CS3: U1.CN10_19 (PC7), U13.12 (OUTD)
/Floating 3v3: C7.1, C50.1, C53.1, U2.4 (OUT), U2.5 (SENSE), U10.6 (VS), U13.1 (Vcc1)
/Gate Driver 3v3: C15.2, C16.2, C21.2, C22.2, C38.2, C39.2, C44.2, C45.2, SW1.2, U4A_B1.1 (VCC1), U4A_B2.1 (VCC1), U4A_T1.1 (VCC1), U4A_T2.1 (VCC1), U4B_B1.1 (VCC1), U4B_B2.1 (VCC1), U4B_T1.1 (VCC1), U4B_T2.1 (VCC1)
/ILA_1: U1.CN7_28 (PA0), U4.6 (VOUT)
/ILA_2: U1.CN7_30 (PA1), U8.6 (VOUT)
/ILB_1: U1.CN7_32 (PA4), U5.6 (VOUT)
/ILB_2: U1.CN7_36 (PC1/PB9), U9.6 (VOUT)
/LDO 3v3: C29.1, S2.4, U6.4 (OUT), U6.5 (SENSE)
/S1_A_H: U1.CN10_23 (PA8), U4A_B1.3 (IN_N), U4A_T1.2 (IN_P)
/S1_A_L: U1.CN10_21 (PA9), U4A_B1.2 (IN_P), U4A_T1.3 (IN_N)
/S1_B_H: U1.CN10_33 (PA10), U4B_B1.3 (IN_N), U4B_T1.2 (IN_P)
/S1_B_L: U1.CN10_14 (PA11), U4B_B1.2 (IN_P), U4B_T1.3 (IN_N)
/S2_A_H: U1.CN10_16 (PB12), U4A_B2.3 (IN_N), U4A_T2.2 (IN_P)
/S2_A_L: U1.CN10_30 (PB13), U4A_B2.2 (IN_P), U4A_T2.3 (IN_N)
/S2_B_H: U1.CN10_28 (PB14), U4B_B2.3 (IN_N), U4B_T2.2 (IN_P)
/S2_B_L: U1.CN10_26 (PB15), U4B_B2.2 (IN_P), U4B_T2.3 (IN_N)
/SPI MISO: U1.CN10_27 (PB4), U11.4 (MISO), U12.4 (MISO), U13.13 (OUTC)
/SPI MOSI: U1.CN10_29 (PB5), U11.2 (MOSI), U12.2 (MOSI), U13.14 (OUTB)
/SPI SCLK: U1.CN10_31 (PB3), U11.5 (SCLK), U12.5 (SCLK), U13.15 (OUTA)
/Shuffle Converter 1/L_Aph2: L1.1, U4.1 (IN+)
/Shuffle Converter 1/L_Bph2: L1.2, U5.2 (IN-)
/Shuffle Converter 1/M_B_Aph_G: Q2.1 (G), R14.2, R15.2
/Shuffle Converter 1/M_B_Bph_G: Q4.1 (G), R20.2, R22.2
/Shuffle Converter 1/M_T_Aph_G: Q1.1 (G), R13.2, R16.2
/Shuffle Converter 1/M_T_Aph_S: C17.2, C19.2, C61.2, C62.2, C63.2, L1.4, Q1.3 (S), Q2.2 (D), R48.1, TP7.1 (1_1), U4A_T1.8 (VEE2)
/Shuffle Converter 1/M_T_Bph_G: Q3.1 (G), R19.2, R21.2
/Shuffle Converter 1/M_T_Bph_S: C23.2, C25.2, C67.2, C68.2, C69.2, L1.3, Q3.3 (S), Q4.2 (D), R46.1, TP6.1 (1_1), U4B_T1.8 (VEE2)
/Shuffle Converter 1/Vreg_Output: C6.1, C18.1, C20.1, C24.1, C26.1, C27.1, C57.1, R12.2, R18.2, U2.1 (~SHDN), U2.2 (IN), U4A_B1.5 (VCC2), U4B_B1.5 (VCC2), U14.3 (VOUT)
/Shuffle Converter 2/L_Aph2: L2.1, U8.1 (IN+)
/Shuffle Converter 2/L_Bph2: L2.2, U9.2 (IN-)
/Shuffle Converter 2/M_B_Aph_G: Q6.1 (G), R37.2, R38.2
/Shuffle Converter 2/M_B_Bph_G: Q8.1 (G), R43.2, R45.2
/Shuffle Converter 2/M_T_Aph_G: Q5.1 (G), R36.2, R39.2
/Shuffle Converter 2/M_T_Aph_S: C40.2, C42.2, C79.2, C80.2, C81.2, L2.4, Q5.3 (S), Q6.2 (D), R52.1, TP10.1 (1_1), U4A_T2.8 (VEE2)
/Shuffle Converter 2/M_T_Bph_G: Q7.1 (G), R42.2, R44.2
/Shuffle Converter 2/M_T_Bph_S: C46.2, C48.2, C73.2, C74.2, C75.2, L2.3, Q7.3 (S), Q8.2 (D), R50.1, TP9.1 (1_1), U4B_T2.8 (VEE2)
/Shuffle Converter 2/Vreg_Output: C28.1, C41.1, C43.1, C47.1, C49.1, C58.1, C59.1, R35.2, R41.2, U4A_B2.5 (VCC2), U4B_B2.5 (VCC2), U6.1 (~SHDN), U6.2 (IN), U15.3 (VOUT)
GND: C4.2, C9.2, C10.2, C11.2, C12.2, C13.2, C14.2, C15.1, C16.1, C21.1, C22.1, C28.2, C29.2, C30.2, C31.2, C32.2, C33.2, C34.2, C35.2, C36.2, C37.2, C38.1, C39.1, C41.2, C43.2, C44.1, C45.1, C47.2, C49.2, C51.2, C52.2, C54.1, C58.2, C59.2, C76.2, C77.2, C78.2, C82.2, C83.2, C84.2, C91.2, C92.2, C93.2, C94.2, C95.2, C96.2, D1.1 (K), D2.1 (K), D4.1 (K), Q6.3 (S), Q8.3 (S), R9.2, R11.2, R26.2, R32.2, R34.2, TP1.1 (1_1), TP2.1 (1_1), TP3.1 (1_1), TP4.1 (1_1), TP11.1 (1_1), TP12.1 (1_1), TP13.1 (1_1), TP14.1 (1_1), U4.3 (OC_N), U4.8 (NC), U4.9 (GND), U4.10 (NC), U4A_B1.4 (GND1), U4A_B2.4 (GND1), U4A_B2.8 (VEE2), U4A_T1.4 (GND1), U4A_T2.4 (GND1), U4B_B1.4 (GND1), U4B_B2.4 (GND1), U4B_B2.8 (VEE2), U4B_T1.4 (GND1), U4B_T2.4 (GND1), U5.3 (OC_N), U5.8 (NC), U5.9 (GND), U5.10 (NC), U6.3 (GND), U8.3 (OC_N), U8.8 (NC), U8.9 (GND), U8.10 (NC), U9.3 (OC_N), U9.8 (NC), U9.9 (GND), U9.10 (NC), U11.7 (GND), U11.9 (IN-), U11.10 (IN+), U12.7 (GND), U12.9 (IN-), U12.10 (IN+), U13.9 (GND2), U15.2 (GND), XT60_3.1 (Pin_2), XT60_4.1 (Pin_2)
unnamed: C61.1, C62.1, C63.1, R47.2
unnamed: C64.1, C65.1, C72.1, R48.2
unnamed: C66.1, C70.1, C71.1, R46.2
unnamed: C67.1, C68.1, C69.1, R40.2
unnamed: C73.1, C74.1, C75.1, R49.2
unnamed: C76.1, C77.1, C78.1, R50.2
unnamed: C79.1, C80.1, C81.1, R51.2
unnamed: C82.1, C83.1, C84.1, R52.2
unnamed: D1.2 (A), R23.2
unnamed: D2.2 (A), R24.1
unnamed: D3.2 (A), R12.1
unnamed: C17.1, C19.1, D3.1 (K), U4A_T1.5 (VCC2)
unnamed: D4.2 (A), R25.2
unnamed: D5.2 (A), R18.1
unnamed: C23.1, C25.1, D5.1 (K), U4B_T1.5 (VCC2)
unnamed: D8.2 (A), R35.1
unnamed: C40.1, C42.1, D8.1 (K), U4A_T2.5 (VCC2)
unnamed: D10.2 (A), R41.1
unnamed: C46.1, C48.1, D10.1 (K), U4B_T2.5 (VCC2)
unnamed: R23.1, S2.5
unnamed: R24.2, S2.8
unnamed: R25.1, S2.3
unnamed: R26.1, S2.2
unnamed: S2.1, U1.CN7_16 (+3V3)
unnamed: C10.1, R8.2, R9.1, U4.5 (VOC)
unnamed: R8.1, U4.7 (VREF)
unnamed: R14.1, U4A_B1.6 (OUTH)
unnamed: R15.1, U4A_B1.7 (OUTL)
unnamed: R37.1, U4A_B2.6 (OUTH)
unnamed: R38.1, U4A_B2.7 (OUTL)
unnamed: R13.1, U4A_T1.6 (OUTH)
unnamed: R16.1, U4A_T1.7 (OUTL)
unnamed: R36.1, U4A_T2.6 (OUTH)
unnamed: R39.1, U4A_T2.7 (OUTL)
unnamed: R20.1, U4B_B1.6 (OUTH)
unnamed: R22.1, U4B_B1.7 (OUTL)
unnamed: R43.1, U4B_B2.6 (OUTH)
unnamed: R45.1, U4B_B2.7 (OUTL)
unnamed: R19.1, U4B_T1.6 (OUTH)
unnamed: R21.1, U4B_T1.7 (OUTL)
unnamed: R42.1, U4B_T2.6 (OUTH)
unnamed: R44.1, U4B_T2.7 (OUTL)
unnamed: C13.1, R10.2, R11.1, U5.5 (VOC)
unnamed: R10.1, U5.7 (VREF)
unnamed: C33.1, R31.2, R32.1, U8.5 (VOC)
unnamed: R31.1, U8.7 (VREF)
unnamed: C36.1, R33.2, R34.1, U9.5 (VOC)
unnamed: R33.1, U9.7 (VREF)
unnamed: U10.4 (MISO), U13.4 (INC)
unnamed: U10.2 (MOSI), U13.3 (INB)
unnamed: U10.5 (SCLK), U13.2 (INA)
unnamed: U10.1 (~CS), U13.5 (IND)
PV1+: C1.1, C85.1, C86.1, C87.1, C88.1, C89.1, C90.1, Q1.2 (D), Q3.2 (D), R40.1, R47.1, TP5.1 (1_1), U10.8 (VBUS), XT60_1.2 (Pin_1), XT60_4.2 (Pin_1)
PV2+: C1.2, C2.1, C3.1, C55.1, C56.1, C91.1, C92.1, C93.1, C94.1, C95.1, C96.1, Q5.2 (D), Q7.2 (D), R49.1, R51.1, TP8.1 (1_1), U4.2 (IN-), U5.1 (IN+), U11.8 (VBUS), U14.1 (VIN), XT60_1.1 (Pin_2), XT60_2.2 (Pin_1)
PV3+: C2.2, C3.2, C4.1, C6.2, C7.2, C18.2, C20.2, C24.2, C26.2, C27.2, C30.1, C31.1, C50.2, C53.2, C55.2, C56.2, C57.2, C64.2, C65.2, C66.2, C70.2, C71.2, C72.2, C85.2, C86.2, C87.2, C88.2, C89.2, C90.2, Q2.3 (S), Q4.3 (S), U2.3 (GND), U4A_B1.8 (VEE2), U4B_B1.8 (VEE2), U8.2 (IN-), U9.1 (IN+), U10.7 (GND), U10.9 (IN-), U10.10 (IN+), U12.8 (VBUS), U13.8 (GND1), U14.2 (GND), U15.1 (VIN), XT60_2.1 (Pin_2), XT60_3.2 (Pin_1)
