saunders-jared-final/Boost-Brigade/Version 0/Version 0 project/FLyback_LDO_Top.kicad_sch

## KiCad design Version 0/Version 0 project/FLyback_LDO_Top.kicad_sch (2026-10-11)

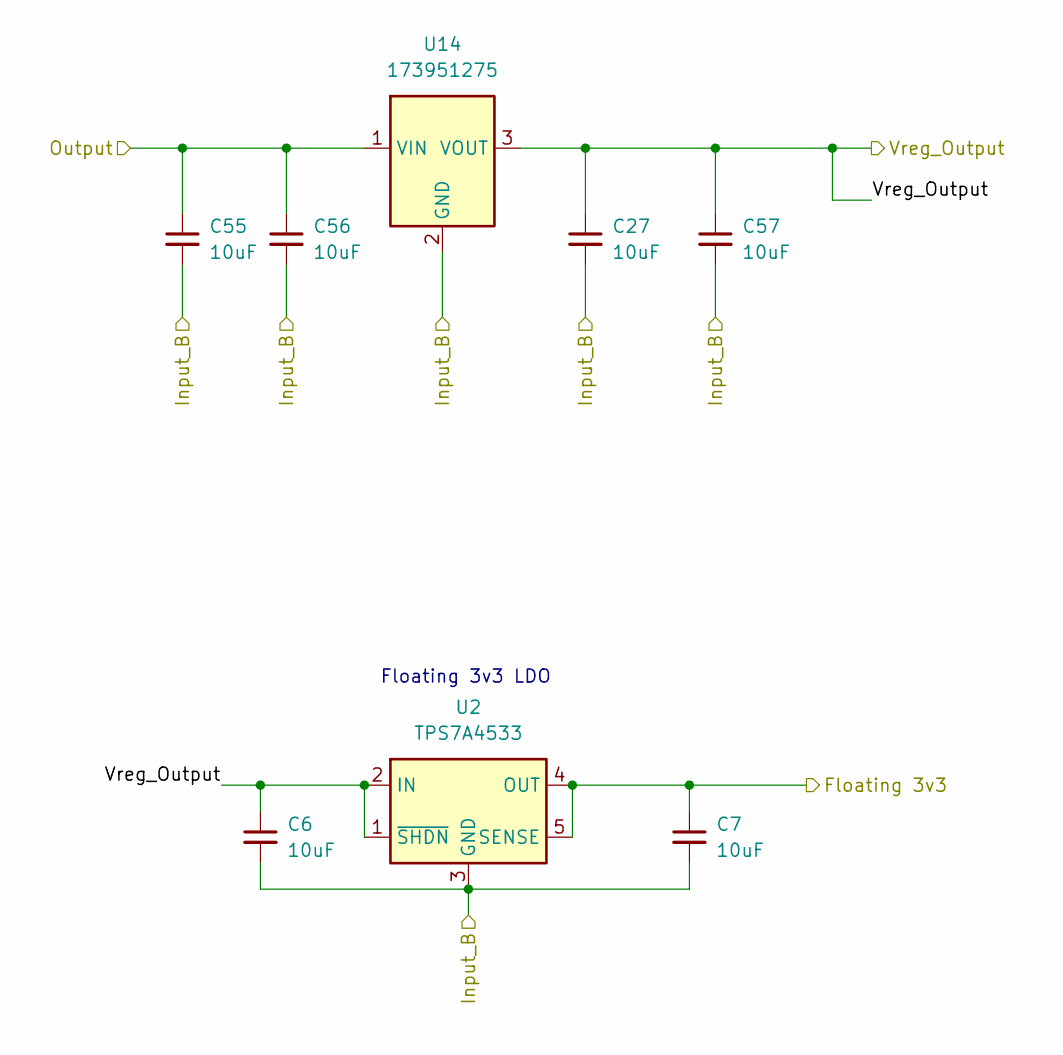
[picture p513: schematic FLyback_LDO_Top.kicad_sch]

Parts:
C6, C7, C27, C57: 10uF; C_1210_3225Metric_Pad1.33x2.70mm_HandSolder
C55, C56: 10uF; C_2220_5750Metric_Pad1.97x5.40mm_HandSolder
U2: TPS7A4533; TO-263-5_TabPin3
U14: 173951275; U_Wurth_WPME-FDSM_17395xx75

Connections:
Floating 3v3: C7.1, U2.4 (OUT), U2.5 (SENSE)
Input_B: C6.2, C7.2, C27.2, C55.2, C56.2, C57.2, U2.3 (GND), U14.2 (GND)
Output: C55.1, C56.1, U14.1 (VIN)
Vreg_Output: C6.1, C27.1, C57.1, U2.1 (~SHDN), U2.2 (IN), U14.3 (VOUT)

Notes on the sheet:
Floating 3v3 LDO
