saunders-jared-final/Boost-Brigade/Version 0/Version 0 project/GateDriver_DedicatedOutput.kicad_sch

## KiCad design Version 0/Version 0 project/GateDriver_DedicatedOutput.kicad_sch (2026-10-11)

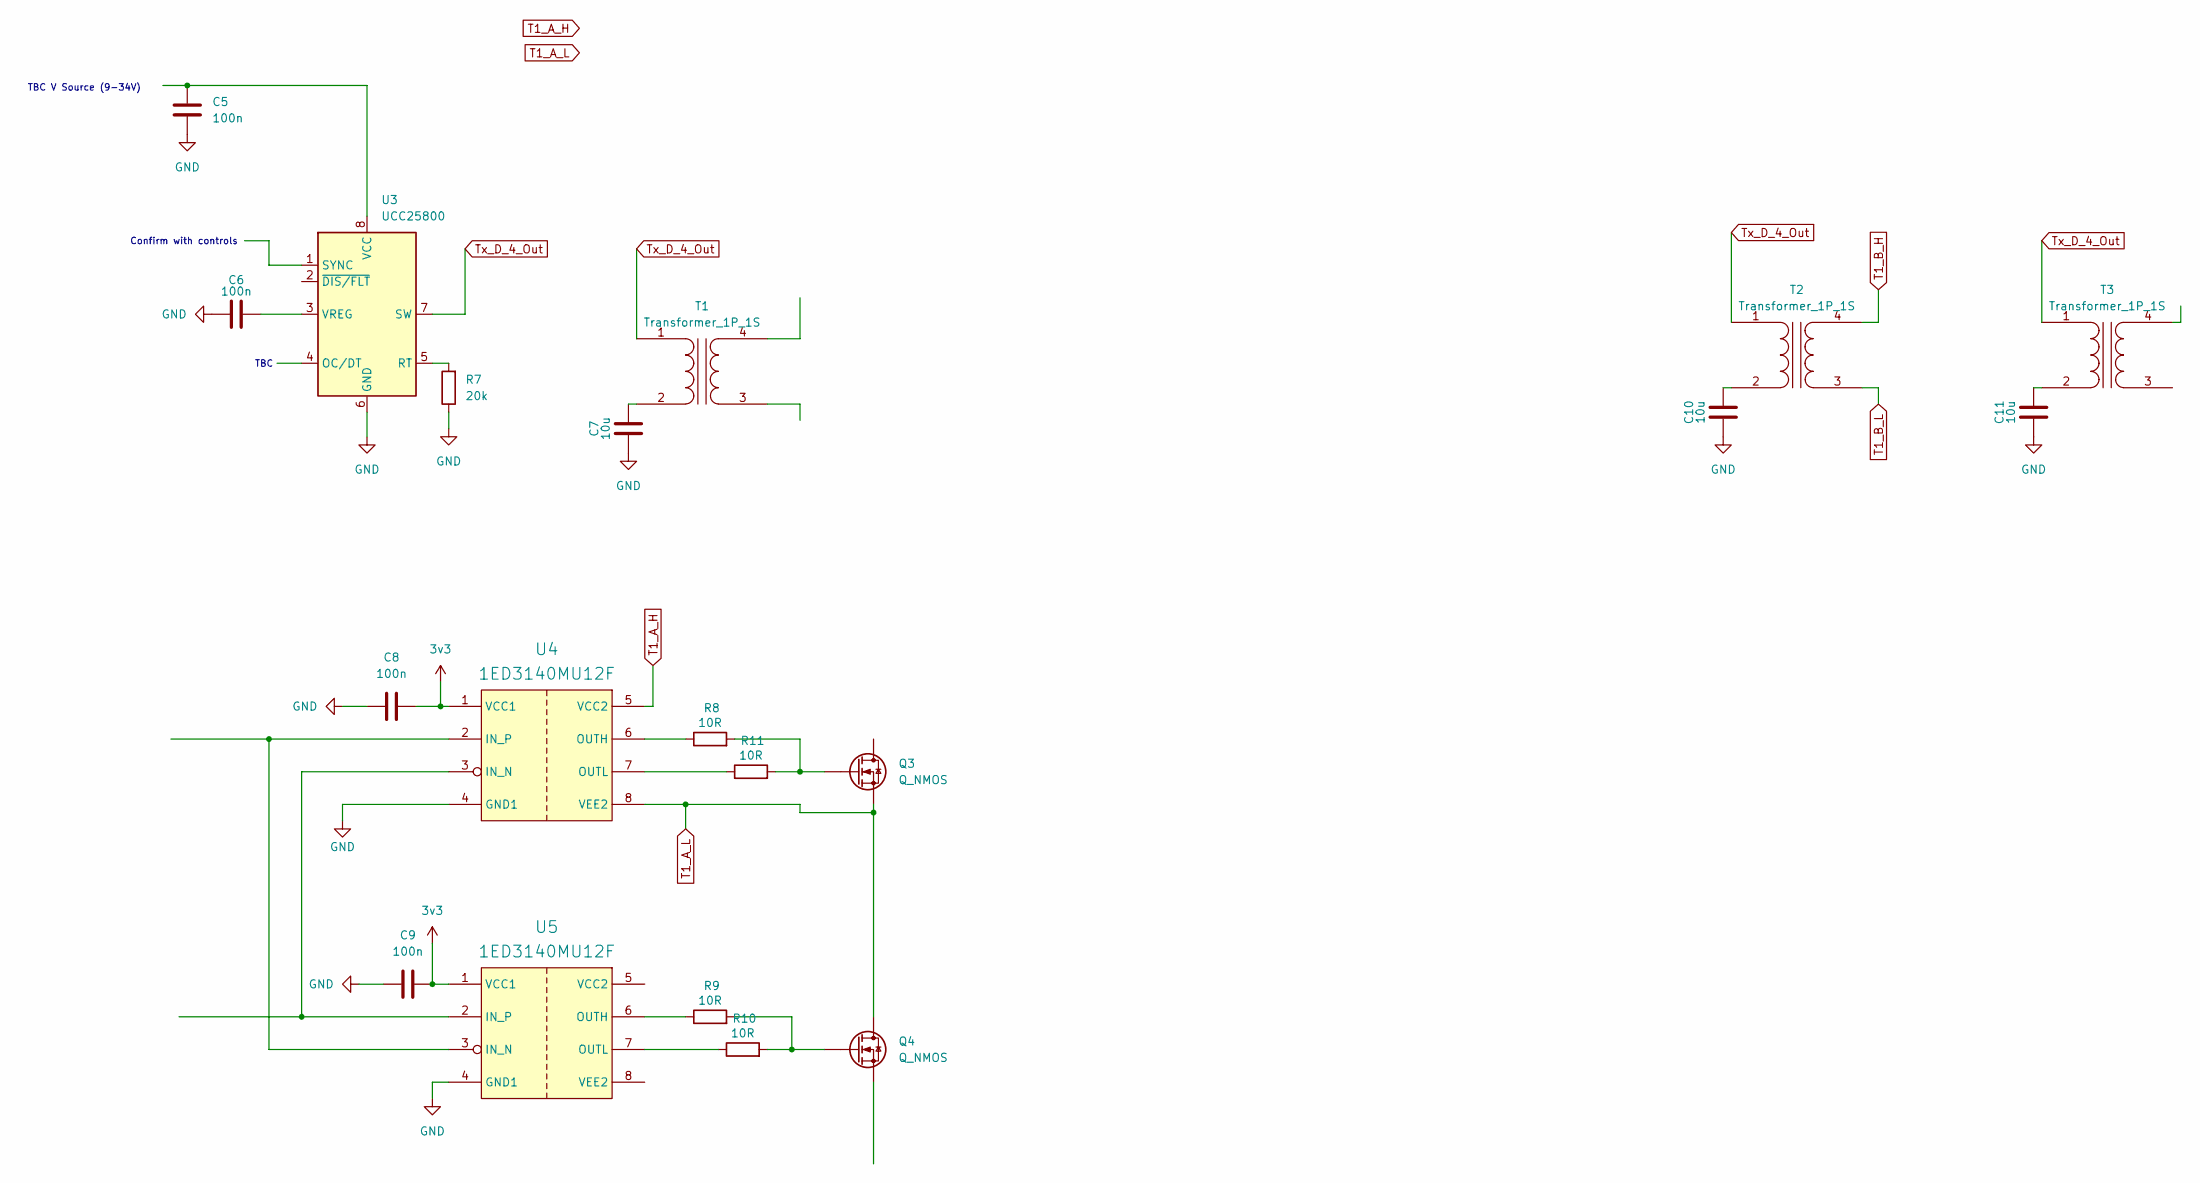
[picture p514: schematic GateDriver_DedicatedOutput.kicad_sch]

Parts:
C5, C6, C8, C9: 100n
C7, C10, C11: 10u
Q3, Q4: Q_NMOS
R7: 20k
R8, R9, R10, R11: 10R
T1, T2, T3: Transformer_1P_1S
U3: UCC25800; HVSSOP-8-1EP_3x3mm_P0.65mm_EP1.57x1.89mm
U4, U5: 1ED3140MU12F; SOIC127P600X175-8N-22-V1

Connections:
3v3: C8.2, C9.2, U4.1 (VCC1), U5.1 (VCC1)
GND: C5.2, C6.1, C7.1, C8.1, C9.1, C10.1, C11.1, R7.1, U3.6 (GND), U3.9 (GND), U4.4 (GND1), U5.4 (GND1)
unnamed: C5.1, U3.8 (VCC)
unnamed: C6.2, U3.3 (VREG)
unnamed: C7.2, T1.2 (AB)
unnamed: C10.2, T2.2 (AB)
unnamed: C11.2, T3.2 (AB)
unnamed: Q3.G, R8.2, R11.2
unnamed: Q4.G, R9.2, R10.2
unnamed: R7.2, U3.5 (RT)
unnamed: R8.1, U4.6 (OUTH)
unnamed: R9.1, U5.6 (OUTH)
unnamed: R10.1, U5.7 (OUTL)
unnamed: R11.1, U4.7 (OUTL)
unnamed: U4.2 (IN_P), U5.3 (IN_N)
unnamed: U4.3 (IN_N), U5.2 (IN_P)
T1_A_H: U4.5 (VCC2)
T1_A_L: Q3.S, Q4.D, U4.8 (VEE2)
T1_B_H: T2.4 (SB)
T1_B_L: T2.3 (SA)
Tx_D_4_Out: T1.1 (AA), T2.1 (AA), T3.1 (AA), U3.7 (SW)

Notes on the sheet:
Confirm with controls
TBC V Source (9-34V)
TBC
