saunders-jared-final/Boost-Brigade/6_RTOS/Core/Inc/main.h

#define RCC_OSC32_IN_Pin GPIO_PIN_14
#define RCC_OSC32_IN_GPIO_Port GPIOC
#define RCC_OSC32_OUT_Pin GPIO_PIN_15
#define RCC_OSC32_OUT_GPIO_Port GPIOC
#define RCC_OSC_IN_Pin GPIO_PIN_0
#define RCC_OSC_IN_GPIO_Port GPIOF
#define RCC_OSC_OUT_Pin GPIO_PIN_1
#define RCC_OSC_OUT_GPIO_Port GPIOF
#define ILB_2_Pin GPIO_PIN_1
#define ILB_2_GPIO_Port GPIOC
#define ILA_1_Pin GPIO_PIN_0
#define ILA_1_GPIO_Port GPIOA
#define ILA_2_Pin GPIO_PIN_1
#define ILA_2_GPIO_Port GPIOA
#define ILB_1_Pin GPIO_PIN_4
#define ILB_1_GPIO_Port GPIOA
#define INA_CS1_Pin GPIO_PIN_7
#define INA_CS1_GPIO_Port GPIOA
#define S2_A_H_Pin GPIO_PIN_12
#define S2_A_H_GPIO_Port GPIOB
#define S2_A_L_Pin GPIO_PIN_13
#define S2_A_L_GPIO_Port GPIOB
#define S2_B_H_Pin GPIO_PIN_14
#define S2_B_H_GPIO_Port GPIOB
#define S2_B_L_Pin GPIO_PIN_15
#define S2_B_L_GPIO_Port GPIOB
#define INA_CS3_Pin GPIO_PIN_7
#define INA_CS3_GPIO_Port GPIOC
#define S1_A_H_Pin GPIO_PIN_8
#define S1_A_H_GPIO_Port GPIOA
#define S1_A_L_Pin GPIO_PIN_9
#define S1_A_L_GPIO_Port GPIOA
#define S1_B_H_Pin GPIO_PIN_10
#define S1_B_H_GPIO_Port GPIOA
#define S1_B_L_Pin GPIO_PIN_11
#define S1_B_L_GPIO_Port GPIOA
#define T_SWDIO_Pin GPIO_PIN_13
#define T_SWDIO_GPIO_Port GPIOA
#define T_SWCLK_Pin GPIO_PIN_14
#define T_SWCLK_GPIO_Port GPIOA
#define INA_CS2_Pin GPIO_PIN_6
#define INA_CS2_GPIO_Port GPIOB
#define HRTIM_ALL_OUTPUTS   (HRTIM_OUTPUT_TA1 | HRTIM_OUTPUT_TA2 | HRTIM_OUTPUT_TB1 | HRTIM_OUTPUT_TB2 | \
