saunders-jared-final/Boost-Brigade/6_RTOS/Core/Src/main.c

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
/* Includes ------------------------------------------------------------------*/
#include "main.h"
#include "adc.h"
#include "hrtim.h"
#include "spi.h"
#include "gpio.h"

/* USER CODE BEGIN Includes */
#include "app.h"
#include "shuffler_hw.h"
#include "comms.h"
#include "ina2x9.h"
#include "sensors.h"
#include "shuffler_hw.h"
/* USER CODE END Includes */


COM_InitTypeDef BspCOMInit;

/* USER CODE BEGIN PV */
COM_InitTypeDef BspCOMInit;
/* USER CODE END PV */

void SystemClock_Config(void);
/* USER CODE BEGIN 0 */
/* Gate lines are driven low before main() by shuffler_hw.c (constructor). */
/* USER CODE END 0 */

/**
  * @brief  The application entry point.
  * @retval int
  */
int main(void)
{

  /* USER CODE BEGIN 1 */
  hw_outputs_off();   /* gates low as GPIO until the HRTIM owns them */
/* USER CODE END 1 */

  /* MCU Configuration--------------------------------------------------------*/

  /* Reset of all peripherals, Initializes the Flash interface and the Systick. */
  HAL_Init();

  /* Configure the system clock */
  SystemClock_Config();

  /* Initialize all configured peripherals */
  MX_GPIO_Init();
  MX_HRTIM1_Init();
  MX_ADC1_Init();
  MX_ADC2_Init();
  MX_SPI3_Init();
  /* Initialize led */
  BSP_LED_Init(LED_GREEN);

  /* Initialize USER push-button, will be used to trigger an interrupt each time it's pressed.*/
  BSP_PB_Init(BUTTON_USER, BUTTON_MODE_EXTI);

  /* Initialize COM1 port (115200, 8 bits (7-bit data + 1 stop bit), no parity */
  BspCOMInit.BaudRate   = 115200;
  BspCOMInit.WordLength = COM_WORDLENGTH_8B;
  BspCOMInit.StopBits   = COM_STOPBITS_1;
  BspCOMInit.Parity     = COM_PARITY_NONE;
  BspCOMInit.HwFlowCtl  = COM_HWCONTROL_NONE;
  if (BSP_COM_Init(COM1, &BspCOMInit) != BSP_ERROR_NONE)
  {
    Error_Handler();
  }

  /* Infinite loop */
  /* USER CODE BEGIN WHILE */
  /* The generated BSP code above opened COM1 at 115200: reopen at the telemetry rate. */
  (void)HAL_UART_DeInit(&hcom_uart[COM1]);
  BspCOMInit.BaudRate = COMMS_BAUD;
  if (BSP_COM_Init(COM1, &BspCOMInit) != BSP_ERROR_NONE)
  {
    Error_Handler();
  }
  Sensors_Init();      /* hall ADC + DMA armed on the HRTIM triggers */
  INA_Init();
  INA_Poll();
  hw_init();           /* HRTIM: master tick + four legs + ADC triggers, outputs disabled */
  (void)Sensors_ZeroCal();   /* zero offsets from the running (non-switching) sampling chain */
  app_init();
  while (1)
  {
    app_poll();
/* USER CODE END WHILE */

    /* USER CODE BEGIN 3 */
  }
/* USER CODE END 3 */
}

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
/* USER CODE BEGIN 4 */
/* Control tick from the HRTIM master repetition event (10 kHz). */
void hw_ctrl_tick_callback(void)
{
  app_ctrl_isr();
}

/* B1 (blue button): toggle enable in the selected mode. */
void BSP_PB_Callback(Button_TypeDef Button)
{
  if (Button == BUTTON_USER)
  {
    const char *why = NULL;
    (void)app_req_enable(app_faults() == 0U, &why);
  }
}
/* USER CODE END 4 */
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
