saunders-jared-final/Boost-Brigade/6_RTOS/App/app.c

/**
 * app.c - shuffler application (see app.h)
 *
 * Safety path never depends on the scheduler: the over-current latch and the
 * E-stop disable the HRTIM outputs inside their interrupts; the state machine
 * only reports and gates re-enabling.
 */
#include "app.h"

#include <math.h>
#include <stdio.h>
#include <string.h>

#include "comms.h"
#include "ina2x9.h"
#include "main.h"
#include "params_rt.h"
#include "sensors.h"
#include "shuffler_hw.h"
#include "stack.h"

#if N_LEG != HW_N_LEG
#error "control core N_LEG must match the four hardware legs"
#endif

/* ---------------------------------------------------------------- state --- */
static volatile app_state_t s_state = ST_BOOT;
static volatile app_mode_t  s_mode = MODE_IDLE;      /* requested / running mode */
static volatile uint32_t    s_faults = 0U;
static volatile uint32_t    s_ms = 0U;
static volatile uint32_t    s_state_since_ms = 0U;
static volatile uint8_t     s_cmd_enable = 0U;
static volatile uint32_t    s_last_rx_ms = 0U;   /* comms watchdog: last valid command line */

static volatile float s_vm[N_MOD];
static volatile uint8_t s_vm_valid = 0U;
static volatile float s_tdie[3];
static float s_vm_isr[N_MOD];

static float s_ol_duty[N_LEG] = {0.5f, 0.5f, 0.5f, 0.5f};
static float s_vref[N_SHUF];
static uint8_t s_sup_en = 1U;
static int s_test_case = -1;

static stack_state_t s_stack;
static stack_out_t   s_stack_out;
static float s_d_applied[N_LEG] = {0.5f, 0.5f, 0.5f, 0.5f};
static float s_ss_d0[N_LEG];                      /* duties at the start of the soft-start ramp */
static uint32_t s_ss_n = 0U;                      /* control ticks into the ramp */
static volatile uint8_t s_ss_done = 0U;           /* ramp finished: SOFTSTART may hand over to RUN */
static float s_il[N_LEG];
static float s_imr[N_MOD];

static volatile uint8_t s_flag_1ms = 0U;
static uint32_t s_telemetry_div, s_safety_div, s_status_div;
static app_state_t s_last_reported = ST_BOOT;
static uint8_t s_fault_reported = 0U;

static const char *const s_state_names[] = {"BOOT", "SELFTEST", "IDLE", "SOFTSTART", "RUN", "STOP", "FAULT"};
static const char *const s_mode_names[]  = {"IDLE", "OL", "CL", "OL1", "CL1", "OL2", "CL2"};

const char *app_state_name(app_state_t s) { return (s <= ST_FAULT) ? s_state_names[s] : "?"; }
const char *app_mode_name(app_mode_t m)   { return (m < MODE_COUNT) ? s_mode_names[m] : "?"; }
uint32_t app_faults(void) { return s_faults; }
uint32_t app_ms(void) { return s_ms; }
bool app_running(void) { return s_state == ST_SOFTSTART || s_state == ST_RUN; }
void app_note_rx(void) { s_last_rx_ms = s_ms; }

static uint8_t mode_legs(app_mode_t m)
{
  switch (m)
  {
    case MODE_OL: case MODE_CL:   return HW_LEGS_ALL;
    case MODE_OL1: case MODE_CL1: return HW_LEGS_S1;
    case MODE_OL2: case MODE_CL2: return HW_LEGS_S2;
    default: return 0U;
  }
}
static bool mode_closed(app_mode_t m) { return m == MODE_CL || m == MODE_CL1 || m == MODE_CL2; }

static void set_state(app_state_t s)
{
  s_state = s;
  s_state_since_ms = s_ms;
}

/* any context: outputs off, latch the fault, state FAULT */
/* voltage faults: which reading tripped (for the F line), and consecutive-sample confirmation so one corrupted
 * SPI read-out (the U10 isolator) cannot fault a run; VM_FLT_CONFIRM x 10 ms is well inside what the bulk caps allow */
#define VM_FLT_CONFIRM 3U
static int8_t s_flt_vm_ch = -1;      /* 0..2 = VM1..VM3, 3 = string sum, -1 = none */
static float s_flt_vm_v = 0.0f;
static uint8_t s_ov_cnt, s_uv_cnt, s_sov_cnt;

bool app_fault_vm(const char **name, float *v)
{
  static const char *const nm[] = {"VM1", "VM2", "VM3", "Vstr"};
  if (s_flt_vm_ch < 0) return false;
  *name = nm[s_flt_vm_ch];
  *v = s_flt_vm_v;
  return true;
}

static void trip(uint32_t code)
{
  hw_outputs_off();
  s_faults |= code;
  s_cmd_enable = 0U;
  set_state(ST_FAULT);
}

static void trip_vm(uint32_t code, int8_t ch, float v)
{
  s_flt_vm_ch = ch;
  s_flt_vm_v = v;
  trip(code);
}

/* ------------------------------------------------------------- watchdog --- */
static void iwdg_start(void)
{
#if APP_USE_IWDG
  /* LSI ~32 kHz / 32 = 1 kHz; reload 300 -> 0.3 s (was 2 s until 16 Oct 2026: a hung firmware left the bridge
   * switching unsupervised for 2 s). Kicked by the 100 Hz safety task; the longest main-loop stretch is a
   * C,LIST burst (~70 ms of blocking UART). LSI starts with the IWDG. */
  DBGMCU->APB1FZR1 |= DBGMCU_APB1FZR1_DBG_IWDG_STOP;   /* freeze while halted in the debugger */
  IWDG->KR  = 0xCCCCU;
  IWDG->KR  = 0x5555U;
  IWDG->PR  = 3U;        /* /32 */
  IWDG->RLR = 300U;
  while (IWDG->SR != 0U) {}
  IWDG->KR  = 0xAAAAU;
#endif
}
static inline void iwdg_kick(void)
{
#if APP_USE_IWDG
  IWDG->KR = 0xAAAAU;
#endif
}

/* ---------------------------------------------------------------- estop --- */
#define ESTOP_GPIO_Port GPIOC
#define ESTOP_Pin       GPIO_PIN_0      /* CN7-38, active low, internal pull-up; button to GND */

static void estop_init(void)
{
  GPIO_InitTypeDef g = {0};
  __HAL_RCC_GPIOC_CLK_ENABLE();
  g.Pin = ESTOP_Pin;
  g.Mode = GPIO_MODE_IT_FALLING;
  g.Pull = GPIO_PULLUP;
  HAL_GPIO_Init(ESTOP_GPIO_Port, &g);
  HAL_NVIC_SetPriority(EXTI0_IRQn, 0, 0);
  HAL_NVIC_EnableIRQ(EXTI0_IRQn);
}
static bool estop_pressed(void)
{
  return HAL_GPIO_ReadPin(ESTOP_GPIO_Port, ESTOP_Pin) == GPIO_PIN_RESET;
}

void app_estop_isr(void)
{
  trip(FLT_ESTOP);
}

/* ------------------------------------------------------------------ trace --- */
/* Last code point reached, in RAM that the startup does not clear (.noinit, survives an IWDG reset):
 * after a watchdog reset the boot banner says where the firmware was when it stopped kicking. */
#define TRACE_MAGIC 0x7A5C0DEU
__attribute__((section(".noinit"))) static volatile uint32_t s_trace_magic;
__attribute__((section(".noinit"))) static volatile uint32_t s_trace_pt;      /* 0x1x = control ISR, 0x2x = main loop */
__attribute__((section(".noinit"))) static volatile uint32_t s_trace_main;    /* last main-loop point */
__attribute__((section(".noinit"))) static volatile uint32_t s_trace_st;
#define TRACE(pt) do { s_trace_pt = (pt); if (((pt) & 0xF0U) == 0x20U) s_trace_main = (pt); \
                       s_trace_st = ((uint32_t)s_state << 8) | (uint32_t)s_mode; } while (0)
/* control ISR cost (DWT cycle counter): last / max since boot, and what was going on when the main loop stalled */
static volatile uint32_t s_isr_cyc_last, s_isr_cyc_max;
static volatile uint32_t s_stall_pt, s_stall_main, s_stall_isr_last, s_stall_isr_max, s_stall_ms, s_stall_resume_ms;
static volatile uint8_t  s_stall_pending;
uint32_t app_isr_us_max(void) { return s_isr_cyc_max / (SystemCoreClock / 1000000U); }
uint32_t app_isr_us_last(void) { return s_isr_cyc_last / (SystemCoreClock / 1000000U); }

/* ----------------------------------------------------------------- init --- */
void app_init(void)
{
  uint32_t boot_faults = 0U;
  uint32_t wdg_pt = 0U, wdg_st = 0U;
  int i;

  if (RCC->CSR & RCC_CSR_IWDGRSTF)
  {
    boot_faults |= FLT_WDG_RESET;
    if (s_trace_magic == TRACE_MAGIC) { wdg_pt = s_trace_pt; wdg_st = s_trace_st; }
  }
  RCC->CSR |= RCC_CSR_RMVF;
  s_trace_magic = TRACE_MAGIC;
  s_trace_pt = 0U;
  s_trace_main = 0U;
  CoreDebug->DEMCR |= CoreDebug_DEMCR_TRCENA_Msk;     /* DWT cycle counter for the ISR cost */
  DWT->CYCCNT = 0U;
  DWT->CTRL |= DWT_CTRL_CYCCNTENA_Msk;

  for (i = 0; i < N_MOD; i++) { s_vm[i] = NAN; s_vm_isr[i] = 0.0f; s_imr[i] = 0.0f; }
  for (i = 0; i < N_SHUF; i++) s_vref[i] = 0.0f;
  prt_init();                           /* run-time parameter table + boot gain set (kscale default) */
  stack_init(&s_stack);
  estop_init();

  set_state(ST_SELFTEST);
  comms_init();
  comms_banner();
  if (boot_faults & FLT_WDG_RESET)
  {
    char b[96];
    snprintf(b, sizeof b, "WDG RESET: last trace point 0x%02lx (main loop at 0x%02lx) state %lu mode %lu (0x1x = control ISR, 0x2x = main loop)",
             (unsigned long)wdg_pt, (unsigned long)s_trace_main, (unsigned long)(wdg_st >> 8), (unsigned long)(wdg_st & 0xFFU));
    comms_note(b);
  }

  /* self test: sensor zero calibration plausibility, INA bus */
  for (i = 0; i < SENSE_COUNT; i++)
  {
    if (!Sensors_ZeroOk((Sense_Channel)i)) boot_faults |= FLT_ZEROCAL;
  }
  if (INA_BusBlocked()) boot_faults |= FLT_INA;
  app_task_sense_v();
  s_faults = boot_faults;
  set_state((boot_faults & (FLT_ZEROCAL | FLT_INA)) ? ST_FAULT : ST_IDLE);
  if (s_state == ST_FAULT) hw_outputs_off();
  comms_send_status();
  iwdg_start();
}

/* ------------------------------------------------------------ control --- */
#define SS_TICKS ((APP_SOFTSTART_MS * HW_PWM_HZ) / (HW_CTRL_DIV * 1000U))
#define SS_VSPAN_MIN_V 2.0f

/* Pre-bias for shuffler k (legs 2k, 2k+1; top module k, bottom module k+1): the duty at which a leg's
 * average voltage equals the midpoint, d0 = Vbot / (Vtop + Vbot), so turning the outputs on applies no
 * net voltage across the inductors. Starting at 0.5 instead forces Vtop = Vbot in one LC pulse
 * (a 1 V mismatch rails the hall sensors). 0.5 when either module voltage is unknown. */
static float prebias_duty(uint8_t k)
{
  float vt = s_vm_isr[k], vb = s_vm_isr[k + 1U];
  if (isnan(vt) || isnan(vb) || (vt + vb) < SS_VSPAN_MIN_V) return 0.5f;
  return vb / (vt + vb);
}

/* 10 kHz, from the HRTIM master repetition interrupt */
void app_ctrl_isr(void)
{
  stack_in_t in;
  app_state_t st = s_state;
  app_mode_t  md = s_mode;
  uint8_t legs = mode_legs(md);
  int i;

  uint32_t cyc0 = DWT->CYCCNT;
  TRACE(0x10);
  Sensors_Tick();                       /* reads last conversions, OC latch, starts next */
  TRACE(0x11);
  for (i = 0; i < N_LEG; i++) s_il[i] = Sensors_Current_A((Sense_Channel)i);
  if (Sensors_FaultLatched() && !(s_faults & FLT_OC_LATCH))
  {
    trip(FLT_OC_LATCH);
    st = ST_FAULT;
  }

  /* C,APPLY: swap the gain set at this tick boundary, integrators rebased on the applied duties */
  prt_isr_service(&s_stack.ctrl, s_d_applied);
  TRACE(0x12);

  /* module voltages: latest task snapshot (written at 1 kHz) */
  for (i = 0; i < N_MOD; i++) s_vm_isr[i] = (float)s_vm[i];

  if (st != ST_SOFTSTART) s_ss_n = 0U;

  if (st == ST_SOFTSTART)
  {
    /* linear ramp from the pre-bias held in IDLE (already the active HRTIM compare when the outputs
     * came on) to the mode's duty: the OL duties, or 0.5 where the closed loop takes over */
    float frac;
    if (s_ss_n == 0U)
    {
      for (i = 0; i < N_LEG; i++) s_ss_d0[i] = s_d_applied[i];
      s_ss_done = 0U;
    }
    frac = (s_ss_n >= SS_TICKS) ? 1.0f : (float)s_ss_n / (float)SS_TICKS;
    for (i = 0; i < N_LEG; i++)
    {
      float target = mode_closed(md) ? 0.5f : s_ol_duty[i];
      s_d_applied[i] = s_ss_d0[i] + (target - s_ss_d0[i]) * frac;
    }
    if (s_ss_n < SS_TICKS) s_ss_n++;
    else s_ss_done = 1U;
    TRACE(0x13);
    stack_init(&s_stack);               /* closed loop starts fresh when RUN begins */
  }
  else if (st == ST_RUN && mode_closed(md))
  {
    for (i = 0; i < N_MOD; i++) in.VM[i] = isnan(s_vm_isr[i]) ? 0.0f : s_vm_isr[i];
    for (i = 0; i < N_LEG; i++) in.IL[i] = s_il[i];
    /* single-converter modes: blind the controller to the inactive shuffler
     * (zero its voltage-difference and current channels -> zero error) */
    if (!(legs & HW_LEGS_S1)) { in.VM[0] = in.VM[1]; in.IL[0] = 0.0f; in.IL[1] = 0.0f; }
    if (!(legs & HW_LEGS_S2)) { in.VM[2] = in.VM[1]; in.IL[2] = 0.0f; in.IL[3] = 0.0f; }
    for (i = 0; i < N_MOD; i++) in.IM[i] = 0.0f;   /* STACK_RECON_IM reconstructs these */
    in.Vstr = in.VM[0] + in.VM[1] + in.VM[2];
    in.Istr = 0.0f;
    for (i = 0; i < N_SHUF; i++) in.Vref[i] = s_vref[i];
    in.en_sup = s_sup_en ? 1.0f : 0.0f;
    in.en_mppt = 0.0f;                  /* the load (EcoFlow) does string MPPT */
    TRACE(0x14);
    stack_step(&in, &s_stack, &s_stack_out);
    TRACE(0x15);
    {
      /* duty slew limit: bounds the step a wrong gain or a sensor glitch can put on the bridge */
      float sl = prt.slew;
      for (i = 0; i < N_LEG; i++)
      {
        float dn = s_stack_out.d[i], dp = s_d_applied[i];
        if (dn > dp + sl) dn = dp + sl;
        if (dn < dp - sl) dn = dp - sl;
        s_d_applied[i] = dn;
      }
    }
    for (i = 0; i < N_MOD; i++) s_imr[i] = s_stack_out.IM[i];
  }
  else if (st == ST_RUN)
  {
    for (i = 0; i < N_LEG; i++) s_d_applied[i] = s_ol_duty[i];
  }
  else
  {
    /* outputs off (IDLE / STOP / FAULT): hold every leg at its shuffler's pre-bias, so the compare
     * that is active when SOFTSTART switches the outputs on is already d0 */
    for (i = 0; i < N_LEG; i++) s_d_applied[i] = prebias_duty((uint8_t)(i / 2));
  }
  TRACE(0x16);
  for (i = 0; i < N_LEG; i++)
  {
    if (st != ST_IDLE && st != ST_STOP && st != ST_FAULT && !(legs & (1U << i)))
      s_d_applied[i] = 0.5f;                          /* inactive legs parked (outputs are off anyway) */
    hw_set_duty((uint8_t)i, s_d_applied[i]);
  }
  TRACE(0x17);
  s_isr_cyc_last = DWT->CYCCNT - cyc0;
  if (s_isr_cyc_last > s_isr_cyc_max) s_isr_cyc_max = s_isr_cyc_last;
}

/* ----------------------------------------------------------- 1 ms tick --- */
static volatile uint32_t s_main_alive_ms;   /* last app_poll() pass */
#define MAIN_STALL_MS 20U

void app_tick_1ms(void)
{
  s_ms++;
  s_flag_1ms = 1U;
  /* main loop dead while switching (hung in a HAL wait, hard fault with IRQs still running): outputs off now,
   * not after the IWDG period. A hang inside the control ISR itself can only be caught by the IWDG. */
  if ((s_state == ST_RUN || s_state == ST_SOFTSTART) && (s_ms - s_main_alive_ms) > MAIN_STALL_MS)
  {
    s_stall_pt = s_trace_pt; s_stall_main = s_trace_main;
    s_stall_isr_last = s_isr_cyc_last; s_stall_isr_max = s_isr_cyc_max;
    s_stall_ms = s_ms; s_stall_resume_ms = 0U; s_stall_pending = 1U;
    trip(FLT_MAIN_STALL);
  }
}

/* U10 (INA CS3) is wired with its VBUS/GND the other way round on the Version 0 board: the magnitude is right,
 * the sign is negative (bench, 16 Oct 2026). Applied to every use of its reading (VM1 and the init-check line). */
#define U10_VBUS_SIGN (-1.0f)
static float ina_sign(uint8_t i) { return (i == 2U) ? U10_VBUS_SIGN : 1.0f; }

/* --------------------------------------------------------------- tasks --- */
void app_task_sense_v(void)
{
  float v[INA_COUNT];
  uint8_t ok = 0U, i;
  INA_Poll();
  for (i = 0; i < INA_COUNT; i++)
  {
    const INA_Dev *d = INA_Get(i);
    if (d->kind == INA_239 || d->kind == INA_229) { v[i] = (float)d->vbus_mV * 1e-3f * ina_sign(i); ok |= (uint8_t)(1U << i); s_tdie[i] = (float)d->temp_C; }
    else { v[i] = NAN; s_tdie[i] = NAN; }
  }
  /* index 0 = CS1 (U12, PV3+ to GND), 1 = CS2 (U11, PV2+ to GND), 2 = CS3 (U10, PV1+ to PV3+, sign U10_VBUS_SIGN) */
  float vm3 = v[0];
  float vm2 = v[1] - v[0];
  float vm1 = v[2] - vm2;
  uint8_t vm23_ok = ((ok & 3U) == 3U) ? 1U : 0U;
  uint8_t vm1_ok = ((ok & 7U) == 7U) ? 1U : 0U;
  /* VM1 source (C,SET,vm1_src): U10 (CS3), or the string voltage from the DL3021 minus VM2 + VM3 */
  int src = (int)prt.vm1_src;
  if (src == VM1_SRC_VSTR_PARAM)
  {
    vm1_ok = (vm23_ok && prt.vstr_param > 1.0f) ? 1U : 0U;
    vm1 = vm1_ok ? (prt.vstr_param - v[1]) : NAN;      /* v[1] = U11 = VM2 + VM3 */
  }
  else if (src == VM1_SRC_VSTR_PI)
  {
    uint32_t t = prt_vstr_pi_ms;
    uint8_t fresh = (t != 0U) && ((s_ms - t) <= PRT_VSTR_PI_STALE_MS);
    vm1_ok = (vm23_ok && fresh && prt.vstr_pi > 1.0f) ? 1U : 0U;
    vm1 = vm1_ok ? (prt.vstr_pi - v[1]) : NAN;
  }
  __disable_irq();
  s_vm[2] = vm3;  s_vm[1] = vm2;  s_vm[0] = vm1;
  s_vm_valid = (uint8_t)(((ok & 1U) ? 4U : 0U) | (vm23_ok ? 2U : 0U) | (vm1_ok ? 1U : 0U));
  __enable_irq();
}

static bool vm_ok_for(app_mode_t m)
{
  uint8_t need = 0U;
  if (!mode_closed(m)) return true;
  if (mode_legs(m) & HW_LEGS_S1) need |= 0x3U;   /* VM1, VM2 */
  if (mode_legs(m) & HW_LEGS_S2) need |= 0x6U;   /* VM2, VM3 */
  return (s_vm_valid & need) == need;
}

/* operator-facing reason when a closed-loop mode is refused for missing module voltages */
static const char *vm_why(app_mode_t m)
{
  uint8_t need = 0U;
  if (mode_legs(m) & HW_LEGS_S1) need |= 0x3U;
  if (mode_legs(m) & HW_LEGS_S2) need |= 0x6U;
  if (!(s_vm_valid & 0x6U & need)) return "VM2/VM3 not readable (INA CS1/CS2)";
  switch ((int)prt.vm1_src)
  {
    case VM1_SRC_VSTR_PARAM: return "VM1 not readable: vstr_param is 0 (vm1_src 1)";
    case VM1_SRC_VSTR_PI:    return "VM1 not readable: no vstr_pi from the e-load for 2 s (vm1_src 2: eload service / USB / LOCAL?)";
    default:                 return "VM1 not readable: U10 (INA CS3) absent (vm1_src 0; use vm1_src 2 or 1)";
  }
}

void app_task_safety(void)
{
  app_state_t st = s_state;
  int i;

  iwdg_kick();

  if (st == ST_RUN || st == ST_SOFTSTART)
  {
    if (estop_pressed()) trip(FLT_ESTOP);
    /* module / string voltage envelopes. VM1 takes part only with vm1_prot = 1: U10 (CS3) answers intermittently
     * through its isolator and can return a corrupted bus voltage, which must not fault a run. Each fault needs
     * VM_FLT_CONFIRM consecutive 10 ms samples. */
    float vsum = 0.0f;
    int8_t ov = -1, uv = -1;
    for (i = 0; i < N_MOD; i++)
    {
      float v = (float)s_vm[i];
      if (isnan(v) || (i == 0 && prt.vm1_prot < 0.5f)) continue;
      vsum += v;
      if (v > prt.vm_ov && ov < 0) ov = (int8_t)i;
      if (v < prt.vm_uv && mode_closed(s_mode) && (s_vm_valid & (1U << i)) && uv < 0) uv = (int8_t)i;
    }
    s_ov_cnt = (ov >= 0) ? (uint8_t)(s_ov_cnt + 1U) : 0U;
    s_uv_cnt = (uv >= 0) ? (uint8_t)(s_uv_cnt + 1U) : 0U;
    if (s_ov_cnt >= VM_FLT_CONFIRM) trip_vm(FLT_OV, ov, (float)s_vm[ov]);
    else if (s_uv_cnt >= VM_FLT_CONFIRM) trip_vm(FLT_UV, uv, (float)s_vm[uv]);
    /* string OV: sum of the modules taking part (a lower bound when VM1 is out), and the e-load readback */
    float vpi = ((int)prt.vm1_src == VM1_SRC_VSTR_PI && prt_vstr_pi_ms != 0U) ? prt.vstr_pi : 0.0f;
    s_sov_cnt = (vsum > prt.vstr_ov || vpi > prt.vstr_ov) ? (uint8_t)(s_sov_cnt + 1U) : 0U;
    if (s_sov_cnt >= VM_FLT_CONFIRM) trip_vm(FLT_STRING_OV, 3, (vsum > prt.vstr_ov) ? vsum : vpi);
    /* comms watchdog (closed loop only): the Pi pod sends C,PING every second */
    if (mode_closed(s_mode) && prt.wdg_s > 0.0f && (s_ms - s_last_rx_ms) > (uint32_t)(prt.wdg_s * 1000.0f))
      trip(FLT_COMMS_WDG);
    /* VM1 from the Pi went stale while converter 1 is closed loop */
    if (mode_closed(s_mode) && (mode_legs(s_mode) & HW_LEGS_S1) && (int)prt.vm1_src == VM1_SRC_VSTR_PI &&
        !(s_vm_valid & 1U))
      trip(FLT_VSTR_STALE);
    for (i = 0; i < 3; i++)
    {
      if (!isnan((float)s_tdie[i]) && (float)s_tdie[i] > APP_TEMP_MAX_C) { trip(FLT_OVERTEMP); break; }
    }
    if (mode_closed(s_mode) && !vm_ok_for(s_mode)) trip(FLT_INA);
  }

  switch (s_state)
  {
    case ST_IDLE:
      if (s_cmd_enable && s_mode != MODE_IDLE)
      {
        /* duties are not touched here: the control ISR holds the pre-bias d0 while idle */
        s_ss_done = 0U;
        hw_pins_to_hrtim();
        hw_legs_enable_sync(mode_legs(s_mode));   /* outputs on at the next quarter period */
        set_state(ST_SOFTSTART);
      }
      break;
    case ST_SOFTSTART:
      if (!s_cmd_enable) { set_state(ST_STOP); break; }
      if (s_ss_done) set_state(ST_RUN);
      break;
    case ST_RUN:
      if (!s_cmd_enable || s_mode == MODE_IDLE) set_state(ST_STOP);
      break;
    case ST_STOP:
      hw_legs_enable(0U);               /* the control ISR goes back to holding the pre-bias */
      s_cmd_enable = 0U;
      set_state(ST_IDLE);
      break;
    case ST_FAULT:
      hw_outputs_off();   /* belt and braces, every 10 ms */
      break;
    default:
      break;
  }

  if (s_state != s_last_reported)
  {
    s_last_reported = s_state;
    comms_send_status();
  }
  if (s_state == ST_FAULT && !s_fault_reported)
  {
    s_fault_reported = 1U;
    comms_send_fault();
    if (s_stall_pending)
    {
      char b[160];
      uint32_t mhz = SystemCoreClock / 1000000U;
      s_stall_pending = 0U;
      snprintf(b, sizeof b, "MAIN STALL: main loop at 0x%02lx, last point 0x%02lx, ISR last %lu us max %lu us (budget 100), "
               "main loop back after %lu ms, isr count ok",
               (unsigned long)s_stall_main, (unsigned long)s_stall_pt, (unsigned long)(s_stall_isr_last / mhz),
               (unsigned long)(s_stall_isr_max / mhz), (unsigned long)(s_stall_resume_ms - s_stall_ms));
      comms_note(b);
    }
  }
}

void app_task_telemetry(void)
{
  comms_send_telemetry();
}

void app_task_cmd(void)
{
  comms_poll_rx();
}

void app_poll(void)
{
  if (!s_flag_1ms) return;
  s_flag_1ms = 0U;
  if (s_stall_pending && s_stall_resume_ms == 0U) s_stall_resume_ms = s_ms;
  s_main_alive_ms = s_ms;
  TRACE(0x20);
  app_task_sense_v();
  TRACE(0x21);
  if (++s_safety_div >= 10U)   { s_safety_div = 0U;   app_task_safety(); }
  TRACE(0x22);
  if (++s_telemetry_div >= 20U){ s_telemetry_div = 0U; app_task_telemetry(); }
  TRACE(0x23);
  if (++s_status_div >= 1000U) { s_status_div = 0U;    comms_send_status(); }
  TRACE(0x24);
  app_task_cmd();
  TRACE(0x25);
}

/* ----------------------------------------------------- IC init check --- */
#define INIT_HALL_IDLE_MAX_A 1.0f     /* idle (gates off) reading above this = bad offset / sensor */

static void init_line(const char *name, bool ok, const char *detail)
{
  char b[96];
  snprintf(b, sizeof b, "INIT %-9s %s  %s", name, ok ? "PASS" : "FAIL", detail);
  comms_note(b);
}

/* Main loop only, switching stopped. Re-probes the INAs, re-reads their config, checks halls at rest. */
static bool init_check(void)
{
  char d[120];
  int fails = 0, i;

  comms_note("INIT check start (gates off)");
  INA_Reinit();
  app_task_sense_v();

  if (INA_BusBlocked())
  {
    init_line("SPI3 bus", false, "held by U13 isolator (reversed channels), INA read-out disabled");
    fails++;
  }
  else
  {
    init_line("SPI3 bus", true, "free");
  }

  for (i = 0; i < INA_COUNT; i++)
  {
    const INA_Dev *dev = INA_Get((uint8_t)i);
    char nm[12], vs[16];
    bool ok = (dev->kind == INA_239 || dev->kind == INA_229) && INA_ConfigOk((uint8_t)i);
    snprintf(nm, sizeof nm, "INA CS%d", i + 1);
    if (ok)
    {
      snprintf(d, sizeof d, "%s mfr 0x%04X dev 0x%04X cfg ok, vbus %s V, die %d C", INA_KindName(dev->kind),
               (unsigned)dev->mfr_id, (unsigned)dev->dev_id, comms_fmt(vs, (float)dev->vbus_mV * 1e-3f * ina_sign((uint8_t)i)),
               (int)dev->temp_C);
    }
    else
    {
      snprintf(d, sizeof d, "%s (mfr 0x%04X dev 0x%04X)%s", INA_KindName(dev->kind), (unsigned)dev->mfr_id,
               (unsigned)dev->dev_id, (i == 2) ? " [CS3 = U10: optional, re-probed every 1 s; VM1 from vstr_param with vm1_src 1]" : "");
    }
    init_line(nm, ok, d);
    if (!ok && i != 2) fails++;   /* U10 (CS3) comes and goes through its isolator: reported, not counted */
  }

  for (i = 0; i < SENSE_COUNT; i++)
  {
    float a = Sensors_Current_A((Sense_Channel)i);
    char vs[16];
    bool ok = Sensors_ZeroOk((Sense_Channel)i) && fabsf(a) < INIT_HALL_IDLE_MAX_A;
    snprintf(d, sizeof d, "zero-cal %s, reads %s A at rest, gain %d mV/A", Sensors_ZeroOk((Sense_Channel)i) ? "ok" : "IMPLAUSIBLE",
             comms_fmt(vs, a), (int)Sensors_Cal_mVperA((Sense_Channel)i));
    init_line(Sensors_Name((Sense_Channel)i), ok, d);
    if (!ok) fails++;
  }

  init_line("E-stop", !estop_pressed(), estop_pressed() ? "pressed (PC0 low)" : "released");
  if (estop_pressed()) fails++;

  snprintf(d, sizeof d, "state %s, faults 0x%lx", app_state_name(s_state), (unsigned long)s_faults);
  init_line("firmware", s_faults == 0U, d);
  if (s_faults != 0U) fails++;

  snprintf(d, sizeof d, "INIT note: control ISR last %lu us, max %lu us since boot (budget 100 us at 10 kHz)",
           (unsigned long)app_isr_us_last(), (unsigned long)app_isr_us_max());
  comms_note(d);
  snprintf(d, sizeof d, "INIT note: hall sampling %lu of %lu ticks without a DMA wrap (0 = ADC keeps up with the %lu kHz triggers)",
           (unsigned long)Sensors_NoWrapTicks(), (unsigned long)Sensors_Ticks(), (unsigned long)(HW_PWM_HZ * HW_ADC_TRIG_PER_PERIOD / 1000U));
  comms_note(d);
  comms_note("INIT note: 1ED3140 gate drivers and ISO7762 have no read-back; check gate waveforms on the scope");
  snprintf(d, sizeof d, "INIT RESULT: %s (%d failing)", fails ? "FAIL" : "PASS", fails);
  comms_note(d);
  return fails == 0;
}

/* ------------------------------------------------------------ requests --- */
bool app_req_mode(app_mode_t m, const char **why)
{
  if (m >= MODE_COUNT) { *why = "bad mode"; return false; }
  if (s_state == ST_FAULT) { *why = "faulted, send C,CLEAR"; return false; }
  if (!vm_ok_for(m)) { *why = vm_why(m); return false; }
  if (s_state == ST_RUN || s_state == ST_SOFTSTART)
  {
    /* live mode change: only between modes with the same legs; otherwise stop first */
    if (mode_legs(m) != mode_legs(s_mode)) { *why = "stop first (different legs)"; return false; }
    if (mode_closed(m) && !mode_closed(s_mode)) stack_init(&s_stack);
  }
  s_mode = m;
  if (m == MODE_IDLE) s_cmd_enable = 0U;
  return true;
}

int app_test_case(void) { return s_test_case; }

bool app_req_test(int n, const char **why)
{
  app_mode_t m;
  if (n == 0)
  {
    if (s_state == ST_SOFTSTART || s_state == ST_RUN) { *why = "stop first (C,EN,0)"; return false; }
    s_test_case = 0;
    if (s_mode != MODE_IDLE) { s_mode = MODE_IDLE; s_cmd_enable = 0U; }
    if (!init_check()) { *why = "init check failed, see # INIT lines"; return false; }
    return true;
  }
  switch (n)
  {
    case 1: m = MODE_OL2; break;     /* bottom shuffler = converter 2 (legs 2,3; modules 2-3) */
    case 2: m = MODE_OL1; break;     /* top shuffler    = converter 1 (legs 0,1; modules 1-2) */
    case 3: m = MODE_OL;  break;
    default: *why = "test case 0..3"; return false;
  }
  if (!app_req_mode(m, why)) return false;
  s_test_case = n;
  comms_note(n == 1 ? "TEST 1: bottom shuffler (S2) open loop selected, send C,EN,1 to start"
           : n == 2 ? "TEST 2: top shuffler (S1) open loop selected, send C,EN,1 to start"
                    : "TEST 3: both shufflers open loop selected, send C,EN,1 to start");
  return true;
}

bool app_req_enable(bool on, const char **why)
{
  if (on)
  {
    if (s_state == ST_FAULT) { *why = "faulted, send C,CLEAR"; return false; }
    if (s_mode == MODE_IDLE) { *why = "select a mode first"; return false; }
    if (estop_pressed()) { *why = "E-stop pressed"; return false; }
    if (!vm_ok_for(s_mode)) { *why = vm_why(s_mode); return false; }
    s_last_rx_ms = s_ms;
    s_ov_cnt = s_uv_cnt = s_sov_cnt = 0U;
    s_flt_vm_ch = -1;
    s_cmd_enable = 1U;
  }
  else
  {
    s_cmd_enable = 0U;
  }
  return true;
}

bool app_req_duty(uint8_t leg, float d, const char **why)
{
  if (leg >= N_LEG) { *why = "leg 0..3"; return false; }
  if (d < HW_DUTY_MIN || d > HW_DUTY_MAX) { *why = "duty out of range"; return false; }
  if (mode_closed(s_mode) && s_state == ST_RUN) { *why = "closed loop owns the duties"; return false; }
  s_ol_duty[leg] = d;
  return true;
}

bool app_req_vref(const float *rv, const char **why)
{
  int i;
  for (i = 0; i < N_SHUF; i++)
  {
    if (rv[i] < -SUP_RVMAX || rv[i] > SUP_RVMAX) { *why = "vref out of range"; return false; }
  }
  for (i = 0; i < N_SHUF; i++) { s_vref[i] = rv[i]; prt.vref[i] = rv[i]; }
  return true;
}

bool app_req_sup_enable(bool on)
{
  s_sup_en = on ? 1U : 0U;
  prt.sup_en = on ? 1.0f : 0.0f;
  return true;
}

void app_req_soft_estop(void)
{
  trip(FLT_SOFT_ESTOP);
}

bool app_req_clear(const char **why)
{
  if (s_state != ST_FAULT) { *why = "not faulted"; return false; }
  if (estop_pressed()) { *why = "E-stop still pressed"; return false; }
  hw_outputs_off();
  Sensors_ClearFault();
  s_faults = 0U;
  s_fault_reported = 0U;
  s_cmd_enable = 0U;
  s_mode = MODE_IDLE;
  app_task_sense_v();
  if (INA_BusBlocked()) s_faults |= FLT_INA;
  set_state(ST_IDLE);
  return true;
}

void app_get_snapshot(app_snapshot_t *o)
{
  int i;
  __disable_irq();
  o->ms = s_ms;
  o->state = s_state;
  o->mode = s_mode;
  o->faults = s_faults;
  for (i = 0; i < N_MOD; i++) { o->VM[i] = (float)s_vm[i]; o->IMr[i] = s_imr[i]; }
  for (i = 0; i < N_LEG; i++) { o->IL[i] = s_il[i]; o->d[i] = s_d_applied[i]; }
  for (i = 0; i < N_SHUF; i++) o->rv[i] = s_stack_out.rv[i];
  o->beta = s_stack_out.beta;
  o->stress = s_stack_out.stress;
  for (i = 0; i < 3; i++) o->Tdie[i] = (float)s_tdie[i];
  o->vm_valid = s_vm_valid;
  o->legs = hw_legs_enabled();
  o->kscale = prt_kscale_active;
  o->pset = prt_pset;
  __enable_irq();
}
