saunders-jared-final/Boost-Brigade/(commit log)

2026-05-27 Updated Shuffler Model
    Still needs to assess large voltage fluctuation on switching edge. 500W ripple vs 10-20W in Qspice ?
2026-05-29 Playing with current control
    bruh
2026-07-15 Shuffler String Control
    New Dynamics (M) matrix recalculated from open loop.
    Closed loop passes early tests. Seems to track references and converge / settle.
    Use ident.m file to recalculate open loop dynamics. Use validate.m to test the closed loop control with that new M matrix
2026-07-16 Simulink Control System Complete!
    3 levels of control.
    1) MIMO loops. State feedback of module / capacitor voltages and inductor currents. Outputs aka actuates duty cycles for each half-bridge.
    2) Supervisor. Dynamically adjust the voltage references for the MIMO controller to protect the system and prevent duty cycles from saturating.
    3) MPPT. P&O
2026-07-22 SIL Complete (Arduino Version)
    SIL passes the validation test suite.
    Successfully implemented C caller blocks.
    The firmware was to target the Arduino Uno R3 ATmega328P.
2026-09-11 routing
    1st draft of shuffler. Has been sent off to Geoff for review. And yes some of the pv power connections are not routed yet.
2026-09-12 updated pcb
2026-09-27 Qspice update
    Qspice update with parasitics estimated from PCB design. Claude's outputs folder to be ignored.
2026-10-11 Control core: N-module generalisation, module-current reconstruction, JSON params
    - ctrl/supervisor/stack sized by N_MOD/N_SHUF/N_LEG from params.h
    - shuffler_recon: module currents from inductor currents + duties (KCL,
    relative to module N); stack option STACK_RECON_IM for the hardware config
    - params generated from ctrl_core/params/*.json (3-mod 10 kHz placeholder M
    from the validated 4-mod sub-blocks; mil4 preset reproduces sps-params-1.0.0)
    - unit tests / replay harness generic over N; new offset-invariance and
    reconstruction tests; both presets pass (4603 / 7365 checks)
    - SIL C Caller wrappers switched to array ports (+ sil_recon_step)
    - shared core lives in 6_RTOS/ctrl_core (case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
2026-10-11 3-module Simulink scripts, telemetry contract, README index, MATLAB params exporter
    - 4_Simulink/3_Carpark_3mod: init_params (150 W panels, 10 kHz, N=3), generic
    block sources (ctrl/supervisor/recon/mppt), ident (writes M into the shared
    JSON), validate (with reconstruction consistency check), export_golden,
    model-edit checklist
    - 6_RTOS/ctrl_core/params/export_params.m: MATLAB twin of gen_params.py
    - MPPT clamps for the 150 W string (8/2/8.5 A); unit tests use the macros
    - 0_Documentation/telemetry.md + PLAN.md; root README rewritten as an index
2026-10-11 Firmware: four-leg HRTIM with 10 kHz control tick, control core in the loop, state machine, telemetry
    - App/shuffler_hw: master timer 100 kHz, A legs on master period / B legs on
    master CMP2 (180 deg), 200 ns dead time, duty via CMP1 preload, repetition
    IRQ = control tick, outputs-off / gates-low safety paths
    - App/app: BOOT/SELFTEST/IDLE/SOFTSTART/RUN/STOP/FAULT, modes OL/CL x all/S1/S2,
    10 kHz ISR runs sensors + stack_step (STACK_RECON_IM=1, en_mppt=0), 1 kHz
    INA->VM task, 100 Hz safety (OV/UV/temp envelopes, E-stop PC0, IWDG 2 s)
    - App/comms: T/S/F/A frames and C commands per 0_Documentation/telemetry.md,
    LPUART1 921600, RX ring + line parser, bench CAL command
    - sensors: 4x ove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
2026-10-11 Pi pod stack: InfluxDB+Grafana compose, serial bridge service, IR/LCD/LED, bench tools
2026-10-11 QSPICE: control stack as a C-block DLL, closed-loop stage S9
    - 2_Qspice/ctrl_dll: shuffler_ctrl_dll.cpp wraps 6_RTOS/ctrl_core (INA 1 kHz hold +
    3.125 mV quantisation, 12-bit hall ADC, 10 kHz tick via Trunc, one-level rollback),
    build_dll.bat with the Digital Mars compiler bundled in QSPICE
    - gen_shuffler.py: pvmi_150w panel model, Circuit.DLL (Ø(.DLL) netlist form), ctrl_block
    (hall sensor sources, sawtooth ramps, enable/Vref), HRTIM-style PWM comparators with
    dead time in converter(ctrl=True), stage S9 = S5 circuit + 150 W panels + 100 kHz PWM +
    closed loop (CASE 2, Vref1 step), S9 measurement set
    - qsch_writer.py: pin kinds for DLL blocks; run_baseline.py: S9 plots, longer time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
2026-10-11 QSPICE identification stage S9i, closed loop S9 validated with QSPICE-identified gains
    - S9i: open-loop baseline + 4 modal duty steps (.step RUN), qspice_ident.py -> G -> M ->
    shuffler_params.json (sps-params-2.20261011-1634-3mod-qspice); u_diff->i_comm gain is
    POSITIVE on the PCB wiring (+256/+216 A/duty), opposite to the 4-mod Simulink ident
    - DLL: hall inputs averaged over each control tick (PWM-period average like the firmware
    ADC; point samples aliased the phase ripple), INA239 modelled as an 84 us conversion
    polled at 1 kHz, built with STACK_RECON_IM=1
    - S9 result: vd 0.00/-0.01 V, circulating currents nulled, 1 V Vref step settles in ~1.5 ms
    (~9 % overshoot), 377 W vs 262 W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
2026-10-12 init check / pi deployment
    added an initialisation stage to to check all mcu peripherals
2026-10-15 simulink carpark edition
    a simulink that has a control system for the ideal, avg switch bench and car park case.
2026-10-15 qspice controller sims
    refined gains from qspice simulations and applied a comb filter. Includes module voltages, voltage difference reference tracking, duty cycles, module and string currents, shuffled and circulating currents, phase currents.
2026-10-16 QSPICE S11 edge fit (v3 MOSFET model, die snubbers, bulk-cap ESL/ESR fit), S10i recalibration, edge metrics and result plots
2026-10-16 pod: DL3021 e-load control + presets + full command/parameter recording; fw 0.3.3
    7_Pi: eload.py owns the DL3021 and serves E,INPUT/MODE/SET/LOCAL/REMOTE/STATUS on 127.0.0.1:5018;
    presets 0-9 = init, OL, CL, load on/off/remote/local, gains, clear (remote = web = cheat sheet);
    pod records cmd/note/params measurements, Grafana command-log and parameter tables; IR remote
    (Elegoo NEC keymap), LCD e-load page; podctl routes E, lines.
    Firmware 0.3.3: VM1 defaults to the DL3021 readback (vm1_src 2), vm1_prot keeps VM1 out of the
    OV/UV checks, voltage faults need 3 consecutive samples and report the channel, CS3 (U10) is
    optional in the init check, U10 bus voltage sign flipped, mode refusals name th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
2026-10-20 KiCad: replace conflicted Version 0 project with the clean_slate design
    The board file carried 12 unresolved stash-pop conflict blocks (committed
    that way in the repo restructure), so the PCB editor could not open it.
    Bring over the clean_slate branch of solar-shuffler-kicad (19 Sep): all
    schematic sheets, the board, DRC rules; add the TP Library, DP3T and SPST
    libs and table entries for every nickname the design uses, relative to
    5_Kicad/libs. Schematic and board agree on all 195 references.
2026-10-20 Firmware 0.4.1 at 200/300/400 kHz, Pi params for the 200 kHz image, QSPICE S10i3/S10i4 runs, docs
    - 7_Pi: shuffler.bin = 200 kHz build (flashed 20 Oct), 300k/400k images staged
    alongside; params.yaml carries the 200 kHz QSPICE bench gain set
    - 6_RTOS: HW_PWM_KHZ build option, adc/main clock changes for 400 kHz,
    identified gain sets as JSON
    - QSPICE PCB_Baseline: S10i3 (300 kHz), S10i4/S10i4d1 (400 kHz) stages and results
    - docs: experiment checklist, telemetry, quasi-MPPT overview
2026-10-20 QSPICE: single sheet of the v3 drawing with the firmware control stack integrated
    Buck Boost Full Bridge - v3 - control.qsch is a generated copy of the hand-drawn
    v3 sheet (parasitics as drawn, v3 itself untouched) with the shuffler_ctrl_dll2
    C-block wired in: SW1/SW2 replaced by HRTIM-style comparators giving each
    half-bridge driver its own PWM pair (Tsw, Tdead), the sheet's winding sense
    sources V4/V7/V5/V6 feeding TMCS1126 hall models, INA nodes on the string buses
    (Out, PV2P, PV3P), the DLL test inputs as .params, open-loop duties before TEN.
    integrate_control_v3.py regenerates it from v3; the .md beside the sheet lists
    the files it needs and the knobs. DLL rebuilt against the current pa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
2026-10-20 Results: CSV exports behind every Grafana screenshot, influx_export.py
    8_Results/README.md indexes them: per screenshot window the RUN_OL telemetry
    (50 Hz T frames, pivoted) and the DL3021 e-load log; temperature screenshots as
    1 s means over all states. Bench 16 Oct: 200/300/400 kHz windows plus the full
    RUN_OL span of each gain set; bench 13 Oct 100 kHz window; carpark 20 Oct.
    7_Pi/tools/influx_export.py pulls any window from the Pi's InfluxDB by epoch ms
    (Grafana URL) or local ISO time, with state / pver / field / downsample options.
2026-10-20 Bench and carpark photos and videos (Aug to 20 Oct), KiCad project re-saved
    The 140 MB video 20261016_173330.mp4 stays out (GitHub's 100 MB limit); it is
    listed in .gitignore and remains on disk.
2026-11-01 Add showcase/handover website (site/) with GitHub Pages deploy; redact pod credentials
    Astro 7 static site under site/ (nine routes: home, story, hardware, control,
    simulation, results, handover, media, about) built from repository content at
    build time: ctrl_core snippets, versioned gain sets, REPORT.md findings and
    caveats, TestCases inventory. Interactive pieces: three.js exploded view of the
    KiCad board (GLB exported with kicad-cli), before/after sliders, design-evolution
    timeline from DESIGN_LOG, KaTeX control derivation, gotchas database, PhotoSwipe
    gallery, lite YouTube embeds (ids pending). Ten TikZ diagrams rendered to SVG.
    Asset prep scripts in site/scripts (photos, figures, notebo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
2026-11-02 Rework the website into a two-stream knowledge hub
    Reframe site/ from a control-stream showcase into the project's central
    knowledge hub, following Jared's 3 Nov feedback, with Son's hardware report
    and the delivery report (both added to 0_Documentation) as the sources.
    - New palette (cool base, amber brand, blue = control, green = hardware);
    the stray arrow glyphs replaced by an SVG external-link marker.
    - Home: plain-language claims instead of stat tiles, bench-clip stand-in
    for the intro video, shading explainer, animated single-shuffler drawing,
    annotated board photo, where-to-next cards, team strip.
    - Story: proposal vs actual Gantt charts for both streams plus a combined
    view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
