saunders-jared-final/Boost-Brigade/(notices)

Notices in the files:
6_RTOS/Core/Inc/main.h:
Copyright (c) 2026 STMicroelectronics.
All rights reserved.
This software is licensed under terms that can be found in the LICENSE file
