saunders-jared-final/Boost-Brigade/0_Documentation/Photos/20260902_105737.jpg

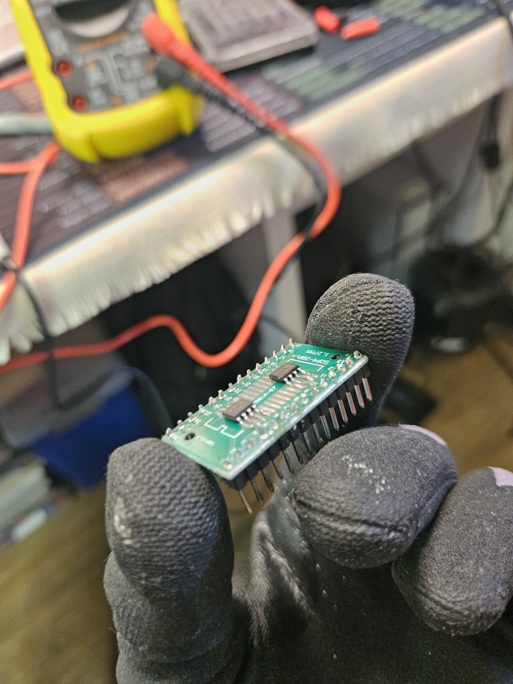
0_Documentation/Photos/20260902_105737.jpg
