saunders-jared-final/Boost-Brigade/0_Documentation/Photos/20261004_162533.jpg

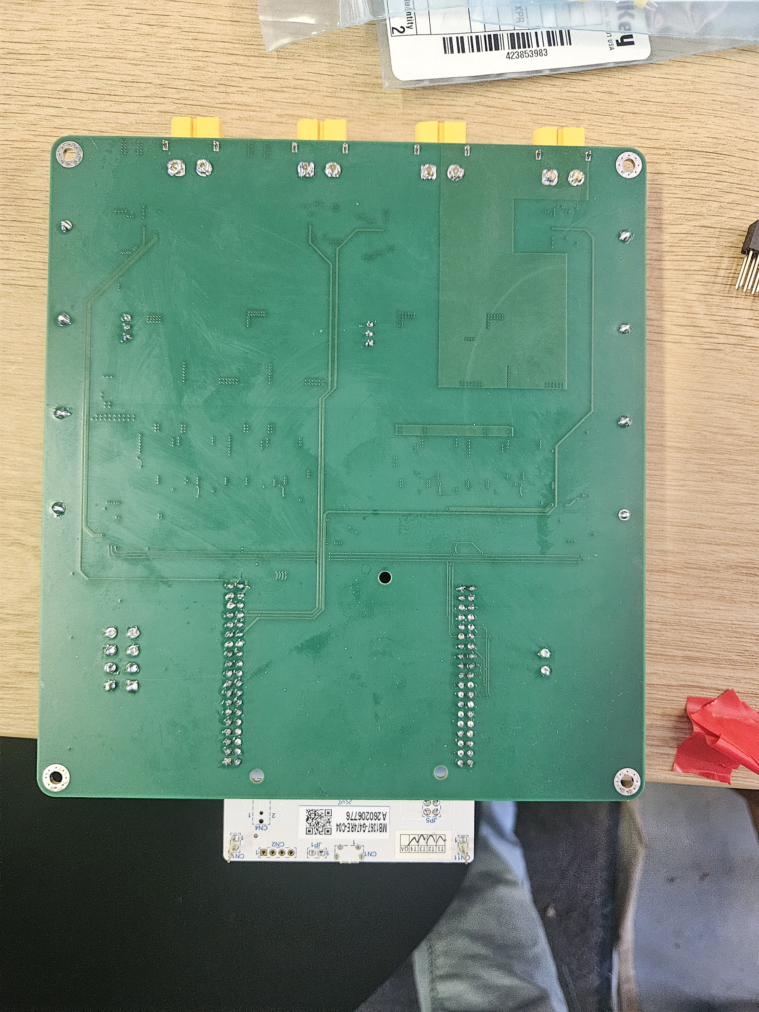
0_Documentation/Photos/20261004_162533.jpg
