saunders-jared-final/Boost-Brigade/0_Documentation/Photos/20261005_173910.jpg

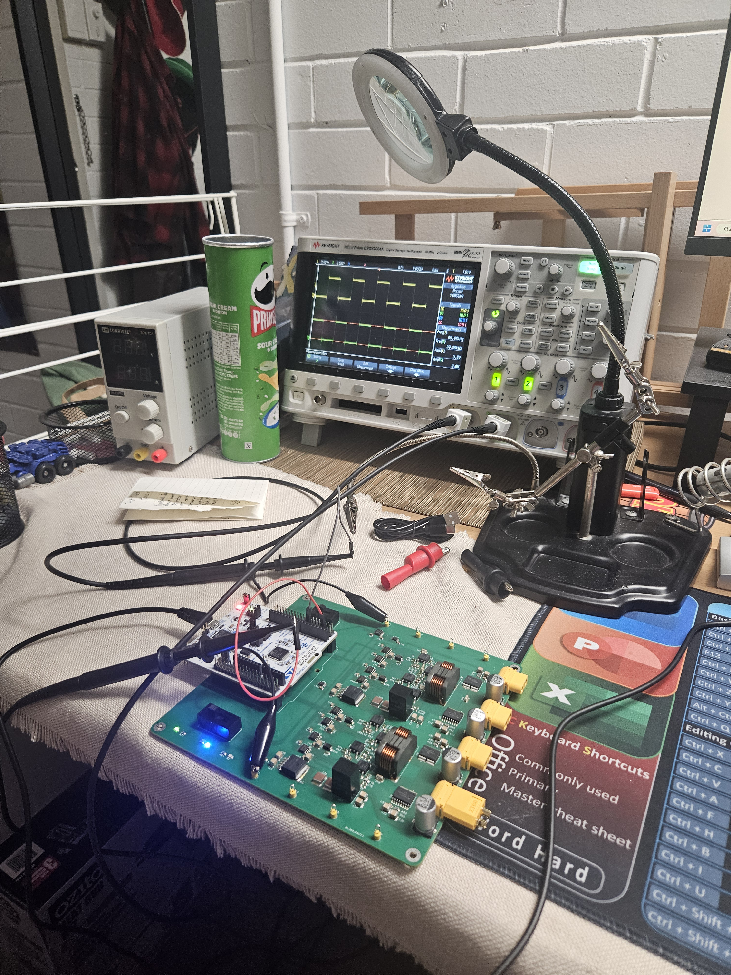
0_Documentation/Photos/20261005_173910.jpg
