saunders-jared-final/Boost-Brigade/0_Documentation/Photos/20261012_192754.jpg

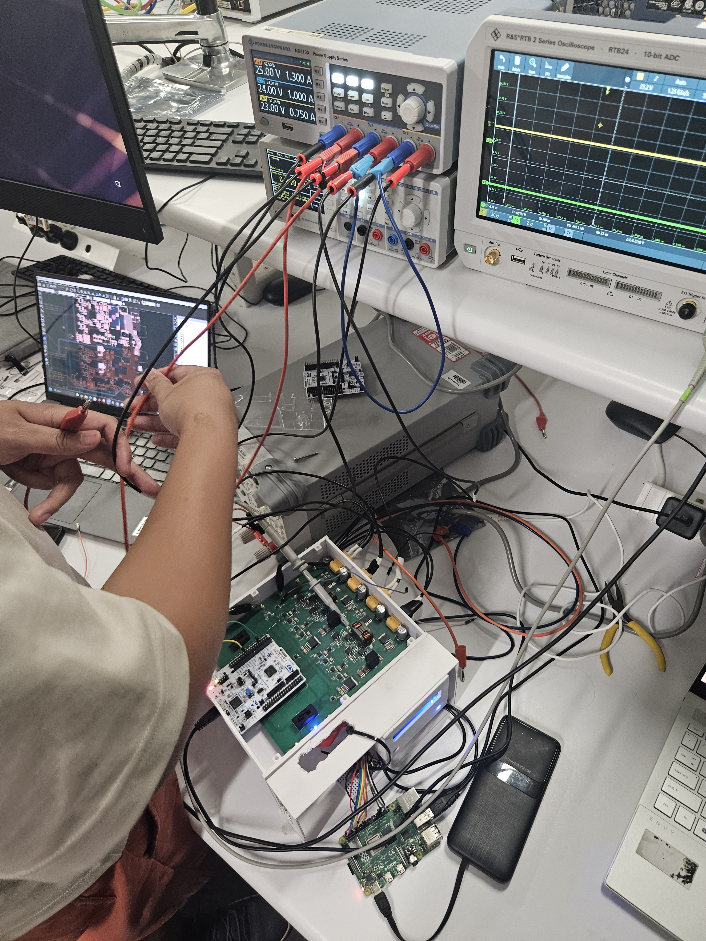
0_Documentation/Photos/20261012_192754.jpg
