saunders-jared-final/Boost-Brigade/0_Documentation/Photos/20261014_164058.jpg

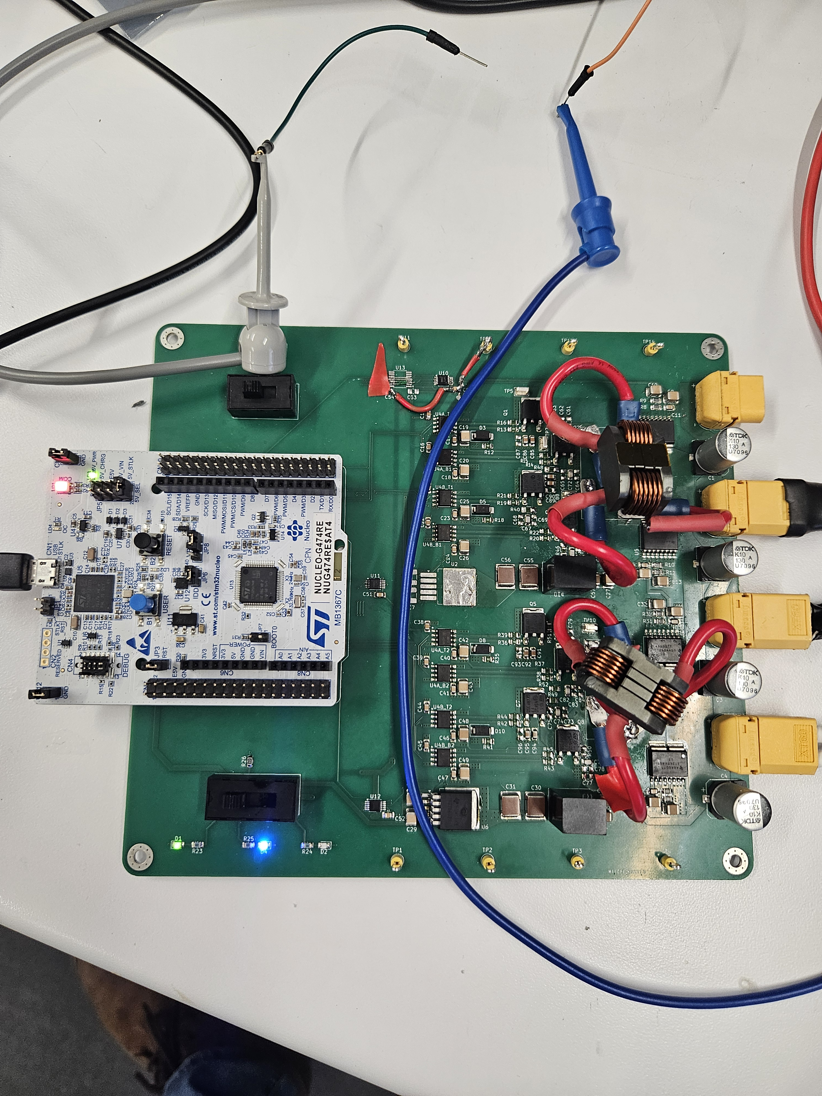
0_Documentation/Photos/20261014_164058.jpg
