saunders-jared-final/Boost-Brigade/0_Documentation/Photos/20261020_131838.jpg

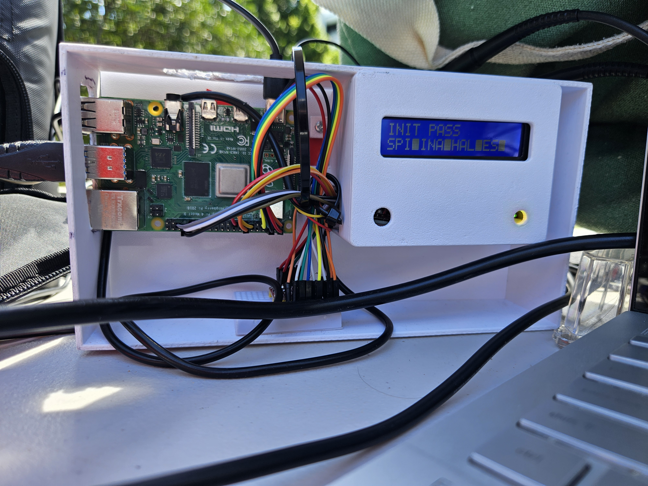
0_Documentation/Photos/20261020_131838.jpg
